2AMLogic/sky130-trng/design/README.md

# design

Schematic sources for the sky130-trng entropy source, and the SPICE netlists
derived from them.

These are design sources, not evidence. Most of the geometry here is still
a **provisional placeholder** ported from
[gf180-trng](https://github.com/2AMLogic/gf180-trng)'s topology and
re-expressed on sky130's 1.8 V core devices — but it is no longer *all* of
it. Issue #10's characterization campaign
([`spec/decision-records/DR-0002-sky130-ro-jitter-and-array-sizing.md`](../spec/decision-records/DR-0002-sky130-ro-jitter-and-array-sizing.md),
status **Proposed**) measured this design's own delay cell and rings across
the sky130 PVT grid, and issue #13's array rebuild
([`spec/decision-records/DR-0003-sky130-trng-operating-point.md`](../spec/decision-records/DR-0003-sky130-trng-operating-point.md),
status **Proposed**) then measured the array's own combining-gate bandwidth
and redrew `ro_array_core.sch` at the resulting operating point. See
[Provisional, not sized](#provisional-not-sized) below for which rows moved
and which did not.

**The headline result the rest of this file has to be read against**: the
array is now drawn at `N = 4` five-stage rings, not the `N = 2` x 11-stage
placeholder it used to carry. `N` is pinned between two independently
measured bounds that do **not** bind at the same corner — an entropy lower
bound (`N >= 4` at `T_s` = 20 µs, DR-0002's sizing law re-evaluated against
the buffer-loaded ring period) and a combining-gate upper bound (`N <= 6`,
measured at the array's own fastest corner, `ff`/−40 °C/1.98 V) — and the
second bound is a **hardware ceiling on the raw rate that no array size can
get past**: DR-0003 measures it at ~78 kbps, roughly two orders of
magnitude below this file's draft `> 1 Mbps` row. That row is retired as
architecturally unreachable, not merely expensive; the operating point drawn
here is `T_s` = 20 µs / 50 kHz sample clock / 50 kbps raw rate.

## What is here

```
design/
  xschem/              schematic + symbol sources (xschem's own text format)
  netlist.py           deterministic SPICE export driver, with a staleness + ERC guard
  _pdk_search.py       shared PDK-search walk, used by netlist.py and sim/bin/corner-run.py (issue #25)
  test_netlist_erc.py  regression fixture for netlist.py's ERC wiring (issue #16)
  test_pdk_search.py   unit test for _pdk_search.py's fallback order (issue #25)
  pdk.json             which sky130 install to resolve, and the open_pdks pin
  *.spice              GENERATED netlists -- committed output of netlist.py
```

### Cell hierarchy

```
trng_top                   top-level assembly; stops at the raw tap
  sampler_core             the sampler, wired to the source
    ro_array_core          the entropy source
      ro_ring5   (x4)      one starved ring oscillator, own enable + own supply
        ro_nand2           starved NAND2 -- the ring's enable/stop stage
        ro_stage   (x4)    starved inverter delay cell
      ro_buf     (x4)      per-ring output buffer (unstarved inverter)
      xor2       (x3)      static CMOS combiner, balanced depth-2 tree -> xo
    sampler_dff  (x6)      TG master-slave D flip-flop, async active-low reset
                           raw_bit, raw_valid, ring_bit1..ring_bit4
```

`ro_ring5` is instantiated by the hierarchy as of issue #13's rebuild
(DR-0003); it was previously a standalone characterization vehicle only.
`ro_ring11` (the 11-stage ring the array used to instantiate) remains in
`design/xschem/` as a standalone cell — DR-0002's jitter-characterization
testbenches under `sim/` still reference it directly — but is no longer
part of the `ro_array_core` hierarchy.

Every device instance is `sky130_fd_pr__nfet_01v8` or `__pfet_01v8` — the
1.8 V core pair, per
[`spec/decision-records/DR-0001-sky130-operating-envelope.md`](../spec/decision-records/DR-0001-sky130-operating-envelope.md)
(status **Proposed**) and `spec/porting-plan.md` §2.1. sky130 has no matched
3.3 V core N/P pair, so gf180-trng's `nfet_03v3`/`pfet_03v3` devices have no
like-for-like counterpart here.

### Port fidelity

`design/xschem/` **started** as a connectivity-identical port of
gf180-trng's own `design/xschem/` — same cells, same nets, same subcircuit
port order, cell for cell, with only the device flavour, the device
geometry, and every prose text block changed (gf180-trng's schematics cite
gf180mcu measurements in their headers, and those citations are not
transferable claims, so each block was rewritten to say what is actually
known here). Issue #13's array rebuild (DR-0003) then moved
`ro_array_core.sch`, `sampler_core.sch` and `trng_top.sch` off that
one-for-one instance count: gf180-trng's own array is `N = 2`, this
repository's is `N = 4`, sized independently from measured sky130 evidence
rather than inherited. The TOPOLOGY still ports — independent rings on
separate supplies, non-integer frequency skew, one XOR-combined node ahead
of one sampler — the instance count no longer does.

### Pins that leave the block

| Pin | Direction | Meaning |
|---|---|---|
| `en1`..`en4` | in | per-ring enable; `en = 0` stops that ring in a static state |
| `vddr1`..`vddr4` | supply | per-ring supply. Separate routing is an independence requirement, and doubles as the per-ring liveness observation point |
| `vdd`, `vss` | supply | block supply for the combiner, the ring buffers and the samplers |
| `clk` | in | the **fixed external** sample clock, 50 kHz per DR-0003 — deliberately not divided down from either ring |
| `rst_n` | in | asynchronous, active-low reset |
| `raw_bit` | out | the raw tap: one digitized sample per `clk` edge |
| `raw_valid` | out | high one `clk` edge after `rst_n` releases, and stays high |
| `ring_bit1`..`ring_bit4` | out | per-ring digitized samples for a liveness monitor; block-internal, not read off-die |

The raw tap sits at the **sampler output**, after digitization — not at the
array's internal combining node `xo`, which never becomes a pin.

## Regenerating the netlists

```bash
python3 design/netlist.py            # (re-)export every top cell
python3 design/netlist.py --check    # fail if a committed netlist is stale, or fails ERC
python3 design/netlist.py --lint     # brace guard only; no xschem, no PDK
python3 design/netlist.py --pdk      # show the resolved xschem + PDK against their pins
python3 design/test_netlist_erc.py   # regression fixture for the --check ERC wiring itself
python3 design/test_pdk_search.py    # unit test for the shared PDK-search fallback order
```

`--check` verifies two independent things, both required for exit `0`:

- **Staleness** — what makes a committed netlist evidence rather than a
  snapshot someone forgot to refresh: it re-exports into a temp directory
  and exits non-zero if the result differs from what is committed.
- **Connectivity** — xschem's own ERC (electrical rule check, `xschem
  netlist -erc`) finds no undriven node, open net, or shorted pin anywhere
  in each top cell's instantiated hierarchy. A schematic-level wiring
  defect (e.g. a `lab_pin` placed at the wrong coordinate relative to the
  net it is meant to tag) can produce a netlist that is internally
  self-consistent — a "before" and "after" regeneration of the same broken
  schematic agree on the same wrong result — so the staleness diff alone
  cannot catch it; ERC does (issue #16). A connectivity failure prints with
  an `ERC` prefix and a distinct exit code from a staleness failure's
  `STALE` prefix, so CI output tells the two apart. ERC only runs under
  `--check`; the plain write path (`python3 design/netlist.py`) does not
  run it, so an intentionally mid-edit schematic can still be exported
  while iterating. `design/test_netlist_erc.py` is the regression fixture:
  it confirms a deliberately-broken schematic (a `lab_pin` moved off its
  net) is actually caught, and that the current `TOP_CELLS` still pass
  cleanly.

Run `--check` after any schematic edit; commit the regenerated `.spice`
files in the same change.

`--lint` is the guard that can run without a PDK. Every schematic carries a
`T {...}` free-text header; a literal `{` or `}` inside that block — even a
balanced pair — makes xschem's own parser miscount and silently drop parts of
the exported netlist, with no error from xschem. The lint scans the
schematics' raw text for that, so it catches the problem at authorship rather
than at the next export.

The netlists are a **library of subcircuits** meant to be `.include`d by a
testbench deck, not decks of their own: `netlist.py` strips the trailing
`.end` and restores the top cell's own `.subckt`/`.ends` wrapper, which
xschem comments out.

`netlist.py` resolves the PDK through `SKY130_PDK_PATH` → `PDK_ROOT`+`PDK` →
`design/pdk.local.json` → `design/pdk.json` → built-in search roots, so no
path is hardcoded. That walk-a-list-of-roots search is shared with
`sim/bin/corner-run.py` via `design/_pdk_search.py` (issue #25); each caller
supplies only its own validator predicate (`libs.tech/xschem` here,
`libs.tech/combined` for the ngspice harness) and its own config source.
`netlist.py` also rewrites absolute paths out of the netlist header and
re-wraps SPICE continuation lines at a width it owns, so the output is
byte-identical across machines and across xschem releases that differ only in
line wrapping.

### xschem 3.4.7 is a hard minimum — 3.4.4 produces an unsimulable netlist

`design/pdk.json` carries an `xschem_version_min` field (currently `3.4.7`),
and `netlist.py` **refuses to netlist at all** below it, with exit `3`
(environment) and its own message. Unlike `open_pdks_commit` in the same
file — a provenance note that is reported, never enforced — this one is a
gate, because below it the tool does not produce a differently-formatted
netlist, it produces a broken one.

sky130's device symbols carry their device-area parameters as `expr()`
templates over the symbol's own `@W`/`@nf` attributes:

```
ad=expr('int((@nf + 2)/2) * @W / @nf * 0.29')
```

xschem 3.4.7 is the first release that *evaluates* those at netlist time (its
Changelog: "evaluate infix expressions with `expr(...)` in attributes"). Every
earlier release — including the **3.4.4** that `apt-get install xschem`
resolves on Debian/Ubuntu — copies the template through verbatim,
`@`-attributes and all. Since every `design/*.spice` here is `.include`d by
ngspice testbenches under `sim/`, that difference is fatal, not cosmetic:

```
Error in netlist line no. 2396 ...
Undefined parameter [ad]
Cannot compute substitute
ERROR: fatal error in ngspice, exit(1)
```

(measured 2026-09-18 with ngspice-46 against the pinned `open_pdks_commit`'s
own `sky130.lib.spice`; the committed evaluated form solves the same deck's
operating point without complaint.)

`--check` cannot catch this on its own — it verifies staleness and ERC, never
simulability — so an export by a too-old xschem would diff clean against
itself and report green. That is why the guard sits in `netlist.py` ahead of
the export rather than in CI alone, and why `.github/workflows/pdk-nightly.yml`
builds xschem from source at this tag instead of installing the distro
package (issue #151; see that file's header comment for the full decision
record, including the earlier policy it reverses).

The floor is a **minimum, not an equality pin**. A *newer* xschem whose output
formatting moves is still meant to turn `--check` red, loudly, and the remedy
for that direction is unchanged: `python3 design/netlist.py`, commit the diff,
note the version bump.

## Provisional, not sized

Issue #10's campaign and issue #13's array rebuild have moved some of this
table off "no sky130 measurement exists". Each row now says which.
**Status** is one of: *measured* (this repo has a cited sky130 record for
it), *refuted* (measured, and the value drawn here does not survive the
measurement), or *placeholder* (still carried over from gf180-trng, or
otherwise unmeasured on sky130).

| Parameter | Value here | Status | What backs it, or what is still missing |
|---|---|---|---|
| Device length `L` | 0.15 µm | placeholder | sky130 minimum drawn length. Not a sized result; nothing in either campaign varied it |
| NMOS width | 0.42 µm | placeholder | sky130 minimum device width. Same |
| PMOS width | 0.84 µm | placeholder | 2:1 P:N ratio **carried over from gf180-trng**. Issue #10 measured the cell's trip point at 0.805–0.844 V against a 0.81–0.99 V mid-supply across the grid, i.e. the ratio is not grossly mismatched — but that is a by-product, not a P:N sizing sweep, and no sweep was run |
| Series-stack widths | 2× the device they replace | placeholder | rule of thumb from the source cell, not a sky130 stage-delay match measurement |
| Starve length `lstv` | 2 µm | placeholder | gf180-trng reached 2 µm by measuring an array power rollup against its own ratified power row. **No sky130 lstv sweep exists** — both campaigns measured jitter, swing and current at this fixed value, so this row is untouched |
| Starve width `wstv` | 0.42–0.48 µm, four 0.02 µm steps | **measured (realized ratio), placeholder (decorrelation)** | The REALIZED frequency ratio across the ladder is measured on the assembled array (`sim/ro-array-core-combining/`, `skew_span` 1.12–1.19×) and re-measured post-layout at every scope up to the whole chain, always clear of the small rationals that mutually injection-lock: closest approach 9.3% (leaf, DR-0005), and **11.2% at whole-chain scope with the substrate deliberately floating** (DR-0009, span 1.096–1.184×). What decorrelates two *sky130* rings is **still not measured**, but the reason is now specific rather than "no layout exists". DR-0009 §3 audits DR-0003 §8's three named mechanisms separately: **proximity is closed** (real placement, extracted flat at ring, array and whole-chain scope); **substrate capacitive return is bracketed, not resolved** — loading −0.650% to −0.283% and coupling +0.361% to +0.584% of ring period at whole-chain scope, 12/12 consistent in sign, but the extractor emits no substrate resistance so `tied`/`float` bracket the *terminals* of an unmodelled range (klayout-tools#1503) — and, at whole-chain scope, the six-sampler digitizer bank turns out to be a comparable or dominant aggressor on that same node, which dissolves the ring-to-ring sign consistency once it is clocking (DR-0009 §2); **shared supply impedance**, §8's first-named mechanism, is **entirely unmeasured** because `vddr1`–`vddr4` still have no distribution layout to be measured on. That last item is the single named blocker, so this row stays **placeholder** for decorrelation (DR-0003 §8, DR-0005 §3–4, DR-0006 §2–3, DR-0009 §1–3) |
| Per-stage gain | −14.3 nominal, −11.8 worst | **measured** | `sim/ro-stage-small-signal-gain/`, three headline points. ~12× the Barkhausen minimum at any stage count in play; retires DR-0001's gain risk |
| Ring swing (`ro_ring5`, buffered output) | 0.999–1.033 × Vdd p-p | **measured** | `sim/ro-ring5-swing-and-current/`, 12 PVT points, under this cell's own output-buffer load. The internal ring node itself swings less (0.78–0.96 × Vdd), but the BUFFERED node — what the XOR tree and liveness taps see — reaches the rails at every point measured |
| Ring stage count | 5 | **measured, chosen** | 12–48× better `Q_ring` than 11 stages at the same points (DR-0002 §4); own-count swing re-measured and confirmed above (this table's previous row cited it as an open objection — it is now retired). `ro_ring11` remains in `design/xschem/` as a standalone characterization cell, no longer part of this hierarchy |
| Array size `N` | 4 | **measured, chosen** | Pinned between an entropy lower bound (`N >= 4` at `T_s` = 20 µs) and a combining-gate upper bound (`N <= 6`, measured at the array's own fastest corner) that do **not** bind at the same PVT point — DR-0003 §1–3. `N = 4` is the largest power of two clearing the combining bound with margin |
| Raw-rate operating point | `T_s` = 20 µs, 50 kHz clock, 50 kbps | **measured, moved** | DR-0003 §2: the combining-gate bandwidth ceiling puts a **hard architectural ceiling of ~78 kbps on the raw rate at any array size** — nearly two orders of magnitude below this file's draft `> 1 Mbps` row, which is retired as unreachable rather than merely expensive |
| Entropy-binding corner | `ss` / −40 °C / 1.62 V | **measured** | Full 27-point grid, `sim/ro-array-sizing/`. Cold — the direction gf180-trng's DR-0012 guessed and its DR-0015 later reversed. Measured here, inherited from neither |
| XOR combining tree contribution | `w_90` = 122–241 ps (gate bandwidth); 0.56–0.68 edge retention at `N = 4` | **measured** | `sim/xor-combining-bandwidth/` (single-gate pulse-width sweep, the figure that sizes `N`) and `sim/ro-array-core-combining/` (assembled-array edge retention and combining-node DC bias, 0.31–0.53 × Vdd, no gross systematic offset). DR-0003 §5–6 |
| Array active power | 81.0–431.6 µW measured across the PVT grid run | **measured** | `sim/ro-array-core-combining/`. Worst-measured 431.6 µW clears the top-level README's `< 500 µW active` row with 13.7% margin |
| Array area | ~0.0026–0.0088 mm² (ROM estimate); every `ro_array_core` leaf cell now drawn, summing to 4 × 377 + 4 × 22.2 + 3 × 421.5 µm² = 0.00286 mm² | **estimated (array), measured (leaf cells only)** | Device-count-based estimate (DR-0003 §7): comfortably inside the `< 0.05 mm²` budget (~5–18%). Not yet an array measurement, but every cell it instantiates is now drawn: `ro_ring5` 41.125 × 9.17 µm (`layout/ro_ring5/README.md`), `ro_buf` 4.175 × 5.31 µm, `xor2` 23.97 × 17.585 µm (`klt stats` on each committed GDS). The 0.00286 mm² sum is leaf-cell bounding boxes only — it is a **floor**, not a floorplan: no inter-ring channel, no supply distribution, no sampler and no top-level PDN are drawn, and it assumes the eleven cell instances (4 rings + 4 buffers + 3 XORs) pack with zero waste between their bounding boxes |
| Sampler (`sampler_dff`) capture timing | clk→q 103.6–299.0 ps (leaf-cell, ideal inter-cell wires); **131.4–426.0 ps (whole-cell assembled, real intra-cell routing)**; both post-layout, worst at `ss`/−40 °C/1.62 V | **measured (post-layout, two extraction scopes)** | `sim/post-layout-sampler-dff/` (leaf-cell composition, 8 records / 24 corner runs) and `sim/post-layout-sampler-dff-assembled/` (whole-cell flat extraction of `layout/sampler_dff/sampler_dff.gds`, 4 records / 12 corner runs), both with the pre-layout `.subckt sampler_dff` as a same-deck control. Leaf-cell intra-cell parasitics cost 1.314–1.418× in clk→q, inside DR-0005's own 1.378–1.479× ring finding (DR-0007); the whole-cell assembly costs **1.704–2.013×** against pre-layout, i.e. **1.268–1.425× on top of** the leaf-cell figure at the same PVT/corner points (DR-0008). Setup time is not yet re-measured at the assembled scope (DR-0007's 60–150 ps, leaf-cell only, still stands — see DR-0008 "Known limitations"); compared per corner against DR-0003 §1's own `w_90` table at leaf-cell scope, setup is below that corner's `w_90` at each of the nine (temp, Vdd, corner) points where both are measured — including (60, 73] ps against 122.0 ps at `ff`/−40 °C/1.98 V, the corner where `N_max_combine` binds (`sim/xor-combining-bandwidth/` has no 125 °C point, so this campaign's three 125 °C/1.98 V points are outside the comparison). DR-0003 §1's `N_max_combine` bound is therefore unchanged — the digitizer is not the bandwidth bottleneck. Worst-case capture delay is ≤ 21.3 ppm of the ratified 20 µs `T_s` even at the assembled scope. Both scopes use ideal PWL stimulus, so a **floor** on the real cost. DR-0007, DR-0008 |
| Sampler reset-window current | 19.3 pA (`ss`/−40 °C/1.62 V) – 293 nA (`ff`/125 °C/1.98 V), i.e. 0.90 nW nominal / 580 nW worst | **measured** | `sim/post-layout-sampler-dff/` and `sim/post-layout-sampler-dff-assembled/`, both measured with `rst_n` asserted *while* `d` drives the opposite value through the transparent master. Leakage-limited: at or below the same cell's own idle current at every grid point (0.501–1.014×, both extraction scopes agree on this ratio to three significant figures) and identical pre- and post-layout to 3–5 significant figures at both scopes, so there is no contention component to find. This is `spec/porting-plan.md`'s DR-0014 **methodology** transfer re-derived on sky130 — not gf180mcu's 967 µW → 66 nW numbers transplanted, and **no** reduction ratio is claimed, because the brute-force pull-device alternative was not simulated. DR-0007, DR-0008 |
| Idle current (per ring) | 0.6 nA (cold) – 255 nA (`ff`/125 °C) | **measured (per-ring), no target yet** | `sim/ro-ring5-swing-and-current/`. The top-level README's own idle-current target is still unset pending `spec/porting-plan.md` §2.5's leakage survey, so this is a reported number, not a pass/fail against a row that does not exist yet |
| Load cap `cld` | 0.5 fF | placeholder | an estimate of local interconnect load, not an extracted parasitic, and sky130's metal stack differs from gf180mcu's |

### Why the schematic reads `N = 4`, and why the raw-rate row moved to 50 kbps

`N` is not a parameter in `ro_array_core.sch`; it is a topology, and issue
#13 redrew it. `N = 4` is not the entropy law's own preferred value in
isolation — DR-0002 sized `N = 53` against the draft `> 1 Mbps` row — it is
the largest power-of-two array size that clears a **second, independent
constraint** DR-0002's campaign did not measure: the XOR combining gate's
own bandwidth. That second bound does not move with the sample rate, so it
sets a hard ceiling (~78 kbps) on the raw rate itself, not just on `N`.
`spec/decision-records/DR-0003-sky130-trng-operating-point.md`
(status **Proposed**) is the full derivation: the two bounds, where they
cross, why 50 kbps (not the ~78 kbps ceiling itself) was chosen for margin,
and the stage-count, area, current and combining-tree evidence that came
with drawing the array at last.

`spec/porting-plan.md` §2.6 predicted the shape of what both campaigns
found: gf180-trng's own rate × entropy × power × area operating point has
not converged, and sky130's version of the same tension needed its own
sizing pass. It did, and it resolved further downward than either campaign
alone implied — DR-0002's entropy law by itself still permits high rates at
large `N`; the combining gate does not. Whether 50 kbps should ratify as
this repository's ratified rate row, or whether the combining gate itself
should be redesigned to raise the ceiling, is the operator/spec decision
DR-0003 surfaces and does not resolve on its own authority.

## Deliberately not here

- **The metastability-hybrid tap** (`meta_arb`, `meta_inv`, `meta_nand2`,
  `ro_array_core_meta`, `ro_array_sanity`, `ro_meta_tap` in gf180-trng).
  `spec/porting-plan.md` §1.2 scopes it as a stretch/secondary item, not part
  of the core array, so it is out of scope for this port.
- **The digital section** — conditioner, health tests, register interface.
  The analog/digital verification boundary is drawn at the raw tap:
  everything up to and including `raw_bit` is transistor-level, everything
  downstream is a behavioural model plus RTL, and drawing it as SPICE
  subcircuits would fabricate netlists for circuits nobody has designed.
  That section now exists — as of
  [`spec/decision-records/DR-0004-sky130-digital-section-architecture.md`](../spec/decision-records/DR-0004-sky130-digital-section-architecture.md)
  (status **Proposed**) it lives in [`digital/`](../digital/README.md), not
  here, and none of it is or will be a `design/*.spice` netlist. `raw_bit`
  and `raw_valid` are the interface between the two directories.
- **Layout and DRC/LVS.** **Latest (issue #22): the shared-substrate
  tied/float/solo bracket, run at whole-chain (`sampler_core`) scope — the
  last hierarchy level that had no substrate-coupling measurement of its
  own, and the deck DR-0003 §8 has been waiting for since it was written.**
  Two new decks in [`sim/post-layout-sampler-core/`](../sim/post-layout-sampler-core/)
  (eight records, twenty-four corner runs, all **PASS**, same four-point
  PVT grid × `tt`/`ss`/`ff`) complete the bracket DR-0005 ran on leaf cells
  and DR-0006 ran on the whole array. Loading **−0.650% to −0.283%** of
  ring period and coupling **+0.361% to +0.584%**, positive at **12 of 12**
  grid points — the array-scope sign signature reproduced at an independent,
  larger scope, at 2–8× the magnitude, clearing DR-0005's ring-scale
  numerical scatter floor by 15–24× at every point. A second period
  estimator these decks add, taken inside the clocked window with all six
  `sampler_dff` instances actually latching, then finds the sign consistency
  **gone** (−0.486% to +0.589%, 8 of 12 positive) — because the digitizer
  bank is itself a first-order substrate aggressor: one ring plus a clocking
  sampler bank puts more peak-to-peak swing on the shared node than four
  free-running rings with the bank static at **7 of 12** grid points. The `wstv` ladder still clears every mutual-injection-lock
  rational by ≥ 11.2% at the pessimistic (floating) terminal. **DR-0003 §8
  is narrowed, not closed**: proximity is now closed, substrate capacitive
  return is bracketed at three scales with an unmodelled interior
  (klayout-tools#1503), and §8's first-named mechanism — shared supply
  impedance — remains entirely unmeasured for want of a `vddr1`–`vddr4`
  distribution layout, which is now the single named blocker. Full
  statement: [`spec/decision-records/DR-0009-*.md`](../spec/decision-records/DR-0009-sampler-core-substrate-bracket-and-wstv-decorrelation.md);
  reduction: `python3 sim/post-layout-sampler-core/analysis/substrate-bracket.py`.

  **A previous increment (issue #22): `sampler_core`'s first
  whole-cell post-layout PVT simulation campaign, against real extracted
  parasitics.** [`sim/post-layout-sampler-core/`](../sim/post-layout-sampler-core/)
  drives `layout/pex-sampler-core/sampler_core_pex.spice` (the whole
  composed cell — four rings, output buffers, the XOR combining tree, and
  all six `sampler_dff` instances, one flat extraction) with the same
  enable/reset/clock stimulus `sim/post-layout-ro-array-core/` uses for the
  array alone, extended to release the six samplers from reset and clock
  them — the first deck in this repository to exercise the whole raw-tap-
  to-sampled-bit chain post-layout in one flat netlist. Four PVT points ×
  three process corners (the repo's established grid), all twelve **PASS**:
  ring period slows **2.161-2.504×** against the pre-layout
  `design/sampler_core.spice` control (a larger multiplier than
  `sampler_dff`'s own clk→q slowdown, DR-0008, because it also carries the
  array's own real inter-block routing and the six-instance `d`-pin fan-out
  load, not just one cell's intra-cell parasitics); the combining node's
  edge retention is 0.479-0.649 post-layout (0.386-0.642 pre-layout, same
  deck, same corner — post-layout loading does not systematically depress
  it); reset-held sampler outputs stay ≤ 0.403 mV across all twelve runs
  while the rings free-run underneath; and all 120 captured-value
  snapshots (`raw_bit`/`raw_valid`/`ring_bit1`-`ring_bit4`, five clock
  edges × twelve corner-runs) land within 0.025% of a rail — clean
  digital levels end to end, never an intermediate voltage. Active-window
  supply current runs 1.052-1.234× the pre-layout figure, reset-held
  1.048-1.280×. One early run at this same PVT point (-40 °C, 1.62 V)
  timed out on its `ff` corner under heavy host contention before this
  campaign's own clean re-run superseded it —
  `sim/post-layout-sampler-core/records/20260908-032156-ef0db50.md`, kept
  per this directory's append-only convention rather than deleted. That
  campaign is a functional/timing/current characterization, not a coupling
  or injection-locking study, and said so — the substrate bracket above is
  the deck it named as still owed.

  **A previous increment (issue #22): `sampler_core` is extracted
  with real post-layout parasitics for the first time.**
  [`layout/pex-sampler-core/`](../layout/pex-sampler-core/README.md) runs
  `klt extract --parasitics` over the DRC/LVS-clean
  `layout/sampler_core/sampler_core.gds` (264 devices, 152 nets, 169817.28 Ω
  total series R, 869.19 fF total C). Its `net_aliases` table is built from
  `klt lvs`'s own verified net map rather than inferred from spelling,
  because the six `sampler_dff` instances' own `q` pins are never promoted
  to a GDS label and so need that map to tell `raw_bit`/`raw_valid`/
  `ring_bit1`-`ring_bit4` apart; see that directory's README for the full
  derivation and its independent union-find cross-check.

  **A previous increment (issue #22): `sampler_core` is now
  DRC-clean *and* LVS-clean — the first whole-cell DRC/LVS-clean
  `sampler_core` assembly in this repo.**
  [`layout/sampler_core/`](../layout/sampler_core/README.md) adds three
  stages routing `ro_array_core`'s own `vdd` down to the six-`sampler_dff`
  bank's own `vdd` rail, closing the second (and last) of the cell's two
  inter-block supply straps (`vss` was routed by the previous increment).
  `vdd`'s own path is blocked by a met1 net spanning a whole corridor at one
  height, so this strap bridges past it on met2 (auto-via at both ends)
  rather than staying on one layer the way `vss` could. `klt drc`: clean, 0
  violations. `klt extract`: 264 devices, **152 nets** (down from 153 —
  `vdd`'s two nets, previously separate, are now genuinely one). `klt lvs`
  vs. `design/sampler_core.spice`'s own `.subckt sampler_core`: **match —
  264/264 devices, 152/152 nets, 0 errors**. Top-level pin promotion,
  previously thought also required for a full match, turned out not to be.
  The assembled `sampler_core` post-layout PVT run and DR-0003 §8's `wstv`
  re-evaluation remain open, tracked in #27.

- **A previous increment (issue #22): `sampler_core`'s whole data
  path is routed — all five raw-tap nets (`ro1`-`ro4`, `xo`) reach their own
  samplers, `sv`'s `d` is tied to `vdd` as the schematic requires, and every
  `d` pin in the cell is driven. DRC-clean, 264 devices, 153 nets.**
  [`layout/sampler_core/`](../layout/sampler_core/README.md) adds two stages
  on top of the six below: `data2_m1` (met1) draws the `d` climbs for
  `sb`/`sr2`/`sr3`, `sv`'s `d`→`vdd` tie (landing directly on the shared
  `vdd` rail's own met1), `ro2`'s and `ro3`'s westward escapes along their
  own already-drawn horizontals, and the two short legs `xo` needs; and
  `route_data2` (met2) closes the three remaining hauls plus the 2.1 µm hop
  joining `ro3`'s split escape over `ro2`'s own vertical. The previous
  increment's reading that `ro2`/`ro3` need "a layer change inside the
  array's footprint" was right about the constraint and wrong about the
  move: a scan of the pre-increment stream finds exactly two `x` bands where
  met2 is free over the array's *whole* height (`x -2.1..1.65`, the west
  margin, and `x 215.05..220.0`), met1 is clear all the way west to the
  first one at both nets' own run heights, and the east band is unreachable
  — the via that would have to land there needs 0.70 µm between the array's
  east supply riser and `ro4`'s escape leg, which are 0.605 µm apart. `klt
  drc`: clean, 0 violations, first attempt on both stages. `klt extract`:
  264 devices, **153 nets** — `157 − 4`, exactly one merge per net joined,
  each confirmed net-by-net. `klt lvs` against `design/sampler_core.spice`'s
  real `.subckt sampler_core`: mismatch, improved to **138/264 devices,
  100/152 nets**. The inter-block `vdd`/`vss` straps, top-level pin
  promotion, whole-cell LVS sign-off and the assembled post-layout PVT run
  remain open, tracked here and in #27.

- **A previous increment (issue #22): the `ro_array_core`
  instance is placed inside `sampler_core`, and the first two raw-tap data
  nets are routed end to end — DRC-clean, 264 devices, 157 nets.**
  [`layout/sampler_core/`](../layout/sampler_core/README.md) adds three
  stages on top of `place`/`route_supplies`/`route_ctrl`: `place_array`
  puts one `ro_array_core` instance (the DRC-clean, LVS-*matching* entropy
  source) at `(0.0, 23.635)` — directly above the six-`sampler_dff` row,
  with a 12.915 µm routing channel between them — so `sampler_core.spice`'s
  whole device population exists in one stream for the first time;
  `data_m1` (met1) climbs `sr1`'s and `sr4`'s own `d` pins out of li1 to a
  landing point under the shared `vdd` rail and extends `ro1`'s and `ro4`'s
  own array metal south into the channel; `route_data` (met2) closes the
  two hauls. Above rather than below is measured, not preferred: a `d` pin
  has one met1 obstacle above it (the shared `vdd` rail) and three
  interleaved below (`vss` rail, `clk` lane, `clkb` lane) on the only two
  routing layers sky130's `klt` roles expose. Only two of the five data
  nets are routed because only two of them *can* be at this scope: a
  column-by-column met1 scan finds a clear south escape over `ro1`'s and
  `ro4`'s own runs and none at all over `ro2`'s or `ro3`'s (the four ring
  taps are stacked horizontals), and `xo` is an li1 pad two via hops from
  met2. `klt drc`: clean, 0 violations. `klt extract`: 264 devices,
  157 nets — exactly two fewer than the unrouted placement's 159, i.e.
  exactly the two intended connections and nothing else. `klt lvs` against
  `design/sampler_core.spice`'s real `.subckt sampler_core`: mismatch at
  136/**264** devices — against a *complete* reference for the first time,
  after this increment fixed a `compose-cell.py` gap that had been leaving
  it silently short at 176. The remaining three data nets, the inter-block
  `vdd`/`vss` straps, top-level pin promotion, whole-cell LVS sign-off and
  the assembled post-layout PVT run all remain open, tracked here and in
  #27.

- **A previous increment (issue #22): `sampler_core`'s shared `clk`/`rst_n`
  fan-out is routed across all six `sampler_dff` instances, DRC-clean.**
  The `route_ctrl` stage reuses the chain-of-six technique below for both
  nets; `clk` was clean on the first attempt, `rst_n` needed a climb to an
  empty met2 band for its cross-instance haul after a self-net short on the
  first. `klt drc`: clean, 0 violations; `klt extract`: 132 devices, 64 nets
  (down from 74 — each of `clk`/`rst_n` merges six per-instance nets into
  one).

- **A previous increment (issue #22): `sampler_core`'s shared `vdd`/`vss`
  bus is routed across all six `sampler_dff` instances, DRC-clean.**
  [`layout/sampler_core/`](../layout/sampler_core/README.md)
  promotes the placement proof-of-concept below into a real,
  `compose-cell.py --check`-reproducible `cell.json` (stage `place`,
  byte-for-byte the same six-instance floorplan) plus a `route_supplies`
  stage chaining `vdd` and `vss` across `sb`→`sv`→`sr1`→`sr2`→`sr3`→`sr4` on
  met1 — landing directly on each `sampler_dff` instance's own already-drawn
  rail (no via-drop needed, since that cell's own routing already put
  `vdd`/`vss` on met1). `klt drc`: clean, 0 violations; `klt extract`: 132
  devices unchanged, 74 nets (down from the placement PoC's 79 — `vdd`
  merges from six per-instance nets into one, saving exactly 5; `vss` was
  already merged via sky130's own global NMOS substrate). `klt lvs` against
  `design/sampler_core.spice`'s real `.subckt sampler_core`: mismatch, as
  expected (no `ro_array_core` instance placed yet, `clk`/`rst_n`/`d`/`q`
  all unwired) — assembling that `lvs` block also surfaced a real
  `compose-cell.py` limitation (not a `klt` gap), recorded in
  `layout/sampler_core/README.md`.

- **A previous increment (issue #22): the `sampler_core` six-`sampler_dff`
  bank has a verified, DRC-clean floorplan.**
  [`layout/sampler_core-placement-poc/`](../layout/sampler_core-placement-poc/README.md)
  places six already-composed `layout/sampler_dff/sampler_dff.gds` instances
  side by side (55.66 um pitch, `design/sampler_core.spice`'s own
  `sb`/`sv`/`sr1`-`sr4` instance order), zero routing: `klt drc` clean (0
  violations), `klt extract` confirms 132 devices (66 nfet + 66 pfet) and 79
  nets (the 5-net gap from the naive 84 is sky130's own global-substrate
  NMOS-bulk merge — traced and confirmed benign). `design/sampler_core.spice`'s
  own `.subckt sampler_core` wires the source (`ro_array_core`) *and* the
  samplers together, not "six samplers" alone, so this was a placement-only
  proof-of-concept (like `layout/ro_array_core-placement-poc/` before
  `layout/ro_array_core/`), not yet an LVS-checkable committed cell.

- **A previous increment (issue #22): `sampler_dff`'s whole-cell
  assembly is now extracted with real intra-cell parasitics and re-run
  through the same post-layout deck DR-0007 used at leaf-cell scope.**
  [`layout/pex-sampler-dff-assembled/`](../layout/pex-sampler-dff-assembled/README.md)
  runs `klt extract --parasitics` directly over
  `layout/sampler_dff/sampler_dff.gds` — the same DRC-clean, `klt
  lvs`-matching (22/22 devices, 14/14 nets, 0 mismatches) assembly the
  previous increment below landed — instead of the three separately
  composed leaf cells wired by ideal testbench nets. `sim/post-layout-sampler-dff-assembled/`
  re-runs the capture-timing/reset-contention deck across the same
  four-(temp, Vdd)-point, `tt`/`ss`/`ff` grid (4 records, 12 corner runs, all
  `PASS`): clk→q capture delay now costs **1.704–2.013×** against
  pre-layout (up from the leaf-cell composition's own 1.314–1.418×), i.e.
  **1.268–1.425× on top of** the leaf-cell figure at matching PVT points —
  smaller than the ~1.5–1.7× DR-0007 borrowed from DR-0006's *array-scale*
  result as a placeholder, which is not a contradiction (a different
  interconnect shape, not a wrong estimate); the reset window still carries
  no contention current, agreeing with the leaf-cell figure to 4–5
  significant figures; and the assembly is functionally correct (captured
  levels ≥ 0.9988×Vdd high / ≤ 0.00195×Vdd low, reset holds `q` ≤ 0.386 mV).
  See
  [`spec/decision-records/DR-0008-*.md`](../spec/decision-records/DR-0008-sampler-dff-assembled-post-layout.md)
  for the full re-evaluation, including what it explicitly does not
  re-measure (DR-0007's own setup-time bracket, and `sampler_core`'s
  six-instance fan-out). `sampler_core`'s own six-instance wiring and the
  whole-chain (raw-tap-to-sampled-bit) post-layout PVT campaign remain open
  (#27).

- **A previous increment (issue #22): `sampler_dff` reached
  `klt drc`-clean (0 violations) and `klt lvs`-**match** (22/22 devices,
  14/14 nets, 0 mismatches) against `design/sampler_core.spice`'s own
  `.subckt sampler_dff`** — the sixth and last data-path net, `m`, is
  routed (see [`layout/sampler_dff/README.md`](../layout/sampler_dff/README.md)),
  completing the sampler-side counterpart to `ro_array_core`'s own clean
  sign-off below. The note below about `layout/sampler_dff/`'s GDS not yet
  being an extraction source (`m`/`mb` unrouted) describes the state at the
  time of the sampler post-layout PVT entry further down, not the current
  one (superseded by the whole-cell assembled extraction above).
  `layout/` holds **fifteen composed, DRC-clean
  and LVS-clean cells** — every leaf cell `ro_array_core` instantiates
  (rings, buffers, the combining-tree XOR; see
  [`layout/xor2/`](../layout/xor2/README.md)) **plus `ro_array_core`
  itself**, which is now a `--check`-reproducible six-stage `cell.json`
  recipe in
  [`layout/ro_array_core/`](../layout/ro_array_core/README.md) (132/132
  devices, 96/96 nets, 0 DRC violations, with `ring1..4`'s and `xa1..3`'s
  own `vss` taps drawn). That supersedes — without correcting — the PoC
  directory the increments below narrate.
  A prior increment first reached that verdict:
  [`layout/ro_array_core-placement-poc/`](../layout/ro_array_core-placement-poc/README.md)'s
  "Increment 8" section routes the last open net, the `vdd` supply, as
  seven `"metal2"`-role (met1) promotion stubs plus a six-leg `"metal3"`
  (met2) bus, merging the seven previously-separate per-instance `vdd`
  nets into one 38-device net. The composed block is **`klt drc` clean
  (0 violations)**, extracts to **132 devices / 96 nets**, and **`klt lvs`
  reports `match`: 132/132 devices, 96/96 nets** against
  `design/ro_array_core.spice`'s own `.subckt ro_array_core` — the whole
  entropy source (four differently-sized rings, four buffers, the
  three-XOR combining tree), not a leaf cell. Two committed negative
  controls (`lvs-negative-controls.py`) show that verdict is
  discriminating rather than vacuous: resizing ring 4's starve devices to
  ring 1's `wstv`, and crossing `xa1`/`xa2`'s inputs, each turn the same
  comparison into `mismatch`. The generated reference originally needed
  one thing `layout/bin/compose-cell.py`'s *plain* `lvs.dependencies`
  mechanism could not express — four differently parameterised copies of
  the *same* `ro_ring5` subckt — built at the time by a small one-off
  script (`array-reference.py`) that hand-rolled the rename/parametrize
  loop. **A follow-up increment folds that back into `compose-cell.py`**
  as a generic, unit-tested `lvs.dependency_variants` mechanism (see
  `layout/README.md`), and `array-reference.py` now calls it instead,
  verified to reproduce the identical reference body and LVS/negative-control
  verdicts. **The promotion that follow-up left open is done**:
  `layout/ro_array_core/cell.json` is the `--check`-reproducible recipe, and
  its `lvs` block is `lvs.dependency_variants`'s first real use.

  **This increment adds the whole-array post-layout PVT campaign issue #22's
  acceptance bar asks for**, layered on top of that already-landed recipe.
  [`layout/pex-array/`](../layout/pex-array/README.md)
  extracts the canonical, `vss`-strapped, DRC-clean, LVS-matching
  `layout/ro_array_core/ro_array_core.gds` flat with
  `klt extract --parasitics`, and
  [`sim/post-layout-ro-array-core/`](../sim/README.md) runs it across the
  same four-(temp, Vdd)-point, `tt`/`ss`/`ff` grid every prior post-layout
  campaign in this repo uses (36 corner runs): array-level parasitics cost
  **2.158x - 2.501x** in ring period against pre-layout, the `wstv` ladder
  still discriminates (span 1.084x - 1.175x), and a tied/float/solo
  inter-ring substrate bracket — the first one in this repo run on a real,
  physically-placed layout rather than leaf cells hand-tied to a shared
  node — finds coupling still bounded in magnitude but, for the first time,
  consistent in sign across every grid point, and wider than the prior
  ring-scale study (loading -0.353% to -0.192% of ring
  period, coupling +0.044% to +0.293%, 12 of 12 positive). See
  [`spec/decision-records/DR-0006-*.md`](../spec/decision-records/DR-0006-array-level-post-layout-and-wstv-decorrelation.md)
  for the full re-evaluation: it does **not** close DR-0003 §8 — the gap's
  first-named mechanism, shared `vddr1`-`vddr4` supply impedance, still has
  no layout to be measured on at any scale. `sampler_dff`/`sampler_core`
  still have no layout at all, so this is not a whole-chain (raw tap to
  sampled bit) post-layout measurement.

  **The sampler's own leaf-primitive composition is now complete.**
  [`layout/sampler_tg/`](../layout/sampler_tg/README.md) composes the plain
  sky130 transmission gate (4 instances per `sampler_dff`) — `klt drc` clean
  (0 violations) and `klt lvs` **match** (2/2 devices, 6/6 nets) against a
  hand-authored micro-reference (`design/xschem/sampler_dff.sch` is flat, so
  unlike `ro_ring5.sch` there is no `.subckt` of this shape in
  `design/*.spice` for `compose-cell.py`'s LVS to reference directly). This
  also answered `layout/README.md`'s own open "no generator surveyed yet"
  question for the transmission-gate DFF: `mos_array`, the same generator
  every other leaf gate here uses, is sufficient — no `klayout-tools` tool
  gap.
  [`layout/sampler_nand2/`](../layout/sampler_nand2/README.md) composes the
  other missing leaf shape — a plain rst_n-gated NAND2, structurally
  `ro_nand2` minus its two always-on starve devices (both PMOS sources tie
  directly to `vdd`, the series NMOS pair's far end ties directly to `vss`)
  — reusing `ro_nand2`'s own parallel-PMOS/series-NMOS floorplan and its
  three-pin-net promote-then-resolve-on-metal2 technique for the resulting
  `vdd`/`y` nets, also `klt drc` clean (0 violations) and `klt lvs` **match**
  (4/4 devices, 6/6 nets) against a hand-authored micro-reference for the
  same reason. With these two plus 3× a plain inverter (already `ro_buf`,
  reusable as-is per `layout/xor2/`'s own `blocks[].cell` precedent), all
  three of `sampler_dff`'s 22 devices now reduce to already-composed leaf
  shapes. Assembling all 22 devices into one `sampler_dff` cell, LVS-checked
  against `design/sampler_core.spice`'s own `.subckt sampler_dff`, and then
  `sampler_core`'s own six-instance wiring, remain open (#27).

  **`sampler_dff` assembly has started.**
  [`layout/sampler_dff/`](../layout/sampler_dff/README.md) places all nine
  leaf-cell instances (3x `ro_buf`, 4x `sampler_tg`, 2x `sampler_nand2`) as
  `blocks[].cell`, reading the flat 22-device subckt as a signal-flow
  pipeline rather than a device list — DRC-clean placement (0 violations),
  plus a DRC-clean `vdd`/`vss` supply bus routed across all nine instances
  (`klt extract` confirms both rails fully merged into one net each, and
  confirms the composed geometry's 22-device, 11 nfet/11 pfet split matches
  `design/sampler_core.spice`'s own subckt before any signal wiring exists).
  A following increment routed the **`rst_n` fan-out** to both
  `sampler_nand2` instances — also DRC-clean (0 violations), and `klt
  extract` confirms `nand_m`'s and `nand_s2`'s own `a` pins and `rst_n` are
  one physically merged net, the first data/control net in this cell wired
  end to end. It needed three stages rather than one because each `a` pin
  sits *inside* its own leaf cell's internal `met1` via stack: an `li1`-only
  stub east out of the congestion, a via up to `met1`, then a second via to
  `met3` for the long `nand_m` → `nand_s2` haul on a plane no leaf cell in
  this assembly draws on. The increment after that routed the **`clk`
  fan-out** — the cell's first true fan-out net (five pins), drawn as a
  `gen-compose` bundle net with hand-steered `connectivity[].legs[]`, whose
  whole long haul runs on `met2` in one basement lane at `y = -1.70` with a
  vertical drop at each pin's own x. Also **DRC-clean (0 violations), 0
  unrouted nets**, and `klt extract` confirms it lands on exactly the six
  clk-gated devices `design/sampler_core.spice` has (`XMpc`/`XMnc`,
  `tg_d`'s PMOS, `tg_fbm`'s and `tg_s`'s NMOS, `tg_fbs`'s PMOS), leaving
  the four `clkb`-gated devices correctly isolated. That
  PMOS/NMOS-alternating assignment — a master-slave DFF's feedback gate
  runs the opposite phase from its own stage's input gate — is exactly why
  `clk` and `clkb` cannot be two mirrored buses, so the same increment
  reserved (but did not draw) a separate `met1` corridor at `y ≈ 0.40` for
  `clkb`. The next increment routed that corridor: `clkb`'s own five-pin
  fan-out, across five stages (two `met1` long-haul segments, two
  `met1`→`met2`→`met1` bridges hopping over `sampler_nand2`'s own internal
  `met1` blobs, and two east-side jogs dodging `clk`'s own via-drop pads at
  the shared `tg_fbm`/`tg_s` columns) — also **DRC-clean (0 violations)**,
  with `klt extract`'s net count dropping from 27 to 23 (exactly the four
  merges a five-pin net makes) and the merged net's own six-device list
  matching `design/sampler_core.spice`'s
  `XMpc`/`XMnc`/`XMtdn`/`XMfsn`/`XMfmp`/`XMtsp` exactly. `klt lvs` is still
  not expected to match: the six data-path nets (`m`/`mb`/`mc`/`s`/`q`/`qb`)
  remain open (#27) — see `layout/sampler_dff/README.md`'s "Result: `clkb`
  fan-out" and "What remains".

  The increment after that routed the first of the six data-path nets,
  **`mc`** (`inv_mc.y` → `tg_fbm.a`, `design/sampler_core.spice`'s
  `XMim2p`/`XMim2n`/`XMfmp`/`XMfmn`). A direct `met1` route is blocked for
  its entire useful height band (`clkb`'s own `clkb_mid` backbone crosses
  at `y ≈ 2.33`, `clk`'s via-drop pad at `tg_fbm.ctrlb` sits at the same
  x), so this net vias up one plane further, to `met2` — empty across this
  whole span — and runs a short U-shaped lane at `y = 1.8`. **DRC-clean (0
  violations)** on the first attempt, `klt extract`'s net count drops from
  23 to 22 (exactly the one merge a two-pin net makes), and the merged
  net's own four-device list matches `XMim2p`/`XMim2n`/`XMfmp`/`XMfmn`
  exactly. Five data-path nets remain (`m`/`mb`/`s`/`q`/`qb`) — see
  `layout/sampler_dff/README.md`'s "Result: `mc` fan-out" and "What
  remains". (Later increments routed `q`, `qb` and `s`, promoted the `d`
  input pin, and fixed the `sampler_nand2` input pin swap the `qb`
  increment found (#84, merged as PR #87); `m` and `mb` are what remain.
  `layout/README.md` is the current record of that series, which this file
  does not restate increment by increment.)

  **The sampler is now extracted with parasitics and simulated**, which is
  the first `sim/` evidence about `sampler_dff` of any kind and the first
  post-layout campaign in this repo on the far side of the raw tap.
  `layout/pex/pex-sampler.json` builds `layout/pex/sampler_dff_pex.spice`
  from the three composed leaf cells `layout/sampler_dff/` places, and
  `sim/post-layout-sampler-dff/` runs two decks from it over the same four
  (temp, Vdd) points × `tt`/`ss`/`ff` grid every post-layout campaign here
  uses (8 records, 24 corner runs, all `PASS`), with the pre-layout
  `.subckt sampler_dff` as a same-deck control. The two new sampler rows in
  the target table above are its results;
  [`spec/decision-records/DR-0007-*.md`](../spec/decision-records/DR-0007-sampler-dff-post-layout-and-reset-contention.md)
  states what they do and do not license. Note the scope: intra-cell
  parasitics plus **ideal** inter-cell wires (the assembled
  `layout/sampler_dff/` GDS is not the extraction source — with `m`/`mb`
  unrouted and `klt lvs` not matching, extracting it flat would extract an
  incomplete circuit), and ideal PWL stimulus, so every post-layout figure
  is a floor on the real cost.

  **Both nets have since routed** (`mb`: PR #95; `m`: PR #99), making
  `layout/sampler_dff/sampler_dff.gds` itself a valid, `klt lvs`-matching
  extraction source for the first time — see the "Latest" entry at the top
  of this bullet for the whole-cell (assembled) re-run and
  [`spec/decision-records/DR-0008-*.md`](../spec/decision-records/DR-0008-sampler-dff-assembled-post-layout.md)
  for the full result.

  A prior increment wired the XOR combining tree's inputs:
  that directory's
  "Increment 7" section routes `t2` (`xa2.y` → `xa3.b`) via a `"metal3"`
  (met2) bridge fed by two short `"metal2"`-role (met1) promotion stubs
  added at the array-composition level, over the fence of already-routed
  met1 backbones the prior increment found blocking it — `klt drc` clean
  (0 violations) at every step, `klt extract` 132 devices (unchanged), 103
  nets (unchanged after the stubs) then 102 nets (after the bridge merges
  `xa2`'s `y` net with `xa3`'s `b` net, confirmed by net diff, nothing
  else). The prior increment (Increment 6) predicted the met1 promotion
  would need a change inside `xor2`'s own leaf cell, since met3's via-drop
  is single-hop and cannot reach a bare li1 pin — **this increment shows
  that's unnecessary**: an already-composed block can gain extra
  hand-declared ports at any layer, at any point an earlier increment's own
  routing already proved clear, one level up from the leaf cell rather than
  inside it. `t1` (`xa1.y` → `xa3.a`, 66.97 µm on met1, Increment 6) and
  `t2` together complete the tree's inputs; `xo` (`xa3.y`) remains exposed
  as a bare top-level pin. Increment 6 also recorded a finding that matters
  beyond this block: **`klt drc` clean is
  not connectivity evidence**: a first `t1` probe reported `unrouted_nets:
  []` and 0 violations while electrically shorting `xa1`'s internal `bn`
  node to its own output, because `klt gen-compose` models a placed block as
  an opaque bbox and cannot see its interior metal (filed generically
  against `2AMLogic/klayout-tools` as `klayout-tools#1527` per `CLAUDE.md`'s
  friction protocol; probe artifacts not committed). `xor2`'s `y` has exactly four legal met1
  escape windows, measured by a committed scan script rather than
  approximated. Before that, an increment
  routed `buf1`-`buf4`'s `vss` taps together as one
  bundle net on met1 (`klt drc` clean, 0 violations), but `klt extract`
  reports the same 132 devices and 104 nets as before — the merged `vss`
  net's own device count (122) is unchanged, because `klt extract`'s sky130
  deck already ties every un-isolated NMOS body to one global substrate
  identity via `connect_global`, so `vss` connectivity across the array's
  instances did not need this routing to reach a `klt lvs` match (the same
  mechanism `spec/decision-records/DR-0005-*.md` finding 3 documented on one
  ring's own parasitics, now confirmed at the array level). The bus is still
  real, DRC-clean, load-bearing metal a fabricated die needs — the substrate
  alone has no modelled resistance — just not what was blocking LVS. `vdd`
  was the opposite and stayed open for three increments: seven separate
  nets (one per `buf`/`xor2` instance), with a first buffer-only bus
  attempt failing outright (every candidate leg crosses a neighbouring
  ring's own bounding box) and Increment 6's fence measurement showing no
  met1 corridor could work at all — **closed by Increment 8 above**, using
  exactly the met1-stub-then-met2-bus recipe Increment 7 proved out for
  `t2`. Before that, an
  increment routed `ro_array_core`'s buffer→XOR `b` leg: `ro2` (`buf2.y`) into `xa1.b` and
  `ro4` (`buf4.y`) into `xa2.b` on met1, resolving that increment's own open
  finding (`klt drc` clean; `klt extract` 132 devices, 104 nets, down from
  106). Before that, the buffer→XOR `a` leg: `ro1` (`buf1.y`) into `xa1.a`
  and `ro3` (`buf3.y`) into `xa2.a` on met1 — the first routing this
  hierarchy level drew between the ring/buffer row and the XOR
  combining-tree row, with an escape-margin fix for the source pin's own
  tiny edge margin. Before that, `ro_array_core`'s forward ring→buffer
  signal chain was routed: the same eleven-sibling, 216.2 x 31.755 µm
  floorplan exposes `en1..en4`/the four `vddrN` domains/`ro1..ro4` as
  top-level pins (no routing needed — each is already a single node inside
  its own block) plus really routes `rn1..rn4` (`ro_ring5.ro` → `ro_buf.a`)
  on met1. Still open after Increment 8, none of it LVS-blocking:
  `ring1..4`'s and `xa1..3`'s own `vss` taps are still not drawn (a
  fabricated die wants the explicit strap; `klt extract`'s substrate model
  already merges the net, per the finding above), the PoC directory is not
  yet a `--check`-reproducible `layout/ro_array_core/` cell recipe, and no
  array-level parasitic extraction or post-layout PVT run exists yet — so
  the `wstv` inter-ring decorrelation question DR-0003 §8 leaves open is
  still open. `sampler_core`/
  `sampler_dff` remain untouched. The thirteen before it are nine leaf gates plus all
  four `ro_ring5` rings ([`layout/ro_ring5/`](../layout/ro_ring5/README.md)
  and `ro_ring5_wstv0p{44,46,48}/`), each `klt drc` clean (0 violations) and
  `klt lvs` **matching** `.subckt ro_ring5` at that ring's own `wstv`
  (22/22 devices, 19/19 nets, 0 errors). Those are the first *multi-gate*
  cells in the repository to reach that bar: five leaf gates placed via
  `klt gen-compose`'s `blocks[].cell` shape, the four forward inter-stage
  nets plus the `ro` feedback routed on met1, and `vddr`/`vss` bussed on
  met2 — four `gen-compose` stages across three physical routing planes.
  See [`layout/ro_ring5/README.md`](../layout/ro_ring5/README.md), which also
  records the two claims it corrects in the previous increment's
  `ro_ring5-connectivity-poc` (its `n1`-`n4` were a single shorted node, and
  its "unexplained device-internal DRC violations" were its own routes).
  The nine leaf cells are
  [`layout/ro_buf/`](../layout/ro_buf/README.md), this
  file's own `ro_buf` inverter,
  [`layout/ro_stage/`](../layout/ro_stage/README.md) and its three sibling
  `wstv` variants (`ro_stage_wstv0p{44,46,48}/`), the array's per-stage
  starved delay cell at all four ring widths, and
  [`layout/ro_nand2/`](../layout/ro_nand2/README.md) and its three sibling
  `wstv` variants (`ro_nand2_wstv0p{44,46,48}/`), each `ro_ring5`'s
  enable-gated first stage at all four ring widths — all built from `klt gen`
  primitives, placed and routed by `klt gen-compose`, `klt drc` clean (0
  violations against `klt`'s curated sky130 deck) and `klt lvs` **matching**
  their own `.subckt` in `design/ro_array_core.spice` (`ro_buf`: 2/2 devices,
  4/4 nets; `ro_stage`: 4/4 devices, 6/6 nets; `ro_nand2`: 6/6 devices, 8/8
  nets — each at all four `wstv`/`lstv=2` values, matching ring instances
  `xr1`-`xr4`), at this design's real `l_um=0.15` sizing. `ro_stage`'s and
  `ro_nand2`'s starve devices cross-couple their gates to the *opposite*
  rail, which needed a new two-pass composition technique (a second `klt
  gen-compose` call routing the crossing nets on a second metal level) to
  avoid a short — `ro_nand2`'s own parallel PMOS pull-up pair and series
  NMOS pull-down pair additionally needed that same technique generalized to
  a six-same-block-self-net final pass, and the three non-nominal `wstv`
  widths additionally needed the starve devices' own placement origin
  re-derived per width (a naive clone-and-reparametrize breaks DRC/LVS — see
  `layout/README.md`'s "Starve-width variants" section for the closed form)
  — see `layout/ro_stage/README.md` and `layout/ro_nand2/README.md` for the
  full derivations. All nine cells are reproducible from a committed
  descriptor, e.g.
  `python3 layout/bin/compose-cell.py layout/ro_nand2/cell.json` (add
  `--check` to verify without overwriting). Earlier increments established
  the per-device geometries (`layout/primitives/`) and the PMOS well-strap
  finding (`layout/well-strap-poc/`); the `klayout-tools` regression they
  recorded as a blocker
  ([#1491](https://github.com/2AMLogic/klayout-tools/issues/1491)) is fixed.
  Those nine cells are now also **extracted with parasitics and simulated**:
  [`layout/pex/`](../layout/pex/README.md) is a generated, `--check`-guarded
  post-layout netlist library (`klt extract --parasitics` over each
  committed GDS, rewritten for ngspice by `layout/bin/pex-netlist.py`), and
  `sim/post-layout-ro-ring5/` runs the five-stage ring from it across the
  PVT grid with the pre-layout netlist as a same-deck control — intra-cell
  parasitics cost **1.378×–1.479× in ring period**, raise ring-node swing
  1–4%, and lower per-ring supply current 2–6%
  (`spec/decision-records/DR-0005-*.md`).
  The four `ro_ring5` cells themselves are now **also** parasitic-extracted
  and simulated, this time as whole composed rings rather than leaf-cell
  compositions: [`layout/pex-ring/`](../layout/pex-ring/README.md) extracts
  each ring's own GDS directly (real inter-gate `n1`-`n4`/`ro` routing and
  `vddr`/`vss` rail busing included), and
  `sim/post-layout-ro-ring5-assembled/` re-runs the same period/swing/current
  measurement from it. Real inter-gate wiring costs the ring **1.5045×–1.6546×**
  more slowdown on top of intra-cell parasitics alone (period vs. pre-layout
  overall: **2.0819×–2.3666×**), and the `wstv` frequency ladder still
  survives. `xor2` has no post-layout record of its own: it is composed and
  verified but not extracted or simulated, since a PVT campaign is its own
  deliverable. Still open: no `ro_array_core` and no sampler as *assembled* layout, so
  there is still no *inter-ring* interconnect (supply distribution, XOR
  tree routing, buffer fan-in) to extract, and no whole-block post-layout
  PVT re-verification — every number above is one ring's own real
  interconnect with ideal wires to its neighbours. See `layout/README.md`
  for the full status and the follow-up issue (#27) it tracks. (`sim/` is no
  longer empty either — see `sim/README.md`.)
