2AMLogic/sky130-trng/layout/README.md

# layout

Physical layout evidence for the sky130-trng entropy source, verified with
`klayout-tools` (`klt`) against the sky130 open PDK. See `layout/pdk.json`
for the PDK/tool pin.

**Status (issue #173, the current increment, written on top of the entries
below): whole-block physical verification.** `layout/trng_whole/verify/`
runs DRC, extraction and a **mixed-level LVS** over the composed
`trng_whole.gds` (an immutable #172 input, `sha256:af2f8dfe...`): **`klt drc`
clean, 0 violations** (curated sky130 deck, 91 rules, `licon1.ongrid.1` still
enforced), **`klt lvs` match, 0 error mismatches** with the analog macro at
transistor level (264 MOSFETs) and the digital macro at standard-cell level
(8605 placed cells as pin-only black boxes, fill/tap compared not pruned,
hierarchy flattened), all **123 top-level ports** clean on a four-way coverage
matrix (unique pin, not joined, LVS-paired by name, comparer-independent
endpoint multisets equal), and **five isolated fault controls** (two swapped
boundary-signal identities, a swapped analog-to-digital interface on the
reference, a cut `raw_bit` route, a `vddr4`-to-`vdd` supply short) that each
reach LVS and fail naming their nets, followed by an untouched baseline that
still matches. The 5664 `licon1.ongrid.1` findings #172 reported were fixed
upstream (klayout-tools#2648) and already absorbed by the #181 regeneration;
no further regeneration was needed and no rule was waived. **This is
whole-block project verification on klt's curated decks, not foundry
sign-off.** Named limitations (digital cell internals and substrate/`VNB`
unchecked, device bodies unchecked, `power_connectivity` not applicable to this
reference form, 29 unloaded input pins have vacuous endpoint audits, partial
DRC rule coverage, ...) are in `trng_whole/verify/coverage.md` and are carried
into #174 and #170. #170, #18 AC3, DR-0003 section 8 / DR-0009 and the Unmet
area target are **not** closed. Entry point: `layout/bin/verify-whole.py`
(`run` / `controls` / `check`); evidence contract tests:
`layout/test_verify_whole.py`. Handoff for #174: `trng_whole/verify/README.md`.

**Status (issue #172, the previous increment): whole-block composition.** `layout/trng_whole/` composes the
verified `sampler_core` and `trng_digital` macros into one routed top cell
`trng_whole`: **18 whole-block nets (22 legs) routed, `unrouted_nets: []`, the
four `vddr1`-`vddr4` rails drawn as four distinct dedicated routes to their own
boundary pads (never merged with each other or with `vdd`/`vss`), common
`vdd`/`vss` and `clk`/`rst_n` between the macros and the boundary, 107 digital
pins promoted label-only**, plus a combined LVS reference
(`trng_whole.ref.spice`), an interface table (`interface.md`/`interface.json`)
and provenance (`report.json`). It is a *composition* increment with its own
narrow entry point, `layout/bin/compose-whole.py`; `compose-cell.py` and every
`layout/*/cell.json` check are unchanged, and the verdict is explicitly
**`composed; physical sign-off pending (#173 DRC/LVS, #174 characterization)`**.
**Area: 378.16 x 333.5 um = 0.126116 mm2 against the unchanged `< 0.05 mm2`
target: Unmet** (2.52x; `trng_digital` alone is 0.060 mm2). (Whole-block
DRC/LVS were pending when this was written; they are now the issue #173 entry
above.) Post-layout characterization (#174), #170, #18 AC3 and
DR-0003 section 8 / DR-0009's measurement obligations are **not** closed --
supply distribution geometry now exists, coupling/IR/period scatter are still
unmeasured. The routing uses `met5` (`top_metal`), the only sky130 routing role
above met2 (klayout-tools#2738). `sampler_core.gds` has no top-level pin
shapes; each analog boundary connection is a declared, audited port on
existing conductor. See `layout/trng_whole/README.md` for the handoff
(exact paths, hashes, mapping, pending verification).

**Status (issue #22, this increment): the shared-substrate tied/float/solo
bracket, run at whole-chain (`sampler_core`) scope.** This is the deck
DR-0003 §8 has been waiting for and the last hierarchy level DR-0006's own
follow-up list named as having no substrate-coupling measurement of its own.
Two new decks in `sim/post-layout-sampler-core/` (eight records,
twenty-four corner runs, all `PASS`) give loading **-0.650% to -0.283%** of
ring period and coupling **+0.361% to +0.584%**, positive at **12 of 12**
grid points — the array-scope sign signature reproduced at a larger scope
and 2-8x the magnitude. A second estimator taken inside the clocked window,
with all six `sampler_dff` instances actually latching, then finds that
consistency **gone** (-0.486% to +0.589%, 8 of 12 positive), because the
digitizer bank is itself a first-order aggressor on the shared node: one
ring plus a clocking sampler bank out-swings four free-running rings with
the bank static at 7 of 12 grid points. The `wstv` ladder still
clears every mutual-injection-lock rational by >= 11.2% at the floating
terminal. **DR-0003 §8 is narrowed, not closed** — proximity is closed,
substrate capacitive return is bracketed with an unmodelled interior
(klayout-tools#1503), and §8's first-named mechanism (shared supply
impedance) was unmeasurable for want of a `vddr1`-`vddr4` distribution
layout, which issue #172 has since drawn (`layout/trng_whole/`; geometry only --
the measurement itself is still open, tracked in #174). Full statement:
[`spec/decision-records/DR-0009-*.md`](../spec/decision-records/DR-0009-sampler-core-substrate-bracket-and-wstv-decorrelation.md).

**A previous increment (issue #22): `sampler_core`'s first whole-cell
post-layout PVT simulation campaign lands, closing the gap every prior
post-layout deck in this repo left open.** `sim/post-layout-sampler-core/`
drives `layout/pex-sampler-core/sampler_core_pex.spice` (below) with the
array's own enable/reset stimulus, extended to release and clock all six
`sampler_dff` instances — the first deck to exercise the whole raw-tap-to-
sampled-bit chain post-layout in one flat extraction, rather than the
entropy source and a digitizer measured separately. Four PVT points x
three process corners, all twelve `PASS`: ring period slows 2.161x -
2.504x against the pre-layout control (larger than either prior scope
alone, since this parasitic model carries both the array's own inter-block
routing and the six-sampler `d`-pin fan-out load together); all 120
captured-value snapshots land within 0.025% of a rail; reset-held sampler
outputs stay ≤ 0.403 mV while the rings free-run underneath. See
`sim/README.md` § "Sampler post-layout, whole composed cell" for the full
write-up. That campaign is a functional/timing/current characterization,
not a coupling study, and said so — the substrate bracket above is the deck
it named as still owed.

**A previous increment (issue #22): `sampler_core` is extracted with real
post-layout parasitics for the first time — the whole-cell sibling of
`layout/pex-array/` (source alone) and `layout/pex-sampler-dff-assembled/`
(one digitizer alone).** [`layout/pex-sampler-core/`](pex-sampler-core/README.md)
runs `klt extract --parasitics` directly over the now DRC/LVS-clean
`layout/sampler_core/sampler_core.gds` (264 devices, 152 nets, 169817.28 Ω
total series R, 869.19 fF total C — matching the whole-cell hand-off
measurement recorded on issue #22 before this directory existed). The
`net_aliases` table needed for this is built from `klt lvs`'s own verified
`net_correspondence` map rather than inferred from spelling, because one
family of six same-labelled nets (each `sampler_dff` instance's own `q`
pin) is never promoted to a GDS label at all — `sb`'s `q` becomes
`raw_bit`, `sv`'s becomes `raw_valid`, `sr1`-`sr4`'s become
`ring_bit1`-`ring_bit4`, and no naming convention in the extracted text
distinguishes which is which without that map. The six-entry alias family
this required, its order-sensitivity, and an independent union-find
verification (152 connected components over the generated library's own
`R` elements, matching `net_count` exactly, confirming no two instances'
outputs are shorted despite a confusing "dup" leg-naming pattern `klt`
itself uses) are documented in full in that directory's own README.

**A previous increment (issue #22): `sampler_core` is now DRC-clean *and*
LVS-clean — the first whole-cell DRC/LVS-clean `sampler_core` assembly in
this repo.** [`layout/sampler_core/`](sampler_core/README.md) adds three
stages (`vdd_strap1`-`vdd_strap3`) routing `ro_array_core`'s own `vdd` down
to the six-`sampler_dff` bank's own `vdd` rail, closing the second (and
last) of the cell's two inter-block supply straps. Unlike `vss`'s own
single-layer route, `vdd`'s path is blocked by a previously-undocumented
met1 net spanning the whole composed `x=211.64..214.97` corridor at one
height, so this strap uses a short met2 bridge (auto-via at both ends) to
get past it — three real single-leg attempts at a pure-met1 route were
tried and rejected first (two recovered from a prior interrupted session's
own uncommitted work, re-verified rather than redone; a third found fresh
this session when re-testing the recovered work's own chosen endpoint
against the current toolchain), documented in full in `cell.json`'s own
stage comment. `klt drc`: **clean, 0 violations**. `klt
extract`: **264 devices, 152 nets** (down from 153 — `vdd`'s two nets are
now genuinely one). `klt lvs` vs. `design/sampler_core.spice`'s own
`.subckt sampler_core`: **match — 264/264 devices, 152/152 nets, 0
errors**. Top-level pin promotion, previously thought also required for a
full match, turned out not to be — `klt lvs`'s own flattened comparison
does not need it. Still open: the assembled `sampler_core` post-layout PVT
run and DR-0003 §8's `wstv` re-evaluation, tracked in #27.

**A previous increment (issue #22): the `vss` half of `sampler_core`'s
inter-block supply strap is real metal, not just the shared p-substrate.**
[`layout/sampler_core/`](sampler_core/README.md) adds four stages
(`vss_strap1`-`vss_strap4`) routing `ro_array_core`'s own `vss` (tapped on
its east riser) down through the `sr2`→`sr3` inter-instance gap, across the
shared `vdd` rail's own height on a met2 bridge, to a direct landing on the
six-`sampler_dff` bank's own `vss` rail. `klt drc`: **clean, 0 violations**.
`klt extract`: **264 devices, 153 nets**, both unchanged — `vss` was already
one net via the substrate, so a real metal strap changes how the net is
*realized*, not its topology. `klt lvs`: mismatch, unchanged at **138/264
devices, 100/152 nets** (`vss` was already merged for LVS too; the
remaining mismatch is `vdd`'s own two-nets-not-one plus top-level pin
promotion, neither touched by this increment). A first attempt at the same
gap the previous increment's own data nets used (`sb`→`sv`) hit two real,
tool-caught obstacles — an array-internal met1 bar with no declared port,
and too little room for a via between it and `ro3`'s own channel haul — and
moved east instead; see this increment's own section for the measurements.

**A previous increment (issue #22): `sampler_core`'s whole data path is
routed — all five raw-tap nets reach their samplers, `sv`'s own `d` is tied
to `vdd` as the schematic requires, and every `d` pin in the cell is driven.
DRC-clean, 264 devices, 153 nets.** [`layout/sampler_core/`](sampler_core/README.md)
adds two stages on top of the six below: `data2_m1` (met1) draws nine legs —
the `d` climbs for `sb`/`sr2`/`sr3`, `sv`'s `d`→`vdd` tie, `ro2`'s and `ro3`'s
**westward** escapes along their own already-drawn horizontals, and the two
short legs `xo` needs — and `route_data2` (met2) closes the three remaining
hauls plus the 2.1 µm hop that joins `ro3`'s split escape over `ro2`'s own
vertical. `klt drc`: **clean, 0 violations**, first attempt on both stages.
`klt extract`: **264 devices, 153 nets** — `157 − 4`, exactly one merge per
net joined, each confirmed net-by-net rather than by the count. `klt lvs`:
mismatch, improved to **138/264 devices, 100/152 nets** (from 136/264,
94/152); a match still waits on the inter-block `vdd`/`vss` straps and
top-level pin promotion (#27), not on the data path.

The finding worth carrying forward is that the previous increment's own
framing — `ro2`/`ro3` "need a layer change *inside* the array's footprint"
— was right about the constraint and wrong about the move. Neither net hops
its fencing horizontals at all: a scan of the pre-increment stream for
columns where **met2** is free over the array's *whole* height (`y` 19.4 ..
50.0) finds exactly two bands, `x -2.1..1.65` (the array's west margin) and
`x 215.05..220.0`, and met1 at both nets' own run heights is free all the way
west to the first one — so they walk sideways on their own metal and descend
outside the array's congestion instead. The east band is free and *useless*:
reaching it needs a met1↔met2 via dropped into the 0.605 µm gap between the
array's own east supply riser and `ro4`'s escape leg, and the via's
concentric 0.42 µm pads need 0.70 µm at sky130's 0.14 µm spacing — measured
edges, checked arithmetic, one of the six new claims in that directory's own
`data-path-scan.py` (19 claims, up from 13). No new `2AMLogic/klayout-tools`
friction was found: the increment hit `#1567` (no multi-level via drop) at
`xa3`'s own li1 `y` pad exactly where the previous one predicted, and worked
around it with the hand-built met1 rung that filing itself describes.

**A previous increment (issue #22): the `ro_array_core` instance is
placed in `sampler_core`, and the first two raw-tap data nets are routed
end to end — DRC-clean, 264 devices, 157 nets.**
[`layout/sampler_core/`](sampler_core/README.md) adds three stages on top
of the `place`/`route_supplies`/`route_ctrl` stages below: `place_array`
puts one `ro_array_core` instance (the DRC-clean, LVS-*matching* entropy
source) at origin `(0.0, 23.635)`, directly above the six-`sampler_dff`
row with a 12.915 µm routing channel between them, so the whole
`design/sampler_core.spice` device population exists in one stream for
the first time; `data_m1` (met1) climbs `sr1`'s and `sr4`'s own `d` pins
out of li1 to a landing point under the shared `vdd` rail and extends
`ro1`'s and `ro4`'s own array metal south into the channel; `route_data`
(met2) closes the two hauls. `klt drc`: clean, 0 violations. `klt extract`:
**264 devices, 157 nets** — exactly two nets fewer than the unrouted
placement's 159, i.e. exactly the two intended connections and nothing
else. `klt lvs`: mismatch at 136/**264** devices, against a *complete*
reference for the first time (it read 176 before; see below).

Two derivations are worth carrying forward. **Above, not below**: a
`sampler_dff`'s own `d` pin is an li1 pad with the shared `vdd` rail
(met1) as the only obstacle above it but the shared `vss` rail (met1),
the shared `clk` lane (met2) *and* the in-cell `clkb` lane (met1) below —
and sky130's `klt` routing roles stop at the third metal, so from above
costs one layer change and from below costs a three-rung weave.
**Two of five data nets, not five**: a column-by-column met1 scan of
`ro_array_core.gds` finds a clear south escape over `ro1`'s own run and
over `ro4`'s, and **none at all** over `ro2`'s or `ro3`'s (the four ring
taps are stacked horizontals, so each lower one is fenced in by the ones
above it); `xo` is an li1 pad, two via hops from met2, which
`gen-compose` will not do in one route. All of that is re-derivable:
`layout/sampler_core/data-path-scan.py` re-measures 13 claims and exits
non-zero if any stops holding.

This increment also closed a `compose-cell.py` gap the previous one
recorded: the LVS reference generator repointed variant subckt calls only
in the top subckt's body, never in a `dependencies[]` entry's, so
`sampler_core`'s generated reference called an undefined `ro_ring5` and
`klt lvs` silently dropped four ring instances — 176 reference devices
where the schematic has 264. `build_lvs_reference` now repoints every
emitted body, with a unit test on the PR-blocking CI path.

Two `2AMLogic/klayout-tools` items were filed (`klayout-tools#1567`,
`klayout-tools#1568`): `gen-compose` has no
multi-level via drop (a third-metal route cannot land on a
base-`"metal"` pad, so a per-level ladder stage has to be hand-built —
this is what keeps `xo`, an li1 pad, unrouted), and its module docstring
denies an orientation capability the request validator actually has
(`mirror_x`/`mirror_y`/`rotate_180` all work), which cost this increment a
floorplan detour.

**A previous increment (issue #22): `sampler_core`'s shared `clk` fan-out
and shared `rst_n` fan-out are both routed across all six `sampler_dff`
instances, DRC-clean.** [`layout/sampler_core/`](sampler_core/README.md)'s
`route_ctrl` stage reuses the chain-of-six technique below for both nets.
`clk` was clean on the first attempt (five straight met2 legs at a lane
that already spans each instance's full width); `rst_n`'s first attempt
failed all five legs on a self-net short against other nets' met2
verticals near each instance's east edge, and was fixed by climbing to a
completely empty met2 band at `y=5.0` for the cross-instance haul and
dropping back down at the next instance. `klt drc`: clean, 0 violations.
`klt extract`: 132 devices unchanged, 64 nets (down from 74 — `clk` and
`rst_n` each merge six per-instance nets into one). No klayout-tools
friction: the self-net short check and its error message worked as
documented and caught a real problem.

**A previous increment (issue #22): `sampler_core`'s shared `vdd`/`vss`
bus is routed across all six `sampler_dff` instances, DRC-clean.**
[`layout/sampler_core/`](sampler_core/README.md) promotes the placement
proof-of-concept below into a real, `compose-cell.py --check`-reproducible
cell recipe (`cell.json`, stage `place`, byte-for-byte the same
floorplan) and adds a second stage, `route_supplies`, chaining `vdd` and
`vss` across `sb`→`sv`→`sr1`→`sr2`→`sr3`→`sr4` on met1 (`"metal2"` role) —
landing directly on each instance's own already-merged rail (a
`layout/sampler_dff/sampler_dff.gds` interior point, not a li1 pad needing
a via-drop, since that cell's own `route_supplies` stage already drew its
`vdd`/`vss` on met1). `klt drc`: clean, 0 violations, on the first attempt,
cell bbox unchanged. `klt extract`: 132 devices unchanged, and **74 nets**
(down from the placement PoC's 79 — `vdd` merges from six separate
per-instance nets into one, saving exactly 5; `vss` was already merged via
sky130's own global NMOS substrate). `klt lvs` against
`design/sampler_core.spice`'s real `.subckt sampler_core`: mismatch, as
expected (no `ro_array_core` instance placed yet, `clk`/`rst_n`/`d`/`q` all
unwired) — wiring up that `lvs` block also surfaced a real
`compose-cell.py` limitation (not a `klt` gap): `dependency_variants`'s
subckt-call repointing only rewrites the *top* subckt's own lines, not a
plain `dependencies[]` entry's own body, so `ro_array_core`'s nested
`ro_ring5` calls in the generated reference are silently left unresolved
(`klt lvs` drops them rather than erroring) — recorded in
`layout/sampler_core/README.md` for whoever attempts the real whole-cell
LVS pass. No `2AMLogic/klayout-tools` friction was found by this increment.

**A previous increment (issue #22): the `sampler_core` six-`sampler_dff`
bank has a verified, DRC-clean floorplan.**
[`layout/sampler_core-placement-poc/`](sampler_core-placement-poc/README.md)
places six already-composed, individually DRC-clean and `klt lvs`-clean
`layout/sampler_dff/sampler_dff.gds` instances side by side (55.66 um pitch,
`design/sampler_core.spice`'s own `sb`/`sv`/`sr1`-`sr4` instance order and
naming), with zero routing — `klt drc` clean, 0 violations, on the first
attempt, and `klt extract` confirms 132 devices (66 nfet + 66 pfet, exactly
6x `sampler_dff`'s own split) and 79 nets (not the naively-expected 84 — the
five-net difference is sky130's own global-substrate NMOS-bulk merge, traced
and confirmed benign, not a false short). This is a proof-of-concept
placement stage, the same first move every earlier hierarchy level in this
repo made (`layout/ro_ring5/`, `layout/sampler_dff/` itself,
`layout/ro_array_core-placement-poc/` before `layout/ro_array_core/`) —
`sampler_core`'s own shared `vdd`/`vss`/`clk`/`rst_n` bus routing, wiring in
a `ro_array_core` instance, `d`/`q` pin promotion, and whole-cell `klt lvs`
against `design/sampler_core.spice`'s real `.subckt sampler_core` (which
wires the source *and* the samplers together, not "six samplers" alone —
see that directory's own README) all remain open, tracked here and in #27.
No `2AMLogic/klayout-tools` friction was found by this increment.

**A previous increment (issue #22): `sampler_dff`'s own composed assembly
GDS is now extracted with real intra-cell parasitics and re-simulated,
the sampler-side sibling of `layout/pex-ring/`.** Now that `m`/`mb` are
both routed (`mb`: PR #95; `m`: PR #99, previous increment below) and
`layout/sampler_dff/`'s own `klt lvs` is a full match (22/22 devices, 14/14
nets, 0 mismatches), `layout/sampler_dff/sampler_dff.gds` is a valid
extraction source for the first time — the whole-cell extraction
`spec/decision-records/DR-0007-*.md`'s own "Follow-up required" list named
explicitly. [`layout/pex-sampler-dff-assembled/`](pex-sampler-dff-assembled/README.md)
runs `klt extract --parasitics` directly over that GDS (22 devices, 14
nets, matching `layout/sampler_dff/extract.json` exactly; total series R
14.3 kΩ, total C to substrate 61.4 fF — roughly 3-4x the sum of the three
leaf cells' own totals in `layout/pex/README.md`, consistent with real
inter-leaf-cell routing adding cost no leaf-only sum could include), and
`sim/post-layout-sampler-dff-assembled/` re-runs the capture-timing/
reset-contention deck (DR-0007's own `tb_post_layout_sampler_dff.spice`
topology, unchanged) across the same four-(temp, Vdd)-point, `tt`/`ss`/`ff`
grid (4 records, 12 corner runs, all `PASS`). Headline: clk→q capture
delay now costs **1.704x - 2.013x** against pre-layout (up from the
leaf-cell composition's own 1.314x - 1.418x), i.e. **1.268x - 1.425x on top
of** the leaf-cell figure at matching PVT/corner points — smaller than the
~1.5x - 1.7x DR-0007 borrowed from DR-0006's *array-scale* result as a
placeholder (a different interconnect shape, not a wrong estimate); the
reset window still carries no contention current, agreeing with the
leaf-cell figure to 4-5 significant figures at every grid point; and the
assembly is functionally correct (captured levels ≥ 0.9988x Vdd high /
≤ 0.00195x Vdd low, reset holds `q` ≤ 0.386 mV). Along the way, a latent
bug in `layout/bin/pex-netlist.py`'s own `main()` was found and fixed: its
generated library's own provenance header hardcoded `f"layout/pex/{name}"`
regardless of which directory the descriptor actually lived in, so every
descriptor outside `layout/pex/` (`layout/pex-ring/pex.json`,
`layout/pex-array/pex.json`, and now this directory's own `pex.json`) got a
header whose quoted `--check` command named the wrong descriptor — caught
because this increment's own new library would otherwise have opened with
a banner naming `layout/pex/pex.json`, a file that has nothing to do with
it. Fixed generically (`descriptor_path()`, unit-tested for every existing
`layout/pex*/` directory plus this one), not by special-casing this
directory's own name. See
[`spec/decision-records/DR-0008-*.md`](../spec/decision-records/DR-0008-sampler-dff-assembled-post-layout.md)
for the full re-evaluation, including what it explicitly does not
re-measure (DR-0007's own setup-time bracket, and `sampler_core`'s
six-instance fan-out — both left as follow-up, `sampler_core` still has no
layout at all, tracked in #27).

**A previous increment (issue #22): `sampler_dff` is DRC-clean and `klt
lvs`-clean.** The sixth and last data-path net, `m` (`TG_D.b` ↔ `NAND_M.a`
↔ `TG_FBM.b`), is routed across four `gen-compose` stages
(`m_stub`/`m_met1`/`m_met2`/final), completing every net the cell needs.
`klt drc`: clean, 0 violations. `klt extract`: 22 devices, 14 nets. `klt
lvs` against `design/sampler_core.spice`'s own `.subckt sampler_dff`:
**match — 22/22 devices, 14/14 nets, 0 mismatches, 0 errors** — the first
fully DRC/LVS-clean multi-cell assembly in this repo, on the first attempt.
`m`'s own tricky part: `TG_FBM.b`'s declared `(23.755, 1.2)` port cannot be
via'd to `met1` or `met2` in place (both planes are inside `mc`'s own bus
footprint there, a foreign net), so the route lands instead on a *second*
point of that same physical net's own already-drawn `li1` diffusion strap,
`(23.8, 2.71)` — directly above both `mc`'s and `rst_n`'s own bus bars
rather than crossing either. See
[`layout/sampler_dff/README.md`](sampler_dff/README.md)'s "`m` fan-out"
section for the full derivation, including a false-blocked reading
(a small-box check found the pin itself clear; a full-column check found
the *route* to it was not, for a different reason) that was caught and
corrected before it produced a wrong route. No new `2AMLogic/klayout-tools`
friction filed: this increment independently reproduced the already-filed
`#1548` finding (an unrecognized `connectivity[].legs[]` field is silently
dropped by a stale `klt` build rather than rejected) on this session's own
installed `klt` (a *different* build than `#1548`'s own filing used), and
worked around it the way `_parse_connectivity`'s own error message
suggests — two 2-pin `connectivity[]` entries sharing an endpoint instead
of one 3-pin bundle net — rather than filing a duplicate.

**A previous increment (issue #22): the sampler is extracted with
parasitics and simulated — the first `sim/` evidence about `sampler_dff` of
any kind, pre- or post-layout, and the first post-layout campaign in this
repo on the far side of the raw tap.** [`layout/pex/pex-sampler.json`](pex/README.md)
is a second descriptor for the same `layout/bin/pex-netlist.py`, producing
`layout/pex/sampler_dff_pex.spice` from the three composed leaf cells
[`layout/sampler_dff/`](sampler_dff/README.md) places
([`ro_buf`](ro_buf/README.md), [`sampler_tg`](sampler_tg/README.md),
[`sampler_nand2`](sampler_nand2/README.md) — each already `klt drc` clean at
0 violations and `klt lvs` matching its own reference), and
`sim/post-layout-sampler-dff/` runs two decks from it across the same
four-(temp, Vdd)-point, `tt`/`ss`/`ff` grid every post-layout campaign here
uses (24 corner runs, 8 records, all `PASS`). Headline: intra-cell
parasitics cost **1.314x - 1.418x** in clk→q capture delay — *inside*
DR-0005's own 1.378x - 1.479x intra-cell ring finding, two independent
measurements of the same quantity agreeing; the setup-time window is
**60 - 150 ps** post-layout — and, compared *per corner* against DR-0003
§1's own `w_90` table rather than against a single range bottom, it is below
that corner's own `w_90` at each of the nine (temp, Vdd, corner) points
where both quantities are measured, including (60, 73] ps against 122.0 ps
at `ff`/−40 °C/1.98 V, the corner where `N_max_combine` binds
(`sim/xor-combining-bandwidth/` has no 125 °C point, so this campaign's
three 125 °C/1.98 V points are outside that comparison), so the digitizer is
**not** the block's bandwidth bottleneck; and the reset window carries **no
contention current at all**
(19.3 pA - 293 nA, at or below the same cell's idle current at every grid
point, and identical pre- and post-layout to 3-5 significant figures) —
which is `spec/porting-plan.md`'s DR-0014 **methodology** transfer, run on
this repo's own drawn storage-loop topology instead of inherited from
gf180mcu's numbers. See
[`spec/decision-records/DR-0007-*.md`](../spec/decision-records/DR-0007-sampler-dff-post-layout-and-reset-contention.md)
and `sim/README.md`'s "Sampler post-layout" section for every number and for
what is and is not claimed (in particular: the brute-force pull-device reset
alternative was **not** simulated, so no reduction ratio against it is
quoted, and per DR-0011 nothing here is a metastability claim).
**Deliberately not attempted**: extracting `layout/sampler_dff/`'s own
assembly GDS flat — its `m`/`mb` data-path nets are still unrouted, so its
`klt lvs` still does not match (15/22 devices, 7/14 nets as of the #84 fix
below; **`mb` is routed as of the `mb` increment above, so this reads
`m` only, 18/22 and 8/14, today** — the reasoning is unchanged while any
data-path net is open) and that extraction would be of an incomplete
circuit. So this is
intra-cell parasitics plus **ideal** inter-cell wires, the same scope
[`layout/pex/`](pex/README.md) has for the ring and one level below
[`layout/pex-ring/`](pex-ring/README.md) — a floor on the real cost, and
both deck headers say so.

**A previous increment (issue #84): the `sampler_nand2` input swap the
`qb` increment below found is fixed — `rst_n` now wires to both instances'
`en` pins and the data nets (`m`/`q`) to their `a` pins, `klt drc` stays
clean (0 violations, cell bbox unchanged at `-2.19 .. 50.47` ×
`-3.585 .. 7.085` µm), and `klt extract`'s device list for both the
`nand_m_y` node and the `qb` node now shows the output-adjacent nfet gated
by the data net, matching `design/sampler_core.spice`'s `XMimna`/`XMis2na`
exactly.** The fix re-derives `rst_n`'s own three-stage stub escape (now
two stages: `en` sits outside `sampler_nand2`'s internal `met1` blob, so no
stub is needed — see `rst_n_met1` in `layout/sampler_dff/cell.json`) and
`q`'s own route (now four stages: `nand_s2.a` sits *inside* that same blob,
so `q` inherits the stub escape `rst_n` no longer needs, plus a
`met1`→`met2` plane change the corrected destination's own obstruction
geometry requires — see `q_stub`/`q_met1`/`q_met2`/`q_bus`). **It also
re-derives one already-merged route it displaces**: `q`'s new `met2` stack
lands squarely on the plane the `s` increment below runs its long haul on,
so `s`'s own east leg is re-steered around it (same three pins, same
`s_met1` stage, same lane height at both ends — only the middle of leg 2
moves). `klt extract`'s own net count is unchanged at **18**, device count
unchanged at **22**, and `klt lvs` against `design/sampler_core.spice`'s
`.subckt sampler_dff` improves to **15/22 devices, 7/14 nets** (from 12/22,
5/14) with the `topology: nets were paired despite a name/identity
conflict` fingerprint of the swap **gone** — the remaining 13 mismatches
are exactly the categories every prior increment's own `lvs.json` already
showed (`device.unmatched`, `net.split`, `net.merged`; unwired `m`/`mb`),
not a new regression. See `layout/sampler_dff/README.md`'s "Correction
(issue #84): the `sampler_nand2` input swap is fixed" for the full
derivation.

**A previous increment (issue #22): `sampler_dff`'s `d` input pin is
promoted to a real, labelled top-level port for the first time.** Five of
the cell's six external pins (`clk`, `rst_n`, `q`, `vdd`, `vss`) already
carried a genuine, correctly-spelled net-name label as a side effect of
their own routing increment; `d` never did, since `tg_d.a` is its only
connection and no fan-out/bus route ever crossed it — `klt extract` named
that node only `a|tg_d_a`, with no `d` anywhere. Fixed with
`gen-compose`'s `pins[]` mechanism (issue #210, a label-only promotion,
zero routing): a `{"net": "d", "block": "core", "port": "tg_d_a"}` entry
in the final stage draws a `kdb.Text` label on that port's own
already-drawn li1 pad. **`klt drc` clean, 0 violations, cell bbox
unchanged**; `klt extract` confirms the node now reads `a|d|tg_d_a`, and
`net_count` is unchanged at 18 (a label renames a net, it does not create
or merge one). `klt lvs`'s verdict is unchanged from the `s` increment
(12/22 devices, 5/14 nets, 16 mismatches) — a label does not wire `m`/`mb`
or fix the open `sampler_nand2` pin swap
([#84](https://github.com/2AMLogic/sky130-trng/issues/84)), which is what
still blocks a clean sign-off. A `klt extract --pins` (`declared_pins`)
experiment aimed at narrowing the extracted netlist's pin set to exactly
this cell's six real ports was tried and abandoned: `declared_pins`
matches a net's whole already-joined SPICE name verbatim, not a bare
substring, so it demoted every net's pin status to zero and left the
`klt lvs` mismatch count completely unchanged either way — not committed.
See [`layout/sampler_dff/README.md`](sampler_dff/README.md)'s "Result: `d`
pin promotion" for the full writeup. Whole-cell external pin promotion is
now done for all six ports; what remains is `m`/`mb` and `#84`.

> **Superseded in part by the issue #84 increment above.** The `d` label
> itself is untouched (`klt extract` still reads `a|d|tg_d_a`) and the
> `net_count` claim still holds at 18. Only the `klt lvs` verdict quoted
> above is now historical: it reads **15/22 devices, 7/14 nets, 13
> mismatches** as of the #84 fix, and `#84` is no longer open.

**A previous increment (issue #22): `sampler_dff`'s fourth data-path net,
`s`, is routed — DRC-clean, the cell's first three-pin data-path net, and
the only one of the three that were left open which touches neither
`sampler_nand2` instance (so it is unaffected by the open pin swap
[#84](https://github.com/2AMLogic/sky130-trng/issues/84), and does not
add to that fix's blast radius).** `s` is the slave latch's own storage
node — `tg_s.b` (`28.895, 1.2`), `inv_q.a` (`36.545, 1.7`), `tg_fbs.b`
(`48.185, 1.2`), i.e. `design/sampler_core.spice`'s own
`XMtsp`/`XMtsn`/`XMisp`/`XMisn`/`XMfsp`/`XMfsn` — `19.29 µm` apart end to
end, two thirds of the cell's width. **No met1 lane can carry it**: every
lane between the pins' own `y = 1.2` and the `vdd` bus is blocked at two or
more columns by metal earlier increments drew (`q`'s L-lane, `qb`'s east
run, `clkb_bus`'s east segment, `clkb_seg2`'s own vertical) plus
`sampler_nand2`'s own internal met1 blob — so this net takes `mc`'s
two-stage recipe one plane further out: `s_met1` vias all three li1 pins
straight up to met1 (three single-hop via-drops, zero lateral distance),
and the final stage runs **one straight `met2` lane at `y = 1.7`**, steered
leg-by-leg with `connectivity[].legs[]`. That `y` is the *middle pin's own*
`y`, deliberately: the round `y = 2.0` first attempt produced exactly one
DRC violation, an **0.005 µm same-net notch** between `inv_q.a`'s own
`0.42 µm` via-drop pad (top edge `y = 1.91`) and the lane's own bottom edge
(`y = 1.915`) — running the lane at `1.7` makes the two shapes overlap
instead of nearly touching, and drops a corner from the route. **`klt drc`
clean, 0 violations; cell bbox unchanged**; `klt extract`'s net count drops
from 20 to **18** (exactly the two merges a three-pin net makes), and the
merged net's own **six**-device list matches
`design/sampler_core.spice` device for device on class, width *and* every
gate/terminal role — no discrepancy of the kind `qb`'s own check turned up.
See [`layout/sampler_dff/README.md`](sampler_dff/README.md)'s "Result: `s`
fan-out". Two data-path nets (`m`, `mb`) remain, and both touch `NAND_M`,
so both are downstream of #84.

> **Superseded in part by the issue #84 increment above.** The premise, the
> three pins, the `s_met1` stage and the `y = 1.7` lane height at both ends
> are unchanged, and the `y = 2.0` same-net-notch finding still stands. What
> is now historical is "**one straight** `met2` lane": #84 moves `q`'s own
> long haul onto `met2` directly across this lane's path (`q`'s east
> climb occupies `x = 44.815 .. 44.985`, `y = 1.285 .. 2.5`, and its landing
> pad `x = 44.69 .. 45.11`, `y = 2.5 .. 2.92`), and `rst_n`'s corrected `en`
> via pad occupies `x = 42.865 .. 43.285` from `y = 1.765` up. `s`'s leg 2 is
> therefore re-steered: `y = 1.7` east to `x = 40.0`, a **0.175 µm dip to
> `y = 1.525`** (the exact middle of the 0.48 µm window between `q`'s lane
> and `rst_n`'s pad) to `x = 44.0`, then a climb to **`y = 3.2`** — the first
> `met2` lane clear of `q`'s landing pad — east to `x = 48.185` and back down
> to the pin. Route length `20.29 → 23.64 µm`; **still `klt drc` clean, 0
> violations, cell bbox unchanged**, tightest new-to-existing `met2` gap
> **0.1555 µm** against sky130's 0.14 µm `met2.space.1`. The net's own
> six-device list and the `net_count` of 18 are unaffected — this is the same
> conductor on a different path.

**A previous increment (issue #22): `sampler_dff`'s third data-path net,
`qb`, is routed — DRC-clean — and its own device-list check found a
pre-existing, LVS-blocking pin swap on both `sampler_nand2` instances
(filed as [#84](https://github.com/2AMLogic/sky130-trng/issues/84), fixed
above).**
`qb` (`nand_s2.y` → `tg_fbs.a`, `design/sampler_core.spice`'s own
`XMis2pa`/`XMis2pb`/`XMis2na`/`XMfsp`/`XMfsn`) is the third of the six
`m`/`mb`/`mc`/`s`/`q`/`qb` data-path nets #27 left open. It is the first
whose `sampler_nand2` end is *inside* that leaf's own internal `met1` blob
while being **on that blob's own net** — `klt extract` names the blob
`mnab_y|mpa_y|mpb_y|nand_s2_y|y` — so unlike `rst_n` (whose `a` pin sits in
the same blob on a *different* net and needed a three-stage li1 stub escape)
this net needs no escape at all: the via-drop landing pad is an exact
overlay on metal it is already shorted to, and adds no geometry. One
`metal2`-role (`met1`) stage, `9.6 µm`, climbing on a column jogged 0.17 µm
east of the pin (so the climb overlays the blob rather than leaving an
0.08 µm same-net notch against its narrow upper bar) and then running the
whole span east at `y = 2.0` — the only free met1 lane between `clkb`'s own
east segment (0.675 µm below) and `clk`'s own via pad at `tg_fbs_ctrl`
(0.205 µm above). **`klt drc` clean, 0 violations; cell bbox unchanged**;
`klt extract`'s net count drops from 21 to **20**, and the merged net's own
five-device list matches `design/sampler_core.spice` in count, class and
width exactly and in four of five gate assignments. The fifth is the
finding: the `W=0.84` NMOS on this node is gated by `rst_n` where `XMis2na`
says `q` — the fingerprint of `rst_n` and the data input being wired to the
swapped `sampler_nand2` pins, on **both** instances. That swap is
functionally harmless (a NAND2's inputs commute) but verified LVS-blocking,
and is left for #84 rather than re-derived here, since fixing it re-does two
already-merged increments. See
[`layout/sampler_dff/README.md`](sampler_dff/README.md)'s "Result: `qb`
fan-out" and "The `sampler_nand2` input swap the `qb` increment found".

> **Superseded by the issue #84 increment above.** The `qb` node's own
> five-device list, count, class and width claims above still hold; only
> the fifth device's gate assignment claim is now current-tense wrong —
> it is gated by `q` (matching `XMis2na`), not `rst_n`, as of the #84 fix.

**A previous increment (issue #22): `sampler_dff`'s second data-path net,
`q`, is routed — DRC-clean on the first attempt, and the first data-path net
needing only one `gen-compose` stage.** `q` (`inv_q.y` → `nand_s2.en`,
`design/sampler_core.spice`'s own `XMisp`/`XMisn`/`XMis2pa`/`XMis2na`) is
the second of the six `m`/`mb`/`mc`/`s`/`q`/`qb` data-path nets #27 left
open after `rst_n`/`clk`/`clkb`/`mc`. Unlike `mc`, this net needs no
via-then-bus split: `klt`'s own layout database shows `met1` is completely
empty across the whole span except `sampler_nand2`'s own internal `met1`
via stack at `nand_s2` (`x = 43.845..44.435`, the same obstruction
`rst_n`/`clk`/`clkb` all had to route around at other columns), and this
net's own east pin, `nand_s2.en` at `x = 43.075`, sits far enough west of
that blob (`0.77 µm` to its near edge) that a route which never crosses
`x = 43.845` has no reason to detour at all — so one `metal2`-role
(`met1`) stage vias both pins and runs the whole L-shaped haul
(`5.95 µm`: `5.175 µm` east + `0.775 µm` north) on `met1` itself, the same
single-stage recipe `clkb_seg1` already established for a one-hop route.
**`klt drc` clean, 0 violations, first attempt; cell bbox unchanged**;
`klt extract`'s net count drops from 22 to **21** (the one merge a
two-pin net makes), and the merged net's own four-device list —
`inv_q`'s own PMOS/NMOS output pair (`XMisp`/`XMisn`) plus `NAND_S2`'s two
`en`-gated devices, the parallel PMOS and the input-side series NMOS
(`XMis2pa`/`XMis2na`) — matches `design/sampler_core.spice` exactly. See
`layout/sampler_dff/README.md`'s "Result: `q` fan-out" for the full
derivation and "What remains" for the four nets still open. (Partly
superseded by the `qb` increment above: three of those four devices are
`XMisp`/`XMisn`/`XMis2pa` exactly, but the `q`-gated `W=0.84` NMOS sits in
`XMis2nb`'s `vss`-adjacent position rather than `XMis2na`'s — the
[#84](https://github.com/2AMLogic/sky130-trng/issues/84) pin swap, not a
property of the `q` route.)

> **Superseded by the issue #84 increment above.** `q`'s own destination
> pin changed (`nand_s2.en` → `nand_s2.a`) and with it the route itself —
> `q` now lands on the output-adjacent device exactly as `XMis2na`
> requires, the four-device-list claim above holds again in full, and the
> route recipe grew from one `gen-compose` stage to four (`q_stub`/
> `q_met1`/`q_met2`/`q_bus`) since the corrected destination sits inside
> `sampler_nand2`'s own internal `met1` blob. See
> `layout/sampler_dff/README.md`'s "Correction (issue #84)" section.

**A previous increment (issue #22): `sampler_dff`'s first data-path net,
`mc`, is routed — DRC-clean on the first attempt.** `mc`
(`inv_mc.y` → `tg_fbm.a`, `design/sampler_core.spice`'s own
`XMim2p`/`XMim2n`/`XMfmp`/`XMfmn`) is the first of the six `m`/`mb`/`mc`/
`s`/`q`/`qb` data-path nets #27 left open after `rst_n`/`clk`/`clkb`. A
plain `met1` route is blocked for its entire useful height band — `clkb`'s
own `clkb_mid` backbone crosses at `y ≈ 2.33`, and `clk`'s own via-drop
pad at `tg_fbm.ctrlb` sits at the same x as the pin gap — so this net vias
one plane further, to `met2` (empty across this span), and runs a short
U-shaped lane at `y = 1.8`. `klt drc` clean (0 violations), cell bbox
unchanged, `klt extract`'s net count drops from 23 to **22** (the one
merge a two-pin net makes), and the merged net's own four-device list
matches `XMim2p`/`XMim2n`/`XMfmp`/`XMfmn` exactly — the correctness check
that matters, since a route landing on the wrong side of `tg_fbm`'s pass
gate would still pass DRC. See `layout/sampler_dff/README.md`'s "Result:
`mc` fan-out" for the full derivation (including why the direct-`met1`
and several `met1`-with-a-jog candidates were rejected before `met2`)
and "What remains" for the five nets still open.

**A previous increment (issue #22): `sampler_dff`'s `clkb` fan-out is
routed too — the differential half of `clk`'s own five-pin bundle,
DRC-clean, and confirmed by `klt extract` to reach exactly the six
clkb-gated devices the schematic has.** [`layout/sampler_dff/`](sampler_dff/README.md)
adds five more stages on top of the `clk` work below. `clkb` cannot reuse
`clk`'s own `met2` lane below the rows (their verticals share four of five
x-columns, opposite y, on each transmission gate — see "Why `clk` and
`clkb` cannot be two mirrored lanes" in the cell's own README), so it
instead takes the `met1` corridor `clk`'s own final stage reserved
(`y ≈ 0.40`): `clkb_seg1`/`clkb_seg2` route the `met1` long haul, with two
`clkb_bridge1`/`clkb_bridge2` stages hopping onto `met2` and back to clear
`sampler_nand2`'s own internal `met1` blobs (the same obstruction `clk`'s
own long haul also had to route around), and two east-side jogs in
`clkb_seg2` dodge `clk`'s own via-drop pads at the `tg_fbm`/`tg_s`
columns. **`klt drc` clean, 0 violations; cell bbox unchanged.**
`klt extract`'s net count drops from 27 to **23** — exactly the four
merges a five-pin net makes — and the merged net's own six-device list is
the correctness check that matters: the two `inv_clk` devices, `tg_d`'s
**NMOS**, `tg_fbs`'s **NMOS**, `tg_fbm`'s **PMOS** and `tg_s`'s **PMOS**
gates, matching `design/sampler_core.spice`'s
`XMpc`/`XMnc`/`XMtdn`/`XMfsn`/`XMfmp`/`XMtsp` exactly, with `clk`'s own
merged group staying a separate net. `klt lvs` is still not expected to
match (the six data-path nets `m`/`mb`/`mc`/`s`/`q`/`qb` remain unwired,
and no top-level cell pins are promoted yet). See
`layout/sampler_dff/README.md`'s own "Result: `clkb` fan-out" for the full
stage-by-stage breakdown, and its "Environment note" for a `klt`
install-staleness finding filed as
[`2AMLogic/klayout-tools#1548`](https://github.com/2AMLogic/klayout-tools/issues/1548)
(an unrecognized `connectivity[]` request field, e.g. `legs[]` on a build
that predates it, is silently dropped instead of rejected).

**A previous increment (issue #22): `sampler_dff`'s `clk` fan-out is
routed — a five-pin bundle net, DRC-clean, and confirmed by `klt extract`
to reach exactly the six clk-gated devices the schematic has and no
others.** [`layout/sampler_dff/`](sampler_dff/README.md) adds two more
stages on top of the `rst_n` work below: `clk_met1` vias all five `clk`
pins straight up from `li1` to `met1` (zero lateral distance, the same
single-hop via-drop `rst_n_met1` uses, five times), and the final stage
runs the whole long haul on `met2`/`"metal3"` as one basement lane at
`y=-1.70` with a vertical drop at each pin's own x, steered leg-by-leg with
`connectivity[].legs[]` (klayout-tools #1529 — `waypoints_um` is rejected
outright on a >2-pin net, so `legs[]` is the only way to hand-route a
fan-out of this shape). **`klt drc` clean, 0 violations; 0 unrouted nets;
cell bbox unchanged.** `klt extract`'s net count drops from 31 to **27**
— exactly the four merges a five-pin net makes — and the merged net's own
device list is the correctness check that matters: the two `inv_clk`
devices, `tg_d`'s **PMOS**, `tg_fbm`'s **NMOS**, `tg_s`'s **NMOS** and
`tg_fbs`'s **PMOS** gates, matching `design/sampler_core.spice`'s
`XMpc`/`XMnc`/`XMtdp`/`XMfmn`/`XMtsn`/`XMfsp` exactly, with the four
`clkb`-gated devices still correctly isolated. That alternating
PMOS/NMOS assignment (a master-slave DFF's feedback gates run the opposite
phase from their own stage's input gate) is why `clk` and `clkb` cannot
share a simple "one lane above, one lane below" plan — see
`layout/sampler_dff/README.md`'s "Why `clk` and `clkb` cannot be two
mirrored lanes" for the derivation and for the `met1` corridor at
`y ≈ 0.40` this increment deliberately leaves free for `clkb`. `klt lvs` is
still not expected to match (`clkb` and the six data-path nets
`m`/`mb`/`mc`/`s`/`q`/`qb` remain unwired, and no top-level cell pins are
promoted yet).

**A previous increment (issue #22): `sampler_dff`'s `rst_n` fan-out is
routed — DRC-clean and electrically merged across both `sampler_nand2`
instances.** [`layout/sampler_dff/`](sampler_dff/README.md) adds three
routing stages on top of the previous increment's placement + `vdd`/`vss`
buses: `rst_n_stub` walks each `sampler_nand2` instance's `a` pin (the
`rst_n` input) east on its native `li1` layer (no via needed) until it is
clear of that leaf's own internal `met1` via stack — 0.57 µm for `nand_m`
and 0.61 µm for `nand_s2`, the same escape done twice but not the same
length, since each stub tip is snapped to a round global x (`14.0`/`44.9`)
rather than to a fixed offset; `rst_n_met1` vias each stub tip up
to `met1`; the final stage vias again, `met1` to `met3`/`"metal3"` role, and
buses the whole `nand_m` → `nand_s2` span on `met3` — a plane no leaf cell
in this assembly draws on at all, clear of every leaf's own internal
congestion *and* of the `vdd`/`vss` buses' own `met1` bus (which spans the
entire cell width, ruling out a "climb over the obstruction" detour on
`met1` itself). **`klt drc` clean, 0 violations**; **`klt extract` confirms
`nand_m`'s and `nand_s2`'s own `a` pins and `rst_n` are one physically
merged net** (`sampler_dff.spice`'s own `.SUBCKT` pin line lists them
together as a single label group) — the first data/control net in this cell
routed end to end, after the previous increment's supply rails. `klt lvs`
is still not expected to match (`clk`/`clkb` fan-out and the six data-path
nets `m`/`mb`/`mc`/`s`/`q`/`qb` remain unwired, and no top-level cell pins
are promoted yet) — see `layout/sampler_dff/README.md`'s "What remains" and
its own "Why `rst_n` needed three routing stages, not one" for the full
derivation, including two `li1.space.1` DRC violations hit and fixed along
the way.

> **Superseded by the issue #84 increment above.** `rst_n` wired to both
> instances' **`a`** pins here — `design/sampler_core.spice` requires the
> **`en`** pins instead (see "The `sampler_nand2` input swap" the `qb`
> increment above found). The merged-net and DRC claims above described
> real, DRC-clean geometry at the time, but on the wrong pin; issue #84
> re-derives this net onto `en` (now two stages, not three — `en` sits
> outside the internal `met1` blob the `a`-pin stub above existed to
> escape, so no stub is needed) and the `a` pins are freed for the
> data-path nets (`q`, and eventually `m`) that `design/sampler_core.spice`
> actually puts there. See `layout/sampler_dff/README.md`'s "Correction
> (issue #84)" section.

**A previous increment (issue #22): `sampler_dff` assembly is started —
placement plus the `vdd`/`vss` supply buses are DRC-clean.**
[`layout/sampler_dff/`](sampler_dff/README.md) places all nine of
`sampler_dff`'s already-composed leaf-cell instances (3x
[`ro_buf`](ro_buf/README.md), 4x [`sampler_tg`](sampler_tg/README.md), 2x
[`sampler_nand2`](sampler_nand2/README.md)) via `blocks[].cell`, reading
`design/sampler_core.spice`'s flat 22-device `.subckt sampler_dff` as a
signal-flow pipeline (`d -> TG_D -> NAND_M -> inv_mc -> TG_FBM` feedback into
`m`; `NAND_M`'s own output cascades into `TG_S -> inv_q -> NAND_S2 -> TG_FBS`
feedback into `s`) rather than as an unordered device list. The placement
`klt gen-compose` stage is **DRC-clean (0 violations)** on the first attempt,
and a second stage routes `vdd`/`vss` as two attic/basement buses (`metal2`
role) across all nine instances — also **DRC-clean (0 violations)**, and `klt
extract` confirms both rails fully merged into one `vdd` net and one `vss`
net (13 and 10 promoted-label legs respectively) spanning every instance.
`klt extract` also independently confirms the composed geometry's own device
count and type split exactly match the schematic before any signal wiring
exists: **22 devices, 11 nfet / 11 pfet**, identical to
`design/sampler_core.spice`'s own `.subckt sampler_dff`. `klt lvs` is not
yet expected to match (`rst_n`/`clk`/`clkb` fan-out and the six data-path
nets `m`/`mb`/`mc`/`s`/`q`/`qb` are still unwired) — see
`layout/sampler_dff/README.md`'s "What remains" for the open routing work,
including why `clk`/`clkb` need a routing-plane strategy distinct from
`vdd`/`vss`'s (their gate pins sit inside each transmission gate's own
row gap, not at a block extremity, so a naive attic/basement bus for them
would cross the `vdd`/`vss` bus already drawn there).

**A previous increment (issue #22): `sampler_dff`'s second and last
missing leaf shape is composed.** [`layout/sampler_nand2/`](sampler_nand2/README.md)
is `design/sampler_core.spice`'s `sampler_dff` subckt's `NANDM`/`NANDS2`
gate — a plain rst_n-gated 2-input NAND2, structurally
[`layout/ro_nand2/`](ro_nand2/README.md) minus its two always-on starve
devices (both PMOS sources tie directly to `vdd`, the series NMOS pair's far
end ties directly to `vss`) — **`klt drc` clean (0 violations)** and **`klt
lvs` match** (4/4 devices, 6/6 nets) against a hand-authored micro-reference
(`design/xschem/sampler_dff.sch` is flat, so there is no independently
netlisted `.subckt sampler_nand2` in `design/*.spice` for `compose-cell.py`'s
LVS to reference directly — same reason `layout/sampler_tg/` needed one).
`mpa`/`mpb`/`mnab` reuse `ro_nand2`'s own `origins_um` unchanged (identical
device shapes and sizes); `nwell_tap`/`psub_tap` were repositioned to abut
`mpa`/`mnab` directly (no starve pair to abut instead) by transforming `klt
gen`'s own standalone local bbox/port reports through each block's
orientation, cross-checked against `ro_nand2`'s own committed evidence
before use — the cell composed DRC/LVS-clean on the first attempt. With this
and [`layout/sampler_tg/`](sampler_tg/README.md) (the transmission gate) plus
[`layout/ro_buf/`](ro_buf/README.md) (the plain inverter, reusable as-is per
`layout/xor2/`'s own `blocks[].cell` precedent), **all three of
`sampler_dff`'s 22 devices now reduce to already-composed leaf shapes.**
Still open (#27): assembling all 22 devices into one `sampler_dff` cell,
placed and routed, and LVS-checked against `design/sampler_core.spice`'s
real `.subckt sampler_dff`; then `sampler_core`'s own six-instance wiring;
then a whole-chain (raw-tap-to-sampled-bit) post-layout PVT campaign. No
`2AMLogic/klayout-tools` friction was found composing this cell.

**A previous increment (issue #22): the whole array is extracted with
parasitics and run through a full PVT post-layout campaign — array-level
period, `wstv` ladder, XOR-tree combining fidelity and supply current, plus
a tied/float/solo inter-ring substrate bracket on a REAL physically-placed
layout for the first time.** [`layout/pex-array/`](pex-array/README.md)
extracts the canonical, `vss`-strapped
[`layout/ro_array_core/ro_array_core.gds`](ro_array_core/README.md) — the
`--check`-reproducible cell recipe the previous increment landed, DRC-clean
and `klt lvs` matching at 132/132 devices, 96/96 nets against
`design/ro_array_core.spice`'s own `.subckt ro_array_core` — flat with `klt
extract --parasitics`, and `sim/post-layout-ro-array-core/` runs three
decks from it across the same four-(temp, Vdd)-point, `tt`/`ss`/`ff` grid
every prior post-layout campaign in this repo uses (36 corner runs).
Headline: array-level parasitics cost **2.158x - 2.501x** in ring period
(against intra-cell-only's 1.378x - 1.479x and one ring's own real
interconnect's 2.08x - 2.45x, since the array additionally carries buffer
and XOR-tree loading neither smaller-scope campaign could include); the
`wstv` ladder still discriminates (span 1.084x - 1.175x); combining-node
bias stays close to 0.5x Vdd post-layout (no new systematic bias); and a
tied/float/solo bracket — now on the array's own real physical placement,
not leaf cells hand-tied to a shared substrate node at assumed infinite
separation — finds a *wider* coupling bound than the prior ring-scale
study, and, for the first time in this repo, one whose sign is consistent
across every grid point (loading -0.353% to -0.192% of ring period,
coupling +0.044% to +0.293%, 12 of 12 positive). See
[`spec/decision-records/DR-0006-*.md`](../spec/decision-records/DR-0006-array-level-post-layout-and-wstv-decorrelation.md)
for the full re-evaluation of DR-0003 §8 and what this does and does not
close, and `sim/README.md`'s "Array-level post-layout" section for every
number, the two-extraction-pass history (the campaign was run once against
the placement PoC's un-strapped GDS before the recipe landed, and again
against the canonical one; both passes are kept), and two documented
incidents (a `.global` net addressed
hierarchically by mistake in the first substrate-float run, and a transient
resource-contention failure on a retry that passed unmodified). **Explicitly
does not attempt**: `sampler_dff`/`sampler_core` (no layout at all yet), or
a supply-distribution layout for `vddr1`-`vddr4` (without which DR-0003 §8's
first-named coupling mechanism has no layout to be measured on at any
scale) — both tracked in #27.

**A previous increment (issue #69): `ro_array_core` is a real
`layout/ro_array_core/` cell recipe — six `gen-compose` stages in one
`cell.json`, `compose-cell.py --check` clean, with `ring1..4`'s and
`xa1..3`'s own `vss` taps drawn.** The whole entropy source (four
differently-sized rings + four buffers + the three-XOR combining tree) keeps
the previous increment's verdict — **`klt drc` clean, 0 violations; `klt
lvs` match, 132/132 devices, 96/96 nets** — but is now rebuilt and
re-verified by the same one command every other cell under `layout/` is,
instead of by nine hand-maintained `gen-compose` request files plus a
directory-local `array-reference.py`. See
[`layout/ro_array_core/`](ro_array_core/README.md). Four things this
increment establishes:

1. **The PoC's nine requests are six stages, not nine.** `signal`…`signal6`
   were never a chain — each re-composed the *same* eleven-block floorplan
   with one more net routed than the increment before it, so only `signal6`
   is load-bearing (it becomes stage `core`). `signal7`/`signal8`/`signal9`
   *are* a chain and become `t2bridge`/`vddstub`/`vddbus`.
2. **`compose-cell.py` gains `blocks[].cell.from_stage`**, the one thing the
   promotion actually needed. `blocks[].from_stage` (which already existed)
   hands a later stage the earlier stage's `gen-compose` *response*, whose
   `ports[]` are that stage's own `pins[]` — right for a leaf/ring cell,
   useless for an array whose every supply stub starts on a tap measured *by
   coordinate inside* an already-composed block and ends on a met1 tip that
   only exists once that stage has drawn it. The subtlety, and why it has its
   own unit coverage: a committed sibling cell's `gds_path` is relative to
   the cell.json (so `--check` must absolutize it), while a *stage's* stream
   is produced by the run in progress (so `--check` must **not**). Swapping
   those is silent — `--check` would compose every later stage over the
   *committed* earlier stages and report "matches" no matter what drifted.
3. **`ring1..4`/`xa1..3`'s `vss` taps are drawn** (stages
   `vssstub`/`vssbus`), closing the last item from the PoC's own
   still-open list that was not a separate deliverable. The four rings need
   no promotion stub at all — each already carries a full-width met2 `vss`
   rail, and on one row those four rails are *collinear*, so three met2 legs
   in the inter-ring gaps merge them into one 166.7 µm² polygon, plus a
   0.425 µm drop onto the four-buffer `vss` met1 bus. The three `xor2`
   instances do need stubs, and their tips are deliberately **not** at one
   `y`: `ro4`'s own met1 backbone at `y = 10.0` runs directly under `xa3` but
   not under `xa1`/`xa2`. Reaching row 2 at all has exactly two doors, since
   the `vdd` bus occupies met2 at `y = 7.5` across `x ∈ [5.765, 212.995]` and
   met2 cannot cross met2. Not LVS-blocking (`net_count` is 96 with and
   without it, for the substrate reason below) and drawn anyway, because a
   fabricated die needs the strap.
4. **All fifteen cells `--check` clean** against `layout/pdk.json`'s
   `klt_version_pin` in the same session — the fourteen previously-composed
   ones plus `ro_array_core` itself.

`layout/ro_array_core-placement-poc/` is **superseded, not corrected**:
every increment in it reproduces, its `signal6` request *is* the promoted
recipe's `core` stage, and it stays as the append-only record of how the
routing was found (the `layout/xor2/` vs. `layout/xor2-placement-poc/`
convention). Array-level parasitic extraction and post-layout PVT — and
therefore DR-0003 §8's `wstv` inter-ring decorrelation question — are what
*this* increment adds on top of that recipe, above. **Still open** (#27):
`sampler_core`/`sampler_dff`, which have no layout at all yet.

**A previous increment (issue #22): `compose-cell.py`'s `lvs.dependencies`
gap — "genuinely cannot express" a same-subckt, differently-parametrized
reference — is closed generically, with unit-test coverage.** The previous
increment's own LVS match for `ro_array_core` (132/132 devices, 96/96 nets)
needed a bespoke, one-off script
([`array-reference.py`](ro_array_core-placement-poc/array-reference.py))
because `compose-cell.py`'s `lvs.dependencies` rewrites each dependency
subckt once with one shared `params` dict, and `ro_array_core` calls the
*same* `ro_ring5` subckt four times with four different `wstv` overrides.
That gap is now `compose-cell.py`'s own `lvs.dependency_variants` mechanism
(see the module's docstring, "A same-subckt, differently-parametrized
reference") — two new functions, `build_variant_reference` (renames a
dependency plus its own nested dependencies, e.g. `ro_ring5` plus
`ro_nand2`/`ro_stage`, per instance) and `repoint_variant_instances`
(rewrites the *top* subckt's own instance-call lines to the renamed variant
and strips the now-meaningless literal parameter overrides) — covered by ten
new cases in `layout/test_compose_cell.py` (a synthetic two-ring
`ro_array_core`-shaped netlist, on this repo's pure-Python, PR-blocking CI
path). `array-reference.py` is rewritten to call the generic mechanism
instead of hand-rolling the rename loop; the regenerated
`ro_array_core.ref.spice` is **byte-identical in body** to the version the
previous increment committed (only the provenance header comment differs),
and re-running `klt lvs` plus both committed negative controls against it
reproduces the identical `match`/`mismatch` verdicts and counts. All
fourteen previously-composed cells still `--check` clean against
`layout/pdk.json`'s `klt_version_pin`, confirming this change is additive.
That increment's own closing note — "`lvs.dependency_variants` is proven
correct against real design data, but no `cell.json` uses it yet; the
promotion still needs the placement/routing side folded into one
`--check`-reproducible multi-stage recipe" — is **resolved by the increment
above**: `layout/ro_array_core/cell.json` is that recipe, and its `lvs`
block is `lvs.dependency_variants`'s first (and so far only) real use.

**A previous increment (issue #22): `ro_array_core` — the whole
entropy source, four differently-sized rings + four buffers + the three-XOR
combining tree — is `klt drc` clean (0 violations) and `klt lvs` **matching**
`design/ro_array_core.spice`'s own `.subckt ro_array_core`: 132/132 devices,
96/96 nets.** The last open net was `vdd`, closed by seven `"metal2"`-role
(met1) promotion stubs (all seven taps measured against the composed array by
a committed scan script before anything was drawn, per the silent-short rule
a prior increment established) plus a six-leg `"metal3"` (met2) chain bus,
merging the seven previously-separate per-instance `vdd` nets into one
38-device net (`net_count` `102` → `96`, `device_count` unchanged at `132`,
net-by-net diff confirming exactly the six intended merges and nothing else).
The LVS reference needed something `layout/bin/compose-cell.py` cannot
express — four differently parameterised copies of the *same* `ro_ring5`
subckt — so it is generated by a small committed script that reuses
`compose-cell.py`'s own rewrite four times over renamed copies (this gap is
closed generically by the increment above); **two
committed negative controls** (resize ring 4's starve devices to ring 1's
`wstv`; cross `xa1`/`xa2`'s inputs) both turn the same comparison into
`mismatch`, so the match is discriminating rather than vacuous. See
[`layout/ro_array_core-placement-poc/`](ro_array_core-placement-poc/README.md)'s
"Increment 8" section. **Its own still-open list, as of that increment**:
`ring1..4`/`xa1..3`'s own `vss` taps (not LVS-blocking, per an earlier
increment's substrate finding, but a real die wants the strap) and promoting
that PoC directory into a `--check`-reproducible `layout/ro_array_core/`
cell recipe — **both closed by the current increment above** — plus
array-level parasitic extraction and post-layout PVT (and therefore
DR-0003 §8's `wstv` inter-ring decorrelation question), and
`sampler_core`/`sampler_dff`, which have no layout at all yet — all three
still open.

**A previous increment: `ro_array_core`'s XOR combining tree's
inputs were fully wired — `t2` really routed over a met2 bridge, and a
prior increment's own prediction that this would need a leaf-cell change
turned out to be wrong —**
[`layout/ro_array_core-placement-poc/`](ro_array_core-placement-poc/README.md)'s
"Increment 7" section. `t2` (`xa2.y` → `xa3.b`) is routed via two short
`"metal2"`-role (met1) promotion stubs added at the array-composition level
(`xa2.y`→`y_m1`, `1.4 µm`; `xa3.b`→`b_m1`, `0.9 µm`), bridged by a
`"metal3"`-role (met2) route at `y = 31.0`, clear of every row-2 block's own
bbox and of `t1`'s own met1 backbone (a different physical layer). **`klt
drc` clean (0 violations) at every step**; net-by-net diffs confirm each
stub only extends its own existing net (no merge), and the final met2
bridge merges exactly `xa2`'s 4-device `y` net with `xa3`'s 4-device `b`
net into one 8-device net — `132` devices unchanged throughout, `103` nets
(unchanged after the stubs) → `102` nets (after the bridge). The prior
increment (Increment 6) predicted the met1 promotion would need to happen
inside `xor2`'s own leaf cell, since met3's via-drop is single-hop-only and
cannot reach a bare li1 pin — **this increment shows that's unnecessary**:
`klt gen-compose`'s `blocks[].cell` mechanism lets an already-composed
block gain extra hand-declared ports at any layer, at any point an earlier
increment's own routing already proved clear, so the promotion can happen
one level up instead. `vdd` (still seven separate nets) is the one
remaining open net and is expected to need the same recipe. **Still not a
DRC/LVS-clean `ro_array_core`**: `vdd`, `ring1..4`'s and `xa1..3`'s own
`vss` taps (not LVS-blocking, per Increment 5's substrate finding), and
therefore any LVS attempt, are all still open.

**A previous increment: `ro_array_core`'s four buffers got a really-routed
`vss` bus, and extraction showed `vss` was already one electrically merged
net across the whole composed array before that bus existed —**
[`layout/ro_array_core-placement-poc/`](ro_array_core-placement-poc/README.md)'s
"Increment 5" section. `buf1`-`buf4`'s own `vss` taps are now routed
together as one 4-pin bundle net (no hand-tuned waypoints needed — `klt
gen-compose`'s spanning-tree router found all three row-adjacent legs on the
first attempt). Still **`klt drc` clean (0 violations)**, and `klt extract`
reports the same `132` devices and `104` nets as before this increment —
**`net_count` did not move**, because the merged `vss` net
(`device_count: 122`) is byte-identical before and after: `klt extract`'s
sky130 deck already ties every un-isolated NMOS body (this design draws no
deep-nwell isolation) to one global substrate identity via
`connect_global`, so `ro_array_core`'s `vss` connectivity does not wait on
this directory's own inter-block routing to reach a `klt lvs` match — the
same mechanism `spec/decision-records/DR-0005-*.md` finding 3 already
documented on a single ring's own parasitics, now confirmed at the
array-composition level. The bus drawn in that increment is still real,
DRC-clean, load-bearing metal (an actual die needs the explicit strap; the
substrate's own resistance is unmodelled per DR-0005), just not what was
blocking LVS. **`vdd` is not the same shape and stays genuinely open**: it
still reports as seven separate nets (one per `buf`/`xor2` instance,
unchanged by that increment), and a first buffer-only `vdd` bus attempt
failed outright (`unrouted_nets: ["vdd"]` — every candidate leg crosses
`ring2`'s or `ring3`'s own bbox; `vdd`'s tap sits close enough to each
buffer's own bbox top that the router's automatic detour lanes cannot clear
the neighbouring rings) — the corridor-height retry that increment
recommended is **superseded by Increment 6**, which measures that no met1
corridor can work at all. Its own still-open list, as of that increment:
`vdd`, `ring1..4`'s and `xa1..3`'s own
`vss` taps (not yet drawn, though no longer LVS-blocking per the finding
above), the XOR combining tree (`t1`, `t2`, `xo`), and therefore any LVS
attempt. The PoC's README also carries an open question
on `compose-cell.py`'s `lvs.dependencies` mechanism, unchanged by this
increment: the reference netlist defines one `ro_ring5` subckt called four
times with four different `wstv=` overrides, not four separate subckts, and
the current dependency mechanism has not been exercised against that shape.

**A previous increment: `ro_array_core`'s buffer→XOR `b` leg was routed for
both first-stage XORs** —
[`layout/ro_array_core-placement-poc/`](ro_array_core-placement-poc/README.md)'s
"Increment 4" section. `ro2` (`buf2.y`) was routed into `xa1`'s `b` input,
and `ro4` (`buf4.y`) into `xa2`'s `b` input, on `"metal2"`, resolving the
previous increment's own open finding. `klt drc` clean (0 violations), and
`klt extract` reported `132` devices (unchanged) and `104` nets (down from
`106`, exactly the two new merges, each confirmed by a net-by-net diff to
join only its intended `b`-labelled net). Two findings: `gen-compose`
rejects a backbone that crosses through a *third*, unrelated block's own
bounding box even well above the row being routed through (discovered when
a first attempt tried routing above `xa1`/`xa2`'s own row height to dodge
congestion, and was rejected for crossing `xa2`'s/`xa3`'s own bbox); and the
corridor between row 1 and row 2 had room for exactly one more pair of
dedicated channels once reasoned about via the two existing backbones' own
vertical-segment extents (`y=8.5`/`10.0`, distinct from `a`'s `y=8.0`/`9.0`)
— see the PoC's own README "Increment 4" section for both findings in full.

**A previous increment: `ro_array_core`'s buffer→XOR `a` leg was routed for
both first-stage XORs** —
[`layout/ro_array_core-placement-poc/`](ro_array_core-placement-poc/README.md)'s
"Increment 3" section. `ro1` (`buf1.y`) was routed into `xa1`'s `a` input,
and `ro3` (`buf3.y`) into `xa2`'s `a` input, on `"metal2"` — the first
routing this directory drew between row 1 (rings/buffers) and row 2 (the XOR
combining tree), needing an escape-margin fix for the source pin's own tiny
edge margin. `b` was deliberately left unwired that increment (resolved
above).

**A previous increment: `ro_array_core`'s forward
ring→buffer signal chain was routed** —
[`layout/ro_array_core-placement-poc/`](ro_array_core-placement-poc/README.md)'s
"Increment 2" section. On top of the same eleven-block floorplan the
previous increment placed, `en1..en4` and the four `vddrN` domains were
exposed as top-level pins directly off each ring's own already-formed
internal node (no routing needed — each is already one electrical node
inside its own ring), `ro1..ro4` were exposed the same way off each buffer's
`y` output, and the four `rn1..rn4` legs (`ro_ring5.ro` → `ro_buf.a`) were
newly, really routed on `"metal2"` — the first inter-cell wiring this
hierarchy level drew. One floorplan finding: `gen-compose` rejects a route
whose final leg drops straight into a block's interior toward a pin that
sits well inside that block's own bbox, with a precise measured diagnostic —
see the PoC's own README for the fix (approach horizontally at the pin's own
`y` instead).

**A previous increment: `xor2` is composed, DRC-clean and
LVS-clean, so every leaf cell `ro_array_core` instantiates now exists as a
verified physical cell.** [`layout/xor2/`](xor2/README.md) is
`design/ro_array_core.spice`'s own `.subckt xor2` — twelve devices, ten nets
— **`klt drc` clean (0 violations)** and **`klt lvs` match (12/12 devices,
10/10 nets, 0 errors)**, in two `gen-compose` stages across two routing
planes. It supersedes `layout/xor2-placement-poc/`, whose prediction that
this cell would need "full channel-router-style joint net ordering" and
plausibly a third routing plane was **wrong**: three structural moves —
reading the pull-up tree as two `finger_topology: "series"` chains sharing a
*contactable interior* `U0_D0` (`mid`), placing the two inverters as
already-composed `ro_buf` `blocks[].cell` blocks, and splitting the nets
across *layers* (`vdd`/`mid`/`y`/`vss` on li1, `a`/`an`/`b`/`bn` on met1)
rather than across lanes on one layer — reduce the problem from 17 blocks
and 31 nets to 9 blocks and 12 net legs. All fourteen composed cells
(`ro_buf`, `ro_stage` x4, `ro_nand2` x4, `ro_ring5` x4, `xor2`) `--check`
clean against `layout/pdk.json`'s `klt_version_pin` in the same session.
**Still open:** `ro_array_core` itself (the four rings + `ro_buf` fan-out +
the three-`xor2` combining tree) and `sampler_core`, so this is still not a
DRC/LVS-clean *block*; the array-level (inter-ring) parasitics — supply
distribution, the XOR tree's own routing, buffer fan-in — remain undrawn,
and DR-0003 §8's decorrelation gap is unchanged by this increment (still
bounded but not closed, for the reasons
`spec/decision-records/DR-0005-*.md` already states). `xor2` has no `sim/`
record and no `layout/pex/` entry: a post-layout campaign is its own
deliverable with its own PVT-corner discipline.

**A previous increment: the four composed `ro_ring5` rings
have their own ring-level post-layout PVT evidence** —
[`layout/pex-ring/`](pex-ring/README.md) extracts each ring's *whole*
composed GDS directly (real inter-gate `n1`-`n4`/`ro` routing and `vddr`/`vss`
rail busing included, not the ideal inter-cell wires the earlier leaf-cell
`layout/pex/` composition assumes), and
[`sim/post-layout-ro-ring5-assembled/`](../sim/post-layout-ro-ring5-assembled/)
runs the same period/swing/current measurement from it across the full PVT
grid. Headline: real inter-gate wiring costs the ring roughly another
50-65% multiplicatively beyond intra-cell parasitics alone, and the `wstv`
ladder still survives (see `sim/README.md`'s "Assembled-ring post-layout"
section for the full reduction). `ro_array_core` (the four rings + `ro_buf`
fan-out + the `xor2` combining tree) and `sampler_core` are still open, so
this is still not a DRC/LVS-clean *block*, and the array-level (inter-ring)
parasitics — supply distribution, the XOR tree's own routing, buffer fan-in
— remain undrawn; DR-0003 §8's decorrelation gap is bounded but not closed
for the reasons `spec/decision-records/DR-0005-*.md` already states.

[`layout/ro_ring5/`](ro_ring5/README.md) and its three `wstv` siblings
([`_wstv0p44`](ro_ring5_wstv0p44/README.md),
[`_wstv0p46`](ro_ring5_wstv0p46/README.md),
[`_wstv0p48`](ro_ring5_wstv0p48/README.md)) are
`design/ro_array_core.spice`'s own `.subckt ro_ring5` — five leaf gates
placed via `blocks[].cell`, the four forward nets, the `ro` feedback and
both `vddr`/`vss` rails all routed — each **`klt drc` clean (0 violations)**
and **`klt lvs` match (22/22 devices, 19/19 nets, 0 errors)** against the
schematic's own subckt at that ring's `wstv`. Four `gen-compose` stages
across three physical routing planes (li1-pinned placement, `n1`-`n4` and
`ro` on met1, rails on met2); see `layout/ro_ring5/README.md` for why each
plane is needed and the measured evidence behind each coordinate.

This increment also **corrects two wrong claims** in the previous one's
`ro_ring5-connectivity-poc`: its `n1`-`n4` were not merely marginal, they
were a single shorted node (its own committed `extract.json`'s
`merged_net_labels`/`warnings` said so and were read for counts only), and
its "5 unexplained device-internal `li1.space.1` violations" were the same
routes, not a hierarchy-dependent DRC effect — the corrected placement with
no routing at all is DRC-clean. See that directory's own README, which now
opens with the correction.

**Earlier increments (leaf cells, still the foundation):** both starved
leaf-gate ladders are composed at all four ring widths — nine composed cells
(three distinct gate types: `ro_buf`, plus `ro_stage` and `ro_nand2` at each
of the four `wstv` values), every one DRC-clean and LVS-clean.
[`layout/ro_buf/`](ro_buf/README.md) is `design/ro_array_core.spice`'s own
`.subckt ro_buf` inverter, built from `klt gen` primitives, placed and routed
by `klt gen-compose`, **`klt drc` clean (0 violations)** and **`klt lvs`
matching the design netlist (2/2 devices, 4/4 nets, 0 mismatches)**. That
closed step 1 of the deferred list below and, with it, the last open question
about whether this methodology reaches a working cell at all.
[`layout/ro_stage/`](ro_stage/README.md) is the array's own per-stage starved
delay cell — four devices whose starve pair cross-couples to the *opposite*
rail, which needed a genuinely new capability (`compose-cell.py`'s two-pass
`"stages"` composition, routing the two crossing nets on a second metal level)
to compose at all — also **`klt drc` clean (0 violations)** and **`klt lvs`
match (4/4 devices, 6/6 nets)**. That closes the harder half of step 2 below.
[`layout/ro_nand2/`](ro_nand2/README.md) is each `ro_ring5`'s enable-gated
first stage — six devices (the same cross-coupled starve pair as `ro_stage`,
plus a parallel PMOS pull-up pair and a series NMOS pull-down pair, both new
floorplan shapes) — also **`klt drc` clean (0 violations)** and **`klt lvs`
match (6/6 devices, 8/8 nets)**, reusing `ro_stage`'s two-pass `"stages"`
technique but extended from 2 to 6 same-block self-nets resolved in one final
`gen-compose` call (see `layout/ro_nand2/README.md` for the parallel/series
floorplan problems this needed and the six empirically-derived routing lanes).

**A previous increment**: `ro_stage`/`ro_nand2` are each cloned three more times —
[`ro_stage_wstv0p44`](ro_stage_wstv0p44/README.md),
[`ro_stage_wstv0p46`](ro_stage_wstv0p46/README.md),
[`ro_stage_wstv0p48`](ro_stage_wstv0p48/README.md) and
[`ro_nand2_wstv0p44`](ro_nand2_wstv0p44/README.md),
[`ro_nand2_wstv0p46`](ro_nand2_wstv0p46/README.md),
[`ro_nand2_wstv0p48`](ro_nand2_wstv0p48/README.md) — one physical cell per
ring (`design/ro_array_core.spice`'s `xr1`-`xr4`, `wstv` 0.42/0.44/0.46/0.48
µm), matching the schematic's own non-identical-ring intent. All six new
cells are **`klt drc` clean (0 violations)** and **`klt lvs` match**, closing
issue #27 step 2's "repeat for... the 4-way `wstv` variants" in full. See
"Starve-width variants" below for what does (and does not) change per width,
and why the naive clone-and-reparametrize approach fails without it.

**A previous increment (issue #22, follow-up), now superseded**:
[`layout/xor2-placement-poc/`](xor2-placement-poc/README.md) placed all
twelve of `xor2`'s real devices individually (every PMOS with its own well
tap), **`klt drc` clean (0 violations)** and **`klt extract` confirming 12
devices, 6 nfet + 6 pfet** — but left routing open and concluded it was a
channel-routing problem needing a third routing plane. `layout/xor2/`
above shows it is not, and shares none of that PoC's coordinates; its
README now opens with the correction. Two findings from it *are* still
load-bearing and are used by `layout/xor2/`: `"metal3"`'s single-hop
via-drop rule (see "Floorplan decisions made so far" below), and the rule
that two wired segments sharing an endpoint pin must be chained under **one**
shared net name rather than two.

**A previous increment (issue #22, post-layout)**: the nine composed cells are now
**simulated**. [`layout/pex/`](pex/README.md) is a generated, `--check`-guarded
post-layout netlist library — `klt extract --parasitics` over each cell's
committed GDS, rewritten for ngspice by `layout/bin/pex-netlist.py` — and
`sim/post-layout-ro-ring5/` runs the five-stage ring from it over the PVT
grid (twelve records, thirty-six corner runs), with the pre-layout netlist
as a same-deck control. That closes step 5 below for the leaf-cell scope
that exists, and turns step 6 (DR-0003 §8's `wstv` decorrelation gap) from
"unmeasurable" into "bounded, and still open for the mechanism that
matters" — see `spec/decision-records/DR-0005-*.md`. All nine cells were
re-verified DRC-clean and LVS-clean (`compose-cell.py --check`, `klt 0.4.0`)
in the same session, so the GDS carrying these parasitics is the GDS
carrying those verdicts.

**Previous increment (issue #22, hierarchical assembly, first attempt —
superseded, see the correction above)**:
[`layout/ro_ring5-connectivity-poc/`](ro_ring5-connectivity-poc/README.md)
places all five of `ro_ring5`'s leaf gates (`ro_nand2` + 4x `ro_stage`) via
`klt gen-compose`'s `blocks[].cell` request shape — the first proof that an
*already-composed* cell (not a fresh `klt gen` primitive) can be placed and
inter-wired this way — the one finding of that attempt that survives. It
also *reported* the four forward inter-gate signal nets (`n1`-`n4`) as
routed, which **they were not**: they are one shorted node in its committed
`core.gds`, as its own `extract.json` says (see the correction at the top of
this file and that directory's own README). **Not DRC-clean and not
LVS-attempted**: the placement pitch borrowed
unchanged from the original (uncommitted, recovered-and-superseded) attempt
is `0.27 µm` short of `nwell.space.1`'s clearance at the `ro_nand2`/`ro_stage`
boundary (correctly diagnosed), plus seven
`li1.space.1` violations it recorded as "2 attributed + 5 unexplained
device-internal" and which are in fact all seven the same routes, and the
ring's `vddr`/`vss`/`ro` rail busing hit a genuine `klt` via-drop limitation
(`routing.cross_block_layer_role` cannot rescue a bare base-layer pin —
single-hop-only, same limitation `"metal3"`'s own note below already
describes from a different angle) that stopped this attempt before DRC/LVS
were reachable. `layout/bin/compose-cell.py` gained `blocks[].cell` support
and multi-subckt LVS references (`lvs.dependencies`) to get this far, both
regression-tested against all nine previously-committed cells. Its
recommended next recipe — a three-stage li1→metal2→metal3 rail promotion —
turned out to be **unnecessary**: both rails are already drawn on met1
inside every leaf gate, so declaring the block's rail port on met1 satisfies
the single-hop rule directly (see `layout/ro_ring5/README.md`).

Still open after all of the above: `sampler_core`/`sampler_dff`, and
therefore any *whole-block* post-layout claim — `ro_array_core` itself is
now built (see the current increment at the top of this file). See "What's
deferred" below and the tracking issue (#27).

The earlier increments remain the foundation: `layout/primitives/` is
per-device evidence (every distinct transistor geometry `design/xschem/`
instantiates, drawn and independently DRC-clean/extracted), and
`layout/well-strap-poc/` established that a `guard_ring`'s nwell merges with a
`mos_array` PMOS's own. `ro_buf` changes *how* that merge is arranged —
abutted rather than nested, see below — because a nested device turns out to
be unroutable.

The `klt` regression the previous increment filed
([2AMLogic/klayout-tools#1491](https://github.com/2AMLogic/klayout-tools/issues/1491),
sub-0.28 µm gate length + `gate_contact` DRC-violating) is **fixed** as of
`klt 0.3.0+gc6dbf66c53c6`: regenerating `pfet_w0p84_l0p15`'s exact params from
scratch is DRC-clean again, and `ro_buf` is built entirely at this design's
real `l_um=0.15`.

## Correcting the curation note

Issue #22's curator enhancement (2026-09-05) flagged an open question: `klt`'s
installed command surface, as that curation pass observed it (`layers`,
`stats`, `drc`, `lvs`, `extract`, `synthesize`, `techmap`, `render`, etc.),
looked "verification/synthesis-oriented," with "no obvious path to compose
full-custom analog polygon layout by hand." That reading does not match
`klt`'s actual command surface — though **which build is installed has proven
unstable across sessions**, which is itself worth recording: the previous
increment saw `uv tool list` report `klayout-tools v0.2.0` (and a transient
`0.3.0+g<hash>.dirty` earlier in the same session), while this one sees
`v0.3.0` / `klt 0.3.0+gc6dbf66c53c6`, with a regression fixed in between and
a `well_island` generator that had come and gone now present again. The
version string in a given moment is not reliable evidence of what a fresh
clone of this repo will get; `uv tool list` plus each artifact's own
`provenance.klt_version` are the record.

**The churn is not only between sessions — it happens mid-session, and it
can be a downgrade past the features this directory depends on.** While
building `layout/ro_ring5/`, the ambient `uv`-managed `klt` changed from
`0.3.0+gc6dbf66c53c6` to **`0.2.0`** *between two commands*, with the
replacement installed from a pinned upstream commit ~324 commits behind the
one it replaced. `0.2.0` has no `blocks[].cell` request shape at all, so
every cell here that places an already-composed sibling fails outright with
a misleading `blocks[].generator_report must be a JSON object or a path to
one`. If you hit that error, check `klt --version` before debugging the
request. The fix is to build the pinned version into a venv of your own
rather than fighting over the shared tool install:

```bash
python3 -m venv /tmp/klt-venv
/tmp/klt-venv/bin/pip install \
  "git+https://github.com/2AMLogic/klayout-tools@c6dbf66c53c6e9a73c4f5ae5e41a98e8fe414252"
/tmp/klt-venv/bin/klt --version          # klt 0.3.0+gc6dbf66c53c6
PATH=/tmp/klt-venv/bin:$PATH python3 layout/bin/compose-cell.py layout/ro_ring5/cell.json --check
```

That commit is `layout/pdk.json`'s own `klt_version_pin`, and all fourteen
composed cells `--check` clean against it. Not filed upstream as a tool
gap: klayout-tools is behaving correctly at every version; this is an
environment-management problem on the consuming side, and the pin plus the
per-artifact `provenance.klt_version` already record it.

The composition-side verbs:

- **`klt gen`** — runs a named parametrized layout generator (a headless
  KLayout PCell) against a JSON params object, producing a GDS/OASIS +
  structured report. The relevant family for this design is the analog
  primitive generators: `mos_array` (matched MOS transistor arrays —
  `layout/primitives/` below is built entirely from this one), `guard_ring`,
  `diff_pair`, `esd_device`, `res_array`, `cap_array`, `bond_pad`,
  `bjt_array`. (A `well_island` generator — absent from the `v0.2.0` release
  the previous increment saw — is present again in `v0.3.0`. Neither
  `layout/well-strap-poc/` nor `layout/ro_buf/` uses it: `guard_ring` is
  present in every observed build and is sufficient for both, so the cells
  stay buildable across this churn.)
- **`klt gen-compose`** — places a set of already-generated `klt gen` blocks
  (and/or existing library cells) into one composed GDS per a
  blocks[]/placement/connectivity[]/routing request document, with real
  Manhattan metal routing (`pya.Path`-native, not a schematic annotation).
  Its own module docstring names "a CMOS inverter's nfet/pfet pair" as the
  motivating case for its per-block `orientation` field — i.e. this is not a
  generic verification tool pressed into a role it was not designed for; gate
  composition from matched-device primitives is exactly what it is for.
- **`klt draw`** — writes arbitrary polygons/labels verbatim from a JSON
  shape description, for the (rare, for this design) case a generator can't
  cover.

So the honest finding is **not** "no composition path exists" — a
tool-gap issue against `2AMLogic/klayout-tools` claiming that would be
inaccurate, and was not filed. The honest finding is: composing this
design's specific gates (with sky130's implicit-bulk `mos_array` output —
see "The well-strap gap" below) and then this design's specific hierarchy
(4 non-identical ring instances, an XOR combining tree, 6 TG-DFF samplers)
is real, multi-day layout engineering, most of which remains to do. That is
the actual scope gap the tracking issue below is for.

## Cell hierarchy → generator mapping

From `design/README.md`'s "Cell hierarchy":

```
trng_top                   (not in scope for #22 — stops at the raw tap)
  sampler_core              PLANNED — 6x sampler_dff + wiring
    ro_array_core           BUILT — DRC-clean + LVS-clean (layout/ro_array_core/) — six-stage cell.json recipe, --check reproducible: 11 blocks placed, every inter-cell signal net routed, vdd bus + array-wide vss strap drawn, 132/132 devices and 96/96 nets vs. design/ro_array_core.spice; array-level parasitics extracted from that same GDS and post-layout PVT run over it (layout/pex-array/, sim/post-layout-ro-array-core/) including a tied/float/solo inter-ring substrate bracket; still open: a vddr1-4 supply-distribution layout (#27)
      ro_ring5   (x4)        BUILT, all 4 wstv values — DRC-clean + LVS-clean (layout/ro_ring5/, ro_ring5_wstv0p{44,46,48}/) — 4 distinct physical cells, one per ring; signal chain, ro feedback and vddr/vss rails all routed
        ro_nand2   (x1/ring)  BUILT, all 4 wstv values — DRC-clean + LVS-clean (layout/ro_nand2/, ro_nand2_wstv0p{44,46,48}/) — 4 distinct physical cells, one per ring
        ro_stage   (x4/ring)  BUILT, all 4 wstv values — DRC-clean + LVS-clean (layout/ro_stage/, ro_stage_wstv0p{44,46,48}/) — 4 distinct physical cells (one per ring's wstv), each reused 4x within its own ring
      ro_buf     (x4)        BUILT — DRC-clean + LVS-clean (layout/ro_buf/)
      xor2       (x3)        BUILT — DRC-clean + LVS-clean (layout/xor2/) — 4x mos_array (two series chains per tree) + 3x guard_ring + 2x ro_buf cell; one physical cell reused 3x (xa1/xa2/xa3 are identical instances)
    sampler_dff  (x6)        ASSEMBLY STARTED — layout/sampler_dff/ places all nine leaf-cell instances (3x ro_buf, 4x sampler_tg, 2x sampler_nand2) via blocks[].cell, DRC-clean (0 violations), plus a routed vdd/vss bus, routed rst_n/clk/clkb fan-outs and four of the six data-path nets: mc (met2 U-lane), q (met1 L-lane), qb (met1, jogged climb out of sampler_nand2's own met1 blob) and s (the first three-pin one: three met1 via-drops plus a straight met2 lane at the middle pin's own y). All DRC-clean, 0 violations, 0 unrouted nets; klt extract confirms each is one physically merged net whose device list matches design/sampler_core.spice's own — with the single exception qb's check found, the sampler_nand2 input-pin swap tracked as #84. klt extract also confirms 22/22 devices at the correct 11 nfet/11 pfet split against design/sampler_core.spice's own .subckt sampler_dff. Whole-cell external pin promotion is now done: the d input pin (its only connection, never routed/fanned-out, so never previously labelled) got a gen-compose pins[] label-only promotion, DRC-clean, klt extract confirms the node now reads a|d|tg_d_a; the other five ports (clk/rst_n/q/vdd/vss) already carried correct labels from their own routing increments. Still open: two data-path nets (m/mb, both downstream of #84), #84 itself, and the resulting whole-cell klt lvs sign-off (#27) — pin promotion does not by itself move the klt lvs verdict (verified: unchanged at 12/22 devices, 5/14 nets both before and after)
```

"PROVEN AT DEVICE LEVEL" means: every transistor geometry the cell needs is
individually DRC-clean and extracts correctly (`layout/primitives/`) — the
cell itself (multiple devices, placed, routed, DRC/LVS-clean as a unit) does
not exist yet.

## Floorplan decisions made so far

- **Guard/tap-ring strategy**: per-gate, not per-block. Each leaf gate
  (`ro_stage`, `ro_nand2`, `ro_buf`, `xor2`) gets its own pair of tap islands
  (a `guard_ring --params '{"add_well":true}'` tied to `vdd`/`vddr` for the
  PMOS row, and a `guard_ring --params '{"add_well":false}'` tied to `vss` for
  the NMOS row), **abutted** to the device blocks rather than nested around
  them — see `layout/ro_buf/README.md` § "Why abutted, not nested". One ring
  around a whole assembled `ro_ring5`/`ro_array_core` was rejected, matching
  how the schematic already treats each ring's supply as independent
  (`design/README.md`'s pin table: `vddr1`..`vddr4` are separate,
  specifically so per-ring liveness/independence is observable). A
  per-array-wide ring would blur that independence at the layout level.
- **Routing layer**: `routing.layer_role: "metal"` (li1, sky130's local
  interconnect) for every intra-gate net — the same layer every
  `mos_array`/`guard_ring` port already lands on with `gate_contact: true`,
  so no via-drop is needed inside one gate. Inter-gate/inter-ring routing
  (once `ro_ring5`/`ro_array_core` assembly starts) will likely need a
  second metal to cross the per-gate guard rings without shorting into
  them. **Resolved, correcting the "TBD" note this bullet previously
  carried**: `klt` 0.4.0 resolves `routing.layer_role: "metal2"` (met1, via
  `via1`) *and* `"metal3"` (met2, via `via2`) against
  `klayout_tools.gen._PDK_ROLE_LAYERS["sky130"]` — confirmed by reading the
  installed package directly (`layout/xor2-placement-poc/README.md` has the
  full citation), since neither role appears in this checkout's own
  `docs/cli/gen-compose.md`. The catch: `"metal3"`'s via-drop is
  single-hop-only, so it can only bridge two pins *already* wired onto
  `"metal2"` by an earlier stage — it cannot reach a bare `li1` pin
  directly the way `"metal2"` can. `ro_stage`/`ro_nand2` only ever needed
  `"metal2"`; `xor2-placement-poc`'s own routing attempt predicted that
  `xor2` would be the first case in this repo where a `"metal3"` stage is
  necessary — **falsified by `layout/xor2/`**, which routes the whole gate
  on li1 + `"metal2"` and leaves met2 empty (see that cell's README, and
  points 9-10 in "Composing a gate" above). `"metal3"` remains used by
  exactly one cell family, `ro_ring5`'s rail busing. **`layout/ro_ring5/` is the
  first cell that actually uses all three planes**, and it shows the
  single-hop rule is cheaper to satisfy than it looks: rather than adding a
  promotion stage, declare the block port on the layer the pin is *already*
  drawn on. Both rails are on met1 inside every leaf gate, so `"metal3"` is
  one hop away from them; only the li1-pinned signal nets need `"metal2"`.
- **`wstv` per-ring variation**: the four rings are NOT identical layout
  cells — `design/ro_array_core.spice`'s `xr1`-`xr4` instantiate `ro_ring5`
  at four different `wstv` values (0.42/0.44/0.46/0.48 µm). The layout is
  four distinct physical `ro_stage`/`ro_nand2` starve-device variants (same
  generator call, `w_um` substituted, plus the origin re-derivation below),
  not one physical cell reused four times — matching the schematic's own
  non-identical-instance intent (DR-0003 §8's decorrelation strategy depends
  on the rings actually differing). **Done, both cell types, all four
  widths** — see "Starve-width variants" below.

## Composing a gate: the working recipe

`layout/bin/compose-cell.py` drives the whole chain for one cell from a
committed descriptor (`layout/<cell>/cell.json`):

```
klt gen (per device/tap block) -> klt gen-compose -> klt drc -> klt extract -> klt lvs
```

```bash
python3 layout/bin/compose-cell.py layout/ro_buf/cell.json           # rebuild in place
python3 layout/bin/compose-cell.py layout/ro_buf/cell.json --check   # verify without overwriting
```

Every step's JSON response is written next to the descriptor, so
`layout/<cell>/` is the full re-checkable evidence trail, and `--check` is the
layout sibling of `design/netlist.py --check` (rebuild into a temp dir, diff
the verdict-bearing fields against what is committed). All `klt` invocations
run from the cell directory with relative paths, so no absolute home path
leaks into the committed provenance.

**`--check` is now an automated regression guard, not just a manual
command** (issue #36): `.github/workflows/pdk-nightly.yml`'s `layout-check`
job runs `compose-cell.py --check` over every committed `layout/*/cell.json`
(nineteen as of 2026-09-17 — re-globbed at run time, not hardcoded, so it
keeps up automatically as more cells land per issue #27), on the same
trigger surface as the `netlist-check` job it sits beside in that file:
`schedule`, `workflow_dispatch`, and opt-in on a PR via the `run-pdk-check`
label, so it never adds the PDK/`klt` download cost to every PR by default.
This is the automated version of what
[klayout-tools#1491](https://github.com/2AMLogic/klayout-tools/issues/1491)
proved could otherwise silently invalidate already-committed evidence between
sessions.

That job installs `klt` from PyPI, pinned to the latest *tagged* release
(`klayout-tools==0.5.0`, released 2026-09-15) rather than to
`layout/pdk.json`'s committed `klt_version_pin` (a dev snapshot with no PyPI
artifact of its own) — see `layout/pdk.json`'s `ci_klt_install` comment for
the full rationale, including why the mid-session churn documented above in
"Correcting the curation note" does not apply to CI's one-shot,
explicitly-versioned install. The pin is **0.5.0, not 0.4.0**: 0.4.0 predates
`connectivity[].legs[]` (klayout-tools #1529/#1536), so
`layout/sampler_dff/cell.json` fails against it with `error: clkb_seg2: nets
left unrouted by gen-compose: ['clkb_mid']` — the `layout/sampler_dff`
exception `layout/pdk.json` already documents (issue #106), not drift, and
enough on its own to keep this job permanently red. Verified 2026-09-17 in a
clean venv against the `open_pdks` commit `layout/pdk.json` pins: `klt 0.5.0`
from PyPI reproduces all nineteen currently-committed `layout/*/cell.json`
cells' evidence exactly — `sampler_dff` included, and including `ro_ring5`'s
`blocks[].cell` hierarchical composition, the exact request shape `v0.2.0`
lacks.

This nightly pin is **deliberately diverged** from `ci.yml`'s
`signoff-check` grader pin since 2026-09-23 (issue #160): the grader
moved to `klayout-tools==0.6.0` alone — it is a pure JSON transform with
no PDK — while this pin stays at 0.5.0, because it gates the nineteen
committed cells' `compose-cell --check` reproductions and 0.6.0 changed
`gen-compose`'s via-drop/tap-role handling (klayout-tools #2312).
Bumping this pin requires re-running every committed cell's `--check`
against 0.6.0 and recording the result first; until then the two pins
are intentionally not identical.

**Superseded by issue #181 (2026-10-07).** The nightly now installs
klayout-tools source commit `5edb557f91d0` from git, the same build that
regenerated all nineteen cells. See "Regeneration on the cut-size/grid fix
(issue #181)" at the end of this file. All nineteen cells were `--check`ed
against it, and none drifted. The 0.5.0 pin could not stay: `--check` diffs
verdict fields only, and on 2026-10-07 0.5.0 rebuilt the old off-grid,
0.22 um-cut geometry and graded it clean on its own older deck. That would
have been a silent pass, not drift. The grader pin is unchanged
(`klayout-tools==0.6.0`), and the two pins still differ on purpose.

The three constraints that decide a cell's floorplan, all learned building
`ro_buf` (see [`layout/ro_buf/README.md`](ro_buf/README.md) for each one's
evidence):

1. **Body ties abut, they do not enclose.** Overlap the device block's and
   the tap ring's `bbox_um` by 0.10 µm: their nwells merge (one electrical
   node, so the PMOS bulk extracts to the ring's labelled net) while their
   `li1` stays 0.20 µm apart, clear of sky130's 0.17 µm spacing floor. A
   *nested* device — `layout/well-strap-poc/`'s original geometry — is
   body-tied but **unroutable**: `gen-compose` treats the enclosing ring as an
   unrelated block and rejects every route reaching the device inside it
   (upstream: [klayout-tools#1493](https://github.com/2AMLogic/klayout-tools/issues/1493)).
   The same 0.10 µm overlap technique also merges two *devices'* nwells
   directly with each other (`layout/ro_stage/`'s `Mph`/`Mp`), not just a
   device with a dedicated tap — one fewer tap island, provided the two
   devices' S/D ports at the merge boundary are placed at the **same `y`**
   (see `layout/ro_stage/README.md`'s floorplan section for why an
   unaligned jog through the overlap zone fails the edge-margin check, and
   why an *unmerged* pair of same-net wells fails `nwell.space.1` instead —
   there is no cheaper middle ground between merging and clearing the full
   isolation spacing).
2. **Mirror the PMOS row in `y`** (`blocks[].orientation: "mirror_y"`) so its
   gate faces the NMOS row's up-facing gate. Two same-facing gate ports make
   the router lift the connecting jog above both blocks, straight through the
   PMOS.
3. **Give a same-facing S/D pair an explicit `waypoints_um` lane** clear of
   both blocks' bboxes. The default one-stub-width jog runs back through the
   devices.
4. **A gate whose two nets would cross on one layer composes in two
   `gen-compose` passes, not one.** `layout/ro_stage/`'s starve devices'
   gates each tie to the *opposite* rail, a topology no single-layer
   placement makes planar. `compose-cell.py`'s `"stages"` cell.json field
   (see its own module docstring, and `layout/ro_stage/README.md`) composes
   the gate once on the base `"metal"` role leaving the two crossing nets
   unwired, then again — treating the first pass's own composed cell as one
   block — routing just those two nets on `"metal2"` with automatic
   via-drop. The two metal2 nets still have to avoid crossing *each other*
   (the same `waypoints_um`-into-separate-lanes technique as point 3 above,
   since both nets' sources happen to land at the same `x` before
   placement).
5. **A many-pin same-net bundle in a row of matched devices is a
   two-pass problem too, once more than one device shares a net.**
   `layout/ro_nand2/`'s parallel PMOS pair (both `Mpa`/`Mpb` have `D=y,
   S=py`) and series NMOS pair make `py`/`y` **three-pin** nets whose third
   pin re-crosses another device's own pad no matter which two pins wire
   first — the same class of problem as point 4, just from more than two
   devices sharing a net rather than one device's gate crossing a rail. The
   same fix generalizes: promote *every* pin of the affected net as a bare
   `pins[]` port in the base stage (wiring none of it there), then resolve
   all of it in a final stage against the whole first stage's own composed
   cell — see `layout/ro_nand2/README.md` for the six-same-block-self-net
   worked example (`py`/`y`'s bundle, plus `ro_stage`'s usual `vss`/`vddr`
   cross-coupled pair, all six resolved in one final `gen-compose` call, each
   given its own `waypoints_um` lane clear of the *other five* legs' known
   pad positions — chosen empirically against the real router, not derived
   closed-form, once the sub-block-level edge-margin restriction disappears
   along with the sub-blocks themselves).

Three more, discovered while composing `ro_ring5` from already-composed leaf
cells (`blocks[].cell`) rather than from fresh `klt gen` primitives:

6. **A composed leaf gate's signal pins are only reachable from met1
   upward.** Every gate this design builds puts its `a` input in the middle
   of its own device cluster, so an li1 route arriving from outside crosses
   that gate's own S/D pads on the way in — a *short*, not a spacing
   violation, and `gen-compose` does not catch it because the block is the
   route's own destination. Start inter-gate signal routing at `"metal2"`.
7. **A composed leaf gate's rails are already on met1 — declare the block
   port there.** `ro_stage`/`ro_nand2`'s own second stage draws `vddr` and
   `vss` on met1 internally. Declaring the `blocks[].cell.ports[]` entry for
   a rail on layer `68/20` (a point inside that internal route) rather than
   on li1 collapses `"metal3"`'s two-hop problem into a legal single hop,
   and no intermediate promotion stage is needed. met2 is completely empty
   in these leaf cells, so it is a free plane for rail busing.
8. **`gen-compose` draws a fixed-size via landing pad, not one sized by the
   declared port width.** A `0.17 µm`-wide port still gets a `0.42 µm` pad,
   so a port's position — not its width — is what decides whether its pad
   clears neighbouring metal. `ro_ring5`'s `ro` feedback needed the `g`-end
   port moved by `0.08 µm` for exactly this reason
   (`layout/ro_ring5/README.md` has the measured sweep). **The same pad
   also has to clear the port's own net**, once the port is hand-declared
   on a composed cell's *internal* route: `layout/xor2/`'s `inv_b` output
   port first landed `0.095 µm` above a perpendicular leg of `ro_buf`'s own
   `y` wire — one `li1.space.1` violation on the pad's own net, which the
   curated deck checks net-agnostically. Budget `0.21 µm + li1.space.1`
   from any perpendicular leg of the wire the port sits on, or overlap it
   outright. `gen-compose` does not warn about this — a `blocks[].cell`
   block is modelled by bbox + declared `ports[]` only, so the cell's own
   internal geometry never enters the clearance check that route-vs-route
   conflicts already get. Filed generically as
   [klayout-tools#1520](https://github.com/2AMLogic/klayout-tools/issues/1520).

Two more, discovered while composing `xor2` (see
[`layout/xor2/README.md`](xor2/README.md) for the worked example):

9. **A series transistor chain is one `mos_array` block, and its interior
   S/D segment is contactable.** `finger_topology: "series"` with
   `fingers: 2` draws two transistors sharing one diffusion strip and
   reports `U0_S0`/`U0_G0`/`U0_D0`/`U0_G1`/`U0_S1`. `ro_nand2` used this
   for its series NMOS pull-down pair and left `U0_D0` unconnected (its
   `nm` is internal by construction, which is the *cheap* case). `xor2`
   shows the other half: `U0_D0` is a real contacted pad, so two series
   chains can be wired to **share** their interior node — that is how
   `xor2`'s `mid` (`Mp1`/`Mp2` drains and `Mp3`/`Mp4` sources) becomes a
   single two-pin route rather than a four-pin bundle. Reading a
   parallel-then-parallel tree as chain-then-chain wherever the schematic
   allows it is worth doing *before* floor-planning: it halved `xor2`'s
   block count and removed four well taps with it.
10. **Split a gate's nets across layers before splitting them across
   lanes.** `compose-cell.py`'s `"stages"` shape has always been used to
   move *one crossing net* to a second metal (points 4 and 5 above). The
   more general use is to partition the whole net list: `xor2`'s stage
   `core` routes `vdd`/`mid`/`y`/`vss` on the base `"metal"` (li1) role and
   its final stage routes `a`/`an`/`b`/`bn` on `"metal2"`. The two groups
   cross each other freely and at no cost, leaving two much smaller
   single-layer problems — each of which turned out to be planar by
   construction, with no waypoint tuning beyond the lane choices. The
   corollary is a floorplan question worth asking early: *which* nets can
   be made to live entirely above and below the rows (supplies, and any
   output whose pads face outward), leaving the channel to the gate nets
   alone?

Two more, discovered while promoting `ro_array_core` from a PoC directory
into a `cell.json` recipe (see
[`layout/ro_array_core/README.md`](ro_array_core/README.md)):

11. **A stage may be re-placed with hand-declared ports, not only with its
    own promoted pins.** `blocks[].from_stage` hands the next stage the
    earlier stage's `gen-compose` *response*, whose `ports[]` are exactly
    that stage's own `pins[]` — everything a leaf or ring cell needs.
    An **array**-level stage needs the other half: to tap an already-composed
    stage's own interior conductor at a *measured coordinate* that was never
    a `pins[]` entry, and to route to a met1 tip that only exists once that
    stage has drawn it. `compose-cell.py`'s `blocks[].cell.from_stage` is
    `blocks[].cell`'s hand-declared `ports[]` shape pointed at a stage
    (`{"id": "core", "cell": {"from_stage": "vddstub", "ports": [...]}}`).
    The one trap: a committed sibling cell's `gds_path` is relative to the
    cell.json (so `--check` absolutizes it), a stage's stream is relative to
    the *output* directory (so `--check` must not) — swap them and `--check`
    silently stops checking anything past stage 1.
12. **A promotion stub's tip row is set by what runs under it, not by
    symmetry.** `ro_array_core`'s three `xor2` `vss` stubs escape south from
    the same block-local port, but `xa3`'s stops 1.2 µm higher than
    `xa1`/`xa2`'s because one earlier increment's own met1 backbone (`ro4`,
    at `y = 10.0`) happens to run under `xa3` and not the other two. The
    same asymmetry applies one layer up: once a supply bus owns a met2 lane
    spanning most of the die's width, every later met2 net has to reach the
    other side of it *around* the lane's ends, because met2 cannot cross
    met2. Budget the vertical corridors before committing a bus lane's `x`
    extent.

Two more, discovered while planning `ro_stage`:

- **A port may be named by `pins[]` *or* wired by `connectivity[]`, never
  both.** An internal net that is also a cell pin therefore takes its name
  from its `connectivity[]` entry — which works, and is how `ro_buf`'s `a`/`y`
  come out named.
- **`ro_stage`/`ro_nand2` are not single-layer planar — SOLVED, see
  `layout/ro_stage/README.md` (and `layout/ro_nand2/README.md` for the same
  fix extended to more than two same-block self-nets).** Their starve
  devices are cross-coupled to
  the *opposite* rail (`Mph.g = vss`, `Mnt.g = vddr`), so the two gate routes
  cross no matter where a single tap island per rail is placed — this is a
  real topological property of the two nets' spans, not a placement mistake
  a smarter floorplan can dodge. `klt gen-compose` performs no net-to-net
  short check *between separate calls*, but two nets crossing *within one
  call* on the same `routing.layer_role` is caught (`#1057`/`#1386`, "Known
  limitations" below) — so the naive one-pass floorplan correctly reports
  the crossing net as unroutable rather than silently shorting it (an
  earlier draft of this section suggested the opposite; that was wrong).
  The fix `layout/ro_stage/` uses: `layout/bin/compose-cell.py`'s new
  `"stages"` cell.json shape composes the gate in two `klt gen-compose`
  passes — the first leaves the two crossing gate nets deliberately
  unwired (promoted via `pins[]` as bare ports instead), the second takes
  that composed cell as a single further block and routes just those two
  nets on `"metal2"` (sky130 met1) with automatic via-drop, so they cannot
  short against anything on the base `"metal"` (li1) layer by construction.
  A per-net `routing.layer_role` override within one call still does not
  exist and was not needed once nesting was used instead — not filed as a
  tool gap.

## The well-strap gap: SOLVED — see `layout/well-strap-poc/`

`layout/primitives/README.md`'s "What this does NOT establish" section named
the finding: `mos_array --params '{"flavor":"pfet",...}'` draws the PMOS's
own nwell but no tap into it, so `klt extract` reports an isolated,
unstrapped bulk net per PMOS device, while every reference netlist under
`design/*.spice` ties PMOS bulk explicitly to a supply (`vdd`/`vddr`).

[`layout/well-strap-poc/`](well-strap-poc/README.md) solves this: **nest** a
`mos_array` PMOS block inside a `guard_ring --params '{"add_well":true}'`
block's own hollow inner cavity (rather than placing them side by side, which
DRC-violates on `li1.space.1` — the ring's own well margin is a fixed
~0.15 µm, too tight to also clear inter-block `li1` spacing). `guard_ring`'s
own nwell is drawn as one solid rectangle spanning its *entire* outer bbox
(including the cavity), so a device nested inside that cavity shares the same
physical nwell as the ring's tap — merging into one electrical node — while
the ring's own tap diffusion/`li1` stays at whatever DRC-safe clearance the
caller sizes the cavity to give it. Reproduced and verified: `klt drc`
**clean, 0 violations**; `klt extract` resolves the PMOS's bulk terminal to
the named net (`"vdd"`) labelled onto the ring's own tap port via
`gen-compose`'s `pins[]`, not an anonymous one. NMOS still needs no
per-device strap (`vsubs` is sky130's one global substrate net, and `klt
lvs`'s own `device.body_unverified` diagnostic treats an unstrapped NMOS body
as a non-blocking warning, never a match/mismatch verdict change — see the
PoC's README for the citation), but the composed design still needs at least
one `vsubs`-to-`vss` tap somewhere.

**Two corrections to the above, from building `layout/ro_buf/`:**

- **The nesting geometry is superseded.** Nesting does merge the wells, as
  described — but `gen-compose` then refuses to route *any* of the enclosed
  device's terminals, because its obstacle check counts the enclosing ring as
  an unrelated placed block (reproduced directly against this PoC's own
  committed blocks; see `layout/ro_buf/README.md` § "Why abutted, not
  nested", and upstream
  [klayout-tools#1493](https://github.com/2AMLogic/klayout-tools/issues/1493)).
  Abutting the two blocks with a 0.10 µm bbox overlap achieves the same well
  merge *and* leaves every terminal routable. New cells should abut.
- **The `l_um=0.15` regression is fixed.** The blocker recorded here
  ([klayout-tools#1491](https://github.com/2AMLogic/klayout-tools/issues/1491),
  now closed) does not reproduce on `klt 0.3.0+gc6dbf66c53c6`: regenerating
  `pfet_w0p84_l0p15`'s exact params from scratch is DRC-clean, with the same
  `bbox_um.x1 = 1.24` the committed evidence reports, and the generator's
  `drc_hints.notes` again cites the issue #1187 S/D-pad padding fix. Every
  device in `layout/ro_buf/` is drawn at this design's real `l_um=0.15`.

## Starve-width variants: why a naive clone-and-reparametrize fails

`ro_stage`/`ro_nand2` each need four physical cells (one per ring, `wstv`
0.42/0.44/0.46/0.48 µm) — see "Floorplan decisions made so far" above. The
tempting shortcut is: copy the `wstv=0.42` `cell.json`, change `Mph`/`Mnt`'s
`params.w_um`, done. **That shortcut does not compose at all at the other
three widths** — `klt gen-compose` reports the affected nets unrouted, so
`compose-cell.py` aborts before DRC/LVS ever runs.

The reason: `Mph`/`Mp` (and `Mnt`/`Mn`) are connected by a *straight,
no-jog* route (`py`/`ny`) that only works because both devices' S/D pads
land at the exact same absolute `y` — `ro_stage/README.md`'s own floorplan
section calls this out as deliberate, not incidental (`Mph.D` and `Mp.S`
both at `y = 3.74`). `Mp`/`Mn`'s own geometry is fixed (`w_um` doesn't
depend on `wstv`), but `Mph`/`Mnt`'s local port position *does* move with
their own `w_um`: `klt gen mos_array`'s reported local `y_um` for a starve
device's S/D pads is exactly `w_um / 2` (verified empirically across all
four widths, both flavors — `0.42→0.21`, `0.44→0.22`, `0.46→0.23`,
`0.48→0.24`, i.e. linear, and identical between `pfet`/`nfet` despite their
different bbox heights from the nwell margin). Re-generating `Mph`/`Mnt` at
a new `w_um` with `Mph`/`Mnt`'s **existing, `wstv=0.42`-tuned**
`placement.origins_um` shifts that port by exactly the width delta (as
little as `0.01 µm`), which is enough to turn the straight `py`/`ny` route
into a route `klt gen-compose` reports **unrouted**.

This is a reproduced negative control, not an assumption. Taking
`layout/ro_stage/cell.json` verbatim, substituting only `Mph`/`Mnt`'s
`params.w_um` to `0.44` and leaving every `placement.origins_um` entry at
its `wstv=0.42` value, `compose-cell.py` aborts on the first stage with:

```
error: core: nets left unrouted by gen-compose: ['py', 'vddr']
```

The failure is loud, not silent — the router refuses rather than routing at
zero margin — so the practical hazard is a future increment concluding the
`wstv` variants are simply infeasible, not one shipping a bad cell.

**The fix** — re-derive, don't copy, `Mph`/`Mnt`'s own `placement.origins_um.y`
per width, from the same closed form every `ro_stage_wstv0p*`/
`ro_nand2_wstv0p*` cell.json's own `_comment` block documents:

```
mph.y(w) = 3.74 + w/2   # keeps Mph.D aligned with Mp.S's fixed y=3.74
mnt.y(w) = 0.21 - w/2   # keeps Mnt.D aligned with Mn.S's fixed y=0.21
```

(`3.74`/`0.21` are `Mp`/`Mn`'s own fixed S-port `y`, unaffected by `wstv`
since neither device's geometry depends on it.) Every other block, origin,
waypoint, and routing-layer choice in `ro_stage`/`ro_nand2`'s `cell.json` is
**unaffected by width** and stays byte-for-byte identical across all four
variants — confirmed by all four `wstv` values landing DRC-clean (0
violations) and LVS-matching for both cell types, with no other geometry
change (`layout/ro_stage_wstv0p44/README.md` et al. document the resulting
concrete origin values). This is the same "same-`y` alignment" discipline
`ro_stage/README.md`'s floorplan section already flags for the `wstv=0.42`
case — this section's contribution is confirming it generalizes to a closed
form across the whole `wstv` range, rather than needing to be independently
re-tuned per width by trial and error.

### The LVS match is width-sensitive (negative control)

Four cells that differ by `0.02 µm` on two devices, all reporting `klt lvs`
**match**, invite an obvious objection: is `klt lvs` comparing device widths
at all, or would any of these layouts match any of these references? It is
comparing them. Feeding `ro_stage_wstv0p48`'s extracted netlist against
`ro_stage`'s (`wstv=0.42`) reference netlist — the only change — flips the
verdict:

```
status: mismatch   mismatch_count: 12   error_count: 12
counts: nets 6/6 matched 2, devices 4/4 matched 2
  device.property  error  matched device parameter 'w_um' differs
                          NFET  layout 0.48  reference 0.42
  device.property  error  matched device parameter 'w_um' differs
                          PFET  layout 0.48  reference 0.42
```

So each variant's `match` verdict is evidence that *that* layout implements
*that* ring's `wstv`, not merely that some starved inverter was drawn. The
`Mph`/`Mnt` `w_um` value is decisive in the compare, and it is the one thing
that differs between the four references (`compose-cell.py`'s
`lvs.params.wstv` substitution — see each cell's own `*.ref.spice`, where
`XMph`/`XMnt` carry `W=0.42u`/`0.44u`/`0.46u`/`0.48u` respectively while
`XMp`/`XMn` stay fixed).

One caveat worth recording for whoever assembles the ring: in that
deliberately-mismatched run, the reference side's `as`/`ad`/`ps`/`pd` read
back as `0.0`, because `design/ro_array_core.spice` states them as
*expressions* in `wstv` (`ad='int((1 + 1)/2) * wstv / 1 * 0.29'`) and `klt
lvs`'s `subckt-call` converter does not evaluate them. Those four parameters
are therefore **not** effectively compared for the starve devices in any of
these runs (they do not appear as mismatches in the passing runs either).
`W`/`L`, device class, and connectivity are compared and are what these
verdicts rest on. Not filed upstream as a tool gap: the parameters that
decide this design's device identity are compared, and a converter declining
to evaluate arbitrary SPICE parameter expressions is a defensible boundary
rather than a defect — but a future increment that starts depending on
S/D-area matching should re-check this rather than assume coverage.

## Scouting `--parasitics`: what step 5 will and will not have to fight

Step 5 below (post-layout PVT re-verification) is not attempted here, and
**no `sim/` record is minted by this increment** — a PVT campaign is its own
deliverable with its own corner discipline, and a half-run one is worth less
than none. But three things about the extraction-to-ngspice handoff were
cheap to settle now and expensive to discover mid-campaign, so they are
settled and recorded here as layout/tool evidence rather than as a
simulation claim.

Probe used throughout: `ro_stage_wstv0p48`'s committed GDS, re-extracted with
`klt extract <gds> --deck sky130 --parasitics`, on `klt 0.4.0` / ngspice-47.
This produced no committed artifact — the probe is reproducible from the
committed GDS in one command, so there is nothing to keep in the tree.

1. **`--parasitics` works on these composed cells.** It is not blocked, not
   deck-limited, and not defeated by the two-pass `"stages"` composition.
   `ro_stage_wstv0p48` yields 16 series R, 6 net-to-substrate C, and 1
   net-to-net coupling C (`total_resistance_ohm` 1717.8,
   `total_capacitance_ff` 4.74, `total_coupling_capacitance_ff` 0.0036),
   with a per-net breakdown and a star of per-terminal leg resistances. So
   step 5's input exists today for every cell in this directory.

2. **The `|` in the extracted net names is harmless — a false alarm,
   pre-empted.** Cells built by the two-pass technique carry a pin label and
   a net label on the same physical net (`ro_stage`'s `mph_g` and `vss`), and
   the extractor joins those into one name, spelling it `mph_g|vss` in the
   `.SUBCKT` line and R/C cards but `mph_g\x7cvss__t0` in device cards. That
   looks exactly like a netlist that will silently split into two nodes —
   and ngspice does treat `a|b` and `a\x7cb` as distinct nodes, so the worry
   is well-founded in general. It does not happen here: the escaped spelling
   is only ever used on the `__tN` *leg* nets, which are distinct nodes by
   construction, and the hub node is spelled consistently. Verified by
   instantiating the extracted subcircuit in ngspice and running `.op` —
   pins bind correctly and the parasitic R star is live (the `y` net's two
   legs settle at slightly different voltages, as a star of real resistors
   should). A future increment does not need to re-litigate this.

3. **The substrate return node is a real trap, and is filed upstream.**
   Every net-to-substrate capacitor returns to a node named `vsubs` which is
   *neither* a `.SUBCKT` pin *nor* `.GLOBAL`-declared, tied to ground only
   via `Rvsubs_dctie vsubs 0 1e+12`. Simulated flat (extracted cell as the
   top cell) that is fine. **Instantiated** — which is how any PVT sweep or
   hierarchical assembly will use it — `vsubs` becomes a per-instance local
   node the testbench cannot reach: a top-level `Vs vsubs 0 0` does *not*
   tie it (ngspice lists `vsubs` and `x1.vsubs` as separate nodes), so the
   whole ground-capacitance model hangs off a node isolated from ground by
   1 TΩ. Nothing errors and the sim converges. Measured on this cell's own
   output net, as-extracted versus the same netlist with `.GLOBAL vsubs`
   prepended: ~1% impedance difference at 1 GHz, ~17% at 10 GHz — small
   enough to pass a spot check, large enough to corrupt a campaign.

   Filed generically per this repo's friction protocol as
   [klayout-tools#1503](https://github.com/2AMLogic/klayout-tools/issues/1503)
   (described as a parasitic-writer substrate-node scoping problem, with no
   reference to this design). **Until it is fixed, step 5's harness must
   either simulate the extracted cell flat, or prepend `.GLOBAL vsubs` to
   the extracted netlist** — and whichever it does must be recorded in the
   `sim/` record, because the two give measurably different answers.

   **Resolved as implemented**: step 5 took the `.GLOBAL vsubs` path
   (`layout/bin/pex-netlist.py` emits the declaration, every deck ties the
   node itself, and every record states which tie it used). Flattening was
   rejected — a ring is five instances by construction, and flattening would
   make the substrate node per-ring rather than shared, destroying the one
   coupling path step 6's re-evaluation depends on. The choice turned out to
   be worth 0.06-0.15% on the ring period between a hard tie and no tie,
   which is small but is measured rather than assumed; see
   `sim/post-layout-parasitic-impact/`.

## What's deferred (tracking issue)

Everything below issue #22's original scope needed and this PR does not
deliver, tracked in follow-up issue
[2AMLogic/sky130-trng#27](https://github.com/2AMLogic/sky130-trng/issues/27):

0. ~~Solve the well-strap geometry~~ **DONE** — see
   `layout/well-strap-poc/` for the well-merge finding and
   `layout/ro_buf/README.md` § "Why abutted, not nested" for the routable
   form of it. The `l_um=0.15` regression that blocked this
   ([klayout-tools#1491](https://github.com/2AMLogic/klayout-tools/issues/1491))
   is fixed and closed.
1. ~~Compose one fully DRC-clean **and** LVS-clean gate end to end as the
   methodology's real proof point~~ **DONE** — `layout/ro_buf/`: `klt drc`
   clean (0 violations), `klt lvs` **match** against
   `design/ro_array_core.spice`'s own `.subckt ro_buf` (2/2 devices, 4/4
   nets), at this design's real device sizes, reproducible from a committed
   descriptor via `layout/bin/compose-cell.py`.
2. Repeat for `ro_stage`, `ro_nand2` (including the 4-way `wstv` variants),
   and `xor2`. **`ro_stage` and `ro_nand2` are both DONE, all four `wstv`
   values** (see `layout/ro_stage/README.md`, `layout/ro_nand2/README.md`,
   and the `_wstv0p44`/`_wstv0p46`/`_wstv0p48` sibling directories of each):
   `klt drc` clean (0 violations) for all eight cells; `klt lvs` **match**
   against `design/ro_array_core.spice`'s own `.subckt ro_stage` (4/4
   devices, 6/6 nets) and `.subckt ro_nand2` (6/6 devices, 8/8 nets)
   respectively at every width, both using the two-pass `"stages"`
   composition (point 4 in "Composing a gate" above) to route their
   cross-coupled starve-device gates without a short. `ro_nand2`
   additionally needed point 5's generalization (promote every pin of a
   many-device same-net bundle, resolve the whole bundle — six same-block
   self-nets in one final `gen-compose` call, not `ro_stage`'s two) to
   floor-plan its parallel PMOS pull-up pair and series NMOS pull-down pair,
   neither of which `ro_stage`'s single-switching-device shape has an
   analogue for. The three additional `wstv` widths per cell type
   (`0.44`/`0.46`/`0.48 µm`) needed one further finding beyond the
   `wstv=0.42` recipe — re-deriving `Mph`/`Mnt`'s own `y` origin per width
   rather than cloning the `0.42`-tuned one unchanged — see "Starve-width
   variants" above for the closed form and why the naive clone fails.
   `layout/bin/compose-cell.py`'s `lvs.params`/`lvs.drop_prefixes` fields
   (`params` substitutes `wstv`/`lstv` into the reference subckt's `L=lstv
   W=wstv` device cards; `drop_prefixes: ["Cld"]` drops the lumped load
   capacitor, a simulation load model with no physical counterpart) were
   already in place from `ro_stage`/`ro_nand2`'s own initial build and
   needed no changes for the variants.
   **`xor2` is now DONE too, closing this step in full** — see
   [`layout/xor2/README.md`](xor2/README.md): `klt drc` clean (0
   violations) and `klt lvs` **match** (12/12 devices, 10/10 nets, 0
   errors) against `design/ro_array_core.spice`'s own `.subckt xor2`, in
   two `gen-compose` stages. It did **not** need the channel router or the
   third routing plane this bullet previously predicted, and the reason is
   the reusable part: `xor2`'s twelve devices are eight tree devices that
   read as **four two-transistor series chains** (point 9 below) plus two
   inverters that *are* `ro_buf` (placed via `blocks[].cell`), so only nine
   blocks are placed at all; and its ten nets split cleanly across **two
   layers** (point 10 below) instead of competing for lanes on one. The
   placement-only PoC that predicted otherwise is superseded and now opens
   with that correction.
3. Hierarchical assembly: `ro_ring5` (5 gates + inter-gate routing),
   `ro_array_core` (4 non-identical rings + combining XOR tree),
   `sampler_dff`/`sampler_core` (no generator surveyed yet for a
   transmission-gate DFF — may need `klt draw` or a new `klt gen` generator;
   if the latter is a genuine gap, *that* is the point to file a
   `2AMLogic/klayout-tools` issue, described generically).
   **The transmission-gate survey is now done, and the answer is "no gap":**
   see [`layout/sampler_tg/README.md`](sampler_tg/README.md) — `mos_array`
   composes a transmission gate exactly as it composes an inverter (same two
   devices, same two-row stack; only which pins share a net differs), `klt
   drc` clean and `klt lvs` **match** (2/2 devices, 6/6 nets) against a
   hand-authored micro-reference (no `design/*.spice` `.subckt` exists for
   this shape — `sampler_dff.sch` is flat, unlike `ro_ring5.sch`). No `klt
   draw` and no new `klt gen` generator needed. `sampler_dff`/`sampler_core`
   assembly itself remains open (#27): the other missing leaf shape is a
   plain rst_n-gated NAND2 (`sampler_nand2`, structurally `ro_nand2` minus
   its two starve devices), then all 22 devices need placing and routing as
   one cell, LVS-checked against `design/sampler_core.spice`'s real `.subckt
   sampler_dff`.
   **`ro_ring5` is DONE, all four `wstv` values** — see
   [`layout/ro_ring5/README.md`](ro_ring5/README.md) and its three `wstv`
   siblings: `klt drc` clean (0 violations) and `klt lvs` **match**
   (22/22 devices, 19/19 nets, 0 errors) against
   `design/ro_array_core.spice`'s own `.subckt ro_ring5` at each ring's own
   `wstv`, with the five leaf gates placed via `blocks[].cell`, `n1`-`n4`
   and the `ro` feedback routed on met1 and both rails bussed on met2.
   Four things that increment settled, each of which the first attempt
   (`ro_ring5-connectivity-poc`, now superseded) had wrong or open:
   - **The leaf gates' `a` ports are not reachable on li1 from outside.**
     Each sits inside its own device cluster, so any li1 approach crosses
     that gate's own S/D pads. Inter-gate signal routing starts at met1.
   - **The proposed three-stage li1→met1→met2 rail promotion is
     unnecessary.** Both rails are *already* drawn on met1 inside every leaf
     gate (by that gate's own two-pass `"stages"` composition), so declaring
     the block's rail port directly on layer `68/20` satisfies
     `"metal3"`'s single-hop via-drop rule with no promotion stage.
   - **The placement pitch is a closed form**, not a tuning exercise:
     `ro_nand2`'s nwell ends at local `x=5.57`, `ro_stage`'s starts at
     local `x=-2.19`, so `g`→`s1` needs `≥ 9.03 µm`; `9.30` is used.
   - **The five "unexplained device-internal `li1.space.1` violations" were
     the routes**, and the corrected placement with no routing at all is
     DRC-clean — there is no hierarchy-dependent DRC effect to work around.
   `layout/bin/compose-cell.py` gained `blocks[].cell` support and
   multi-subckt LVS references (`lvs.dependencies`) in the previous
   increment, and in this one: `blocks[].cell.gds_path` resolution relative
   to the cell.json (so `--check`'s temp-dir rebuild can find a sibling
   cell's committed stream at all), `lvs.reference_top` (a multi-subckt
   reference leaves `klt lvs` more than one candidate top circuit) and
   `lvs.drop_kwargs`. All three regression-tested against all nine
   previously-committed leaf cells, every one still `--check` clean.
4. Full-block `klt drc` + `klt lvs` (assembled netlist vs. `design/*.spice`)
   sign-off. **Reached for `ro_ring5` (all four rings), still open for
   `ro_array_core`/`sampler_core`.** Two further findings from the first
   multi-subckt LVS run, both now handled by `compose-cell.py`:
   a reference built from more than one `.subckt` leaves `klt lvs` with
   several candidate top circuits and it refuses to guess
   (`reference.top`, `lvs.reference_top` in cell.json), and comparing a
   *hierarchical* reference against `klt extract`'s *flat* layout netlist
   needs `options.flatten_reference` — which LVS reports back as a
   `topology.flattened` warning, so the resulting `match` verifies
   device/net correspondence but **not** that the layout's cell hierarchy
   mirrors the schematic's. The
   **reference-netlist request shape is settled** (it was
   listed here as an open unknown, mis-diagnosed as a `"pfet"`/`"PFET"`
   device-class-name mismatch): `reference.form: "subckt-call"` with
   `reference.deck: "sky130"` is correct, and the real cause of the total
   mismatch was that its converter reads an **unsuffixed** `L=`/`W=` value as
   SI metres, while this design's netlists are unitless under
   `.option scale=1u` — so `L=0.15` became a 0.15 m gate and nothing matched.
   `layout/bin/compose-cell.py` appends the explicit `u` suffix; filed
   upstream as
   [klayout-tools#1492](https://github.com/2AMLogic/klayout-tools/issues/1492).
   Note also that `klt`'s sky130 deck is a **curated subset**, not sky130
   sign-off — read each `drc.json`'s own `coverage` block (`deck_scope`,
   `layers_checked`, `layers_in_stream_without_rules`) before calling any
   result "DRC-clean" without qualification.
5. Post-layout PVT re-verification: re-run `sim/`'s existing corner-sweep
   harness (`sim/bin/corner-run.py`) against the `klt extract --parasitics`
   output, recording results under `sim/` per the existing append-only
   convention. **DONE for the leaf-cell scope that exists** — see
   [`layout/pex/`](pex/README.md) for the generated library and
   `sim/post-layout-ro-ring5/` + `sim/post-layout-parasitic-impact/` for the
   twelve records and their reduction. Headline: intra-cell parasitics cost
   **1.378x - 1.479x in ring period** over the grid, raise ring-node swing
   1-4%, and lower per-ring supply current 2-6%; the `wstv` frequency ladder
   survives (post-layout span 1.1122x - 1.2096x). **Still open**: the same
   measurement over an *assembled* block, which needs steps 2 and 3 —
   `layout/` has no inter-cell interconnect to extract, so every number
   above is intra-cell parasitics with ideal wires between gates.
   `layout/pex/README.md` states that limitation in full, in both directions
   (the extractor's lumped-star resistance over-states the intra-cell
   penalty; the missing inter-cell wiring under-states the whole-block one).
   **DONE for the assembled-ring scope, this increment**: the four
   `ro_ring5` cells' own composed GDS (real inter-gate `n1`-`n4`/`ro` routing
   and `vddr`/`vss` rail busing included) is now extracted directly —
   [`layout/pex-ring/`](pex-ring/README.md) — and
   `sim/post-layout-ro-ring5-assembled/` runs the same period/swing/current
   measurement across the identical four-point PVT grid, twelve corner runs,
   as a new (not a superseding) sibling of `sim/post-layout-ro-ring5/` — see
   `sim/README.md`'s "Assembled-ring post-layout" section for the full
   reduction. Headline: real inter-gate wiring costs the ring **1.5045x -
   1.6546x** more slowdown *on top of* intra-cell parasitics alone (48
   paired PVT-grid points, mean 1.573x) — period vs. pre-layout control is
   **2.0819x - 2.3666x** overall, against the intra-cell-only figure's
   1.378x - 1.479x above — and the `wstv` ladder still survives (assembled
   post-layout span 1.0937x - 1.1822x, tighter than either the intra-cell-only
   or pre-layout figures). **Still open**: the *array*-level assembly
   (`ro_array_core`'s inter-ring wiring — buffer fan-in, the XOR combining
   tree, per-ring supply distribution — none of it drawn yet), which needs
   steps 2 and 3 above; every number in this bullet is still one ring's own
   real interconnect with ideal wires to its neighbours, not a whole-array
   measurement.
   **DONE for the whole-array scope, this increment**: the composed,
   DRC-clean, LVS-matching whole array (`layout/ro_array_core/`'s canonical,
   `--check`-reproducible GDS — four non-identical rings, four buffers, the
   three-`xor2` combining tree, the array-wide `vdd` bus and the array-wide
   `vss` strap, all really wired) is now
   extracted directly — [`layout/pex-array/`](pex-array/README.md) — and
   `sim/post-layout-ro-array-core/` runs the same period/ladder measurement
   plus, for the first time, XOR-tree combining fidelity and array supply
   current, across the identical four-point PVT grid, 36 corner runs (12
   tied + 12 float + 12 solo) — see `sim/README.md`'s "Array-level
   post-layout" section for the full reduction. Headline: array-level
   parasitics cost **2.158x - 2.501x** in ring period against pre-layout
   (against the assembled-ring-only figure's 2.0819x - 2.3666x above, since
   the array additionally carries buffer and XOR-tree loading neither
   smaller-scope campaign could include), the `wstv` ladder still
   discriminates (span 1.084x - 1.175x), and combining-node bias stays close
   to 0.5x Vdd post-layout (0.433 - 0.554, against 0.355 - 0.537 pre-layout
   in the same deck) — no new systematic bias from the real routing. **Still
   open**: `sampler_dff`/`sampler_core` (no layout at all yet, so this is
   still not a whole-chain raw-tap-to-sampled-bit measurement), and a
   `vddr1`-`vddr4` supply-distribution layout (the one array-scale routing
   item `layout/ro_array_core/`'s recipe does not contain).
6. Re-evaluate DR-0003 §8's `wstv` inter-ring decorrelation gap using the
   extracted parasitics from step 5 — the measurement DR-0003 explicitly
   flagged as needing a real layout and unmeasurable at the netlist level.

   **Status after this increment: partially bounded, still open, and still
   not superseded.** A previous increment recorded this as "deliberately not
   re-evaluated" because the extraction had been run without
   `--parasitics` and only one leaf gate existed. Step 5 above changes that,
   and `spec/decision-records/DR-0005-*.md` is the re-evaluation:

   - **Measured.** Extracted parasitics give four independently-supplied
     rings exactly one node in common — the substrate return node every
     net-to-substrate capacitance lands on. Bracketing it between an ideal
     tie (`vsubs` to 0, zero coupling by construction) and no tie at all
     (the extractor's own 1 TOhm dc tie, infinite-impedance shared
     substrate), **the coupling-attributable period shift is at most 0.033%
     of the ring period** — and it is an upper bound rather than a resolved
     measurement, since only 1 of 12 grid points clears the transient
     solver's own 0.024% numerical period scatter and the shift's sign is
     not consistent across the grid. A third deck (rings 2/3/4 present but
     *stopped*) separates that from the floating node's own capacitive
     loading, which is a different mechanism and is what a two-deck
     comparison would have misattributed.
   - **Still open, and this is the part that matters.** §8's first-named
     mechanism is *shared supply impedance*, and there is still no
     supply-distribution layout — `vddr1`..`vddr4` remain four ideal
     isolated sources. The extractor also emits no substrate or tap
     resistance, so the bracket's interior is unmodelled
     ([klayout-tools#1503](https://github.com/2AMLogic/klayout-tools/issues/1503)),
     and nine leaf cells simulated as if infinitely separated say nothing
     about proximity. §8's own statement of the gap is therefore still
     accurate, so nothing supersedes it — per this repo's decision-record
     convention a correction supersedes rather than edits in place, and
     there is still no correction to make.
   - **What did get answered** is the ladder half: the `wstv` frequency
     ladder survives the parasitics (post-layout span 1.1122x - 1.2096x
     against 1.1225x - 1.2464x pre-layout, closest approach to a
     mutual-injection-lock rational 9.3% anywhere on the grid).
   - **This increment's assembled-ring extraction (step 5 above) does not
     change any of the above.** `sim/post-layout-ro-ring5-assembled/`
     extracts one ring's own GDS at a time, same as `layout/pex/` did —
     `vddr1`..`vddr4` are still four independent ideal sources across
     separate ngspice runs, never sharing a node the way the substrate-float
     decks' four *simultaneous* rings do. So it adds no new information
     about inter-ring coupling and neither confirms nor supersedes DR-0005;
     it re-confirms the ladder-survival half on a real-inter-gate-wiring
     model (assembled post-layout span 1.0937x - 1.1822x, if anything
     *tighter* than either the intra-cell-only or pre-layout figures above),
     which is consistent with, not a correction to, what DR-0005 already
     states.
   - **This increment's array-level extraction re-runs the tied/float/solo
     bracket on a REAL physically-placed layout for the first time, and
     `spec/decision-records/DR-0006-*.md` is the re-evaluation.** Unlike
     every prior bracket in this repo (leaf cells, or one ring's own GDS,
     hand-tied to a shared `vsubs` node as if placed at infinite
     separation), `layout/pex-array/`'s single flat extraction of the
     composed array carries the four rings' *real* physical placement, well
     spacing and shared psub geometry exactly as drawn — closing DR-0005's
     own named "Proximity" limitation for the substrate mechanism
     specifically. The result: a **wider**, not narrower, bound
     (loading -0.353% to -0.192% of ring period, coupling +0.044% to
     +0.293%, against DR-0005's -0.151% to -0.057% / -0.033% to +0.018%),
     and — unlike every prior bracket in this repo — a coupling figure whose
     **sign is consistent across all twelve grid points** (12 of 12
     positive), which appeared only once the canonical `vss`-strapped GDS
     became the extraction source. DR-0006 is deliberate about the limit of
     that: the magnitude is still a bracket, not a measurement, and the
     array-scale numerical period-scatter floor has not been re-derived, so
     this is a directional signature rather than a resolved pull.
     §8's own statement of the gap is therefore
     *still* accurate — nothing here supersedes DR-0003 §8 or DR-0005 — and
     the first-named mechanism (shared supply impedance) still has no
     layout to be measured on at any scale.

## Reproducing the evidence in `layout/primitives/`

**The caveat a previous increment added here is withdrawn.** It recorded that
regenerating these `l_um=0.15` geometries against the then-pinned
`klayout-tools v0.2.0` reproduced the layout but not the clean DRC verdict
([klayout-tools#1491](https://github.com/2AMLogic/klayout-tools/issues/1491),
evidence preserved under `layout/well-strap-poc/regression-evidence/`). That
issue is closed, and on `klt 0.3.0+gc6dbf66c53c6` a from-scratch regeneration
is DRC-clean again with byte-identical reported geometry — re-verified for
`pfet_w0p84_l0p15` while building `layout/ro_buf/`.

```bash
# PDK pin: see layout/pdk.json (same open_pdks_commit as design/pdk.json, sim/pdk.json)
volare enable --pdk sky130 c6d73a35f524070e85faff4a6a9eef49553ebc2b

klt gen mos_array --params '{"w_um":0.84,"l_um":0.15,"rows":1,"cols":1,"dummy":0,"flavor":"pfet","gate_contact":true}' \
  --pdk sky130A --cell-name pfet_w0p84_l0p15 -o /tmp/pfet_w0p84_l0p15.gds --format json

klt drc /tmp/pfet_w0p84_l0p15.gds --deck sky130 --format json
klt extract /tmp/pfet_w0p84_l0p15.gds --deck sky130 --format json
```

Repeat with `layout/primitives/README.md`'s table for the other five
geometries.

## Reproducing `layout/ro_buf/`

```bash
volare enable --pdk sky130 c6d73a35f524070e85faff4a6a9eef49553ebc2b
python3 layout/bin/compose-cell.py layout/ro_buf/cell.json --check
```

`--check` rebuilds the whole chain into a temporary directory and diffs the
verdict-bearing fields (`drc.json`'s `status`/`violation_count`,
`extract.json`'s `status`/`device_count`/`net_count`/`device_counts`,
`lvs.json`'s `status`/`mismatch_count`/`error_count`/`counts`, and
`compose.response.json`'s `cell_name`/`bbox_um`) against what is committed,
without touching it. Drop `--check` to regenerate in place.

## Reproducing `layout/ro_stage/`

```bash
volare enable --pdk sky130 c6d73a35f524070e85faff4a6a9eef49553ebc2b
python3 layout/bin/compose-cell.py layout/ro_stage/cell.json --check
```

Same `--check` contract as `ro_buf` above, extended (see `check_cell` in
`layout/bin/compose-cell.py`) to also diff every non-final stage's own
`<name>.compose.response.json` (here, `core.compose.response.json`) on the
same fields, since a two-stage cell's drift could otherwise hide in the
first pass without moving the final cell's own verdict.

## Reproducing `layout/ro_nand2/`

```bash
volare enable --pdk sky130 c6d73a35f524070e85faff4a6a9eef49553ebc2b
python3 layout/bin/compose-cell.py layout/ro_nand2/cell.json --check
```

Same two-stage `--check` contract as `ro_stage` above. `layout/ro_nand2/`'s
own final stage resolves six same-block self-nets (`py`'s two legs, `y`'s two
legs, plus `ro_stage`'s usual `vss`/`vddr` cross-coupled pair) in one
`gen-compose` call rather than `ro_stage`'s two — see
`layout/ro_nand2/README.md`'s own table for why each leg's `waypoints_um`
lane sits where it does, empirically derived against the real router's
route-vs-route collision check.

## Reproducing the `wstv` ring variants

```bash
volare enable --pdk sky130 c6d73a35f524070e85faff4a6a9eef49553ebc2b
python3 layout/bin/compose-cell.py layout/ro_stage_wstv0p44/cell.json --check
python3 layout/bin/compose-cell.py layout/ro_stage_wstv0p46/cell.json --check
python3 layout/bin/compose-cell.py layout/ro_stage_wstv0p48/cell.json --check
python3 layout/bin/compose-cell.py layout/ro_nand2_wstv0p44/cell.json --check
python3 layout/bin/compose-cell.py layout/ro_nand2_wstv0p46/cell.json --check
python3 layout/bin/compose-cell.py layout/ro_nand2_wstv0p48/cell.json --check
```

Same `--check` contract as `ro_stage`/`ro_nand2` above (each of these six is
also a two-stage `"stages"` cell). See "Starve-width variants" above for the
one thing that differs per width (`Mph`/`Mnt`'s own `w_um` and re-derived
`placement.origins_um.y`), and each variant's own README for that cell's
concrete numbers.

## Reproducing `layout/ro_ring5/` and the four rings

```bash
volare enable --pdk sky130 c6d73a35f524070e85faff4a6a9eef49553ebc2b
python3 layout/bin/compose-cell.py layout/ro_ring5/cell.json --check
python3 layout/bin/compose-cell.py layout/ro_ring5_wstv0p44/cell.json --check
python3 layout/bin/compose-cell.py layout/ro_ring5_wstv0p46/cell.json --check
python3 layout/bin/compose-cell.py layout/ro_ring5_wstv0p48/cell.json --check
```

Same `--check` contract as the leaf cells, now over four stages rather than
two (`place`, `sig`, `fb`, final) — every non-final stage's own
`<name>.compose.response.json` is diffed as well as the final cell's.

Two per-stage checks worth running by hand when something moves, because
`compose-cell.py` only DRCs the *final* cell:

```bash
cd layout/ro_ring5
klt drc place.gds --deck sky130 --format json   # placement alone: clean, 0 violations
klt drc sig.gds   --deck sky130 --format json   # + n1-n4:         clean, 0 violations
klt drc fb.gds    --deck sky130 --format json   # + ro feedback:   clean, 0 violations
```

A violation that first appears at stage *n* was introduced by stage *n*.
This is the check that turned the previous attempt's "5 unexplained
device-internal violations" into "the routes did it".

## Reproducing `layout/xor2-placement-poc/` (superseded)

```bash
volare enable --pdk sky130 c6d73a35f524070e85faff4a6a9eef49553ebc2b
cd layout/xor2-placement-poc
klt gen-compose compose.request.json --format json
klt drc xor2core.gds --deck sky130 --format json
klt extract xor2core.gds --deck sky130 --format json
```

Not a `compose-cell.py` cell (no `cell.json`, no `--check`) — this was a
placement-only proof of concept, not a composed-and-verified gate; there is
no `connectivity[]`/`lvs.json` to check against. **The composed, DRC-clean,
LVS-clean `xor2` is `layout/xor2/`**, which shares none of this PoC's
coordinates and is built and checked the ordinary way (`python3
layout/bin/compose-cell.py layout/xor2/cell.json --check`). This PoC is
kept because its own README now records, with evidence, which of its
conclusions the composed cell contradicts — see its correction header.

## Reproducing `layout/pex/` (the post-layout netlist library)

```bash
volare enable --pdk sky130 c6d73a35f524070e85faff4a6a9eef49553ebc2b
python3 layout/bin/pex-netlist.py layout/pex/pex.json --check   # verify
python3 layout/test_pex_netlist.py                              # rewrite unit test (no PDK)
```

`--check` re-extracts all nine cells from their committed GDS into a
temporary directory and fails if the rebuilt library differs from the
committed one by a byte, or if any extraction report's verdict fields moved.
`layout/test_pex_netlist.py` is the other half of that guard: `--check`
proves the library matches what the script produces *today*, the unit test
proves the script's rewrite (net renames, unit-suffix stripping, device-card
swap) is correct — a wrong rewrite would simulate cleanly and report wrong
numbers. See [`layout/pex/README.md`](pex/README.md) for the parasitic
model's own contents and limits.

## Reproducing `layout/pex-array/` (the array-level post-layout netlist library)

```bash
volare enable --pdk sky130 c6d73a35f524070e85faff4a6a9eef49553ebc2b
python3 layout/bin/pex-netlist.py layout/pex-array/pex.json --check   # verify
```

Same `--check` contract as `layout/pex/` above, run against a single flat
extraction of the canonical
[`layout/ro_array_core/ro_array_core.gds`](ro_array_core/README.md) — the
`--check`-reproducible cell recipe's own committed, `vss`-strapped output —
instead of nine leaf cells. (An earlier revision of this directory sourced
`layout/ro_array_core-placement-poc/`'s superseded `signal9` stream, before
the recipe promotion landed; see `layout/pex-array/README.md`'s "Which GDS"
section for what changed numerically.) `layout/test_pex_netlist.py` is
shared, unmodified — its coverage of the rewrite logic (net renames,
unit-suffix stripping, device-card swap) applies here too, since
`layout/bin/pex-netlist.py` itself did not change. See [`layout/pex-array/README.md`](pex-array/README.md) for
the array-scale net-aliasing technique and what the parasitic model does and
does not contain.

## `layout/trng_digital/` and whole-block integration status (issue #18)

`layout/trng_digital/` is the placed-and-routed DR-0004 digital section
(issue #166, PR #167), produced by `klt place-and-route` from the
50 kHz-constrained `sky130_fd_sc_hd` netlist. It is **not** a composed cell
recipe like the analog cells above and is not `compose-cell.py --check`
reproducible; it is reproduced by
`python3 sim/digital-pnr/harness/pnr-and-verify.py --emit-record` (tool pins
in `digital/flow/place-and-route/tool-pins.json`).

| Check | Result | File |
|---|---|---|
| Die / utilisation / wirelength | 60049.5 um2 / 42.6 % / 66327 um | `trng_digital/pnr.json` |
| `klt drc --deck sky130` (curated deck, no fill/density) | clean, 0 violations (pinned-tool result; a 2026-10-04 re-run with the unpinned host klt 0.6.0+ge2ba44fa31ce agreed, confirmatory only and not recorded) | `trng_digital/drc.json` |
| LVS, cell-level vs signal-pin-only netlist | match, `power_connectivity` match | `trng_digital/lvs.json` |
| Post-route STA, 16 Liberty corners | 0 setup/hold violations | `trng_digital/sta.json` |

**Whole-block status (updated 2026-10-08, issues #18 / #173): composed and
verified within the stated coverage; not signed off.** `layout/trng_whole/` (issue #172, PR #176) composes
`sampler_core` and `trng_digital` into one routed top cell `trng_whole`; its own
recorded verdict (`report.json`) is the composition-time `composed; physical
sign-off pending`. Issue #173 then added whole-block DRC, extraction, LVS and
fault controls under `trng_whole/verify/` (below). The two halves' separate
DRC/LVS results are **not** a block result and must not be cited as one.

| Whole-block check | Status | Evidence / tracker |
|---|---|---|
| Composition: 18/18 nets, 22/22 legs routed, `unrouted_nets: []`, 18 distinct extracted clusters, `vddr1`-`vddr4` distinct | done (composition only) | `trng_whole/report.json`, `trng_whole/README.md` |
| `compose-whole.py --check` isolated rebuild | matches committed evidence (re-run 2026-10-07 after the #181 regeneration, klt `0.6.0+g5edb557f91d0`) | `trng_whole/` |
| `layout/test_compose_whole.py` | PASS (re-run 2026-10-07) | `layout/test_compose_whole.py` |
| Block DRC | **clean, 0 violations (issue #173)** on the composed stream, klt `0.6.0+g5edb557f91d0`, curated sky130 deck `sha256:2bcbd625...`, 91 rules / 20 layers (45 deck rules skipped, 19 stream layers without rules: **not** foundry DRC; no antenna/density/seal-ring/latch-up). Before the #181 regeneration the stream gave 5664 `licon1.ongrid.1`, all inside `sampler_core` | `trng_whole/verify/drc.json` (request: `drc.request.json`); informational predecessor `trng_whole/drc-informational.json` |
| `sampler_core` macro DRC on the current deck | **clean, 0 violations (regenerated, issue #181).** All nineteen `layout/*/cell.json` cells were rebuilt on klt `0.6.0+g5edb557f91d0` (klayout-tools#2778, the #2648 fix). On the same build and deck, the pre-#181 GDS (`sha256:a00f6550…`) gives 5664 `licon1.ongrid.1` + 198 `via.width.1`; the regenerated GDS (`sha256:e3ff54a9…`) gives 0. LVS is still 264/264 devices, 152/152 nets. See "Regeneration on the cut-size/grid fix (issue #181)" below | `sampler_core/drc.json`, `sampler_core/lvs.json` |
| `trng_digital` macro DRC on the current deck | clean, 0 violations (re-run 2026-10-07, host klt `0.6.0+g1eb3e4bfd0f5`, confirmatory, not committed) | `trng_digital/drc.json` |
| Block LVS (mixed transistor/cell-level) | **match, 0 error mismatches (issue #173)**: analog transistor level (264/264 devices), digital standard-cell level (8605 black-box instances), 2511/2511 nets, 123/123 anchored pins. Coverage matrix, boundary and limitations stated in `trng_whole/verify/README.md`; digital cell internals, substrate/`VNB` and device bodies are **not** checked | `trng_whole/verify/lvs.json`, `lvs.request.json`, `lvs.ref.spice`, `coverage.md` |
| Whole-block fault controls (swapped signal x3, disconnected interface, distinct-supply short) | **5/5 detected** (reach LVS, fail naming the nets); baseline re-run afterwards matches with identical stable fields | `trng_whole/verify/controls/` |
| Block post-layout PVT, dynamic power, IR, `vddr` coupling | **attempted in #174, UNMET**: 0/12 PVT points have a result (batch fleet refused, `batch_runner_version_mismatch`); IR is partial (assumed ring loads, met1-met5 only); no dynamic power | `sim/post-layout-whole-block/` (follow-ups #307, #308) |
| Area vs `< 0.05 mm2` | **Unmet**: 0.126116 mm2 (2.52x) | `trng_whole/report.json` `area` |

Reproduction of what exists (pins as in `trng_whole/README.md`; no SPICE):

```bash
python3 layout/test_compose_whole.py                                          # contract tests, no klt
python3 layout/bin/compose-whole.py layout/trng_whole/floorplan.json --check  # isolated rebuild + diff
python3 layout/bin/compose-whole.py layout/trng_whole/floorplan.json --informational-drc
python3 layout/test_verify_whole.py                                           # whole-block verification evidence contract, no klt
python layout/bin/verify-whole.py check   # (venv python) isolated DRC+extract+LVS re-run, diff vs committed (~8 min)
python layout/bin/verify-whole.py controls   # (venv python) five fault controls + baseline re-run (~45 min)
klt drc layout/trng_digital/trng_digital.gds --deck sky130 --format json      # digital macro re-check
klt drc layout/sampler_core/sampler_core.gds --deck sky130 --format json      # clean since #181
```

Graded in `docs/chipalooza/challenge-4-proposal.md` ("Sign-off scorecard").

## Regeneration on the cut-size/grid fix (issue #181)

**What was wrong.** On the current curated `sky130` deck, the committed
`sampler_core.gds` gave 5664 `licon1.ongrid.1` findings. The committed
`drc.json` still read clean only because it was graded on klt 0.4.0's
older deck. Older `klt gen`/`gen-compose` builds drew every contact and
via cut at a PDK-generic 0.22 um square: 2180 `licon1`, 717 `mcon` and
253 `via` cuts in `sampler_core`. 1416 of the `licon1` cuts (all in
`guard_ring` tap cells) were centred 2 nm off the 0.005 um grid, which
gives 4 off-grid edges each: 1416 × 4 = 5664. The current deck also
enforces `via.width.1`'s maximum half (via1 is a fixed 0.15 um square). It
reports the 0.22 um via cuts as a second finding (198 on `sampler_core`).
The issue text did not mention that one because it was not in the deck
build the reporter used.

**Tool.** All of the following come from klayout-tools source commit
`5edb557f91d0116368c386617802ec727b4bdc90`. That is klayout-tools#2778
(the #2648 fix), installed into a private venv:

- version `0.6.0+g5edb557f91d0`, `is_release: false`
- KLayout 0.30.12
- open_pdks `c6d73a35f524070e85faff4a6a9eef49553ebc2b`
- curated `sky130` deck `content_hash sha256:2bcbd625a0e36a4d1f9893b3c5d9b94963179c962b10ba01ffc4f378938c8197`
  (`licon1.ongrid.1` and `via.width.1` are both in `rules_checked`)

No tagged release contains the fix: `v0.6.0` is 490 commits behind it.
`layout/pdk.json`'s `klt_version_pin`/`ci_klt_install` and
`.github/workflows/pdk-nightly.yml` now all name this commit.

```bash
python3 -m venv .klt-venv
.klt-venv/bin/pip install \
  "klayout-tools @ git+https://github.com/2AMLogic/klayout-tools@5edb557f91d0116368c386617802ec727b4bdc90"
.klt-venv/bin/klt version --format json      # git_commit 5edb557f91d0...
```

**Before/after, same build and deck.** The "before" column is the untouched
pre-#181 GDS from git. The "after" column is the committed regenerated GDS.
The LVS column is the regenerated cell's `lvs.json`. Every count equals its
pre-#181 value.

| Cell | Before (pre-#181 GDS) | After | LVS (unchanged) |
|---|---|---|---|
| `ro_buf` | 64 `licon1.ongrid.1` | 0 | 2/2 devices, 4/4 nets |
| `ro_stage` | 64 `licon1.ongrid.1` | 0 | 4/4 devices, 6/6 nets |
| `ro_stage_wstv0p44` | 64 `licon1.ongrid.1` | 0 | 4/4 devices, 6/6 nets |
| `ro_stage_wstv0p46` | 64 `licon1.ongrid.1` | 0 | 4/4 devices, 6/6 nets |
| `ro_stage_wstv0p48` | 64 `licon1.ongrid.1` | 0 | 4/4 devices, 6/6 nets |
| `ro_nand2` | 64 `licon1.ongrid.1` | 0 | 6/6 devices, 8/8 nets |
| `ro_nand2_wstv0p44` | 64 `licon1.ongrid.1` | 0 | 6/6 devices, 8/8 nets |
| `ro_nand2_wstv0p46` | 64 `licon1.ongrid.1` | 0 | 6/6 devices, 8/8 nets |
| `ro_nand2_wstv0p48` | 64 `licon1.ongrid.1` | 0 | 6/6 devices, 8/8 nets |
| `sampler_nand2` | 64 `licon1.ongrid.1` | 0 | 4/4 devices, 6/6 nets |
| `sampler_tg` | 64 `licon1.ongrid.1` | 0 | 2/2 devices, 6/6 nets |
| `ro_ring5` | 320 `licon1.ongrid.1`, 10 `via.width.1` | 0 | 22/22 devices, 19/19 nets |
| `ro_ring5_wstv0p44` | 320 `licon1.ongrid.1`, 10 `via.width.1` | 0 | 22/22 devices, 19/19 nets |
| `ro_ring5_wstv0p46` | 320 `licon1.ongrid.1`, 10 `via.width.1` | 0 | 22/22 devices, 19/19 nets |
| `ro_ring5_wstv0p48` | 320 `licon1.ongrid.1`, 10 `via.width.1` | 0 | 22/22 devices, 19/19 nets |
| `xor2` | 224 `licon1.ongrid.1` | 0 | 12/12 devices, 10/10 nets |
| `ro_array_core` | 2208 `licon1.ongrid.1`, 53 `via.width.1` | 0 | 132/132 devices, 96/96 nets |
| `sampler_dff` | 576 `licon1.ongrid.1`, 21 `via.width.1` | 0 | 22/22 devices, 14/14 nets |
| `sampler_core` | 5664 `licon1.ongrid.1`, 198 `via.width.1` | 0 | 264/264 devices, 152/152 nets |

No rule was waived, downgraded or deck-pinned around to reach these results.

**What changed in the geometry: only the cuts.** A per-layer XOR of the
old and new `sampler_core.gds` finds differences on `licon1` (66/44),
`mcon` (67/44) and `via` (68/44) only. Every other drawn layer is
identical. Cut counts are unchanged (2180/717/253). Cut sizes are now
sky130's fixed values: 0.17 um `licon1`/`mcon`, 0.15 um `via`. All
`mcon`/`via` centres are unchanged. The 1416 off-grid `licon1` centres
moved by at most 2 nm onto the grid. None of the 19 recipes'
`compose.response.json` stages changed `bbox_um`, and no recipe,
schematic, device parameter or routing was edited. The extracted
`*.spice` diffs are only anonymous internal net-number reordering. The
sampler_core and ro_array_core measurement scripts reproduce their
committed outputs byte for byte against the regenerated streams:
`vdd-strap-scan.py`, `vss-strap-scan.py`, `data-path-scan.py`,
`vss-tap-scan.py` and `lvs-negative-controls.py`.

**Order.** The cells were regenerated bottom-up, with each parent built
only after its `blocks[].cell.gds_path` children were rebuilt:

1. `ro_buf`, the four `ro_stage*`, the four `ro_nand2*`, `sampler_nand2`
   and `sampler_tg`
2. the four `ro_ring5*` and `xor2`
3. `ro_array_core` and `sampler_dff`
4. `sampler_core`

Each was then `--check`ed. The rebuild is deterministic: a second
`sampler_core` build reproduces `sha256:e3ff54a9…` byte for byte.

**Downstream evidence:**

- `sampler_core/erc.json`: re-run (not just re-pinned) on the tagged
  `klayout-tools==0.6.0` the README's recipe names. The result is still
  `clean` with 0 findings and the same 73 gates. Only the gate list order
  and the input hash differ.
- `trng_whole/`: recomposed and `--check`ed. Routing, area, canonical
  counts and connectivity audit are unchanged. Its informational DRC is
  now 0 violations.
- `signoff/`: block-manifest pins moved to the new hashes and the report
  was re-rendered on the 0.6.0 grader. Every row verdict is unchanged
  (2/22 met).
- `layout/pex*/` and `sim/post-layout-*`: **not refreshed**. Each pex
  README's "Superseded by the issue #181 regeneration" note lists exactly
  what they cite. Re-extraction is tracked in #184.

## klayout-tools 0.8.0 drift classification (issue #364)

Investigation only: no evidence under `layout/` was regenerated and the
nightly pin (`pdk-nightly.yml`, `layout/pdk.json` `klt_version_pin` /
`ci_klt_install`, `REPRODUCE.md`) is **deliberately unchanged**. Evidence stays
append-only; re-baselining it is a separate, bottom-up piece of work (below).

**Method.** Throwaway venvs outside any host tool (`uv venv` +
`uv pip install "klayout-tools==0.8.0"`, KLayout 0.30.12), one cell at a time,
`PYTHON -- layout/bin/compose-cell.py layout/<cell>/cell.json --check`, with
`PDK_ROOT=~/.volare` so the PDK is the pinned open_pdks
`c6d73a35f524070e85faff4a6a9eef49553ebc2b`. Controls under the same PDK: the
current pin (`5edb557f91d0`) and `klayout-tools==0.7.0` both report
"rebuild matches committed evidence" for `ro_stage`, `ro_nand2`, `ro_ring5`,
`xor2` and `ro_buf`. So the drift enters between 0.7.0 and 0.8.0.

**PDK confound (not the cause).** With `PDK_ROOT` unset, 0.8.0 searches
`~/.ciel` before `~/.volare`; on a host whose `~/.ciel` holds a newer
open_pdks it silently builds against that PDK (the generator JSON records it
only as `provenance.pdk.ambiguous_sources`; `klt pdk find --format text` also
omits it, klayout-tools#4428). Set `PDK_ROOT` explicitly when
reproducing. The drift below is identical with the PDK pinned.

**Deck rule diff recipe.** No built-in cross-version diff is needed: `klt deck
rules --deck sky130 --format json` lists every rule id (unique, but not
sorted), so for each pin run
`uvx --from "klayout-tools==X.Y.Z" klt deck rules --deck sky130 --format json`,
extract the sorted `rules[].id`, and `diff` the two lists. 0.7.0 (136 rules)
vs 0.8.0 (150 rules) adds 14, including `poly.endcap.diff.1`, `nsdm.space.1`
and `nsdm.width.1`, and removes none.

### Per-cell result (klt 0.8.0, pinned PDK)

All nineteen cells with a `cell.json` drift; none reproduces. Classes:
A = new curated-deck rules fire on the committed (old-generator) GDS,
B = generator geometry growth (bbox shift), C = explicit placement/waypoints
no longer fit the grown blocks (unrouted nets or `nsdm.space.1`).

| cell | stage reached | drift |
|---|---|---|
| `ro_buf` | compose | B (bbox x0 -0.075, y0 -0.125, y1 +0.05 um) |
| `sampler_tg` | compose | B (bbox x0 -0.05, y0 -0.125, x1 +0.05, y1 +0.05 um) |
| `ro_stage`, `ro_stage_wstv0p44/46/48` | drc | B + C (1 DRC violation, `nsdm.space.1`) |
| `ro_ring5`, `ro_ring5_wstv0p44/46/48` | drc | A + C (`violation_count` 42 each; rules `nsdm.space.1`, `poly.endcap.diff.1`) |
| `ro_array_core` | drc | A + C (`violation_count` 212; rules `nsdm.space.1`, `poly.endcap.diff.1`) |
| `sampler_core` | drc | A + C (`violation_count` 344; rules `nsdm.space.1`, `poly.endcap.diff.1`) |
| `sampler_dff` | drc | A (`violation_count` 22; rule `poly.endcap.diff.1` only) |
| `ro_nand2`, `ro_nand2_wstv0p44/46/48` | gen-compose | C (`nets left unrouted: en, a`) |
| `sampler_nand2` | gen-compose | C (`nets left unrouted: en, a`) |
| `xor2` | gen-compose | C (`nets left unrouted: y`) |

Not checked (no `cell.json`): `primitives/`, `trng_digital/`, `trng_whole/`,
`pex*/`, and the `*-poc` directories.

### Classification: intended behaviour change, no regression found

- **A. Deck gained `poly.endcap.diff.1`.** `klt drc --deck sky130` on the
  *committed, untouched* `ro_stage.gds`, `ro_buf.gds` and `sampler_dff.gds`
  is `clean` under the pin (the rule is absent from `rules_checked`) and
  reports 8, 2 and 22 `poly.endcap.diff.1` violations under 0.8.0. The
  committed GDS genuinely has a short poly endcap past diff at the gate; the
  pinned deck simply did not check it. This is a deck coverage increase.
- **B. `mos_array` draws more.** Per-primitive diff for `ro_stage/gen/mn`:
  poly now extends 0.15 um past diff at both ends (was flush with the
  0.42 um diff pad), an nsdm shape (93/44) with 0.125 um margin and an npc
  shape (95/20) are drawn, and the generator note "family 'sky130' declares
  no S/D implant role" is gone (`sd_implant_present` false -> true). That
  explains the bbox growth and the gate pad moving up 0.15 um, and fixes
  the endcap shortfall in A for freshly generated cells.
- **C. Hand-tuned floorplans no longer fit.** `ro_nand2`, `sampler_nand2`
  and `xor2` use `placement.strategy: explicit` with hard-coded origins and
  waypoints tuned to the old block outlines. Control: feeding the committed
  (old-geometry) `ro_nand2/core.compose.request.json` to the 0.8.0
  `klt gen-compose` gives a response with no `unrouted_nets`, matching the
  pinned build's output, so the router itself did not regress. The failure
  appears only once the blocks grow. Likewise `nsdm.space.1` appears where
  two grown blocks' new implants land closer than the nsdm space rule at the
  old origins. `poly.endcap.diff.1` in `ro_ring5`/`ro_array_core`/
  `sampler_core` comes from placing the *committed* `ro_stage`/
  `sampler_*` GDS (class A), not from new composition.

No klayout-tools issue was filed: nothing observed is a tool defect. The
two usability notes (silent `~/.ciel`-before-`~/.volare` PDK preference, and
no machine-readable diff of deck rule sets between releases) were not
judged to be defects.

### What moving the pin requires (deferred)

Regenerate bottom-up under 0.8.0 with `PDK_ROOT` pinned: primitives, then
`ro_buf`/`ro_stage*`/`sampler_tg`, re-floorplan `ro_nand2*`/`sampler_nand2`/
`xor2` (new origins/waypoints so `en`/`a`/`y` route and `nsdm.space.1` is
clean), then `ro_ring5*`, `ro_array_core`, `sampler_core`/`sampler_dff`,
then `trng_digital`/`trng_whole` and the pex libraries, each DRC- and
LVS-clean with 0.8.0 provenance, and only then move the three pins together.
Tracked in #366.

### Re-floorplan of the class C `*_nand2` cells under 0.8.0 (issue #370)

Regenerated under `klayout-tools==0.8.0` (throwaway venv, `PDK_ROOT=~/.volare`):
`ro_nand2`, `ro_nand2_wstv0p44/46/48` and `sampler_nand2`. Each now passes
`compose-cell.py --check` with every net routed, DRC clean (including
`poly.endcap.diff.1` and `nsdm.space.1`), and LVS matching with the device and
net counts unchanged (6/6 devices, 8/8 nets; `sampler_nand2` 4/4, 6/6).

The 0.8.0 blocks grew (poly endcap +0.15 um, so the gate pad moved up 0.15 um
and the bbox gained 0.125 um of nsdm margin in x), eating the clearances the
old explicit origins relied on. The same delta was applied to all five cells
(same topology): the PMOS row (`mph`/`mpa`/`mpb`, `nwell_tap`) moved up 0.45 um;
`mnab` moved right 0.25 um; `psub_tap` left 0.10 um (`ro_nand2*` only). The
final-stage waypoints moved with their pins (py/vss/vddr lanes +0.45 um in y;
the `y` jog to `mnab_y` now ends at x=5.04). Netlists, spec and waivers are
untouched.

`xor2` needs the same kind of fix: its `y` net threaded a 0.125 um gap above
`mn34` (`li1.space.1`); raising the `y` lanes from y=4.6 to y=4.8 um routes
it. Its evidence is **not** regenerated here: it embeds the committed pre-0.8.0
`ro_buf.gds` twice (`inv_a`/`inv_b`), which still carries the four
`poly.endcap.diff.1` violations. Re-run `compose-cell.py layout/xor2/cell.json`
after the `ro_buf` leaf regeneration (#369) lands.
