2AMLogic/sky130-trng/sim/post-layout-whole-block/README.md

# post-layout-whole-block -- whole-block characterization (issue #174)

Append-only slug for the composed `layout/trng_whole/trng_whole.gds`
(sha256 `af2f8dfe2800599e97d769bdedd14924c9fa3f24fc7e1c4f43ccd72ac5572ddd`,
top `trng_whole`, 123 ports). Part of #170; contributes to #18 AC3.
Provisional, simulation-derived, not foundry sign-off, **not silicon**.

**Status of this slug: the 12-point transistor-level matrix is UNMET and
#18 AC3 is NOT claimed.** The dated record under `records/` states, per point,
why. In one line: the klt batch fleet refuses every submission from this repo's
klt (`batch_runner_version_mismatch`, runner image klt 0.5.0 vs client 0.7.0,
klayout-tools#2948/#2851), the fleet's shared concurrency cap was also full
for most attempts (klayout-tools#2917), and the one local single-corner probe
that the host rules allow did not finish. Nothing in this slug was computed by
a hand-launched ngspice grid.

How the whole-block work is to be reduced (analog at transistor level, digital at gate level; digital-current, IR and `Ts` rows stay UNMET): `spec/decision-records/DR-0017-whole-block-reduced-work-pvt.md` (Accepted 2026-11-05, #404).

## What is in the slug

| Path | What |
|---|---|
| `make-netlist.py` | `klt extract --deck sky130 --pdk sky130A` over the committed GDS, then recorded text transforms (port canonicalisation of header AND device body, `$` scrubbing, bracket de-indexing; #435). **Connectivity netlist: devices and nets of the layout, no extracted parasitics (no R/C).** The port map follows `-o` (`OUT.spice` -> `OUT.ports.json`, #478), so only a default-output run writes the committed map. `--check` is a byte compare and reproduces only under the klt build that produced the committed netlist, `0.9.1.dev102+gef1ec19c95f6` (see the next row); on any other build it reports the port-order difference and names both builds. |
| `trng_whole.sim.spice.gz`, `trng_whole.sim.ports.json` | its output (plain-text sha256 `965f1e6c29d771d5b8e18a3ea66ccabf93f0a5eb14c3f0c23810f39ae1052c36`, 25 355 X-instances of `sky130_fd_pr__{nfet,pfet,special_nfet}_01v8` + 1 `sky130_fd_pr__diode_pw2nd_05v5` X-instance, 123 ports) and the port-order map. The plain 15 MB copy is gitignored; `make-requests.py` reads the gz. **Produced by klt `0.9.1.dev102+gef1ec19c95f6`**; the top-level `.SUBCKT` port order is a klt-build artefact (klayout-tools#5534), so `--check` reproduces these bytes only under that build: `uvx --from "klayout-tools @ git+https://github.com/2AMLogic/klayout-tools@ef1ec19c95f6" python3 sim/post-layout-whole-block/make-netlist.py --check` -> `check OK: byte-identical, 123 ports, 25356 devices`. Record: `records/20261113-ports-order-klt-build.md` (#478). |
| `test_make_netlist.py` | the klt-free unit tests, run on every pull request (`.github/workflows/ci.yml`): the `$`-scrub collision guard, the pw2nd diode card rewrite, the all-card-type model check, the #435 body rename, and (#478) that the port map follows `-o` and that the committed header order still equals the committed `ports.json` order. No klt, no PDK, no GDS, no ngspice. |
| `check-bin-coverage.py` | scans every device card of a flat netlist against the pinned PDK's model bins (control: pre-fix netlist reports 1760 uncovered, committed reports 0). Record: `records/20261029-bin-coverage-scan.md` (issue #386). |
| `records/20261030-fleet-probe-post-bin-fix.md` | one-unit fleet probe after the bin fix: ngspice gets past parse, then times out at 3480 s in analysis (issue #386, `runs/20261030-probe-post-bin-fix/`). |
| `program.py` | the one directed bus program (75 cycles, `Ts = 100 ns`, `T0 = 320 ns`): ID / HT_STARTUP / STATUS reads with `EN=0`, `CTRL.EN` write, 32 raw samples, `STATUS`/`RAW_DATA`/`ID`/`DATA`/`ALARM`/`STATUS` reads, 32 samples with `out_ready=1`, final `STATUS`; plus `model_replay()` which replays it through the normative model `digital/model/`. |
| `make-requests.py` | emits the `klt sim` requests: `--set controls` (startup probe, local + batch) and `--set grid` (four requests, one per (T, Vdd) point, each bundling `tt`/`ss`/`ff` = the 12-point matrix, `backend: batch`, `save_mode: netlist`, 610 measurements each). |
| `corners/<req>/` | request, plan (input hashes), report, stderr and `submit-attempts.log` for every submission, **including the failed ones** (they are the evidence). `netlist.cir` per request is gitignored (regenerated; sha256 in `plan.json` and the report). |
| `ir/run-ir.py`, `ir/*.json*` | `klt power` extraction + static IR (see below). |
| `analysis/reduce-whole-block.py` | the reduction: enumerates the 12 points itself, marks a point MET only on a clean corner + oracle match, everything else UNMET with a reason; mints the record. Tested by `sim/tests/test_whole_block_reduction.py` (complete matrix MET; an omitted point, oracle mismatch, absent measurement, errored corner and klt error envelope are each UNMET). |

## The four PVT points

Resolved from the decision records, not the planning document: DR-0010
row 9 ratifies the envelope as 1.62 / 1.8 / 1.98 V (1.8 V +/-10 %) and
-40 / 27 / 125 C, and DR-0003 section 5 / DR-0008 fix the four (T, Vdd)
points every post-layout campaign in this repo uses:
(-40 C, 1.62 V), (27 C, 1.80 V), (-40 C, 1.98 V), (125 C, 1.98 V), each x
`tt`/`ss`/`ff` = 12 points. All five supplies (`vdd`, `vddr1`-`vddr4`) move
together with the point. Digital input high level is fixed at 1.8 V at every
corner (VIH(1.62 V) = 1.05 V accepts it); the supply sources carry the corner.

## Assumptions (declared, per the issue)

* Clock `clk` period `Ts = 100 ns`, **not DR-0003's 20 us** -- the same
  compute-budget deviation every post-layout sampler deck here states. The
  digital section is synchronous, so the program's cycle behaviour is
  independent of `Ts`; the analog sampling aperture is not, so raw-bit
  statistics from these decks are not entropy evidence at the ratified `Ts`.
* Reset: `rst_n` low until 300 ns; `clk` starts at 320 ns. Rings enabled at 5 ns.
* Loading: only the testbench's PWL/PULSE sources drive inputs; outputs are
  unloaded (no pad/off-chip capacitance model exists in the repo).
* Raw-tap boundary: the real post-layout sampler's `raw_bit`/`raw_valid`
  (internal to `trng_whole`) are measured at `Tedge(k)+80 ns` and fed to the
  normative model as the oracle's raw-tap stimulus.
* Throughput tap: `t_out_valid_first`, the first rise of `out_valid` (word
  availability after 32 raw samples at `Ts`). The start-up gate keeps
  `gated=1` for the 1024-sample window, which the budget cannot reach, so the
  conditioned `DATA` path is exercised only as a blocked read.
* Digital library/corner mapping: the digital cells are the extracted
  sky130_fd_sc_hd transistors, simulated with the same `.lib sky130.lib.spice`
  `tt`/`ss`/`ff` process corner as the analog devices (not Liberty STA).
* Power windows: W1 = rings running, digital reset-held, `clk` not started;
  W2 = every program cycle. Sign: `i(Vsrc)` is negative when the source
  delivers; the reducer negates. "Dynamic" digital power is
  `(I_vdd[W2] - I_vdd[W1]) * Vdd` for this program's activity only; leakage and
  dynamic are not otherwise separable in a transient.

## Static IR (`klt power`), what exists

`ir/run-ir.py` runs `klt power` on the committed GDS (top `trng_whole`) with:
met1-met5 sheet resistances and via/via2/via3/via4 resistances read from
the sky130A magic tech file in the PDK install (met1-met5: 0.125 / 0.125 / 0.047 / 0.047 /
0.029 ohm/sq; vias 4.5 / 3.41 / 3.41 / 0.38 ohm), pads at the 16 boundary-pad
coordinates of `layout/trng_whole/interface.json`, and **only the four
ring-supply loads**, each 20.55 uA at its ring island's node centroid (DR-0003's
per-ring running-current *maximum*, ff / -40 C / 1.98 V; ring ground returns on
`vss`). Results (`ir/summary.json`): worst droop **8.05 mV on `vss`**
(`(308.7, 295.0)` um, met1; 82.2 uA total ring return through ~98 ohm of
`vss` grid) and 0.30-0.36 mV on `vddr1`-`vddr4`.

This is a **partial, assumption-loaded** result, not whole-block IR:

* `li1` and `mcon` are omitted from the stackup: with `li1` declared, `klt power`
  cannot decompose the whole-block `li1` polygons (4096-mesh-cell cap,
  klayout-tools#3124) and every island is unsolved. The result is a met1-met5
  grid only.
* The logic supply `vdd`/`vss` carries **no digital load**: the transistor-level
  run that would supply digital and sampler currents did not complete, so the
  digital IR is not evaluated. `vdd` has one pad-connected island solved
  (zero load, zero droop by construction) and 12 islands with no pad path
  (`unsolved_reason: no_pad`), listed in `summary.json`.
* EM: no per-role current limits were declared, so `em_verdict` is
  `not_checked`.

## Reproduce (representative, isolated output)

```bash
python3 sim/post-layout-whole-block/test_make_netlist.py # generator + committed-pair contract, no klt
python3 sim/tests/test_whole_block_reduction.py          # reducer contract, no simulator
python3 sim/post-layout-whole-block/make-requests.py /tmp/wb --set controls   # needs the gz netlist only
python3 sim/post-layout-whole-block/ir/run-ir.py /tmp/wb-ir                    # ~10 s; summary.json must equal committed
```

`klt sim` needs **absolute** `-o`/request paths (relative `-o` makes ngspice
never start; klayout-tools#2892/#2939).

## DR-0017 option (b): provenance, partition, and what is still open (issue #431 Step 2)

Level of any result produced under option (b), worded verbatim wherever it is
reported: **mixed-level (analog transistor / digital gate-level),
connectivity-only extract (no R/C)**. `program.PROVENANCE` carries it; every
`plan.json` records it and the reducer writes it at matrix and point level.
`i_vdd_*`, `i_vss_w2` and `digital_delta_i_a` are `mixed`;
`digital_dynamic_power_w_estimate` is `gate-level`. The reducer's `obligations`
section lists O1-O8; **O5d, O7, O8 are forced UNMET** and `ac3_claimable` is
`false` (#18 AC3 stays UNMET). A reduction with no recorded provenance marks
every point and every row UNMET.

Partition: `make-requests.py` splits the flat `trng_whole.sim.spice.gz` extract
at composed y = 250 um (analog macro above, digital macro below; empty band
240-260 um) and `partition_check()` asserts, before any `plan.json` is written:
25 356 instances = 264 analog transistors + 25 091 digital transistors + the
antenna diode; the flat `.SUBCKT` ports equal `trng_whole.sim.ports.json`
(123); the nets both halves touch are exactly `clk`, `rst_n`, `raw_bit`,
`raw_valid` (+ `vdd`/`vss`). `plan.json` records `flat_whole_netlist_sha256`,
`analog_partition_sha256` and `digital_gate_netlist_sha256` (the routed
gate-level `layout/trng_digital/trng_digital.routed.v`). The check is a
transistor-count and net-name correspondence, not an LVS of the gate-level
netlist against the transistor-level digital macro.

**Open (not done by this change, so nothing here is claimed for it):**

* Gate-level digital co-simulation behind the boundary and its realisation in
  ngspice, with a **measured** fleet run and simulated time reached.
* Hence `GRID_TIMEOUT_S` / `poll_timeout_s` are **not** re-set; the 0.057 s per
  simulated ns analog-only rate does not size the full block. If the measured
  full-block rate exceeds the 3480 s ceiling, that is recorded as a negative
  result for option (b).
* Full-block 100 ns rate probe on the re-pinned netlist (`965f1e6c...`): one batch job was
  interrupted by spot reclamation at 3279 s, no verdict; re-run needed. See
  `records/20261106-rate-probe-repinned-netlist.md`.
* Retry of that probe (issue #449): timed out at 3480 s on the same re-pinned netlist, 0 of 9
  measurements; infeasible verdict confirmed. See `records/20261106b-rate-probe-repinned-timeout.md`.
* Boundary-load model (DR-0017 option 1 or 2) and the Liberty deck per (T, Vdd)
  point: not chosen yet; to be stated with their source when the co-simulation
  is built.
