2AMLogic/sky130-trng/layout/pex-ring/README.md

# layout/pex-ring

> **Re-extracted for issue #184 (2026-10-07) on the issue #181 geometry.**
> `pex.json` is regenerated on the klt build pinned in `layout/pdk.json`
> (`0.6.0+g5edb557f91d0`, KLayout 0.30.12, open_pdks `c6d73a35f524...`; a throwaway
> venv, not the host `klt`) and `python3 layout/bin/pex-netlist.py <descriptor> --check`
> passes against the committed post-#181 GDS. Provenance in `reports/*.json` now cites the
> post-#181 GDS hashes in the table below (old hash -> new hash).
>
> **What changed, and what did not.** Device count, net count, R/C element counts, total
> ground C and total coupling C are **bit-identical** old vs new for every report. Only total
> series R changed. Controlled comparison (`old` = committed pre-#181 output, klt build per the hash table below;
> `geometry control` = the **pinned** klt re-run on the **pre-#181 GDS**
> from commit `3588d77^`; `new` = pinned klt on the post-#181 GDS):
> **geometry contribution = geometry-control minus new = 0.0000 ohm in every report** (the sorted
> multiset of R/C/device-card values in each library is also identical between those two; only
> auto-numbered internal node names and report hashes differ), and the **entire** R delta
> (old to geometry-control) is the **extractor/deck version**. The reverse control (historical
> extractor on the new GDS) was not run: the old build is not reproducible here and is not
> needed, since the geometry-control already isolates the extractor on fixed geometry. The old
> and new tool runs also differ in the curated sky130 deck content hash, so "extractor version"
> means extractor plus deck together; those two are unseparated.
>
> Re-measured: `sim/post-layout-ro-ring5-assembled-181/` (4 PVT points x tt/ss/ff, `klt sim` batch fleet). Every ring period, swing fraction and supply current moved by <= 0.36 % against the pre-#181 records, and the verdict is unchanged (PASS everywhere). The pre-#181 records stay valid for the old geometry and are not modified.
>
> Consumers: `sim/post-layout-ro-ring5-assembled/` (4 records). The remainder of this README (body text and figures) was written against the
> pre-#181 output and is kept as history; the table below supersedes any R figure quoted later in it.
>
> | Report | devices / nets | elements | R old (ohm) | R geometry-control | R new | C total (fF, old = new) | Cc total (fF, old = new) |
> |---|---|---|---|---|---|---|---|
> | `ro_buf_pex` | 2 / 4 | 8 R / 4 C / 0 Cc | 1261.24 | 1122.57 | 1122.57 | 2.4937 | 0.0000 |
> | `ro_ring5_assembled_pex_wstv0p42` | 22 / 19 | 88 R / 19 C / 11 Cc | 10310.58 | 7700.45 | 7700.45 | 42.2459 | 0.0709 |
> | `ro_ring5_assembled_pex_wstv0p44` | 22 / 19 | 88 R / 19 C / 11 Cc | 10319.42 | 7709.60 | 7709.60 | 42.2758 | 0.0715 |
> | `ro_ring5_assembled_pex_wstv0p46` | 22 / 19 | 88 R / 19 C / 11 Cc | 10328.37 | 7718.85 | 7718.85 | 42.3057 | 0.0721 |
> | `ro_ring5_assembled_pex_wstv0p48` | 22 / 19 | 88 R / 19 C / 11 Cc | 10337.43 | 7728.21 | 7728.21 | 42.3356 | 0.0727 |
>
> Source GDS hashes (pre-#181 -> post-#181):
>
> | Report | Source GDS | Hash this library was extracted from | Committed GDS hash since #181 |
> |---|---|---|---|
> | `reports/ro_buf_pex.extract.json` | `layout/ro_buf/ro_buf.gds` | `sha256:3df80e13d497a7e2…` (klt 0.3.0) | `sha256:f058d84d15d307fb…` |
> | `reports/ro_ring5_assembled_pex_wstv0p42.extract.json` | `layout/ro_ring5/ro_ring5.gds` | `sha256:002de654bb9691cd…` (klt 0.3.0) | `sha256:62cef8ce030aad12…` |
> | `reports/ro_ring5_assembled_pex_wstv0p44.extract.json` | `layout/ro_ring5_wstv0p44/ro_ring5_wstv0p44.gds` | `sha256:b0c13c8fda447a9e…` (klt 0.3.0) | `sha256:88118656cefd4170…` |
> | `reports/ro_ring5_assembled_pex_wstv0p46.extract.json` | `layout/ro_ring5_wstv0p46/ro_ring5_wstv0p46.gds` | `sha256:93f31a2647fe7c47…` (klt 0.3.0) | `sha256:4797c72c9db1dd3c…` |
> | `reports/ro_ring5_assembled_pex_wstv0p48.extract.json` | `layout/ro_ring5_wstv0p48/ro_ring5_wstv0p48.gds` | `sha256:4ff687c4f3228fb8…` (klt 0.3.0) | `sha256:0ac8aaea8cce5c82…` |

The post-layout (parasitic-annotated) netlist library for the **assembled**
`ro_ring5` cells -- the ring-level sibling of `layout/pex/` (which extracts
the nine *leaf* gates and relies on the testbench to wire them with ideal
inter-cell nets).

`ro_ring5_assembled_pex.spice` is a **generated** file:
`layout/bin/pex-netlist.py` -- the same, unmodified script `layout/pex/`
uses -- runs `klt extract --pdk sky130A --parasitics` directly over each
composed ring's own committed GDS (`layout/ro_ring5*/ro_ring5*.gds`), the
whole five-gate hierarchy flattened in one extraction rather than five
separate leaf-cell extractions. Because that GDS is the same DRC-clean and
LVS-clean stream issue #22/#27 landed in PR #51 (`layout/ro_ring5/`,
`_wstv0p44`, `_wstv0p46`, `_wstv0p48`), the resulting parasitic model
includes the ring's own **real inter-gate metal routing** -- the `n1`-`n4`
signal chain, the `ro` feedback, and the `vddr`/`vss` rail busing -- which
`layout/pex/ro_ring5_pex.spice` cannot, by construction: that library only
ever sees one gate's own geometry at a time.

```bash
volare enable --pdk sky130 c6d73a35f524070e85faff4a6a9eef49553ebc2b
python3 layout/bin/pex-netlist.py layout/pex-ring/pex.json --check   # verify
python3 layout/bin/pex-netlist.py layout/pex-ring/pex.json           # regenerate
```

`--check` re-extracts every ring from its committed GDS into a temporary
directory and fails on any byte-for-byte or verdict-field drift -- the same
contract `layout/pex/pex.json` and `layout/bin/compose-cell.py --check`
offer. `layout/test_pex_netlist.py` (shared, unmodified) is the other half
of the guard for the rewrite logic itself.

### What `--check` should print, and when (issue #96)

**On a checkout whose `klt` matches `layout/pdk.json`'s `klt_version_pin`
(`0.3.0+gc6dbf66c53c6`), this descriptor exits 0.** Verified 2026-09-07 on
that exact build, installed via the venv recipe in `layout/README.md` §
"Correcting the curation note":

| Command | Expected on the pinned `klt` |
|---|---|
| `python3 layout/bin/pex-netlist.py layout/pex-ring/pex.json --check` | exit 0, `rebuild matches committed evidence` |

It did **not** until issue #96 re-extracted all five cells here on the pin:
the committed evidence had been produced by `klt 0.4.0`, exactly the
provenance gap issue #93 closed for `layout/pex/`. See "Re-extracted on the
pin, and what that did and did not move" below for the measurement, and
`layout/pex/README.md` § "When `--check` is red because the tool moved" for
what a red `--check` on some *other* `klt` build is telling you.

**`layout/pex-array/pex.json` is deliberately still red on the pin**, and
for a different reason -- not a relabel. That is a recorded finding, not an
oversight: see `layout/pex-array/README.md` § "What `--check` should print,
and when".

## Why a separate library, not a rewrite of `layout/pex/ro_ring5_pex.spice`

The two measure different things on purpose, and
`sim/post-layout-ro-ring5/`'s existing records were minted against
`layout/pex/ro_ring5_pex.spice` specifically -- swapping the netlist under
them would silently change what twelve already-committed records mean.
`layout/pex-ring/` is new, additive evidence (`sim/post-layout-ro-ring5-assembled/`
below), not a replacement.

## What is in here

| Path | What it is |
|---|---|
| `pex.json` | the descriptor: which ring GDS files, the design port order (`en ro vddr vss`, from `design/ro_array_core.spice`'s own `.subckt ro_ring5`), and the extractor-joined-net renames |
| `ro_ring5_assembled_pex.spice` | **generated** -- the library `sim/post-layout-ro-ring5-assembled/`'s testbench includes |
| `raw/<cell>.pex.spice` | `klt extract`'s own output, unmodified |
| `reports/<cell>.extract.json` | that run's full JSON response |

| Cell | Devices | Nets | Total series R | Total C to substrate | Net-to-net coupling C |
|---|---|---|---|---|---|
| `ro_ring5_assembled_pex_wstv0p42` | 22 | 19 | 10310.58 Ω | 42.246 fF | -- |
| `ro_ring5_assembled_pex_wstv0p44` | 22 | 19 | 10319.42 Ω | 42.276 fF | -- |
| `ro_ring5_assembled_pex_wstv0p46` | 22 | 19 | 10328.37 Ω | 42.306 fF | -- |
| `ro_ring5_assembled_pex_wstv0p48` | 22 | 19 | 10337.43 Ω | 42.336 fF | -- |
| `ro_buf_pex` | 2 | 4 | 1261.24 Ω | 2.494 fF | -- |

(`ro_buf_pex` is duplicated verbatim from `layout/pex/pex.json`'s own entry,
same GDS, so this library is self-contained for a testbench that includes
only `@@PEX_LIB@@` plus `design/ro_array_core.spice` -- avoiding a
same-subcircuit-name collision from including both pex libraries in one
deck.) Device/net counts match `layout/ro_ring5*/extract.json` exactly, as
expected: `--parasitics` adds R/C elements, it does not re-recognize
devices. 22 = `ro_nand2`'s 6 + 4x`ro_stage`'s 4, matching `layout/ro_ring5/README.md`.

Produced by `klt 0.3.0+gc6dbf66c53c6` / KLayout 0.30.12 (each report's own
`provenance.klt_version` is the authoritative per-file record) -- which is
`layout/pdk.json`'s `klt_version_pin`, i.e. the same build that produced
the composed-cell evidence under `layout/ro_ring5*/`. **These five cells
were re-extracted on the pin by issue #96**; every number in the table
above is unchanged from the `klt 0.4.0` extraction that first produced
them, to every digit shown.

## Re-extracted on the pin, and what that did and did not move (issue #96)

The library and reports here were regenerated on `klt
0.3.0+gc6dbf66c53c6` so that `--check` agrees with `layout/pdk.json`'s
pin. The committed-vs-rebuilt diff is **278 lines and entirely the
extractor's own node-label bookkeeping**, in exactly the two classes
klayout-tools#1063 / #1072 declined to make a contract:

| What moved | Where | Class |
|---|---|---|
| one anonymous net, `n4` -> `n5` (in `ro_ring5_assembled_pex_wstv0p42` only) | node token, the extractor's `R_4_*`/`C_4` element names, its `* device instance _4_*` comments, and the report's `net`/`hub_net`/`net_id` | the `\$N` counter |
| the per-terminal *leg* node suffix (`vddr__t9` <-> `vddr__t12`, `vss__t2` <-> `vss__t5`, …) and the series-R value that travels with each leg | device cards, `R*` cards, the reports' `terminals[].leg_net` | the `__tK` counter |
| `net_id` on most nets | reports only | the same counter |

Nothing else. Three independent checks agree, each stricter than the last:

1. **Reduced circuit description.** For every `.subckt`: identical port
   list; identical multiset of device cards described as (model, every
   geometry parameter, and per terminal the *hub net* it lands on plus the
   *series-R value* it lands through); identical multiset of `(hub, hub,
   value)` capacitances and `(hub, value)` resistances; identical hub-net
   name sets modulo the single `n4`->`n5` rename. Folding a leg into
   `(hub, R)` is what makes the `__tK` counter invisible while still
   catching a device that moves to a different net or through a different
   resistance.
2. **Colour refinement (Weisfeiler-Lehman) on the label-free hub graph** --
   no node names at all, so a relabeling cannot hide a topology change.
   Equivalent for all five cells. (The checker was itself validated
   against a control: a random relabeling of 538 internal nodes of a
   committed library must, and does, come back equivalent.)
3. **ngspice A/B.** `sim/post-layout-ro-ring5-assembled/`'s own deck
   rendered twice at that slug's `tt` / 27 °C / 1.8 V point -- once against
   the old library, once against the new -- gives **byte-identical** output
   logs, and every `.meas` value in them reproduces record
   `20260906-085753-9109b23.json`'s `tt` corner to every recorded digit
   (`t_asm_wstv0p42 = 6.446773e-09`, `t_asm_wstv0p48 = 5.673425e-09`,
   `slowdown_wstv0p42 = 2.212519`, `swing_frac_asm_ring = 0.8905795`,
   `i_asm_wstv0p42 = 9.536944e-06`, `skew_span_asm = 1.136311`), on a
   *different* host and OS from the one that minted the records.

   One caveat worth recording so a future reader does not chase it:
   ngspice-46 prints a `Reference value : …` crossing-search diagnostic
   line that is **not** reproducible run to run -- two runs of the
   *identical* deck against the *identical* library differ on it. It is
   excluded from the byte-comparison above for that reason, and it carries
   no measured value.

The affected `sim/` records' `PEX_LIB` hash (`5f9074c2c382…` ->
`b4fdb68a8c42…`) is re-stamped in `sim/README.md` § "`PEX_LIB` provenance
re-stamp (issue #96)"; the records themselves are append-only and were not
edited.

## Net aliasing: a ring-level wrinkle leaf extraction never hits

`layout/pex/pex.json`'s own `net_aliases` renames each cell's *own* joined
labels to their design-level names (e.g. `ro_nand2`'s `py`). Flattening a
whole ring surfaces a case leaf extraction cannot: **the same internal net
name recurs across sibling instances.** Both `ro_nand2` and every
`ro_stage` in a ring carry a schematic-internal net literally named `py`
(the starve-PMOS-to-switch-PMOS node, `design/ro_array_core.spice`'s
`.subckt ro_stage`/`ro_nand2`) and another named `ny`. Extracting one gate
at a time (as `layout/pex/` does), each cell only ever has ONE such
net, so no collision is possible. Extracting a whole ring flattens **five**
instances (one `ro_nand2` + four `ro_stage`) into one net list, and KLayout
already disambiguates the four `ro_stage` copies at the SPICE-text level
(`py`, `py$1`, `py$2`, `py$3`) -- but `ro_nand2`'s *own* `py` is additionally
**joined** with its own pin labels (`mpa_py|mpb_py|mph_py|py`, the same
two-pass-composition artifact `layout/pex/pex.json` already renames to
`py`). Naively reusing that same target name collides with the *other*
four, already-distinct `py`/`py$1..3` nets -- `layout/bin/pex-netlist.py`'s
own injective-rename check catches this (`rewrite_cell` raises `BuildError`
rather than silently merging two physically distinct nodes), so this was a
loud failure, not a silent one. The fix: give the `ro_nand2`-owned name a
target that cannot collide with anything else in the same net list
(`py_g`, not `py`) -- see `pex.json`'s `net_aliases`.

The `n1`-`n4` family hits a related but distinct trap: canonicalizing to
bare `n1`..`n4` collided with the extractor's own anonymous-net naming
convention (`$4` -> sanitized to `n4`, since `sanitize()` replaces `$` with
`n` -- see `layout/bin/pex-netlist.py`'s docstring). `pex.json` uses
`sig_n1`..`sig_n4` instead, which cannot collide with any `$<digits>`
sanitization output. Both of `n1`-`n4` and `py`/`ny` are internal-to-the-ring
nets kept local by the design-port-order wrapper (`ports: ["en","ro","vddr","vss"]`
matches `design/ro_array_core.spice`'s own `.subckt ro_ring5` line exactly;
everything else stays a local node inside `ro_ring5_assembled_pex_wstv0p4x`).

## What the parasitic model contains, and what it newly includes

Same model as `layout/pex/README.md` describes (lumped star series
resistance per net, quasi-static vertical-overlap-only net-to-net
capacitance, no inductance) -- `pex-netlist.py` is shared, unmodified. The
difference is scope: because the extraction runs over the **whole composed
ring GDS**, the per-net R/C now includes the `n1`-`n4`/`ro` signal-routing
segments and the `vddr`/`vss` rail-busing metal `layout/ro_ring5/README.md`
documents (met1 signal routing, met2 rail busing) -- not just each gate's
own internal geometry. That is the entire point of this directory: turning
`layout/pex/`'s "real intra-cell parasitics, ideal inter-cell wires" into
"real intra-cell AND real inter-cell parasitics, for everything up to one
ring" (the array's inter-*ring* wiring -- buffer fan-in, the XOR combining
tree, per-ring supply distribution -- is still not drawn; see
`layout/README.md`'s "What's deferred").

The substrate-return-node caveat (`vsubs`, klayout-tools#1503) applies
identically here -- this library also declares `.global vsubs`, and
`sim/post-layout-ro-ring5-assembled/`'s testbench ties it hard to 0, the
same physically-motivated choice `sim/post-layout-ro-ring5/`'s primary deck
uses.

## Simulating a much bigger flat extraction: a memory trap, and its fix

The first full-corner run of `sim/post-layout-ro-ring5-assembled/`'s
testbench hit `Error: memory required (Id Bytes) is more than memory
available (Id Bytes)! Setting the output memory is not possible.` at the
`ff` corner (fastest devices, shortest internal timesteps) -- not a
convergence failure (no singular-matrix or timestep-too-small message), an
out-of-memory abort partway through the transient. Root cause: ngspice's
default history buffer keeps a full-resolution voltage trace for **every**
node in the deck, and a flat ring extraction has far more of them than the
leaf-cell composition does -- every per-terminal parasitic-star leg node
the extractor's own model introduces (`layout/bin/pex-netlist.py`'s
docstring calls these `__tN` nodes) now exists for the *whole* ring's
worth of routing, not just one gate's. At the `ff` corner's shorter
timesteps, that history exhausted available memory outright rather than
merely running slowly. Fix: a `.save` line in the testbench naming only the
handful of node voltages and branch currents the `.meas` statements
actually read (`v(r1o)`, `v(q1ob)`, `i(Vddrr1)`, etc.) -- none of the
internal leg nodes are read by any measurement, so this changes nothing
about the result, only the memory footprint. Confirmed by re-running the
`ff` corner alone after the fix: **PASS**, all four widths' periods
measured. Not filed against `klayout-tools`: this is ngspice's own default
trace-retention behaviour, unrelated to what `klt extract` wrote.

## Reproducing

```bash
volare enable --pdk sky130 c6d73a35f524070e85faff4a6a9eef49553ebc2b
python3 layout/bin/pex-netlist.py layout/pex-ring/pex.json --check
```
