2AMLogic/sky130-trng/layout/sampler_core/README.md

# layout/sampler_core

> **Regenerated, issue #181 (2026-10-07).** `sampler_core.gds` and every
> child cell it places were rebuilt bottom-up on klayout-tools
> `0.6.0+g5edb557f91d0` (klayout-tools#2778, the cut-size/grid fix). The
> previous GDS `sha256:a00f6550…` was clean only on klt 0.4.0's deck. On
> the current curated `sky130` deck it gives 5664 `licon1.ongrid.1` +
> 198 `via.width.1`. The regenerated `sha256:e3ff54a9…` is **clean, 0
> violations** on that same deck (`drc.json`). `klt lvs` still matches
> 264/264 devices and 152/152 nets (`lvs.json`). Only `licon1`/`mcon`/`via`
> cut geometry changed (fixed sky130 sizes, on-grid centres). Every other
> layer, every stage bbox and every scan in this directory is unchanged.
> `erc.json` was re-run against the new GDS and is still clean. Details:
> `layout/README.md`, "Regeneration on the cut-size/grid fix (issue
> #181)". The PEX library `layout/pex-sampler-core/` still describes the
> old GDS (#184). The klt versions named in the increment sections below
> are each section's historical record.

`sampler_core` is `design/sampler_core.spice`'s top-level subckt: one
`ro_array_core` instance (`xdut`) plus six `sampler_dff` instances (`xsb`,
`xsv`, `xsr1`-`xsr4`), wired together (`design/README.md`'s own line:
"`sampler_core`  the sampler, wired to the source"). This directory promotes
[`layout/sampler_core-placement-poc/`](../sampler_core-placement-poc/README.md)'s
own six-instance floorplan (unchanged: 55.66 µm pitch, the same `sb`/`sv`/
`sr1`-`sr4` instance order and naming, the same `y=0.0` origin for every
instance) into a real, `compose-cell.py --check`-reproducible cell recipe,
places the `ro_array_core` instance above it, and finishes wiring the two
together: all five data nets are routed and every sampler `d` pin is driven.
**As of this increment, both inter-block supply straps (`vdd` and `vss`) are
real metal, and `klt lvs` against `design/sampler_core.spice`'s own
`.subckt sampler_core` is a full match — DRC-clean, 264/264 devices,
152/152 nets, 0 errors.** This is the first whole-cell DRC/LVS-clean
`sampler_core` assembly in this repo.

**As of this increment, the cell also carries its T1 item-11 (power
delivery, structural) supply read (issue #154, ties[] added by issue
#161): a committed `klt erc` supply spec + report find every declared
supply — all four per-ring `vddr1`-`vddr4` pins plus `vdd` and `vss` —
resolves to exactly one electrical island, with zero
`erc.unconnected_net` and zero `erc.supply_short`, and every declared
well/substrate tie checked with zero `erc.missing_tie`.** See the
`klt erc` section below.

## Result (this increment: the T1 item-11 structural supply read (`klt erc`), issue #154)

`klt erc`'s supply read is the evidence artifact T1 item 11 (power
delivery, structural — `klayout-tools`
`docs/design-evidence-tiers.md`, approved as klayout-tools#2025) grades
for the *structural* question: is the supply actually connected to what it
powers. The two committed artifacts here are:

| Artifact | What it is |
| --- | --- |
| `erc-supply-spec.json` | the spec: stackup/li1/met1/met2 + vias + the block's six declared supplies + the six `ties[]` well/substrate tie declarations (issue #161), every entry justified inline in its `_comment` block (including each `stackup` entry, each `label_layer`, why `active_layer` is set, and how every `well_boxes` coordinate was derived) |
| `erc.json` | the committed `klt erc --format json` report against `sampler_core.gds`, regenerated on **tagged** klayout-tools 0.6.0 (issue #161) and re-run on the same tagged build against the regenerated GDS (issue #181): `erc_status: "clean"`, `erc_finding_count: 0`, `provenance.klt_version: "0.6.0"`, input content-hash `sha256:e3ff54a9bb15122298f0d5df817612ed1caacb3b045533f9ba86d009036c2004` matching the committed GDS byte for byte. The #181 re-run finds the same 73 gates with identical per-gate data; only the gate order and the input hash changed. Note: post-0.6.0 dev builds, including the `0.6.0+g5edb557f91d0` build that regenerated the GDS, reject this spec's `_comment` keys, so this report stays on the tagged build (filed as klayout-tools#2822). Run it with `uvx --isolated --from "klayout-tools==0.6.0"` or a fresh venv. A non-isolated `uvx` can silently reuse an installed `0.6.0+g…` dev build, because that version satisfies `==0.6.0` (klayout-tools#2823) |

**The verdict.** Every supply `design/sampler_core.spice`'s own
`.subckt sampler_core` declares — `vddr1 vddr2 vddr3 vddr4 vdd vss` —
resolves to exactly **one** electrical island in the flat
poly/li1/met1/met2 connectivity model: zero `erc.unconnected_net` (which
fires on zero islands *or* on a split rail), zero `erc.supply_short`
between any pair. The four `vddrN` supplies are four physically separate
rails by design (`layout/ro_array_core/README.md`: "the four `vddr`
rails … stay separate, exactly as intended"), each carrying its own
promoted pin label — which is why the spec declares the per-pin names
rather than the bare ring-local text label `vddr`: that label repeats
inside every ring, and resolving it as a single supply name reads the
intended four-rail topology as a "split rail" finding. This was measured,
not assumed — the first draft of the spec declared `vddr` and the run
correctly reported it as four islands, which is what sent the declaration
back to the netlist's own `.iopin` list as the authority on what this
block's supplies are.

**The `erc.missing_tie` half is now computed and clean (issue #161).**
The #154 increment deliberately declared no `ties[]` — on the then-pinned
released builds a tie joined its well/tap regions into the single unified
connectivity graph and collapsed a routed design into one island with a
false `erc.supply_short` (klayout-tools#2169, gf180-drone-fc's FRICTION
F-034). klayout-tools 0.6.0 — the first tagged release carrying the fix
(#2186: ties are evaluated in their own second extraction and cannot
touch `gates[]` or the `nets[]` findings) — is both the CI grader pin
(since issue #160) and the build the committed report now records, so
the spec declares its ties:

- **Six entries, one per distinct well/substrate-to-supply tie.** The
  measured partition of the 90 merged nwell regions (klayout.db
  extraction against the committed GDS): 70 polygons whose taps reach
  the `vdd` island (the sampler bank, the XOR tree, the array's
  `nwell_vdd` well-tie pads), five each reaching `vddr1`–`vddr4` —
  **the ring-local rails tie their own wells**, answering this issue's
  "determine from the layout" question — and the substrate: all 87
  substrate-side tap polygons (65/44 outside any nwell) reach `vss`.
- **`tap_layer` 65/44 with `tap_is_dedicated: true`**: sky130's
  `tap.drawing` is a tap-only tub-contact marker — the very layer
  klayout-tools' erc docs name as the `tap_is_dedicated` exemplar — so
  no `tap_requires` narrowing is needed and no tie renders degenerate
  (`erc_coverage.skipped[]` is empty; a degenerate declaration would
  read `clean_partial` and item 11 would refuse it).
- **`well_layer: null` + `well_boxes` everywhere.** 0.6.0 resolves a
  tie's well region as the *whole* drawn well layer, checking every
  merged polygon of it against that one entry's single `net` — which
  cannot express wells tied to five different supplies. Each entry
  instead asserts its group's regions directly: every well box is the
  bounding rectangle of one merged 64/20 polygon whose tap reaches that
  entry's net (derived from the GDS, not invented; the box unions are
  pairwise disjoint across groups; together they cover ~7% of the
  top-cell extent, far from the whole-die shape klt refuses as a
  degenerate well assertion). The substrate entry is the designed-for
  native-substrate form (klayout-tools#2273/#2255): sky130's p-substrate
  has no drawn layer, and its 64 boxes are per-cluster bounds of the
  vss-reaching taps (2 µm proximity clustering). The cost is stated in
  the verdict of record: all six ties grade
  `erc_coverage.checked_by_well_assertion` — the weaker provenance
  #2255 defines — beside ordinary `checked` work.
- **Falsifiability, per klt erc's contract:** every merged asserted
  polygon must contain tap geometry *and* at least one tap electrically
  wired to that entry's declared net, so an untied region (a well whose
  taps reach a different rail, a substrate patch with no tap) would
  render an `erc.missing_tie` finding naming its bbox. The committed
  report is the recorded verdict: zero.

**Reproducing the report.** Regenerate `erc.json` with:

```bash
klt erc layout/sampler_core/sampler_core.gds layout/sampler_core/erc-supply-spec.json --format json
```

…against a `klt` that has the `klt erc` capabilities this read needs.
Since issue #161 the committed report is generated on the **tagged**
`0.6.0` release (the first tag carrying `stackup[0].active_layer`
(klayout-tools#2001 — the spec sets it so the antenna denominator is
poly ∩ diff, keeping the rings' real poly interconnect out of every
gate's denominator), the `status`/`provenance` envelope
(klayout-tools#1984/#1968 — the committed report's
`provenance.input.content_hash` is the freshness pin the signoff
staleness gate reads), the `erc_coverage` block (klayout-tools#2179),
and the isolated tie extraction (klayout-tools#2186) the `ties[]` half
requires). The exact build that produced the committed report:

```bash
python3 -m venv /tmp/klt-venv-erc-161
/tmp/klt-venv-erc-161/bin/pip install klayout-tools==0.6.0
/tmp/klt-venv-erc-161/bin/klt version    # klt 0.6.0 (git_tag v0.6.0)
PATH=/tmp/klt-venv-erc-161/bin:$PATH klt erc \
  layout/sampler_core/sampler_core.gds layout/sampler_core/erc-supply-spec.json --format json
```

This retires the #154 increment's documented-exception full-SHA dev-build
recipe (`0.5.0+gb15edf5e3a2e`): a tagged release now carries every
capability the spec uses. The shared `layout/pdk.json` `ci_klt_install`
pin (0.5.0) is deliberately still unrelated to this report — it gates
the nineteen committed cells' compose-cell `--check` reproductions in
the PDK nightly (0.6.0 changed gen-compose's via-drop/tap-role handling,
klayout-tools#2312, so that bump needs its own full `--check`
re-verification first), while nothing in CI re-runs `klt erc` itself;
this report's committed-verdict gate is `ci.yml`'s `signoff-check`, which
re-renders `signoff/t1-report.json` from the committed envelope on the
grader pin.

**CI note.** Nothing in the existing `pdk-nightly` `layout-check` job
re-runs this report (it re-derives `cell.json` evidence only), so this
artifact's drift protection is the committed content-hash plus this
recipe, not CI — the same posture as the other non-`cell.json` evidence
in this directory (`extract.json`, `lvs.json`).

**Tracker seam, resolved by issue #161.** The #154 increment left the
mechanical `11.analog` citation deliberately withheld (the 0.5.0 grader
had no `erc` envelope kind; the no-`ties[]` workaround graded
`supply_spec_incomplete` — filed as klayout-tools#2247). The citation is
now in place: `signoff/block-manifest.json` carries `11.analog` as the
compound `[erc.json, lvs.json]` entry, and `signoff/t1-report.json`
renders the row from the clean 0.6.0-graded ERC half. The row reads
`unmet` / `lvs_supply_unproven` for a reason that lives entirely in the
LVS half's supply-pairing rule (it requires a correspondence row whose
entire layout-side string equals the supply name, but `klt lvs`
alias-joins label-merged supply nets with `|`) — filed upstream as
[2AMLogic/klayout-tools#2405](https://github.com/2AMLogic/klayout-tools/issues/2405),
local re-grade follow-up #164. See `signoff/README.md`'s item-11 section
for the full claim and its limits; this section remains the block-side
record of the eleventh row's evidence.

## Result (this increment: the `vdd` inter-block supply strap and a whole-cell `klt lvs` match, issue #22 / #27 step 5, second half)

Three new stages on top of the twelve below (all unchanged): `vdd_strap1`
through final `vdd_strap3` route real metal from `ro_array_core`'s own `vdd`
to the six-`sampler_dff` bank's own `vdd` rail — the second and last of this
cell's two supply straps. Until this increment the two extracted as **two
separate nets**, both happening to contain the literal label `vdd` (the
array's own internal `vdd` bus, and the sampler bank's own `vdd` rail) — not
merged the way `vss` already was via the shared p-substrate, since sky130's
substrate model is NMOS-body-only and has no equivalent PMOS-well merge.

Unlike `vss`, a pure single-layer (met1) run from the array's own tap to the
rail does not work here: the array's own internal routing between the two
is far denser on this side, and a met1 net belonging to some other signal
(not previously named in this cell's own documentation) spans the *whole*
composed `x=211.64..214.97` corridor at `y=25.25..25.42`, with no gap to
route through at any `x` in that span — re-measured directly by exact
polygon intersection, not assumed, and not read off a `Region.merge()`
bounding box (a real pitfall this increment's own `vdd-strap-scan.py`
documents: a first-pass reading of this exact obstruction's *bbox* was
`172.86..214.97` at `y=25.125..29.32`, far bigger than its actual footprint,
because `merge()` unions many separate, unrelated same-layer shapes into one
polygon whose bbox is not its area). `vdd_strap1` (met1) descends from the
tap to a point safely above that obstruction; `vdd_strap2` (met2, a layer
the obstruction cannot short against) bridges past it in a 1.1 µm hop;
`vdd_strap3` (met1, final) returns to met1 for the last drop directly onto
the sampler bank's own `vdd` rail — an interior point on already-drawn
metal, the same technique `vss_strap4` used for `vss`. The chosen column,
composed `x=213.7`, is also clear of the array's own east vss riser (met2,
`x=214.29..214.71` — the same riser `vss_tap` lands directly on) with
`0.38` µm of margin, past the `0.14` µm sky130 spacing rule.

Three single-leg met1-only paths were tried and rejected before this
increment's own met1/met2/met1 route: two (an eastward jog along the
array's own vdd bus, and a direct crossing of `ro4_esc`'s own risers) are
recovered from a prior interrupted session's own uncommitted work — their
own descriptions, including the real short LVS caught, are preserved as
written rather than re-run; a third (a pure-met1 run straight down composed
`x=215.0`, the prior session's own chosen endpoint) was re-tested fresh
this session against the current toolchain and found to collide too — its
own exact `gen-compose` overlap-check output (`0.0231 um^2` at
`214.915..214.97, 25.125..25.545`) is reproduced by `vdd-strap-scan.py`'s
own "obstruction" claims. All three are documented in full in `cell.json`'s
own `vdd_strap1` stage comment.

| Stage | Verdict | Evidence |
|---|---|---|
| `klt gen-compose` (stages `place` … `vss_strap4`) | unchanged from the previous increments | `<stage>.compose.*.json`, `<stage>.gds` |
| `klt gen-compose` (stage `vdd_strap1`, met1 — `"metal2"` role) | **1/1 routed** | `vdd_strap1.compose.*.json`, `vdd_strap1.gds` |
| `klt gen-compose` (stage `vdd_strap2`, met2 — `"metal3"` role, auto-via both ends) | **1/1 routed** | `vdd_strap2.compose.*.json`, `vdd_strap2.gds` |
| `klt gen-compose` (final stage `vdd_strap3`, met1 — `"metal2"` role, auto-via at entry) | **1/1 routed** | `compose.request.json`, `compose.response.json` |
| `klt drc --deck sky130` | **clean, 0 violations** | `drc.json` |
| `klt extract --deck sky130` | **264 devices** (unchanged), **152 nets** (down from 153 — `vdd`'s two nets are now genuinely one) | `extract.json`, `sampler_core.spice` |
| `klt lvs` vs. `design/sampler_core.spice`'s own `.subckt sampler_core` | **match — 264/264 devices, 152/152 nets, 0 errors** (the one reported `mismatch` is the standard `topology.flattened` informational warning every `flatten_reference` run in this repo carries, not a real mismatch) | `lvs.json`, `sampler_core.ref.spice` |
| `vdd-strap-scan.py` | **17/17 claims hold** | `vdd-strap-scan.json` |

Cell extent unchanged at `x0=-2.19 x1=328.77 y0=-3.585 y1=54.72` µm; 8408
polygons (from 8399), density essentially unchanged (`klt stats`).

Against this issue's own acceptance bar: `sampler_core` is now
DRC-clean **and** LVS-clean, closing #27 step 5 in full and step 7's
layout-side requirement — top-level pin promotion (previously listed as
also needed for step 7) turned out **not** to be required for a full `klt
lvs` match with `flatten_layout`/`flatten_reference` both `true`, since the
matcher compares flattened net/device topology rather than declared
top-level pins; that line item in "What remains" below is corrected rather
than carried forward. **Still open**: the assembled `sampler_core`
post-layout PVT run (issue #22's own whole-chain claim) and DR-0003 §8's
`wstv` inter-ring decorrelation re-evaluation — both deliberately not
attempted in this increment, tracked in #27.

## Result (a previous increment: the `vss` inter-block supply strap, issue #22 / #27 step 5)

Four new stages on top of the eight below (all unchanged): `vss_strap1`
through final `vss_strap4` route real metal from `ro_array_core`'s own `vss`
to the six-`sampler_dff` bank's own `vss` rail — the first of this cell's
two supply straps (`vdd` remains open; see "What remains" below). Until this
increment the two extracted as **one** net only through sky130's shared
p-substrate model (see "The electrical result, and one merge nobody drew"
below) — real for extraction purposes, but not something a fabricated die
can rely on as a low-impedance rail.

The strap taps the array's own **east** vdd/vss riser (met2, `x=214.5` — an
exact point on `layout/ro_array_core/cell.json`'s own `vssbus` stage,
verified by construction rather than by inspection) and descends through the
`sr2`→`sr3` inter-instance gap (`x=218.0`, one of the five 3.0 µm gaps
between adjacent `sampler_dff` bboxes that carry nothing but the four shared
buses, the same kind of gap `route_ctrl`'s own `clk`/`rst_n` chains already
cross): `vss_strap1` (met2) walks east then south from the riser tap to
`y=19.9`; `vss_strap2` (met1) crosses `ro3`'s and `ro4`'s own channel hauls
for free (different layer) down to `y=7.65`; `vss_strap3` (met2) bridges
over the shared `vdd` rail's own height; `vss_strap4` (met1, final) crosses
`rst_n`'s and `clk`'s own lanes for free and lands directly on the sampler
bank's own `vss` rail — the same "interior point on already-drawn metal, no
via needed" technique `sv_d_vdd_tie` used for `vdd`.

| Stage | Verdict | Evidence |
|---|---|---|
| `klt gen-compose` (stages `place` … `route_data2`) | unchanged from the previous increments | `<stage>.compose.*.json`, `<stage>.gds` |
| `klt gen-compose` (stage `vss_strap1`, met2 — `"metal3"` role) | **1/1 routed**, second attempt (see "The `sb`→`sv` attempt" below) | `vss_strap1.compose.*.json`, `vss_strap1.gds` |
| `klt gen-compose` (stage `vss_strap2`, met1 — `"metal2"` role) | **1/1 routed** | `vss_strap2.compose.*.json`, `vss_strap2.gds` |
| `klt gen-compose` (stage `vss_strap3`, met2 — `"metal3"` role) | **1/1 routed** | `vss_strap3.compose.*.json`, `vss_strap3.gds` |
| `klt gen-compose` (final stage `vss_strap4`, met1 — `"metal2"` role) | **1/1 routed** | `compose.request.json`, `compose.response.json` |
| `klt drc --deck sky130` | **clean, 0 violations** | `drc.json` |
| `klt extract --deck sky130` | **264 devices** (unchanged), **153 nets** (unchanged — `vss` was already one net via the substrate; a real metal strap does not change the *topology*, only how it is realized) | `extract.json`, `sampler_core.spice` |
| `klt lvs` vs. `design/sampler_core.spice`'s own `.subckt sampler_core` | **mismatch, unchanged** — 138/264 devices, 100/152 nets. `vss` was already merged for LVS purposes too; the remaining mismatch is `vdd` (still two nets) plus top-level pin promotion, neither touched by this increment | `lvs.json`, `sampler_core.ref.spice` |
| `vss-strap-scan.py` | **12/12 claims hold** | `vss-strap-scan.json` |

Cell extent unchanged at `x0=-2.19 x1=328.77 y0=-3.585 y1=54.72` µm; 8399
polygons (from 8386), density essentially unchanged (`klt stats`). Generated
on `klt 0.3.0+gc6dbf66c53c6` against open_pdks
`c6d73a35f524070e85faff4a6a9eef49553ebc2b` — `layout/pdk.json`'s own pin.

### The `sb`→`sv` attempt, and why it moved east

The first attempt tapped the array's own `vss` bus directly (composed
`(52.0, 20.635)`, inside the `sb`→`sv` gap) and tried to descend the whole
way to the `vss` rail on met1 in one stage. It hit two real obstacles in
sequence, both found by `klt gen-compose`'s own checks rather than assumed:

1. **An array-internal met1 bar** at `y 20.125..20.295`, spanning
   `x 47.01..213.08` — almost certainly a ring/tap strap the array's own
   construction left connected to the substrate but not (yet) strapped to
   its own met2 `vss` bus by metal, the same "still through the substrate"
   gap this increment is closing at the block level. `gen-compose` rejected
   the single-stage met1 descent outright: `self-net's drawn 0.17um metal
   overlaps 0.0289um^2 of block 'core''s own drawn pad metal on the route
   layer (drawn geometry (no port of its own sits on it))` — a real, tool-
   caught silent-short candidate, not a false positive.
2. **No room for a via between that bar and `ro3`'s own channel haul.** The
   fix's own first retry split the descent into a met2 "dip" (clearing the
   bar) plus a met1 leg (crossing `ro3`/`ro2`/`ro1` for free), transitioning
   layers at `y=19.9` — but the window between `ro3`'s own top edge
   (`y=19.485`) and the bar's own bottom edge (`y=20.125`) is only `0.64 µm`,
   and a via's own `0.42 µm` pad plus `0.14 µm` clearance on both sides needs
   `0.70 µm`. `klt drc` caught this one too (`met2.space.1`, not a routing
   rejection): the via's own met2-side pad came within `0.005 µm` of `ro3`'s
   own edge.

Neither obstacle exists at `x=218` (the `sr2`→`sr3` gap this increment
actually uses): the array-internal bar stops at `x=213.08`, well west of it,
and `ro1`/`ro2`'s own channel hauls stop at `x≤173.645`, also well west of
it. `ro3`'s own *second* leg (`y=13.6`) and `ro4`'s haul (`y=15.0`) do cross
this gap, but both are far enough below this stage's own `y=19.9`→`y=7.65`
met1 run that they are crossed for free on the way down, with room to spare.
`vss-strap-scan.py`'s own group A/B claims re-derive both findings —
`gap1_window_too_narrow_for_a_via` and `gap4_has_no_array_internal_bar` —
directly from the committed pre-increment stream.

### Friction

No new `2AMLogic/klayout-tools` issue was filed by this increment. Both
rejections above (`gen-compose`'s own overlap check, `klt drc`'s own
`met2.space.1`) worked exactly as documented and caught real problems before
they became silent shorts.

## Result (this increment: the last three data nets, and `sv`'s own `vdd` tie, issue #22 / #105)

Two new stages on top of the six below (all six unchanged; `route_data` is now
non-final, so its files are renamed `route_data.compose.*`/`route_data.gds`, the
same convention the five stages before it already use):

- **`data2_m1`** (met1) draws nine legs: the `d`-input climbs for `sb`, `sr2`
  and `sr3` (the same `li1`→met1 recipe `data_m1` used for `sr1`/`sr4`), `sv`'s
  own `d`→`vdd` tie, `ro2`'s and `ro3`'s **westward** escapes along their own
  already-drawn horizontals, and the two short met1 legs `xo` needs — the
  `li1`→met1 promotion of `xa3`'s own `y` pad, and a detached "dip" that ducks
  under `xa2`'s own `t2` riser.
- **`route_data2`** (met2) closes the three remaining hauls (`ro2`→`sr2.d`,
  `ro3`→`sr3.d`, `xo`→`sb.d`) plus the one 2.1 µm met2 hop that joins `ro3`'s
  split met1 escape across `ro2`'s own vertical.

**Every `d` pin in the cell is now driven** — the five data nets from the array
plus `sv`'s constant `1` — which is the precondition item 7 below has been
waiting on.

| Stage | Verdict | Evidence |
|---|---|---|
| `klt gen-compose` (stages `place`, `route_supplies`, `route_ctrl`, `place_array`, `data_m1`, `route_data`) | unchanged from the previous increments | `<stage>.compose.request.json`, `<stage>.compose.response.json`, `<stage>.gds` |
| `klt gen-compose` (stage `data2_m1`, met1 — `"metal2"` role) | **9/9 routed**, first attempt | `data2_m1.compose.*.json`, `data2_m1.gds` |
| `klt gen-compose` (final stage `route_data2`, met2 — `"metal3"` role) | **5/5 routed**, first attempt | `compose.request.json`, `compose.response.json` |
| `klt drc --deck sky130` | **clean, 0 violations** | `drc.json` |
| `klt extract --deck sky130` | **264 devices** (unchanged), **153 nets** — `157 − 4`, exactly one merge per net joined and nothing else | `extract.json`, `sampler_core.spice` |
| `klt lvs` vs. `design/sampler_core.spice`'s own `.subckt sampler_core` | **mismatch, as expected and quantified** — 138/264 devices, 100/152 nets (from 136/264, 94/152). The supplies are still two `vdd` nets where the schematic has one, so a match is not reachable until item 5 below lands | `lvs.json`, `sampler_core.ref.spice` |
| `data-path-scan.py` | **19/19 claims hold** (13 before) | `data-path-scan.json` |

Cell extent unchanged at `x0=-2.19 x1=328.77 y0=-3.585 y1=54.72` µm; 8386
polygons (from 8326), 22.9% density (`klt stats`). Generated on `klt
0.3.0+gc6dbf66c53c6` against open_pdks `c6d73a35f524070e85faff4a6a9eef49553ebc2b`
— `layout/pdk.json`'s own pin, the same build the previous increment used.

### The one thing that changes the shape of the problem: escape *sideways*, not down

The previous increment measured that `ro2` and `ro3` have no free met1 column
from their own runs down past the array's south edge, and concluded each would
need "a layer change *inside* the array's own footprint". That is right, but the
useful move turned out not to be a rung over the fencing horizontals — it is to
stay on met1, walk **west along the net's own horizontal** to the array's west
margin, and descend there on met2.

`data-path-scan.py`'s new group E scans `route_data.gds` — the state before this
increment drew anything — for every 0.05 µm column that is free of met2 over the
array's whole height (`y` 19.4 .. 50.0 in the composed frame, i.e. from just
under its south edge to above the `xor2` row). There are exactly two bands:

| Band | `x` (composed frame) | Reachable? |
|---|---|---|
| west margin | `-2.1 .. 1.65` | **yes** — met1 at `ro2`'s own `y=32.135` and at `ro3`'s `y=32.635` is free from `x=-0.415` to `x=20.415`, so both nets can walk to it |
| east margin | `215.05 .. 220.0` | **no** — see below |

The east band is free and useless. Getting onto it needs a met1↔met2 via
dropped between the array's own east `vdd`/`vss` riser (met2, right edge
`x=214.71`) and `ro4`'s own met1 escape leg (left edge `x=215.315`) — a
**0.605 µm** gap, where the via's own concentric 0.42 µm pads need
`0.42 + 2 × 0.14 = 0.70 µm` to clear both at sky130's 0.14 µm met spacing. Both
edges are measured from the stream, and the arithmetic is a claim
(`no_via_fits_between_the_east_riser_and_ro4s_escape_leg`), not a remark.

### Three nets, one margin: what orders the lanes

All three remaining nets descend the same 3.75 µm-wide west margin, so the
ordering is forced by two facts rather than chosen:

- **`ro1`'s own channel haul** (met2, `y=17.0`) runs east from `x=-0.71`. A
  column that has to reach *below* `y=17` must therefore sit west of about
  `x=-1.02`. Only `xo` needs that (its target, `sb`'s `d`, is at `x=6.665`,
  east of the haul's own west end and under it), so `xo` takes `x=-1.5` and
  `ro2`/`ro3` turn east *above* the haul, at `y=18.6` and `y=19.4`.
- **`ro3`'s target column is east of `ro2`'s** (`x=229.305` vs `173.645`), so
  `ro3` takes the **higher** channel lane *and* the **eastern** of the two
  margin columns (`x=1.3` vs `0.3`). With that pairing neither net's lane ever
  crosses the other's column — the first try had them the other way round and
  the pre-flight scan found `ro3`'s lane crossing `ro2`'s descent, a silent
  short that DRC would not have reported.

`y=19.4` is the ceiling, not a round number: the array's own bottom met2 spans
`y 20.0..20.6` across `x 2.605..214.71`, and a via pad hangs to `y≈19.6` at
`x≈58`.

`ro3` then needs one more dogleg. Its target column (`x=229.305`) would cross
`ro4`'s own channel haul (met2, `y=15.0`, `x 215.4..284.965`) on the way down,
so it drops to a second lane at `y=13.6` at `x=210.0` — west of that haul's own
west end — and runs east underneath it before descending.

### `ro3`'s split escape, and the 2.1 µm hop

`ro2` walks west in one met1 leg (`x=20.5 → 0.3` at `y=32.135`). `ro3` cannot:
`ro2`'s own vertical (met1, `x 20.415..20.585`) sits between `ro3`'s horizontal
and the margin, and a met1 leg through it would short the two data nets
together. So `ro3`'s escape is two detached met1 legs at the same `y=32.635` —
`ro3_esc_e` (`28.47 → 21.6`) and `ro3_esc_w` (`19.5 → 1.3`) — joined by
`ro3_hop`, a 2.1 µm met2 leg in the final stage that crosses over `ro2`'s
vertical on a different plane. `klt extract` confirms the three fragments come
out as one net (`ro3|ro3_esc_e|ro3_esc_w|ro3_hop|sr3_d_stub|…`), and that
`ro2`'s stays separate.

### `xo`: the two-hop via gap, and one dip

`xa3`'s own `y` output is an li1 pad at `(66.375, 49.22)`, and the haul that has
to reach `sb`'s `d` runs on met2 — two via hops away, which `klt gen-compose`
will not do in one route (`klayout-tools#1567`, filed by the previous
increment). The workaround that gap's own filing predicts is a hand-built met1
rung, and this cell already contains the template for it:
`layout/ro_array_core/cell.json`'s own `core` stage declares exactly such a
promotion for `xa2` (its `y_m1` port, 1.4 µm straight north of the same `y` pad
in the same `xor2` cell). `xo_stub` is that promotion at `xa3` instead of `xa2`.

From there met2 is fenced in three directions by `xa2`'s own `t2` net: its riser
(met2, `x 37.32..37.49`) climbs from `y=50.41` into the `t2` bridge, and that
bridge spans `x 37.32..78.575` — so met2 is blocked west of `xa3` at `x≈37.4`,
blocked north at `y=54.635`, and blocked east at `x≈78.5` by `xa3`'s own `b_m1`
riser. The way through is one met1 **dip**: at `y=52.5`, met2 carries exactly
one obstacle between `x=30` and `x=66.375` (the `t2` riser), while met1 at that
same height is clear from `x=30` to `x=38.77`. So `xo_hop` runs met2 west at
`y=52.5` to `x=38.2`, `xo_dip` crosses under the riser on met1 to `x=36.5`, and
the final haul climbs back to met2, runs west at `y=53.5` (clear all the way to
the margin), and descends `x=-1.5` to the channel.

### `sv`'s `d` is not a haul at all

`design/sampler_core.spice` wires `xsv`'s own `d` to `vdd`, not to the array —
the valid-flag sampler samples a constant `1`. So `sv_d_vdd_tie` climbs the same
`d` column the other five instances use and simply keeps going to `y=7.0`, an
interior point **on** the shared `vdd` rail's own met1 (drawn at
`y 6.915..7.085` by `route_supplies`), landing directly on the target net's
metal with no via — the same technique that stage's own `vdd`/`vss` ports use.
`klt extract` puts `sv`'s `d` on the sampler bank's `vdd` net, and
`data-path-scan.py` checks both that and that the tie's own label sits in
`sv`'s own column.

### What the extraction says

`157 → 153` nets, `264` devices unchanged — exactly the four merges this
increment drew (`ro2`, `ro3`, `xo`, and `sv`'s tie), each confirmed
net-by-net rather than by the count alone. Every one of the five data nets is
one extracted net carrying the array's own promoted output label, every leg
drawn for it, the sampler stub it ends on, and a sampler `d` pin; every
`<instance>_d_stub` label sits in that instance's own `d` column, so each
connection lands on the intended sampler rather than merely on *a* sampler;
and **no unconnected `d` net remains**. The array's `vdd` and the sampler
bank's `vdd` are still two separate nets (item 5 below), and `vss` is still
one net through the shared p-substrate rather than through metal — both
unchanged by this increment, both still asserted.

### Friction

No new `2AMLogic/klayout-tools` issue was filed by this increment. It hit
`#1567` (no multi-level via drop) exactly where the previous increment
predicted, and worked around it the way that filing itself describes rather
than re-filing it.

## A previous increment: the `ro_array_core` instance, and the first two data nets (issue #27 step 3)

Three new stages on top of the `place`/`route_supplies`/`route_ctrl` stages
below (all three unchanged):

- **`place_array`** puts one `ro_array_core` instance —
  [`layout/ro_array_core/ro_array_core.gds`](../ro_array_core/README.md), the
  DRC-clean, **LVS-matching** entropy source — into the same cell as the six
  `sampler_dff` instances, at origin `(0.0, 23.635)`. This is the first time
  `design/sampler_core.spice`'s whole device population (`xdut` plus
  `xsb`/`xsv`/`xsr1`-`xsr4`, **264** devices) exists in one stream.
- **`data_m1`** (met1) draws the four short legs the channel haul needs at
  its ends: `sr1`'s and `sr4`'s own `d` pins climbed out of li1 up to a met1
  landing point at `y=6.0`, and `ro1`'s and `ro4`'s own already-drawn met1
  extended south out of the array's own bbox into the channel.
- **`route_data`** (met2) closes the two hauls across the channel — the
  first raw-tap-to-sampler connections this repo has ever drawn.

| Stage | Verdict | Evidence |
|---|---|---|
| `klt gen-compose` (stages `place`, `route_supplies`, `route_ctrl`) | DRC-clean, unchanged from the previous increments (`route_ctrl` is now non-final — its files are renamed `route_ctrl.compose.*`/`route_ctrl.gds`, the same convention the two stages before it already use) | `<stage>.compose.request.json`, `<stage>.compose.response.json`, `<stage>.gds` |
| `klt gen-compose` (stage `place_array`, declare-only, no routing) | placed, **0 unrouted nets** (there are none to route) | `place_array.compose.request.json`, `place_array.compose.response.json`, `place_array.gds` |
| `klt gen-compose` (stage `data_m1`, met1 — `"metal2"` role) | **4/4 routed**, first attempt | `data_m1.compose.*.json`, `data_m1.gds` |
| `klt gen-compose` (final stage `route_data`, met2 — `"metal3"` role) | **2/2 routed**, first attempt | `compose.request.json`, `compose.response.json` |
| `klt drc --deck sky130` | **clean, 0 violations** | `drc.json` |
| `klt extract --deck sky130` | **264 devices** (132 sampler + 132 array — the whole schematic population), **157 nets** | `extract.json`, `sampler_core.spice` |
| `klt lvs` vs. `design/sampler_core.spice`'s own `.subckt sampler_core` | **mismatch, as expected and quantified** — 136/**264** devices, 94/152 nets. The reference is now the *complete* 264-device netlist for the first time (it read 176 before — see "The reference-generation gap, closed" below), so this mismatch is a real measure of what is still unwired, not an artefact | `lvs.json`, `sampler_core.ref.spice` |
| `data-path-scan.py` | **13/13 claims hold** — every lane this increment picked, and the electrical result it produced, re-derived from the committed streams | `data-path-scan.json` |

Cell extent (final GDS) `x0=-2.19 x1=328.77 y0=-3.585 y1=54.72` µm —
`330.96 x 58.305` µm, 8326 polygons, 22.3% density (`klt stats`). The x
extent is unchanged from every earlier increment: the array (217.07 µm wide)
fits entirely inside the sampler row's own 330.96 µm span, so the cell grew
in `y` only. Generated on `klt 0.3.0+gc6dbf66c53c6` against open_pdks
`c6d73a35f524070e85faff4a6a9eef49553ebc2b` — `layout/pdk.json`'s own pin.

## Why the array goes above the row, not below

The floorplan offset `(0.0, 23.635)` is derived, not chosen for looks. `x=0`
puts the array's own x-origin on `sb`'s; `y=23.635` puts the array's own bbox
bottom (local `y=-3.635`) at exactly `y=20.0`, leaving a **12.915 µm** empty
channel above the sampler row's own top edge (`y=7.085`) — about 25 lanes'
worth at this repo's 0.17 µm/0.23 µm wire/space, so the channel is not the
constraint on any later increment.

*Above* is forced by the **sampler** side. Every data net has to end on a
`sampler_dff`'s own `d` pin, which is an li1 pad at cell-local
`(6.665, 1.2)`, and sky130's `klt` routing roles stop at `"metal3"` (met2) —
so the only question is which single column of metal can reach that pad.
`data-path-scan.py` measures both directions in all six instances, on
`route_ctrl.gds` (the state before the array existed), over a 0.62 µm-wide
window:

| Direction | What is in the way | Legs needed |
|---|---|---|
| **Up** | met2 at `y=3.2` (the in-cell `m` lane) and `y=5.0` (`route_ctrl`'s own `rst_n` haul, drawn continuously from `x=27.0` to `x=305.3`, i.e. over five of the six columns); met1 only at `y=6.915..7.085`, the shared `vdd` rail | **two**: one met1 leg from the pad up to `y=6.0` (met1 is clear from `y=0.485` to `y=6.915` in every column, so it crosses both met2 obstacles for free), then one met2 leg over the `vdd` rail |
| **Down** | met1 at `y=0.4` (the in-cell `clkb` lane) *and* `y=-3.5` (the shared `vss` rail); met2 at `y=-1.7` (the shared `clk` lane) | **four**: neither a met1 leg nor a met2 leg gets out of the column at all (`met1_below_pin_clear` and `met2_below_pin_clear` are both false in all six), so it takes a met2/met1/met2 weave plus the pad via |

That asymmetry — one obstacle crossable by a layer change vs. three
interleaved on the only two layers available — is the whole argument, and it
is checked rather than asserted: `no_single_layer_leg_leaves_any_d_column_downward`.

## Two of five data nets, and the measured reason it is not five

`ro_array_core`'s four buffered ring taps are four met1 horizontals stacked
in the array's own local `y`: `ro1` at `8.0` (spanning `x` `-0.5..50.5`),
`ro2` at `8.5` (`20.5..105.8`), `ro3` at `9.0` (`28.47..161.1`), `ro4` at
`10.0` (`49.5..216.4`). Every one of them is an *interior* backbone: the
cell promotes `ro1`-`ro4`/`xo` as text labels but has no boundary pin
geometry for them at all, so a block-level haul has to leave from a point on
the net's own drawn metal and find its own way out.

`data-path-scan.py` scans **every** 0.05 µm column over each net's own run
for a met1 path from just under the run down past the array's own south
edge, and finds:

| Net | Free south columns (array-local x) | Why |
|---|---|---|
| `ro1` | `-0.5 .. -0.25` | its own west leg is already at the array's west boundary; nothing else is under it |
| `ro2` | **none** | every column of its run is crossed by `ro3`'s run at `y=9.0`, `ro4`'s at `y=10.0`, or both |
| `ro3` | **none** | every column of its run is crossed by `ro4`'s run at `y=10.0` |
| `ro4` | `215.3 .. 215.55` | east of `ro3`'s own run end (`161.1`) and clear of `buf4`'s own riser at `x=216.4` |

So `ro1` (tap at `(-0.5, 8.0)`) and `ro4` (tap at `(215.4, 10.0)`) are
exactly the two nets that can leave the array southward on their own layer,
and they are the two this increment routes. `ro2`, `ro3` and `xo` need a
layer change *inside* the array's own footprint before they can escape —
`ro2`/`ro3` to hop `ro4`'s met1 horizontal (met2 is blocked there too, by
the array's own `vss` met2 bus at local `y=10.59..11.01`, `x` `68.5..214.7`),
`xo` because it is an li1 pad at local `(66.375, 25.585)` and met2 is two
via hops from li1, which `klt gen-compose` will not do in one route (see
"Friction filed" below). That is a separable increment, not a harder version
of this one, and it is filed as such.

> **Answered by the increment at the top of this file.** Every measurement in
> this section still reproduces (`data-path-scan.py` still asserts
> `ro2_and_ro3_have_none`), and the conclusion "each needs a layer change
> *inside* the array's own footprint" was right. What it did **not** anticipate
> is the shape of that change: the two nets never hop their fencing horizontals
> at all — they walk west on met1 along their own runs to the array's own west
> margin, which is one of only two `x` bands where met2 is free over the array's
> whole height, and descend there. The met1 escape-column scan in this section
> looks straight down from each run and so cannot see that option; group E of
> the same script is the scan that does.

## What the two hauls actually are

Each is one 2-pin `connectivity[]` entry between two met1 landing points
`data_m1` drew, so `klt gen-compose` drops a met1↔met2 via at **both** ends
and the haul itself is pure met2 across the empty channel:

```
ro1: (-0.5, 17.0) --east--> (117.985, 17.0) --south--> (117.985, 6.0)
ro4: (215.4, 15.0) --east--> (284.965, 15.0) --south--> (284.965, 6.0)
```

`117.985` and `284.965` are `sr1`'s and `sr4`'s own `d` columns
(`origin_x + 6.665` at `origin_x` = `111.32` / `278.3`). The two lanes are
2.0 µm apart, both inside the channel, both above the sampler row's topmost
metal (`y=7.085`) and below the array's own bottom edge (`y=20.0`) — and the
scan confirms the channel band `y` `7.2..19.8` contains **nothing else**: no
li1 at all, exactly two met1 shapes (the two escape legs) and exactly two
met2 shapes (the two hauls).

## The electrical result, and one merge nobody drew

`klt extract` on `place_array.gds` (the placement before any inter-block
metal) reports **159** nets, not the 160 the two blocks' own standalone
counts (`96` for `ro_array_core`, `64` for the six-sampler bank) would
predict:

```
klt extract place_array.gds --deck sky130 --pdk sky130A   # 264 devices, 159 nets
```

The missing one is the array's `vss` and the sampler bank's `vss` arriving
as **one** net although no metal joins them. They share the p-substrate,
which sky130's extraction deck models as a real conductor. This is not `klt`
merging two same-named nets: `vdd` is labelled `vdd` on both sides too, has
no shared body, and stays two separate nets — `data-path-scan.py` asserts
both halves of that (`array_and_sampler_vss_are_one_net_via_the_substrate`,
and, at the time, `array_and_sampler_vdd_are_still_two_nets`; the vdd strap
below later merged them on purpose, so that claim is now inverted and named
`array_and_sampler_vdd_are_one_net_via_the_strap`). It is worth stating plainly
because it is easy to misread as "the supplies are already connected": they
are not. A metal `vss` strap between the two blocks is still owed, and so is
every bit of `vdd`.

The final cell's **157** nets are then `159 - 2`: exactly the two intended
merges and nothing else. The scan pins them by name *and* by position — the
`sr1_d_stub`/`sr4_d_stub` labels `gen-compose` drew sit in `sr1`'s and
`sr4`'s own `d` column respectively, so each connection lands on the intended
instance rather than merely on *an* instance — and confirms four `d` pins
remain unconnected (`sb`'s, `sv`'s, `sr2`'s, `sr3`'s).

## The reference-generation gap, closed

The previous increment recorded a `compose-cell.py` limitation (not a `klt`
gap) that had to be fixed before any real whole-cell LVS pass: the
`repoint_variant_instances` step, which rewrites a subckt's instance-call
lines to point at the renamed `ro_ring5_r1`..`_r4` copies, ran **only** on
the top subckt's own lines, never on a plain `dependencies[]` entry's body.
`ro_array_core` is exactly such an entry in this descriptor, so the generated
`sampler_core.ref.spice` called a bare, undefined `ro_ring5` on its
`xr1`-`xr4` lines. `klt lvs` does not error on that — it drops the
unresolvable instances — so the only symptom was a reference device count
quietly short by those four rings' 88 devices: **176** where the schematic
has **264**.

That is now fixed. The reference assembly moved into its own function,
`build_lvs_reference`, which puts **every** emitted body through the same
repoint pass, and `layout/test_compose_cell.py` gained
`check_lvs_reference_repoints_dependency_bodies_too`, which asserts on a
`sampler_core`-shaped input that no call anywhere names the bare `ro_ring5`
and that every subckt a card calls is actually defined. `sampler_core.ref.spice`
now carries all 264 devices, and `klt lvs`'s reported reference count says so.
No other cell's committed evidence moved: `compose-cell.py --check` still
reproduces every one of them byte-for-byte on the verdict-bearing fields.

## Friction filed

One real `klt gen-compose` capability gap, and one documentation defect,
are filed generically against `2AMLogic/klayout-tools` per this repo's
`CLAUDE.md` friction protocol:

- **No multi-level via drop** (`klayout-tools#1567`). A route on the third
  metal role cannot land
  on a base-`"metal"`-role pad: `gen_compose`'s via-drop resolves exactly
  one hop, and rejects anything further apart. The caller has to hand-build
  a per-level ladder stage instead. That is why `xo` — an li1 pad at array-
  local `(66.375, 25.585)` — is not routed here while `ro1`/`ro4` (already
  on met1) are.
- **A stale docstring about orientation** (`klayout-tools#1568`).
  `gen_compose`'s module docstring
  states that `"explicit"` placement "supports no orientation (rotation)".
  It does: the request validator accepts `mirror_x`, `mirror_y` and
  `rotate_180`, and a mirrored `blocks[].cell` places correctly (verified
  directly on `layout/xor2/xor2.gds`). Believing the docstring cost this
  increment a floorplan detour.

For the record, since the corrected fact invites the question: mirroring the
array would **not** have rescued `ro2`/`ro3`. They are fenced in by `ro3`'s
and `ro4`'s own horizontals, which lie between them and the array's edge in
*both* directions — the scan above finds no free column over their runs
going north either, so no rigid-body transform of the array exposes one.

## A previous increment: `clk`/`rst_n` fan-out (issue #27 step 2)

On top of the `place`/`route_supplies` stages below (unchanged), a third
stage, `route_ctrl`, routes the shared `clk` fan-out and shared `rst_n`
fan-out across all six instances — the item flagged as likely the hardest
remaining step, by analogy with `layout/sampler_dff/README.md`'s own
single-cell `clk` fan-out derivation (a five-pin bundle net *inside* one
cell). At this scope `clk`/`rst_n` are each already a single, already-routed
net inside every `sampler_dff` instance (`layout/sampler_dff/cell.json`'s
own `clk_met1`/`clk_bus` and `rst_n_met1`/`rst_n_bus` stages), each carrying
its own correctly-spelled net-name text label as a side effect of that
routing (confirmed directly against `layout/sampler_dff/sampler_dff.gds`
with `klayout.db`: layer `69/20` — met2, `"metal3"` role — text labels
`clk` at local `(3.662, -1.7)` and `rst_n` at local `(27.645, 2.2)`), so this
stage's own job is the *same* chain-of-six technique `route_supplies` already
used for `vdd`/`vss`, not a fresh six-pin-bundle derivation.

That increment's own verdicts, as recorded at the time: `klt gen-compose`
routed `clk` clean on the **first** attempt (five straight legs at
`y=-1.7`), while `rst_n`'s first attempt (a straight leg at `y=2.2`,
mirroring `clk`'s recipe) failed all five legs — see "The `rst_n`
correction" below — and was fixed by climbing to an empty band at `y=5.0`
for the cross-instance haul; `klt drc --deck sky130` clean, 0 violations;
`klt extract --deck sky130` 132 devices, **64** nets (down from the
`vdd`/`vss` increment's 74: `clk`/`rst_n` each merge from six separate
per-instance nets into one, saving 5 apiece); `klt lvs` a mismatch, as
expected at that scope, with no `ro_array_core` instance placed yet. The
cell extent was then `x0=-2.19 x1=328.77 y0=-3.585 y1=7.085` µm; the
`route_ctrl` stage's own stream is still committed, now as
`route_ctrl.gds`/`route_ctrl.compose.*.json`, and
`data-path-scan.py`'s "from above vs. from below" measurement above reads
that stream rather than the final one precisely because it is the state
before the array existed.
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
