2AMLogic/sky130-trng/layout/ro_array_core/README.md

# layout/ro_array_core

**The whole entropy source, composed as a `--check`-reproducible cell
recipe** — `design/ro_array_core.spice`'s own `.subckt ro_array_core`: four
*deliberately different* `ro_ring5` rings (`wstv` 0.42/0.44/0.46/0.48 µm,
four physically distinct committed cells), four `ro_buf` output buffers, and
a three-`xor2` combining tree (`xa1 = xor(ro1, ro2)`, `xa2 = xor(ro3, ro4)`,
`xa3 = xor(t1, t2) = xo`). **132 devices (66 nfet + 66 pfet), 96 nets, `klt
drc` clean, `klt lvs` match.**
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
