2AMLogic/sky130-trng/sim/post-layout-sampler-dff-assembled/records/20260907-155229-709dc0b.md

# 20260907-155229-709dc0b -- post-layout-sampler-dff-assembled

**Claim**: post-layout (klt extract --parasitics over the whole DRC/LVS-clean composed layout/sampler_dff/sampler_dff.gds, real intra-cell interconnect included) sampler_dff capture timing, output levels, and reset-window/idle/active supply current, against the pre-layout design/sampler_core.spice .subckt sampler_dff as a same-deck control

**Level**: transistor
**Seed**: N/A (deterministic small-signal .noise analysis, not Monte Carlo)
**PVT point**: -40 degC, 1.62 V supply (process axis per-corner below)
**Transient max timestep** (`@@TMAX@@`): 5p
**Injected trnoise amplitude** (`@@NA@@`): 2.0e-3
**Testbench**: `sim/post-layout-sampler-dff-assembled/testbench/tb_post_layout_sampler_dff_assembled.spice`

## PDK

- variant: `sky130A`
- installed open_pdks commit: `c6d73a35f524070e85faff4a6a9eef49553ebc2b`
- pinned open_pdks commit (`sim/pdk.json`): `c6d73a35f524070e85faff4a6a9eef49553ebc2b`
- matches pin: yes
- ngspice model library: `/home/ubuntu/.volare/volare/sky130/versions/c6d73a35f524070e85faff4a6a9eef49553ebc2b/sky130A/libs.tech/combined/sky130.lib.spice`

## Netlists

- `@@RO_RING5@@` -> `design/sampler_core.spice` (sha256 `34a9af2714b7cfd7...`)
- `@@PEX_LIB@@` -> `layout/pex-sampler-dff-assembled/sampler_dff_assembled_pex.spice` (sha256 `53ab4d9c920a6e54...`)

## Tools

- ngspice: ** ngspice-46 : Circuit level simulation program
- python: 3.12.3
- OS: Linux-7.0.0-1010-aws-x86_64-with-glibc2.39

## Repo state

- commit: `709dc0b` (dirty working tree)
- branch: `feature/issue-22`

## Corner matrix run

| Corner | Verdict | Measurements | onoise spread (max/min) | Problems |
|---|---|---|---|---|
| `tt` | PASS | i_act_pex=1.59755e-06, i_act_pre=6.97017e-07, i_idle_pex=2.07479e-11, i_idle_pre=2.07433e-11, i_rst_pex=2.03138e-11, i_rst_pre=2.0313e-11, slowdown_tcq_fall=1.95191, slowdown_tcq_rise=1.78853, tcq_fall_pex=3.27634e-10, tcq_fall_pre=1.67853e-10, tcq_rise_pex=2.15723e-10, tcq_rise_pre=1.20615e-10, vq_hi_frac_pex=0.99891, vq_hi_frac_pre=0.997569, vq_lo_frac_pex=0.00111941, vq_lo_frac_pre=0.00350651, vq_rst_pex=5.74642e-09, vq_rst_pre=6.03514e-09 | n/a | (none) |
| `ss` | PASS | i_act_pex=1.60659e-06, i_act_pre=7.03412e-07, i_idle_pex=1.90289e-11, i_idle_pre=1.90293e-11, i_rst_pex=1.92967e-11, i_rst_pre=1.92962e-11, slowdown_tcq_fall=2.01316, slowdown_tcq_rise=1.83438, tcq_fall_pex=4.26028e-10, tcq_fall_pre=2.11622e-10, tcq_rise_pex=2.72222e-10, tcq_rise_pre=1.484e-10, vq_hi_frac_pex=0.9988, vq_hi_frac_pre=0.997097, vq_lo_frac_pex=0.00108139, vq_lo_frac_pre=0.00372124, vq_rst_pex=5.62066e-09, vq_rst_pre=5.85664e-09 | n/a | (none) |
| `ff` | PASS | i_act_pex=1.58548e-06, i_act_pre=6.89276e-07, i_idle_pex=7.07773e-11, i_idle_pre=7.07557e-11, i_rst_pex=4.55385e-11, i_rst_pre=4.5538e-11, slowdown_tcq_fall=1.90136, slowdown_tcq_rise=1.74616, tcq_fall_pex=2.57971e-10, tcq_fall_pre=1.35677e-10, tcq_rise_pex=1.76446e-10, tcq_rise_pre=1.01048e-10, vq_hi_frac_pex=0.999039, vq_hi_frac_pre=0.998085, vq_lo_frac_pex=0.00114204, vq_lo_frac_pre=0.00299511, vq_rst_pex=3.16051e-08, vq_rst_pre=3.34291e-08 | n/a | (none) |

## Result: **PASS**

Overall verdict is PASS only if every corner above individually passed (ngspice exited 0, every parsed `name = value` measurement was a finite number, and -- where the deck writes an `onoise_spectrum` trace -- its max/min ratio cleared the not-flat threshold).

## Links

- Testbench: `sim/post-layout-sampler-dff-assembled/testbench/tb_post_layout_sampler_dff_assembled.spice`
- Runner: `sim/bin/corner-run.py`
- Raw per-corner logs: `sim/post-layout-sampler-dff-assembled/corners/20260907-155229-709dc0b/`
- JSON record: `sim/post-layout-sampler-dff-assembled/records/20260907-155229-709dc0b.json`

- Author: auditor@loom.local
- Timestamp (UTC): 2026-09-07T15:53:26.680021+00:00
- Subset reason: (full requested corner set run)
- Supersedes: (none)
