2AMLogic/sky130-trng/sim/post-layout-sampler-dff-assembled/records/20260907-155335-709dc0b.md

# 20260907-155335-709dc0b -- post-layout-sampler-dff-assembled

**Claim**: post-layout (klt extract --parasitics over the whole DRC/LVS-clean composed layout/sampler_dff/sampler_dff.gds, real intra-cell interconnect included) sampler_dff capture timing, output levels, and reset-window/idle/active supply current, against the pre-layout design/sampler_core.spice .subckt sampler_dff as a same-deck control

**Level**: transistor
**Seed**: N/A (deterministic small-signal .noise analysis, not Monte Carlo)
**PVT point**: 27 degC, 1.8 V supply (process axis per-corner below)
**Transient max timestep** (`@@TMAX@@`): 5p
**Injected trnoise amplitude** (`@@NA@@`): 2.0e-3
**Testbench**: `sim/post-layout-sampler-dff-assembled/testbench/tb_post_layout_sampler_dff_assembled.spice`

## PDK

- variant: `sky130A`
- installed open_pdks commit: `c6d73a35f524070e85faff4a6a9eef49553ebc2b`
- pinned open_pdks commit (`sim/pdk.json`): `c6d73a35f524070e85faff4a6a9eef49553ebc2b`
- matches pin: yes
- ngspice model library: `/home/ubuntu/.volare/volare/sky130/versions/c6d73a35f524070e85faff4a6a9eef49553ebc2b/sky130A/libs.tech/combined/sky130.lib.spice`

## Netlists

- `@@RO_RING5@@` -> `design/sampler_core.spice` (sha256 `34a9af2714b7cfd7...`)
- `@@PEX_LIB@@` -> `layout/pex-sampler-dff-assembled/sampler_dff_assembled_pex.spice` (sha256 `53ab4d9c920a6e54...`)

## Tools

- ngspice: ** ngspice-46 : Circuit level simulation program
- python: 3.12.3
- OS: Linux-7.0.0-1010-aws-x86_64-with-glibc2.39

## Repo state

- commit: `709dc0b` (dirty working tree)
- branch: `feature/issue-22`

## Corner matrix run

| Corner | Verdict | Measurements | onoise spread (max/min) | Problems |
|---|---|---|---|---|
| `tt` | PASS | i_act_pex=1.81408e-06, i_act_pre=8.04648e-07, i_idle_pex=9.79633e-10, i_idle_pre=9.79565e-10, i_rst_pex=5.02169e-10, i_rst_pre=5.02166e-10, slowdown_tcq_fall=1.89267, slowdown_tcq_rise=1.75743, tcq_fall_pex=2.6311e-10, tcq_fall_pre=1.39016e-10, tcq_rise_pex=1.80842e-10, tcq_rise_pre=1.02901e-10, vq_hi_frac_pex=0.99909, vq_hi_frac_pre=0.998234, vq_lo_frac_pex=0.00139848, vq_lo_frac_pre=0.00323127, vq_rst_pex=6.41561e-07, vq_rst_pre=6.71229e-07 | n/a | (none) |
| `ss` | PASS | i_act_pex=1.82014e-06, i_act_pre=8.06129e-07, i_idle_pex=1.13572e-10, i_idle_pre=1.13519e-10, i_rst_pex=6.87406e-11, i_rst_pre=6.8738e-11, slowdown_tcq_fall=1.94925, slowdown_tcq_rise=1.80214, tcq_fall_pex=3.35542e-10, tcq_fall_pre=1.72139e-10, tcq_rise_pex=2.24302e-10, tcq_rise_pre=1.24464e-10, vq_hi_frac_pex=0.998931, vq_hi_frac_pre=0.997862, vq_lo_frac_pex=0.00139386, vq_lo_frac_pre=0.00394553, vq_rst_pex=8.03805e-08, vq_rst_pre=8.34774e-08 | n/a | (none) |
| `ff` | PASS | i_act_pex=1.81644e-06, i_act_pre=8.13708e-07, i_idle_pex=8.56173e-09, i_idle_pre=8.56139e-09, i_rst_pex=4.29414e-09, i_rst_pre=4.29408e-09, slowdown_tcq_fall=1.84717, slowdown_tcq_rise=1.72181, tcq_fall_pex=2.10631e-10, tcq_fall_pre=1.14029e-10, tcq_rise_pex=1.50618e-10, tcq_rise_pre=8.74762e-11, vq_hi_frac_pex=0.999224, vq_hi_frac_pre=0.998364, vq_lo_frac_pex=0.00139249, vq_lo_frac_pre=0.0025409, vq_rst_pex=4.91929e-06, vq_rst_pre=5.18154e-06 | n/a | (none) |

## Result: **PASS**

Overall verdict is PASS only if every corner above individually passed (ngspice exited 0, every parsed `name = value` measurement was a finite number, and -- where the deck writes an `onoise_spectrum` trace -- its max/min ratio cleared the not-flat threshold).

## Links

- Testbench: `sim/post-layout-sampler-dff-assembled/testbench/tb_post_layout_sampler_dff_assembled.spice`
- Runner: `sim/bin/corner-run.py`
- Raw per-corner logs: `sim/post-layout-sampler-dff-assembled/corners/20260907-155335-709dc0b/`
- JSON record: `sim/post-layout-sampler-dff-assembled/records/20260907-155335-709dc0b.json`

- Author: auditor@loom.local
- Timestamp (UTC): 2026-09-07T15:54:30.242378+00:00
- Subset reason: (full requested corner set run)
- Supersedes: (none)
