2AMLogic/sky130-trng/sim/post-layout-sampler-dff-assembled/records/20260907-155430-709dc0b.md

# 20260907-155430-709dc0b -- post-layout-sampler-dff-assembled

**Claim**: post-layout (klt extract --parasitics over the whole DRC/LVS-clean composed layout/sampler_dff/sampler_dff.gds, real intra-cell interconnect included) sampler_dff capture timing, output levels, and reset-window/idle/active supply current, against the pre-layout design/sampler_core.spice .subckt sampler_dff as a same-deck control

**Level**: transistor
**Seed**: N/A (deterministic small-signal .noise analysis, not Monte Carlo)
**PVT point**: 125 degC, 1.98 V supply (process axis per-corner below)
**Transient max timestep** (`@@TMAX@@`): 5p
**Injected trnoise amplitude** (`@@NA@@`): 2.0e-3
**Testbench**: `sim/post-layout-sampler-dff-assembled/testbench/tb_post_layout_sampler_dff_assembled.spice`

## PDK

- variant: `sky130A`
- installed open_pdks commit: `c6d73a35f524070e85faff4a6a9eef49553ebc2b`
- pinned open_pdks commit (`sim/pdk.json`): `c6d73a35f524070e85faff4a6a9eef49553ebc2b`
- matches pin: yes
- ngspice model library: `/home/ubuntu/.volare/volare/sky130/versions/c6d73a35f524070e85faff4a6a9eef49553ebc2b/sky130A/libs.tech/combined/sky130.lib.spice`

## Netlists

- `@@RO_RING5@@` -> `design/sampler_core.spice` (sha256 `34a9af2714b7cfd7...`)
- `@@PEX_LIB@@` -> `layout/pex-sampler-dff-assembled/sampler_dff_assembled_pex.spice` (sha256 `53ab4d9c920a6e54...`)

## Tools

- ngspice: ** ngspice-46 : Circuit level simulation program
- python: 3.12.3
- OS: Linux-7.0.0-1010-aws-x86_64-with-glibc2.39

## Repo state

- commit: `709dc0b` (dirty working tree)
- branch: `feature/issue-22`

## Corner matrix run

| Corner | Verdict | Measurements | onoise spread (max/min) | Problems |
|---|---|---|---|---|
| `tt` | PASS | i_act_pex=2.17763e-06, i_act_pre=1.05488e-06, i_idle_pex=1.105e-07, i_idle_pre=1.10451e-07, i_rst_pex=5.53782e-08, i_rst_pre=5.53494e-08, slowdown_tcq_fall=1.85417, slowdown_tcq_rise=1.7345, tcq_fall_pex=2.35368e-10, tcq_fall_pre=1.2694e-10, tcq_rise_pex=1.62555e-10, tcq_rise_pre=9.37184e-11, vq_hi_frac_pex=0.999166, vq_hi_frac_pre=0.998195, vq_lo_frac_pex=0.00177265, vq_lo_frac_pre=0.00272564, vq_rst_pex=8.47597e-05, vq_rst_pre=8.81284e-05 | n/a | (none) |
| `ss` | PASS | i_act_pex=2.09065e-06, i_act_pre=9.63004e-07, i_idle_pex=2.58044e-08, i_idle_pre=2.57688e-08, i_rst_pex=1.29995e-08, i_rst_pre=1.29758e-08, slowdown_tcq_fall=1.90343, slowdown_tcq_rise=1.77662, tcq_fall_pex=2.97884e-10, tcq_fall_pre=1.56498e-10, tcq_rise_pex=1.99278e-10, tcq_rise_pre=1.12167e-10, vq_hi_frac_pex=0.999052, vq_hi_frac_pre=0.998002, vq_lo_frac_pex=0.00175874, vq_lo_frac_pre=0.00358627, vq_rst_pex=2.40127e-05, vq_rst_pre=2.47905e-05 | n/a | (none) |
| `ff` | PASS | i_act_pex=2.63666e-06, i_act_pre=1.51585e-06, i_idle_pex=5.84502e-07, i_idle_pre=5.84038e-07, i_rst_pex=2.92984e-07, i_rst_pre=2.9274e-07, slowdown_tcq_fall=1.81679, slowdown_tcq_rise=1.706, tcq_fall_pex=1.90966e-10, tcq_fall_pre=1.05112e-10, tcq_rise_pex=1.37231e-10, tcq_rise_pre=8.04401e-11, vq_hi_frac_pex=0.999251, vq_hi_frac_pre=0.99835, vq_lo_frac_pex=0.00195167, vq_lo_frac_pre=0.00229907, vq_rst_pex=0.000386007, vq_rst_pre=0.000403696 | n/a | (none) |

## Result: **PASS**

Overall verdict is PASS only if every corner above individually passed (ngspice exited 0, every parsed `name = value` measurement was a finite number, and -- where the deck writes an `onoise_spectrum` trace -- its max/min ratio cleared the not-flat threshold).

## Links

- Testbench: `sim/post-layout-sampler-dff-assembled/testbench/tb_post_layout_sampler_dff_assembled.spice`
- Runner: `sim/bin/corner-run.py`
- Raw per-corner logs: `sim/post-layout-sampler-dff-assembled/corners/20260907-155430-709dc0b/`
- JSON record: `sim/post-layout-sampler-dff-assembled/records/20260907-155430-709dc0b.json`

- Author: auditor@loom.local
- Timestamp (UTC): 2026-09-07T15:55:26.034889+00:00
- Subset reason: (full requested corner set run)
- Supersedes: (none)
