2AMLogic/sky130-trng/sim/post-layout-sampler-dff-assembled/records/20260907-155526-709dc0b.md

# 20260907-155526-709dc0b -- post-layout-sampler-dff-assembled

**Claim**: post-layout (klt extract --parasitics over the whole DRC/LVS-clean composed layout/sampler_dff/sampler_dff.gds, real intra-cell interconnect included) sampler_dff capture timing, output levels, and reset-window/idle/active supply current, against the pre-layout design/sampler_core.spice .subckt sampler_dff as a same-deck control

**Level**: transistor
**Seed**: N/A (deterministic small-signal .noise analysis, not Monte Carlo)
**PVT point**: -40 degC, 1.98 V supply (process axis per-corner below)
**Transient max timestep** (`@@TMAX@@`): 5p
**Injected trnoise amplitude** (`@@NA@@`): 2.0e-3
**Testbench**: `sim/post-layout-sampler-dff-assembled/testbench/tb_post_layout_sampler_dff_assembled.spice`

## PDK

- variant: `sky130A`
- installed open_pdks commit: `c6d73a35f524070e85faff4a6a9eef49553ebc2b`
- pinned open_pdks commit (`sim/pdk.json`): `c6d73a35f524070e85faff4a6a9eef49553ebc2b`
- matches pin: yes
- ngspice model library: `/home/ubuntu/.volare/volare/sky130/versions/c6d73a35f524070e85faff4a6a9eef49553ebc2b/sky130A/libs.tech/combined/sky130.lib.spice`

## Netlists

- `@@RO_RING5@@` -> `design/sampler_core.spice` (sha256 `34a9af2714b7cfd7...`)
- `@@PEX_LIB@@` -> `layout/pex-sampler-dff-assembled/sampler_dff_assembled_pex.spice` (sha256 `53ab4d9c920a6e54...`)

## Tools

- ngspice: ** ngspice-46 : Circuit level simulation program
- python: 3.12.3
- OS: Linux-7.0.0-1010-aws-x86_64-with-glibc2.39

## Repo state

- commit: `709dc0b` (dirty working tree)
- branch: `feature/issue-22`

## Corner matrix run

| Corner | Verdict | Measurements | onoise spread (max/min) | Problems |
|---|---|---|---|---|
| `tt` | PASS | i_act_pex=1.97359e-06, i_act_pre=8.65655e-07, i_idle_pex=4.25449e-11, i_idle_pre=4.25299e-11, i_rst_pex=3.7027e-11, i_rst_pre=3.70262e-11, slowdown_tcq_fall=1.87436, slowdown_tcq_rise=1.72632, tcq_fall_pex=2.20016e-10, tcq_fall_pre=1.17382e-10, tcq_rise_pex=1.54288e-10, tcq_rise_pre=8.93741e-11, vq_hi_frac_pex=0.999211, vq_hi_frac_pre=0.99849, vq_lo_frac_pex=0.00123566, vq_lo_frac_pre=0.00258214, vq_rst_pex=1.51882e-08, vq_rst_pre=1.60686e-08 | n/a | (none) |
| `ss` | PASS | i_act_pex=1.98233e-06, i_act_pre=8.69336e-07, i_idle_pex=3.475e-11, i_idle_pre=3.47431e-11, i_rst_pex=3.23519e-11, i_rst_pre=3.23512e-11, slowdown_tcq_fall=1.92379, slowdown_tcq_rise=1.76366, tcq_fall_pex=2.74417e-10, tcq_fall_pre=1.42644e-10, tcq_rise_pex=1.86757e-10, tcq_rise_pre=1.05892e-10, vq_hi_frac_pex=0.999056, vq_hi_frac_pre=0.99818, vq_lo_frac_pex=0.00123847, vq_lo_frac_pre=0.00322721, vq_rst_pex=1.27701e-08, vq_rst_pre=1.34112e-08 | n/a | (none) |
| `ff` | PASS | i_act_pex=1.96713e-06, i_act_pre=8.6653e-07, i_idle_pex=2.01546e-10, i_idle_pre=2.01493e-10, i_rst_pex=1.17691e-10, i_rst_pre=1.1769e-10, slowdown_tcq_fall=1.83273, slowdown_tcq_rise=1.7044, tcq_fall_pex=1.78306e-10, tcq_fall_pre=9.72901e-11, tcq_rise_pex=1.31365e-10, tcq_rise_pre=7.70742e-11, vq_hi_frac_pex=0.999324, vq_hi_frac_pre=0.998576, vq_lo_frac_pex=0.0012121, vq_lo_frac_pre=0.00177965, vq_rst_pex=8.83904e-08, vq_rst_pre=9.41504e-08 | n/a | (none) |

## Result: **PASS**

Overall verdict is PASS only if every corner above individually passed (ngspice exited 0, every parsed `name = value` measurement was a finite number, and -- where the deck writes an `onoise_spectrum` trace -- its max/min ratio cleared the not-flat threshold).

## Links

- Testbench: `sim/post-layout-sampler-dff-assembled/testbench/tb_post_layout_sampler_dff_assembled.spice`
- Runner: `sim/bin/corner-run.py`
- Raw per-corner logs: `sim/post-layout-sampler-dff-assembled/corners/20260907-155526-709dc0b/`
- JSON record: `sim/post-layout-sampler-dff-assembled/records/20260907-155526-709dc0b.json`

- Author: auditor@loom.local
- Timestamp (UTC): 2026-09-07T15:56:22.366504+00:00
- Subset reason: (full requested corner set run)
- Supersedes: (none)
