2AMLogic/sky130-trng/sim/post-layout-ro-ring5-assembled/records/20260906-085337-9109b23.md

# 20260906-085337-9109b23 -- post-layout-ro-ring5-assembled

**Claim**: post-layout (klt extract --parasitics over the assembled, DRC-clean and LVS-clean ring GDS -- real inter-gate wiring, not the leaf-cell composition's ideal wires) five-stage ring period, swing and per-ring supply current at all four wstv widths, with the pre-layout netlist as a same-deck same-corner control

**Level**: transistor
**Seed**: N/A (deterministic small-signal .noise analysis, not Monte Carlo)
**PVT point**: -40 degC, 1.62 V supply (process axis per-corner below)
**Transient max timestep** (`@@TMAX@@`): 5p
**Injected trnoise amplitude** (`@@NA@@`): 2.0e-3
**Testbench**: `sim/post-layout-ro-ring5-assembled/testbench/tb_post_layout_ro_ring5_assembled.spice`

## PDK

- variant: `sky130A`
- installed open_pdks commit: `c6d73a35f524070e85faff4a6a9eef49553ebc2b`
- pinned open_pdks commit (`sim/pdk.json`): `c6d73a35f524070e85faff4a6a9eef49553ebc2b`
- matches pin: yes
- ngspice model library: `/Users/rwalters/.volare/volare/sky130/versions/c6d73a35f524070e85faff4a6a9eef49553ebc2b/sky130A/libs.tech/combined/sky130.lib.spice`

## Netlists

- `@@RO_RING5@@` -> `design/ro_array_core.spice` (sha256 `aed8b59124438c27...`)
- `@@PEX_LIB@@` -> `layout/pex-ring/ro_ring5_assembled_pex.spice` (sha256 `5f9074c2c382ec10...`)

## Tools

- ngspice: ** ngspice-46 : Circuit level simulation program
- python: 3.14.7
- OS: macOS-26.6.2-arm64-arm-64bit-Mach-O

## Repo state

- commit: `9109b23` (dirty working tree)
- branch: `feature/issue-22`

## Corner matrix run

| Corner | Verdict | Measurements | onoise spread (max/min) | Problems |
|---|---|---|---|---|
| `tt` | PASS | i_asm_wstv0p42=5.55054e-06, i_asm_wstv0p48=6.06022e-06, i_pre_wstv0p42=6.17825e-06, i_pre_wstv0p48=6.87055e-06, skew_span_asm=1.10281, skew_span_pre=1.12949, slowdown_wstv0p42=2.1206, slowdown_wstv0p44=2.13736, slowdown_wstv0p46=2.15447, slowdown_wstv0p48=2.1719, swing_frac_asm_buf=1.00489, swing_frac_asm_ring=0.929783, swing_frac_pre_buf=1.01195, swing_frac_pre_ring=0.912794, t_asm_wstv0p42=9.13759e-09, t_asm_wstv0p44=8.83446e-09, t_asm_wstv0p46=8.551e-09, t_asm_wstv0p48=8.28571e-09, t_pre_wstv0p42=4.30896e-09, t_pre_wstv0p44=4.13334e-09, t_pre_wstv0p46=3.96896e-09, t_pre_wstv0p48=3.81496e-09, tq1a=3.8746e-09, tq1b=3.83463e-08, tq2a=3.73789e-09, tq2b=3.68046e-08, tq3a=3.61072e-09, tq3b=3.53624e-08, tq4a=3.49249e-09, tq4b=3.40122e-08, tr1a=1.92025e-08, tr1b=9.23032e-08, tr2a=1.85885e-08, tr2b=8.92641e-08, tr3a=1.80144e-08, tr3b=8.64224e-08, tr4a=1.74774e-08, tr4b=8.37631e-08 | n/a | (none) |
| `ss` | PASS | i_asm_wstv0p42=4.50394e-06, i_asm_wstv0p48=4.95788e-06, i_pre_wstv0p42=4.98211e-06, i_pre_wstv0p48=5.53322e-06, skew_span_asm=1.10318, skew_span_pre=1.12226, slowdown_wstv0p42=2.08188, slowdown_wstv0p44=2.0937, slowdown_wstv0p46=2.1059, slowdown_wstv0p48=2.11789, swing_frac_asm_buf=1.01306, swing_frac_asm_ring=0.959456, swing_frac_pre_buf=1.03251, swing_frac_pre_ring=0.954865, t_asm_wstv0p42=1.13824e-08, t_asm_wstv0p44=1.10074e-08, t_asm_wstv0p46=1.06523e-08, t_asm_wstv0p48=1.03178e-08, t_pre_wstv0p42=5.46735e-09, t_pre_wstv0p44=5.25738e-09, t_pre_wstv0p46=5.05833e-09, t_pre_wstv0p48=4.87174e-09, tq1a=4.34352e-09, tq1b=4.80823e-08, tq2a=4.20609e-09, tq2b=4.62652e-08, tq3a=4.07699e-09, tq3b=4.45436e-08, tq4a=8.81856e-09, tq4b=4.77925e-08, tr1a=2.43171e-08, tr1b=1.15376e-07, tr2a=2.354e-08, tr2b=1.11599e-07, tr3a=2.28039e-08, tr3b=1.08022e-07, tr4a=2.21103e-08, tr4b=1.04653e-07 | n/a | (none) |
| `ff` | PASS | i_asm_wstv0p42=6.84272e-06, i_asm_wstv0p48=7.45477e-06, i_pre_wstv0p42=7.6786e-06, i_pre_wstv0p48=8.53512e-06, skew_span_asm=1.10071, skew_span_pre=1.13634, slowdown_wstv0p42=2.16118, slowdown_wstv0p44=2.18409, slowdown_wstv0p46=2.20743, slowdown_wstv0p48=2.23114, swing_frac_asm_buf=1.00308, swing_frac_asm_ring=0.896616, swing_frac_pre_buf=1.00919, swing_frac_pre_ring=0.866897, t_asm_wstv0p42=7.40001e-09, t_asm_wstv0p44=7.15914e-09, t_asm_wstv0p46=6.93394e-09, t_asm_wstv0p48=6.72297e-09, t_pre_wstv0p42=3.42406e-09, t_pre_wstv0p44=3.27785e-09, t_pre_wstv0p46=3.14119e-09, t_pre_wstv0p48=3.01325e-09, tq1a=3.20163e-09, tq1b=3.05941e-08, tq2a=3.09441e-09, tq2b=2.93172e-08, tq3a=2.99439e-09, tq3b=2.81239e-08, tq4a=2.90081e-09, tq4b=2.70068e-08, tr1a=1.53418e-08, tr1b=7.45419e-08, tr2a=1.48628e-08, tr2b=7.21359e-08, tr3a=1.44158e-08, tr3b=6.98873e-08, tr4a=1.39979e-08, tr4b=6.77816e-08 | n/a | (none) |

## Result: **PASS**

Overall verdict is PASS only if every corner above individually passed (ngspice exited 0, every parsed `name = value` measurement was a finite number, and -- where the deck writes an `onoise_spectrum` trace -- its max/min ratio cleared the not-flat threshold).

## Links

- Testbench: `sim/post-layout-ro-ring5-assembled/testbench/tb_post_layout_ro_ring5_assembled.spice`
- Runner: `sim/bin/corner-run.py`
- Raw per-corner logs: `sim/post-layout-ro-ring5-assembled/corners/20260906-085337-9109b23/`
- JSON record: `sim/post-layout-ro-ring5-assembled/records/20260906-085337-9109b23.json`

- Author: ci@loom.test
- Timestamp (UTC): 2026-09-06T08:57:52.875070+00:00
- Subset reason: full corner set (tt/ss/ff, this repo's default_corners) run at this PVT point; not a subset
- Supersedes: (none)
