2AMLogic/sky130-trng/sim/post-layout-ro-ring5-assembled/records/20260906-085753-9109b23.md

# 20260906-085753-9109b23 -- post-layout-ro-ring5-assembled

**Claim**: post-layout (klt extract --parasitics over the assembled, DRC-clean and LVS-clean ring GDS -- real inter-gate wiring, not the leaf-cell composition's ideal wires) five-stage ring period, swing and per-ring supply current at all four wstv widths, with the pre-layout netlist as a same-deck same-corner control

**Level**: transistor
**Seed**: N/A (deterministic small-signal .noise analysis, not Monte Carlo)
**PVT point**: 27 degC, 1.8 V supply (process axis per-corner below)
**Transient max timestep** (`@@TMAX@@`): 5p
**Injected trnoise amplitude** (`@@NA@@`): 2.0e-3
**Testbench**: `sim/post-layout-ro-ring5-assembled/testbench/tb_post_layout_ro_ring5_assembled.spice`

## PDK

- variant: `sky130A`
- installed open_pdks commit: `c6d73a35f524070e85faff4a6a9eef49553ebc2b`
- pinned open_pdks commit (`sim/pdk.json`): `c6d73a35f524070e85faff4a6a9eef49553ebc2b`
- matches pin: yes
- ngspice model library: `/Users/rwalters/.volare/volare/sky130/versions/c6d73a35f524070e85faff4a6a9eef49553ebc2b/sky130A/libs.tech/combined/sky130.lib.spice`

## Netlists

- `@@RO_RING5@@` -> `design/ro_array_core.spice` (sha256 `aed8b59124438c27...`)
- `@@PEX_LIB@@` -> `layout/pex-ring/ro_ring5_assembled_pex.spice` (sha256 `5f9074c2c382ec10...`)

## Tools

- ngspice: ** ngspice-46 : Circuit level simulation program
- python: 3.14.7
- OS: macOS-26.6.2-arm64-arm-64bit-Mach-O

## Repo state

- commit: `9109b23` (dirty working tree)
- branch: `feature/issue-22`

## Corner matrix run

| Corner | Verdict | Measurements | onoise spread (max/min) | Problems |
|---|---|---|---|---|
| `tt` | PASS | i_asm_wstv0p42=9.53694e-06, i_asm_wstv0p48=1.06802e-05, i_pre_wstv0p42=1.09578e-05, i_pre_wstv0p48=1.24866e-05, skew_span_asm=1.13631, skew_span_pre=1.18165, slowdown_wstv0p42=2.21252, slowdown_wstv0p44=2.24195, slowdown_wstv0p46=2.27147, slowdown_wstv0p48=2.3008, swing_frac_asm_buf=1.00287, swing_frac_asm_ring=0.890579, swing_frac_pre_buf=1.00898, swing_frac_pre_ring=0.850155, t_asm_wstv0p42=6.44677e-09, t_asm_wstv0p44=6.16533e-09, t_asm_wstv0p46=5.90873e-09, t_asm_wstv0p48=5.67343e-09, t_pre_wstv0p42=2.91377e-09, t_pre_wstv0p44=2.74998e-09, t_pre_wstv0p46=2.60128e-09, t_pre_wstv0p48=2.46585e-09, tq1a=2.65002e-09, tq1b=2.59602e-08, tq2a=2.54018e-09, tq2b=2.454e-08, tq3a=2.44105e-09, tq3b=2.32513e-08, tq4a=2.35112e-09, tq4b=2.20779e-08, tr1a=1.28171e-08, tr1b=6.43913e-08, tr2a=1.22861e-08, tr2b=6.16087e-08, tr3a=1.18026e-08, tr3b=5.90724e-08, tr4a=1.13599e-08, tr4b=5.67473e-08 | n/a | (none) |
| `ss` | PASS | i_asm_wstv0p42=7.59349e-06, i_asm_wstv0p48=8.58511e-06, i_pre_wstv0p42=8.66713e-06, i_pre_wstv0p48=9.92409e-06, skew_span_asm=1.14398, skew_span_pre=1.17627, slowdown_wstv0p42=2.18476, slowdown_wstv0p44=2.2055, slowdown_wstv0p46=2.22609, slowdown_wstv0p48=2.24643, swing_frac_asm_buf=1.00315, swing_frac_asm_ring=0.916418, swing_frac_pre_buf=1.0094, swing_frac_pre_ring=0.883735, t_asm_wstv0p42=7.89936e-09, t_asm_wstv0p44=7.53384e-09, t_asm_wstv0p46=7.20434e-09, t_asm_wstv0p48=6.90517e-09, t_pre_wstv0p42=3.61566e-09, t_pre_wstv0p44=3.41594e-09, t_pre_wstv0p46=3.23632e-09, t_pre_wstv0p48=3.07384e-09, tq1a=3.0195e-09, tq1b=3.19448e-08, tq2a=2.87934e-09, tq2b=3.02069e-08, tq3a=2.75441e-09, tq3b=2.8645e-08, tq4a=2.6423e-09, tq4b=2.7233e-08, tr1a=1.58506e-08, tr1b=7.90455e-08, tr2a=1.51584e-08, tr2b=7.54291e-08, tr3a=1.4534e-08, tr3b=7.21687e-08, tr4a=1.39669e-08, tr4b=6.92083e-08 | n/a | (none) |
| `ff` | PASS | i_asm_wstv0p42=1.19727e-05, i_asm_wstv0p48=1.33054e-05, i_pre_wstv0p42=1.38381e-05, i_pre_wstv0p48=1.56675e-05, skew_span_asm=1.128, skew_span_pre=1.18493, slowdown_wstv0p42=2.21273, slowdown_wstv0p44=2.24932, slowdown_wstv0p46=2.28665, slowdown_wstv0p48=2.3244, swing_frac_asm_buf=1.00243, swing_frac_asm_ring=0.866075, swing_frac_pre_buf=1.00781, swing_frac_pre_ring=0.821241, t_asm_wstv0p42=5.3918e-09, t_asm_wstv0p44=5.17115e-09, t_asm_wstv0p46=4.96794e-09, t_asm_wstv0p48=4.77997e-09, t_pre_wstv0p42=2.43672e-09, t_pre_wstv0p44=2.29898e-09, t_pre_wstv0p46=2.17259e-09, t_pre_wstv0p48=2.05643e-09, tq1a=2.25033e-09, tq1b=2.17441e-08, tq2a=2.16017e-09, tq2b=2.0552e-08, tq3a=2.07852e-09, tq3b=1.94593e-08, tq4a=2.00429e-09, tq4b=1.84557e-08, tr1a=1.06725e-08, tr1b=5.3807e-08, tr2a=1.02551e-08, tr2b=5.16243e-08, tr3a=9.87174e-09, tr3b=4.96153e-08, tr4a=9.51809e-09, tr4b=4.77578e-08 | n/a | (none) |

## Result: **PASS**

Overall verdict is PASS only if every corner above individually passed (ngspice exited 0, every parsed `name = value` measurement was a finite number, and -- where the deck writes an `onoise_spectrum` trace -- its max/min ratio cleared the not-flat threshold).

## Links

- Testbench: `sim/post-layout-ro-ring5-assembled/testbench/tb_post_layout_ro_ring5_assembled.spice`
- Runner: `sim/bin/corner-run.py`
- Raw per-corner logs: `sim/post-layout-ro-ring5-assembled/corners/20260906-085753-9109b23/`
- JSON record: `sim/post-layout-ro-ring5-assembled/records/20260906-085753-9109b23.json`

- Author: ci@loom.test
- Timestamp (UTC): 2026-09-06T09:01:01.939496+00:00
- Subset reason: full corner set (tt/ss/ff, this repo's default_corners) run at this PVT point; not a subset
- Supersedes: (none)
