2AMLogic/sky130-trng/sim/post-layout-ro-ring5-assembled/records/20260906-090102-9109b23.md

# 20260906-090102-9109b23 -- post-layout-ro-ring5-assembled

**Claim**: post-layout (klt extract --parasitics over the assembled, DRC-clean and LVS-clean ring GDS -- real inter-gate wiring, not the leaf-cell composition's ideal wires) five-stage ring period, swing and per-ring supply current at all four wstv widths, with the pre-layout netlist as a same-deck same-corner control

**Level**: transistor
**Seed**: N/A (deterministic small-signal .noise analysis, not Monte Carlo)
**PVT point**: 125 degC, 1.98 V supply (process axis per-corner below)
**Transient max timestep** (`@@TMAX@@`): 5p
**Injected trnoise amplitude** (`@@NA@@`): 2.0e-3
**Testbench**: `sim/post-layout-ro-ring5-assembled/testbench/tb_post_layout_ro_ring5_assembled.spice`

## PDK

- variant: `sky130A`
- installed open_pdks commit: `c6d73a35f524070e85faff4a6a9eef49553ebc2b`
- pinned open_pdks commit (`sim/pdk.json`): `c6d73a35f524070e85faff4a6a9eef49553ebc2b`
- matches pin: yes
- ngspice model library: `/Users/rwalters/.volare/volare/sky130/versions/c6d73a35f524070e85faff4a6a9eef49553ebc2b/sky130A/libs.tech/combined/sky130.lib.spice`

## Netlists

- `@@RO_RING5@@` -> `design/ro_array_core.spice` (sha256 `aed8b59124438c27...`)
- `@@PEX_LIB@@` -> `layout/pex-ring/ro_ring5_assembled_pex.spice` (sha256 `5f9074c2c382ec10...`)

## Tools

- ngspice: ** ngspice-46 : Circuit level simulation program
- python: 3.14.7
- OS: macOS-26.6.2-arm64-arm-64bit-Mach-O

## Repo state

- commit: `9109b23` (dirty working tree)
- branch: `feature/issue-22`

## Corner matrix run

| Corner | Verdict | Measurements | onoise spread (max/min) | Problems |
|---|---|---|---|---|
| `tt` | PASS | i_asm_wstv0p42=1.37948e-05, i_asm_wstv0p48=1.57532e-05, i_pre_wstv0p42=1.62467e-05, i_pre_wstv0p48=1.89011e-05, skew_span_asm=1.16285, skew_span_pre=1.23809, slowdown_wstv0p42=2.19354, slowdown_wstv0p44=2.23824, slowdown_wstv0p46=2.28558, slowdown_wstv0p48=2.33546, swing_frac_asm_buf=1.00118, swing_frac_asm_ring=0.859879, swing_frac_pre_buf=1.0044, swing_frac_pre_ring=0.80372, t_asm_wstv0p42=6.02636e-09, t_asm_wstv0p44=5.71437e-09, t_asm_wstv0p46=5.43491e-09, t_asm_wstv0p48=5.18238e-09, t_pre_wstv0p42=2.74732e-09, t_pre_wstv0p44=2.55307e-09, t_pre_wstv0p46=2.37791e-09, t_pre_wstv0p48=2.219e-09, tq1a=2.27112e-09, tq1b=2.42496e-08, tq2a=2.15979e-09, tq2b=2.25843e-08, tq3a=2.06131e-09, tq3b=2.10846e-08, tq4a=1.97396e-09, tq4b=1.97259e-08, tr1a=1.1396e-08, tr1b=5.96068e-08, tr2a=1.08231e-08, tr2b=5.65381e-08, tr3a=1.03119e-08, tr3b=5.37912e-08, tr4a=9.85165e-09, tr4b=5.13107e-08 | n/a | (none) |
| `ss` | PASS | i_asm_wstv0p42=1.08235e-05, i_asm_wstv0p48=1.25239e-05, i_pre_wstv0p42=1.27805e-05, i_pre_wstv0p48=1.50589e-05, skew_span_asm=1.18223, skew_span_pre=1.24608, slowdown_wstv0p42=2.22771, slowdown_wstv0p44=2.26681, slowdown_wstv0p46=2.30701, slowdown_wstv0p48=2.34802, swing_frac_asm_buf=1.00199, swing_frac_asm_ring=0.880116, swing_frac_pre_buf=1.00679, swing_frac_pre_ring=0.825054, t_asm_wstv0p42=7.26169e-09, t_asm_wstv0p44=6.83906e-09, t_asm_wstv0p46=6.46974e-09, t_asm_wstv0p48=6.14235e-09, t_pre_wstv0p42=3.25971e-09, t_pre_wstv0p44=3.01705e-09, t_pre_wstv0p46=2.80439e-09, t_pre_wstv0p48=2.61597e-09, tq1a=2.61552e-09, tq1b=2.86932e-08, tq2a=2.47454e-09, tq2b=2.66109e-08, tq3a=2.35242e-09, tq3b=2.47875e-08, tq4a=2.24514e-09, tq4b=2.31729e-08, tr1a=1.36708e-08, tr1b=7.17643e-08, tr2a=1.29103e-08, tr2b=6.76228e-08, tr3a=1.22473e-08, tr3b=6.40052e-08, tr4a=1.16609e-08, tr4b=6.07997e-08 | n/a | (none) |
| `ff` | PASS | i_asm_wstv0p42=1.75931e-05, i_asm_wstv0p48=1.97842e-05, i_pre_wstv0p42=2.03438e-05, i_pre_wstv0p48=2.3351e-05, skew_span_asm=1.14572, skew_span_pre=1.22019, slowdown_wstv0p42=2.13398, slowdown_wstv0p44=2.17697, slowdown_wstv0p46=2.22314, slowdown_wstv0p48=2.2727, swing_frac_asm_buf=0.997949, swing_frac_asm_ring=0.836999, swing_frac_pre_buf=0.998543, swing_frac_pre_ring=0.782289, t_asm_wstv0p42=5.12748e-09, t_asm_wstv0p44=4.88952e-09, t_asm_wstv0p46=4.67316e-09, t_asm_wstv0p48=4.47535e-09, t_pre_wstv0p42=2.40277e-09, t_pre_wstv0p44=2.24602e-09, t_pre_wstv0p46=2.10206e-09, t_pre_wstv0p48=1.96918e-09, tq1a=2.00683e-09, tq1b=2.1229e-08, tq2a=1.91281e-09, tq2b=1.98809e-08, tq3a=1.82891e-09, tq3b=1.86454e-08, tq4a=1.75319e-09, tq4b=1.75066e-08, tr1a=9.78846e-09, tr1b=5.08083e-08, tr2a=9.3418e-09, tr2b=4.84579e-08, tr3a=8.93721e-09, tr3b=4.63225e-08, tr4a=8.56889e-09, tr4b=4.43717e-08 | n/a | (none) |

## Result: **PASS**

Overall verdict is PASS only if every corner above individually passed (ngspice exited 0, every parsed `name = value` measurement was a finite number, and -- where the deck writes an `onoise_spectrum` trace -- its max/min ratio cleared the not-flat threshold).

## Links

- Testbench: `sim/post-layout-ro-ring5-assembled/testbench/tb_post_layout_ro_ring5_assembled.spice`
- Runner: `sim/bin/corner-run.py`
- Raw per-corner logs: `sim/post-layout-ro-ring5-assembled/corners/20260906-090102-9109b23/`
- JSON record: `sim/post-layout-ro-ring5-assembled/records/20260906-090102-9109b23.json`

- Author: ci@loom.test
- Timestamp (UTC): 2026-09-06T09:04:13.114121+00:00
- Subset reason: full corner set (tt/ss/ff, this repo's default_corners) run at this PVT point; not a subset
- Supersedes: (none)
