2AMLogic/sky130-trng/sim/post-layout-ro-ring5-assembled/records/20260906-090413-9109b23.md

# 20260906-090413-9109b23 -- post-layout-ro-ring5-assembled

**Claim**: post-layout (klt extract --parasitics over the assembled, DRC-clean and LVS-clean ring GDS -- real inter-gate wiring, not the leaf-cell composition's ideal wires) five-stage ring period, swing and per-ring supply current at all four wstv widths, with the pre-layout netlist as a same-deck same-corner control

**Level**: transistor
**Seed**: N/A (deterministic small-signal .noise analysis, not Monte Carlo)
**PVT point**: -40 degC, 1.98 V supply (process axis per-corner below)
**Transient max timestep** (`@@TMAX@@`): 5p
**Injected trnoise amplitude** (`@@NA@@`): 2.0e-3
**Testbench**: `sim/post-layout-ro-ring5-assembled/testbench/tb_post_layout_ro_ring5_assembled.spice`

## PDK

- variant: `sky130A`
- installed open_pdks commit: `c6d73a35f524070e85faff4a6a9eef49553ebc2b`
- pinned open_pdks commit (`sim/pdk.json`): `c6d73a35f524070e85faff4a6a9eef49553ebc2b`
- matches pin: yes
- ngspice model library: `/Users/rwalters/.volare/volare/sky130/versions/c6d73a35f524070e85faff4a6a9eef49553ebc2b/sky130A/libs.tech/combined/sky130.lib.spice`

## Netlists

- `@@RO_RING5@@` -> `design/ro_array_core.spice` (sha256 `aed8b59124438c27...`)
- `@@PEX_LIB@@` -> `layout/pex-ring/ro_ring5_assembled_pex.spice` (sha256 `5f9074c2c382ec10...`)

## Tools

- ngspice: ** ngspice-46 : Circuit level simulation program
- python: 3.14.7
- OS: macOS-26.6.2-arm64-arm-64bit-Mach-O

## Repo state

- commit: `9109b23` (dirty working tree)
- branch: `feature/issue-22`

## Corner matrix run

| Corner | Verdict | Measurements | onoise spread (max/min) | Problems |
|---|---|---|---|---|
| `tt` | PASS | i_asm_wstv0p42=1.48147e-05, i_asm_wstv0p48=1.61951e-05, i_pre_wstv0p42=1.68439e-05, i_pre_wstv0p48=1.87697e-05, skew_span_asm=1.10977, skew_span_pre=1.15313, slowdown_wstv0p42=2.21927, slowdown_wstv0p44=2.24964, slowdown_wstv0p46=2.27857, slowdown_wstv0p48=2.30597, swing_frac_asm_buf=1.00411, swing_frac_asm_ring=0.883972, swing_frac_pre_buf=1.01221, swing_frac_pre_ring=0.84463, t_asm_wstv0p42=4.31564e-09, t_asm_wstv0p44=4.16897e-09, t_asm_wstv0p46=4.02611e-09, t_asm_wstv0p48=3.88876e-09, t_pre_wstv0p42=1.94462e-09, t_pre_wstv0p44=1.85317e-09, t_pre_wstv0p46=1.76695e-09, t_pre_wstv0p48=1.68639e-09, tq1a=1.86933e-09, tq1b=1.74263e-08, tq2a=1.81014e-09, tq2b=1.66355e-08, tq3a=1.75353e-09, tq3b=1.58891e-08, tq4a=1.69999e-09, tq4b=1.51911e-08, tr1a=8.69567e-09, tr1b=4.32208e-08, tr2a=8.42493e-09, tr2b=4.17767e-08, tr3a=8.16074e-09, tr3b=4.03696e-08, tr4a=7.90654e-09, tr4b=3.90166e-08 | n/a | (none) |
| `ss` | PASS | i_asm_wstv0p42=1.2454e-05, i_asm_wstv0p48=1.34346e-05, i_pre_wstv0p42=1.40329e-05, i_pre_wstv0p48=1.54077e-05, skew_span_asm=1.09373, skew_span_pre=1.13034, slowdown_wstv0p42=2.16336, slowdown_wstv0p44=2.18937, slowdown_wstv0p46=2.21337, slowdown_wstv0p48=2.23577, swing_frac_asm_buf=1.00461, swing_frac_asm_ring=0.918478, swing_frac_pre_buf=1.01297, swing_frac_pre_ring=0.892074, t_asm_wstv0p42=5.11334e-09, t_asm_wstv0p44=4.97516e-09, t_asm_wstv0p46=4.82622e-09, t_asm_wstv0p48=4.67514e-09, t_pre_wstv0p42=2.36362e-09, t_pre_wstv0p44=2.27241e-09, t_pre_wstv0p46=2.18048e-09, t_pre_wstv0p48=2.09106e-09, tq1a=2.12223e-09, tq1b=2.10312e-08, tq2a=2.05492e-09, tq2b=2.02342e-08, tq3a=1.98695e-09, tq3b=1.94308e-08, tq4a=1.92101e-09, tq4b=1.86495e-08, tr1a=1.04052e-08, tr1b=5.13119e-08, tr2a=1.01537e-08, tr2b=4.99549e-08, tr3a=9.87869e-09, tr3b=4.84885e-08, tr4a=9.5976e-09, tr4b=4.69987e-08 | n/a | (none) |
| `ff` | PASS | i_asm_wstv0p42=1.79363e-05, i_asm_wstv0p48=1.96669e-05, i_pre_wstv0p42=2.0551e-05, i_pre_wstv0p48=2.29668e-05, skew_span_asm=1.1139, skew_span_pre=1.16599, slowdown_wstv0p42=2.26088, slowdown_wstv0p44=2.29738, slowdown_wstv0p46=2.33275, slowdown_wstv0p48=2.36659, swing_frac_asm_buf=1.00368, swing_frac_asm_ring=0.852195, swing_frac_pre_buf=1.01125, swing_frac_pre_ring=0.80318, t_asm_wstv0p42=3.64967e-09, t_asm_wstv0p44=3.51882e-09, t_asm_wstv0p46=3.3944e-09, t_asm_wstv0p48=3.27646e-09, t_pre_wstv0p42=1.61426e-09, t_pre_wstv0p44=1.53167e-09, t_pre_wstv0p46=1.45511e-09, t_pre_wstv0p48=1.38446e-09, tq1a=1.5888e-09, tq1b=1.45029e-08, tq2a=1.53595e-09, tq2b=1.37893e-08, tq3a=1.48684e-09, tq3b=1.31277e-08, tq4a=1.44136e-09, tq4b=1.25171e-08, tr1a=7.31067e-09, tr1b=3.6508e-08, tr2a=7.06881e-09, tr2b=3.52194e-08, tr3a=6.83918e-09, tr3b=3.39943e-08, tr4a=6.62203e-09, tr4b=3.28337e-08 | n/a | (none) |

## Result: **PASS**

Overall verdict is PASS only if every corner above individually passed (ngspice exited 0, every parsed `name = value` measurement was a finite number, and -- where the deck writes an `onoise_spectrum` trace -- its max/min ratio cleared the not-flat threshold).

## Links

- Testbench: `sim/post-layout-ro-ring5-assembled/testbench/tb_post_layout_ro_ring5_assembled.spice`
- Runner: `sim/bin/corner-run.py`
- Raw per-corner logs: `sim/post-layout-ro-ring5-assembled/corners/20260906-090413-9109b23/`
- JSON record: `sim/post-layout-ro-ring5-assembled/records/20260906-090413-9109b23.json`

- Author: ci@loom.test
- Timestamp (UTC): 2026-09-06T09:07:34.316542+00:00
- Subset reason: full corner set (tt/ss/ff, this repo's default_corners) run at this PVT point; not a subset
- Supersedes: (none)
