2AMLogic/sky130-trng/sim/post-layout-ro-ring5-assembled-181/records/20261007-232716-ae3832e.md

# 20261007-232716-ae3832e -- post-layout-ro-ring5-assembled-181

**PVT**: -40.0 degC, 1.62 V. **Verdict**: PASS (klt sim status `pass`, 3 corners).
**Compared against (pre-#181, unmodified)**: `20260906-085337-9109b23`.
**Batch job**: `klt-sim-2be9ae6950bf` (c7i.8xlarge, spot), ngspice 46; submitter klt `0.6.0+g46802dd9d592` (the PEX library itself was extracted by the pinned `0.6.0+g5edb557f91d0`).
**Library**: `layout/pex-ring/ro_ring5_assembled_pex.spice` (post-#181, re-extracted under #184). The pre-#181 record ran on macOS/ngspice-46 locally; this one on the Linux fleet (ngspice-46); the unchanged pre-layout control reproduces to 0.00 %, so no environment offset is visible.

| corner | metric | pre-#181 | post-#181 | delta % |
|---|---|---|---|---|
| tt | t_asm_wstv0p42 | 9.13759e-09 | 9.13084e-09 | -0.07 |
| tt | t_asm_wstv0p44 | 8.83446e-09 | 8.82776e-09 | -0.08 |
| tt | t_asm_wstv0p46 | 8.551e-09 | 8.54434e-09 | -0.08 |
| tt | t_asm_wstv0p48 | 8.28571e-09 | 8.2791e-09 | -0.08 |
| tt | t_pre_wstv0p42 | 4.30896e-09 | 4.30896e-09 | -0.00 |
| tt | t_pre_wstv0p44 | 4.13334e-09 | 4.13334e-09 | -0.00 |
| tt | t_pre_wstv0p46 | 3.96896e-09 | 3.96896e-09 | +0.00 |
| tt | t_pre_wstv0p48 | 3.81496e-09 | 3.81497e-09 | +0.00 |
| tt | slowdown_wstv0p42 | 2.1206 | 2.11903 | -0.07 |
| tt | slowdown_wstv0p44 | 2.13736 | 2.13575 | -0.08 |
| tt | slowdown_wstv0p46 | 2.15447 | 2.15279 | -0.08 |
| tt | slowdown_wstv0p48 | 2.1719 | 2.17016 | -0.08 |
| tt | skew_span_asm | 1.10281 | 1.10288 | +0.01 |
| tt | skew_span_pre | 1.12949 | 1.12949 | -0.00 |
| tt | swing_frac_asm_ring | 0.929783 | 0.929836 | +0.01 |
| tt | swing_frac_asm_buf | 1.00489 | 1.00489 | +0.00 |
| tt | swing_frac_pre_ring | 0.912794 | 0.912794 | +0.00 |
| tt | swing_frac_pre_buf | 1.01195 | 1.01195 | +0.00 |
| tt | i_asm_wstv0p42 | 5.55054e-06 | 5.55329e-06 | +0.05 |
| tt | i_asm_wstv0p48 | 6.06022e-06 | 6.0649e-06 | +0.08 |
| tt | i_pre_wstv0p42 | 6.17825e-06 | 6.17825e-06 | -0.00 |
| tt | i_pre_wstv0p48 | 6.87055e-06 | 6.87055e-06 | -0.00 |
| ss | t_asm_wstv0p42 | 1.13824e-08 | 1.13691e-08 | -0.12 |
| ss | t_asm_wstv0p44 | 1.10074e-08 | 1.09952e-08 | -0.11 |
| ss | t_asm_wstv0p46 | 1.06523e-08 | 1.06409e-08 | -0.11 |
| ss | t_asm_wstv0p48 | 1.03178e-08 | 1.03071e-08 | -0.10 |
| ss | t_pre_wstv0p42 | 5.46735e-09 | 5.46735e-09 | -0.00 |
| ss | t_pre_wstv0p44 | 5.25738e-09 | 5.25739e-09 | +0.00 |
| ss | t_pre_wstv0p46 | 5.05833e-09 | 5.05833e-09 | -0.00 |
| ss | t_pre_wstv0p48 | 4.87174e-09 | 4.87174e-09 | +0.00 |
| ss | slowdown_wstv0p42 | 2.08188 | 2.07945 | -0.12 |
| ss | slowdown_wstv0p44 | 2.0937 | 2.09138 | -0.11 |
| ss | slowdown_wstv0p46 | 2.1059 | 2.10365 | -0.11 |
| ss | slowdown_wstv0p48 | 2.11789 | 2.1157 | -0.10 |
| ss | skew_span_asm | 1.10318 | 1.10303 | -0.01 |
| ss | skew_span_pre | 1.12226 | 1.12226 | -0.00 |
| ss | swing_frac_asm_ring | 0.959456 | 0.959454 | -0.00 |
| ss | swing_frac_asm_buf | 1.01306 | 1.01309 | +0.00 |
| ss | swing_frac_pre_ring | 0.954865 | 0.954865 | +0.00 |
| ss | swing_frac_pre_buf | 1.03251 | 1.03251 | +0.00 |
| ss | i_asm_wstv0p42 | 4.50394e-06 | 4.50808e-06 | +0.09 |
| ss | i_asm_wstv0p48 | 4.95788e-06 | 4.96136e-06 | +0.07 |
| ss | i_pre_wstv0p42 | 4.98211e-06 | 4.98211e-06 | +0.00 |
| ss | i_pre_wstv0p48 | 5.53322e-06 | 5.53322e-06 | +0.00 |
| ff | t_asm_wstv0p42 | 7.40001e-09 | 7.39571e-09 | -0.06 |
| ff | t_asm_wstv0p44 | 7.15914e-09 | 7.15434e-09 | -0.07 |
| ff | t_asm_wstv0p46 | 6.93394e-09 | 6.92852e-09 | -0.08 |
| ff | t_asm_wstv0p48 | 6.72297e-09 | 6.71681e-09 | -0.09 |
| ff | t_pre_wstv0p42 | 3.42406e-09 | 3.42406e-09 | +0.00 |
| ff | t_pre_wstv0p44 | 3.27785e-09 | 3.27785e-09 | -0.00 |
| ff | t_pre_wstv0p46 | 3.14119e-09 | 3.14119e-09 | +0.00 |
| ff | t_pre_wstv0p48 | 3.01325e-09 | 3.01325e-09 | +0.00 |
| ff | slowdown_wstv0p42 | 2.16118 | 2.15993 | -0.06 |
| ff | slowdown_wstv0p44 | 2.18409 | 2.18263 | -0.07 |
| ff | slowdown_wstv0p46 | 2.20743 | 2.2057 | -0.08 |
| ff | slowdown_wstv0p48 | 2.23114 | 2.22909 | -0.09 |
| ff | skew_span_asm | 1.10071 | 1.10107 | +0.03 |
| ff | skew_span_pre | 1.13634 | 1.13633 | -0.00 |
| ff | swing_frac_asm_ring | 0.896616 | 0.896632 | +0.00 |
| ff | swing_frac_asm_buf | 1.00308 | 1.00308 | +0.00 |
| ff | swing_frac_pre_ring | 0.866897 | 0.866895 | -0.00 |
| ff | swing_frac_pre_buf | 1.00919 | 1.00919 | -0.00 |
| ff | i_asm_wstv0p42 | 6.84272e-06 | 6.84534e-06 | +0.04 |
| ff | i_asm_wstv0p48 | 7.45477e-06 | 7.4601e-06 | +0.07 |
| ff | i_pre_wstv0p42 | 7.6786e-06 | 7.6786e-06 | -0.00 |
| ff | i_pre_wstv0p48 | 8.53512e-06 | 8.53513e-06 | +0.00 |
