2AMLogic/sky130-trng/sim/post-layout-ro-ring5-assembled-181/records/20261007-232717-ae3832e.md

# 20261007-232717-ae3832e -- post-layout-ro-ring5-assembled-181

**PVT**: 27.0 degC, 1.8 V. **Verdict**: PASS (klt sim status `pass`, 3 corners).
**Compared against (pre-#181, unmodified)**: `20260906-085753-9109b23`.
**Batch job**: `klt-sim-6169cb3e9a0a` (c7i.8xlarge, spot), ngspice 46; submitter klt `0.6.0+g46802dd9d592` (the PEX library itself was extracted by the pinned `0.6.0+g5edb557f91d0`).
**Library**: `layout/pex-ring/ro_ring5_assembled_pex.spice` (post-#181, re-extracted under #184). The pre-#181 record ran on macOS/ngspice-46 locally; this one on the Linux fleet (ngspice-46); the unchanged pre-layout control reproduces to 0.00 %, so no environment offset is visible.

| corner | metric | pre-#181 | post-#181 | delta % |
|---|---|---|---|---|
| tt | t_asm_wstv0p42 | 6.44677e-09 | 6.44214e-09 | -0.07 |
| tt | t_asm_wstv0p44 | 6.16533e-09 | 6.16076e-09 | -0.07 |
| tt | t_asm_wstv0p46 | 5.90873e-09 | 5.90423e-09 | -0.08 |
| tt | t_asm_wstv0p48 | 5.67343e-09 | 5.66897e-09 | -0.08 |
| tt | t_pre_wstv0p42 | 2.91377e-09 | 2.91378e-09 | +0.00 |
| tt | t_pre_wstv0p44 | 2.74998e-09 | 2.74999e-09 | +0.00 |
| tt | t_pre_wstv0p46 | 2.60128e-09 | 2.60128e-09 | +0.00 |
| tt | t_pre_wstv0p48 | 2.46585e-09 | 2.46585e-09 | -0.00 |
| tt | slowdown_wstv0p42 | 2.21252 | 2.21092 | -0.07 |
| tt | slowdown_wstv0p44 | 2.24195 | 2.24029 | -0.07 |
| tt | slowdown_wstv0p46 | 2.27147 | 2.26974 | -0.08 |
| tt | slowdown_wstv0p48 | 2.3008 | 2.299 | -0.08 |
| tt | skew_span_asm | 1.13631 | 1.13638 | +0.01 |
| tt | skew_span_pre | 1.18165 | 1.18166 | +0.00 |
| tt | swing_frac_asm_ring | 0.890579 | 0.89071 | +0.01 |
| tt | swing_frac_asm_buf | 1.00287 | 1.00287 | +0.00 |
| tt | swing_frac_pre_ring | 0.850155 | 0.850151 | -0.00 |
| tt | swing_frac_pre_buf | 1.00898 | 1.00898 | -0.00 |
| tt | i_asm_wstv0p42 | 9.53694e-06 | 9.54693e-06 | +0.10 |
| tt | i_asm_wstv0p48 | 1.06802e-05 | 1.06894e-05 | +0.09 |
| tt | i_pre_wstv0p42 | 1.09578e-05 | 1.09578e-05 | -0.00 |
| tt | i_pre_wstv0p48 | 1.24866e-05 | 1.24866e-05 | -0.00 |
| ss | t_asm_wstv0p42 | 7.89936e-09 | 7.8937e-09 | -0.07 |
| ss | t_asm_wstv0p44 | 7.53384e-09 | 7.52778e-09 | -0.08 |
| ss | t_asm_wstv0p46 | 7.20434e-09 | 7.19826e-09 | -0.08 |
| ss | t_asm_wstv0p48 | 6.90517e-09 | 6.89938e-09 | -0.08 |
| ss | t_pre_wstv0p42 | 3.61566e-09 | 3.61566e-09 | +0.00 |
| ss | t_pre_wstv0p44 | 3.41594e-09 | 3.41595e-09 | +0.00 |
| ss | t_pre_wstv0p46 | 3.23632e-09 | 3.23632e-09 | +0.00 |
| ss | t_pre_wstv0p48 | 3.07384e-09 | 3.07384e-09 | +0.00 |
| ss | slowdown_wstv0p42 | 2.18476 | 2.1832 | -0.07 |
| ss | slowdown_wstv0p44 | 2.2055 | 2.20372 | -0.08 |
| ss | slowdown_wstv0p46 | 2.22609 | 2.22421 | -0.08 |
| ss | slowdown_wstv0p48 | 2.24643 | 2.24455 | -0.08 |
| ss | skew_span_asm | 1.14398 | 1.14412 | +0.01 |
| ss | skew_span_pre | 1.17627 | 1.17627 | +0.00 |
| ss | swing_frac_asm_ring | 0.916418 | 0.916468 | +0.01 |
| ss | swing_frac_asm_buf | 1.00315 | 1.00316 | +0.00 |
| ss | swing_frac_pre_ring | 0.883735 | 0.883733 | -0.00 |
| ss | swing_frac_pre_buf | 1.0094 | 1.0094 | +0.00 |
| ss | i_asm_wstv0p42 | 7.59349e-06 | 7.60062e-06 | +0.09 |
| ss | i_asm_wstv0p48 | 8.58511e-06 | 8.59363e-06 | +0.10 |
| ss | i_pre_wstv0p42 | 8.66713e-06 | 8.66713e-06 | +0.00 |
| ss | i_pre_wstv0p48 | 9.92409e-06 | 9.92408e-06 | -0.00 |
| ff | t_asm_wstv0p42 | 5.3918e-09 | 5.38769e-09 | -0.08 |
| ff | t_asm_wstv0p44 | 5.17115e-09 | 5.16669e-09 | -0.09 |
| ff | t_asm_wstv0p46 | 4.96794e-09 | 4.96301e-09 | -0.10 |
| ff | t_asm_wstv0p48 | 4.77997e-09 | 4.77449e-09 | -0.11 |
| ff | t_pre_wstv0p42 | 2.43672e-09 | 2.43672e-09 | -0.00 |
| ff | t_pre_wstv0p44 | 2.29898e-09 | 2.29898e-09 | -0.00 |
| ff | t_pre_wstv0p46 | 2.17259e-09 | 2.1726e-09 | +0.00 |
| ff | t_pre_wstv0p48 | 2.05643e-09 | 2.05644e-09 | +0.00 |
| ff | slowdown_wstv0p42 | 2.21273 | 2.21104 | -0.08 |
| ff | slowdown_wstv0p44 | 2.24932 | 2.24738 | -0.09 |
| ff | slowdown_wstv0p46 | 2.28665 | 2.28437 | -0.10 |
| ff | slowdown_wstv0p48 | 2.3244 | 2.32173 | -0.11 |
| ff | skew_span_asm | 1.128 | 1.12843 | +0.04 |
| ff | skew_span_pre | 1.18493 | 1.18492 | -0.00 |
| ff | swing_frac_asm_ring | 0.866075 | 0.866232 | +0.02 |
| ff | swing_frac_asm_buf | 1.00243 | 1.00243 | +0.00 |
| ff | swing_frac_pre_ring | 0.821241 | 0.821239 | -0.00 |
| ff | swing_frac_pre_buf | 1.00781 | 1.00781 | -0.00 |
| ff | i_asm_wstv0p42 | 1.19727e-05 | 1.19819e-05 | +0.08 |
| ff | i_asm_wstv0p48 | 1.33054e-05 | 1.33213e-05 | +0.12 |
| ff | i_pre_wstv0p42 | 1.38381e-05 | 1.38381e-05 | -0.00 |
| ff | i_pre_wstv0p48 | 1.56675e-05 | 1.56675e-05 | -0.00 |
