2AMLogic/sky130-trng/sim/post-layout-ro-ring5-assembled-181/records/20261007-232718-ae3832e.md

# 20261007-232718-ae3832e -- post-layout-ro-ring5-assembled-181

**PVT**: 125.0 degC, 1.98 V. **Verdict**: PASS (klt sim status `pass`, 3 corners).
**Compared against (pre-#181, unmodified)**: `20260906-090102-9109b23`.
**Batch job**: `klt-sim-4f3a2c51a3e5` (c7i.8xlarge, spot), ngspice 46; submitter klt `0.6.0+g46802dd9d592` (the PEX library itself was extracted by the pinned `0.6.0+g5edb557f91d0`).
**Library**: `layout/pex-ring/ro_ring5_assembled_pex.spice` (post-#181, re-extracted under #184). The pre-#181 record ran on macOS/ngspice-46 locally; this one on the Linux fleet (ngspice-46); the unchanged pre-layout control reproduces to 0.00 %, so no environment offset is visible.

| corner | metric | pre-#181 | post-#181 | delta % |
|---|---|---|---|---|
| tt | t_asm_wstv0p42 | 6.02636e-09 | 6.02297e-09 | -0.06 |
| tt | t_asm_wstv0p44 | 5.71437e-09 | 5.71106e-09 | -0.06 |
| tt | t_asm_wstv0p46 | 5.43491e-09 | 5.43169e-09 | -0.06 |
| tt | t_asm_wstv0p48 | 5.18238e-09 | 5.17924e-09 | -0.06 |
| tt | t_pre_wstv0p42 | 2.74732e-09 | 2.74732e-09 | +0.00 |
| tt | t_pre_wstv0p44 | 2.55307e-09 | 2.55306e-09 | -0.00 |
| tt | t_pre_wstv0p46 | 2.37791e-09 | 2.37791e-09 | -0.00 |
| tt | t_pre_wstv0p48 | 2.219e-09 | 2.219e-09 | +0.00 |
| tt | slowdown_wstv0p42 | 2.19354 | 2.19231 | -0.06 |
| tt | slowdown_wstv0p44 | 2.23824 | 2.23695 | -0.06 |
| tt | slowdown_wstv0p46 | 2.28558 | 2.28423 | -0.06 |
| tt | slowdown_wstv0p48 | 2.33546 | 2.33405 | -0.06 |
| tt | skew_span_asm | 1.16285 | 1.16291 | +0.00 |
| tt | skew_span_pre | 1.23809 | 1.23809 | +0.00 |
| tt | swing_frac_asm_ring | 0.859879 | 0.860098 | +0.03 |
| tt | swing_frac_asm_buf | 1.00118 | 1.00118 | +0.00 |
| tt | swing_frac_pre_ring | 0.80372 | 0.80372 | -0.00 |
| tt | swing_frac_pre_buf | 1.0044 | 1.0044 | -0.00 |
| tt | i_asm_wstv0p42 | 1.37948e-05 | 1.38054e-05 | +0.08 |
| tt | i_asm_wstv0p48 | 1.57532e-05 | 1.57633e-05 | +0.06 |
| tt | i_pre_wstv0p42 | 1.62467e-05 | 1.62467e-05 | -0.00 |
| tt | i_pre_wstv0p48 | 1.89011e-05 | 1.89011e-05 | +0.00 |
| ss | t_asm_wstv0p42 | 7.26169e-09 | 7.26146e-09 | -0.00 |
| ss | t_asm_wstv0p44 | 6.83906e-09 | 6.8375e-09 | -0.02 |
| ss | t_asm_wstv0p46 | 6.46974e-09 | 6.4678e-09 | -0.03 |
| ss | t_asm_wstv0p48 | 6.14235e-09 | 6.14056e-09 | -0.03 |
| ss | t_pre_wstv0p42 | 3.25971e-09 | 3.25971e-09 | -0.00 |
| ss | t_pre_wstv0p44 | 3.01705e-09 | 3.01705e-09 | -0.00 |
| ss | t_pre_wstv0p46 | 2.80439e-09 | 2.80438e-09 | -0.00 |
| ss | t_pre_wstv0p48 | 2.61597e-09 | 2.61598e-09 | +0.00 |
| ss | slowdown_wstv0p42 | 2.22771 | 2.22764 | -0.00 |
| ss | slowdown_wstv0p44 | 2.26681 | 2.26629 | -0.02 |
| ss | slowdown_wstv0p46 | 2.30701 | 2.30632 | -0.03 |
| ss | slowdown_wstv0p48 | 2.34802 | 2.34733 | -0.03 |
| ss | skew_span_asm | 1.18223 | 1.18254 | +0.03 |
| ss | skew_span_pre | 1.24608 | 1.24608 | -0.00 |
| ss | swing_frac_asm_ring | 0.880116 | 0.880212 | +0.01 |
| ss | swing_frac_asm_buf | 1.00199 | 1.00199 | -0.00 |
| ss | swing_frac_pre_ring | 0.825054 | 0.825056 | +0.00 |
| ss | swing_frac_pre_buf | 1.00679 | 1.00679 | +0.00 |
| ss | i_asm_wstv0p42 | 1.08235e-05 | 1.08256e-05 | +0.02 |
| ss | i_asm_wstv0p48 | 1.25239e-05 | 1.25295e-05 | +0.04 |
| ss | i_pre_wstv0p42 | 1.27805e-05 | 1.27805e-05 | -0.00 |
| ss | i_pre_wstv0p48 | 1.50589e-05 | 1.50589e-05 | +0.00 |
| ff | t_asm_wstv0p42 | 5.12748e-09 | 5.12194e-09 | -0.11 |
| ff | t_asm_wstv0p44 | 4.88952e-09 | 4.88353e-09 | -0.12 |
| ff | t_asm_wstv0p46 | 4.67316e-09 | 4.66666e-09 | -0.14 |
| ff | t_asm_wstv0p48 | 4.47535e-09 | 4.46827e-09 | -0.16 |
| ff | t_pre_wstv0p42 | 2.40277e-09 | 2.40277e-09 | -0.00 |
| ff | t_pre_wstv0p44 | 2.24602e-09 | 2.24602e-09 | +0.00 |
| ff | t_pre_wstv0p46 | 2.10206e-09 | 2.10205e-09 | -0.00 |
| ff | t_pre_wstv0p48 | 1.96918e-09 | 1.96918e-09 | +0.00 |
| ff | slowdown_wstv0p42 | 2.13398 | 2.13168 | -0.11 |
| ff | slowdown_wstv0p44 | 2.17697 | 2.17431 | -0.12 |
| ff | slowdown_wstv0p46 | 2.22314 | 2.22005 | -0.14 |
| ff | slowdown_wstv0p48 | 2.2727 | 2.2691 | -0.16 |
| ff | skew_span_asm | 1.14572 | 1.14629 | +0.05 |
| ff | skew_span_pre | 1.22019 | 1.22019 | -0.00 |
| ff | swing_frac_asm_ring | 0.836999 | 0.837331 | +0.04 |
| ff | swing_frac_asm_buf | 0.997949 | 0.997966 | +0.00 |
| ff | swing_frac_pre_ring | 0.782289 | 0.782288 | -0.00 |
| ff | swing_frac_pre_buf | 0.998543 | 0.998545 | +0.00 |
| ff | i_asm_wstv0p42 | 1.75931e-05 | 1.76157e-05 | +0.13 |
| ff | i_asm_wstv0p48 | 1.97842e-05 | 1.98218e-05 | +0.19 |
| ff | i_pre_wstv0p42 | 2.03438e-05 | 2.03438e-05 | +0.00 |
| ff | i_pre_wstv0p48 | 2.3351e-05 | 2.3351e-05 | -0.00 |
