2AMLogic/sky130-trng/sim/post-layout-ro-ring5-assembled-181/records/20261007-232719-ae3832e.md

# 20261007-232719-ae3832e -- post-layout-ro-ring5-assembled-181

**PVT**: -40.0 degC, 1.98 V. **Verdict**: PASS (klt sim status `pass`, 3 corners).
**Compared against (pre-#181, unmodified)**: `20260906-090413-9109b23`.
**Batch job**: `klt-sim-acce3e1a1e4e` (c7i.8xlarge, spot), ngspice 46; submitter klt `0.6.0+g46802dd9d592` (the PEX library itself was extracted by the pinned `0.6.0+g5edb557f91d0`).
**Library**: `layout/pex-ring/ro_ring5_assembled_pex.spice` (post-#181, re-extracted under #184). The pre-#181 record ran on macOS/ngspice-46 locally; this one on the Linux fleet (ngspice-46); the unchanged pre-layout control reproduces to 0.00 %, so no environment offset is visible.

| corner | metric | pre-#181 | post-#181 | delta % |
|---|---|---|---|---|
| tt | t_asm_wstv0p42 | 4.31564e-09 | 4.31085e-09 | -0.11 |
| tt | t_asm_wstv0p44 | 4.16897e-09 | 4.16423e-09 | -0.11 |
| tt | t_asm_wstv0p46 | 4.02611e-09 | 4.02142e-09 | -0.12 |
| tt | t_asm_wstv0p48 | 3.88876e-09 | 3.88414e-09 | -0.12 |
| tt | t_pre_wstv0p42 | 1.94462e-09 | 1.94462e-09 | -0.00 |
| tt | t_pre_wstv0p44 | 1.85317e-09 | 1.85317e-09 | +0.00 |
| tt | t_pre_wstv0p46 | 1.76695e-09 | 1.76695e-09 | +0.00 |
| tt | t_pre_wstv0p48 | 1.68639e-09 | 1.68639e-09 | +0.00 |
| tt | slowdown_wstv0p42 | 2.21927 | 2.2168 | -0.11 |
| tt | slowdown_wstv0p44 | 2.24964 | 2.24708 | -0.11 |
| tt | slowdown_wstv0p46 | 2.27857 | 2.27591 | -0.12 |
| tt | slowdown_wstv0p48 | 2.30597 | 2.30322 | -0.12 |
| tt | skew_span_asm | 1.10977 | 1.10986 | +0.01 |
| tt | skew_span_pre | 1.15313 | 1.15312 | -0.00 |
| tt | swing_frac_asm_ring | 0.883972 | 0.884139 | +0.02 |
| tt | swing_frac_asm_buf | 1.00411 | 1.00412 | +0.00 |
| tt | swing_frac_pre_ring | 0.84463 | 0.844627 | -0.00 |
| tt | swing_frac_pre_buf | 1.01221 | 1.0122 | -0.00 |
| tt | i_asm_wstv0p42 | 1.48147e-05 | 1.48348e-05 | +0.14 |
| tt | i_asm_wstv0p48 | 1.61951e-05 | 1.62187e-05 | +0.15 |
| tt | i_pre_wstv0p42 | 1.68439e-05 | 1.68439e-05 | +0.00 |
| tt | i_pre_wstv0p48 | 1.87697e-05 | 1.87697e-05 | -0.00 |
| ss | t_asm_wstv0p42 | 5.11334e-09 | 5.10025e-09 | -0.26 |
| ss | t_asm_wstv0p44 | 4.97516e-09 | 4.96476e-09 | -0.21 |
| ss | t_asm_wstv0p46 | 4.82622e-09 | 4.81735e-09 | -0.18 |
| ss | t_asm_wstv0p48 | 4.67514e-09 | 4.66719e-09 | -0.17 |
| ss | t_pre_wstv0p42 | 2.36362e-09 | 2.36362e-09 | +0.00 |
| ss | t_pre_wstv0p44 | 2.27241e-09 | 2.27241e-09 | -0.00 |
| ss | t_pre_wstv0p46 | 2.18048e-09 | 2.18048e-09 | -0.00 |
| ss | t_pre_wstv0p48 | 2.09106e-09 | 2.09106e-09 | +0.00 |
| ss | slowdown_wstv0p42 | 2.16336 | 2.15781 | -0.26 |
| ss | slowdown_wstv0p44 | 2.18937 | 2.1848 | -0.21 |
| ss | slowdown_wstv0p46 | 2.21337 | 2.2093 | -0.18 |
| ss | slowdown_wstv0p48 | 2.23577 | 2.23197 | -0.17 |
| ss | skew_span_asm | 1.09373 | 1.09279 | -0.09 |
| ss | skew_span_pre | 1.13034 | 1.13034 | +0.00 |
| ss | swing_frac_asm_ring | 0.918478 | 0.918764 | +0.03 |
| ss | swing_frac_asm_buf | 1.00461 | 1.00463 | +0.00 |
| ss | swing_frac_pre_ring | 0.892074 | 0.892073 | -0.00 |
| ss | swing_frac_pre_buf | 1.01297 | 1.01297 | +0.00 |
| ss | i_asm_wstv0p42 | 1.2454e-05 | 1.24991e-05 | +0.36 |
| ss | i_asm_wstv0p48 | 1.34346e-05 | 1.34586e-05 | +0.18 |
| ss | i_pre_wstv0p42 | 1.40329e-05 | 1.40329e-05 | -0.00 |
| ss | i_pre_wstv0p48 | 1.54077e-05 | 1.54077e-05 | -0.00 |
| ff | t_asm_wstv0p42 | 3.64967e-09 | 3.64703e-09 | -0.07 |
| ff | t_asm_wstv0p44 | 3.51882e-09 | 3.51596e-09 | -0.08 |
| ff | t_asm_wstv0p46 | 3.3944e-09 | 3.39129e-09 | -0.09 |
| ff | t_asm_wstv0p48 | 3.27646e-09 | 3.2731e-09 | -0.10 |
| ff | t_pre_wstv0p42 | 1.61426e-09 | 1.61427e-09 | +0.00 |
| ff | t_pre_wstv0p44 | 1.53167e-09 | 1.53167e-09 | +0.00 |
| ff | t_pre_wstv0p46 | 1.45511e-09 | 1.45511e-09 | +0.00 |
| ff | t_pre_wstv0p48 | 1.38446e-09 | 1.38447e-09 | +0.00 |
| ff | slowdown_wstv0p42 | 2.26088 | 2.25925 | -0.07 |
| ff | slowdown_wstv0p44 | 2.29738 | 2.2955 | -0.08 |
| ff | slowdown_wstv0p46 | 2.33275 | 2.33061 | -0.09 |
| ff | slowdown_wstv0p48 | 2.36659 | 2.36416 | -0.10 |
| ff | skew_span_asm | 1.1139 | 1.11424 | +0.03 |
| ff | skew_span_pre | 1.16599 | 1.16598 | -0.00 |
| ff | swing_frac_asm_ring | 0.852195 | 0.85234 | +0.02 |
| ff | swing_frac_asm_buf | 1.00368 | 1.00369 | +0.00 |
| ff | swing_frac_pre_ring | 0.80318 | 0.803183 | +0.00 |
| ff | swing_frac_pre_buf | 1.01125 | 1.01126 | +0.00 |
| ff | i_asm_wstv0p42 | 1.79363e-05 | 1.79511e-05 | +0.08 |
| ff | i_asm_wstv0p48 | 1.96669e-05 | 1.96908e-05 | +0.12 |
| ff | i_pre_wstv0p42 | 2.0551e-05 | 2.0551e-05 | -0.00 |
| ff | i_pre_wstv0p48 | 2.29668e-05 | 2.29668e-05 | -0.00 |
