2AMLogic/sky130-trng/sim/ro-array-operating-point/records/20260825-093740-53f1f7a.md

# 20260825-093740-53f1f7a -- ro-array-operating-point

**Claim**: the XOR combining tree's own measured bandwidth ceiling on array size `N`, crossed against DR-0002's entropy sizing law re-evaluated at the buffer-loaded ring period; the resulting chosen operating point (`N`, `T_s`, raw rate).

**Level**: transistor (derived -- this record introduces no new simulation; it is arithmetic over the cited transistor-level records)
**Seed**: N/A (deterministic reduction; the underlying runs state their own seeds)
**Analysis**: `sim/ro-array-operating-point/analysis/operating-point.py` (re-run to reproduce)

## Source records

Combining bandwidth (`sim/xor-combining-bandwidth/records/`):

- `20260825-084511-53f1f7a`
- `20260825-084649-53f1f7a`
- `20260825-084826-53f1f7a`

Ring swing/current, loaded period (`sim/ro-ring5-swing-and-current/records/`):

- `20260825-085315-53f1f7a`
- `20260825-085402-53f1f7a`
- `20260825-085449-53f1f7a`
- `20260825-085537-53f1f7a`

Array sizing (`sim/ro-array-sizing/records/`):

- `20260825-071619-54f5715`

---
## Combining upper bound: N_max_combine(point) = floor(T_0_loaded / (2 * w_90))

Evaluated at every (temp, Vdd, process corner) point both `sim/xor-combining-bandwidth/` and `sim/ro-ring5-swing-and-current/` cover:

| T (degC) | Vdd (V) | corner | `w_90` (ps) | `T_0` loaded (ns) | `N_max_combine` |
|---|---|---|---|---|---|
| -40 | 1.62 | `ff` | 166.04 | 3.4244 | 10.312 (floor **10**) |
| -40 | 1.62 | `ss` | 241.31 | 5.4686 | 11.331 (floor **11**) |
| -40 | 1.62 | `tt` | 190.86 | 4.3094 | 11.289 (floor **11**) |
| -40 | 1.98 | `ff` | 121.99 | 1.6148 | 6.619 (floor **6**) |
| -40 | 1.98 | `ss` | 163.86 | 2.3642 | 7.214 (floor **7**) |
| -40 | 1.98 | `tt` | 134.01 | 1.9451 | 7.257 (floor **7**) |
| 27 | 1.8 | `ff` | 133.24 | 2.4381 | 9.149 (floor **9**) |
| 27 | 1.8 | `ss` | 186.34 | 3.6173 | 9.706 (floor **9**) |
| 27 | 1.8 | `tt` | 163.36 | 2.9150 | 8.922 (floor **8**) |

**Tightest (worst-case) combining bound: `N <= 6`**, binding at ff / -40 degC / 1.98 V -- the fastest loaded ring in this matched grid, not the entropy-binding corner. This bound is independent of `T_s`: it is a hardware fact of the ring speed and the combining gate, so no sample-clock choice relaxes it.

## Entropy lower bound, re-evaluated against the LOADED period

Entropy-binding corner (DR-0002 / `sim/ro-array-sizing/`): **ss / -40 degC / 1.62 V**, `sigma_1` = 3.5479 ps, unloaded `T_0` = 4.8225 ns.

Loaded `T_0` at that corner (`sim/ro-ring5-swing-and-current/`, `20260825-085315-53f1f7a`): **5.4686 ns** (13.4% slower than unloaded), a `0.686x` reduction in `Q_ring` at fixed `T_s` (`Q` scales as `1/T_0^3`). This is the extra load a real output buffer plus the array's own combining-tree fan-in puts on the ring node, and it is used here because it is the loading `ro_array_core.sch` actually has, not the unloaded number DR-0002 measured on a bare ring.

`Q_ring_loaded(T_s) = sigma_1^2 * T_s / T_0_loaded^3`, requirement `Q_array >= M*Q_H0` = 0.005946.

## Crossing the two bounds: where the raw-rate row has to sit

`N_min_entropy` grows as `T_s` shrinks; `N_max_combine` does not move at all. They cross, and where they cross is a hard ceiling on the raw rate no array size can get past:

| raw rate | `T_s` | entropy wants `N >=` | combining allows `N <=` (6) | verdict |
|---|---|---|---|---|
| 10 Mbps | 0.100 us | 773 | 6 | IMPOSSIBLE |
| 1 Mbps | 1.000 us | 78 | 6 | IMPOSSIBLE |
| 100 kbps | 10.000 us | 8 | 6 | IMPOSSIBLE |
| combining ceiling | 12.875 us | 7 | 6 | IMPOSSIBLE |
| 50 kbps (chosen) | 20.000 us | 4 | 6 | OK |
| 10 kbps | 100.000 us | 1 | 6 | OK |

**Chosen operating point**: `N = 4` (the largest power of two clearing `N <= 6` with margin, so the combining tree stays a balanced binary tree). The smallest `T_s` at which `N = 4` clears the entropy requirement is `19.314 us` (`51.78 kbps`); rounding up for margin gives `T_s = 20 us` (`50 kbps`, `Q_array` = 0.006157, `1.036x` the requirement).

---

- Author: loom-builder@sky130-trng
- Timestamp (UTC): 2026-08-25T09:37:40.230983+00:00
- Repo commit: `53f1f7a`
- Supersedes: (none)
