2AMLogic/sky130-trng/signoff/characterization-report.md

# Characterization report (T1 item 8)

GENERATED by `sim/bin/characterization_report.py` -- do not edit; CI regenerates and byte-diffs it.

Simulation-derived and provisional until measured on silicon. Aggregates committed records only; never upgrades a verdict.

**Overall: fail** -- 6 met, 3 unmet, 1 not measured of 10 spec targets.

| Parameter | Target | Verdict | PVT coverage | Evidence (record id, sha256) |
|---|---|---|---|---|
| Entropy source | N-way array of independent free-running ring oscillators, XOR-combined ahead of a single sampler; N re-sized from a jitter budget at the entropy-binding corner | **met** | ff -40C 1.62V, ff -40C 1.98V, ff 27C 1.8V, ss -40C 1.62V, ss -40C 1.98V, ss 27C 1.8V, tt -40C 1.62V, tt -40C 1.98V, tt 27C 1.8V | `20260825-093740-53f1f7a` `442b600f9b10b815` met<br>`20260825-093740-53f1f7a` `442b600f9b10b815` met |
| Raw rate | > 1 Mbps sustained at the raw tap, binding at the slowest-RO corner | **unmet** | ff -40C 1.62V, ff -40C 1.98V, ff 27C 1.8V, ss -40C 1.62V, ss -40C 1.98V, ss 27C 1.8V, tt -40C 1.62V, tt -40C 1.98V, tt 27C 1.8V | `20260825-093740-53f1f7a` `442b600f9b10b815` unmet |
| Raw min-entropy per bit | H₀ = 0.5 bit/sample as a design *target* at the entropy-binding corner — a sizing input, not a claim, until measured | **unmet** | ff -40C 1.62V, ff -40C 1.98V, ff 125C 1.62V, ff 125C 1.8V, ff 125C 1.98V, ff 27C 1.8V, ss -40C 1.62V, ss -40C 1.98V, ss 125C 1.62V, ss 125C 1.8V, ss 125C 1.98V, ss 27C 1.8V, tt -40C 1.62V, tt -40C 1.98V, tt 125C 1.62V, tt 125C 1.8V, tt 125C 1.98V, tt 27C 1.8V | `20261010-102516-3966094` `8cfdaea360f15506` met<br>`20261009-111125-e57ad27` `ba4631b09991b383` met<br>`20261009-111126-e57ad27` `8edc16338c64f9ef` met<br>`20261009-111127-e57ad27` `d505ce4b328caf86` unmet |
| Quality | designed-for-SP 800-90B (raw access + RCT/APT + entropy-source model); validation deferred to measured silicon | **met** | none | `20260905-192548-2ecb0a3` `aa792618bbdff957` met<br>`20260905-192548-2ecb0a3` `aa792618bbdff957` met<br>`20260905-192548-2ecb0a3` `aa792618bbdff957` met |
| Conditioning | non-vetted CRC-32 LFSR compression, K = 8 (256 raw bits in : one 32-bit word out) | **met** | none | `20260905-192506-2ecb0a3` `883fb254c43cc628` met |
| Health tests | continuous RCT + APT on the raw stream; cutoffs re-derived from sky130 noise/leakage corners, not copied from gf180 | **met** | ff -40C 1.62V, ff -40C 1.98V, ff 125C 1.62V, ff 125C 1.8V, ff 125C 1.98V, ff 27C 1.8V, ss -40C 1.62V, ss -40C 1.98V, ss 125C 1.62V, ss 125C 1.8V, ss 125C 1.98V, ss 27C 1.8V, tt -40C 1.62V, tt -40C 1.98V, tt 125C 1.62V, tt 125C 1.8V, tt 125C 1.98V, tt 27C 1.8V | `20261008-150251-cd45d91` `4a8c35d7694ccf2f` met<br>`20261008-150251-cd45d91` `4a8c35d7694ccf2f` met<br>`20261008-150251-cd45d91` `4a8c35d7694ccf2f` met |
| Power | < 500 µW active; idle target set after a sky130 leakage survey | **not measured** | none | none |
| Area | < 0.05 mm² | **unmet** | none | `20261009-214736-760b4d3` `8c145673c26a2d41` unmet<br>`20261010-105914-824542d` `eec70ff620edb501` unmet |
| Operating envelope | −40 … +125 °C; supply per sky130 device flavor (1.8 V core, 3.3 V I/O devices available) — confirm before ratification | **met** | -40C 1.62V, -40C 1.98V, 125C 1.62V, 125C 1.8V, 125C 1.98V, 27C 1.8V | `20260825-094545-53f1f7a` `e547063c9d0ecd1a` met<br>`20260825-094718-53f1f7a` `1c39173f0840efa2` met<br>`20260825-094856-53f1f7a` `44a0e662eda22d9a` met<br>`20261008-135355-847b454` `7b4b18e14778f74f` met<br>`20261008-135356-847b454` `6e066ccad849983c` met<br>`20261008-135357-847b454` `4ab61f892e6b2112` met |
| Interface | streaming, mode-selectable raw / conditioned; raw access always available and never gated | **met** | none | `20260905-192519-2ecb0a3` `c8029bdf6c1b053d` met<br>`20261009-120511-d9f51a4` `2b3b2f30463e641c` met<br>`20260905-192548-2ecb0a3` `aa792618bbdff957` met |

## Per-row evidence

### Entropy source: met

- `sim/ro-array-operating-point/records/20260825-093740-53f1f7a.json`
  - check: array re-sized to N == 4 from the jitter budget at the entropy-binding corner (ss, -40 C, 1.62 V)
  - verdict: met (observed 4)
  - record id `20260825-093740-53f1f7a`, level 'transistor (derived)', sha256 `442b600f9b10b8150237951bed8bd5e2ac5837661a6778e9a78b33dcc25caa75`
- `sim/ro-array-operating-point/records/20260825-093740-53f1f7a.json`
  - check: N = 4 does not exceed the XOR-combining limit n_max_combine at any sized corner
  - verdict: met (observed 6.61861699235126)
  - record id `20260825-093740-53f1f7a`, level 'transistor (derived)', sha256 `442b600f9b10b8150237951bed8bd5e2ac5837661a6778e9a78b33dcc25caa75`

### Raw rate: unmet

- `sim/ro-array-operating-point/records/20260825-093740-53f1f7a.json`
  - check: chosen sampling period t_s <= 1e-6 s (>= 1 Mbps)
  - verdict: unmet (observed 2e-05)
  - record id `20260825-093740-53f1f7a`, level 'transistor (derived)', sha256 `442b600f9b10b8150237951bed8bd5e2ac5837661a6778e9a78b33dcc25caa75`

### Raw min-entropy per bit: unmet

- `sim/raw-bit-min-entropy/records/20261010-102516-3966094.json`
  - check: worst-corner h_min >= 0.5 bit/sample at Ts = 20 us (behavioural model, independence assumed by construction; DR-0010 row 3 open on #221)
  - verdict: met (observed 0.6674109338172481)
  - record id `20261010-102516-3966094`, level 'behavioral (derived)', sha256 `8cfdaea360f1550620e221e9e0a50c1aef72459ec49b3b3b297eb4b914d43279`
- `sim/local-mismatch-monte-carlo/records/20261009-111125-e57ad27.json`
  - check: worst array x sampler pairing H_bias >= 0.5 bit/sample (transistor-level local-mismatch MC, static bias only; DR-0010 row 3 open on #221)
  - verdict: met (observed 0.679950493450846)
  - record id `20261009-111125-e57ad27`, level 'transistor', sha256 `ba4631b09991b383e8916990be71771d55c761b5d718b5bab70d4b0b92c027e6`
- `sim/local-mismatch-monte-carlo/records/20261009-111126-e57ad27.json`
  - check: worst array x sampler pairing H_bias >= 0.5 bit/sample (transistor-level local-mismatch MC, static bias only; DR-0010 row 3 open on #221)
  - verdict: met (observed 0.6425427630107089)
  - record id `20261009-111126-e57ad27`, level 'transistor', sha256 `8edc16338c64f9efe2c5141d9f496742b6241e09a50191fbd07f684dd3faec13`
- `sim/local-mismatch-monte-carlo/records/20261009-111127-e57ad27.json`
  - check: worst array x sampler pairing H_bias >= 0.5 bit/sample (transistor-level local-mismatch MC, static bias only; DR-0010 row 3 open on #221)
  - verdict: unmet (observed 0.47180709030319024)
  - record id `20261009-111127-e57ad27`, level 'transistor', sha256 `d505ce4b328caf86d2a37b96b8948848665f9a1e133b246f36fc5f9225cd7c82`

### Quality: met

- `sim/digital-section-behavioral/records/20260905-192548-2ecb0a3.json`
  - check: raw words stay readable while the conditioned path is gated on an alarm (experiment F, >= 1 raw word read while gated)
  - verdict: met (observed 4)
  - record id `20260905-192548-2ecb0a3`, level 'behavioral', sha256 `aa792618bbdff957570072739cb1efca6ad917088e95f6e77cfcf1c4569de665`
- `sim/digital-section-behavioral/records/20260905-192548-2ecb0a3.json`
  - check: RCT trips at the expected sample on a stuck source (experiment B ok)
  - verdict: met (observed True)
  - record id `20260905-192548-2ecb0a3`, level 'behavioral', sha256 `aa792618bbdff957570072739cb1efca6ad917088e95f6e77cfcf1c4569de665`
- `sim/digital-section-behavioral/records/20260905-192548-2ecb0a3.json`
  - check: APT trips on a biased source (experiment C ok)
  - verdict: met (observed True)
  - record id `20260905-192548-2ecb0a3`, level 'behavioral', sha256 `aa792618bbdff957570072739cb1efca6ad917088e95f6e77cfcf1c4569de665`

### Conditioning: met

- `sim/digital-conditioner-equivalence/records/20260905-192506-2ecb0a3.json`
  - check: CRC-32 LFSR model bit-exact vs independent references (ok == true)
  - verdict: met (observed True)
  - record id `20260905-192506-2ecb0a3`, level 'behavioral', sha256 `883fb254c43cc628165ec0c6f0457c6e28b470410cd564d53e7a51c9438e86d6`

### Health tests: met

- `sim/digital-health-test-parameters/records/20261008-150251-cd45d91.json`
  - check: no false alarms: ratified RCT/APT cutoffs raise 0 alarms replayed over the simulated streams (CONDITIONAL: cutoffs depend on DR-0010 row 3 / #221; replays streams 20261008-061809-56e0fb7, superseded by 20261010-095913-3966094)
  - verdict: met (observed 0)
  - record id `20261008-150251-cd45d91`, level 'behavioral (derived -- no simulator)', sha256 `4a8c35d7694ccf2f5ec6682aa7b8575510b78ad2ab314b7b8eb02286664ff16a`
- `sim/digital-health-test-parameters/records/20261008-150251-cd45d91.json`
  - check: detects stuck-at: RCT detects every stuck-at-0 / stuck-at-1 fault-injection run (detected == runs; same DR-0010 row 3 / #221 condition)
  - verdict: met (observed 216/216 detected)
  - record id `20261008-150251-cd45d91`, level 'behavioral (derived -- no simulator)', sha256 `4a8c35d7694ccf2f5ec6682aa7b8575510b78ad2ab314b7b8eb02286664ff16a`
- `sim/digital-health-test-parameters/records/20261008-150251-cd45d91.json`
  - check: detects stuck-at: APT detects every stuck-at-0 / stuck-at-1 fault-injection run (detected == runs; same DR-0010 row 3 / #221 condition)
  - verdict: met (observed 216/216 detected)
  - record id `20261008-150251-cd45d91`, level 'behavioral (derived -- no simulator)', sha256 `4a8c35d7694ccf2f5ec6682aa7b8575510b78ad2ab314b7b8eb02286664ff16a`

### Power: not measured

No evidence mapping declared for this target yet; rendered `not measured`.

### Area: unmet

- `sim/digital-floorplan-compaction/records/20261009-214736-760b4d3.json`
  - check: target_status == met (target 0.05 mm2)
  - verdict: unmet (observed 'unchanged: unmet')
  - record id `20261009-214736-760b4d3`, level None, sha256 `8c145673c26a2d41833b89dde55178c9d54018c8575292de0cfc7322ecd78c7f`
- `sim/digital-repaired-compaction/records/20261010-105914-824542d.json`
  - check: target_status == met (target 0.05 mm2)
  - verdict: unmet (observed 'unchanged: unmet')
  - record id `20261010-105914-824542d`, level None, sha256 `eec70ff620edb50130b340d48968bc37975196cb914a8f785a35045343e6a58d`

### Operating envelope: met

- `sim/ro-array-core-combining/records/20260825-094545-53f1f7a.json`
  - check: ro_array_core combining deck passes at every process corner (overall == PASS) at this supply/temperature point; the span is the union of the PVT labels, not a scalar compared against -40..+125 C
  - verdict: met (observed 'PASS')
  - record id `20260825-094545-53f1f7a`, level 'transistor', sha256 `e547063c9d0ecd1acb263a8718fe5b4150eb501b130d35ef9f6432f65d0fe95e`
- `sim/ro-array-core-combining/records/20260825-094718-53f1f7a.json`
  - check: ro_array_core combining deck passes at every process corner (overall == PASS) at this supply/temperature point; the span is the union of the PVT labels, not a scalar compared against -40..+125 C
  - verdict: met (observed 'PASS')
  - record id `20260825-094718-53f1f7a`, level 'transistor', sha256 `1c39173f0840efa27f9aeff2945c0c5e2e52824d0d5437ea216b808a5d6c0303`
- `sim/ro-array-core-combining/records/20260825-094856-53f1f7a.json`
  - check: ro_array_core combining deck passes at every process corner (overall == PASS) at this supply/temperature point; the span is the union of the PVT labels, not a scalar compared against -40..+125 C
  - verdict: met (observed 'PASS')
  - record id `20260825-094856-53f1f7a`, level 'transistor', sha256 `44a0e662eda22d9a8cb9e3f89c7621b00d1eaf4a487b8e0aceab923fe77c7737`
- `sim/ro-array-core-combining/records/20261008-135355-847b454.json`
  - check: ro_array_core combining deck passes at every process corner (overall == PASS) at this supply/temperature point; the span is the union of the PVT labels, not a scalar compared against -40..+125 C
  - verdict: met (observed 'PASS')
  - record id `20261008-135355-847b454`, level 'transistor', sha256 `7b4b18e14778f74f41f4b2a67fcdcb7e9243c6856eb87e1bfb947b1bb4cf8556`
- `sim/ro-array-core-combining/records/20261008-135356-847b454.json`
  - check: ro_array_core combining deck passes at every process corner (overall == PASS) at this supply/temperature point; the span is the union of the PVT labels, not a scalar compared against -40..+125 C
  - verdict: met (observed 'PASS')
  - record id `20261008-135356-847b454`, level 'transistor', sha256 `6e066ccad849983c183118e4926c2a59178d2fabc7832dcda3dbc1ddfd3d2d88`
- `sim/ro-array-core-combining/records/20261008-135357-847b454.json`
  - check: ro_array_core combining deck passes at every process corner (overall == PASS) at this supply/temperature point; the span is the union of the PVT labels, not a scalar compared against -40..+125 C
  - verdict: met (observed 'PASS')
  - record id `20261008-135357-847b454`, level 'transistor', sha256 `4ab61f892e6b2112367568ebcfb2e422d2d63b7d2249a25fe429afe43c3be603`

### Interface: met

- `sim/digital-rtl-equivalence/records/20260905-192519-2ecb0a3.json`
  - check: RTL is cycle-for-cycle equivalent to the behavioural model (0 mismatches)
  - verdict: met (observed 0)
  - record id `20260905-192519-2ecb0a3`, level 'behavioral (RTL co-simulation)', sha256 `c8029bdf6c1b053d8c4900b6c02b519cbae97437f8184afa4949da91ac07267e`
- `sim/digital-functional-verification/records/20261009-120511-d9f51a4.json`
  - check: routed gate-level netlist passes the directed suite (functional/unit-delay)
  - verdict: met (observed True)
  - record id `20261009-120511-d9f51a4`, level 'gate (post-route as-built netlist, functional/unit-delay -- NOT SDF-timed)', sha256 `2b3b2f30463e641c396f0529681b39cd2f54cef531a2e43190957f175833a3c4`
- `sim/digital-section-behavioral/records/20260905-192548-2ecb0a3.json`
  - check: raw path never gated: no conditioned data read while gated, gate asserted (experiment F)
  - verdict: met (observed 0)
  - record id `20260905-192548-2ecb0a3`, level 'behavioral', sha256 `aa792618bbdff957570072739cb1efca6ad917088e95f6e77cfcf1c4569de665`
