2AMLogic/sky130-trng/layout/trng_whole/verify/coverage.md

# Whole-block verification coverage matrix

Generated by `layout/bin/verify-whole.py` (issue #173). Whole-block project verification on klt's curated sky130 decks and the open_pdks install pinned in layout/pdk.json. NOT foundry sign-off: no foundry DRC/LVS/antenna/density runset, no parasitic extraction, no electrical or entropy characterisation. Provisional until silicon.

**123 of 123 whole-block ports are clean** on all four per-port checks: exactly one extracted pin carries the port name (not joined with another port), the LVS comparer paired it by name with the reference pin, and the independent endpoint audit finds the identical multiset of standard-cell pins / transistor terminals on its layout and reference nets.

## Per-port

| port | class | dir | pin unique | not joined | LVS paired | endpoints L/R | equal |
|---|---|---|---|---|---|---|---|
| `vdd` | logic_supply | external_to_both | yes | yes | yes | 16654/16654 | yes |
| `vss` | logic_ground | external_to_both | yes | yes | yes | 8823/8823 | yes |
| `clk` | shared_input | external_to_both | yes | yes | yes | 38/38 | yes |
| `rst_n` | shared_input | external_to_both | yes | yes | yes | 480/480 | yes |
| `en1` | analog_external | external_to_analog | yes | yes | yes | 2/2 | yes |
| `en2` | analog_external | external_to_analog | yes | yes | yes | 2/2 | yes |
| `en3` | analog_external | external_to_analog | yes | yes | yes | 2/2 | yes |
| `en4` | analog_external | external_to_analog | yes | yes | yes | 2/2 | yes |
| `vddr1` | ring_supply | external_to_analog | yes | yes | yes | 21/21 | yes |
| `vddr2` | ring_supply | external_to_analog | yes | yes | yes | 21/21 | yes |
| `vddr3` | ring_supply | external_to_analog | yes | yes | yes | 21/21 | yes |
| `vddr4` | ring_supply | external_to_analog | yes | yes | yes | 21/21 | yes |
| `ring_bit1` | analog_external | analog_to_external | yes | yes | yes | 4/4 | yes |
| `ring_bit2` | analog_external | analog_to_external | yes | yes | yes | 4/4 | yes |
| `ring_bit3` | analog_external | analog_to_external | yes | yes | yes | 4/4 | yes |
| `ring_bit4` | analog_external | analog_to_external | yes | yes | yes | 4/4 | yes |
| `bus_addr[0]` | digital_external | input | yes | yes | yes | 7/7 | yes |
| `bus_addr[1]` | digital_external | input | yes | yes | yes | 6/6 | yes |
| `bus_addr[2]` | digital_external | input | yes | yes | yes | 9/9 | yes |
| `bus_addr[3]` | digital_external | input | yes | yes | yes | 8/8 | yes |
| `bus_we` | digital_external | input | yes | yes | yes | 3/3 | yes |
| `bus_re` | digital_external | input | yes | yes | yes | 1/1 | yes |
| `bus_wdata[0]` | digital_external | input | yes | yes | yes | 2/2 | yes |
| `bus_wdata[1]` | digital_external | input | yes | yes | yes | 3/3 | yes |
| `bus_wdata[2]` | digital_external | input | yes | yes | yes | 4/4 | yes |
| `bus_wdata[3]` | digital_external | input | yes | yes | yes | 0/0 | yes |
| `bus_wdata[4]` | digital_external | input | yes | yes | yes | 0/0 | yes |
| `bus_wdata[5]` | digital_external | input | yes | yes | yes | 0/0 | yes |
| `bus_wdata[6]` | digital_external | input | yes | yes | yes | 0/0 | yes |
| `bus_wdata[7]` | digital_external | input | yes | yes | yes | 0/0 | yes |
| `bus_wdata[8]` | digital_external | input | yes | yes | yes | 0/0 | yes |
| `bus_wdata[9]` | digital_external | input | yes | yes | yes | 0/0 | yes |
| `bus_wdata[10]` | digital_external | input | yes | yes | yes | 0/0 | yes |
| `bus_wdata[11]` | digital_external | input | yes | yes | yes | 0/0 | yes |
| `bus_wdata[12]` | digital_external | input | yes | yes | yes | 0/0 | yes |
| `bus_wdata[13]` | digital_external | input | yes | yes | yes | 0/0 | yes |
| `bus_wdata[14]` | digital_external | input | yes | yes | yes | 0/0 | yes |
| `bus_wdata[15]` | digital_external | input | yes | yes | yes | 0/0 | yes |
| `bus_wdata[16]` | digital_external | input | yes | yes | yes | 0/0 | yes |
| `bus_wdata[17]` | digital_external | input | yes | yes | yes | 0/0 | yes |
| `bus_wdata[18]` | digital_external | input | yes | yes | yes | 0/0 | yes |
| `bus_wdata[19]` | digital_external | input | yes | yes | yes | 0/0 | yes |
| `bus_wdata[20]` | digital_external | input | yes | yes | yes | 0/0 | yes |
| `bus_wdata[21]` | digital_external | input | yes | yes | yes | 0/0 | yes |
| `bus_wdata[22]` | digital_external | input | yes | yes | yes | 0/0 | yes |
| `bus_wdata[23]` | digital_external | input | yes | yes | yes | 0/0 | yes |
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
| `out_data[15]` | digital_external | output | yes | yes | yes | 1/1 | yes |
| `out_data[16]` | digital_external | output | yes | yes | yes | 1/1 | yes |
| `out_data[17]` | digital_external | output | yes | yes | yes | 1/1 | yes |
| `out_data[18]` | digital_external | output | yes | yes | yes | 1/1 | yes |
| `out_data[19]` | digital_external | output | yes | yes | yes | 1/1 | yes |
| `out_data[20]` | digital_external | output | yes | yes | yes | 1/1 | yes |
| `out_data[21]` | digital_external | output | yes | yes | yes | 1/1 | yes |
| `out_data[22]` | digital_external | output | yes | yes | yes | 1/1 | yes |
| `out_data[23]` | digital_external | output | yes | yes | yes | 1/1 | yes |
| `out_data[24]` | digital_external | output | yes | yes | yes | 1/1 | yes |
| `out_data[25]` | digital_external | output | yes | yes | yes | 1/1 | yes |
| `out_data[26]` | digital_external | output | yes | yes | yes | 1/1 | yes |
| `out_data[27]` | digital_external | output | yes | yes | yes | 1/1 | yes |
| `out_data[28]` | digital_external | output | yes | yes | yes | 1/1 | yes |
| `out_data[29]` | digital_external | output | yes | yes | yes | 1/1 | yes |
| `out_data[30]` | digital_external | output | yes | yes | yes | 1/1 | yes |
| `out_data[31]` | digital_external | output | yes | yes | yes | 1/1 | yes |
| `out_valid` | digital_external | output | yes | yes | yes | 1/1 | yes |
| `out_ready` | digital_external | input | yes | yes | yes | 2/2 | yes |
| `alarm` | digital_external | output | yes | yes | yes | 1/1 | yes |
| `gated` | digital_external | output | yes | yes | yes | 8/8 | yes |
| `startup_done` | digital_external | output | yes | yes | yes | 18/18 | yes |

## Named limitations (carried into #174 and #170)

| id | item | status | detail |
|---|---|---|---|
| L1 | digital standard-cell internals | not checked | Every sky130_fd_sc_hd cell is an opaque pin-only black box on both sides (klt extract --abstract-cells). Transistor-level LVS of the cell internals is not done; the cells are the PDK's own, and the macro-level digital LVS (layout/trng_digital/lvs.json) is cell level too. What IS checked: every cell's signal and power pin lands on the same net as in the as-built netlist. |
| L2 | digital substrate / VNB and well-body ties | not checked | klt extract drops VNB from every abstracted stub (substrate-only; deck global net 'vsubs'), so the reference omits it and nothing here verifies digital substrate or p-well connectivity. VPB (n-well) IS carried as a stub pin and tied to vdd on the reference; the endpoint audit proves every VPB sits on the same net as VPWR. |
| L3 | analog device bodies and well/substrate-tap convention | not checked | lvs.json body_verification.status is 'unchecked': the pre-extracted-netlist request form gives klt no layout.deck to establish a tap convention. The four MOSFET terminals (including bulk) are compared topologically against the reference, nothing more. |
| L4 | device parameters | klt default only | lvs.json device_parameter_coverage is [] (same as layout/sampler_core/lvs.json); the comparer's own parameter handling applies and no tolerance or compare_parameters option was set. No claim beyond 'klt lvs reports no device.property mismatch'. |
| L5 | filler / tap / diode cells | compared as power-only / signal cells, not pruned | 6284 fill/tap instances (from the routed DEF) are carried as power-pin-only stubs and compared, not pruned (the subckt-call form has no power-only pruning). The one antenna diode (sky130_fd_sc_hd__diode_2) is a signal cell from the as-built Verilog. Fill/tap counts come from the DEF, not from the layout extraction, so a missing tap would mismatch. |
| L6 | power connectivity check (klt power_connectivity) | not applicable to this form | power_connectivity.status is 'unchecked' for reference.form 'subckt-call'. Power is instead part of the ordinary compare: every cell's VPWR/VPB/VGND pin is an explicit stub pin on both sides, tied to vdd/vss in the reference, and the endpoint audit compares the vdd/vss endpoint multisets in full. |
| L7 | hierarchy | flattened | Reference and layout are flat: sampler_core's subcircuit hierarchy is expanded in the reference, the digital module boundary does not exist in the comparison. Which macro a net lives in is not part of the verdict. |
| L8 | pin names | canonicalised | klt names an extracted net by all its labels joined with '|'. Each top pin whose label set contains exactly one whole-block port name is renamed to that port name (verify-whole.py; 123 of 123); pins with zero or several port names are never repaired (they stay composite and fail the compare). Pin identity is then anchored by name through options.anchor_top_level_pins. |
| L9 | curated DRC deck | partial rule coverage, audited | klt's curated sky130 deck checks 91 rules on 20 layers. It reports 45 deck rules as not run (coverage.inapplicable, reason no_applicable_geometry; legacy list rules_skipped), and 19 layer/datatype pairs in the stream have no rules. drc_coverage_audit.md / drc_coverage_audit.json (issue #281) check both lists against the flattened stream on the pinned deck. Table 1 gives each not-run rule's check kind, deck layers, per-layer shape counts, klt's reason and a verdict (vacuous-confirmed / residual / unresolved). Table 2 gives each unruled layer's shape and text counts and a verdict (present-unruled / text-or-marker-only); present-unruled layers are a residual gap, drawn and unchecked. verify-whole.py check fails if either table drifts from the stream, the layer map or the deck hash. Clean here is not foundry DRC clean: no foundry sign-off runset, and no antenna, density, seal-ring, latch-up or foundry-only rules. |
| L10 | analog-origin DRC history | resolved upstream, re-verified | The 5664 licon1.ongrid.1 findings #172 reported on sampler_core came from klayout-tools#2648 (cut centres off the 0.005 um grid). Issue #181 regenerated sampler_core on the fixed generator (klt 0.6.0+g5edb557f91d0) with new provenance; this run re-verifies the composed stream on that build with the rule still enabled (licon1.ongrid.1 is in rules_checked) and finds 0 violations. No rule was waived, relaxed or removed. |
| L11 | extraction is not parasitic / electrical | out of scope | Schematic-equivalent connectivity only. Coupling between the vdd/vddr routes, IR drop, period scatter and every DR-0003 section 8 / DR-0009 measurement obligation stay open for #174 and #170. |
| L13 | unloaded boundary pins | endpoint audit vacuous for these ports | 29 digital input ports (bus_wdata[3] .. bus_wdata[31]) have no standard-cell load in the as-built netlist (the RTL does not use bus_wdata[31:3]), so their endpoint multisets are empty on both sides and prove nothing. Their identity is covered only by: exactly one extracted pin carries the name, it is not joined with another port, and options.anchor_top_level_pins pairs it by name with the reference pin. A short from one of them to a loaded net is still caught (joined pin / net mismatch). Exchanging the names of two UNLOADED pins is electrically a no-op and is undetectable by construction (a trial swap of bus_wdata[3]/[4] compared 'match'); the digital swap control therefore uses two loaded bits. |
| L14 | stub pin order | differs, compared by name | klt extract lists an abstracted stub's pins alphabetically, the reference uses the PDK's pin order (sky130_fd_sc_hd__dfrtp_1, sky130_fd_sc_hd__dfstp_1); the pin sets are identical and each file's X cards follow its own order, so the endpoint audit (by pin name) is unaffected. |
| L15 | extraction warnings (reviewed, none hidden) | reviewed | 159 klt extract warnings, all classified: 91 'net merges N distinct labels' (the analog macro labels its internal nodes; harmless to connectivity, and the reason pin names need canonicalising, L8); 63 '--abstract-cells ... resolve only through the deck's global net vsubs' (VNB dropped from those stubs, L2); one 'abstract-cells instances resolved VPB and VPWR onto the same net' (7901 instances: this is the documented VPB=VPWR well tie, confirmed rather than hidden); one 'promoted nets from labels below the top cell' (three analog internal nodes, demoted by the declared pin set - the extracted top has exactly 123 pins); one 'kept N nets internal: not in the declared pin set'; one dead-metal notice (see verify.json extract.dead_metal: all li1/mcon/met1 inside the digital macro's hidden cell artwork, none on met2..met5 or in the analog macro or the composition routing); one 'layers outside the deck's connectivity graph' (16 layer/datatype pairs listed in extract.json.gz ignored_layers[]: geometry the curated deck does not treat as conductors; it is invisible to extraction and therefore NOT examined by this verification). |
| L12 | area target | Unmet (unchanged) | 0.126116 mm2 against the unchanged < 0.05 mm2 target (layout/trng_whole/README.md). Not touched by this increment. |
