2AMLogic/sky130-trng/sim/digital-health-test-parameters/records/20261008-150251-cd45d91.md

# 20261008-150251-cd45d91 -- digital-health-test-parameters

**Claim**: the ratified RCT/APT cutoffs (81/824, H = 0.5) re-derived at the estimated Ts = 20 us min-entropy, replayed over the volume streams, and checked by deterministic failure injection (detection latency per test); simulation-derived H, provisional until silicon

**Level**: behavioral (derived -- no simulator)
**Seeds**: N/A (deterministic run; no stochastic input)
**Supersedes**: (none)

---
## Scope and inputs

Streams: the Ts = 20 us (design point) behavioural streams of the
volume campaign, 131072 samples each, hash-verified by the loader.
Ts = 100 ns streams are **not** the design point and are excluded.
`H` is `h_min_bits`, the minimum over the SP 800-90B non-IID
estimators implemented in `raw-bit-battery.py`, taken from the cited
min-entropy records.

- volume campaign `20261008-061809-56e0fb7` -> min-entropy `20261008-124312-5d44390`
- volume campaign `20261008-135454-847b454` -> min-entropy `20261008-150026-cd45d91`

**Caveats that bound every conclusion below.** The streams come from
a behavioural model with independent noise increments, not from
silicon; estimated `H` is a model number and is **provisional until
measured on silicon**. A replay with zero alarms on such data is weak
evidence for the real device, and `H` = 0.5 versus 0.65 on the model
does not exercise real-world bias, correlation or supply coupling.
The cited battery record reports single-sequence FAILs on most of
these streams (listed in section 2) -- the estimated `H` and the
replay must be read alongside them, not instead of them.

## 1. Cutoffs re-derived at the estimated H

`C_RCT` = 81 and `C_APT` = 824 are the ratified
values at `H` = 0.5. Verdict rule: **violated** if
`H_est` < 0.5 (the cutoffs would under-alarm), **tight** if
0.5 <= `H_est` < 0.55, otherwise
**conservative** (false alarms rarer than designed). Lookups are
`params.c_rct(H)` / `params.c_apt(H)`, not retyped.

`log2 FA` columns: the false-alarm probability of the *ratified*
cutoff if the source really had `H_est` and were i.i.d. at
`p = 2^-H` (design: `-40`). RCT is per sample, APT per window.
The sensitivity paragraph below uses `-log2(C_APT / W)`, the
min-entropy of an i.i.d. biased source whose *typical* window just
reaches the cutoff.

| stream | `H_est` | binding | `c_rct(H)` | d vs 81 | `c_apt(H)` | d vs 824 | log2 FA RCT | log2 FA APT | verdict |
|---|---|---|---|---|---|---|---|---|---|
| ss -40 C 1.62 V | 0.6486 | compression | 63 | -18 | 760 | -64 | -51.9 | -102.2 | conservative |
| ss 27 C 1.8 V | 0.6715 | collision | 61 | -20 | 750 | -74 | -53.7 | -113.2 | conservative |
| tt 125 C 1.98 V | 0.7240 | compression | 57 | -24 | 729 | -95 | -57.9 | -139.7 | conservative |
| ss 125 C 1.62 V | 0.7241 | compression | 57 | -24 | 729 | -95 | -57.9 | -139.7 | conservative |
| tt 125 C 1.8 V | 0.7344 | compression | 56 | -25 | 725 | -99 | -58.8 | -145.1 | conservative |
| ss -40 C 1.98 V | 0.7418 | collision | 55 | -26 | 722 | -102 | -59.3 | -149.0 | conservative |
| ss 125 C 1.98 V | 0.7482 | compression | 55 | -26 | 719 | -105 | -59.9 | -152.4 | conservative |
| tt -40 C 1.98 V | 0.7507 | compression | 55 | -26 | 718 | -106 | -60.1 | -153.7 | conservative |
| ff 125 C 1.8 V | 0.7513 | compression | 55 | -26 | 718 | -106 | -60.1 | -154.0 | conservative |
| ff 125 C 1.62 V | 0.7566 | compression | 54 | -27 | 716 | -108 | -60.5 | -156.9 | conservative |
| tt 27 C 1.8 V | 0.7701 | compression | 53 | -28 | 711 | -113 | -61.6 | -164.1 | conservative |
| ff 125 C 1.98 V | 0.7736 | compression | 53 | -28 | 709 | -115 | -61.9 | -166.0 | conservative |
| tt -40 C 1.62 V | 0.7766 | compression | 53 | -28 | 708 | -116 | -62.1 | -167.6 | conservative |
| ff -40 C 1.98 V | 0.7799 | compression | 53 | -28 | 707 | -117 | -62.4 | -169.5 | conservative |
| ff -40 C 1.62 V | 0.7853 | collision | 52 | -29 | 705 | -119 | -62.8 | -172.4 | conservative |
| ss 125 C 1.8 V | 0.7952 | compression | 52 | -29 | 701 | -123 | -63.6 | -177.9 | conservative |
| ff 27 C 1.8 V | 0.8128 | compression | 51 | -30 | 694 | -130 | -65.0 | -187.7 | conservative |
| tt 125 C 1.62 V | 0.8193 | collision | 50 | -31 | 692 | -132 | -65.5 | -191.3 | conservative |

**Worst case (minimum H)**: ss -40 C 1.62 V, `H_est` = 0.6486 (compression): `c_rct` = 63, `c_apt` = 760.
**Best case**: tt 125 C 1.62 V, `H_est` = 0.8193.

Sensitivity implication: the ratified APT cutoff 824/1024 only fires on a typical window when the source's min-entropy is about 0.313 bit/sample or lower, whereas a cutoff evaluated at the worst-case estimate would fire near 0.430. Likewise the RCT trips after 81 identical samples (1.62 ms) versus 63 at the worst-case estimate (1.26 ms).

**Conclusion.** 18/18 streams are *conservative*, 0 tight, 0 violated. The ratified H = 0.5 cutoffs therefore do **not** under-alarm at the estimated H: they are conservative against false alarms and correspondingly less sensitive than cutoffs at the measured H would be. This is a statement about a provisional, behavioural-model H; it is not a reason to change the ratified values, and no change is made or proposed here.

## 2. Replay of the streams through the health tests

Counting convention: individual tests are `reset()` after every trip
and keep counting. `HealthMonitor` applies its own policy (a mid-run
trip re-arms start-up and resets RCT/APT), and the number of
`update()` calls that returned True is reported, plus its sticky alarm
bits at end of stream. Each stream is also run through the individual
tests at the cutoffs evaluated at that stream's own `H_est`, to show
the margin the ratified cutoffs leave. 'Longest run' and 'max APT
matches' are the raw statistics the cutoffs are compared against.

| stream | n | longest run (RCT < 81) | max APT matches (< 824) | RCT trips @81 | APT trips @824 | Monitor raised | alarm RCT/APT/start-up | trips @ own-H cutoffs (RCT/APT) | battery FAILs (single-seq, cited) |
|---|---|---|---|---|---|---|---|---|---|
| ss -40 C 1.62 V | 131072 | 21 | 566 | 0 | 0 | 0 | 0/0/0 | 0/0 | runs, longest_run, serial_1, serial_2, approximate_entropy |
| ss 27 C 1.8 V | 131072 | 20 | 562 | 0 | 0 | 0 | 0/0/0 | 0/0 | runs, longest_run, serial_1, serial_2, approximate_entropy |
| tt 125 C 1.98 V | 131072 | 19 | 547 | 0 | 0 | 0 | 0/0/0 | 0/0 | - |
| ss 125 C 1.62 V | 131072 | 14 | 548 | 0 | 0 | 0 | 0/0/0 | 0/0 | longest_run, serial_1, serial_2, approximate_entropy |
| tt 125 C 1.8 V | 131072 | 19 | 557 | 0 | 0 | 0 | 0/0/0 | 0/0 | - |
| ss -40 C 1.98 V | 131072 | 15 | 550 | 0 | 0 | 0 | 0/0/0 | 0/0 | runs, serial_1, approximate_entropy |
| ss 125 C 1.98 V | 131072 | 18 | 554 | 0 | 0 | 0 | 0/0/0 | 0/0 | runs, serial_1 |
| tt -40 C 1.98 V | 131072 | 17 | 560 | 0 | 0 | 0 | 0/0/0 | 0/0 | serial_1, serial_2 |
| ff 125 C 1.8 V | 131072 | 17 | 553 | 0 | 0 | 0 | 0/0/0 | 0/0 | - |
| ff 125 C 1.62 V | 131072 | 16 | 558 | 0 | 0 | 0 | 0/0/0 | 0/0 | runs, serial_1, approximate_entropy |
| tt 27 C 1.8 V | 131072 | 17 | 549 | 0 | 0 | 0 | 0/0/0 | 0/0 | longest_run, serial_1, approximate_entropy |
| ff 125 C 1.98 V | 131072 | 17 | 560 | 0 | 0 | 0 | 0/0/0 | 0/0 | - |
| tt -40 C 1.62 V | 131072 | 19 | 564 | 0 | 0 | 0 | 0/0/0 | 0/0 | longest_run, serial_1, serial_2, approximate_entropy |
| ff -40 C 1.98 V | 131072 | 15 | 568 | 0 | 0 | 0 | 0/0/0 | 0/0 | - |
| ff -40 C 1.62 V | 131072 | 15 | 556 | 0 | 0 | 0 | 0/0/0 | 0/0 | runs, serial_1, serial_2, approximate_entropy |
| ss 125 C 1.8 V | 131072 | 15 | 558 | 0 | 0 | 0 | 0/0/0 | 0/0 | runs, longest_run, serial_1, serial_2, approximate_entropy |
| ff 27 C 1.8 V | 131072 | 19 | 553 | 0 | 0 | 0 | 0/0/0 | 0/0 | runs, serial_1 |
| tt 125 C 1.62 V | 131072 | 16 | 558 | 0 | 0 | 0 | 0/0/0 | 0/0 | longest_run, serial_1, approximate_entropy |

**Total alarms across 18 streams at the ratified cutoffs: 0** (expected 0 at alpha = 2^-40; none observed).

## 3. Failure injection and detection latency

Healthy base: each of the 18 streams above. A failure of
16384 samples is spliced in at onsets [2000, 3333, 5117, 7001, 9500, 11777] (none a
multiple of 1024); the injector replaces the healthy samples, same
stream length, deterministic via per-scenario CRC32 seeds. Each of the
108 runs per scenario feeds RCT and APT
(ratified cutoffs, individual tests, restart after a trip) from sample
0 and records the first trip at or after onset (a stuck run can trip
RCT a few samples early when the preceding healthy sample already
equals the stuck value). Latency = injected
samples consumed up to and including the failing one; seconds at
50,000 bps (20 us/sample). APT latency is quantised to
1024-sample window ends measured from stream start, so it depends on
onset alignment. 'Not detected' is a result, not an omission.

| scenario | RCT latency, samples (time) | APT latency, samples (time) |
|---|---|---|
| stuck-at-0 | min 73 (1.46 ms) / median 80.5 (1.61 ms) / max 81 (1.62 ms) | min 740 (14.80 ms) / median 1191 (23.82 ms) / max 1787 (35.74 ms) |
| stuck-at-1 | min 74 (1.48 ms) / median 80.5 (1.61 ms) / max 81 (1.62 ms) | min 740 (14.80 ms) / median 1072 (21.44 ms) / max 1787 (35.74 ms) |
| toggle 01 (period 2) | not detected within 16384 samples (0/108) | not detected within 16384 samples (0/108) |
| toggle 001 (period 3) | not detected within 16384 samples (0/108) | not detected within 16384 samples (0/108) |
| toggle 0011 (period 4) | not detected within 16384 samples (0/108) | not detected within 16384 samples (0/108) |
| toggle 0001 (period 4) | not detected within 16384 samples (0/108) | not detected within 16384 samples (0/108) |
| bias step to p=0.7 | not detected within 16384 samples (0/108) | not detected within 16384 samples (0/108) |
| bias step to p=0.8 | not detected within 16384 samples (0/108) | min 1027 (20.54 ms) / median 2788 (55.76 ms) / max 10751 (215.02 ms) |
| bias step to p=0.85 | min 11648 (232.96 ms) / median 11648 (232.96 ms) / max 11648 (232.96 ms); detected 1/108, rest not within 16384 | min 1027 (20.54 ms) / median 1535 (30.70 ms) / max 3835 (76.70 ms) |
| bias step to p=0.9 | min 344 (6.88 ms) / median 7724 (154.48 ms) / max 15263 (305.26 ms); detected 32/108, rest not within 16384 | min 740 (14.80 ms) / median 1535 (30.70 ms) / max 3583 (71.66 ms) |
| bias step to p=0.95 | min 81 (1.62 ms) / median 910 (18.20 ms) / max 5276 (105.52 ms) | min 740 (14.80 ms) / median 1131.5 (22.63 ms) / max 2811 (56.22 ms) |
| bias ramp 0.5->0.7 over 8192, then held | not detected within 16384 samples (0/108) | not detected within 16384 samples (0/108) |
| bias ramp 0.5->0.9 over 8192, then held | min 8212 (164.24 ms) / median 10779.5 (215.59 ms) / max 13604 (272.08 ms); detected 18/108, rest not within 16384 | min 6311 (126.22 ms) / median 7335 (146.70 ms) / max 8955 (179.10 ms) |

Pre-onset (healthy-prefix) trips across all injection runs: 0 (expected 0).

Reading the table: RCT is the only test that catches a stuck source
quickly (81 samples = 1.62 ms) and cannot see any
toggling or bias that keeps runs short. APT needs a window whose
reference value fills >= 824/1024 = 0.805 of the window, so a
fixed bias below roughly p = 0.8 -- including p = 0.7, the 'plausible
drift' value, which still carries 0.515 bit/sample -- is **not** flagged at the ratified
cutoff, and a period-3 or period-4 pattern with <= 75% of one symbol is
invisible to both tests. Those are properties of the SP 800-90B
continuous tests at this alpha, not defects of the model; the
statistical battery and the estimators, not RCT/APT, are what cover
them.

---

## Provenance

- Author: loom-builder@sky130-trng
- Timestamp (UTC): 2026-10-08T15:02:51.897012+00:00
- Repo commit: `cd45d91`
- Tools: {"python": "3.12.3", "platform": "Linux-7.0.0-1013-aws-x86_64-with-glibc2.39"}

> **Provisional, simulation-derived.** Nothing in this record is a measurement of silicon, and nothing in it is an SP 800-90B entropy assessment. Per the root `CLAUDE.md`, simulation-derived entropy claims stay provisional until measured on silicon.
