2AMLogic/sky130-trng/layout/trng_whole/verify/drc_coverage_audit.md

# Whole-block DRC coverage audit: inapplicable rules and unruled layers

Generated by `layout/bin/verify-whole.py audit (layout/bin/drc_coverage_audit.py)` (issue #281). Do not edit by hand; `verify-whole.py check` regenerates it and fails on drift. **Evidence, not sign-off. This audit cross-checks klt's own curated sky130 deck coverage report against the composed stream. It is not a foundry DRC runset, and it adds no antenna, density, seal-ring, latch-up or foundry-only rule. No ratified spec value is read or changed.**

- Stream: `layout/trng_whole/trng_whole.gds` `sha256:af2f8dfe2800…`, top `trng_whole`.
- DRC report audited: `layout/trng_whole/verify/drc.json` (its input hash matches the stream: yes).
- Deck: curated `sky130` `sha256:2bcbd625a0e36a4d1f9893b3c5d9b94963179c962b10ba01ffc4f378938c8197`, the pin in `drc.json` `provenance.deck.content_hash`. Rule kinds and layers come from `klt deck rules`, layer/datatype from the deck's own layer table, and both must hash to the pin.
- Counts: flattened_shapes: klt's instantiated (hierarchy- and transform-flattened) shape count per layer/datatype under the top cell, text objects included. geometry = flattened_shapes - text_count: the polygons/boxes/paths a DRC rule can act on. definition_shapes: shapes in cell definitions, not instantiated.

**45 inapplicable rules:** 45 vacuous-confirmed. **19 unruled stream layers:** 11 present-unruled, 8 text-or-marker-only. Stream accounting: 39 layer/datatype pairs = 20 read by a curated rule + 19 unruled.

## Verdict conditions

- `vacuous-confirmed` for `angle`: the one layer the rule reads has geometry == 0 in the flattened stream.
- `vacuous-confirmed` for `ongrid`: the one layer the rule reads has geometry == 0 in the flattened stream.
- `vacuous-confirmed` for `width`: the one layer the rule reads has geometry == 0 in the flattened stream.
- `vacuous-confirmed` for `space`: the one layer the rule reads has geometry == 0 in the flattened stream.
- `vacuous-confirmed` for `enclosing`: at least one of the two layers the rule reads has geometry == 0 (the check needs both).
- `vacuous-confirmed` for `separation`: at least one of the two layers the rule reads has geometry == 0 (the check needs both).
- `residual`: every layer the rule reads has geometry > 0, yet klt lists the rule as inapplicable.
- `unresolved`: rule id not in the pinned deck; or a deck layer name not resolvable to exactly one stream layer/datatype that the pinned DRC run also read (drc.json coverage.deck_layers); or a check kind / layer count outside the kinds above. Never forced to vacuous-confirmed.
- unruled `present-unruled`: geometry > 0 and klt's annotation flag is false: drawn shapes that no curated rule reads.
- unruled `text-or-marker-only`: flattened_shapes > 0 and (geometry == 0, i.e. text objects only, or klt's annotation flag is true).
- unruled `unresolved`: listed by klt drc as in the stream but klt layers reports no shapes for it.

## Table 1: rules klt reports as inapplicable

| rule | check | deck layers | GDS shape count per layer (geometry / flattened) | klt reason | verdict |
|---|---|---|---|---|---|
| `areaid_re.ongrid.1` | ongrid | `areaid.rfdiode` | `81/125`: 0 / 0 | no_applicable_geometry | vacuous-confirmed |
| `capm.enclosing.via3.1` | enclosing | `capm.drawing`, `via3.drawing` | `89/44`: 0 / 0, `70/44`: 3041 / 3041 | no_applicable_geometry | vacuous-confirmed |
| `capm.separation.via3.1` | separation | `capm.drawing`, `via3.drawing` | `89/44`: 0 / 0, `70/44`: 3041 / 3041 | no_applicable_geometry | vacuous-confirmed |
| `capm.space.1` | space | `capm.drawing` | `89/44`: 0 / 0 | no_applicable_geometry | vacuous-confirmed |
| `capm.width.1` | width | `capm.drawing` | `89/44`: 0 / 0 | no_applicable_geometry | vacuous-confirmed |
| `capm2.enclosing.via4.1` | enclosing | `capm2.drawing`, `via4.drawing` | `97/44`: 0 / 0, `71/44`: 171 / 171 | no_applicable_geometry | vacuous-confirmed |
| `capm2.separation.via4.1` | separation | `capm2.drawing`, `via4.drawing` | `97/44`: 0 / 0, `71/44`: 171 / 171 | no_applicable_geometry | vacuous-confirmed |
| `capm2.space.1` | space | `capm2.drawing` | `97/44`: 0 / 0 | no_applicable_geometry | vacuous-confirmed |
| `capm2.width.1` | width | `capm2.drawing` | `97/44`: 0 / 0 | no_applicable_geometry | vacuous-confirmed |
| `dnwell.angle.1` | angle | `dnwell.drawing` | `64/18`: 0 / 0 | no_applicable_geometry | vacuous-confirmed |
| `dnwell.ongrid.1` | ongrid | `dnwell.drawing` | `64/18`: 0 / 0 | no_applicable_geometry | vacuous-confirmed |
| `hvi.angle.1` | angle | `hvi.drawing` | `75/20`: 0 / 0 | no_applicable_geometry | vacuous-confirmed |
| `hvi.ongrid.1` | ongrid | `hvi.drawing` | `75/20`: 0 / 0 | no_applicable_geometry | vacuous-confirmed |
| `hvntm.angle.1` | angle | `hvntm.drawing` | `125/20`: 0 / 0 | no_applicable_geometry | vacuous-confirmed |
| `hvntm.ongrid.1` | ongrid | `hvntm.drawing` | `125/20`: 0 / 0 | no_applicable_geometry | vacuous-confirmed |
| `hvtr.angle.1` | angle | `hvtr.drawing` | `18/20`: 0 / 0 | no_applicable_geometry | vacuous-confirmed |
| `hvtr.ongrid.1` | ongrid | `hvtr.drawing` | `18/20`: 0 / 0 | no_applicable_geometry | vacuous-confirmed |
| `lvtn.angle.1` | angle | `lvtn.drawing` | `125/44`: 0 / 0 | no_applicable_geometry | vacuous-confirmed |
| `lvtn.ongrid.1` | ongrid | `lvtn.drawing` | `125/44`: 0 / 0 | no_applicable_geometry | vacuous-confirmed |
| `met3.enclosing.capm.1` | enclosing | `met3.drawing`, `capm.drawing` | `70/20`: 3388 / 3388, `89/44`: 0 / 0 | no_applicable_geometry | vacuous-confirmed |
| `met4.enclosing.capm2.1` | enclosing | `met4.drawing`, `capm2.drawing` | `71/20`: 1041 / 1041, `97/44`: 0 / 0 | no_applicable_geometry | vacuous-confirmed |
| `mf.angle.1` | angle | `target.drawing` | `76/44`: 0 / 0 | no_applicable_geometry | vacuous-confirmed |
| `mf.ongrid.1` | ongrid | `target.drawing` | `76/44`: 0 / 0 | no_applicable_geometry | vacuous-confirmed |
| `ncm.angle.1` | angle | `ncm.drawing` | `92/44`: 0 / 0 | no_applicable_geometry | vacuous-confirmed |
| `ncm.ongrid.1` | ongrid | `ncm.drawing` | `92/44`: 0 / 0 | no_applicable_geometry | vacuous-confirmed |
| `nsm.angle.1` | angle | `nsm.drawing` | `61/20`: 0 / 0 | no_applicable_geometry | vacuous-confirmed |
| `nsm.ongrid.1` | ongrid | `nsm.drawing` | `61/20`: 0 / 0 | no_applicable_geometry | vacuous-confirmed |
| `pad.angle.1` | angle | `pad.drawing` | `76/20`: 0 / 0 | no_applicable_geometry | vacuous-confirmed |
| `pad.ongrid.1` | ongrid | `pad.drawing` | `76/20`: 0 / 0 | no_applicable_geometry | vacuous-confirmed |
| `pwbm.angle.1` | angle | `pwbm.drawing` | `19/44`: 0 / 0 | no_applicable_geometry | vacuous-confirmed |
| `pwbm.ongrid.1` | ongrid | `pwbm.drawing` | `19/44`: 0 / 0 | no_applicable_geometry | vacuous-confirmed |
| `pwde.angle.1` | angle | `pwde.drawing` | `124/20`: 0 / 0 | no_applicable_geometry | vacuous-confirmed |
| `pwde.ongrid.1` | ongrid | `pwde.drawing` | `124/20`: 0 / 0 | no_applicable_geometry | vacuous-confirmed |
| `pwell_rs.angle.1` | angle | `pwell.res` | `64/13`: 0 / 0 | no_applicable_geometry | vacuous-confirmed |
| `pwell_rs.ongrid.1` | ongrid | `pwell.res` | `64/13`: 0 / 0 | no_applicable_geometry | vacuous-confirmed |
| `rpm.angle.1` | angle | `rpm.drawing` | `86/20`: 0 / 0 | no_applicable_geometry | vacuous-confirmed |
| `rpm.ongrid.1` | ongrid | `rpm.drawing` | `86/20`: 0 / 0 | no_applicable_geometry | vacuous-confirmed |
| `tunm.angle.1` | angle | `tunm.drawing` | `80/20`: 0 / 0 | no_applicable_geometry | vacuous-confirmed |
| `tunm.ongrid.1` | ongrid | `tunm.drawing` | `80/20`: 0 / 0 | no_applicable_geometry | vacuous-confirmed |
| `uhvi.angle.1` | angle | `uhvi.drawing` | `74/22`: 0 / 0 | no_applicable_geometry | vacuous-confirmed |
| `uhvi.ongrid.1` | ongrid | `uhvi.drawing` | `74/22`: 0 / 0 | no_applicable_geometry | vacuous-confirmed |
| `vhvi.angle.1` | angle | `vhvi.drawing` | `74/21`: 0 / 0 | no_applicable_geometry | vacuous-confirmed |
| `vhvi.ongrid.1` | ongrid | `vhvi.drawing` | `74/21`: 0 / 0 | no_applicable_geometry | vacuous-confirmed |
| `vpp.angle.1` | angle | `capacitor.drawing` | `82/64`: 0 / 0 | no_applicable_geometry | vacuous-confirmed |
| `vpp.ongrid.1` | ongrid | `capacitor.drawing` | `82/64`: 0 / 0 | no_applicable_geometry | vacuous-confirmed |

## Table 2: stream layers no curated rule reads

| layer/datatype | shapes (definition) | shapes (flattened) | text objects | geometry | text-only? | annotation | deck layer name | verdict |
|---|---|---|---|---|---|---|---|---|
| `64/5` | 69 | 7933 | 7933 | 0 | yes | no | - | text-or-marker-only |
| `64/16` | 70 | 8029 | 0 | 8029 | no | no | - | present-unruled |
| `64/59` | 69 | 7933 | 7933 | 0 | yes | no | - | text-or-marker-only |
| `67/5` | 1577 | 15278 | 15278 | 0 | yes | no | - | text-or-marker-only |
| `67/16` | 511 | 14872 | 0 | 14872 | no | no | - | present-unruled |
| `68/5` | 699 | 17771 | 17771 | 0 | yes | no | - | text-or-marker-only |
| `68/16` | 140 | 17402 | 0 | 17402 | no | no | - | present-unruled |
| `69/5` | 208 | 208 | 208 | 0 | yes | no | - | text-or-marker-only |
| `69/16` | 29 | 29 | 0 | 29 | no | no | - | present-unruled |
| `70/5` | 160 | 160 | 160 | 0 | yes | no | - | text-or-marker-only |
| `70/16` | 82 | 82 | 0 | 82 | no | no | - | present-unruled |
| `72/5` | 20 | 20 | 20 | 0 | yes | no | - | text-or-marker-only |
| `72/16` | 17 | 17 | 0 | 17 | no | no | - | present-unruled |
| `81/4` | 69 | 8605 | 0 | 8605 | no | no | - | present-unruled |
| `81/23` | 1 | 1 | 0 | 1 | no | no | - | present-unruled |
| `83/44` | 69 | 8605 | 8605 | 0 | yes | no | - | text-or-marker-only |
| `122/16` | 70 | 8029 | 0 | 8029 | no | no | - | present-unruled |
| `235/4` | 1 | 1 | 0 | 1 | no | no | - | present-unruled |
| `236/0` | 64 | 2321 | 0 | 2321 | no | no | - | present-unruled |

`present-unruled` is a residual gap by definition: these shapes are in the stream and no curated rule checks them. The curated deck's layer table names none of these layer/datatypes, and the audit does not guess their purpose.
