2AMLogic/sky130-trng/sim/digital-sdf-timed-verification/records/20261009-172301-8cbd26a.md

# 20261009-172301-8cbd26a -- digital-sdf-timed-verification

**Claim**: The directed bit-exact trng_digital suite (4239 cycles, 11 phases) passes through the pinned native `klt functional-verification` interface on the routed sky130_fd_sc_hd netlist with the post-route SDF back-annotated (Icarus 13.0, single corner tt_025C_1v80, 20000 ns and 8 ns periods; annotation partial: no TIMINGCHECK), with a mistargeted SDF, an unannotated run, an exact +137 ps instance-level delay shift, a +15000 ns delay shift and a 5 ns clock all behaving as controls. Not a PVT sweep; simulation-derived and provisional; DR-0004 remains Proposed.

**Level**: gate (post-route as-built netlist, SDF-annotated, single corner)
**Seeds**: {"cosim_stimulus_seed": 20260905, "cocotb_random_seed": 1}
**Supersedes**: (none)

---
## Configuration

- native interface: `klt functional-verification` (klt 0.7.0), engine `icarus` 13.0, cocotb 2.0.1, simulator transcript tool `Icarus Verilog version 13.0 (stable) (v13_0)`; all numbers are read from the tool's own JSON reports (preserved per run).
- DUT: `layout/trng_digital/trng_digital.routed.v` (sha256 `sha256:9f3956848e6e75223f75bd154df905fecbb4e988593e78d1a92e347969fbf37f`, bound to the committed digital-pnr record) against the sky130_fd_sc_hd **timing** (`specify`, non-`FUNCTIONAL`, no `UNIT_DELAY`) Verilog cell models, with `layout/trng_digital/trng_digital.sdf.gz` back-annotated (`options.sdf`, corner selector `typ`, `entries: all`).
- stimulus/oracle: the #222 directed program (seed 20260905, 4239 cycles, 11 phases), the independent normative model, 13 tests per run (drive + phases + exact length). Clock period is parameterised by `TRNG_FV_CLK_NS` in `digital/tb/cocotb/test_trng_digital_fv.py` (default 10 -> the #222 records are unaffected).
- declared timing: clock period 20000 ns (the 50 kHz period of `pnr-trng-digital-50khz.json`); inputs are launched at the falling edge (period/2 after the capturing edge) and outputs are sampled the next falling edge (period/2 after launch); reset asserted before the first rising edge and released at the first falling edge. The P&R SDC's 4000 ns input/output delays are inside that window (10000 ns).
- reproduction: `uv venv .venv && uv pip install --python .venv/bin/python "klayout-tools==0.7.0" "cocotb==2.0.1" && python3 sim/digital-sdf-timed-verification/harness/fv-sdf-cosim.py --klt .venv/bin/klt --emit-record`

## SDF provenance and annotation coverage

- source SDF: `layout/trng_digital/trng_digital.sdf.gz` sha256 `sha256:46850cda3d0948738e17a6e70fdb4f71e6c9829e9f925547a934f15d9fc5dd78`; decompressed `sha256:cae0b59b15787cd9fecce34fd6746f77af1816215fc3a17725f763b2a578db15`. Corner: the P&R request's `tt_025C_1v80`, `INTERCONNECT` all zero, SDF carries one value per arc (min=typ=max for most arcs).
- independent census (not the tool's): 6030 IOPATH, 6163 INTERCONNECT (0 non-zero), 456 TIMINGCHECK sections; 2320 SDF cell instances vs 2321 netlist cell instances, 2320 present in both with 0 cell-type mismatches; 1 netlist instances absent from the SDF (e.g. ['ANTENNA_1']), 0 SDF instances absent from the netlist.
- one preprocessing step, disclosed: 39 `INTERCONNECT <bus_addr|bus_wdata>[i] <inst>.<pin> (0.000:0.000:0.000)` entries (bit-selected top-level input as source) were removed before handing the SDF to the tool, because Icarus 13.0 cannot resolve a bit-selected port as an intermodpath source (klt documents this as unfixable, functional_verification finding 9b) and the tool correctly refuses the run otherwise (31 `Could not find intermodpath!`). Every dropped entry is zero-delay, so no delay is lost. The unmodified SDF is not accepted by the tool; the derived SDF is hashed above and each report's `environment.sdf.file` names it.
- tool-reported (`timed-declared`, `environment.sdf`): annotated=True, partial=True, corner=typ, entries=all, dropped classes {'timingcheck': 455, 'zero_delay_alias_port_interconnect': 33}. **`partial: true`** because Icarus 13.0 does not implement SDF `TIMINGCHECK` (all 455 sections dropped: setup/hold/recovery/removal limits are NOT checked in simulation) and 33 zero-delay `INTERCONNECT` entries onto assign-aliased output ports are dropped. No `SDF WARNING`/`ERROR` remained actionable in any accepted run.

## Timed baselines (must pass; byte-compared to the oracle)

| Run | period | status | tests | sdf annotated | stimulus / observed / model lines | observed == model | probe latencies (ps, min..max) |
|---|---|---|---|---|---|---|---|
| timed-declared | 20000 ns | **pass** | 13/13 | True | 4239 / 4239 / 4239 | True | bus_rdata 873..931 (n=268), out_data 1041..2075 (n=265), startup_done 1042..1077 (n=4) |
| timed-at-speed | 8 ns | **pass** | 13/13 | True | 4239 / 4239 / 4239 | True | bus_rdata 873..931 (n=268), out_data 1041..2075 (n=265), startup_done 1042..1077 (n=4) |

Per-test results (timed-declared):

- `test_00_drive_program`: passed
- `test_phase_01_post_reset_idle_id_parameter_reads`: passed
- `test_phase_02_sampling_disabled_raw_valid_high_but_ctrl_en_low`: passed
- `test_phase_03_enable_run_the_start_up_window_with_interleaved_`: passed
- `test_phase_04_drain_the_raw_fifo_through_raw_data_pop_on_read`: passed
- `test_phase_05_raw_streaming_port_out_ready_pops_while_sampling`: passed
- `test_phase_06_simultaneous_register_pop_and_stream_pop_registe`: passed
- `test_phase_07_out_mode_switch_to_conditioned_flushes_both_path`: passed
- `test_phase_08_induce_an_rct_trip_with_a_stuck_source`: passed
- `test_phase_09_gated_data_blocked_raw_data_still_readable`: passed
- `test_phase_10_write_1_to_clear_then_re_run_the_start_up_test`: passed
- `test_phase_11_soft_rst_then_resume_sampling`: passed
- `test_zz_trace_length_exact`: passed

## Annotation / timing controls (each must be detected)

- `sdf-removed`: identical models/netlist/testbench/period, `options.sdf` omitted -> **detected = True**. functional verdict pass, environment.sdf=None, output latencies all 0 ps -> the timed-coverage gate rejects it
- `sdf-mistargeted`: every `(INSTANCE _N_)` in the SDF renamed `_zzN_` (no instance matches) -> **detected = True**. tool exit 1 (error envelope on stderr, preserved as `ctl-sdf-mistargeted.stderr.json`): SDF back-annotation of '<work>/sdf/trng_digital.mistargeted.sdf' did not fully apply: 2165 diagnostic(s) in the icarus transcript -- SDF ERROR: <work>/ctl-sdf-mistargeted/.klt/functional...
- `delay-shift-exact`: +137 ps on the `IOPATH CLK Q` arc of _3399_ (the flop driving `startup_done`) -> **detected = True**. oracle pass; startup_done clk->out latencies [1077, 1042, 1077, 1042] -> [1214, 1179, 1214, 1179] (deltas [137]); bus_rdata/out_data latencies unchanged: True
- `delay-fail`: +15000 ns on the same arc (output settles after the sample point) -> **detected = True**. exit 3, 5/13 tests failed: ['test_phase_03_enable_run_the_start_up_window_with_interleaved_', 'test_phase_08_induce_an_rct_trip_with_a_stuck_source', 'test_phase_10_write_1_to_clear_then_re_run_the_start_up_test', 'test_phase_11_soft_rst_then_resume_sampling', 'test_zz_trace_length_exact']
- `clock-5ns`: SDF baseline at 5 ns period (half period shorter than the annotated output paths) -> **detected = True**. annotated: exit 3, 2/13 failed ['test_phase_07_out_mode_switch_to_conditioned_flushes_both_path', 'test_zz_trace_length_exact']; same run without SDF: exit 0 pass (zero-delay)

## T1 item 7 (digital) review

- The checklist's digital item 7 accepts a `klt functional-verification` report with an `environment.sdf` object with `annotated: true` (a null `sdf` renders `not_post_layout`). `timed-declared.report.json` is such a report: annotated=True, partial=True.
- Eligibility caveats that travel with any citation: the report is `partial` (no TIMINGCHECK, derived SDF with 39 zero-delay entries removed); one SDF corner only (tt_025C_1v80); the SDF carries no wire delay; DR-0004 (digital section) is `status: Proposed`, so the verdict is against a Proposed specification and provisional. See `signoff/README.md` for the resulting citation decision.

## What this record does and does not establish

- Established: with the post-route SDF back-annotated through the native tool, the routed netlist reproduces the independent model on all six outputs every cycle of the directed program (startup/reset, health-test trip and recovery, bus read/write, raw/stream pop arbitration and out_ready backpressure, mode flush, soft reset) at the declared 20000 ns period and at an 8 ns stress period.
- Annotation reach is shown three ways beyond the tool's own diagnostic gate: an independent census of SDF vs netlist instances; the output-latency probe (registered outputs bus_rdata, out_data, startup_done show SDF-shaped non-zero ps latencies; the unannotated run shows 0); and an exact +137 ps shift on one named flop's CLK->Q arc that moves exactly that output's latency by 137 ps while leaving the other probed outputs untouched. The latency probe covers registered outputs only: with SDF module paths active, cocotb value-change callbacks do not fire on the combinational outputs (out_valid, alarm, gated); those are covered by the oracle comparison, the 5 ns clock control and the delay-fail control, not by the probe.
- **Not a PVT sweep.** One SDF, one corner (the P&R request's tt_025C_1v80), typ selector; nothing here says anything about ss/ff, voltage or temperature. The 16-corner STA remains the multi-corner timing evidence (`layout/trng_digital/sta.json`); STA is not replaced by this and this is not a replacement for it.
- **Setup/hold are not simulated.** Icarus 13.0 does not implement SDF TIMINGCHECK (all sections dropped; reported by the tool as `partial: true`). Metastability/violations of the characterised limits are therefore invisible here; only the delay arcs (IOPATH) are exercised. The 8 ns pass and 5 ns fail points are functional stress points under half-period launch/sample, not an fmax.
- The SDF carries zero INTERCONNECT (wire) delay at the committed corner: only cell arcs are timed. 39 zero-delay bit-selected-input-source INTERCONNECT entries were removed (Icarus limitation, disclosed above) and the tool drops 33 more zero-delay alias-port entries itself.
- Same directed, non-exhaustive program as #222; the declared 20000 ns period leaves ~10 us of margin against ~2 ns of annotated path delay, so the declared run proves annotation and function at the constrained clock, while the 8 ns / 5 ns pair brackets where the annotated delays start to matter.
- Functional / unit-delay records (#222) are untouched and remain the functional baseline.
- Simulation-derived; provisional until silicon. DR-0004 (digital section) is still Proposed, so no ratification-dependent claim (item 5) is made. No entropy claim.

---

## Provenance

- Author: loom-builder@sky130-trng
- Timestamp (UTC): 2026-10-09T17:23:01.263832+00:00
- Repo commit: `8cbd26a`
- Tools: {"python": "3.12.3", "platform": "Linux-7.0.0-1013-aws-x86_64-with-glibc2.39", "klt": "klt 0.7.0", "cocotb": "2.0.1", "iverilog": "Icarus Verilog version 13.0 (stable) (v13_0)"}
- Artifacts (committed alongside this record):
  - `sim/digital-sdf-timed-verification/runs/20261009-172301-8cbd26a/timed-declared.request.json`
  - `sim/digital-sdf-timed-verification/runs/20261009-172301-8cbd26a/timed-declared.report.json`
  - `sim/digital-sdf-timed-verification/runs/20261009-172301-8cbd26a/timed-declared.results.xml`
  - `sim/digital-sdf-timed-verification/runs/20261009-172301-8cbd26a/timed-declared.timing-probe.json`
  - `sim/digital-sdf-timed-verification/runs/20261009-172301-8cbd26a/timed-declared.stimulus.txt`
  - `sim/digital-sdf-timed-verification/runs/20261009-172301-8cbd26a/timed-declared.observations.txt`
  - `sim/digital-sdf-timed-verification/runs/20261009-172301-8cbd26a/timed-declared.model-observations.txt`
  - `sim/digital-sdf-timed-verification/runs/20261009-172301-8cbd26a/timed-at-speed.request.json`
  - `sim/digital-sdf-timed-verification/runs/20261009-172301-8cbd26a/timed-at-speed.report.json`
  - `sim/digital-sdf-timed-verification/runs/20261009-172301-8cbd26a/timed-at-speed.results.xml`
  - `sim/digital-sdf-timed-verification/runs/20261009-172301-8cbd26a/timed-at-speed.timing-probe.json`
  - `sim/digital-sdf-timed-verification/runs/20261009-172301-8cbd26a/timed-at-speed.stimulus.txt`
  - `sim/digital-sdf-timed-verification/runs/20261009-172301-8cbd26a/timed-at-speed.observations.txt`
  - `sim/digital-sdf-timed-verification/runs/20261009-172301-8cbd26a/timed-at-speed.model-observations.txt`
  - `sim/digital-sdf-timed-verification/runs/20261009-172301-8cbd26a/ctl-sdf-removed.request.json`
  - `sim/digital-sdf-timed-verification/runs/20261009-172301-8cbd26a/ctl-sdf-removed.report.json`
  - `sim/digital-sdf-timed-verification/runs/20261009-172301-8cbd26a/ctl-sdf-removed.results.xml`
  - `sim/digital-sdf-timed-verification/runs/20261009-172301-8cbd26a/ctl-sdf-removed.timing-probe.json`
  - `sim/digital-sdf-timed-verification/runs/20261009-172301-8cbd26a/ctl-sdf-removed.stimulus.txt`
  - `sim/digital-sdf-timed-verification/runs/20261009-172301-8cbd26a/ctl-sdf-removed.observations.txt`
  - `sim/digital-sdf-timed-verification/runs/20261009-172301-8cbd26a/ctl-sdf-removed.model-observations.txt`
  - `sim/digital-sdf-timed-verification/runs/20261009-172301-8cbd26a/ctl-sdf-mistargeted.request.json`
  - `sim/digital-sdf-timed-verification/runs/20261009-172301-8cbd26a/ctl-sdf-mistargeted.report.json`
  - `sim/digital-sdf-timed-verification/runs/20261009-172301-8cbd26a/ctl-sdf-mistargeted.results.xml`
  - `sim/digital-sdf-timed-verification/runs/20261009-172301-8cbd26a/ctl-sdf-mistargeted.stderr.json`
  - `sim/digital-sdf-timed-verification/runs/20261009-172301-8cbd26a/ctl-sdf-mistargeted.timing-probe.json`
  - `sim/digital-sdf-timed-verification/runs/20261009-172301-8cbd26a/ctl-sdf-mistargeted.stimulus.txt`
  - `sim/digital-sdf-timed-verification/runs/20261009-172301-8cbd26a/ctl-sdf-mistargeted.observations.txt`
  - `sim/digital-sdf-timed-verification/runs/20261009-172301-8cbd26a/ctl-sdf-mistargeted.model-observations.txt`
  - `sim/digital-sdf-timed-verification/runs/20261009-172301-8cbd26a/ctl-delay-shift.request.json`
  - `sim/digital-sdf-timed-verification/runs/20261009-172301-8cbd26a/ctl-delay-shift.report.json`
  - `sim/digital-sdf-timed-verification/runs/20261009-172301-8cbd26a/ctl-delay-shift.results.xml`
  - `sim/digital-sdf-timed-verification/runs/20261009-172301-8cbd26a/ctl-delay-shift.timing-probe.json`
  - `sim/digital-sdf-timed-verification/runs/20261009-172301-8cbd26a/ctl-delay-shift.stimulus.txt`
  - `sim/digital-sdf-timed-verification/runs/20261009-172301-8cbd26a/ctl-delay-shift.observations.txt`
  - `sim/digital-sdf-timed-verification/runs/20261009-172301-8cbd26a/ctl-delay-shift.model-observations.txt`
  - `sim/digital-sdf-timed-verification/runs/20261009-172301-8cbd26a/ctl-delay-fail.request.json`
  - `sim/digital-sdf-timed-verification/runs/20261009-172301-8cbd26a/ctl-delay-fail.report.json`
  - `sim/digital-sdf-timed-verification/runs/20261009-172301-8cbd26a/ctl-delay-fail.results.xml`
  - `sim/digital-sdf-timed-verification/runs/20261009-172301-8cbd26a/ctl-delay-fail.timing-probe.json`
  - `sim/digital-sdf-timed-verification/runs/20261009-172301-8cbd26a/ctl-delay-fail.stimulus.txt`
  - `sim/digital-sdf-timed-verification/runs/20261009-172301-8cbd26a/ctl-delay-fail.observations.txt`
  - `sim/digital-sdf-timed-verification/runs/20261009-172301-8cbd26a/ctl-delay-fail.model-observations.txt`
  - `sim/digital-sdf-timed-verification/runs/20261009-172301-8cbd26a/ctl-clock-5ns.request.json`
  - `sim/digital-sdf-timed-verification/runs/20261009-172301-8cbd26a/ctl-clock-5ns.report.json`
  - `sim/digital-sdf-timed-verification/runs/20261009-172301-8cbd26a/ctl-clock-5ns.results.xml`
  - `sim/digital-sdf-timed-verification/runs/20261009-172301-8cbd26a/ctl-clock-5ns.timing-probe.json`
  - `sim/digital-sdf-timed-verification/runs/20261009-172301-8cbd26a/ctl-clock-5ns.stimulus.txt`
  - `sim/digital-sdf-timed-verification/runs/20261009-172301-8cbd26a/ctl-clock-5ns.observations.txt`
  - `sim/digital-sdf-timed-verification/runs/20261009-172301-8cbd26a/ctl-clock-5ns.model-observations.txt`
  - `sim/digital-sdf-timed-verification/runs/20261009-172301-8cbd26a/ctl-clock-5ns-unannotated.request.json`
  - `sim/digital-sdf-timed-verification/runs/20261009-172301-8cbd26a/ctl-clock-5ns-unannotated.report.json`
  - `sim/digital-sdf-timed-verification/runs/20261009-172301-8cbd26a/ctl-clock-5ns-unannotated.results.xml`
  - `sim/digital-sdf-timed-verification/runs/20261009-172301-8cbd26a/ctl-clock-5ns-unannotated.timing-probe.json`
  - `sim/digital-sdf-timed-verification/runs/20261009-172301-8cbd26a/ctl-clock-5ns-unannotated.stimulus.txt`
  - `sim/digital-sdf-timed-verification/runs/20261009-172301-8cbd26a/ctl-clock-5ns-unannotated.observations.txt`
  - `sim/digital-sdf-timed-verification/runs/20261009-172301-8cbd26a/ctl-clock-5ns-unannotated.model-observations.txt`
  - `sim/digital-sdf-timed-verification/runs/20261009-172301-8cbd26a/trng_digital.baseline.sdf.gz`
  - `sim/digital-sdf-timed-verification/runs/20261009-172301-8cbd26a/sdf-mistargeted.diff.txt`
  - `sim/digital-sdf-timed-verification/runs/20261009-172301-8cbd26a/sdf-delay-shift.diff.txt`
  - `sim/digital-sdf-timed-verification/runs/20261009-172301-8cbd26a/sdf-delay-fail.diff.txt`
  - `sim/digital-sdf-timed-verification/runs/20261009-172301-8cbd26a/sdf-baseline-dropped-entries.diff.txt`
  - `sim/digital-sdf-timed-verification/runs/20261009-172301-8cbd26a/sdf-census.json`
  - `sim/digital-sdf-timed-verification/runs/20261009-172301-8cbd26a/input-hashes.json`

> **Provisional, simulation-derived.** Nothing in this record is a measurement of silicon, and nothing in it is an SP 800-90B entropy assessment. Per the root `CLAUDE.md`, simulation-derived entropy claims stay provisional until measured on silicon.
