2AMLogic/sky130-trng/sim/digital-functional-verification/records/20261009-120511-d9f51a4.md

# 20261009-120511-d9f51a4 -- digital-functional-verification

**Claim**: The directed bit-exact trng_digital suite (4239 cycles, 11 phases) passes through the pinned native `klt functional-verification` interface (klayout-tools 0.7.0, cocotb 2.0.1, Icarus 13.0) on both the RTL and the routed sky130_fd_sc_hd netlist at functional/unit-delay level against the independent behavioural model; an xor->and routed netlist, truncated, dropped and missing observations all fail the same path. Not SDF-timed (not item 7); the digital specification is still Proposed (item 5 not claimed).

**Level**: gate (post-route as-built netlist, functional/unit-delay -- NOT SDF-timed)
**Seeds**: {"cosim_stimulus_seed": 20260905, "cocotb_random_seed": 1}
**Supersedes**: (none)

---
## Configuration

- native interface: `klt functional-verification` (klt 0.7.0), engine `icarus` 13.0, cocotb 2.0.1; every number below is read from the tool's own JSON report (`report.json` per run, preserved), whose verdict is derived by the tool from cocotb's `results.xml` (preserved).
- testbench: `digital/tb/cocotb/test_trng_digital_fv.py` -- the SAME directed program (`rtl-cosim.py::build_program`, seed 20260905, 4239 cycles, 11 phases) and the SAME independent oracle (`digital/model`, via `rtl-cosim.py::model_trace`) as `sim/digital-rtl-equivalence`; it holds no golden vectors of its own.
- tests per run: 1 drive + 11 phase tests + 1 exact-length test = 13.
- simulator transcript tool: `Icarus Verilog version 13.0 (stable) (v13_0)`
- reproduction: `uv venv .venv && uv pip install --python .venv/bin/python "klayout-tools==0.7.0" "cocotb==2.0.1" && python3 sim/digital-functional-verification/harness/fv-cosim.py --klt .venv/bin/klt --emit-record`
- native command shape: `TRNG_FV_SEED=20260905 .venv/bin/klt functional-verification <run>/request.json --format json   # (+ --mutations <run>/proposals.json for the mutation runs; TRNG_FV_FAULT=<mode> for the observation-record controls)`

## Baselines (must pass; trace lengths and bytes checked independently of the tool)

| Run | DUT | status | tests | stimulus / observed / model lines | observed == model (bytes) |
|---|---|---|---|---|---|
| rtl | `digital/rtl/trng_digital.v` | **pass** | 13/13 passed | 4239 / 4239 / 4239 (program 4239) | True |
| routed-gate | `layout/trng_digital/trng_digital.routed.v + sky130_fd_sc_hd FUNCTIONAL/UNIT_DELAY #1` | **pass** | 13/13 passed | 4239 / 4239 / 4239 (program 4239) | True |

Per-test results (routed-gate):

- `test_00_drive_program`: passed
- `test_phase_01_post_reset_idle_id_parameter_reads`: passed
- `test_phase_02_sampling_disabled_raw_valid_high_but_ctrl_en_low`: passed
- `test_phase_03_enable_run_the_start_up_window_with_interleaved_`: passed
- `test_phase_04_drain_the_raw_fifo_through_raw_data_pop_on_read`: passed
- `test_phase_05_raw_streaming_port_out_ready_pops_while_sampling`: passed
- `test_phase_06_simultaneous_register_pop_and_stream_pop_registe`: passed
- `test_phase_07_out_mode_switch_to_conditioned_flushes_both_path`: passed
- `test_phase_08_induce_an_rct_trip_with_a_stuck_source`: passed
- `test_phase_09_gated_data_blocked_raw_data_still_readable`: passed
- `test_phase_10_write_1_to_clear_then_re_run_the_start_up_test`: passed
- `test_phase_11_soft_rst_then_resume_sampling`: passed
- `test_zz_trace_length_exact`: passed

## Negative controls (the new reporting path must reject each)

- `xor-to-and-all`: 19 xor2_1 instances rewritten to and2_1 in the routed netlist -> exit 3, status `fail`, 12/13 tests failed -- detected = **True**
- `truncated-observations`: observation record stops after 3815 of 4239 cycles (TRNG_FV_FAULT=truncate:3815) -> exit 3, status `fail`, 4/13 tests failed -- detected = **True**
- `dropped-observation`: cycle 1413's observation omitted from the record (TRNG_FV_FAULT=drop:1413) -> exit 3, status `fail`, 8/13 tests failed -- detected = **True**
- `no-observations`: no observation recorded at all (TRNG_FV_FAULT=truncate:0) -> exit 3, status `fail`, 13/13 tests failed -- detected = **True**

## Native mutation testing (`--mutations`, single-point xor->and mutants)

- `rtl`: 2 killed / 2 valid (0 rejected), mutation score 1.0; survivors: none
- `routed-gate`: 13 killed / 19 valid (0 rejected), mutation score 0.6842105263157895; survivors: ['trng_digital.routed.v:2176', 'trng_digital.routed.v:2183', 'trng_digital.routed.v:2840', 'trng_digital.routed.v:2983', 'trng_digital.routed.v:3095', 'trng_digital.routed.v:3231']

## T1 item 5 (digital) condition review

- multi-corner STA half: `layout/trng_digital/sta.json`, 16 corners, all constrained with non-negative setup/hold: **True**.
- bit-exact functional half: native reports above, RTL and routed netlist: **True**.
- specification ratification: DR-0004 `status: Proposed` -> **UNMET**. The digital section is still **Proposed**; verdicts against a Proposed spec are provisional by construction (the item's own note), so the compound item-5 citation is **NOT made** and `signoff/block-manifest.json` keeps `5.digital` uncited/unmet.
- routed netlist bound to the committed P&R record: sha256 `sha256:9f3956848e6e75223f75bd154df905fecbb4e988593e78d1a92e347969fbf37f` equals the `geometry_sha256` of `20261003-212010-fa76b17`: **True**.

## What this record does and does not establish

- Established: the committed directed program (the per-phase tests listed above), driven by a cocotb testbench, produces a trace identical to the independent normative model (`digital/model/digital_top.py`) on all six observed outputs every cycle, for the RTL and for the routed as-built netlist, with exact stimulus/observation/model trace-length equality; the tool-native per-test report, request, `results.xml`, traces, input hashes and tool pins are preserved with this record.
- **Functional / unit-delay only.** The routed run uses `FUNCTIONAL` zero-delay cell models plus `UNIT_DELAY #1` on sequential UDPs (a race-avoidance device, not a timing model); `options.sdf` is not set and `environment.sdf` is null in every native report. This is NOT the SDF-annotated run T1 item 7 requires and must not be counted as post-layout timed evidence.
- The oracle is the same behavioural model the RTL-equivalence and gate-cosim records use. The directed program is not exhaustive (no formal equivalence, no constrained-random campaign); the mutation score above is the honest measure of what it notices, and any survivor is a disclosed gap in the program, not a pass.
- The negative controls prove the new reporting path fails on a wrong netlist and on missing or truncated observations. The observation-record faults are injected in the testbench's record (`TRNG_FV_FAULT`), a test-of-the-test hook that is unset in every baseline.
- The pinned tool derives pass/fail from cocotb's `results.xml`; this harness additionally checks trace line counts and byte-equality of the preserved traces itself.
- **Item 5 (digital) is NOT claimed.** The STA half (`layout/trng_digital/sta.json`) and the functional half now both exist as evidence, but the item's own note requires a ratified specification and the digital section (DR-0004) is still `Proposed`; the manifest citation stays withheld and the item stays unmet.
- Simulation-derived; provisional until silicon. No entropy claim is made here (the entropy source is not part of this digital-only suite).

---

## Provenance

- Author: loom-builder@sky130-trng
- Timestamp (UTC): 2026-10-09T12:05:11.751894+00:00
- Repo commit: `d9f51a4`
- Tools: {"python": "3.12.3", "platform": "Linux-7.0.0-1014-aws-x86_64-with-glibc2.39", "klt": "klt 0.7.0", "cocotb": "2.0.1", "iverilog": "Icarus Verilog version 13.0 (stable) (v13_0)"}
- Artifacts (committed alongside this record):
  - `sim/digital-functional-verification/runs/20261009-120511-d9f51a4/rtl.request.json`
  - `sim/digital-functional-verification/runs/20261009-120511-d9f51a4/rtl.report.json`
  - `sim/digital-functional-verification/runs/20261009-120511-d9f51a4/rtl.results.xml`
  - `sim/digital-functional-verification/runs/20261009-120511-d9f51a4/routed-gate.request.json`
  - `sim/digital-functional-verification/runs/20261009-120511-d9f51a4/routed-gate.report.json`
  - `sim/digital-functional-verification/runs/20261009-120511-d9f51a4/routed-gate.results.xml`
  - `sim/digital-functional-verification/runs/20261009-120511-d9f51a4/control-xor-to-and-all.request.json`
  - `sim/digital-functional-verification/runs/20261009-120511-d9f51a4/control-xor-to-and-all.report.json`
  - `sim/digital-functional-verification/runs/20261009-120511-d9f51a4/control-xor-to-and-all.results.xml`
  - `sim/digital-functional-verification/runs/20261009-120511-d9f51a4/control-truncated-observations.request.json`
  - `sim/digital-functional-verification/runs/20261009-120511-d9f51a4/control-truncated-observations.report.json`
  - `sim/digital-functional-verification/runs/20261009-120511-d9f51a4/control-truncated-observations.results.xml`
  - `sim/digital-functional-verification/runs/20261009-120511-d9f51a4/control-dropped-observation.request.json`
  - `sim/digital-functional-verification/runs/20261009-120511-d9f51a4/control-dropped-observation.report.json`
  - `sim/digital-functional-verification/runs/20261009-120511-d9f51a4/control-dropped-observation.results.xml`
  - `sim/digital-functional-verification/runs/20261009-120511-d9f51a4/control-no-observations.request.json`
  - `sim/digital-functional-verification/runs/20261009-120511-d9f51a4/control-no-observations.report.json`
  - `sim/digital-functional-verification/runs/20261009-120511-d9f51a4/control-no-observations.results.xml`
  - `sim/digital-functional-verification/runs/20261009-120511-d9f51a4/mutation-rtl.request.json`
  - `sim/digital-functional-verification/runs/20261009-120511-d9f51a4/mutation-rtl.report.json`
  - `sim/digital-functional-verification/runs/20261009-120511-d9f51a4/mutation-rtl.proposals.json`
  - `sim/digital-functional-verification/runs/20261009-120511-d9f51a4/mutation-rtl.results.xml`
  - `sim/digital-functional-verification/runs/20261009-120511-d9f51a4/mutation-routed-gate.request.json`
  - `sim/digital-functional-verification/runs/20261009-120511-d9f51a4/mutation-routed-gate.report.json`
  - `sim/digital-functional-verification/runs/20261009-120511-d9f51a4/mutation-routed-gate.proposals.json`
  - `sim/digital-functional-verification/runs/20261009-120511-d9f51a4/mutation-routed-gate.results.xml`
  - `sim/digital-functional-verification/runs/20261009-120511-d9f51a4/rtl.stimulus.txt`
  - `sim/digital-functional-verification/runs/20261009-120511-d9f51a4/rtl.observations.txt`
  - `sim/digital-functional-verification/runs/20261009-120511-d9f51a4/rtl.model-observations.txt`
  - `sim/digital-functional-verification/runs/20261009-120511-d9f51a4/routed-gate.stimulus.txt`
  - `sim/digital-functional-verification/runs/20261009-120511-d9f51a4/routed-gate.observations.txt`
  - `sim/digital-functional-verification/runs/20261009-120511-d9f51a4/routed-gate.model-observations.txt`
  - `sim/digital-functional-verification/runs/20261009-120511-d9f51a4/input-hashes.json`

> **Provisional, simulation-derived.** Nothing in this record is a measurement of silicon, and nothing in it is an SP 800-90B entropy assessment. Per the root `CLAUDE.md`, simulation-derived entropy claims stay provisional until measured on silicon.
