2AMLogic/sky130-trng/sim/digital-health-test-parameters/records/20260905-192504-2ecb0a3.md

# 20260905-192504-2ecb0a3 -- digital-health-test-parameters

**Claim**: the SP 800-90B RCT/APT cutoffs for sky130-trng, evaluated from the formulas at this repository's own H target and 50 kbps raw rate; the APT degeneracy floor; and the false-alarm/latency consequences at that rate

**Level**: behavioral (derived -- exact arithmetic, no simulator)
**Seeds**: N/A (deterministic run; no stochastic input)
**Supersedes**: (none)

---
## Parameters this evaluation is conditional on

| Input | Value | Where it comes from |
|---|---|---|
| `alpha` | 2^-40 | false-alarm rate, re-derived below at this repo's own raw rate |
| `W` (APT window) | 1024 | SP 800-90B §4.4.2, binary source |
| `H` (design target) | 0.5 bit/sample | README target-specification row -- a **design target**, not a measurement |
| raw rate | 50,000 bps | DR-0003 §2, measured sky130 operating point |

**No sky130 raw bitstream has been simulated yet** (issue #21), so no
measured `H` exists for this process. Every cutoff below is therefore
*provisional*: correct arithmetic on an assumed input.

## 1. Cutoff table over an H grid

`C_RCT = 1 + ceil(-log2(alpha)/H)`; `C_APT` = smallest `C` with
`Pr(X >= C) <= alpha` for `X ~ Binomial(W, 2^-H)`, evaluated with 80-digit
decimal arithmetic (a float sum of 1024 terms cannot resolve a 2^-40 tail).

| `H` | `C_RCT` | `C_APT` | note |
|---|---|---|---|
| 0.0390625 | 1025 | none | **degenerate** -- no valid cutoff exists |
| 0.04 | 1001 | 1024 | degenerate in practice (cutoff within 2 of the window) |
| 0.05 | 801 | 1022 | degenerate in practice (cutoff within 2 of the window) |
| 0.1 | 401 | 1005 |  |
| 0.2 | 201 | 961 |  |
| 0.3 | 135 | 915 |  |
| 0.4 | 101 | 869 |  |
| 0.5 | 81 | 824 | **adopted** (README design target) |
| 0.5415 | 75 | 806 | DR-0003 §3's model-derived H at the chosen operating point |
| 0.6 | 68 | 780 |  |
| 0.7 | 59 | 739 |  |
| 0.8 | 51 | 699 |  |
| 0.9 | 46 | 661 |  |
| 1 | 41 | 625 |  |

**Adopted**: `C_RCT` = 81, `C_APT` = 824 at `H` = 0.5.

These are the same two numbers gf180-trng's DR-0002 records, and that
is a **result, not a port**: the formulas are identical, `alpha` and `W`
are identical, and both repositories currently target `H = 0.5`. The
table above is the load-bearing artifact -- the moment sky130's measured
`H` differs, the cutoffs move with it, and the agreement disappears.
Recomputing them here from first principles also independently
reproduces gf180-trng's own published values, which is the cheapest
available check that this implementation of the formulas is right.

## 2. APT degeneracy floor

`Pr(X >= W) = p^W = 2^(-H*W)`, so a cutoff `C <= W` exists only while
`2^(-H*W) <= alpha`, i.e.

    H > alpha_log2 / W = 40 / 1024 = 0.0390625

- direct evaluation at the floor: `Pr(X >= W)` = 9.094947e-13 vs `alpha` = 9.094947e-13 (equal to the last bit -- the floor is an open bound)
- `H` = 0.0380625 (just below): `C_APT` = none
- `H` = 0.0400625 (just above): `C_APT` = 1024 of 1024 -- valid, and useless

gf180-trng's DR-0002 states this floor as "H ~ 0.03, marginal below
H ~ 0.05". The exact value at these parameters is **0.0390625**, and
the practical floor is higher still: at `H` = 0.05 the cutoff is
1022 of 1024, i.e. the test only fires when
essentially every sample in a window matches. Sky130's array is sized
to `H` = 0.5 (DR-0002/DR-0003), an order of magnitude clear of
the floor, so this is a stated risk boundary rather than an active
constraint -- but it is exactly the boundary issue #21's measurement
could move the design into, and it is checked here rather than assumed.

## 3. Why `alpha = 2^-40` survives re-derivation at 50 kbps

`alpha` is a false-alarm rate, and a false-alarm *rate* only becomes a
false-alarm *interval* once a sample rate is fixed. sky130-trng's rate
is 20x lower than the row gf180-trng's choice was argued against, so the
inherited number has to be re-justified rather than assumed:

| Quantity | sky130-trng (50 kbps) | gf180-trng (1 Mbps row) |
|---|---|---|
| RCT false-alarm interval (one decision per sample) | 254.5 days | 12.7 days |
| APT false-alarm interval (one decision per 1024-sample window) | 713.6 years | -- |

At this rate `alpha = 2^-40` is **more** conservative than gf180-trng's
own justification needed it to be. It is kept anyway (DR-0004 §2.2):
relaxing it would tighten the cutoffs slightly while buying no
meaningful detection latency --
`C_RCT` at `alpha = 2^-30` is 61 versus 81 at 2^-40, i.e.
0.40 ms of detection latency at 50 kbps -- and it keeps this
block's parameters directly comparable with the sibling repository's.

## 4. Latency consequences at the measured operating point

| Quantity | Samples | Time at 50 kbps |
|---|---|---|
| RCT worst-case detection (a fully stuck source) | 81 | 1.62 ms |
| APT decision interval | 1024 | 20.48 ms |
| Start-up health test | 1024 | 20.48 ms |
| Time to first **raw** word (never gated) | 32 | 0.64 ms |
| Time to first **conditioned** word (start-up + one block) | 1280 | 25.60 ms |

The last row is the `time-to-first-valid` figure
`docs/chipalooza/challenge-4-proposal.md` row F had to leave as
"N/A -- architecture not yet designed".

---

## Provenance

- Author: loom-builder@sky130-trng
- Timestamp (UTC): 2026-09-05T19:25:04.084116+00:00
- Repo commit: `2ecb0a3`
- Tools: {"python": "3.14.7", "platform": "macOS-26.6.2-arm64-arm-64bit-Mach-O"}

> **Provisional, simulation-derived.** Nothing in this record is a measurement of silicon, and nothing in it is an SP 800-90B entropy assessment. Per the root `CLAUDE.md`, simulation-derived entropy claims stay provisional until measured on silicon.
