2AMLogic/sky130-trng/sim/digital-sdf-timed-verification/runs/20261009-172301-8cbd26a/ctl-clock-5ns-unannotated.model-observations.txt

00000000 0 00000000 0 1 0
00000000 0 00000000 0 1 0
00000000 0 00000000 0 1 0
54524e47 0 00000000 0 1 0
54524e47 0 00000000 0 1 0
00000051 0 00000000 0 1 0
00000051 0 00000000 0 1 0
00000338 0 00000000 0 1 0
00000338 0 00000000 0 1 0
00000400 0 00000000 0 1 0
00000400 0 00000000 0 1 0
00000400 0 00000000 0 1 0
00000400 0 00000000 0 1 0
00000100 0 00000000 0 1 0
00000100 0 00000000 0 1 0
00000002 0 00000000 0 1 0
00000002 0 00000000 0 1 0
00000000 0 00000000 0 1 0
00000000 0 00000000 0 1 0
00000000 0 00000000 0 1 0
00000000 0 00000000 0 1 0
00000000 0 00000000 0 1 0
00000000 0 00000000 0 1 0
00000000 0 00000000 0 1 0
00000000 0 00000000 0 1 0
00000000 0 00000000 0 1 0
00000000 0 00000000 0 1 0
00000000 0 00000000 0 1 0
00000000 0 00000000 0 1 0
00000000 0 00000000 0 1 0
00000000 0 00000000 0 1 0
00000000 0 00000000 0 1 0
00000000 0 00000000 0 1 0
00000000 0 00000000 0 1 0
00000000 0 00000000 0 1 0
00000000 0 00000000 0 1 0
00000000 0 00000000 0 1 0
00000000 0 00000000 0 1 0
00000000 0 00000000 0 1 0
00000000 0 00000000 0 1 0
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
00000006 1 bd70d1a4 0 1 0
00000006 1 bd70d1a4 0 1 0
00000006 1 bd70d1a4 0 1 0
00000006 1 bd70d1a4 0 1 0
00000006 1 bd70d1a4 0 1 0
00000006 1 bd70d1a4 0 1 0
00000006 1 bd70d1a4 0 1 0
00000006 1 bd70d1a4 0 1 0
00000006 1 bd70d1a4 0 1 0
00000006 1 bd70d1a4 0 1 0
00000006 1 bd70d1a4 0 1 0
00000006 1 bd70d1a4 0 1 0
00000006 1 bd70d1a4 0 1 0
00000006 1 bd70d1a4 0 1 0
00000006 1 bd70d1a4 0 1 0
00000006 1 bd70d1a4 0 1 0
00000006 1 bd70d1a4 0 1 0
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
00000002 0 00000000 0 1 0
00000002 0 00000000 0 1 0
00000002 0 00000000 0 1 0
00000002 0 00000000 0 1 0
00000002 0 00000000 0 1 0
00000002 0 00000000 0 1 0
00000002 0 00000000 0 1 0
00000002 1 89786724 0 1 0
00000002 1 89786724 0 1 0
00000002 1 89786724 0 1 0
00000002 1 89786724 0 1 0
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
