2AMLogic/sky130-trng/sim/digital-sdf-timed-verification/runs/20261009-172301-8cbd26a/ctl-clock-5ns-unannotated.stimulus.txt

0 0 0 0 0 00000000 0
0 0 0 0 0 00000000 0
0 0 10 0 1 00000000 0
0 0 0 0 0 00000000 0
0 0 5 0 1 00000000 0
0 0 0 0 0 00000000 0
0 0 6 0 1 00000000 0
0 0 0 0 0 00000000 0
0 0 7 0 1 00000000 0
0 0 0 0 0 00000000 0
0 0 8 0 1 00000000 0
0 0 0 0 0 00000000 0
0 0 9 0 1 00000000 0
0 0 0 0 0 00000000 0
0 0 1 0 1 00000000 0
0 0 0 0 0 00000000 0
0 0 0 0 1 00000000 0
0 0 0 0 0 00000000 0
0 0 4 0 1 00000000 0
0 0 0 0 0 00000000 0
1 1 0 0 0 00000000 0
1 1 0 0 0 00000000 0
0 1 0 0 0 00000000 0
0 1 0 0 0 00000000 0
1 1 0 0 0 00000000 0
1 1 0 0 0 00000000 0
1 1 0 0 0 00000000 0
0 1 0 0 0 00000000 0
1 1 0 0 0 00000000 0
0 1 0 0 0 00000000 0
0 1 0 0 0 00000000 0
1 1 0 0 0 00000000 0
1 1 0 0 0 00000000 0
1 1 0 0 0 00000000 0
0 1 0 0 0 00000000 0
0 1 0 0 0 00000000 0
0 1 0 0 0 00000000 0
1 1 0 0 0 00000000 0
1 1 0 0 0 00000000 0
0 1 0 0 0 00000000 0
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
