2AMLogic/sky130-trng/sim/digital-repaired-compaction/records/20261010-105914-824542d.md

# Repaired floorplan compaction -- 16-corner electrical closure -- issue #251

**Outcome: recommend `rep65-slew0531` as the preferred repaired compacted digital floorplan, conditional on a later composed and fully re-verified layout.** It is NOT promoted: `layout/trng_digital/` and `layout/trng_whole/` are untouched, the spec and the area target (`Area < 0.05 mm2`) are unchanged, and the target stays unmet.

Scope: study-run P&R on the committed netlist and committed flow settings, checked with the pinned klt/OpenROAD/Liberty decks. Simulation-derived physical-design evidence, not silicon. The final-route audit is the sibling OpenSTA script from #236 (klt has no such check; klayout-tools#3005), not a klt-reported signoff. Whole-block areas are ESTIMATES until a composition is built and verified.

## Inputs and provenance

- klt `0.6.0+g10f3da34c088` (tool-pins.json build, worktree venv; no host tool changed); OpenROAD `26Q3-1510-g6cb3f2b704`.
- committed request `digital/flow/place-and-route/pnr-trng-digital-50khz.json` sha256:97b6cb9123e43cbacb09724dc448ec8e976a78cd46dc85a1580a66fc54232350
- fixed in every run: netlist (same file), seed 20260905, 20000 ns clock, 4000 ns IO delays, aspect ratio 1.0, 5 um core margin, IO layers, sky130hd power preset, route stage, SPEF+SDF; no `set_load`/`set_driving_cell` (not in the request schema).
- varied: `floorplan.utilization_pct` (40/55/65) and `constraints.max_transition_ns`.

| request | sha256 | differences vs committed request |
|---|---|---|
| `sim/digital-repaired-compaction/runs/20261010-092825-main/rep40-slew0531/rep40-slew0531.json` | `sha256:6720f3f92a477c098a11976ac48d1df26468213c9c7bfc3f9f10f72f1fa2e6c1` | `constraints.max_transition_ns: None -> 0.531` (+ netlist path rebased) |
| `sim/digital-repaired-compaction/runs/20261010-092825-main/rep55-slew0531/rep55-slew0531.json` | `sha256:58ee00310720ddd335299c35c60216a46705c7e6267bc7979e440f0c8d224e8d` | `constraints.max_transition_ns: None -> 0.531`; `floorplan.utilization_pct: 40 -> 55` (+ netlist path rebased) |
| `sim/digital-repaired-compaction/runs/20261010-092825-main/rep65-slew0531/rep65-slew0531.json` | `sha256:a6b675d583b2388e397a5b828d9d98111df672b1f0caf1bc8dcfed3097f4958a` | `constraints.max_transition_ns: None -> 0.531`; `floorplan.utilization_pct: 40 -> 65` (+ netlist path rebased) |

Slew budgets re-derived per floorplan with `sim/digital-electrical-repair/analysis/derive_limits.py` on the #226 unrepaired routed geometry (tt-deck budget = min over corners of Liberty limit / measured slew ratio, with 10 % margin):

| utilisation | derived minimum budget ns | with 10 % margin ns | used here |
|---|---|---|---|
| 40 | 0.5903 | 0.531 | 0.531 (recorded #236 candidate) |
| 55 | 0.5823 | 0.524 | 0.531 (looser than the derived 0.524; passed the audit, so the derived value was not run -- `requests/rep55-slew0524.json` is kept unrun) |
| 65 | 0.5926 | 0.533 | 0.531 (tighter than derived 0.533; same recorded value) |

## Control: repaired 40 % vs the recorded #236 candidate

- reference_run: `sim/digital-electrical-repair/runs/20261010-cand1/slew0531`
- geometry_byte_identical: `True`
- request_byte_identical: `True`
- die_area_equal: `True`
- std_cell_area_equal: `True`
- klt_version_equal: `True`
- reproduced: `True`

A reproduced control means the pinned tool, inputs and seed behave identically to the #236 record, so differences at 55 %/65 % are due to the floorplan.

## Unrepaired baseline at final route (this study's audit of the #226 geometry)

| point | est slew/cap (16-corner sum, #226) | final-route slew/cap (16-corner sum) | verdict |
|---|---|---|---|
| util40 (#236 control record) | 1130 / 37 | 1512 / 50 | not clean |
| unrepaired-util55 | 1134 / 31 | 1242 / 38 | not clean: final-route violations |
| unrepaired-util65 | 1233 / 38 | 1522 / 48 | not clean: final-route violations |

## Repaired candidates (all kept, failures included)

| run | util % target (achieved) | die um2 | est slew/cap | final slew/cap | corners audited | route DRC / antenna | klt DRC | LVS sig / power | setup / hold viol | cosim | controls | selectable |
|---|---|---|---|---|---|---|---|---|---|---|---|---|
| rep40-slew0531 | 40 (43.7346) | 60049.5 | 0 / 0 | 0 / 0 | 16/16 | 0 / 0 | clean | match / match | 0 / 0 | PASS | 4/4 | True |
| rep55-slew0531 | 55 (59.6379) | 44291.3 | 0 / 0 | 0 / 0 | 16/16 | 0 / 0 | clean | match / match | 0 / 0 | PASS | 4/4 | True |
| rep65-slew0531 | 65 (69.8769) | 37787.5 | 0 / 0 | 0 / 0 | 16/16 | 0 / 0 | clean | match / match | 0 / 0 | PASS | 4/4 | True |

Per-corner final-route electrical margins (smallest remaining slack over audited pins; slew ns / cap pF; a count in place of a margin means violations remain):

| corner | rep40-slew0531 | rep55-slew0531 | rep65-slew0531 |
|---|---|---|---|
| ff_100C_1v65 | 1.0063 / 0.0355 | 1.0376 / 0.0351 | 1.0131 / 0.0359 |
| ff_100C_1v95 | 1.1054 / 0.05 | 1.1304 / 0.0496 | 1.1108 / 0.0504 |
| ff_n40C_1v56 | 0.8856 / 0.022 | 0.8786 / 0.0216 | 0.8456 / 0.0218 |
| ff_n40C_1v65 | 0.9476 / 0.0274 | 0.9626 / 0.027 | 0.9347 / 0.0273 |
| ff_n40C_1v76 | 1.0152 / 0.0337 | 1.0378 / 0.0333 | 1.0042 / 0.0336 |
| ff_n40C_1v95 | 1.0867 / 0.0446 | 1.1141 / 0.0442 | 1.0774 / 0.0444 |
| ss_100C_1v40 | 8.549 / 0.0905 | 8.6396 / 0.0901 | 8.6421 / 0.0909 |
| ss_100C_1v60 | 0.465 / 0.0087 | 0.5316 / 0.0101 | 0.5341 / 0.0116 |
| ss_n40C_1v28 | 1.228 / 0.0041 | 0.8393 / 0.0037 | 0.5854 / 0.0031 |
| ss_n40C_1v35 | 7.352 / 0.0312 | 7.2139 / 0.031 | 7.0503 / 0.0305 |
| ss_n40C_1v40 | 7.8154 / 0.0426 | 7.7437 / 0.0424 | 7.6172 / 0.0419 |
| ss_n40C_1v44 | 3.1398 / 0.0212 | 3.1058 / 0.021 | 2.9986 / 0.0205 |
| ss_n40C_1v60 | 0.2987 / 0.0048 | 0.272 / 0.0045 | 0.2097 / 0.0043 |
| ss_n40C_1v76 | 0.6307 / 0.0119 | 0.6129 / 0.0115 | 0.5698 / 0.0118 |
| tt_025C_1v80 | 0.9247 / 0.0273 | 0.9433 / 0.0269 | 0.9171 / 0.0271 |
| tt_100C_1v80 | 0.9267 / 0.0299 | 0.9638 / 0.0287 | 0.9416 / 0.0298 |

Smallest-margin corner moves with compaction: at `ss_n40C_1v28` the slew margin falls from 1.228 ns (40 %) to 0.585 ns (65 %) and at `ss_n40C_1v60` from 0.299 ns to 0.210 ns; all remain positive. The 0.531 ns budget generalises to these two floorplans on this netlist and seed; the margin between the derived minimum (~0.59 ns) and the chosen value is not shown to be necessary.

## Cost: area, cells, buffers, timing

| run | digital die W x H um | die mm2 | std-cell area um2 | logic+buffer instances | `place*` repair buffers | clkbuf | wirelength um | worst setup slack ns | worst hold slack ns | clock skew ns |
|---|---|---|---|---|---|---|---|---|---|---|
| rep40-slew0531 | 245.05 x 245.05 | 0.060049 | 24000.5 | 2389 | 90 | 73 | 67149 | 15958.4 | 0.2838 | 0.0794 |
| rep55-slew0531 | 210.46 x 210.46 | 0.044291 | 23695.2 | 2384 | 82 | 75 | 65474 | 15955.9 | 0.28184 | 0.02678 |
| rep65-slew0531 | 194.39 x 194.39 | 0.037788 | 23431.2 | 2356 | 72 | 71 | 62589 | 15955.6 | 0.28478 | 0.06042 |

Repair cost relative to the same-utilisation unrepaired #226 geometry (std-cell area, from the retained route metrics):

| utilisation | unrepaired std-cell um2 | repaired std-cell um2 | delta % |
|---|---|---|---|
| 40 (0.531 ns) | 23396.2 | 24000.5 | 2.6 |
| 55 (0.531 ns) | 23188.5 | 23695.2 | 2.2 |
| 65 (0.531 ns) | 23052.1 | 23431.2 | 1.6 |

## Area (digital bbox actual; whole block ESTIMATED, not composed)

Estimate definitions are those of `sim/digital-floorplan-compaction/records/20261009-214736-760b4d3.md`: estimate A = digital + analog bbox + the committed composition's non-macro area held constant; estimate B = the committed topology re-stacked around the resized digital macro (reproduces 0.126116 mm2 at the baseline size).

| candidate | digital bbox mm2 (actual) | estimate A mm2 | estimate B mm2 | B / target | B gap to 0.05 mm2 | selectable |
|---|---|---|---|---|---|---|
| committed baseline | 0.060050 | 0.126116 | 0.126116 (composed, verified: 0.126116) | 2.522x | +0.076116 | -- |
| rep40-slew0531 | 0.060050 | 0.126116 | 0.126116 | 2.522x | +0.076116 | True |
| rep55-slew0531 | 0.044291 | 0.110358 | 0.102693 | 2.054x | +0.052693 | True |
| rep65-slew0531 | 0.037787 | 0.103854 | 0.093609 | 1.872x | +0.043609 | True |

Incremental progress of `rep65-slew0531` vs the committed baseline (estimate B): 0.032508 mm2 removed = 42.7 % of the baseline gap. Remaining gap to the unchanged target: **+0.043609 mm2** (1.87x).

## Recommendation

Recommend `rep65-slew0531`: every declared check holds (route DRC 0, antenna 0, klt DRC, cell-level LVS signal and power, 16-corner setup/hold, routed-netlist cosim, 4/4 negative controls, final-route Liberty max-slew/max-cap at 16/16 corners with zero violations, estimate counts zero and cross-checked). It is the smallest-die point that satisfies them. This is a preference conditional on a future change that composes and re-verifies it (including the composed-block electrical audit); it is not a promotion and it does not meet the target.

## What this record does and does not establish

- Established: P&R runs of the unchanged netlist at the listed utilisation/slew-budget points on the pinned flow, each through the unchanged `sim/digital-pnr/` chain plus the #236 final-route audit, with every request, hash and failure retained under `sim/digital-repaired-compaction/runs/20261010-092825-main/`.
- Not established: a composed whole-block layout using any compacted macro (areas are estimates); behaviour at silicon; SDF-timed simulation of these runs; foundry-signoff extraction; port loading beyond the OpenSTA default; whether the slew budget is minimal (margins between the derived minimum and the chosen value are untested). Same verification limits as `sim/digital-pnr/records/20261003-212010-fa76b17.md`.
- Tool gaps: klt has no final-route max-slew/max-cap check (klayout-tools#3005, already filed). No new gap found by this study unless listed in the PR.

---

- Author: Loom builder (issue #251)
- Timestamp (UTC): 2026-10-10T10:59:14.565496+00:00
- Repo commit: `824542d`
- Supersedes: (none)
