2AMLogic/sky130-trng/sim/digital-electrical-repair/records/20261010-023115-338d8e6.md

# Digital electrical-limit repair and final-route audit -- issue #236

**Outcome: repair reaches zero Liberty max-slew / max-capacitance violations in a final-route audit at all 16 corners, with the existing verification chain passing, for: `slew0531`, `slew0531-cap034`.** No geometry is promoted: `layout/trng_digital/` and `layout/trng_whole/` are untouched, the spec and the area target (0.05 mm2; composed block 0.126116 mm2, gap +0.076116 mm2) are unchanged, and nothing here makes #174 depend on this result.

Scope of the claim: a *study-run* P&R result on the committed netlist and committed flow settings, checked with the pinned klt/OpenROAD/Liberty decks. It is simulation-derived physical-design evidence, not silicon, and the final-route audit is a sibling OpenSTA session run by this study's script (klt has no such check; see Tool gaps), not a klt-reported signoff.

## Inputs and provenance

- klt `0.6.0+g10f3da34c088`, OpenROAD `26Q3-1510-g6cb3f2b704`, KLayout `0.30.12`; netlist `sha256:9d2b8aed1cd057bd7985ca77e7394921a005846934a4b9c01921c56dade83126` (pinned). The host `klt` is 0.7.0; the study ran on the pinned 0.6.0 build in a worktree venv (no host tool changed).
- committed request `digital/flow/place-and-route/pnr-trng-digital-50khz.json` `sha256:97b6cb9123e43cbacb09724dc448ec8e976a78cd46dc85a1580a66fc54232350`; every study request differs from it only in the rebased netlist path (same file) and, for candidates, `constraints.max_transition_ns` / `max_capacitance_pf`.
- `sim/digital-electrical-repair/requests/control.json` `sha256:1c02e931fc2ab40d6b888c278fdc5c7da47b8c1d9b51d7ff2ad89f9f81836566`; constraints added: none (control)
- `sim/digital-electrical-repair/requests/slew0531.json` `sha256:6720f3f92a477c098a11976ac48d1df26468213c9c7bfc3f9f10f72f1fa2e6c1`; constraints added: max_transition_ns=0.531
- `sim/digital-electrical-repair/requests/slew0531-cap034.json` `sha256:e46bf4d081c65c0afcd96716e0eebd859f2f4378951ccd6636a3567865e5310f`; constraints added: max_transition_ns=0.531, max_capacitance_pf=0.034
- `sim/digital-electrical-repair/requests/slew0700.json` `sha256:c1ac91990cc068199f25c89ca62c24b46d93754a5d7e102b95a4b44f8b387c65`; constraints added: max_transition_ns=0.7
- Units: slew in ns, capacitance in pF (klt request units; Liberty `time_unit`/`capacitive_load_unit` are ns/pF). Fixed in every run: seed 20260905, 40 % utilisation, 20000 ns clock, 4000 ns I/O delays, no `set_load` / `set_driving_cell` (the request schema has none; port load and drive are OpenSTA defaults).

## Control: baseline reproduction

- Unchanged committed request, re-run: global-route-estimate max-slew + max-cap violations summed over the 16 corners = **1130 + 37 = 1167** (the #226 baseline of 1167 is reproduced; the per-pin log parse equals the klt response counts at every corner: mismatch corners = none).
- The control's routed GDS, DEF, Verilog and SPEF are byte-identical to the #226 util40 run: **True** (deterministic flow, no tool drift).
- What the 1167 is: a sum of pin-level `report_check_types` rows over 16 corners from a global-route *estimate*. It is not a count of unique failing nets and not a final extracted-route check.

### Where the violations are (control)

Stage labels: **est** = in-flow `report_check_types` after `estimate_parasitics -global_routing` (global-route estimate); **final** = fresh OpenSTA session over the routed DEF + extracted post-route SPEF, Liberty limits, no override. Load: none declared beyond the netlist. Limit = Liberty `default_max_transition` (and per-pin `max_capacitance`).

| corner | slew limit ns | est slew / cap | final slew pins (nets) | final worst slew excess ns | final cap pins | final worst cap excess pF |
|---|---|---|---|---|---|---|
| ff_100C_1v65 | 1.5 | 0 / 0 | 0 (0) | 0.000 | 0 | 0.0000 |
| ff_100C_1v95 | 1.5 | 0 / 0 | 0 (0) | 0.000 | 0 | 0.0000 |
| ff_n40C_1v56 | 1.5 | 0 / 0 | 21 (1) | 0.003 | 0 | 0.0000 |
| ff_n40C_1v65 | 1.5 | 0 / 0 | 0 (0) | 0.000 | 0 | 0.0000 |
| ff_n40C_1v76 | 1.5 | 0 / 0 | 0 (0) | 0.000 | 0 | 0.0000 |
| ff_n40C_1v95 | 1.5 | 0 / 0 | 0 (0) | 0.000 | 0 | 0.0000 |
| ss_100C_1v40 | 10.0 | 0 / 0 | 0 (0) | 0.000 | 0 | 0.0000 |
| ss_100C_1v60 | 1.5 | 193 / 7 | 206 (7) | 0.750 | 7 | 0.0354 |
| ss_n40C_1v28 | 5.0 | 297 / 10 | 482 (17) | 3.335 | 16 | 0.0311 |
| ss_n40C_1v35 | 10.0 | 0 / 0 | 0 (0) | 0.000 | 0 | 0.0000 |
| ss_n40C_1v40 | 10.0 | 0 / 0 | 0 (0) | 0.000 | 0 | 0.0000 |
| ss_n40C_1v44 | 5.0 | 0 / 0 | 0 (0) | 0.000 | 0 | 0.0000 |
| ss_n40C_1v60 | 1.5 | 536 / 18 | 621 (24) | 1.370 | 22 | 0.0712 |
| ss_n40C_1v76 | 1.5 | 104 / 2 | 182 (6) | 0.636 | 5 | 0.0280 |
| tt_025C_1v80 | 1.5 | 0 / 0 | 0 (0) | 0.000 | 0 | 0.0000 |
| tt_100C_1v80 | 1.5 | 0 / 0 | 0 (0) | 0.000 | 0 | 0.0000 |

Final-route and estimate counts differ (for example a fast corner, `ff_n40C_1v56`, has 21 slew pins on one net at the final route and none in the estimate), so the estimate can neither be called conservative nor sufficient.

Net-level view at `ss_n40C_1v60` (limit 1.5 ns): 621 violating pins sit on 24 distinct nets; the largest: `net40` (93 pins, fanout 92, driver buf_4, worst excess 0.341 ns); `net23` (88 pins, fanout 87, driver buf_4, worst excess 0.349 ns); `_0802_` (62 pins, fanout 61, driver or2_2, worst excess 0.721 ns); `net21` (54 pins, fanout 53, driver buf_4, worst excess 0.316 ns); `net22` (46 pins, fanout 45, driver buf_4, worst excess 0.032 ns). Each is a high-fanout net driven by a single `buf_4`/`or2_2`/`nand2_1`. The aggregate pin count overstates the number of electrical defects by a factor of roughly 25 at this corner; the defects are a few dozen weak-driver/high-fanout nets, and repair is a buffering problem on those nets.

## Derived constraints

`klt place-and-route` runs `repair_design` once, in the place stage, with only the request's `pdk.corner` (`tt_025C_1v80`) Liberty loaded (generated Tcl: `pnr-engine/pnr_trng_digital_place.tcl`). The slow corners are analysed afterwards only, so a limit has to be expressed as a tt-deck budget. `analysis/derive_limits.py` computed, from the control's routed DEF+SPEF, for each corner c: r_c = max over pins of slew_c/slew_tt, and T_c = L_c / r_c with L_c the corner deck's `default_max_transition`:

| corner | L_c ns | r_c | T_c ns |
|---|---|---|---|
| ff_100C_1v65 | 1.5 | 1.1467 | 1.308 |
| ff_100C_1v95 | 1.5 | 0.9531 | 1.5738 |
| ff_n40C_1v56 | 1.5 | 1.2651 | 1.1856 |
| ff_n40C_1v65 | 1.5 | 1.1505 | 1.3037 |
| ff_n40C_1v76 | 1.5 | 1.0333 | 1.4517 |
| ff_n40C_1v95 | 1.5 | 0.8971 | 1.672 |
| ss_100C_1v40 | 10.0 | 3.3909 | 2.9491 |
| ss_100C_1v60 | 1.5 | 2.4266 | 0.6182 |
| ss_n40C_1v28 | 5.0 | 8.4699 | 0.5903 |
| ss_n40C_1v35 | 10.0 | 5.6425 | 1.7723 |
| ss_n40C_1v40 | 10.0 | 4.4588 | 2.2428 |
| ss_n40C_1v44 | 5.0 | 3.7802 | 1.3227 |
| ss_n40C_1v60 | 1.5 | 2.3124 | 0.6487 |
| ss_n40C_1v76 | 1.5 | 1.6563 | 0.9056 |
| tt_025C_1v80 | 1.5 | 1.0 | 1.5 |
| tt_100C_1v80 | 1.5 | 1.2044 | 1.2454 |

Budget = min T_c = **0.5903 ns** (limiting corner `ss_n40C_1v28`), with a 10 % margin = **0.531 ns** -> `max_transition_ns: 0.531`. The ratio r_c comes from the *unrepaired* geometry, so it is a prediction; the final-route audit of each candidate is the test.

Capacitance: Liberty `max_capacitance` is per cell and corner. The smallest ratio of a used cell's corner limit to its tt limit is 0.293 (`o41ai_1` at `ss_n40C_1v28`, 0.0099 pF vs 0.0339 pF at tt). `max_capacitance_pf` is a single design-wide scalar, so no per-cell derivation exists; candidate `slew0531-cap034` uses 0.034 pF, the weakest used cell's tt-deck limit, as an explicitly non-derived choice, to measure whether the scalar adds anything beyond the slew budget.

## Candidates (all kept, failures included)

| run | constraints | est slew/cap (16-corner sum) | final slew/cap (16-corner sum) | corners audited | candidate status | route DRC | klt DRC | LVS | setup/hold | cosim | neg. controls |
|---|---|---|---|---|---|---|---|---|---|---|---|
| control | none | 1130 / 37 | 1512 / 50 | 16/16 | not clean: final-route violations | 0 | pass | pass | pass | pass | 4/4 |
| slew0531 | max_transition_ns=0.531 | 0 / 0 | 0 / 0 | 16/16 | clean candidate (final-route audit, all expected corners) | 0 | pass | pass | pass | pass | 4/4 |
| slew0531-cap034 | max_transition_ns=0.531, max_capacitance_pf=0.034 | 0 / 0 | 0 / 0 | 16/16 | clean candidate (final-route audit, all expected corners) | 0 | pass | pass | pass | pass | 4/4 |
| slew0700 | max_transition_ns=0.7 | 6 / 0 | 12 / 2 | 16/16 | not clean: final-route violations | 0 | pass | pass | pass | pass | 4/4 |

Residual against the *tightened request limit itself* (in-flow estimate at the repair corner `tt_025C_1v80`, after the constraint override; this is the optimiser's own target, not a Liberty limit):

- `slew0531`: 12 pins over the slew target (worst excess 0.01 ns), 0 pins over the cap target (worst excess 0.0 pF). (Two-decimal log precision.) `repair_design` does not meet its own tightened target everywhere; the Liberty limits at all 16 corners are nonetheless met at final route (table above).
- `slew0531-cap034`: 5 pins over the slew target (worst excess 0.01 ns), 98 pins over the cap target (worst excess 0.01 pF). (Two-decimal log precision.) `repair_design` does not meet its own tightened target everywhere; the Liberty limits at all 16 corners are nonetheless met at final route (table above).
- `slew0700`: 0 pins over the slew target (worst excess 0.0 ns), 0 pins over the cap target (worst excess 0.0 pF). (Two-decimal log precision.) `repair_design` met its own target at the repair corner, and the slow corners still failed: the target itself (0.70 ns) was above the derived budget.

Per-corner final-route results for every candidate (count / worst excess, slew ns and cap pF; tightest remaining margin in parentheses where clean):

| corner | control | slew0531 | slew0531-cap034 | slew0700 |
|---|---|---|---|---|
| ff_100C_1v65 | slew 0/0.000, cap 0/0.0000 (margin 0.38 ns, 0.0238 pF) | slew 0/0.000, cap 0/0.0000 (margin 1.01 ns, 0.0355 pF) | slew 0/0.000, cap 0/0.0000 (margin 1.00 ns, 0.0355 pF) | slew 0/0.000, cap 0/0.0000 (margin 0.93 ns, 0.0301 pF) |
| ff_100C_1v95 | slew 0/0.000, cap 0/0.0000 (margin 0.60 ns, 0.0419 pF) | slew 0/0.000, cap 0/0.0000 (margin 1.11 ns, 0.0500 pF) | slew 0/0.000, cap 0/0.0000 (margin 1.09 ns, 0.0500 pF) | slew 0/0.000, cap 0/0.0000 (margin 1.04 ns, 0.0444 pF) |
| ff_n40C_1v56 | slew 21/0.003, cap 0/0.0000 | slew 0/0.000, cap 0/0.0000 (margin 0.89 ns, 0.0220 pF) | slew 0/0.000, cap 0/0.0000 (margin 0.83 ns, 0.0220 pF) | slew 0/0.000, cap 0/0.0000 (margin 0.71 ns, 0.0161 pF) |
| ff_n40C_1v65 | slew 0/0.000, cap 0/0.0000 (margin 0.18 ns, 0.0110 pF) | slew 0/0.000, cap 0/0.0000 (margin 0.95 ns, 0.0274 pF) | slew 0/0.000, cap 0/0.0000 (margin 0.92 ns, 0.0274 pF) | slew 0/0.000, cap 0/0.0000 (margin 0.83 ns, 0.0223 pF) |
| ff_n40C_1v76 | slew 0/0.000, cap 0/0.0000 (margin 0.34 ns, 0.0220 pF) | slew 0/0.000, cap 0/0.0000 (margin 1.02 ns, 0.0337 pF) | slew 0/0.000, cap 0/0.0000 (margin 0.98 ns, 0.0338 pF) | slew 0/0.000, cap 0/0.0000 (margin 0.91 ns, 0.0285 pF) |
| ff_n40C_1v95 | slew 0/0.000, cap 0/0.0000 (margin 0.53 ns, 0.0367 pF) | slew 0/0.000, cap 0/0.0000 (margin 1.09 ns, 0.0446 pF) | slew 0/0.000, cap 0/0.0000 (margin 1.06 ns, 0.0446 pF) | slew 0/0.000, cap 0/0.0000 (margin 1.01 ns, 0.0392 pF) |
| ss_100C_1v40 | slew 0/0.000, cap 0/0.0000 (margin 6.94 ns, 0.0828 pF) | slew 0/0.000, cap 0/0.0000 (margin 8.55 ns, 0.0905 pF) | slew 0/0.000, cap 0/0.0000 (margin 8.68 ns, 0.0905 pF) | slew 0/0.000, cap 0/0.0000 (margin 8.32 ns, 0.0902 pF) |
| ss_100C_1v60 | slew 206/0.750, cap 7/0.0354 | slew 0/0.000, cap 0/0.0000 (margin 0.47 ns, 0.0087 pF) | slew 0/0.000, cap 0/0.0000 (margin 0.55 ns, 0.0106 pF) | slew 0/0.000, cap 0/0.0000 (margin 0.31 ns, 0.0047 pF) |
| ss_n40C_1v28 | slew 482/3.335, cap 16/0.0311 | slew 0/0.000, cap 0/0.0000 (margin 1.23 ns, 0.0041 pF) | slew 0/0.000, cap 0/0.0000 (margin 0.76 ns, 0.0038 pF) | slew 6/0.491, cap 1/0.0015 |
| ss_n40C_1v35 | slew 0/0.000, cap 0/0.0000 (margin 3.96 ns, 0.0242 pF) | slew 0/0.000, cap 0/0.0000 (margin 7.35 ns, 0.0312 pF) | slew 0/0.000, cap 0/0.0000 (margin 7.13 ns, 0.0308 pF) | slew 0/0.000, cap 0/0.0000 (margin 6.25 ns, 0.0287 pF) |
| ss_n40C_1v40 | slew 0/0.000, cap 0/0.0000 (margin 5.00 ns, 0.0355 pF) | slew 0/0.000, cap 0/0.0000 (margin 7.82 ns, 0.0426 pF) | slew 0/0.000, cap 0/0.0000 (margin 7.69 ns, 0.0422 pF) | slew 0/0.000, cap 0/0.0000 (margin 7.01 ns, 0.0407 pF) |
| ss_n40C_1v44 | slew 0/0.000, cap 0/0.0000 (margin 0.67 ns, 0.0115 pF) | slew 0/0.000, cap 0/0.0000 (margin 3.14 ns, 0.0212 pF) | slew 0/0.000, cap 0/0.0000 (margin 3.01 ns, 0.0208 pF) | slew 0/0.000, cap 0/0.0000 (margin 2.48 ns, 0.0170 pF) |
| ss_n40C_1v60 | slew 621/1.370, cap 22/0.0712 | slew 0/0.000, cap 0/0.0000 (margin 0.30 ns, 0.0048 pF) | slew 0/0.000, cap 0/0.0000 (margin 0.24 ns, 0.0043 pF) | slew 6/0.090, cap 1/0.0010 |
| ss_n40C_1v76 | slew 182/0.636, cap 5/0.0280 | slew 0/0.000, cap 0/0.0000 (margin 0.63 ns, 0.0119 pF) | slew 0/0.000, cap 0/0.0000 (margin 0.57 ns, 0.0119 pF) | slew 0/0.000, cap 0/0.0000 (margin 0.38 ns, 0.0060 pF) |
| tt_025C_1v80 | slew 0/0.000, cap 0/0.0000 (margin 0.15 ns, 0.0076 pF) | slew 0/0.000, cap 0/0.0000 (margin 0.92 ns, 0.0273 pF) | slew 0/0.000, cap 0/0.0000 (margin 0.91 ns, 0.0273 pF) | slew 0/0.000, cap 0/0.0000 (margin 0.80 ns, 0.0210 pF) |
| tt_100C_1v80 | slew 0/0.000, cap 0/0.0000 (margin 0.21 ns, 0.0104 pF) | slew 0/0.000, cap 0/0.0000 (margin 0.93 ns, 0.0299 pF) | slew 0/0.000, cap 0/0.0000 (margin 0.94 ns, 0.0299 pF) | slew 0/0.000, cap 0/0.0000 (margin 0.82 ns, 0.0226 pF) |

## Cost: area, cells, timing

| run | die um2 | achieved util % | std-cell area um2 | logic+buffer instances | `place*` repair buffers | wirelength um | worst setup slack ns | worst hold slack ns | clock skew ns |
|---|---|---|---|---|---|---|---|---|---|
| control | 60049.5 | 42.6334 | 23396.2 | 2321 | 23 | 66327 | 15947.6 | 0.28546 | 0.02665 |
| slew0531 | 60049.5 | 43.7346 | 24000.5 | 2389 | 90 | 67149 | 15958.4 | 0.2838 | 0.0794 |
| slew0531-cap034 | 60049.5 | 46.5299 | 25534.5 | 2651 | 97 | 71077 | 15951.4 | 0.28814 | 0.05503 |
| slew0700 | 60049.5 | 42.9822 | 23587.6 | 2339 | 50 | 65971 | 15956.3 | 0.28148 | 0.04716 |

The die is fixed by the 40 % utilisation request, so the digital macro bbox (0.060050 mm2) does not change; the repair cost shows as extra standard-cell area and instance count inside the same die.

## Recommendation

`slew0531` is the minimal clean candidate: stdcell area 23396.2 -> 24000.5 um2 (+2.6 %), logic+buffer instances 2321 -> 2389, worst setup slack 15947.6 -> 15958.4 ns, worst hold slack 0.28546 -> 0.2838 ns, clock skew 0.02665 -> 0.0794 ns. Adding the `max_capacitance_pf` scalar (`slew0531-cap034`) is not needed for a clean audit and costs a std-cell area of 25534.5 um2 (+9.1 %). A budget above the derived minimum (`slew0700`, 0.70 ns) fails at the two corners whose predicted budget is below it (`ss_n40C_1v28`, `ss_n40C_1v60`; `ss_100C_1v60` also had a predicted budget of 0.618 ns but passed), so the derivation predicts the failure side correctly and, on this netlist and seed, its 10 %-margin value passes. Necessity of the margin (values between 0.531 and 0.59 ns) was not tested. Clean means clean under the audit's stated coverage, limits and unmodelled port load; tightest remaining margins are in the per-corner table (for `slew0531`: smallest slew margin 0.30 ns at `ss_n40C_1v60`, smallest cap margin 4.1 fF at `ss_n40C_1v28`). Nothing is promoted: adopting the constraint in the committed request would change `layout/trng_digital/`, the composed layout and every record that cites them, which is a separately reviewed change.

## Reduction controls

`sim/tests/test_electrical_reduction.py` (stdlib, PR-blocking in CI): a missing corner, an unsupported corner, a malformed class record, an empty report, or STA-only (setup/hold) records can never reduce to `clean`; an injected violation in any one corner and class is reported and counted in the right class; a surplus corner cannot stand in for a missing one; an estimate-only pass is labelled `estimate-clean, final-route unaudited`. The audit script itself marks a corner `unsupported` if the OpenSTA session fails, if a report block is absent, or if a sensitivity probe (SDC slew limit forced to 0.0001 ns) lists no pins, so a session that cannot see slews can never show zero. The control run (1512 slew / 50 cap pins) shows the audit does detect violations on the same script.

## Tool gaps (friction protocol)

- No installed klt command reports max-transition / max-capacitance against extracted post-route parasitics; coverage was supplied by `analysis/final_route_audit.py` (fresh OpenSTA sessions on the archived DEF+SPEF). Filed generically: **2AMLogic/klayout-tools#3005**. Per-corner coverage in this study: 16/16 `supported-by-sibling-script`, 0 unsupported, 0 missing (klt-native: unsupported at all 16).
- The request has no way to declare port load or driving cell; the scalar `max_capacitance_pf` cannot express per-cell, per-corner Liberty limits (also in #3005). Related: klayout-tools#2782.
- The in-flow counts are pin rows; worst excess and per-pin limit exist only in the retained engine logs (parsed here).

## Implications

- **#174 (whole-block post-layout characterisation):** this study does not change what #174 needs. If a candidate is later adopted, the committed `layout/trng_digital/` and the composed `layout/trng_whole/` would have to be regenerated and re-verified; until then #174 should keep citing the committed layout, whose electrical-limit status is *violations at four slow low-voltage corners and one fast corner (final-route audit above)*. #174 does not depend on this issue.
- **Area gap (#226):** the candidates cost the std-cell area shown above at the same 40 % die; they do not move the 0.126116 mm2 composed block toward 0.05 mm2. The compaction study showed utilisation alone cannot close that gap, and denser points were rejected there for worsening these very limits. A repaired netlist is a precondition for revisiting compaction, not a substitute for it: compaction should be re-run *with* the derived constraint and audited at final route.
- **Not done / not authorised:** promoting a candidate over the committed layout, recomposing `trng_whole`, changing the spec, FIFO/clock/function. A candidate's geometry differs from the committed layout (extra buffers), so adopting it is a separate reviewed change.

## What this record does and does not establish

- Established: baseline reproduction (1167, byte-identical geometry); a pin-to-net breakdown; final-route per-corner/per-class limits, worst excess and counts for the control and each candidate; area/cell/timing cost; the existing chain (route DRC, klt DRC, cell-level LVS signal+power, 16-corner setup/hold, routed-netlist FUNCTIONAL cosim, 4 negative controls) passing on each candidate as reported above.
- Not established: silicon behaviour; SDF-timed simulation; that the audit's OpenSTA parasitic annotation equals a foundry extraction (nominal interconnect corner only, as in the rest of the digital chain); per-pin Liberty limits are applied by OpenSTA, but port loading is the OpenSTA default; the choice of `0.531 ns` generalises to this netlist and seed only, so a netlist or floorplan change needs a re-derivation and a fresh audit. Same verification limits as `sim/digital-pnr/records/20261003-212010-fa76b17.md` (curated deck, not foundry signoff).

---

- Author: Loom builder (issue #236)
- Timestamp (UTC): 2026-10-10T02:31:15.307219+00:00
- Repo commit: `338d8e6`
- Supersedes: (none)
