2AMLogic/sky130-trng/layout/pex-ring/ro_ring5_assembled_pex.spice

* Post-layout (parasitic) subcircuit library -- GENERATED by
* layout/bin/pex-netlist.py from layout/pex-ring/pex.json. Do not edit by
* hand: `python3 layout/bin/pex-netlist.py layout/pex-ring/pex.json --check`
* re-extracts every cell from its committed GDS and fails if this file
* and that extraction disagree.
*
* Each cell below is `klt extract --pdk <variant> --parasitics` output
* over a composed, DRC-clean and LVS-clean cell under layout/. --pdk is
* what makes its device cards subcircuit calls on the PDK's own devices
* with unitless geometry (this repo's decks run at .option scale=1u), so
* NO device card, geometry value, R value, C value or connection is
* rewritten here. Two things are: extractor-joined net names are renamed
* to their design-level names, and a design-port-order wrapper is added
* per cell. See layout/bin/pex-netlist.py's module docstring for why,
* and layout/pex/README.md for what the parasitic model does and does
* not contain.
*
* Substrate return node: `vsubs`, declared .global below --
* klayout-tools#1503 (the extractor scopes it per-instance, which
* isolates every ground capacitance behind a 1 TOhm tie once the cell
* is instantiated rather than simulated flat). A deck including this
* library MUST tie the node itself; every sim/ record minted from it
* states which tie it used.

.global vsubs

*-----------------------------------------------------------------------
* ro_ring5_assembled_pex_wstv0p42 -- post-layout, from ../ro_ring5/ro_ring5.gds
* klt extract --parasitics: 22 devices, 19 nets
*-----------------------------------------------------------------------
.subckt ro_ring5_assembled_pex_wstv0p42__core ro sig_n1 sig_n2 sig_n3 sig_n4 en vddr vss py_g ny nyn1 nyn2 nyn3 nyn4 py pyn1 pyn2 pyn3
* device instance $1 r0 *1 1.42,0.21 nfet
Xn1 ny__t0 vddr__t0 vss__t0 vss__t10 sky130_fd_pr__nfet_01v8 L=2 W=0.42 AS=0.1764 AD=0.1764 PS=1.68 PD=1.68
* device instance $2 r0 *1 10.72,0.21 nfet
Xn2 ny__t12 vddr__t20 vss__t9 vss__t11 sky130_fd_pr__nfet_01v8 L=2 W=0.42 AS=0.1764 AD=0.1764 PS=1.68 PD=1.68
* device instance $3 r0 *1 13.085,0.21 nfet
Xn3 sig_n2__t0 sig_n1__t0 ny__t02 vss__t15 sky130_fd_pr__nfet_01v8 L=0.15 W=0.42 AS=0.1974 AD=0.1974 PS=1.78 PD=1.78
* device instance $4 r0 *1 18.895,0.21 nfet
Xn4 ny__t13 vddr__t19 vss__t8 vss__t12 sky130_fd_pr__nfet_01v8 L=2 W=0.42 AS=0.1764 AD=0.1764 PS=1.68 PD=1.68
* device instance $5 r0 *1 21.26,0.21 nfet
Xn5 sig_n3__t0 sig_n2__t3 ny__t03 vss__t16 sky130_fd_pr__nfet_01v8 L=0.15 W=0.42 AS=0.1974 AD=0.1974 PS=1.78 PD=1.78
* device instance $6 r0 *1 27.07,0.21 nfet
Xn6 ny__t14 vddr__t18 vss__t7 vss__t13 sky130_fd_pr__nfet_01v8 L=2 W=0.42 AS=0.1764 AD=0.1764 PS=1.68 PD=1.68
* device instance $7 r0 *1 29.435,0.21 nfet
Xn7 sig_n4__t0 sig_n3__t3 ny__t04 vss__t17 sky130_fd_pr__nfet_01v8 L=0.15 W=0.42 AS=0.1974 AD=0.1974 PS=1.78 PD=1.78
* device instance $8 r0 *1 35.245,0.21 nfet
Xn8 ny__t15 vddr__t17 vss__t6 vss__t14 sky130_fd_pr__nfet_01v8 L=2 W=0.42 AS=0.1764 AD=0.1764 PS=1.68 PD=1.68
* device instance $9 r0 *1 37.61,0.21 nfet
Xn9 ro__t1 sig_n4__t3 ny__t05 vss__t18 sky130_fd_pr__nfet_01v8 L=0.15 W=0.42 AS=0.1974 AD=0.1974 PS=1.78 PD=1.78
* device instance $10 r0 *1 3.785,0.21 nfet
Xn10 n6__t0 en__t0 ny__t1 vss__t19 sky130_fd_pr__nfet_01v8 L=0.15 W=0.84 AS=0.3948 AD=0.2184 PS=2.62 PD=1.36
* device instance $11 r0 *1 4.455,0.21 nfet
Xn11 sig_n1__t1 ro__t0 n6__t1 vss__t20 sky130_fd_pr__nfet_01v8 L=0.15 W=0.84 AS=0.2184 AD=0.3948 PS=1.36 PD=2.62
* device instance $12 r0 *1 1.42,3.74 pfet
Xn12 py_g__t0 vss__t1 vddr__t1 vddr__t2 sky130_fd_pr__pfet_01v8 L=2 W=0.42 AS=0.1764 AD=0.1764 PS=1.68 PD=1.68
* device instance $13 r0 *1 10.72,3.74 pfet
Xn13 py__t0 vss__t2 vddr__t13 vddr__t9 sky130_fd_pr__pfet_01v8 L=2 W=0.42 AS=0.1764 AD=0.1764 PS=1.68 PD=1.68
* device instance $14 r0 *1 18.895,3.74 pfet
Xn14 py__t02 vss__t3 vddr__t14 vddr__t10 sky130_fd_pr__pfet_01v8 L=2 W=0.42 AS=0.1764 AD=0.1764 PS=1.68 PD=1.68
* device instance $15 r0 *1 27.07,3.74 pfet
Xn15 py__t03 vss__t4 vddr__t15 vddr__t11 sky130_fd_pr__pfet_01v8 L=2 W=0.42 AS=0.1764 AD=0.1764 PS=1.68 PD=1.68
* device instance $16 r0 *1 35.245,3.74 pfet
Xn16 py__t04 vss__t5 vddr__t16 vddr__t12 sky130_fd_pr__pfet_01v8 L=2 W=0.42 AS=0.1764 AD=0.1764 PS=1.68 PD=1.68
* device instance $17 r0 *1 3.585,3.74 pfet
Xn17 sig_n1__t2 en__t1 py_g__t1 vddr__t3 sky130_fd_pr__pfet_01v8 L=0.15 W=0.84 AS=0.3948 AD=0.3948 PS=2.62 PD=2.62
* device instance $18 r0 *1 4.875,3.74 pfet
Xn18 py_g__t2 ro__t2 sig_n1__t3 vddr__t8 sky130_fd_pr__pfet_01v8 L=0.15 W=0.84 AS=0.3948 AD=0.3948 PS=2.62 PD=2.62
* device instance $19 r0 *1 12.885,3.74 pfet
Xn19 sig_n2__t2 sig_n1__t4 py__t1 vddr__t7 sky130_fd_pr__pfet_01v8 L=0.15 W=0.84 AS=0.3948 AD=0.3948 PS=2.62 PD=2.62
* device instance $20 r0 *1 21.06,3.74 pfet
Xn20 sig_n3__t2 sig_n2__t1 py__t12 vddr__t6 sky130_fd_pr__pfet_01v8 L=0.15 W=0.84 AS=0.3948 AD=0.3948 PS=2.62 PD=2.62
* device instance $21 r0 *1 29.235,3.74 pfet
Xn21 sig_n4__t2 sig_n3__t1 py__t13 vddr__t5 sky130_fd_pr__pfet_01v8 L=0.15 W=0.84 AS=0.3948 AD=0.3948 PS=2.62 PD=2.62
* device instance $22 r0 *1 37.41,3.74 pfet
Xn22 ro__t3 sig_n4__t1 py__t14 vddr__t4 sky130_fd_pr__pfet_01v8 L=0.15 W=0.84 AS=0.3948 AD=0.3948 PS=2.62 PD=2.62
* device instance _6_t0 r0 *1 0,0
R_6_t0 n6__t0 n6 12.8
* device instance _6_t1 r0 *1 0,0
R_6_t1 n6__t1 n6 12.8
* device instance _6 r0 *1 0,0
C_6 n6 vsubs 1.15618e-16
* device instance a_g_a_ro_s4_y_y_t0 r0 *1 0,0
Ra_g_a_ro_s4_y_y_t0 ro__t0 ro 199.905310752
* device instance a_g_a_ro_s4_y_y_t1 r0 *1 0,0
Ra_g_a_ro_s4_y_y_t1 ro__t1 ro 198.597996013
* device instance a_g_a_ro_s4_y_y_t2 r0 *1 0,0
Ra_g_a_ro_s4_y_y_t2 ro__t2 ro 194.914280155
* device instance a_g_a_ro_s4_y_y_t3 r0 *1 0,0
Ra_g_a_ro_s4_y_y_t3 ro__t3 ro 196.22131308
* device instance a_g_a_ro_s4_y_y r0 *1 0,0
Ca_g_a_ro_s4_y_y ro vsubs 4.73908e-15
* device instance a_g_y_mnab_y_mpa_y_mpb_y_n1_s1_a_y_t0 r0 *1 0,0
Ra_g_y_mnab_y_mpa_y_mpb_y_n1_s1_a_y_t0 sig_n1__t0 sig_n1 107.491339147
* device instance a_g_y_mnab_y_mpa_y_mpb_y_n1_s1_a_y_t1 r0 *1 0,0
Ra_g_y_mnab_y_mpa_y_mpb_y_n1_s1_a_y_t1 sig_n1__t1 sig_n1 74.101756002
* device instance a_g_y_mnab_y_mpa_y_mpb_y_n1_s1_a_y_t2 r0 *1 0,0
Ra_g_y_mnab_y_mpa_y_mpb_y_n1_s1_a_y_t2 sig_n1__t2 sig_n1 83.1989635875
* device instance a_g_y_mnab_y_mpa_y_mpb_y_n1_s1_a_y_t3 r0 *1 0,0
Ra_g_y_mnab_y_mpa_y_mpb_y_n1_s1_a_y_t3 sig_n1__t3 sig_n1 60.7011664601
* device instance a_g_y_mnab_y_mpa_y_mpb_y_n1_s1_a_y_t4 r0 *1 0,0
Ra_g_y_mnab_y_mpa_y_mpb_y_n1_s1_a_y_t4 sig_n1__t4 sig_n1 99.6782748034
* device instance a_g_y_mnab_y_mpa_y_mpb_y_n1_s1_a_y r0 *1 0,0
Ca_g_y_mnab_y_mpa_y_mpb_y_n1_s1_a_y sig_n1 vsubs 2.632209e-15
* device instance a_n2_s1_y_s2_a_y_t0 r0 *1 0,0
Ra_n2_s1_y_s2_a_y_t0 sig_n2__t0 sig_n2 184.787796322
* device instance a_n2_s1_y_s2_a_y_t1 r0 *1 0,0
Ra_n2_s1_y_s2_a_y_t1 sig_n2__t1 sig_n2 184.787796322
* device instance a_n2_s1_y_s2_a_y_t2 r0 *1 0,0
Ra_n2_s1_y_s2_a_y_t2 sig_n2__t2 sig_n2 192.568303678
* device instance a_n2_s1_y_s2_a_y_t3 r0 *1 0,0
Ra_n2_s1_y_s2_a_y_t3 sig_n2__t3 sig_n2 192.568303678
* device instance a_n2_s1_y_s2_a_y r0 *1 0,0
Ca_n2_s1_y_s2_a_y sig_n2 vsubs 2.529995e-15
* device instance a_n3_s2_y_s3_a_y_t0 r0 *1 0,0
Ra_n3_s2_y_s3_a_y_t0 sig_n3__t0 sig_n3 184.787796322
* device instance a_n3_s2_y_s3_a_y_t1 r0 *1 0,0
Ra_n3_s2_y_s3_a_y_t1 sig_n3__t1 sig_n3 184.787796322
* device instance a_n3_s2_y_s3_a_y_t2 r0 *1 0,0
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
* device instance g_vss_m1_mph_g_s1_vss_m1_s2_vss_m1_s3_vss_m1_s4_vss_m1_vss_t10 r0 *1 0,0
Rg_vss_m1_mph_g_s1_vss_m1_s2_vss_m1_s3_vss_m1_s4_vss_m1_vss_t10 vss__t10 vss 118.483890525
* device instance g_vss_m1_mph_g_s1_vss_m1_s2_vss_m1_s3_vss_m1_s4_vss_m1_vss_t11 r0 *1 0,0
Rg_vss_m1_mph_g_s1_vss_m1_s2_vss_m1_s3_vss_m1_s4_vss_m1_vss_t11 vss__t11 vss 54.426702792
* device instance g_vss_m1_mph_g_s1_vss_m1_s2_vss_m1_s3_vss_m1_s4_vss_m1_vss_t12 r0 *1 0,0
Rg_vss_m1_mph_g_s1_vss_m1_s2_vss_m1_s3_vss_m1_s4_vss_m1_vss_t12 vss__t12 vss 6.25814571825
* device instance g_vss_m1_mph_g_s1_vss_m1_s2_vss_m1_s3_vss_m1_s4_vss_m1_vss_t13 r0 *1 0,0
Rg_vss_m1_mph_g_s1_vss_m1_s2_vss_m1_s3_vss_m1_s4_vss_m1_vss_t13 vss__t13 vss 59.0817256794
* device instance g_vss_m1_mph_g_s1_vss_m1_s2_vss_m1_s3_vss_m1_s4_vss_m1_vss_t14 r0 *1 0,0
Rg_vss_m1_mph_g_s1_vss_m1_s2_vss_m1_s3_vss_m1_s4_vss_m1_vss_t14 vss__t14 vss 115.398109781
* device instance g_vss_m1_mph_g_s1_vss_m1_s2_vss_m1_s3_vss_m1_s4_vss_m1_vss_t15 r0 *1 0,0
Rg_vss_m1_mph_g_s1_vss_m1_s2_vss_m1_s3_vss_m1_s4_vss_m1_vss_t15 vss__t15 vss 38.2269784356
* device instance g_vss_m1_mph_g_s1_vss_m1_s2_vss_m1_s3_vss_m1_s4_vss_m1_vss_t16 r0 *1 0,0
Rg_vss_m1_mph_g_s1_vss_m1_s2_vss_m1_s3_vss_m1_s4_vss_m1_vss_t16 vss__t16 vss 19.5536956746
* device instance g_vss_m1_mph_g_s1_vss_m1_s2_vss_m1_s3_vss_m1_s4_vss_m1_vss_t17 r0 *1 0,0
Rg_vss_m1_mph_g_s1_vss_m1_s2_vss_m1_s3_vss_m1_s4_vss_m1_vss_t17 vss__t17 vss 75.3523699638
* device instance g_vss_m1_mph_g_s1_vss_m1_s2_vss_m1_s3_vss_m1_s4_vss_m1_vss_t18 r0 *1 0,0
Rg_vss_m1_mph_g_s1_vss_m1_s2_vss_m1_s3_vss_m1_s4_vss_m1_vss_t18 vss__t18 vss 131.712565134
* device instance g_vss_m1_mph_g_s1_vss_m1_s2_vss_m1_s3_vss_m1_s4_vss_m1_vss_t19 r0 *1 0,0
Rg_vss_m1_mph_g_s1_vss_m1_s2_vss_m1_s3_vss_m1_s4_vss_m1_vss_t19 vss__t19 vss 102.174066353
* device instance g_vss_m1_mph_g_s1_vss_m1_s2_vss_m1_s3_vss_m1_s4_vss_m1_vss_t20 r0 *1 0,0
Rg_vss_m1_mph_g_s1_vss_m1_s2_vss_m1_s3_vss_m1_s4_vss_m1_vss_t20 vss__t20 vss 97.5549074724
* device instance g_vss_m1_mph_g_s1_vss_m1_s2_vss_m1_s3_vss_m1_s4_vss_m1_vss r0 *1 0,0
Cg_vss_m1_mph_g_s1_vss_m1_s2_vss_m1_s3_vss_m1_s4_vss_m1_vss vss vsubs 1.1753189e-14
* device instance mpa_py_mpb_py_mph_py_py_t0 r0 *1 0,0
Rmpa_py_mpb_py_mph_py_py_t0 py_g__t0 py_g 33.64835
* device instance mpa_py_mpb_py_mph_py_py_t1 r0 *1 0,0
Rmpa_py_mpb_py_mph_py_py_t1 py_g__t1 py_g 5.23884452847
* device instance mpa_py_mpb_py_mph_py_py_t2 r0 *1 0,0
Rmpa_py_mpb_py_mph_py_py_t2 py_g__t2 py_g 28.4095054715
* device instance mpa_py_mpb_py_mph_py_py r0 *1 0,0
Cmpa_py_mpb_py_mph_py_py py_g vsubs 7.94002e-16
* device instance ny_t0 r0 *1 0,0
Rny_t0 ny__t0 ny 44.45845
* device instance ny_t1 r0 *1 0,0
Rny_t1 ny__t1 ny 44.45845
* device instance ny r0 *1 0,0
Cny ny vsubs 2.11758e-16
* device instance ny_dup1_t0 r0 *1 0,0
Rny_dup1_t0 ny__t02 nyn1 41.7022
* device instance ny_dup1_t1 r0 *1 0,0
Rny_dup1_t1 ny__t12 nyn1 41.7022
* device instance ny_dup1 r0 *1 0,0
Cny_dup1 nyn1 vsubs 1.70111e-16
* device instance ny_dup2_t0 r0 *1 0,0
Rny_dup2_t0 ny__t03 nyn2 41.7022
* device instance ny_dup2_t1 r0 *1 0,0
Rny_dup2_t1 ny__t13 nyn2 41.7022
* device instance ny_dup2 r0 *1 0,0
Cny_dup2 nyn2 vsubs 1.70111e-16
* device instance ny_dup3_t0 r0 *1 0,0
Rny_dup3_t0 ny__t04 nyn3 41.7022
* device instance ny_dup3_t1 r0 *1 0,0
Rny_dup3_t1 ny__t14 nyn3 41.7022
* device instance ny_dup3 r0 *1 0,0
Cny_dup3 nyn3 vsubs 1.70111e-16
* device instance ny_dup4_t0 r0 *1 0,0
Rny_dup4_t0 ny__t05 nyn4 41.7022
* device instance ny_dup4_t1 r0 *1 0,0
Rny_dup4_t1 ny__t15 nyn4 41.7022
* device instance ny_dup4 r0 *1 0,0
Cny_dup4 nyn4 vsubs 1.70111e-16
* device instance py_t0 r0 *1 0,0
Rpy_t0 py__t0 py 37.6683
* device instance py_t1 r0 *1 0,0
Rpy_t1 py__t1 py 37.6683
* device instance py r0 *1 0,0
Cpy py vsubs 1.9321e-16
* device instance py_dup1_t0 r0 *1 0,0
Rpy_dup1_t0 py__t02 pyn1 37.6683
* device instance py_dup1_t1 r0 *1 0,0
Rpy_dup1_t1 py__t12 pyn1 37.6683
* device instance py_dup1 r0 *1 0,0
Cpy_dup1 pyn1 vsubs 1.9321e-16
* device instance py_dup2_t0 r0 *1 0,0
Rpy_dup2_t0 py__t03 pyn2 37.6683
* device instance py_dup2_t1 r0 *1 0,0
Rpy_dup2_t1 py__t13 pyn2 37.6683
* device instance py_dup2 r0 *1 0,0
Cpy_dup2 pyn2 vsubs 1.9321e-16
* device instance py_dup3_t0 r0 *1 0,0
Rpy_dup3_t0 py__t04 pyn3 37.6683
* device instance py_dup3_t1 r0 *1 0,0
Rpy_dup3_t1 py__t14 pyn3 37.6683
* device instance py_dup3 r0 *1 0,0
Cpy_dup3 pyn3 vsubs 1.9321e-16
* device instance cc_a_g_a_ro_s4_y_y_a_g_y_mnab_y_mpa_y_mpb_y_n1_s1_a_y r0 *1 0,0
Ccc_a_g_a_ro_s4_y_y_a_g_y_mnab_y_mpa_y_mpb_y_n1_s1_a_y ro sig_n1 1.5977e-17
* device instance cc_a_g_a_ro_s4_y_y_g_vddr_m1_mnt_g_s1_vddr_m1_s2_vddr_m1_s3_vddr_m1_s4_vddr_m1_vddr r0 *1 0,0
Ccc_a_g_a_ro_s4_y_y_g_vddr_m1_mnt_g_s1_vddr_m1_s2_vddr_m1_s3_vddr_m1_s4_vddr_m1_vddr ro vddr 1.5474e-17
* device instance cc_a_g_y_mnab_y_mpa_y_mpb_y_n1_s1_a_y_g_vss_m1_mph_g_s1_vss_m1_s2_vss_m1_s3_vss_m1_s4_vss_m1_vss r0 *1 0,0
Ccc_a_g_y_mnab_y_mpa_y_mpb_y_n1_s1_a_y_g_vss_m1_mph_g_s1_vss_m1_s2_vss_m1_s3_vss_m1_s4_vss_m1_vss sig_n1 vss 3.869e-18
* device instance cc_a_g_y_mnab_y_mpa_y_mpb_y_n1_s1_a_y_ny r0 *1 0,0
Ccc_a_g_y_mnab_y_mpa_y_mpb_y_n1_s1_a_y_ny sig_n1 nyn4 2.878e-18
* device instance cc_a_n2_s1_y_s2_a_y_g_vss_m1_mph_g_s1_vss_m1_s2_vss_m1_s3_vss_m1_s4_vss_m1_vss r0 *1 0,0
Ccc_a_n2_s1_y_s2_a_y_g_vss_m1_mph_g_s1_vss_m1_s2_vss_m1_s3_vss_m1_s4_vss_m1_vss sig_n2 vss 3.869e-18
* device instance cc_a_n2_s1_y_s2_a_y_ny r0 *1 0,0
Ccc_a_n2_s1_y_s2_a_y_ny sig_n2 nyn4 2.878e-18
* device instance cc_a_n3_s2_y_s3_a_y_g_vss_m1_mph_g_s1_vss_m1_s2_vss_m1_s3_vss_m1_s4_vss_m1_vss r0 *1 0,0
Ccc_a_n3_s2_y_s3_a_y_g_vss_m1_mph_g_s1_vss_m1_s2_vss_m1_s3_vss_m1_s4_vss_m1_vss sig_n3 vss 3.869e-18
* device instance cc_a_n3_s2_y_s3_a_y_ny r0 *1 0,0
Ccc_a_n3_s2_y_s3_a_y_ny sig_n3 nyn4 2.878e-18
* device instance cc_a_n4_s3_y_s4_a_y_g_vss_m1_mph_g_s1_vss_m1_s2_vss_m1_s3_vss_m1_s4_vss_m1_vss r0 *1 0,0
Ccc_a_n4_s3_y_s4_a_y_g_vss_m1_mph_g_s1_vss_m1_s2_vss_m1_s3_vss_m1_s4_vss_m1_vss sig_n4 vss 3.869e-18
* device instance cc_a_n4_s3_y_s4_a_y_ny r0 *1 0,0
Ccc_a_n4_s3_y_s4_a_y_ny sig_n4 nyn4 2.878e-18
* device instance cc_g_vddr_m1_mnt_g_s1_vddr_m1_s2_vddr_m1_s3_vddr_m1_s4_vddr_m1_vddr_py r0 *1 0,0
Ccc_g_vddr_m1_mnt_g_s1_vddr_m1_s2_vddr_m1_s3_vddr_m1_s4_vddr_m1_vddr_py vddr pyn3 1.2471e-17
* device instance vsubs_dctie r0 *1 0,0
Rvsubs_dctie vsubs 0 1e+12
.ends ro_ring5_assembled_pex_wstv0p42__core

* ro_ring5_assembled_pex_wstv0p42 -- design-port-order wrapper over ro_ring5_assembled_pex_wstv0p42__core.
* Promoted-internal layout pins kept local here: sig_n1, sig_n2, sig_n3, sig_n4, py_g, ny, nyn1, nyn2, nyn3, nyn4, py, pyn1, pyn2, pyn3
.subckt ro_ring5_assembled_pex_wstv0p42 en ro vddr vss
xpex ro sig_n1 sig_n2 sig_n3 sig_n4 en vddr vss py_g ny nyn1 nyn2 nyn3 nyn4 py pyn1 pyn2 pyn3 ro_ring5_assembled_pex_wstv0p42__core
.ends ro_ring5_assembled_pex_wstv0p42
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
