2AMLogic/sky130-trng/layout/pex-sampler-dff-assembled/sampler_dff_assembled_pex.spice

* Post-layout (parasitic) subcircuit library -- GENERATED by
* layout/bin/pex-netlist.py from layout/pex-sampler-dff-assembled/pex.json. Do not edit by
* hand: `python3 layout/bin/pex-netlist.py layout/pex-sampler-dff-assembled/pex.json --check`
* re-extracts every cell from its committed GDS and fails if this file
* and that extraction disagree.
*
* Each cell below is `klt extract --pdk <variant> --parasitics` output
* over a composed, DRC-clean and LVS-clean cell under layout/. --pdk is
* what makes its device cards subcircuit calls on the PDK's own devices
* with unitless geometry (this repo's decks run at .option scale=1u), so
* NO device card, geometry value, R value, C value or connection is
* rewritten here. Two things are: extractor-joined net names are renamed
* to their design-level names, and a design-port-order wrapper is added
* per cell. See layout/bin/pex-netlist.py's module docstring for why,
* and layout/pex/README.md for what the parasitic model does and does
* not contain.
*
* Substrate return node: `vsubs`, declared .global below --
* klayout-tools#1503 (the extractor scopes it per-instance, which
* isolates every ground capacitance behind a 1 TOhm tie once the cell
* is instantiated rather than simulated flat). A deck including this
* library MUST tie the node itself; every sim/ record minted from it
* states which tie it used.

.global vsubs

*-----------------------------------------------------------------------
* sampler_dff_assembled_pex -- post-layout, from ../sampler_dff/sampler_dff.gds
* klt extract --parasitics: 22 devices, 14 nets
*-----------------------------------------------------------------------
.subckt sampler_dff_assembled_pex__core s m clk d mb mc q qb clkb rst_n vdd vss
* device instance $1 r0 *1 0.545,0.21 nfet
Xn1 clkb__t1 clk__t4 vss__t0 vss__t5 sky130_fd_pr__nfet_01v8 L=0.15 W=0.42 AS=0.1974 AD=0.1974 PS=1.78 PD=1.78
* device instance $2 r0 *1 5.31,0.21 nfet
Xn2 d__t1 clkb__t5 m__t5 vss__t6 sky130_fd_pr__nfet_01v8 L=0.15 W=0.42 AS=0.1974 AD=0.1974 PS=1.78 PD=1.78
* device instance $3 r0 *1 19.835,0.21 nfet
Xn3 mc__t3 mb__t6 vss__t4 vss__t7 sky130_fd_pr__nfet_01v8 L=0.15 W=0.42 AS=0.1974 AD=0.1974 PS=1.78 PD=1.78
* device instance $4 r0 *1 24.6,0.21 nfet
Xn4 mc__t2 clk__t5 m__t4 vss__t8 sky130_fd_pr__nfet_01v8 L=0.15 W=0.42 AS=0.1974 AD=0.1974 PS=1.78 PD=1.78
* device instance $5 r0 *1 29.74,0.21 nfet
Xn5 mb__t0 clk__t0 s__t5 vss__t9 sky130_fd_pr__nfet_01v8 L=0.15 W=0.42 AS=0.1974 AD=0.1974 PS=1.78 PD=1.78
* device instance $6 r0 *1 36.545,0.21 nfet
Xn6 q__t2 s__t3 vss__t3 vss__t10 sky130_fd_pr__nfet_01v8 L=0.15 W=0.42 AS=0.1974 AD=0.1974 PS=1.78 PD=1.78
* device instance $7 r0 *1 49.03,0.21 nfet
Xn7 qb__t4 clkb__t4 s__t4 vss__t11 sky130_fd_pr__nfet_01v8 L=0.15 W=0.42 AS=0.1974 AD=0.1974 PS=1.78 PD=1.78
* device instance $8 r0 *1 12.315,0.21 nfet
Xn8 n7__t0 rst_n__t0 vss__t1 vss__t12 sky130_fd_pr__nfet_01v8 L=0.15 W=0.84 AS=0.3948 AD=0.2184 PS=2.62 PD=1.36
* device instance $9 r0 *1 12.985,0.21 nfet
Xn9 mb__t1 m__t0 n7__t1 vss__t14 sky130_fd_pr__nfet_01v8 L=0.15 W=0.84 AS=0.2184 AD=0.3948 PS=1.36 PD=2.62
* device instance $10 r0 *1 43.175,0.21 nfet
Xn10 n11__t1 rst_n__t1 vss__t2 vss__t13 sky130_fd_pr__nfet_01v8 L=0.15 W=0.84 AS=0.3948 AD=0.2184 PS=2.62 PD=1.36
* device instance $11 r0 *1 43.845,0.21 nfet
Xn11 qb__t3 q__t0 n11__t0 vss__t15 sky130_fd_pr__nfet_01v8 L=0.15 W=0.84 AS=0.2184 AD=0.3948 PS=1.36 PD=2.62
* device instance $12 r0 *1 0.545,3.53 pfet
Xn12 clkb__t0 clk__t2 vdd__t11 vdd__t0 sky130_fd_pr__pfet_01v8 L=0.15 W=0.84 AS=0.3948 AD=0.3948 PS=2.62 PD=2.62
* device instance $13 r0 *1 5.31,3.53 pfet
Xn13 d__t0 clk__t3 m__t1 vdd__t1 sky130_fd_pr__pfet_01v8 L=0.15 W=0.84 AS=0.3948 AD=0.3948 PS=2.62 PD=2.62
* device instance $14 r0 *1 19.835,3.53 pfet
Xn14 mc__t0 mb__t5 vdd__t12 vdd__t2 sky130_fd_pr__pfet_01v8 L=0.15 W=0.84 AS=0.3948 AD=0.3948 PS=2.62 PD=2.62
* device instance $15 r0 *1 24.6,3.53 pfet
Xn15 mc__t1 clkb__t2 m__t2 vdd__t3 sky130_fd_pr__pfet_01v8 L=0.15 W=0.84 AS=0.3948 AD=0.3948 PS=2.62 PD=2.62
* device instance $16 r0 *1 29.74,3.53 pfet
Xn16 mb__t2 clkb__t3 s__t0 vdd__t4 sky130_fd_pr__pfet_01v8 L=0.15 W=0.84 AS=0.3948 AD=0.3948 PS=2.62 PD=2.62
* device instance $17 r0 *1 36.545,3.53 pfet
Xn17 q__t1 s__t2 vdd__t13 vdd__t5 sky130_fd_pr__pfet_01v8 L=0.15 W=0.84 AS=0.3948 AD=0.3948 PS=2.62 PD=2.62
* device instance $18 r0 *1 49.03,3.53 pfet
Xn18 qb__t1 clk__t1 s__t1 vdd__t6 sky130_fd_pr__pfet_01v8 L=0.15 W=0.84 AS=0.3948 AD=0.3948 PS=2.62 PD=2.62
* device instance $19 r0 *1 12.115,3.74 pfet
Xn19 mb__t4 rst_n__t2 vdd__t14 vdd__t7 sky130_fd_pr__pfet_01v8 L=0.15 W=0.84 AS=0.3948 AD=0.3948 PS=2.62 PD=2.62
* device instance $20 r0 *1 13.405,3.74 pfet
Xn20 vdd__t16 m__t3 mb__t3 vdd__t8 sky130_fd_pr__pfet_01v8 L=0.15 W=0.84 AS=0.3948 AD=0.3948 PS=2.62 PD=2.62
* device instance $21 r0 *1 42.975,3.74 pfet
Xn21 qb__t2 rst_n__t3 vdd__t15 vdd__t9 sky130_fd_pr__pfet_01v8 L=0.15 W=0.84 AS=0.3948 AD=0.3948 PS=2.62 PD=2.62
* device instance $22 r0 *1 44.265,3.74 pfet
Xn22 vdd__t17 q__t3 qb__t0 vdd__t10 sky130_fd_pr__pfet_01v8 L=0.15 W=0.84 AS=0.3948 AD=0.3948 PS=2.62 PD=2.62
* device instance _11_t0 r0 *1 0,0
R_11_t0 n11__t0 n11 12.8
* device instance _11_t1 r0 *1 0,0
R_11_t1 n11__t1 n11 12.8
* device instance _11 r0 *1 0,0
C_11 n11 vsubs 1.15618e-16
* device instance _7_t0 r0 *1 0,0
R_7_t0 n7__t0 n7 12.8
* device instance _7_t1 r0 *1 0,0
R_7_t1 n7__t1 n7 12.8
* device instance _7 r0 *1 0,0
C_7 n7 vsubs 1.15618e-16
* device instance a_b_inv_q_a_inv_q_a_via_s_tg_fbs_b_tg_fbs_b_via_tg_s_b_tg_s_b_via_t0 r0 *1 0,0
Ra_b_inv_q_a_inv_q_a_via_s_tg_fbs_b_tg_fbs_b_via_tg_s_b_tg_s_b_via_t0 s__t0 s 204.040461511
* device instance a_b_inv_q_a_inv_q_a_via_s_tg_fbs_b_tg_fbs_b_via_tg_s_b_tg_s_b_via_t1 r0 *1 0,0
Ra_b_inv_q_a_inv_q_a_via_s_tg_fbs_b_tg_fbs_b_via_tg_s_b_tg_s_b_via_t1 s__t1 s 247.027895104
* device instance a_b_inv_q_a_inv_q_a_via_s_tg_fbs_b_tg_fbs_b_via_tg_s_b_tg_s_b_via_t2 r0 *1 0,0
Ra_b_inv_q_a_inv_q_a_via_s_tg_fbs_b_tg_fbs_b_via_tg_s_b_tg_s_b_via_t2 s__t2 s 58.0186433859
* device instance a_b_inv_q_a_inv_q_a_via_s_tg_fbs_b_tg_fbs_b_via_tg_s_b_tg_s_b_via_t3 r0 *1 0,0
Ra_b_inv_q_a_inv_q_a_via_s_tg_fbs_b_tg_fbs_b_via_tg_s_b_tg_s_b_via_t3 s__t3 s 58.0186433859
* device instance a_b_inv_q_a_inv_q_a_via_s_tg_fbs_b_tg_fbs_b_via_tg_s_b_tg_s_b_via_t4 r0 *1 0,0
Ra_b_inv_q_a_inv_q_a_via_s_tg_fbs_b_tg_fbs_b_via_tg_s_b_tg_s_b_via_t4 s__t4 s 247.027895104
* device instance a_b_inv_q_a_inv_q_a_via_s_tg_fbs_b_tg_fbs_b_via_tg_s_b_tg_s_b_via_t5 r0 *1 0,0
Ra_b_inv_q_a_inv_q_a_via_s_tg_fbs_b_tg_fbs_b_via_tg_s_b_tg_s_b_via_t5 s__t5 s 204.040461511
* device instance a_b_inv_q_a_inv_q_a_via_s_tg_fbs_b_tg_fbs_b_via_tg_s_b_tg_s_b_via r0 *1 0,0
Ca_b_inv_q_a_inv_q_a_via_s_tg_fbs_b_tg_fbs_b_via_tg_s_b_tg_s_b_via s vsubs 3.84792e-15
* device instance a_b_m_east_m_west_nand_m_a_nand_m_a_ext_via_nand_m_a_ext_via2_nand_m_a_stub_tg_d_b_tg_d_b_via_tg_d_b_via2_tg_fbm_b_tg_fbm_b_alt_via_tg_fbm_b_alt_via2_t0 r0 *1 0,0
Ra_b_m_east_m_west_nand_m_a_nand_m_a_ext_via_nand_m_a_ext_via2_nand_m_a_stub_tg_d_b_tg_d_b_via_tg_d_b_via2_tg_fbm_b_tg_fbm_b_alt_via_tg_fbm_b_alt_via2_t0 m__t0 m 54.9450724763
* device instance a_b_m_east_m_west_nand_m_a_nand_m_a_ext_via_nand_m_a_ext_via2_nand_m_a_stub_tg_d_b_tg_d_b_via_tg_d_b_via2_tg_fbm_b_tg_fbm_b_alt_via_tg_fbm_b_alt_via2_t1 r0 *1 0,0
Ra_b_m_east_m_west_nand_m_a_nand_m_a_ext_via_nand_m_a_ext_via2_nand_m_a_stub_tg_d_b_tg_d_b_via_tg_d_b_via2_tg_fbm_b_tg_fbm_b_alt_via_tg_fbm_b_alt_via2_t1 m__t1 m 231.121281915
* device instance a_b_m_east_m_west_nand_m_a_nand_m_a_ext_via_nand_m_a_ext_via2_nand_m_a_stub_tg_d_b_tg_d_b_via_tg_d_b_via2_tg_fbm_b_tg_fbm_b_alt_via_tg_fbm_b_alt_via2_t2 r0 *1 0,0
Ra_b_m_east_m_west_nand_m_a_nand_m_a_ext_via_nand_m_a_ext_via2_nand_m_a_stub_tg_d_b_tg_d_b_via_tg_d_b_via2_tg_fbm_b_tg_fbm_b_alt_via_tg_fbm_b_alt_via2_t2 m__t2 m 260.17724422
* device instance a_b_m_east_m_west_nand_m_a_nand_m_a_ext_via_nand_m_a_ext_via2_nand_m_a_stub_tg_d_b_tg_d_b_via_tg_d_b_via2_tg_fbm_b_tg_fbm_b_alt_via_tg_fbm_b_alt_via2_t3 r0 *1 0,0
Ra_b_m_east_m_west_nand_m_a_nand_m_a_ext_via_nand_m_a_ext_via2_nand_m_a_stub_tg_d_b_tg_d_b_via_tg_d_b_via2_tg_fbm_b_tg_fbm_b_alt_via_tg_fbm_b_alt_via2_t3 m__t3 m 52.0483618499
* device instance a_b_m_east_m_west_nand_m_a_nand_m_a_ext_via_nand_m_a_ext_via2_nand_m_a_stub_tg_d_b_tg_d_b_via_tg_d_b_via2_tg_fbm_b_tg_fbm_b_alt_via_tg_fbm_b_alt_via2_t4 r0 *1 0,0
Ra_b_m_east_m_west_nand_m_a_nand_m_a_ext_via_nand_m_a_ext_via2_nand_m_a_stub_tg_d_b_tg_d_b_via_tg_d_b_via2_tg_fbm_b_tg_fbm_b_alt_via_tg_fbm_b_alt_via2_t4 m__t4 m 260.45877702
* device instance a_b_m_east_m_west_nand_m_a_nand_m_a_ext_via_nand_m_a_ext_via2_nand_m_a_stub_tg_d_b_tg_d_b_via_tg_d_b_via2_tg_fbm_b_tg_fbm_b_alt_via_tg_fbm_b_alt_via2_t5 r0 *1 0,0
Ra_b_m_east_m_west_nand_m_a_nand_m_a_ext_via_nand_m_a_ext_via2_nand_m_a_stub_tg_d_b_tg_d_b_via_tg_d_b_via2_tg_fbm_b_tg_fbm_b_alt_via_tg_fbm_b_alt_via2_t5 m__t5 m 231.43816252
* device instance a_b_m_east_m_west_nand_m_a_nand_m_a_ext_via_nand_m_a_ext_via2_nand_m_a_stub_tg_d_b_tg_d_b_via_tg_d_b_via2_tg_fbm_b_tg_fbm_b_alt_via_tg_fbm_b_alt_via2 r0 *1 0,0
Ca_b_m_east_m_west_nand_m_a_nand_m_a_ext_via_nand_m_a_ext_via2_nand_m_a_stub_tg_d_b_tg_d_b_via_tg_d_b_via2_tg_fbm_b_tg_fbm_b_alt_via_tg_fbm_b_alt_via2 m vsubs 3.815817e-15
* device instance a_clk_ctrl_ctrlb_inv_clk_a_inv_clk_clk_via_tg_d_ctrl_tg_d_ctrl_via_tg_fbm_ctrlb_tg_fbm_ctrlb_via_tg_fbs_ctrl_tg_fbs_ctrl_via_tg_s_ctrlb_tg_s_ctrlb_via_t0 r0 *1 0,0
Ra_clk_ctrl_ctrlb_inv_clk_a_inv_clk_clk_via_tg_d_ctrl_tg_d_ctrl_via_tg_fbm_ctrlb_tg_fbm_ctrlb_via_tg_fbs_ctrl_tg_fbs_ctrl_via_tg_s_ctrlb_tg_s_ctrlb_via_t0 clk__t0 clk 94.25285816
* device instance a_clk_ctrl_ctrlb_inv_clk_a_inv_clk_clk_via_tg_d_ctrl_tg_d_ctrl_via_tg_fbm_ctrlb_tg_fbm_ctrlb_via_tg_fbs_ctrl_tg_fbs_ctrl_via_tg_s_ctrlb_tg_s_ctrlb_via_t1 r0 *1 0,0
Ra_clk_ctrl_ctrlb_inv_clk_a_inv_clk_clk_via_tg_d_ctrl_tg_d_ctrl_via_tg_fbm_ctrlb_tg_fbm_ctrlb_via_tg_fbs_ctrl_tg_fbs_ctrl_via_tg_s_ctrlb_tg_s_ctrlb_via_t1 clk__t1 clk 250.855551758
* device instance a_clk_ctrl_ctrlb_inv_clk_a_inv_clk_clk_via_tg_d_ctrl_tg_d_ctrl_via_tg_fbm_ctrlb_tg_fbm_ctrlb_via_tg_fbs_ctrl_tg_fbs_ctrl_via_tg_s_ctrlb_tg_s_ctrlb_via_t2 r0 *1 0,0
Ra_clk_ctrl_ctrlb_inv_clk_a_inv_clk_clk_via_tg_d_ctrl_tg_d_ctrl_via_tg_fbm_ctrlb_tg_fbm_ctrlb_via_tg_fbs_ctrl_tg_fbs_ctrl_via_tg_s_ctrlb_tg_s_ctrlb_via_t2 clk__t2 clk 145.293871858
* device instance a_clk_ctrl_ctrlb_inv_clk_a_inv_clk_clk_via_tg_d_ctrl_tg_d_ctrl_via_tg_fbm_ctrlb_tg_fbm_ctrlb_via_tg_fbs_ctrl_tg_fbs_ctrl_via_tg_s_ctrlb_tg_s_ctrlb_via_t3 r0 *1 0,0
Ra_clk_ctrl_ctrlb_inv_clk_a_inv_clk_clk_via_tg_d_ctrl_tg_d_ctrl_via_tg_fbm_ctrlb_tg_fbm_ctrlb_via_tg_fbs_ctrl_tg_fbs_ctrl_via_tg_s_ctrlb_tg_s_ctrlb_via_t3 clk__t3 clk 106.689109875
* device instance a_clk_ctrl_ctrlb_inv_clk_a_inv_clk_clk_via_tg_d_ctrl_tg_d_ctrl_via_tg_fbm_ctrlb_tg_fbm_ctrlb_via_tg_fbs_ctrl_tg_fbs_ctrl_via_tg_s_ctrlb_tg_s_ctrlb_via_t4 r0 *1 0,0
Ra_clk_ctrl_ctrlb_inv_clk_a_inv_clk_clk_via_tg_d_ctrl_tg_d_ctrl_via_tg_fbm_ctrlb_tg_fbm_ctrlb_via_tg_fbs_ctrl_tg_fbs_ctrl_via_tg_s_ctrlb_tg_s_ctrlb_via_t4 clk__t4 clk 145.293871858
* device instance a_clk_ctrl_ctrlb_inv_clk_a_inv_clk_clk_via_tg_d_ctrl_tg_d_ctrl_via_tg_fbm_ctrlb_tg_fbm_ctrlb_via_tg_fbs_ctrl_tg_fbs_ctrl_via_tg_s_ctrlb_tg_s_ctrlb_via_t5 r0 *1 0,0
Ra_clk_ctrl_ctrlb_inv_clk_a_inv_clk_clk_via_tg_d_ctrl_tg_d_ctrl_via_tg_fbm_ctrlb_tg_fbm_ctrlb_via_tg_fbs_ctrl_tg_fbs_ctrl_via_tg_s_ctrlb_tg_s_ctrlb_via_t5 clk__t5 clk 53.1369364906
* device instance a_clk_ctrl_ctrlb_inv_clk_a_inv_clk_clk_via_tg_d_ctrl_tg_d_ctrl_via_tg_fbm_ctrlb_tg_fbm_ctrlb_via_tg_fbs_ctrl_tg_fbs_ctrl_via_tg_s_ctrlb_tg_s_ctrlb_via r0 *1 0,0
Ca_clk_ctrl_ctrlb_inv_clk_a_inv_clk_clk_via_tg_d_ctrl_tg_d_ctrl_via_tg_fbm_ctrlb_tg_fbm_ctrlb_via_tg_fbs_ctrl_tg_fbs_ctrl_via_tg_s_ctrlb_tg_s_ctrlb_via clk vsubs 7.213055e-15
* device instance a_d_tg_d_a_t0 r0 *1 0,0
Ra_d_tg_d_a_t0 d__t0 d 207.64565
* device instance a_d_tg_d_a_t1 r0 *1 0,0
Ra_d_tg_d_a_t1 d__t1 d 207.64565
* device instance a_d_tg_d_a r0 *1 0,0
Ca_d_tg_d_a d vsubs 6.0717e-16
* device instance a_inv_mc_a_mb_mnab_y_mpa_y_mpb_y_nand_m_y_tg_s_a_y_t0 r0 *1 0,0
Ra_inv_mc_a_mb_mnab_y_mpa_y_mpb_y_nand_m_y_tg_s_a_y_t0 mb__t0 mb 189.921079219
* device instance a_inv_mc_a_mb_mnab_y_mpa_y_mpb_y_nand_m_y_tg_s_a_y_t1 r0 *1 0,0
Ra_inv_mc_a_mb_mnab_y_mpa_y_mpb_y_nand_m_y_tg_s_a_y_t1 mb__t1 mb 128.808394178
* device instance a_inv_mc_a_mb_mnab_y_mpa_y_mpb_y_nand_m_y_tg_s_a_y_t2 r0 *1 0,0
Ra_inv_mc_a_mb_mnab_y_mpa_y_mpb_y_nand_m_y_tg_s_a_y_t2 mb__t2 mb 188.133983991
* device instance a_inv_mc_a_mb_mnab_y_mpa_y_mpb_y_nand_m_y_tg_s_a_y_t3 r0 *1 0,0
Ra_inv_mc_a_mb_mnab_y_mpa_y_mpb_y_nand_m_y_tg_s_a_y_t3 mb__t3 mb 119.440616038
* device instance a_inv_mc_a_mb_mnab_y_mpa_y_mpb_y_nand_m_y_tg_s_a_y_t4 r0 *1 0,0
Ra_inv_mc_a_mb_mnab_y_mpa_y_mpb_y_nand_m_y_tg_s_a_y_t4 mb__t4 mb 142.710836615
* device instance a_inv_mc_a_mb_mnab_y_mpa_y_mpb_y_nand_m_y_tg_s_a_y_t5 r0 *1 0,0
Ra_inv_mc_a_mb_mnab_y_mpa_y_mpb_y_nand_m_y_tg_s_a_y_t5 mb__t5 mb 25.4148600674
* device instance a_inv_mc_a_mb_mnab_y_mpa_y_mpb_y_nand_m_y_tg_s_a_y_t6 r0 *1 0,0
Ra_inv_mc_a_mb_mnab_y_mpa_y_mpb_y_nand_m_y_tg_s_a_y_t6 mb__t6 mb 36.3529298905
* device instance a_inv_mc_a_mb_mnab_y_mpa_y_mpb_y_nand_m_y_tg_s_a_y r0 *1 0,0
Ca_inv_mc_a_mb_mnab_y_mpa_y_mpb_y_nand_m_y_tg_s_a_y mb vsubs 4.013475e-15
* device instance a_inv_mc_y_inv_mc_y_via_mc_tg_fbm_a_tg_fbm_a_via_y_t0 r0 *1 0,0
Ra_inv_mc_y_inv_mc_y_via_mc_tg_fbm_a_tg_fbm_a_via_y_t0 mc__t0 mc 208.313425
* device instance a_inv_mc_y_inv_mc_y_via_mc_tg_fbm_a_tg_fbm_a_via_y_t1 r0 *1 0,0
Ra_inv_mc_y_inv_mc_y_via_mc_tg_fbm_a_tg_fbm_a_via_y_t1 mc__t1 mc 208.313425
* device instance a_inv_mc_y_inv_mc_y_via_mc_tg_fbm_a_tg_fbm_a_via_y_t2 r0 *1 0,0
Ra_inv_mc_y_inv_mc_y_via_mc_tg_fbm_a_tg_fbm_a_via_y_t2 mc__t2 mc 208.313425
* device instance a_inv_mc_y_inv_mc_y_via_mc_tg_fbm_a_tg_fbm_a_via_y_t3 r0 *1 0,0
Ra_inv_mc_y_inv_mc_y_via_mc_tg_fbm_a_tg_fbm_a_via_y_t3 mc__t3 mc 208.313425
* device instance a_inv_mc_y_inv_mc_y_via_mc_tg_fbm_a_tg_fbm_a_via_y r0 *1 0,0
Ca_inv_mc_y_inv_mc_y_via_mc_tg_fbm_a_tg_fbm_a_via_y mc vsubs 1.955756e-15
* device instance a_inv_q_y_inv_q_y_via_inv_q_y_via2_nand_s2_a_nand_s2_a_stub_nand_s2_a_via_nand_s2_a_via2_q_y_t0 r0 *1 0,0
Ra_inv_q_y_inv_q_y_via_inv_q_y_via2_nand_s2_a_nand_s2_a_stub_nand_s2_a_via_nand_s2_a_via2_q_y_t0 q__t0 q 194.850123448
* device instance a_inv_q_y_inv_q_y_via_inv_q_y_via2_nand_s2_a_nand_s2_a_stub_nand_s2_a_via_nand_s2_a_via2_q_y_t1 r0 *1 0,0
Ra_inv_q_y_inv_q_y_via_inv_q_y_via2_nand_s2_a_nand_s2_a_stub_nand_s2_a_via_nand_s2_a_via2_q_y_t1 q__t1 q 202.157775401
* device instance a_inv_q_y_inv_q_y_via_inv_q_y_via2_nand_s2_a_nand_s2_a_stub_nand_s2_a_via_nand_s2_a_via2_q_y_t2 r0 *1 0,0
Ra_inv_q_y_inv_q_y_via_inv_q_y_via2_nand_s2_a_nand_s2_a_stub_nand_s2_a_via_nand_s2_a_via2_q_y_t2 q__t2 q 204.258816542
* device instance a_inv_q_y_inv_q_y_via_inv_q_y_via2_nand_s2_a_nand_s2_a_stub_nand_s2_a_via_nand_s2_a_via2_q_y_t3 r0 *1 0,0
Ra_inv_q_y_inv_q_y_via_inv_q_y_via2_nand_s2_a_nand_s2_a_stub_nand_s2_a_via_nand_s2_a_via2_q_y_t3 q__t3 q 215.871984609
* device instance a_inv_q_y_inv_q_y_via_inv_q_y_via2_nand_s2_a_nand_s2_a_stub_nand_s2_a_via_nand_s2_a_via2_q_y r0 *1 0,0
Ca_inv_q_y_inv_q_y_via_inv_q_y_via2_nand_s2_a_nand_s2_a_stub_nand_s2_a_via_nand_s2_a_via2_q_y q vsubs 2.217373e-15
* device instance a_mnab_y_mpa_y_mpb_y_nand_s2_y_qb_tg_fbs_a_y_t0 r0 *1 0,0
Ra_mnab_y_mpa_y_mpb_y_nand_s2_y_qb_tg_fbs_a_y_t0 qb__t0 qb 67.6227277536
* device instance a_mnab_y_mpa_y_mpb_y_nand_s2_y_qb_tg_fbs_a_y_t1 r0 *1 0,0
Ra_mnab_y_mpa_y_mpb_y_nand_s2_y_qb_tg_fbs_a_y_t1 qb__t1 qb 108.750076347
* device instance a_mnab_y_mpa_y_mpb_y_nand_s2_y_qb_tg_fbs_a_y_t2 r0 *1 0,0
Ra_mnab_y_mpa_y_mpb_y_nand_s2_y_qb_tg_fbs_a_y_t2 qb__t2 qb 101.428926114
* device instance a_mnab_y_mpa_y_mpb_y_nand_s2_y_qb_tg_fbs_a_y_t3 r0 *1 0,0
Ra_mnab_y_mpa_y_mpb_y_nand_s2_y_qb_tg_fbs_a_y_t3 qb__t3 qb 90.9332423319
* device instance a_mnab_y_mpa_y_mpb_y_nand_s2_y_qb_tg_fbs_a_y_t4 r0 *1 0,0
Ra_mnab_y_mpa_y_mpb_y_nand_s2_y_qb_tg_fbs_a_y_t4 qb__t4 qb 120.815827453
* device instance a_mnab_y_mpa_y_mpb_y_nand_s2_y_qb_tg_fbs_a_y r0 *1 0,0
Ca_mnab_y_mpa_y_mpb_y_nand_s2_y_qb_tg_fbs_a_y qb vsubs 2.242968e-15
* device instance clkb_clkb_bridge1_clkb_bridge2_clkb_mid_clkb_w_ctrl_ctrlb_inv_clk_y_tg_d_ctrlb_tg_fbm_ctrl_tg_fbs_ctrlb_tg_s_ctrl_y_t0 r0 *1 0,0
Rclkb_clkb_bridge1_clkb_bridge2_clkb_mid_clkb_w_ctrl_ctrlb_inv_clk_y_tg_d_ctrlb_tg_fbm_ctrl_tg_fbs_ctrlb_tg_s_ctrl_y_t0 clkb__t0 clkb 161.077076378
* device instance clkb_clkb_bridge1_clkb_bridge2_clkb_mid_clkb_w_ctrl_ctrlb_inv_clk_y_tg_d_ctrlb_tg_fbm_ctrl_tg_fbs_ctrlb_tg_s_ctrl_y_t1 r0 *1 0,0
Rclkb_clkb_bridge1_clkb_bridge2_clkb_mid_clkb_w_ctrl_ctrlb_inv_clk_y_tg_d_ctrlb_tg_fbm_ctrl_tg_fbs_ctrlb_tg_s_ctrl_y_t1 clkb__t1 clkb 161.077076378
* device instance clkb_clkb_bridge1_clkb_bridge2_clkb_mid_clkb_w_ctrl_ctrlb_inv_clk_y_tg_d_ctrlb_tg_fbm_ctrl_tg_fbs_ctrlb_tg_s_ctrl_y_t2 r0 *1 0,0
Rclkb_clkb_bridge1_clkb_bridge2_clkb_mid_clkb_w_ctrl_ctrlb_inv_clk_y_tg_d_ctrlb_tg_fbm_ctrl_tg_fbs_ctrlb_tg_s_ctrl_y_t2 clkb__t2 clkb 58.9091767475
* device instance clkb_clkb_bridge1_clkb_bridge2_clkb_mid_clkb_w_ctrl_ctrlb_inv_clk_y_tg_d_ctrlb_tg_fbm_ctrl_tg_fbs_ctrlb_tg_s_ctrl_y_t3 r0 *1 0,0
Rclkb_clkb_bridge1_clkb_bridge2_clkb_mid_clkb_w_ctrl_ctrlb_inv_clk_y_tg_d_ctrlb_tg_fbm_ctrl_tg_fbs_ctrlb_tg_s_ctrl_y_t3 clkb__t3 clkb 104.491501524
* device instance clkb_clkb_bridge1_clkb_bridge2_clkb_mid_clkb_w_ctrl_ctrlb_inv_clk_y_tg_d_ctrlb_tg_fbm_ctrl_tg_fbs_ctrlb_tg_s_ctrl_y_t4 r0 *1 0,0
Rclkb_clkb_bridge1_clkb_bridge2_clkb_mid_clkb_w_ctrl_ctrlb_inv_clk_y_tg_d_ctrlb_tg_fbm_ctrl_tg_fbs_ctrlb_tg_s_ctrl_y_t4 clkb__t4 clkb 278.105871595
* device instance clkb_clkb_bridge1_clkb_bridge2_clkb_mid_clkb_w_ctrl_ctrlb_inv_clk_y_tg_d_ctrlb_tg_fbm_ctrl_tg_fbs_ctrlb_tg_s_ctrl_y_t5 r0 *1 0,0
Rclkb_clkb_bridge1_clkb_bridge2_clkb_mid_clkb_w_ctrl_ctrlb_inv_clk_y_tg_d_ctrlb_tg_fbm_ctrl_tg_fbs_ctrlb_tg_s_ctrl_y_t5 clkb__t5 clkb 118.278697376
* device instance clkb_clkb_bridge1_clkb_bridge2_clkb_mid_clkb_w_ctrl_ctrlb_inv_clk_y_tg_d_ctrlb_tg_fbm_ctrl_tg_fbs_ctrlb_tg_s_ctrl_y r0 *1 0,0
Cclkb_clkb_bridge1_clkb_bridge2_clkb_mid_clkb_w_ctrl_ctrlb_inv_clk_y_tg_d_ctrlb_tg_fbm_ctrl_tg_fbs_ctrlb_tg_s_ctrl_y clkb vsubs 6.708136e-15
* device instance en_nand_m_en_nand_m_en_via_nand_s2_en_nand_s2_en_via_rst_n_t0 r0 *1 0,0
Ren_nand_m_en_nand_m_en_via_nand_s2_en_nand_s2_en_via_rst_n_t0 rst_n__t0 rst_n 164.82474871
* device instance en_nand_m_en_nand_m_en_via_nand_s2_en_nand_s2_en_via_rst_n_t1 r0 *1 0,0
Ren_nand_m_en_nand_m_en_via_nand_s2_en_nand_s2_en_via_rst_n_t1 rst_n__t1 rst_n 166.94715129
* device instance en_nand_m_en_nand_m_en_via_nand_s2_en_nand_s2_en_via_rst_n_t2 r0 *1 0,0
Ren_nand_m_en_nand_m_en_via_nand_s2_en_nand_s2_en_via_rst_n_t2 rst_n__t2 rst_n 166.94715129
* device instance en_nand_m_en_nand_m_en_via_nand_s2_en_nand_s2_en_via_rst_n_t3 r0 *1 0,0
Ren_nand_m_en_nand_m_en_via_nand_s2_en_nand_s2_en_via_rst_n_t3 rst_n__t3 rst_n 164.82474871
* device instance en_nand_m_en_nand_m_en_via_nand_s2_en_nand_s2_en_via_rst_n r0 *1 0,0
Cen_nand_m_en_nand_m_en_via_nand_s2_en_nand_s2_en_via_rst_n rst_n vsubs 3.866751e-15
* device instance inv_clk_vdd_inv_mc_vdd_inv_q_vdd_mpa_py_mpb_py_nand_m_vdd_nand_s2_vdd_nwell_vdd_tg_d_vdd_tg_fbm_vdd_tg_fbs_vdd_tg_s_vdd_vdd_t0 r0 *1 0,0
Rinv_clk_vdd_inv_mc_vdd_inv_q_vdd_mpa_py_mpb_py_nand_m_vdd_nand_s2_vdd_nwell_vdd_tg_d_vdd_tg_fbm_vdd_tg_fbs_vdd_tg_s_vdd_vdd_t0 vdd__t0 vdd 156.115471483
* device instance inv_clk_vdd_inv_mc_vdd_inv_q_vdd_mpa_py_mpb_py_nand_m_vdd_nand_s2_vdd_nwell_vdd_tg_d_vdd_tg_fbm_vdd_tg_fbs_vdd_tg_s_vdd_vdd_t1 r0 *1 0,0
Rinv_clk_vdd_inv_mc_vdd_inv_q_vdd_mpa_py_mpb_py_nand_m_vdd_nand_s2_vdd_nwell_vdd_tg_d_vdd_tg_fbm_vdd_tg_fbs_vdd_tg_s_vdd_vdd_t1 vdd__t1 vdd 125.561886066
* device instance inv_clk_vdd_inv_mc_vdd_inv_q_vdd_mpa_py_mpb_py_nand_m_vdd_nand_s2_vdd_nwell_vdd_tg_d_vdd_tg_fbm_vdd_tg_fbs_vdd_tg_s_vdd_vdd_t2 r0 *1 0,0
Rinv_clk_vdd_inv_mc_vdd_inv_q_vdd_mpa_py_mpb_py_nand_m_vdd_nand_s2_vdd_nwell_vdd_tg_d_vdd_tg_fbm_vdd_tg_fbs_vdd_tg_s_vdd_vdd_t2 vdd__t2 vdd 32.4295957445
* device instance inv_clk_vdd_inv_mc_vdd_inv_q_vdd_mpa_py_mpb_py_nand_m_vdd_nand_s2_vdd_nwell_vdd_tg_d_vdd_tg_fbm_vdd_tg_fbs_vdd_tg_s_vdd_vdd_t3 r0 *1 0,0
Rinv_clk_vdd_inv_mc_vdd_inv_q_vdd_mpa_py_mpb_py_nand_m_vdd_nand_s2_vdd_nwell_vdd_tg_d_vdd_tg_fbm_vdd_tg_fbs_vdd_tg_s_vdd_vdd_t3 vdd__t3 vdd 1.96362993709
* device instance inv_clk_vdd_inv_mc_vdd_inv_q_vdd_mpa_py_mpb_py_nand_m_vdd_nand_s2_vdd_nwell_vdd_tg_d_vdd_tg_fbm_vdd_tg_fbs_vdd_tg_s_vdd_vdd_t4 r0 *1 0,0
Rinv_clk_vdd_inv_mc_vdd_inv_q_vdd_mpa_py_mpb_py_nand_m_vdd_nand_s2_vdd_nwell_vdd_tg_d_vdd_tg_fbm_vdd_tg_fbs_vdd_tg_s_vdd_vdd_t4 vdd__t4 vdd 31.0939697461
* device instance inv_clk_vdd_inv_mc_vdd_inv_q_vdd_mpa_py_mpb_py_nand_m_vdd_nand_s2_vdd_nwell_vdd_tg_d_vdd_tg_fbm_vdd_tg_fbs_vdd_tg_s_vdd_vdd_t5 r0 *1 0,0
Rinv_clk_vdd_inv_mc_vdd_inv_q_vdd_mpa_py_mpb_py_nand_m_vdd_nand_s2_vdd_nwell_vdd_tg_d_vdd_tg_fbm_vdd_tg_fbs_vdd_tg_s_vdd_vdd_t5 vdd__t5 vdd 74.7252440485
* device instance inv_clk_vdd_inv_mc_vdd_inv_q_vdd_mpa_py_mpb_py_nand_m_vdd_nand_s2_vdd_nwell_vdd_tg_d_vdd_tg_fbm_vdd_tg_fbs_vdd_tg_s_vdd_vdd_t6 r0 *1 0,0
Rinv_clk_vdd_inv_mc_vdd_inv_q_vdd_mpa_py_mpb_py_nand_m_vdd_nand_s2_vdd_nwell_vdd_tg_d_vdd_tg_fbm_vdd_tg_fbs_vdd_tg_s_vdd_vdd_t6 vdd__t6 vdd 154.77961812
* device instance inv_clk_vdd_inv_mc_vdd_inv_q_vdd_mpa_py_mpb_py_nand_m_vdd_nand_s2_vdd_nwell_vdd_tg_d_vdd_tg_fbm_vdd_tg_fbs_vdd_tg_s_vdd_vdd_t7 r0 *1 0,0
Rinv_clk_vdd_inv_mc_vdd_inv_q_vdd_mpa_py_mpb_py_nand_m_vdd_nand_s2_vdd_nwell_vdd_tg_d_vdd_tg_fbm_vdd_tg_fbs_vdd_tg_s_vdd_vdd_t7 vdd__t7 vdd 81.9292375845
* device instance inv_clk_vdd_inv_mc_vdd_inv_q_vdd_mpa_py_mpb_py_nand_m_vdd_nand_s2_vdd_nwell_vdd_tg_d_vdd_tg_fbm_vdd_tg_fbs_vdd_tg_s_vdd_vdd_t8 r0 *1 0,0
Rinv_clk_vdd_inv_mc_vdd_inv_q_vdd_mpa_py_mpb_py_nand_m_vdd_nand_s2_vdd_nwell_vdd_tg_d_vdd_tg_fbm_vdd_tg_fbs_vdd_tg_s_vdd_vdd_t8 vdd__t8 vdd 73.6579558033
* device instance inv_clk_vdd_inv_mc_vdd_inv_q_vdd_mpa_py_mpb_py_nand_m_vdd_nand_s2_vdd_nwell_vdd_tg_d_vdd_tg_fbm_vdd_tg_fbs_vdd_tg_s_vdd_vdd_t9 r0 *1 0,0
Rinv_clk_vdd_inv_mc_vdd_inv_q_vdd_mpa_py_mpb_py_nand_m_vdd_nand_s2_vdd_nwell_vdd_tg_d_vdd_tg_fbm_vdd_tg_fbs_vdd_tg_s_vdd_vdd_t9 vdd__t9 vdd 115.955344378
* device instance inv_clk_vdd_inv_mc_vdd_inv_q_vdd_mpa_py_mpb_py_nand_m_vdd_nand_s2_vdd_nwell_vdd_tg_d_vdd_tg_fbm_vdd_tg_fbs_vdd_tg_s_vdd_vdd_t10 r0 *1 0,0
Rinv_clk_vdd_inv_mc_vdd_inv_q_vdd_mpa_py_mpb_py_nand_m_vdd_nand_s2_vdd_nwell_vdd_tg_d_vdd_tg_fbm_vdd_tg_fbs_vdd_tg_s_vdd_vdd_t10 vdd__t10 vdd 124.226849023
* device instance inv_clk_vdd_inv_mc_vdd_inv_q_vdd_mpa_py_mpb_py_nand_m_vdd_nand_s2_vdd_nwell_vdd_tg_d_vdd_tg_fbm_vdd_tg_fbs_vdd_tg_s_vdd_vdd_t11 r0 *1 0,0
Rinv_clk_vdd_inv_mc_vdd_inv_q_vdd_mpa_py_mpb_py_nand_m_vdd_nand_s2_vdd_nwell_vdd_tg_d_vdd_tg_fbm_vdd_tg_fbs_vdd_tg_s_vdd_vdd_t11 vdd__t11 vdd 156.115471483
* device instance inv_clk_vdd_inv_mc_vdd_inv_q_vdd_mpa_py_mpb_py_nand_m_vdd_nand_s2_vdd_nwell_vdd_tg_d_vdd_tg_fbm_vdd_tg_fbs_vdd_tg_s_vdd_vdd_t12 r0 *1 0,0
Rinv_clk_vdd_inv_mc_vdd_inv_q_vdd_mpa_py_mpb_py_nand_m_vdd_nand_s2_vdd_nwell_vdd_tg_d_vdd_tg_fbm_vdd_tg_fbs_vdd_tg_s_vdd_vdd_t12 vdd__t12 vdd 32.4295957445
* device instance inv_clk_vdd_inv_mc_vdd_inv_q_vdd_mpa_py_mpb_py_nand_m_vdd_nand_s2_vdd_nwell_vdd_tg_d_vdd_tg_fbm_vdd_tg_fbs_vdd_tg_s_vdd_vdd_t13 r0 *1 0,0
Rinv_clk_vdd_inv_mc_vdd_inv_q_vdd_mpa_py_mpb_py_nand_m_vdd_nand_s2_vdd_nwell_vdd_tg_d_vdd_tg_fbm_vdd_tg_fbs_vdd_tg_s_vdd_vdd_t13 vdd__t13 vdd 74.7252440485
* device instance inv_clk_vdd_inv_mc_vdd_inv_q_vdd_mpa_py_mpb_py_nand_m_vdd_nand_s2_vdd_nwell_vdd_tg_d_vdd_tg_fbm_vdd_tg_fbs_vdd_tg_s_vdd_vdd_t14 r0 *1 0,0
Rinv_clk_vdd_inv_mc_vdd_inv_q_vdd_mpa_py_mpb_py_nand_m_vdd_nand_s2_vdd_nwell_vdd_tg_d_vdd_tg_fbm_vdd_tg_fbs_vdd_tg_s_vdd_vdd_t14 vdd__t14 vdd 81.9292375845
* device instance inv_clk_vdd_inv_mc_vdd_inv_q_vdd_mpa_py_mpb_py_nand_m_vdd_nand_s2_vdd_nwell_vdd_tg_d_vdd_tg_fbm_vdd_tg_fbs_vdd_tg_s_vdd_vdd_t15 r0 *1 0,0
Rinv_clk_vdd_inv_mc_vdd_inv_q_vdd_mpa_py_mpb_py_nand_m_vdd_nand_s2_vdd_nwell_vdd_tg_d_vdd_tg_fbm_vdd_tg_fbs_vdd_tg_s_vdd_vdd_t15 vdd__t15 vdd 115.955344378
* device instance inv_clk_vdd_inv_mc_vdd_inv_q_vdd_mpa_py_mpb_py_nand_m_vdd_nand_s2_vdd_nwell_vdd_tg_d_vdd_tg_fbm_vdd_tg_fbs_vdd_tg_s_vdd_vdd_t16 r0 *1 0,0
Rinv_clk_vdd_inv_mc_vdd_inv_q_vdd_mpa_py_mpb_py_nand_m_vdd_nand_s2_vdd_nwell_vdd_tg_d_vdd_tg_fbm_vdd_tg_fbs_vdd_tg_s_vdd_vdd_t16 vdd__t16 vdd 73.6579558033
* device instance inv_clk_vdd_inv_mc_vdd_inv_q_vdd_mpa_py_mpb_py_nand_m_vdd_nand_s2_vdd_nwell_vdd_tg_d_vdd_tg_fbm_vdd_tg_fbs_vdd_tg_s_vdd_vdd_t17 r0 *1 0,0
Rinv_clk_vdd_inv_mc_vdd_inv_q_vdd_mpa_py_mpb_py_nand_m_vdd_nand_s2_vdd_nwell_vdd_tg_d_vdd_tg_fbm_vdd_tg_fbs_vdd_tg_s_vdd_vdd_t17 vdd__t17 vdd 124.226849023
* device instance inv_clk_vdd_inv_mc_vdd_inv_q_vdd_mpa_py_mpb_py_nand_m_vdd_nand_s2_vdd_nwell_vdd_tg_d_vdd_tg_fbm_vdd_tg_fbs_vdd_tg_s_vdd_vdd r0 *1 0,0
Cinv_clk_vdd_inv_mc_vdd_inv_q_vdd_mpa_py_mpb_py_nand_m_vdd_nand_s2_vdd_nwell_vdd_tg_d_vdd_tg_fbm_vdd_tg_fbs_vdd_tg_s_vdd_vdd vdd vsubs 1.2933798e-14
* device instance inv_clk_vss_inv_mc_vss_inv_q_vss_nand_m_vss_nand_s2_vss_tg_d_vss_tg_fbm_vss_tg_fbs_vss_tg_s_vss_vss_t0 r0 *1 0,0
Rinv_clk_vss_inv_mc_vss_inv_q_vss_nand_m_vss_nand_s2_vss_tg_d_vss_tg_fbm_vss_tg_fbs_vss_tg_s_vss_vss_t0 vss__t0 vss 173.506093022
* device instance inv_clk_vss_inv_mc_vss_inv_q_vss_nand_m_vss_nand_s2_vss_tg_d_vss_tg_fbm_vss_tg_fbs_vss_tg_s_vss_vss_t1 r0 *1 0,0
Rinv_clk_vss_inv_mc_vss_inv_q_vss_nand_m_vss_nand_s2_vss_tg_d_vss_tg_fbm_vss_tg_fbs_vss_tg_s_vss_vss_t1 vss__t1 vss 87.8851417147
* device instance inv_clk_vss_inv_mc_vss_inv_q_vss_nand_m_vss_nand_s2_vss_tg_d_vss_tg_fbm_vss_tg_fbs_vss_tg_s_vss_vss_t2 r0 *1 0,0
Rinv_clk_vss_inv_mc_vss_inv_q_vss_nand_m_vss_nand_s2_vss_tg_d_vss_tg_fbm_vss_tg_fbs_vss_tg_s_vss_vss_t2 vss__t2 vss 136.606154576
* device instance inv_clk_vss_inv_mc_vss_inv_q_vss_nand_m_vss_nand_s2_vss_tg_d_vss_tg_fbm_vss_tg_fbs_vss_tg_s_vss_vss_t3 r0 *1 0,0
Rinv_clk_vss_inv_mc_vss_inv_q_vss_nand_m_vss_nand_s2_vss_tg_d_vss_tg_fbm_vss_tg_fbs_vss_tg_s_vss_vss_t3 vss__t3 vss 88.3761709597
* device instance inv_clk_vss_inv_mc_vss_inv_q_vss_nand_m_vss_nand_s2_vss_tg_d_vss_tg_fbm_vss_tg_fbs_vss_tg_s_vss_vss_t4 r0 *1 0,0
Rinv_clk_vss_inv_mc_vss_inv_q_vss_nand_m_vss_nand_s2_vss_tg_d_vss_tg_fbm_vss_tg_fbs_vss_tg_s_vss_vss_t4 vss__t4 vss 33.1808465718
* device instance inv_clk_vss_inv_mc_vss_inv_q_vss_nand_m_vss_nand_s2_vss_tg_d_vss_tg_fbm_vss_tg_fbs_vss_tg_s_vss_vss_t5 r0 *1 0,0
Rinv_clk_vss_inv_mc_vss_inv_q_vss_nand_m_vss_nand_s2_vss_tg_d_vss_tg_fbm_vss_tg_fbs_vss_tg_s_vss_vss_t5 vss__t5 vss 173.506093022
* device instance inv_clk_vss_inv_mc_vss_inv_q_vss_nand_m_vss_nand_s2_vss_tg_d_vss_tg_fbm_vss_tg_fbs_vss_tg_s_vss_vss_t6 r0 *1 0,0
Rinv_clk_vss_inv_mc_vss_inv_q_vss_nand_m_vss_nand_s2_vss_tg_d_vss_tg_fbm_vss_tg_fbs_vss_tg_s_vss_vss_t6 vss__t6 vss 138.843065581
* device instance inv_clk_vss_inv_mc_vss_inv_q_vss_nand_m_vss_nand_s2_vss_tg_d_vss_tg_fbm_vss_tg_fbs_vss_tg_s_vss_vss_t7 r0 *1 0,0
Rinv_clk_vss_inv_mc_vss_inv_q_vss_nand_m_vss_nand_s2_vss_tg_d_vss_tg_fbm_vss_tg_fbs_vss_tg_s_vss_vss_t7 vss__t7 vss 33.1808465718
* device instance inv_clk_vss_inv_mc_vss_inv_q_vss_nand_m_vss_nand_s2_vss_tg_d_vss_tg_fbm_vss_tg_fbs_vss_tg_s_vss_vss_t8 r0 *1 0,0
Rinv_clk_vss_inv_mc_vss_inv_q_vss_nand_m_vss_nand_s2_vss_tg_d_vss_tg_fbm_vss_tg_fbs_vss_tg_s_vss_vss_t8 vss__t8 vss 1.48218086906
* device instance inv_clk_vss_inv_mc_vss_inv_q_vss_nand_m_vss_nand_s2_vss_tg_d_vss_tg_fbm_vss_tg_fbs_vss_tg_s_vss_vss_t9 r0 *1 0,0
Rinv_clk_vss_inv_mc_vss_inv_q_vss_nand_m_vss_nand_s2_vss_tg_d_vss_tg_fbm_vss_tg_fbs_vss_tg_s_vss_vss_t9 vss__t9 vss 38.8731485598
* device instance inv_clk_vss_inv_mc_vss_inv_q_vss_nand_m_vss_nand_s2_vss_tg_d_vss_tg_fbm_vss_tg_fbs_vss_tg_s_vss_vss_t10 r0 *1 0,0
Rinv_clk_vss_inv_mc_vss_inv_q_vss_nand_m_vss_nand_s2_vss_tg_d_vss_tg_fbm_vss_tg_fbs_vss_tg_s_vss_vss_t10 vss__t10 vss 88.3761709597
* device instance inv_clk_vss_inv_mc_vss_inv_q_vss_nand_m_vss_nand_s2_vss_tg_d_vss_tg_fbm_vss_tg_fbs_vss_tg_s_vss_vss_t11 r0 *1 0,0
Rinv_clk_vss_inv_mc_vss_inv_q_vss_nand_m_vss_nand_s2_vss_tg_d_vss_tg_fbm_vss_tg_fbs_vss_tg_s_vss_vss_t11 vss__t11 vss 179.19839501
* device instance inv_clk_vss_inv_mc_vss_inv_q_vss_nand_m_vss_nand_s2_vss_tg_d_vss_tg_fbm_vss_tg_fbs_vss_tg_s_vss_vss_t12 r0 *1 0,0
Rinv_clk_vss_inv_mc_vss_inv_q_vss_nand_m_vss_nand_s2_vss_tg_d_vss_tg_fbm_vss_tg_fbs_vss_tg_s_vss_vss_t12 vss__t12 vss 87.8851417147
* device instance inv_clk_vss_inv_mc_vss_inv_q_vss_nand_m_vss_nand_s2_vss_tg_d_vss_tg_fbm_vss_tg_fbs_vss_tg_s_vss_vss_t13 r0 *1 0,0
Rinv_clk_vss_inv_mc_vss_inv_q_vss_nand_m_vss_nand_s2_vss_tg_d_vss_tg_fbm_vss_tg_fbs_vss_tg_s_vss_vss_t13 vss__t13 vss 136.606154576
* device instance inv_clk_vss_inv_mc_vss_inv_q_vss_nand_m_vss_nand_s2_vss_tg_d_vss_tg_fbm_vss_tg_fbs_vss_tg_s_vss_vss_t14 r0 *1 0,0
Rinv_clk_vss_inv_mc_vss_inv_q_vss_nand_m_vss_nand_s2_vss_tg_d_vss_tg_fbm_vss_tg_fbs_vss_tg_s_vss_vss_t14 vss__t14 vss 83.0112218017
* device instance inv_clk_vss_inv_mc_vss_inv_q_vss_nand_m_vss_nand_s2_vss_tg_d_vss_tg_fbm_vss_tg_fbs_vss_tg_s_vss_vss_t15 r0 *1 0,0
Rinv_clk_vss_inv_mc_vss_inv_q_vss_nand_m_vss_nand_s2_vss_tg_d_vss_tg_fbm_vss_tg_fbs_vss_tg_s_vss_vss_t15 vss__t15 vss 141.480074489
* device instance inv_clk_vss_inv_mc_vss_inv_q_vss_nand_m_vss_nand_s2_vss_tg_d_vss_tg_fbm_vss_tg_fbs_vss_tg_s_vss_vss r0 *1 0,0
Cinv_clk_vss_inv_mc_vss_inv_q_vss_nand_m_vss_nand_s2_vss_tg_d_vss_tg_fbm_vss_tg_fbs_vss_tg_s_vss_vss vss vsubs 1.1780945e-14
* device instance cc_a_b_inv_q_a_inv_q_a_via_s_tg_fbs_b_tg_fbs_b_via_tg_s_b_tg_s_b_via_a_inv_mc_a_mb_mnab_y_mpa_y_mpb_y_nand_m_y_tg_s_a_y r0 *1 0,0
Ccc_a_b_inv_q_a_inv_q_a_via_s_tg_fbs_b_tg_fbs_b_via_tg_s_b_tg_s_b_via_a_inv_mc_a_mb_mnab_y_mpa_y_mpb_y_nand_m_y_tg_s_a_y s mb 1.5323e-17
* device instance cc_a_b_inv_q_a_inv_q_a_via_s_tg_fbs_b_tg_fbs_b_via_tg_s_b_tg_s_b_via_a_mnab_y_mpa_y_mpb_y_nand_s2_y_qb_tg_fbs_a_y r0 *1 0,0
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
