2AMLogic/sky130-trng/layout/pex-ring/raw/ro_ring5_assembled_pex_wstv0p42.pex.spice

* extracted by klt extract --deck sky130
* parasitic model (--parasitics):
* - capacitance: net-to-ground for every net's own (non-coupled) area/perimeter, plus net-to-net for the vertical-overlap coupling `coupling` describes below -- a coupled net pair gets a direct capacitor between their two hub nodes, not just capacitors to the deck's ground/substrate net
* - coupling: vertical overlap (crossover) unconditionally -- where one net's conductor on an adjacent metal level sits directly over another *distinct* net's conductor, that overlap area is charged between the two nets instead of to ground (issue #760) -- plus lateral (same-layer, sidewall) coupling, but only for a net pair naming one of the caller's declared `--critical-net` nets (issue #976): facing-edge length within that layer's own minimum-spacing lookback is charged between the two nets, *additively* (not deducted from either net's substrate fringe term, unlike the vertical case -- a known simplification). Any same-layer pair with neither side named `--critical-net`, and fringe shielding in general, are still not modelled
* - resistance: single lumped series resistance per net, distributed as a star across that net's device terminals (issue #592) -- not a per-segment, distributed RC ladder, *unless* `--distributed-rc` names this net via `--critical-net` (issue #977, Epic #709 Phase 2b): then the net's terminals are ordered along their approximate physical spread and its total R/C is broken into a chain of per-segment resistors (segment length proportional to inter-terminal distance) with a ground capacitor at each terminal node (proportional to its adjacent segment length/2), instead of one star hub -- still an approximation (terminal position is a device-placement proxy, not true per-segment routing geometry), but a strictly finer-grained one than the single-hub star
* - frequency: quasi-static -- one frequency-independent R and C per net; no skin effect, no distributed transmission-line behavior
.GLOBAL vsubs

* cell ro_ring5
* pin a,g_a,ro,s4_y,y
* pin a,g_y,mnab_y,mpa_y,mpb_y,n1,s1_a,y
* pin a,n2,s1_y,s2_a,y
* pin a,n3,s2_y,s3_a,y
* pin a,n4,s3_y,s4_a,y
* pin en,g_en
* pin g_vddr_m1,mnt_g,s1_vddr_m1,s2_vddr_m1,s3_vddr_m1,s4_vddr_m1,vddr
* pin g_vss_m1,mph_g,s1_vss_m1,s2_vss_m1,s3_vss_m1,s4_vss_m1,vss
* pin mpa_py,mpb_py,mph_py,py
* pin ny
* pin ny
* pin ny
* pin ny
* pin ny
* pin py
* pin py
* pin py
* pin py
.SUBCKT ro_ring5 a|g_a|ro|s4_y|y a|g_y|mnab_y|mpa_y|mpb_y|n1|s1_a|y
+ a|n2|s1_y|s2_a|y a|n3|s2_y|s3_a|y a|n4|s3_y|s4_a|y en|g_en
+ g_vddr_m1|mnt_g|s1_vddr_m1|s2_vddr_m1|s3_vddr_m1|s4_vddr_m1|vddr
+ g_vss_m1|mph_g|s1_vss_m1|s2_vss_m1|s3_vss_m1|s4_vss_m1|vss
+ mpa_py|mpb_py|mph_py|py ny ny$1 ny$2 ny$3 ny$4 py py$1 py$2 py$3
* device instance $1 r0 *1 1.42,0.21 nfet
X$1 ny__t0 g_vddr_m1|mnt_g|s1_vddr_m1|s2_vddr_m1|s3_vddr_m1|s4_vddr_m1|vddr__t0
+ g_vss_m1|mph_g|s1_vss_m1|s2_vss_m1|s3_vss_m1|s4_vss_m1|vss__t0
+ g_vss_m1|mph_g|s1_vss_m1|s2_vss_m1|s3_vss_m1|s4_vss_m1|vss__t10
+ sky130_fd_pr__nfet_01v8 L=2 W=0.42 AS=0.1764 AD=0.1764 PS=1.68 PD=1.68
* device instance $2 r0 *1 10.72,0.21 nfet
X$2 ny__t12
+ g_vddr_m1|mnt_g|s1_vddr_m1|s2_vddr_m1|s3_vddr_m1|s4_vddr_m1|vddr__t20
+ g_vss_m1|mph_g|s1_vss_m1|s2_vss_m1|s3_vss_m1|s4_vss_m1|vss__t9
+ g_vss_m1|mph_g|s1_vss_m1|s2_vss_m1|s3_vss_m1|s4_vss_m1|vss__t11
+ sky130_fd_pr__nfet_01v8 L=2 W=0.42 AS=0.1764 AD=0.1764 PS=1.68 PD=1.68
* device instance $3 r0 *1 13.085,0.21 nfet
X$3 a|n2|s1_y|s2_a|y__t0 a|g_y|mnab_y|mpa_y|mpb_y|n1|s1_a|y__t0 ny__t02
+ g_vss_m1|mph_g|s1_vss_m1|s2_vss_m1|s3_vss_m1|s4_vss_m1|vss__t15
+ sky130_fd_pr__nfet_01v8 L=0.15 W=0.42 AS=0.1974 AD=0.1974 PS=1.78 PD=1.78
* device instance $4 r0 *1 18.895,0.21 nfet
X$4 ny__t13
+ g_vddr_m1|mnt_g|s1_vddr_m1|s2_vddr_m1|s3_vddr_m1|s4_vddr_m1|vddr__t19
+ g_vss_m1|mph_g|s1_vss_m1|s2_vss_m1|s3_vss_m1|s4_vss_m1|vss__t8
+ g_vss_m1|mph_g|s1_vss_m1|s2_vss_m1|s3_vss_m1|s4_vss_m1|vss__t12
+ sky130_fd_pr__nfet_01v8 L=2 W=0.42 AS=0.1764 AD=0.1764 PS=1.68 PD=1.68
* device instance $5 r0 *1 21.26,0.21 nfet
X$5 a|n3|s2_y|s3_a|y__t0 a|n2|s1_y|s2_a|y__t3 ny__t03
+ g_vss_m1|mph_g|s1_vss_m1|s2_vss_m1|s3_vss_m1|s4_vss_m1|vss__t16
+ sky130_fd_pr__nfet_01v8 L=0.15 W=0.42 AS=0.1974 AD=0.1974 PS=1.78 PD=1.78
* device instance $6 r0 *1 27.07,0.21 nfet
X$6 ny__t14
+ g_vddr_m1|mnt_g|s1_vddr_m1|s2_vddr_m1|s3_vddr_m1|s4_vddr_m1|vddr__t18
+ g_vss_m1|mph_g|s1_vss_m1|s2_vss_m1|s3_vss_m1|s4_vss_m1|vss__t7
+ g_vss_m1|mph_g|s1_vss_m1|s2_vss_m1|s3_vss_m1|s4_vss_m1|vss__t13
+ sky130_fd_pr__nfet_01v8 L=2 W=0.42 AS=0.1764 AD=0.1764 PS=1.68 PD=1.68
* device instance $7 r0 *1 29.435,0.21 nfet
X$7 a|n4|s3_y|s4_a|y__t0 a|n3|s2_y|s3_a|y__t3 ny__t04
+ g_vss_m1|mph_g|s1_vss_m1|s2_vss_m1|s3_vss_m1|s4_vss_m1|vss__t17
+ sky130_fd_pr__nfet_01v8 L=0.15 W=0.42 AS=0.1974 AD=0.1974 PS=1.78 PD=1.78
* device instance $8 r0 *1 35.245,0.21 nfet
X$8 ny__t15
+ g_vddr_m1|mnt_g|s1_vddr_m1|s2_vddr_m1|s3_vddr_m1|s4_vddr_m1|vddr__t17
+ g_vss_m1|mph_g|s1_vss_m1|s2_vss_m1|s3_vss_m1|s4_vss_m1|vss__t6
+ g_vss_m1|mph_g|s1_vss_m1|s2_vss_m1|s3_vss_m1|s4_vss_m1|vss__t14
+ sky130_fd_pr__nfet_01v8 L=2 W=0.42 AS=0.1764 AD=0.1764 PS=1.68 PD=1.68
* device instance $9 r0 *1 37.61,0.21 nfet
X$9 a|g_a|ro|s4_y|y__t1 a|n4|s3_y|s4_a|y__t3 ny__t05
+ g_vss_m1|mph_g|s1_vss_m1|s2_vss_m1|s3_vss_m1|s4_vss_m1|vss__t18
+ sky130_fd_pr__nfet_01v8 L=0.15 W=0.42 AS=0.1974 AD=0.1974 PS=1.78 PD=1.78
* device instance $10 r0 *1 3.785,0.21 nfet
X$10 \$6__t0 en|g_en__t0 ny__t1
+ g_vss_m1|mph_g|s1_vss_m1|s2_vss_m1|s3_vss_m1|s4_vss_m1|vss__t19
+ sky130_fd_pr__nfet_01v8 L=0.15 W=0.84 AS=0.3948 AD=0.2184 PS=2.62 PD=1.36
* device instance $11 r0 *1 4.455,0.21 nfet
X$11 a|g_y|mnab_y|mpa_y|mpb_y|n1|s1_a|y__t1 a|g_a|ro|s4_y|y__t0 \$6__t1
+ g_vss_m1|mph_g|s1_vss_m1|s2_vss_m1|s3_vss_m1|s4_vss_m1|vss__t20
+ sky130_fd_pr__nfet_01v8 L=0.15 W=0.84 AS=0.2184 AD=0.3948 PS=1.36 PD=2.62
* device instance $12 r0 *1 1.42,3.74 pfet
X$12 mpa_py|mpb_py|mph_py|py__t0
+ g_vss_m1|mph_g|s1_vss_m1|s2_vss_m1|s3_vss_m1|s4_vss_m1|vss__t1
+ g_vddr_m1|mnt_g|s1_vddr_m1|s2_vddr_m1|s3_vddr_m1|s4_vddr_m1|vddr__t1
+ g_vddr_m1|mnt_g|s1_vddr_m1|s2_vddr_m1|s3_vddr_m1|s4_vddr_m1|vddr__t2
+ sky130_fd_pr__pfet_01v8 L=2 W=0.42 AS=0.1764 AD=0.1764 PS=1.68 PD=1.68
* device instance $13 r0 *1 10.72,3.74 pfet
X$13 py__t0 g_vss_m1|mph_g|s1_vss_m1|s2_vss_m1|s3_vss_m1|s4_vss_m1|vss__t2
+ g_vddr_m1|mnt_g|s1_vddr_m1|s2_vddr_m1|s3_vddr_m1|s4_vddr_m1|vddr__t13
+ g_vddr_m1|mnt_g|s1_vddr_m1|s2_vddr_m1|s3_vddr_m1|s4_vddr_m1|vddr__t9
+ sky130_fd_pr__pfet_01v8 L=2 W=0.42 AS=0.1764 AD=0.1764 PS=1.68 PD=1.68
* device instance $14 r0 *1 18.895,3.74 pfet
X$14 py__t02 g_vss_m1|mph_g|s1_vss_m1|s2_vss_m1|s3_vss_m1|s4_vss_m1|vss__t3
+ g_vddr_m1|mnt_g|s1_vddr_m1|s2_vddr_m1|s3_vddr_m1|s4_vddr_m1|vddr__t14
+ g_vddr_m1|mnt_g|s1_vddr_m1|s2_vddr_m1|s3_vddr_m1|s4_vddr_m1|vddr__t10
+ sky130_fd_pr__pfet_01v8 L=2 W=0.42 AS=0.1764 AD=0.1764 PS=1.68 PD=1.68
* device instance $15 r0 *1 27.07,3.74 pfet
X$15 py__t03 g_vss_m1|mph_g|s1_vss_m1|s2_vss_m1|s3_vss_m1|s4_vss_m1|vss__t4
+ g_vddr_m1|mnt_g|s1_vddr_m1|s2_vddr_m1|s3_vddr_m1|s4_vddr_m1|vddr__t15
+ g_vddr_m1|mnt_g|s1_vddr_m1|s2_vddr_m1|s3_vddr_m1|s4_vddr_m1|vddr__t11
+ sky130_fd_pr__pfet_01v8 L=2 W=0.42 AS=0.1764 AD=0.1764 PS=1.68 PD=1.68
* device instance $16 r0 *1 35.245,3.74 pfet
X$16 py__t04 g_vss_m1|mph_g|s1_vss_m1|s2_vss_m1|s3_vss_m1|s4_vss_m1|vss__t5
+ g_vddr_m1|mnt_g|s1_vddr_m1|s2_vddr_m1|s3_vddr_m1|s4_vddr_m1|vddr__t16
+ g_vddr_m1|mnt_g|s1_vddr_m1|s2_vddr_m1|s3_vddr_m1|s4_vddr_m1|vddr__t12
+ sky130_fd_pr__pfet_01v8 L=2 W=0.42 AS=0.1764 AD=0.1764 PS=1.68 PD=1.68
* device instance $17 r0 *1 3.585,3.74 pfet
X$17 a|g_y|mnab_y|mpa_y|mpb_y|n1|s1_a|y__t2 en|g_en__t1
+ mpa_py|mpb_py|mph_py|py__t1
+ g_vddr_m1|mnt_g|s1_vddr_m1|s2_vddr_m1|s3_vddr_m1|s4_vddr_m1|vddr__t3
+ sky130_fd_pr__pfet_01v8 L=0.15 W=0.84 AS=0.3948 AD=0.3948 PS=2.62 PD=2.62
* device instance $18 r0 *1 4.875,3.74 pfet
X$18 mpa_py|mpb_py|mph_py|py__t2 a|g_a|ro|s4_y|y__t2
+ a|g_y|mnab_y|mpa_y|mpb_y|n1|s1_a|y__t3
+ g_vddr_m1|mnt_g|s1_vddr_m1|s2_vddr_m1|s3_vddr_m1|s4_vddr_m1|vddr__t8
+ sky130_fd_pr__pfet_01v8 L=0.15 W=0.84 AS=0.3948 AD=0.3948 PS=2.62 PD=2.62
* device instance $19 r0 *1 12.885,3.74 pfet
X$19 a|n2|s1_y|s2_a|y__t2 a|g_y|mnab_y|mpa_y|mpb_y|n1|s1_a|y__t4 py__t1
+ g_vddr_m1|mnt_g|s1_vddr_m1|s2_vddr_m1|s3_vddr_m1|s4_vddr_m1|vddr__t7
+ sky130_fd_pr__pfet_01v8 L=0.15 W=0.84 AS=0.3948 AD=0.3948 PS=2.62 PD=2.62
* device instance $20 r0 *1 21.06,3.74 pfet
X$20 a|n3|s2_y|s3_a|y__t2 a|n2|s1_y|s2_a|y__t1 py__t12
+ g_vddr_m1|mnt_g|s1_vddr_m1|s2_vddr_m1|s3_vddr_m1|s4_vddr_m1|vddr__t6
+ sky130_fd_pr__pfet_01v8 L=0.15 W=0.84 AS=0.3948 AD=0.3948 PS=2.62 PD=2.62
* device instance $21 r0 *1 29.235,3.74 pfet
X$21 a|n4|s3_y|s4_a|y__t2 a|n3|s2_y|s3_a|y__t1 py__t13
+ g_vddr_m1|mnt_g|s1_vddr_m1|s2_vddr_m1|s3_vddr_m1|s4_vddr_m1|vddr__t5
+ sky130_fd_pr__pfet_01v8 L=0.15 W=0.84 AS=0.3948 AD=0.3948 PS=2.62 PD=2.62
* device instance $22 r0 *1 37.41,3.74 pfet
X$22 a|g_a|ro|s4_y|y__t3 a|n4|s3_y|s4_a|y__t1 py__t14
+ g_vddr_m1|mnt_g|s1_vddr_m1|s2_vddr_m1|s3_vddr_m1|s4_vddr_m1|vddr__t4
+ sky130_fd_pr__pfet_01v8 L=0.15 W=0.84 AS=0.3948 AD=0.3948 PS=2.62 PD=2.62
* device instance _6_t0 r0 *1 0,0 
R_6_t0 \$6__t0 \$6 12.8
* device instance _6_t1 r0 *1 0,0 
R_6_t1 \$6__t1 \$6 12.8
* device instance _6 r0 *1 0,0 
C_6 \$6 vsubs 1.15618e-16
* device instance a_g_a_ro_s4_y_y_t0 r0 *1 0,0 
Ra_g_a_ro_s4_y_y_t0 a|g_a|ro|s4_y|y__t0 a|g_a|ro|s4_y|y 199.905310752
* device instance a_g_a_ro_s4_y_y_t1 r0 *1 0,0 
Ra_g_a_ro_s4_y_y_t1 a|g_a|ro|s4_y|y__t1 a|g_a|ro|s4_y|y 198.597996013
* device instance a_g_a_ro_s4_y_y_t2 r0 *1 0,0 
Ra_g_a_ro_s4_y_y_t2 a|g_a|ro|s4_y|y__t2 a|g_a|ro|s4_y|y 194.914280155
* device instance a_g_a_ro_s4_y_y_t3 r0 *1 0,0 
Ra_g_a_ro_s4_y_y_t3 a|g_a|ro|s4_y|y__t3 a|g_a|ro|s4_y|y 196.22131308
* device instance a_g_a_ro_s4_y_y r0 *1 0,0 
Ca_g_a_ro_s4_y_y a|g_a|ro|s4_y|y vsubs 4.73908e-15
* device instance a_g_y_mnab_y_mpa_y_mpb_y_n1_s1_a_y_t0 r0 *1 0,0 
Ra_g_y_mnab_y_mpa_y_mpb_y_n1_s1_a_y_t0 a|g_y|mnab_y|mpa_y|mpb_y|n1|s1_a|y__t0
+ a|g_y|mnab_y|mpa_y|mpb_y|n1|s1_a|y 107.491339147
* device instance a_g_y_mnab_y_mpa_y_mpb_y_n1_s1_a_y_t1 r0 *1 0,0 
Ra_g_y_mnab_y_mpa_y_mpb_y_n1_s1_a_y_t1 a|g_y|mnab_y|mpa_y|mpb_y|n1|s1_a|y__t1
+ a|g_y|mnab_y|mpa_y|mpb_y|n1|s1_a|y 74.101756002
* device instance a_g_y_mnab_y_mpa_y_mpb_y_n1_s1_a_y_t2 r0 *1 0,0 
Ra_g_y_mnab_y_mpa_y_mpb_y_n1_s1_a_y_t2 a|g_y|mnab_y|mpa_y|mpb_y|n1|s1_a|y__t2
+ a|g_y|mnab_y|mpa_y|mpb_y|n1|s1_a|y 83.1989635875
* device instance a_g_y_mnab_y_mpa_y_mpb_y_n1_s1_a_y_t3 r0 *1 0,0 
Ra_g_y_mnab_y_mpa_y_mpb_y_n1_s1_a_y_t3 a|g_y|mnab_y|mpa_y|mpb_y|n1|s1_a|y__t3
+ a|g_y|mnab_y|mpa_y|mpb_y|n1|s1_a|y 60.7011664601
* device instance a_g_y_mnab_y_mpa_y_mpb_y_n1_s1_a_y_t4 r0 *1 0,0 
Ra_g_y_mnab_y_mpa_y_mpb_y_n1_s1_a_y_t4 a|g_y|mnab_y|mpa_y|mpb_y|n1|s1_a|y__t4
+ a|g_y|mnab_y|mpa_y|mpb_y|n1|s1_a|y 99.6782748034
* device instance a_g_y_mnab_y_mpa_y_mpb_y_n1_s1_a_y r0 *1 0,0 
Ca_g_y_mnab_y_mpa_y_mpb_y_n1_s1_a_y a|g_y|mnab_y|mpa_y|mpb_y|n1|s1_a|y vsubs
+ 2.632209e-15
* device instance a_n2_s1_y_s2_a_y_t0 r0 *1 0,0 
Ra_n2_s1_y_s2_a_y_t0 a|n2|s1_y|s2_a|y__t0 a|n2|s1_y|s2_a|y 184.787796322
* device instance a_n2_s1_y_s2_a_y_t1 r0 *1 0,0 
Ra_n2_s1_y_s2_a_y_t1 a|n2|s1_y|s2_a|y__t1 a|n2|s1_y|s2_a|y 184.787796322
* device instance a_n2_s1_y_s2_a_y_t2 r0 *1 0,0 
Ra_n2_s1_y_s2_a_y_t2 a|n2|s1_y|s2_a|y__t2 a|n2|s1_y|s2_a|y 192.568303678
* device instance a_n2_s1_y_s2_a_y_t3 r0 *1 0,0 
Ra_n2_s1_y_s2_a_y_t3 a|n2|s1_y|s2_a|y__t3 a|n2|s1_y|s2_a|y 192.568303678
* device instance a_n2_s1_y_s2_a_y r0 *1 0,0 
Ca_n2_s1_y_s2_a_y a|n2|s1_y|s2_a|y vsubs 2.529995e-15
* device instance a_n3_s2_y_s3_a_y_t0 r0 *1 0,0 
Ra_n3_s2_y_s3_a_y_t0 a|n3|s2_y|s3_a|y__t0 a|n3|s2_y|s3_a|y 184.787796322
* device instance a_n3_s2_y_s3_a_y_t1 r0 *1 0,0 
Ra_n3_s2_y_s3_a_y_t1 a|n3|s2_y|s3_a|y__t1 a|n3|s2_y|s3_a|y 184.787796322
* device instance a_n3_s2_y_s3_a_y_t2 r0 *1 0,0 
Ra_n3_s2_y_s3_a_y_t2 a|n3|s2_y|s3_a|y__t2 a|n3|s2_y|s3_a|y 192.568303678
* device instance a_n3_s2_y_s3_a_y_t3 r0 *1 0,0 
Ra_n3_s2_y_s3_a_y_t3 a|n3|s2_y|s3_a|y__t3 a|n3|s2_y|s3_a|y 192.568303678
* device instance a_n3_s2_y_s3_a_y r0 *1 0,0 
Ca_n3_s2_y_s3_a_y a|n3|s2_y|s3_a|y vsubs 2.529995e-15
* device instance a_n4_s3_y_s4_a_y_t0 r0 *1 0,0 
Ra_n4_s3_y_s4_a_y_t0 a|n4|s3_y|s4_a|y__t0 a|n4|s3_y|s4_a|y 184.787796322
* device instance a_n4_s3_y_s4_a_y_t1 r0 *1 0,0 
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
+ g_vss_m1|mph_g|s1_vss_m1|s2_vss_m1|s3_vss_m1|s4_vss_m1|vss__t18
+ g_vss_m1|mph_g|s1_vss_m1|s2_vss_m1|s3_vss_m1|s4_vss_m1|vss 131.712565134
* device instance g_vss_m1_mph_g_s1_vss_m1_s2_vss_m1_s3_vss_m1_s4_vss_m1_vss_t19 r0 *1 0,0 
Rg_vss_m1_mph_g_s1_vss_m1_s2_vss_m1_s3_vss_m1_s4_vss_m1_vss_t19
+ g_vss_m1|mph_g|s1_vss_m1|s2_vss_m1|s3_vss_m1|s4_vss_m1|vss__t19
+ g_vss_m1|mph_g|s1_vss_m1|s2_vss_m1|s3_vss_m1|s4_vss_m1|vss 102.174066353
* device instance g_vss_m1_mph_g_s1_vss_m1_s2_vss_m1_s3_vss_m1_s4_vss_m1_vss_t20 r0 *1 0,0 
Rg_vss_m1_mph_g_s1_vss_m1_s2_vss_m1_s3_vss_m1_s4_vss_m1_vss_t20
+ g_vss_m1|mph_g|s1_vss_m1|s2_vss_m1|s3_vss_m1|s4_vss_m1|vss__t20
+ g_vss_m1|mph_g|s1_vss_m1|s2_vss_m1|s3_vss_m1|s4_vss_m1|vss 97.5549074724
* device instance g_vss_m1_mph_g_s1_vss_m1_s2_vss_m1_s3_vss_m1_s4_vss_m1_vss r0 *1 0,0 
Cg_vss_m1_mph_g_s1_vss_m1_s2_vss_m1_s3_vss_m1_s4_vss_m1_vss
+ g_vss_m1|mph_g|s1_vss_m1|s2_vss_m1|s3_vss_m1|s4_vss_m1|vss vsubs 1.1753189e-14
* device instance mpa_py_mpb_py_mph_py_py_t0 r0 *1 0,0 
Rmpa_py_mpb_py_mph_py_py_t0 mpa_py|mpb_py|mph_py|py__t0 mpa_py|mpb_py|mph_py|py
+ 33.64835
* device instance mpa_py_mpb_py_mph_py_py_t1 r0 *1 0,0 
Rmpa_py_mpb_py_mph_py_py_t1 mpa_py|mpb_py|mph_py|py__t1 mpa_py|mpb_py|mph_py|py
+ 5.23884452847
* device instance mpa_py_mpb_py_mph_py_py_t2 r0 *1 0,0 
Rmpa_py_mpb_py_mph_py_py_t2 mpa_py|mpb_py|mph_py|py__t2 mpa_py|mpb_py|mph_py|py
+ 28.4095054715
* device instance mpa_py_mpb_py_mph_py_py r0 *1 0,0 
Cmpa_py_mpb_py_mph_py_py mpa_py|mpb_py|mph_py|py vsubs 7.94002e-16
* device instance ny_t0 r0 *1 0,0 
Rny_t0 ny__t0 ny 44.45845
* device instance ny_t1 r0 *1 0,0 
Rny_t1 ny__t1 ny 44.45845
* device instance ny r0 *1 0,0 
Cny ny vsubs 2.11758e-16
* device instance ny_dup1_t0 r0 *1 0,0 
Rny_dup1_t0 ny__t02 ny$1 41.7022
* device instance ny_dup1_t1 r0 *1 0,0 
Rny_dup1_t1 ny__t12 ny$1 41.7022
* device instance ny_dup1 r0 *1 0,0 
Cny_dup1 ny$1 vsubs 1.70111e-16
* device instance ny_dup2_t0 r0 *1 0,0 
Rny_dup2_t0 ny__t03 ny$2 41.7022
* device instance ny_dup2_t1 r0 *1 0,0 
Rny_dup2_t1 ny__t13 ny$2 41.7022
* device instance ny_dup2 r0 *1 0,0 
Cny_dup2 ny$2 vsubs 1.70111e-16
* device instance ny_dup3_t0 r0 *1 0,0 
Rny_dup3_t0 ny__t04 ny$3 41.7022
* device instance ny_dup3_t1 r0 *1 0,0 
Rny_dup3_t1 ny__t14 ny$3 41.7022
* device instance ny_dup3 r0 *1 0,0 
Cny_dup3 ny$3 vsubs 1.70111e-16
* device instance ny_dup4_t0 r0 *1 0,0 
Rny_dup4_t0 ny__t05 ny$4 41.7022
* device instance ny_dup4_t1 r0 *1 0,0 
Rny_dup4_t1 ny__t15 ny$4 41.7022
* device instance ny_dup4 r0 *1 0,0 
Cny_dup4 ny$4 vsubs 1.70111e-16
* device instance py_t0 r0 *1 0,0 
Rpy_t0 py__t0 py 37.6683
* device instance py_t1 r0 *1 0,0 
Rpy_t1 py__t1 py 37.6683
* device instance py r0 *1 0,0 
Cpy py vsubs 1.9321e-16
* device instance py_dup1_t0 r0 *1 0,0 
Rpy_dup1_t0 py__t02 py$1 37.6683
* device instance py_dup1_t1 r0 *1 0,0 
Rpy_dup1_t1 py__t12 py$1 37.6683
* device instance py_dup1 r0 *1 0,0 
Cpy_dup1 py$1 vsubs 1.9321e-16
* device instance py_dup2_t0 r0 *1 0,0 
Rpy_dup2_t0 py__t03 py$2 37.6683
* device instance py_dup2_t1 r0 *1 0,0 
Rpy_dup2_t1 py__t13 py$2 37.6683
* device instance py_dup2 r0 *1 0,0 
Cpy_dup2 py$2 vsubs 1.9321e-16
* device instance py_dup3_t0 r0 *1 0,0 
Rpy_dup3_t0 py__t04 py$3 37.6683
* device instance py_dup3_t1 r0 *1 0,0 
Rpy_dup3_t1 py__t14 py$3 37.6683
* device instance py_dup3 r0 *1 0,0 
Cpy_dup3 py$3 vsubs 1.9321e-16
* device instance cc_a_g_a_ro_s4_y_y_a_g_y_mnab_y_mpa_y_mpb_y_n1_s1_a_y r0 *1 0,0 
Ccc_a_g_a_ro_s4_y_y_a_g_y_mnab_y_mpa_y_mpb_y_n1_s1_a_y a|g_a|ro|s4_y|y
+ a|g_y|mnab_y|mpa_y|mpb_y|n1|s1_a|y 1.5977e-17
* device instance cc_a_g_a_ro_s4_y_y_g_vddr_m1_mnt_g_s1_vddr_m1_s2_vddr_m1_s3_vddr_m1_s4_vddr_m1_vddr r0 *1 0,0 
Ccc_a_g_a_ro_s4_y_y_g_vddr_m1_mnt_g_s1_vddr_m1_s2_vddr_m1_s3_vddr_m1_s4_vddr_m1_vddr
+ a|g_a|ro|s4_y|y
+ g_vddr_m1|mnt_g|s1_vddr_m1|s2_vddr_m1|s3_vddr_m1|s4_vddr_m1|vddr 1.5474e-17
* device instance cc_a_g_y_mnab_y_mpa_y_mpb_y_n1_s1_a_y_g_vss_m1_mph_g_s1_vss_m1_s2_vss_m1_s3_vss_m1_s4_vss_m1_vss r0 *1 0,0 
Ccc_a_g_y_mnab_y_mpa_y_mpb_y_n1_s1_a_y_g_vss_m1_mph_g_s1_vss_m1_s2_vss_m1_s3_vss_m1_s4_vss_m1_vss
+ a|g_y|mnab_y|mpa_y|mpb_y|n1|s1_a|y
+ g_vss_m1|mph_g|s1_vss_m1|s2_vss_m1|s3_vss_m1|s4_vss_m1|vss 3.869e-18
* device instance cc_a_g_y_mnab_y_mpa_y_mpb_y_n1_s1_a_y_ny r0 *1 0,0 
Ccc_a_g_y_mnab_y_mpa_y_mpb_y_n1_s1_a_y_ny a|g_y|mnab_y|mpa_y|mpb_y|n1|s1_a|y
+ ny$4 2.878e-18
* device instance cc_a_n2_s1_y_s2_a_y_g_vss_m1_mph_g_s1_vss_m1_s2_vss_m1_s3_vss_m1_s4_vss_m1_vss r0 *1 0,0 
Ccc_a_n2_s1_y_s2_a_y_g_vss_m1_mph_g_s1_vss_m1_s2_vss_m1_s3_vss_m1_s4_vss_m1_vss
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
