2AMLogic/sky130-trng/layout/pex-sampler-dff-assembled/raw/sampler_dff_assembled_pex.pex.spice

* extracted by klt extract --deck sky130
* parasitic model (--parasitics):
* - capacitance: net-to-ground for every net's own (non-coupled) area/perimeter, plus net-to-net for the vertical-overlap coupling `coupling` describes below -- a coupled net pair gets a direct capacitor between their two hub nodes, not just capacitors to the deck's ground/substrate net
* - coupling: vertical overlap (crossover) unconditionally -- where one net's conductor on an adjacent metal level sits directly over another *distinct* net's conductor, that overlap area is charged between the two nets instead of to ground (issue #760) -- plus lateral (same-layer, sidewall) coupling, but only for a net pair naming one of the caller's declared `--critical-net` nets (issue #976): facing-edge length within that layer's own minimum-spacing lookback is charged between the two nets, *additively* (not deducted from either net's substrate fringe term, unlike the vertical case -- a known simplification). Any same-layer pair with neither side named `--critical-net`, and fringe shielding in general, are still not modelled
* - resistance: single lumped series resistance per net, distributed as a star across that net's device terminals (issue #592) -- not a per-segment, distributed RC ladder, *unless* `--distributed-rc` names this net via `--critical-net` (issue #977, Epic #709 Phase 2b): then the net's terminals are ordered along their approximate physical spread and its total R/C is broken into a chain of per-segment resistors (segment length proportional to inter-terminal distance) with a ground capacitor at each terminal node (proportional to its adjacent segment length/2), instead of one star hub -- still an approximation (terminal position is a device-placement proxy, not true per-segment routing geometry), but a strictly finer-grained one than the single-hub star
* - frequency: quasi-static -- one frequency-independent R and C per net; no skin effect, no distributed transmission-line behavior
.GLOBAL vsubs

* cell sampler_dff
* pin a,b,inv_q_a,inv_q_a_via,s,tg_fbs_b,tg_fbs_b_via,tg_s_b,tg_s_b_via
* pin a,b,m_east,m_west,nand_m_a,nand_m_a_ext_via,nand_m_a_ext_via2,nand_m_a_stub,tg_d_b,tg_d_b_via,tg_d_b_via2,tg_fbm_b,tg_fbm_b_alt_via,tg_fbm_b_alt_via2
* pin a,clk,ctrl,ctrlb,inv_clk_a,inv_clk_clk_via,tg_d_ctrl,tg_d_ctrl_via,tg_fbm_ctrlb,tg_fbm_ctrlb_via,tg_fbs_ctrl,tg_fbs_ctrl_via,tg_s_ctrlb,tg_s_ctrlb_via
* pin a,d,tg_d_a
* pin a,inv_mc_a,mb,mnab_y,mpa_y,mpb_y,nand_m_y,tg_s_a,y
* pin a,inv_mc_y,inv_mc_y_via,mc,tg_fbm_a,tg_fbm_a_via,y
* pin a,inv_q_y,inv_q_y_via,inv_q_y_via2,nand_s2_a,nand_s2_a_stub,nand_s2_a_via,nand_s2_a_via2,q,y
* pin a,mnab_y,mpa_y,mpb_y,nand_s2_y,qb,tg_fbs_a,y
* pin clkb,clkb_bridge1,clkb_bridge2,clkb_mid,clkb_w,ctrl,ctrlb,inv_clk_y,tg_d_ctrlb,tg_fbm_ctrl,tg_fbs_ctrlb,tg_s_ctrl,y
* pin en,nand_m_en,nand_m_en_via,nand_s2_en,nand_s2_en_via,rst_n
* pin inv_clk_vdd,inv_mc_vdd,inv_q_vdd,mpa_py,mpb_py,nand_m_vdd,nand_s2_vdd,nwell_vdd,tg_d_vdd,tg_fbm_vdd,tg_fbs_vdd,tg_s_vdd,vdd
* pin inv_clk_vss,inv_mc_vss,inv_q_vss,nand_m_vss,nand_s2_vss,tg_d_vss,tg_fbm_vss,tg_fbs_vss,tg_s_vss,vss
.SUBCKT sampler_dff
+ a|b|inv_q_a|inv_q_a_via|s|tg_fbs_b|tg_fbs_b_via|tg_s_b|tg_s_b_via
+ a|b|m_east|m_west|nand_m_a|nand_m_a_ext_via|nand_m_a_ext_via2|nand_m_a_stub|tg_d_b|tg_d_b_via|tg_d_b_via2|tg_fbm_b|tg_fbm_b_alt_via|tg_fbm_b_alt_via2
+ a|clk|ctrl|ctrlb|inv_clk_a|inv_clk_clk_via|tg_d_ctrl|tg_d_ctrl_via|tg_fbm_ctrlb|tg_fbm_ctrlb_via|tg_fbs_ctrl|tg_fbs_ctrl_via|tg_s_ctrlb|tg_s_ctrlb_via
+ a|d|tg_d_a a|inv_mc_a|mb|mnab_y|mpa_y|mpb_y|nand_m_y|tg_s_a|y
+ a|inv_mc_y|inv_mc_y_via|mc|tg_fbm_a|tg_fbm_a_via|y
+ a|inv_q_y|inv_q_y_via|inv_q_y_via2|nand_s2_a|nand_s2_a_stub|nand_s2_a_via|nand_s2_a_via2|q|y
+ a|mnab_y|mpa_y|mpb_y|nand_s2_y|qb|tg_fbs_a|y
+ clkb|clkb_bridge1|clkb_bridge2|clkb_mid|clkb_w|ctrl|ctrlb|inv_clk_y|tg_d_ctrlb|tg_fbm_ctrl|tg_fbs_ctrlb|tg_s_ctrl|y
+ en|nand_m_en|nand_m_en_via|nand_s2_en|nand_s2_en_via|rst_n
+ inv_clk_vdd|inv_mc_vdd|inv_q_vdd|mpa_py|mpb_py|nand_m_vdd|nand_s2_vdd|nwell_vdd|tg_d_vdd|tg_fbm_vdd|tg_fbs_vdd|tg_s_vdd|vdd
+ inv_clk_vss|inv_mc_vss|inv_q_vss|nand_m_vss|nand_s2_vss|tg_d_vss|tg_fbm_vss|tg_fbs_vss|tg_s_vss|vss
* device instance $1 r0 *1 0.545,0.21 nfet
X$1
+ clkb|clkb_bridge1|clkb_bridge2|clkb_mid|clkb_w|ctrl|ctrlb|inv_clk_y|tg_d_ctrlb|tg_fbm_ctrl|tg_fbs_ctrlb|tg_s_ctrl|y__t1
+ a|clk|ctrl|ctrlb|inv_clk_a|inv_clk_clk_via|tg_d_ctrl|tg_d_ctrl_via|tg_fbm_ctrlb|tg_fbm_ctrlb_via|tg_fbs_ctrl|tg_fbs_ctrl_via|tg_s_ctrlb|tg_s_ctrlb_via__t4
+ inv_clk_vss|inv_mc_vss|inv_q_vss|nand_m_vss|nand_s2_vss|tg_d_vss|tg_fbm_vss|tg_fbs_vss|tg_s_vss|vss__t0
+ inv_clk_vss|inv_mc_vss|inv_q_vss|nand_m_vss|nand_s2_vss|tg_d_vss|tg_fbm_vss|tg_fbs_vss|tg_s_vss|vss__t5
+ sky130_fd_pr__nfet_01v8 L=0.15 W=0.42 AS=0.1974 AD=0.1974 PS=1.78 PD=1.78
* device instance $2 r0 *1 5.31,0.21 nfet
X$2 a|d|tg_d_a__t1
+ clkb|clkb_bridge1|clkb_bridge2|clkb_mid|clkb_w|ctrl|ctrlb|inv_clk_y|tg_d_ctrlb|tg_fbm_ctrl|tg_fbs_ctrlb|tg_s_ctrl|y__t5
+ a|b|m_east|m_west|nand_m_a|nand_m_a_ext_via|nand_m_a_ext_via2|nand_m_a_stub|tg_d_b|tg_d_b_via|tg_d_b_via2|tg_fbm_b|tg_fbm_b_alt_via|tg_fbm_b_alt_via2__t5
+ inv_clk_vss|inv_mc_vss|inv_q_vss|nand_m_vss|nand_s2_vss|tg_d_vss|tg_fbm_vss|tg_fbs_vss|tg_s_vss|vss__t6
+ sky130_fd_pr__nfet_01v8 L=0.15 W=0.42 AS=0.1974 AD=0.1974 PS=1.78 PD=1.78
* device instance $3 r0 *1 19.835,0.21 nfet
X$3 a|inv_mc_y|inv_mc_y_via|mc|tg_fbm_a|tg_fbm_a_via|y__t3
+ a|inv_mc_a|mb|mnab_y|mpa_y|mpb_y|nand_m_y|tg_s_a|y__t6
+ inv_clk_vss|inv_mc_vss|inv_q_vss|nand_m_vss|nand_s2_vss|tg_d_vss|tg_fbm_vss|tg_fbs_vss|tg_s_vss|vss__t4
+ inv_clk_vss|inv_mc_vss|inv_q_vss|nand_m_vss|nand_s2_vss|tg_d_vss|tg_fbm_vss|tg_fbs_vss|tg_s_vss|vss__t7
+ sky130_fd_pr__nfet_01v8 L=0.15 W=0.42 AS=0.1974 AD=0.1974 PS=1.78 PD=1.78
* device instance $4 r0 *1 24.6,0.21 nfet
X$4 a|inv_mc_y|inv_mc_y_via|mc|tg_fbm_a|tg_fbm_a_via|y__t2
+ a|clk|ctrl|ctrlb|inv_clk_a|inv_clk_clk_via|tg_d_ctrl|tg_d_ctrl_via|tg_fbm_ctrlb|tg_fbm_ctrlb_via|tg_fbs_ctrl|tg_fbs_ctrl_via|tg_s_ctrlb|tg_s_ctrlb_via__t5
+ a|b|m_east|m_west|nand_m_a|nand_m_a_ext_via|nand_m_a_ext_via2|nand_m_a_stub|tg_d_b|tg_d_b_via|tg_d_b_via2|tg_fbm_b|tg_fbm_b_alt_via|tg_fbm_b_alt_via2__t4
+ inv_clk_vss|inv_mc_vss|inv_q_vss|nand_m_vss|nand_s2_vss|tg_d_vss|tg_fbm_vss|tg_fbs_vss|tg_s_vss|vss__t8
+ sky130_fd_pr__nfet_01v8 L=0.15 W=0.42 AS=0.1974 AD=0.1974 PS=1.78 PD=1.78
* device instance $5 r0 *1 29.74,0.21 nfet
X$5 a|inv_mc_a|mb|mnab_y|mpa_y|mpb_y|nand_m_y|tg_s_a|y__t0
+ a|clk|ctrl|ctrlb|inv_clk_a|inv_clk_clk_via|tg_d_ctrl|tg_d_ctrl_via|tg_fbm_ctrlb|tg_fbm_ctrlb_via|tg_fbs_ctrl|tg_fbs_ctrl_via|tg_s_ctrlb|tg_s_ctrlb_via__t0
+ a|b|inv_q_a|inv_q_a_via|s|tg_fbs_b|tg_fbs_b_via|tg_s_b|tg_s_b_via__t5
+ inv_clk_vss|inv_mc_vss|inv_q_vss|nand_m_vss|nand_s2_vss|tg_d_vss|tg_fbm_vss|tg_fbs_vss|tg_s_vss|vss__t9
+ sky130_fd_pr__nfet_01v8 L=0.15 W=0.42 AS=0.1974 AD=0.1974 PS=1.78 PD=1.78
* device instance $6 r0 *1 36.545,0.21 nfet
X$6
+ a|inv_q_y|inv_q_y_via|inv_q_y_via2|nand_s2_a|nand_s2_a_stub|nand_s2_a_via|nand_s2_a_via2|q|y__t2
+ a|b|inv_q_a|inv_q_a_via|s|tg_fbs_b|tg_fbs_b_via|tg_s_b|tg_s_b_via__t3
+ inv_clk_vss|inv_mc_vss|inv_q_vss|nand_m_vss|nand_s2_vss|tg_d_vss|tg_fbm_vss|tg_fbs_vss|tg_s_vss|vss__t3
+ inv_clk_vss|inv_mc_vss|inv_q_vss|nand_m_vss|nand_s2_vss|tg_d_vss|tg_fbm_vss|tg_fbs_vss|tg_s_vss|vss__t10
+ sky130_fd_pr__nfet_01v8 L=0.15 W=0.42 AS=0.1974 AD=0.1974 PS=1.78 PD=1.78
* device instance $7 r0 *1 49.03,0.21 nfet
X$7 a|mnab_y|mpa_y|mpb_y|nand_s2_y|qb|tg_fbs_a|y__t4
+ clkb|clkb_bridge1|clkb_bridge2|clkb_mid|clkb_w|ctrl|ctrlb|inv_clk_y|tg_d_ctrlb|tg_fbm_ctrl|tg_fbs_ctrlb|tg_s_ctrl|y__t4
+ a|b|inv_q_a|inv_q_a_via|s|tg_fbs_b|tg_fbs_b_via|tg_s_b|tg_s_b_via__t4
+ inv_clk_vss|inv_mc_vss|inv_q_vss|nand_m_vss|nand_s2_vss|tg_d_vss|tg_fbm_vss|tg_fbs_vss|tg_s_vss|vss__t11
+ sky130_fd_pr__nfet_01v8 L=0.15 W=0.42 AS=0.1974 AD=0.1974 PS=1.78 PD=1.78
* device instance $8 r0 *1 12.315,0.21 nfet
X$8 \$7__t0 en|nand_m_en|nand_m_en_via|nand_s2_en|nand_s2_en_via|rst_n__t0
+ inv_clk_vss|inv_mc_vss|inv_q_vss|nand_m_vss|nand_s2_vss|tg_d_vss|tg_fbm_vss|tg_fbs_vss|tg_s_vss|vss__t1
+ inv_clk_vss|inv_mc_vss|inv_q_vss|nand_m_vss|nand_s2_vss|tg_d_vss|tg_fbm_vss|tg_fbs_vss|tg_s_vss|vss__t12
+ sky130_fd_pr__nfet_01v8 L=0.15 W=0.84 AS=0.3948 AD=0.2184 PS=2.62 PD=1.36
* device instance $9 r0 *1 12.985,0.21 nfet
X$9 a|inv_mc_a|mb|mnab_y|mpa_y|mpb_y|nand_m_y|tg_s_a|y__t1
+ a|b|m_east|m_west|nand_m_a|nand_m_a_ext_via|nand_m_a_ext_via2|nand_m_a_stub|tg_d_b|tg_d_b_via|tg_d_b_via2|tg_fbm_b|tg_fbm_b_alt_via|tg_fbm_b_alt_via2__t0
+ \$7__t1
+ inv_clk_vss|inv_mc_vss|inv_q_vss|nand_m_vss|nand_s2_vss|tg_d_vss|tg_fbm_vss|tg_fbs_vss|tg_s_vss|vss__t14
+ sky130_fd_pr__nfet_01v8 L=0.15 W=0.84 AS=0.2184 AD=0.3948 PS=1.36 PD=2.62
* device instance $10 r0 *1 43.175,0.21 nfet
X$10 \$11__t1 en|nand_m_en|nand_m_en_via|nand_s2_en|nand_s2_en_via|rst_n__t1
+ inv_clk_vss|inv_mc_vss|inv_q_vss|nand_m_vss|nand_s2_vss|tg_d_vss|tg_fbm_vss|tg_fbs_vss|tg_s_vss|vss__t2
+ inv_clk_vss|inv_mc_vss|inv_q_vss|nand_m_vss|nand_s2_vss|tg_d_vss|tg_fbm_vss|tg_fbs_vss|tg_s_vss|vss__t13
+ sky130_fd_pr__nfet_01v8 L=0.15 W=0.84 AS=0.3948 AD=0.2184 PS=2.62 PD=1.36
* device instance $11 r0 *1 43.845,0.21 nfet
X$11 a|mnab_y|mpa_y|mpb_y|nand_s2_y|qb|tg_fbs_a|y__t3
+ a|inv_q_y|inv_q_y_via|inv_q_y_via2|nand_s2_a|nand_s2_a_stub|nand_s2_a_via|nand_s2_a_via2|q|y__t0
+ \$11__t0
+ inv_clk_vss|inv_mc_vss|inv_q_vss|nand_m_vss|nand_s2_vss|tg_d_vss|tg_fbm_vss|tg_fbs_vss|tg_s_vss|vss__t15
+ sky130_fd_pr__nfet_01v8 L=0.15 W=0.84 AS=0.2184 AD=0.3948 PS=1.36 PD=2.62
* device instance $12 r0 *1 0.545,3.53 pfet
X$12
+ clkb|clkb_bridge1|clkb_bridge2|clkb_mid|clkb_w|ctrl|ctrlb|inv_clk_y|tg_d_ctrlb|tg_fbm_ctrl|tg_fbs_ctrlb|tg_s_ctrl|y__t0
+ a|clk|ctrl|ctrlb|inv_clk_a|inv_clk_clk_via|tg_d_ctrl|tg_d_ctrl_via|tg_fbm_ctrlb|tg_fbm_ctrlb_via|tg_fbs_ctrl|tg_fbs_ctrl_via|tg_s_ctrlb|tg_s_ctrlb_via__t2
+ inv_clk_vdd|inv_mc_vdd|inv_q_vdd|mpa_py|mpb_py|nand_m_vdd|nand_s2_vdd|nwell_vdd|tg_d_vdd|tg_fbm_vdd|tg_fbs_vdd|tg_s_vdd|vdd__t11
+ inv_clk_vdd|inv_mc_vdd|inv_q_vdd|mpa_py|mpb_py|nand_m_vdd|nand_s2_vdd|nwell_vdd|tg_d_vdd|tg_fbm_vdd|tg_fbs_vdd|tg_s_vdd|vdd__t0
+ sky130_fd_pr__pfet_01v8 L=0.15 W=0.84 AS=0.3948 AD=0.3948 PS=2.62 PD=2.62
* device instance $13 r0 *1 5.31,3.53 pfet
X$13 a|d|tg_d_a__t0
+ a|clk|ctrl|ctrlb|inv_clk_a|inv_clk_clk_via|tg_d_ctrl|tg_d_ctrl_via|tg_fbm_ctrlb|tg_fbm_ctrlb_via|tg_fbs_ctrl|tg_fbs_ctrl_via|tg_s_ctrlb|tg_s_ctrlb_via__t3
+ a|b|m_east|m_west|nand_m_a|nand_m_a_ext_via|nand_m_a_ext_via2|nand_m_a_stub|tg_d_b|tg_d_b_via|tg_d_b_via2|tg_fbm_b|tg_fbm_b_alt_via|tg_fbm_b_alt_via2__t1
+ inv_clk_vdd|inv_mc_vdd|inv_q_vdd|mpa_py|mpb_py|nand_m_vdd|nand_s2_vdd|nwell_vdd|tg_d_vdd|tg_fbm_vdd|tg_fbs_vdd|tg_s_vdd|vdd__t1
+ sky130_fd_pr__pfet_01v8 L=0.15 W=0.84 AS=0.3948 AD=0.3948 PS=2.62 PD=2.62
* device instance $14 r0 *1 19.835,3.53 pfet
X$14 a|inv_mc_y|inv_mc_y_via|mc|tg_fbm_a|tg_fbm_a_via|y__t0
+ a|inv_mc_a|mb|mnab_y|mpa_y|mpb_y|nand_m_y|tg_s_a|y__t5
+ inv_clk_vdd|inv_mc_vdd|inv_q_vdd|mpa_py|mpb_py|nand_m_vdd|nand_s2_vdd|nwell_vdd|tg_d_vdd|tg_fbm_vdd|tg_fbs_vdd|tg_s_vdd|vdd__t12
+ inv_clk_vdd|inv_mc_vdd|inv_q_vdd|mpa_py|mpb_py|nand_m_vdd|nand_s2_vdd|nwell_vdd|tg_d_vdd|tg_fbm_vdd|tg_fbs_vdd|tg_s_vdd|vdd__t2
+ sky130_fd_pr__pfet_01v8 L=0.15 W=0.84 AS=0.3948 AD=0.3948 PS=2.62 PD=2.62
* device instance $15 r0 *1 24.6,3.53 pfet
X$15 a|inv_mc_y|inv_mc_y_via|mc|tg_fbm_a|tg_fbm_a_via|y__t1
+ clkb|clkb_bridge1|clkb_bridge2|clkb_mid|clkb_w|ctrl|ctrlb|inv_clk_y|tg_d_ctrlb|tg_fbm_ctrl|tg_fbs_ctrlb|tg_s_ctrl|y__t2
+ a|b|m_east|m_west|nand_m_a|nand_m_a_ext_via|nand_m_a_ext_via2|nand_m_a_stub|tg_d_b|tg_d_b_via|tg_d_b_via2|tg_fbm_b|tg_fbm_b_alt_via|tg_fbm_b_alt_via2__t2
+ inv_clk_vdd|inv_mc_vdd|inv_q_vdd|mpa_py|mpb_py|nand_m_vdd|nand_s2_vdd|nwell_vdd|tg_d_vdd|tg_fbm_vdd|tg_fbs_vdd|tg_s_vdd|vdd__t3
+ sky130_fd_pr__pfet_01v8 L=0.15 W=0.84 AS=0.3948 AD=0.3948 PS=2.62 PD=2.62
* device instance $16 r0 *1 29.74,3.53 pfet
X$16 a|inv_mc_a|mb|mnab_y|mpa_y|mpb_y|nand_m_y|tg_s_a|y__t2
+ clkb|clkb_bridge1|clkb_bridge2|clkb_mid|clkb_w|ctrl|ctrlb|inv_clk_y|tg_d_ctrlb|tg_fbm_ctrl|tg_fbs_ctrlb|tg_s_ctrl|y__t3
+ a|b|inv_q_a|inv_q_a_via|s|tg_fbs_b|tg_fbs_b_via|tg_s_b|tg_s_b_via__t0
+ inv_clk_vdd|inv_mc_vdd|inv_q_vdd|mpa_py|mpb_py|nand_m_vdd|nand_s2_vdd|nwell_vdd|tg_d_vdd|tg_fbm_vdd|tg_fbs_vdd|tg_s_vdd|vdd__t4
+ sky130_fd_pr__pfet_01v8 L=0.15 W=0.84 AS=0.3948 AD=0.3948 PS=2.62 PD=2.62
* device instance $17 r0 *1 36.545,3.53 pfet
X$17
+ a|inv_q_y|inv_q_y_via|inv_q_y_via2|nand_s2_a|nand_s2_a_stub|nand_s2_a_via|nand_s2_a_via2|q|y__t1
+ a|b|inv_q_a|inv_q_a_via|s|tg_fbs_b|tg_fbs_b_via|tg_s_b|tg_s_b_via__t2
+ inv_clk_vdd|inv_mc_vdd|inv_q_vdd|mpa_py|mpb_py|nand_m_vdd|nand_s2_vdd|nwell_vdd|tg_d_vdd|tg_fbm_vdd|tg_fbs_vdd|tg_s_vdd|vdd__t13
+ inv_clk_vdd|inv_mc_vdd|inv_q_vdd|mpa_py|mpb_py|nand_m_vdd|nand_s2_vdd|nwell_vdd|tg_d_vdd|tg_fbm_vdd|tg_fbs_vdd|tg_s_vdd|vdd__t5
+ sky130_fd_pr__pfet_01v8 L=0.15 W=0.84 AS=0.3948 AD=0.3948 PS=2.62 PD=2.62
* device instance $18 r0 *1 49.03,3.53 pfet
X$18 a|mnab_y|mpa_y|mpb_y|nand_s2_y|qb|tg_fbs_a|y__t1
+ a|clk|ctrl|ctrlb|inv_clk_a|inv_clk_clk_via|tg_d_ctrl|tg_d_ctrl_via|tg_fbm_ctrlb|tg_fbm_ctrlb_via|tg_fbs_ctrl|tg_fbs_ctrl_via|tg_s_ctrlb|tg_s_ctrlb_via__t1
+ a|b|inv_q_a|inv_q_a_via|s|tg_fbs_b|tg_fbs_b_via|tg_s_b|tg_s_b_via__t1
+ inv_clk_vdd|inv_mc_vdd|inv_q_vdd|mpa_py|mpb_py|nand_m_vdd|nand_s2_vdd|nwell_vdd|tg_d_vdd|tg_fbm_vdd|tg_fbs_vdd|tg_s_vdd|vdd__t6
+ sky130_fd_pr__pfet_01v8 L=0.15 W=0.84 AS=0.3948 AD=0.3948 PS=2.62 PD=2.62
* device instance $19 r0 *1 12.115,3.74 pfet
X$19 a|inv_mc_a|mb|mnab_y|mpa_y|mpb_y|nand_m_y|tg_s_a|y__t4
+ en|nand_m_en|nand_m_en_via|nand_s2_en|nand_s2_en_via|rst_n__t2
+ inv_clk_vdd|inv_mc_vdd|inv_q_vdd|mpa_py|mpb_py|nand_m_vdd|nand_s2_vdd|nwell_vdd|tg_d_vdd|tg_fbm_vdd|tg_fbs_vdd|tg_s_vdd|vdd__t14
+ inv_clk_vdd|inv_mc_vdd|inv_q_vdd|mpa_py|mpb_py|nand_m_vdd|nand_s2_vdd|nwell_vdd|tg_d_vdd|tg_fbm_vdd|tg_fbs_vdd|tg_s_vdd|vdd__t7
+ sky130_fd_pr__pfet_01v8 L=0.15 W=0.84 AS=0.3948 AD=0.3948 PS=2.62 PD=2.62
* device instance $20 r0 *1 13.405,3.74 pfet
X$20
+ inv_clk_vdd|inv_mc_vdd|inv_q_vdd|mpa_py|mpb_py|nand_m_vdd|nand_s2_vdd|nwell_vdd|tg_d_vdd|tg_fbm_vdd|tg_fbs_vdd|tg_s_vdd|vdd__t16
+ a|b|m_east|m_west|nand_m_a|nand_m_a_ext_via|nand_m_a_ext_via2|nand_m_a_stub|tg_d_b|tg_d_b_via|tg_d_b_via2|tg_fbm_b|tg_fbm_b_alt_via|tg_fbm_b_alt_via2__t3
+ a|inv_mc_a|mb|mnab_y|mpa_y|mpb_y|nand_m_y|tg_s_a|y__t3
+ inv_clk_vdd|inv_mc_vdd|inv_q_vdd|mpa_py|mpb_py|nand_m_vdd|nand_s2_vdd|nwell_vdd|tg_d_vdd|tg_fbm_vdd|tg_fbs_vdd|tg_s_vdd|vdd__t8
+ sky130_fd_pr__pfet_01v8 L=0.15 W=0.84 AS=0.3948 AD=0.3948 PS=2.62 PD=2.62
* device instance $21 r0 *1 42.975,3.74 pfet
X$21 a|mnab_y|mpa_y|mpb_y|nand_s2_y|qb|tg_fbs_a|y__t2
+ en|nand_m_en|nand_m_en_via|nand_s2_en|nand_s2_en_via|rst_n__t3
+ inv_clk_vdd|inv_mc_vdd|inv_q_vdd|mpa_py|mpb_py|nand_m_vdd|nand_s2_vdd|nwell_vdd|tg_d_vdd|tg_fbm_vdd|tg_fbs_vdd|tg_s_vdd|vdd__t15
+ inv_clk_vdd|inv_mc_vdd|inv_q_vdd|mpa_py|mpb_py|nand_m_vdd|nand_s2_vdd|nwell_vdd|tg_d_vdd|tg_fbm_vdd|tg_fbs_vdd|tg_s_vdd|vdd__t9
+ sky130_fd_pr__pfet_01v8 L=0.15 W=0.84 AS=0.3948 AD=0.3948 PS=2.62 PD=2.62
* device instance $22 r0 *1 44.265,3.74 pfet
X$22
+ inv_clk_vdd|inv_mc_vdd|inv_q_vdd|mpa_py|mpb_py|nand_m_vdd|nand_s2_vdd|nwell_vdd|tg_d_vdd|tg_fbm_vdd|tg_fbs_vdd|tg_s_vdd|vdd__t17
+ a|inv_q_y|inv_q_y_via|inv_q_y_via2|nand_s2_a|nand_s2_a_stub|nand_s2_a_via|nand_s2_a_via2|q|y__t3
+ a|mnab_y|mpa_y|mpb_y|nand_s2_y|qb|tg_fbs_a|y__t0
+ inv_clk_vdd|inv_mc_vdd|inv_q_vdd|mpa_py|mpb_py|nand_m_vdd|nand_s2_vdd|nwell_vdd|tg_d_vdd|tg_fbm_vdd|tg_fbs_vdd|tg_s_vdd|vdd__t10
+ sky130_fd_pr__pfet_01v8 L=0.15 W=0.84 AS=0.3948 AD=0.3948 PS=2.62 PD=2.62
* device instance _11_t0 r0 *1 0,0 
R_11_t0 \$11__t0 \$11 12.8
* device instance _11_t1 r0 *1 0,0 
R_11_t1 \$11__t1 \$11 12.8
* device instance _11 r0 *1 0,0 
C_11 \$11 vsubs 1.15618e-16
* device instance _7_t0 r0 *1 0,0 
R_7_t0 \$7__t0 \$7 12.8
* device instance _7_t1 r0 *1 0,0 
R_7_t1 \$7__t1 \$7 12.8
* device instance _7 r0 *1 0,0 
C_7 \$7 vsubs 1.15618e-16
* device instance a_b_inv_q_a_inv_q_a_via_s_tg_fbs_b_tg_fbs_b_via_tg_s_b_tg_s_b_via_t0 r0 *1 0,0 
Ra_b_inv_q_a_inv_q_a_via_s_tg_fbs_b_tg_fbs_b_via_tg_s_b_tg_s_b_via_t0
+ a|b|inv_q_a|inv_q_a_via|s|tg_fbs_b|tg_fbs_b_via|tg_s_b|tg_s_b_via__t0
+ a|b|inv_q_a|inv_q_a_via|s|tg_fbs_b|tg_fbs_b_via|tg_s_b|tg_s_b_via
+ 204.040461511
* device instance a_b_inv_q_a_inv_q_a_via_s_tg_fbs_b_tg_fbs_b_via_tg_s_b_tg_s_b_via_t1 r0 *1 0,0 
Ra_b_inv_q_a_inv_q_a_via_s_tg_fbs_b_tg_fbs_b_via_tg_s_b_tg_s_b_via_t1
+ a|b|inv_q_a|inv_q_a_via|s|tg_fbs_b|tg_fbs_b_via|tg_s_b|tg_s_b_via__t1
+ a|b|inv_q_a|inv_q_a_via|s|tg_fbs_b|tg_fbs_b_via|tg_s_b|tg_s_b_via
+ 247.027895104
* device instance a_b_inv_q_a_inv_q_a_via_s_tg_fbs_b_tg_fbs_b_via_tg_s_b_tg_s_b_via_t2 r0 *1 0,0 
Ra_b_inv_q_a_inv_q_a_via_s_tg_fbs_b_tg_fbs_b_via_tg_s_b_tg_s_b_via_t2
+ a|b|inv_q_a|inv_q_a_via|s|tg_fbs_b|tg_fbs_b_via|tg_s_b|tg_s_b_via__t2
+ a|b|inv_q_a|inv_q_a_via|s|tg_fbs_b|tg_fbs_b_via|tg_s_b|tg_s_b_via
+ 58.0186433859
* device instance a_b_inv_q_a_inv_q_a_via_s_tg_fbs_b_tg_fbs_b_via_tg_s_b_tg_s_b_via_t3 r0 *1 0,0 
Ra_b_inv_q_a_inv_q_a_via_s_tg_fbs_b_tg_fbs_b_via_tg_s_b_tg_s_b_via_t3
+ a|b|inv_q_a|inv_q_a_via|s|tg_fbs_b|tg_fbs_b_via|tg_s_b|tg_s_b_via__t3
+ a|b|inv_q_a|inv_q_a_via|s|tg_fbs_b|tg_fbs_b_via|tg_s_b|tg_s_b_via
+ 58.0186433859
* device instance a_b_inv_q_a_inv_q_a_via_s_tg_fbs_b_tg_fbs_b_via_tg_s_b_tg_s_b_via_t4 r0 *1 0,0 
Ra_b_inv_q_a_inv_q_a_via_s_tg_fbs_b_tg_fbs_b_via_tg_s_b_tg_s_b_via_t4
+ a|b|inv_q_a|inv_q_a_via|s|tg_fbs_b|tg_fbs_b_via|tg_s_b|tg_s_b_via__t4
+ a|b|inv_q_a|inv_q_a_via|s|tg_fbs_b|tg_fbs_b_via|tg_s_b|tg_s_b_via
+ 247.027895104
* device instance a_b_inv_q_a_inv_q_a_via_s_tg_fbs_b_tg_fbs_b_via_tg_s_b_tg_s_b_via_t5 r0 *1 0,0 
Ra_b_inv_q_a_inv_q_a_via_s_tg_fbs_b_tg_fbs_b_via_tg_s_b_tg_s_b_via_t5
+ a|b|inv_q_a|inv_q_a_via|s|tg_fbs_b|tg_fbs_b_via|tg_s_b|tg_s_b_via__t5
+ a|b|inv_q_a|inv_q_a_via|s|tg_fbs_b|tg_fbs_b_via|tg_s_b|tg_s_b_via
+ 204.040461511
* device instance a_b_inv_q_a_inv_q_a_via_s_tg_fbs_b_tg_fbs_b_via_tg_s_b_tg_s_b_via r0 *1 0,0 
Ca_b_inv_q_a_inv_q_a_via_s_tg_fbs_b_tg_fbs_b_via_tg_s_b_tg_s_b_via
+ a|b|inv_q_a|inv_q_a_via|s|tg_fbs_b|tg_fbs_b_via|tg_s_b|tg_s_b_via vsubs
+ 3.84792e-15
* device instance a_b_m_east_m_west_nand_m_a_nand_m_a_ext_via_nand_m_a_ext_via2_nand_m_a_stub_tg_d_b_tg_d_b_via_tg_d_b_via2_tg_fbm_b_tg_fbm_b_alt_via_tg_fbm_b_alt_via2_t0 r0 *1 0,0 
Ra_b_m_east_m_west_nand_m_a_nand_m_a_ext_via_nand_m_a_ext_via2_nand_m_a_stub_tg_d_b_tg_d_b_via_tg_d_b_via2_tg_fbm_b_tg_fbm_b_alt_via_tg_fbm_b_alt_via2_t0
+ a|b|m_east|m_west|nand_m_a|nand_m_a_ext_via|nand_m_a_ext_via2|nand_m_a_stub|tg_d_b|tg_d_b_via|tg_d_b_via2|tg_fbm_b|tg_fbm_b_alt_via|tg_fbm_b_alt_via2__t0
+ a|b|m_east|m_west|nand_m_a|nand_m_a_ext_via|nand_m_a_ext_via2|nand_m_a_stub|tg_d_b|tg_d_b_via|tg_d_b_via2|tg_fbm_b|tg_fbm_b_alt_via|tg_fbm_b_alt_via2
+ 54.9450724763
* device instance a_b_m_east_m_west_nand_m_a_nand_m_a_ext_via_nand_m_a_ext_via2_nand_m_a_stub_tg_d_b_tg_d_b_via_tg_d_b_via2_tg_fbm_b_tg_fbm_b_alt_via_tg_fbm_b_alt_via2_t1 r0 *1 0,0 
Ra_b_m_east_m_west_nand_m_a_nand_m_a_ext_via_nand_m_a_ext_via2_nand_m_a_stub_tg_d_b_tg_d_b_via_tg_d_b_via2_tg_fbm_b_tg_fbm_b_alt_via_tg_fbm_b_alt_via2_t1
+ a|b|m_east|m_west|nand_m_a|nand_m_a_ext_via|nand_m_a_ext_via2|nand_m_a_stub|tg_d_b|tg_d_b_via|tg_d_b_via2|tg_fbm_b|tg_fbm_b_alt_via|tg_fbm_b_alt_via2__t1
+ a|b|m_east|m_west|nand_m_a|nand_m_a_ext_via|nand_m_a_ext_via2|nand_m_a_stub|tg_d_b|tg_d_b_via|tg_d_b_via2|tg_fbm_b|tg_fbm_b_alt_via|tg_fbm_b_alt_via2
+ 231.121281915
* device instance a_b_m_east_m_west_nand_m_a_nand_m_a_ext_via_nand_m_a_ext_via2_nand_m_a_stub_tg_d_b_tg_d_b_via_tg_d_b_via2_tg_fbm_b_tg_fbm_b_alt_via_tg_fbm_b_alt_via2_t2 r0 *1 0,0 
Ra_b_m_east_m_west_nand_m_a_nand_m_a_ext_via_nand_m_a_ext_via2_nand_m_a_stub_tg_d_b_tg_d_b_via_tg_d_b_via2_tg_fbm_b_tg_fbm_b_alt_via_tg_fbm_b_alt_via2_t2
+ a|b|m_east|m_west|nand_m_a|nand_m_a_ext_via|nand_m_a_ext_via2|nand_m_a_stub|tg_d_b|tg_d_b_via|tg_d_b_via2|tg_fbm_b|tg_fbm_b_alt_via|tg_fbm_b_alt_via2__t2
+ a|b|m_east|m_west|nand_m_a|nand_m_a_ext_via|nand_m_a_ext_via2|nand_m_a_stub|tg_d_b|tg_d_b_via|tg_d_b_via2|tg_fbm_b|tg_fbm_b_alt_via|tg_fbm_b_alt_via2
+ 260.17724422
* device instance a_b_m_east_m_west_nand_m_a_nand_m_a_ext_via_nand_m_a_ext_via2_nand_m_a_stub_tg_d_b_tg_d_b_via_tg_d_b_via2_tg_fbm_b_tg_fbm_b_alt_via_tg_fbm_b_alt_via2_t3 r0 *1 0,0 
Ra_b_m_east_m_west_nand_m_a_nand_m_a_ext_via_nand_m_a_ext_via2_nand_m_a_stub_tg_d_b_tg_d_b_via_tg_d_b_via2_tg_fbm_b_tg_fbm_b_alt_via_tg_fbm_b_alt_via2_t3
+ a|b|m_east|m_west|nand_m_a|nand_m_a_ext_via|nand_m_a_ext_via2|nand_m_a_stub|tg_d_b|tg_d_b_via|tg_d_b_via2|tg_fbm_b|tg_fbm_b_alt_via|tg_fbm_b_alt_via2__t3
+ a|b|m_east|m_west|nand_m_a|nand_m_a_ext_via|nand_m_a_ext_via2|nand_m_a_stub|tg_d_b|tg_d_b_via|tg_d_b_via2|tg_fbm_b|tg_fbm_b_alt_via|tg_fbm_b_alt_via2
+ 52.0483618499
* device instance a_b_m_east_m_west_nand_m_a_nand_m_a_ext_via_nand_m_a_ext_via2_nand_m_a_stub_tg_d_b_tg_d_b_via_tg_d_b_via2_tg_fbm_b_tg_fbm_b_alt_via_tg_fbm_b_alt_via2_t4 r0 *1 0,0 
Ra_b_m_east_m_west_nand_m_a_nand_m_a_ext_via_nand_m_a_ext_via2_nand_m_a_stub_tg_d_b_tg_d_b_via_tg_d_b_via2_tg_fbm_b_tg_fbm_b_alt_via_tg_fbm_b_alt_via2_t4
+ a|b|m_east|m_west|nand_m_a|nand_m_a_ext_via|nand_m_a_ext_via2|nand_m_a_stub|tg_d_b|tg_d_b_via|tg_d_b_via2|tg_fbm_b|tg_fbm_b_alt_via|tg_fbm_b_alt_via2__t4
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
+ a|clk|ctrl|ctrlb|inv_clk_a|inv_clk_clk_via|tg_d_ctrl|tg_d_ctrl_via|tg_fbm_ctrlb|tg_fbm_ctrlb_via|tg_fbs_ctrl|tg_fbs_ctrl_via|tg_s_ctrlb|tg_s_ctrlb_via__t4
+ a|clk|ctrl|ctrlb|inv_clk_a|inv_clk_clk_via|tg_d_ctrl|tg_d_ctrl_via|tg_fbm_ctrlb|tg_fbm_ctrlb_via|tg_fbs_ctrl|tg_fbs_ctrl_via|tg_s_ctrlb|tg_s_ctrlb_via
+ 145.293871858
* device instance a_clk_ctrl_ctrlb_inv_clk_a_inv_clk_clk_via_tg_d_ctrl_tg_d_ctrl_via_tg_fbm_ctrlb_tg_fbm_ctrlb_via_tg_fbs_ctrl_tg_fbs_ctrl_via_tg_s_ctrlb_tg_s_ctrlb_via_t5 r0 *1 0,0 
Ra_clk_ctrl_ctrlb_inv_clk_a_inv_clk_clk_via_tg_d_ctrl_tg_d_ctrl_via_tg_fbm_ctrlb_tg_fbm_ctrlb_via_tg_fbs_ctrl_tg_fbs_ctrl_via_tg_s_ctrlb_tg_s_ctrlb_via_t5
+ a|clk|ctrl|ctrlb|inv_clk_a|inv_clk_clk_via|tg_d_ctrl|tg_d_ctrl_via|tg_fbm_ctrlb|tg_fbm_ctrlb_via|tg_fbs_ctrl|tg_fbs_ctrl_via|tg_s_ctrlb|tg_s_ctrlb_via__t5
+ a|clk|ctrl|ctrlb|inv_clk_a|inv_clk_clk_via|tg_d_ctrl|tg_d_ctrl_via|tg_fbm_ctrlb|tg_fbm_ctrlb_via|tg_fbs_ctrl|tg_fbs_ctrl_via|tg_s_ctrlb|tg_s_ctrlb_via
+ 53.1369364906
* device instance a_clk_ctrl_ctrlb_inv_clk_a_inv_clk_clk_via_tg_d_ctrl_tg_d_ctrl_via_tg_fbm_ctrlb_tg_fbm_ctrlb_via_tg_fbs_ctrl_tg_fbs_ctrl_via_tg_s_ctrlb_tg_s_ctrlb_via r0 *1 0,0 
Ca_clk_ctrl_ctrlb_inv_clk_a_inv_clk_clk_via_tg_d_ctrl_tg_d_ctrl_via_tg_fbm_ctrlb_tg_fbm_ctrlb_via_tg_fbs_ctrl_tg_fbs_ctrl_via_tg_s_ctrlb_tg_s_ctrlb_via
+ a|clk|ctrl|ctrlb|inv_clk_a|inv_clk_clk_via|tg_d_ctrl|tg_d_ctrl_via|tg_fbm_ctrlb|tg_fbm_ctrlb_via|tg_fbs_ctrl|tg_fbs_ctrl_via|tg_s_ctrlb|tg_s_ctrlb_via
+ vsubs 7.213055e-15
* device instance a_d_tg_d_a_t0 r0 *1 0,0 
Ra_d_tg_d_a_t0 a|d|tg_d_a__t0 a|d|tg_d_a 207.64565
* device instance a_d_tg_d_a_t1 r0 *1 0,0 
Ra_d_tg_d_a_t1 a|d|tg_d_a__t1 a|d|tg_d_a 207.64565
* device instance a_d_tg_d_a r0 *1 0,0 
Ca_d_tg_d_a a|d|tg_d_a vsubs 6.0717e-16
* device instance a_inv_mc_a_mb_mnab_y_mpa_y_mpb_y_nand_m_y_tg_s_a_y_t0 r0 *1 0,0 
Ra_inv_mc_a_mb_mnab_y_mpa_y_mpb_y_nand_m_y_tg_s_a_y_t0
+ a|inv_mc_a|mb|mnab_y|mpa_y|mpb_y|nand_m_y|tg_s_a|y__t0
+ a|inv_mc_a|mb|mnab_y|mpa_y|mpb_y|nand_m_y|tg_s_a|y 189.921079219
* device instance a_inv_mc_a_mb_mnab_y_mpa_y_mpb_y_nand_m_y_tg_s_a_y_t1 r0 *1 0,0 
Ra_inv_mc_a_mb_mnab_y_mpa_y_mpb_y_nand_m_y_tg_s_a_y_t1
+ a|inv_mc_a|mb|mnab_y|mpa_y|mpb_y|nand_m_y|tg_s_a|y__t1
+ a|inv_mc_a|mb|mnab_y|mpa_y|mpb_y|nand_m_y|tg_s_a|y 128.808394178
* device instance a_inv_mc_a_mb_mnab_y_mpa_y_mpb_y_nand_m_y_tg_s_a_y_t2 r0 *1 0,0 
Ra_inv_mc_a_mb_mnab_y_mpa_y_mpb_y_nand_m_y_tg_s_a_y_t2
+ a|inv_mc_a|mb|mnab_y|mpa_y|mpb_y|nand_m_y|tg_s_a|y__t2
+ a|inv_mc_a|mb|mnab_y|mpa_y|mpb_y|nand_m_y|tg_s_a|y 188.133983991
* device instance a_inv_mc_a_mb_mnab_y_mpa_y_mpb_y_nand_m_y_tg_s_a_y_t3 r0 *1 0,0 
Ra_inv_mc_a_mb_mnab_y_mpa_y_mpb_y_nand_m_y_tg_s_a_y_t3
+ a|inv_mc_a|mb|mnab_y|mpa_y|mpb_y|nand_m_y|tg_s_a|y__t3
+ a|inv_mc_a|mb|mnab_y|mpa_y|mpb_y|nand_m_y|tg_s_a|y 119.440616038
* device instance a_inv_mc_a_mb_mnab_y_mpa_y_mpb_y_nand_m_y_tg_s_a_y_t4 r0 *1 0,0 
Ra_inv_mc_a_mb_mnab_y_mpa_y_mpb_y_nand_m_y_tg_s_a_y_t4
+ a|inv_mc_a|mb|mnab_y|mpa_y|mpb_y|nand_m_y|tg_s_a|y__t4
+ a|inv_mc_a|mb|mnab_y|mpa_y|mpb_y|nand_m_y|tg_s_a|y 142.710836615
* device instance a_inv_mc_a_mb_mnab_y_mpa_y_mpb_y_nand_m_y_tg_s_a_y_t5 r0 *1 0,0 
Ra_inv_mc_a_mb_mnab_y_mpa_y_mpb_y_nand_m_y_tg_s_a_y_t5
+ a|inv_mc_a|mb|mnab_y|mpa_y|mpb_y|nand_m_y|tg_s_a|y__t5
+ a|inv_mc_a|mb|mnab_y|mpa_y|mpb_y|nand_m_y|tg_s_a|y 25.4148600674
* device instance a_inv_mc_a_mb_mnab_y_mpa_y_mpb_y_nand_m_y_tg_s_a_y_t6 r0 *1 0,0 
Ra_inv_mc_a_mb_mnab_y_mpa_y_mpb_y_nand_m_y_tg_s_a_y_t6
+ a|inv_mc_a|mb|mnab_y|mpa_y|mpb_y|nand_m_y|tg_s_a|y__t6
+ a|inv_mc_a|mb|mnab_y|mpa_y|mpb_y|nand_m_y|tg_s_a|y 36.3529298905
* device instance a_inv_mc_a_mb_mnab_y_mpa_y_mpb_y_nand_m_y_tg_s_a_y r0 *1 0,0 
Ca_inv_mc_a_mb_mnab_y_mpa_y_mpb_y_nand_m_y_tg_s_a_y
+ a|inv_mc_a|mb|mnab_y|mpa_y|mpb_y|nand_m_y|tg_s_a|y vsubs 4.013475e-15
* device instance a_inv_mc_y_inv_mc_y_via_mc_tg_fbm_a_tg_fbm_a_via_y_t0 r0 *1 0,0 
Ra_inv_mc_y_inv_mc_y_via_mc_tg_fbm_a_tg_fbm_a_via_y_t0
+ a|inv_mc_y|inv_mc_y_via|mc|tg_fbm_a|tg_fbm_a_via|y__t0
+ a|inv_mc_y|inv_mc_y_via|mc|tg_fbm_a|tg_fbm_a_via|y 208.313425
* device instance a_inv_mc_y_inv_mc_y_via_mc_tg_fbm_a_tg_fbm_a_via_y_t1 r0 *1 0,0 
Ra_inv_mc_y_inv_mc_y_via_mc_tg_fbm_a_tg_fbm_a_via_y_t1
+ a|inv_mc_y|inv_mc_y_via|mc|tg_fbm_a|tg_fbm_a_via|y__t1
+ a|inv_mc_y|inv_mc_y_via|mc|tg_fbm_a|tg_fbm_a_via|y 208.313425
* device instance a_inv_mc_y_inv_mc_y_via_mc_tg_fbm_a_tg_fbm_a_via_y_t2 r0 *1 0,0
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
