2AMLogic/sky130-trng/sim/post-layout-sampler-core/testbench/tb_post_layout_sampler_core_substrate_float.spice

* Post-layout sampler_core (whole composed cell -- four skewed rings, four
* output buffers, the three-xor2 combining tree, AND all six sampler_dff
* instances) with the shared substrate node left FLOATING -- the
* sampler_core-scope sibling of
* sim/post-layout-ro-array-core/testbench/tb_post_layout_ro_array_core_substrate_float.spice,
* now with the six-instance digitizer bank physically present on the same
* shared substrate for the first time (the array-scope deck it extends from
* has no samplers at all, in its netlist or in its extraction).
*
* Purpose (DR-0003 section 8's inter-ring decorrelation gap; DR-0006's own
* "Follow-up required" section names sampler_core as the one remaining
* hierarchy level with no substrate-coupling measurement of its own). This
* deck differs from
* sim/post-layout-sampler-core/testbench/tb_post_layout_sampler_core.spice's
* post-layout half in exactly one respect: that deck ties `vsubs` hard to 0
* (`Vsub vsubs 0 dc 0`), this one does not tie it at all, leaving it on
* layout/pex-sampler-core/sampler_core_pex.spice's own
* `Rvsubs_dctie vsubs 0 1e+12` (klayout-tools#1503). The pair brackets the
* real answer the same way DR-0005 (ring scope) and DR-0006 (array scope)
* did:
*
*   TIED   (sim/post-layout-sampler-core/'s own already-landed records) --
*          ideal zero-impedance substrate, no inter-ring coupling possible
*          by construction.
*   FLOAT  (this deck) -- ideal infinite-impedance shared substrate: every
*          ring's (and every sampler's) switching current is forced through
*          the shared node's capacitance and into every other block sharing
*          it.
*
* No pre-layout control: a pre-layout netlist has no substrate node, so it
* has nothing to say about this question (same choice every prior
* substrate-bracket deck in this repo makes). Dropping the pre-layout half
* is also what makes this deck roughly half the cost of the tied deck it is
* compared against, at no loss of comparability -- the tied deck's own
* post-layout measurements are taken on the same nodes, with the same
* estimators, in the same deck-local time windows.
*
* Stimulus is copied verbatim from tb_post_layout_sampler_core.spice's own
* post-layout half (same en1-4/rst_n/clk timeline), so the six samplers see
* an identical reset-release and clock history in TIED/FLOAT/SOLO. Their own
* switching activity is then common to all three decks and cancels out of
* the loading/coupling decomposition the sibling _solo deck computes,
* isolating the ring-to-ring term DR-0003 section 8 actually asks about.
*
* TWO measurement windows, and the honest statement of what each contains.
* The primary period estimator (`p_tr1`-`p_tr4`, rise=3 -> rise=13) is
* copied verbatim from the tied deck so the three decks are comparable line
* for line -- but at this design's post-layout ring periods (3.8-11.7 ns,
* per the tied deck's own committed records) those thirteen rising edges all
* fall inside the first ~100 ns of the run, i.e. BEFORE `rst_n` releases at
* 300 ns and before `clk` starts at 320 ns. In that window the six samplers
* are held in reset: their real `d`-pin fan-out load, their real extracted
* capacitance to the shared substrate, and their real physical placement
* beside the array are all present, but they are not switching. That window
* is therefore a strictly-larger-scope repeat of DR-0006's array-scope
* bracket (same measurement, more silicon on the shared node), not a
* measurement of a new mechanism.
*
* The second estimator (`p_tr1_clk`-`p_tr4_clk`) is the new one: a
* ten-period average taken from the first rising edge after 400 ns, i.e.
* squarely inside the clocked window (clk rises at 320/420/520/620/720 ns),
* with all six sampler_dff instances actually latching. It is written with
* `TRIG`/`TARG ... TD=400n` rather than a fixed rise index on purpose: the
* ring period varies 3.1x across this repo's PVT grid, so no single rise
* index lands inside the clocked window at every corner, while a
* time-gated trigger does. There is no TIED counterpart for this second
* estimator (the tied records are already minted and are not re-run here),
* so it yields a `coupling` figure -- float minus solo, both measured here
* -- but no `loading` figure. That asymmetry is stated in the record rather
* than papered over.
*
* Global substrate addressing, corrected. DR-0006's own array-scope
* discovery ("A testbench defect, caught and documented rather than
* silently fixed"): `vsubs` is `.global`-declared in
* layout/pex-sampler-core/sampler_core_pex.spice (klayout-tools#1503's own
* workaround), so it is the SAME node everywhere in this deck and must be
* addressed as `v(vsubs)` directly, never `v(xarr.vsubs)` -- the
* hierarchical form silently resolves to "no such vector" and DR-0006's own
* array-scope float/solo decks paid that cost (their own substrate swing
* measurement did not resolve). This deck uses the corrected form from the
* start, and splits the swing into two windows so the reset-held one
* (100-300 ns: rings running, samplers static) is directly comparable with
* DR-0005's own ring-scope figures, while the clocked one (400-600 ns) adds
* what the digitizer bank's own switching puts onto the same node.
*
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
