2AMLogic/sky130-trng/layout/trng_digital/trng_digital.routed.v

module trng_digital (alarm,
    bus_re,
    bus_we,
    clk,
    gated,
    out_ready,
    out_valid,
    raw_bit,
    raw_valid,
    rst_n,
    startup_done,
    bus_addr,
    bus_rdata,
    bus_wdata,
    out_data);
 output alarm;
 input bus_re;
 input bus_we;
 input clk;
 output gated;
 input out_ready;
 output out_valid;
 input raw_bit;
 input raw_valid;
 input rst_n;
 output startup_done;
 input [3:0] bus_addr;
 output [31:0] bus_rdata;
 input [31:0] bus_wdata;
 output [31:0] out_data;

 wire _0000_;
 wire _0001_;
 wire _0002_;
 wire _0005_;
 wire _0012_;
 wire _0021_;
 wire _0023_;
 wire _0025_;
 wire _0027_;
 wire _0028_;
 wire _0029_;
 wire _0030_;
 wire _0031_;
 wire _0032_;
 wire _0033_;
 wire _0034_;
 wire _0035_;
 wire _0036_;
 wire _0037_;
 wire _0038_;
 wire _0039_;
 wire _0040_;
 wire _0041_;
 wire _0042_;
 wire _0043_;
 wire _0044_;
 wire _0045_;
 wire _0046_;
 wire _0047_;
 wire _0048_;
 wire _0049_;
 wire _0050_;
 wire _0051_;
 wire _0052_;
 wire _0053_;
 wire _0054_;
 wire _0055_;
 wire _0056_;
 wire _0057_;
 wire _0058_;
 wire _0059_;
 wire _0060_;
 wire _0061_;
 wire _0062_;
 wire _0063_;
 wire _0064_;
 wire clknet_leaf_59_clk;
 wire _0066_;
 wire _0067_;
 wire _0068_;
 wire _0069_;
 wire _0070_;
 wire _0071_;
 wire _0072_;
 wire clknet_leaf_58_clk;
 wire _0074_;
 wire _0075_;
 wire _0076_;
 wire _0077_;
 wire _0078_;
 wire _0079_;
 wire _0080_;
 wire _0081_;
 wire _0082_;
 wire _0083_;
 wire _0084_;
 wire _0085_;
 wire _0086_;
 wire _0087_;
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
 wire [31:0] _0010_;
 wire [31:0] _0011_;
 wire [31:0] _0013_;
 wire [2:0] _0014_;
 wire [5:0] _0015_;
 wire [2:0] _0016_;
 wire [31:0] _0017_;
 wire [31:0] _0018_;
 wire [31:0] _0019_;
 wire [31:0] _0020_;
 wire [31:0] _0022_;
 wire [15:0] _0024_;
 wire [15:0] _0026_;
 wire [15:0] apt_index;
 wire [15:0] apt_matches;
 wire [31:0] bus_rdata_r;
 wire [15:0] cond_count;
 wire [2:0] cond_level;
 wire [31:0] \cond_mem[0] ;
 wire [31:0] \cond_mem[1] ;
 wire [31:0] \cond_mem[2] ;
 wire [31:0] \cond_mem[3] ;
 wire [31:0] crc_state;
 wire [2:0] ctrl;
 wire [5:0] raw_count;
 wire [2:0] raw_level;
 wire [31:0] \raw_mem[0] ;
 wire [31:0] \raw_mem[1] ;
 wire [31:0] \raw_mem[2] ;
 wire [31:0] \raw_mem[3] ;
 wire [31:0] raw_sr;
 wire [15:0] rct_count;
 wire [15:0] startup_count;

 sky130_fd_sc_hd__diode_2 ANTENNA_1 (.DIODE(clk));
 sky130_fd_sc_hd__nand2_1 _1434_ (.A(ctrl[0]),
    .B(raw_valid),
    .Y(_1395_));
 sky130_fd_sc_hd__nand4_1 _1437_ (.A(raw_count[1]),
    .B(raw_count[0]),
    .C(raw_count[2]),
    .D(raw_count[3]),
    .Y(_1398_));
 sky130_fd_sc_hd__or3b_2 _1439_ (.A(raw_count[5]),
    .B(_1398_),
    .C_N(raw_count[4]),
    .X(_1400_));
 sky130_fd_sc_hd__nor2_1 _1440_ (.A(net40),
    .B(_1400_),
    .Y(_1401_));
 sky130_fd_sc_hd__nand3_1 _1441_ (.A(raw_level[0]),
    .B(raw_level[1]),
    .C(_1401_),
    .Y(_1402_));
 sky130_fd_sc_hd__and3b_1 _1449_ (.A_N(raw_count[0]),
    .B(raw_count[2]),
    .C(raw_count[1]),
    .X(_1410_));
 sky130_fd_sc_hd__nor3_1 _1450_ (.A(raw_count[1]),
    .B(raw_count[0]),
    .C(raw_count[2]),
    .Y(_1411_));
 sky130_fd_sc_hd__nand2b_1 _1451_ (.A_N(raw_count[3]),
    .B(_1411_),
    .Y(_1412_));
 sky130_fd_sc_hd__nor3_1 _1452_ (.A(raw_count[4]),
    .B(raw_count[5]),
    .C(_1412_),
    .Y(_1413_));
 sky130_fd_sc_hd__o21ai_0 _1453_ (.A1(raw_count[4]),
    .A2(_1412_),
    .B1(raw_count[5]),
    .Y(_1414_));
 sky130_fd_sc_hd__nand2b_1 _1454_ (.A_N(_1413_),
    .B(_1414_),
    .Y(_1415_));
 sky130_fd_sc_hd__nor4_1 _1455_ (.A(raw_count[1]),
    .B(raw_count[0]),
    .C(raw_count[2]),
    .D(raw_count[3]),
    .Y(_1416_));
 sky130_fd_sc_hd__xnor2_1 _1456_ (.A(raw_count[4]),
    .B(_1416_),
    .Y(_1417_));
 sky130_fd_sc_hd__nor2_1 _1457_ (.A(_1415_),
    .B(_1417_),
    .Y(_1418_));
 sky130_fd_sc_hd__nand3_1 _1458_ (.A(raw_count[3]),
    .B(_1410_),
    .C(_1418_),
    .Y(_1419_));
 sky130_fd_sc_hd__nand3b_1 _1459_ (.A_N(raw_count[0]),
    .B(raw_count[2]),
    .C(raw_count[1]),
    .Y(_1420_));
 sky130_fd_sc_hd__clkbuf_1 _1460_ (.A(raw_bit),
    .X(_1421_));
 sky130_fd_sc_hd__nand2b_1 _1461_ (.A_N(_1413_),
    .B(net43),
    .Y(_1422_));
 sky130_fd_sc_hd__xnor2_1 _1463_ (.A(raw_count[3]),
    .B(_1411_),
    .Y(_1424_));
 sky130_fd_sc_hd__nor3_1 _1465_ (.A(_1420_),
    .B(_1422_),
    .C(_1424_),
    .Y(_1426_));
 sky130_fd_sc_hd__a22oi_1 _1467_ (.A1(raw_sr[30]),
    .A2(_1419_),
    .B1(_1426_),
    .B2(_1418_),
    .Y(_1428_));
 sky130_fd_sc_hd__nand2_1 _1469_ (.A(\raw_mem[3] [30]),
    .B(net32),
    .Y(_1430_));
 sky130_fd_sc_hd__o21ai_0 _1470_ (.A1(net32),
    .A2(_1428_),
    .B1(_1430_),
    .Y(_0020_[30]));
 sky130_fd_sc_hd__and3b_1 _1473_ (.A_N(raw_count[1]),
    .B(raw_count[0]),
    .C(raw_count[2]),
    .X(_0060_));
 sky130_fd_sc_hd__nand3_1 _1474_ (.A(raw_count[3]),
    .B(_1418_),
    .C(_0060_),
    .Y(_0061_));
 sky130_fd_sc_hd__nand3b_1 _1475_ (.A_N(raw_count[1]),
    .B(raw_count[0]),
    .C(raw_count[2]),
    .Y(_0062_));
 sky130_fd_sc_hd__nor3_1 _1476_ (.A(_1422_),
    .B(_1424_),
    .C(_0062_),
    .Y(_0063_));
 sky130_fd_sc_hd__a22oi_1 _1477_ (.A1(raw_sr[29]),
    .A2(_0061_),
    .B1(_0063_),
    .B2(_1418_),
    .Y(_0064_));
 sky130_fd_sc_hd__nand2_1 _1479_ (.A(\raw_mem[3] [29]),
    .B(net32),
    .Y(_0066_));
 sky130_fd_sc_hd__o21ai_0 _1480_ (.A1(net32),
    .A2(_0064_),
    .B1(_0066_),
    .Y(_0020_[29]));
 sky130_fd_sc_hd__nor2_1 _1481_ (.A(raw_count[1]),
    .B(raw_count[0]),
    .Y(_0067_));
 sky130_fd_sc_hd__nand3_1 _1482_ (.A(raw_count[2]),
    .B(raw_count[3]),
    .C(_0067_),
    .Y(_0068_));
 sky130_fd_sc_hd__or3_1 _1483_ (.A(_1415_),
    .B(_1417_),
    .C(_0068_),
    .X(_0069_));
 sky130_fd_sc_hd__nor2_1 _1484_ (.A(_1422_),
    .B(_0069_),
    .Y(_0070_));
 sky130_fd_sc_hd__a21oi_1 _1485_ (.A1(raw_sr[28]),
    .A2(_0069_),
    .B1(_0070_),
    .Y(_0071_));
 sky130_fd_sc_hd__nand2_1 _1486_ (.A(\raw_mem[3] [28]),
    .B(net32),
    .Y(_0072_));
 sky130_fd_sc_hd__o21ai_0 _1487_ (.A1(net32),
    .A2(_0071_),
    .B1(_0072_),
    .Y(_0020_[28]));
 sky130_fd_sc_hd__nand2_1 _1489_ (.A(raw_count[1]),
    .B(raw_count[0]),
    .Y(_0074_));
 sky130_fd_sc_hd__nor2_1 _1490_ (.A(raw_count[2]),
    .B(_0074_),
    .Y(_0075_));
 sky130_fd_sc_hd__nand3_1 _1491_ (.A(raw_count[3]),
    .B(_1418_),
    .C(_0075_),
    .Y(_0076_));
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
    .B(net32),
    .Y(_0193_));
 sky130_fd_sc_hd__o21ai_0 _1634_ (.A1(net32),
    .A2(_0192_),
    .B1(_0193_),
    .Y(_0020_[2]));
 sky130_fd_sc_hd__o31ai_1 _1635_ (.A1(raw_count[3]),
    .A2(_0088_),
    .A3(_0154_),
    .B1(raw_sr[1]),
    .Y(_0194_));
 sky130_fd_sc_hd__o21a_1 _1636_ (.A1(_0134_),
    .A2(_0154_),
    .B1(_0194_),
    .X(_0195_));
 sky130_fd_sc_hd__nand2_1 _1637_ (.A(\raw_mem[3] [1]),
    .B(net32),
    .Y(_0196_));
 sky130_fd_sc_hd__o21ai_0 _1638_ (.A1(net32),
    .A2(_0195_),
    .B1(_0196_),
    .Y(_0020_[1]));
 sky130_fd_sc_hd__mux2i_1 _1639_ (.A0(raw_sr[0]),
    .A1(net43),
    .S(_1413_),
    .Y(_0197_));
 sky130_fd_sc_hd__nand2_1 _1640_ (.A(\raw_mem[3] [0]),
    .B(net32),
    .Y(_0198_));
 sky130_fd_sc_hd__o21ai_0 _1641_ (.A1(net32),
    .A2(_0197_),
    .B1(_0198_),
    .Y(_0020_[0]));
 sky130_fd_sc_hd__nor3_1 _1642_ (.A(al_apt),
    .B(al_rct),
    .C(al_startup),
    .Y(_0199_));
 sky130_fd_sc_hd__inv_1 _1643_ (.A(_0199_),
    .Y(alarm));
 sky130_fd_sc_hd__and2_1 _1644_ (.A(startup_done_r),
    .B(_0199_),
    .X(_0200_));
 sky130_fd_sc_hd__clkinv_1 _1645_ (.A(_0200_),
    .Y(gated));
 sky130_fd_sc_hd__inv_1 _1647_ (.A(cond_count[7]),
    .Y(_0202_));
 sky130_fd_sc_hd__inv_1 _1648_ (.A(cond_count[8]),
    .Y(_0203_));
 sky130_fd_sc_hd__nand3_1 _1649_ (.A(cond_count[5]),
    .B(cond_count[4]),
    .C(cond_count[3]),
    .Y(_0204_));
 sky130_fd_sc_hd__nand4_1 _1650_ (.A(cond_count[2]),
    .B(cond_count[1]),
    .C(cond_count[0]),
    .D(cond_count[6]),
    .Y(_0205_));
 sky130_fd_sc_hd__nor4_1 _1651_ (.A(_0202_),
    .B(_0203_),
    .C(_0204_),
    .D(_0205_),
    .Y(_0206_));
 sky130_fd_sc_hd__and4_1 _1652_ (.A(cond_count[11]),
    .B(cond_count[9]),
    .C(cond_count[10]),
    .D(_0206_),
    .X(_0207_));
 sky130_fd_sc_hd__a31oi_1 _1653_ (.A1(cond_count[9]),
    .A2(cond_count[10]),
    .A3(_0206_),
    .B1(cond_count[11]),
    .Y(_0208_));
 sky130_fd_sc_hd__or2_2 _1654_ (.A(_0207_),
    .B(_0208_),
    .X(_0209_));
 sky130_fd_sc_hd__nand4_1 _1655_ (.A(cond_count[12]),
    .B(cond_count[13]),
    .C(cond_count[14]),
    .D(_0207_),
    .Y(_0210_));
 sky130_fd_sc_hd__xor2_1 _1656_ (.A(cond_count[15]),
    .B(_0210_),
    .X(_0211_));
 sky130_fd_sc_hd__nand3_1 _1657_ (.A(cond_count[12]),
    .B(cond_count[13]),
    .C(_0207_),
    .Y(_0212_));
 sky130_fd_sc_hd__xor2_1 _1658_ (.A(cond_count[14]),
    .B(_0212_),
    .X(_0213_));
 sky130_fd_sc_hd__a21o_1 _1659_ (.A1(cond_count[12]),
    .A2(_0207_),
    .B1(cond_count[13]),
    .X(_0214_));
 sky130_fd_sc_hd__nand2_1 _1660_ (.A(_0212_),
    .B(_0214_),
    .Y(_0215_));
 sky130_fd_sc_hd__nor3_1 _1661_ (.A(_0202_),
    .B(_0204_),
    .C(_0205_),
    .Y(_0216_));
 sky130_fd_sc_hd__nand2_1 _1662_ (.A(_0203_),
    .B(_0216_),
    .Y(_0217_));
 sky130_fd_sc_hd__nor4_1 _1663_ (.A(cond_count[9]),
    .B(cond_count[10]),
    .C(cond_count[12]),
    .D(_0217_),
    .Y(_0218_));
 sky130_fd_sc_hd__and4_1 _1664_ (.A(_0211_),
    .B(_0213_),
    .C(_0215_),
    .D(_0218_),
    .X(_0219_));
 sky130_fd_sc_hd__and2_1 _1665_ (.A(_0209_),
    .B(_0219_),
    .X(_0220_));
 sky130_fd_sc_hd__nor2_1 _1666_ (.A(net40),
    .B(gated),
    .Y(_0221_));
 sky130_fd_sc_hd__nand4_1 _1667_ (.A(cond_level[1]),
    .B(cond_level[0]),
    .C(_0220_),
    .D(net35),
    .Y(_0222_));
 sky130_fd_sc_hd__mux2i_1 _1670_ (.A0(crc_state[29]),
    .A1(\cond_mem[3] [30]),
    .S(net29),
    .Y(_0225_));
 sky130_fd_sc_hd__inv_1 _1671_ (.A(_0225_),
    .Y(_0011_[30]));
 sky130_fd_sc_hd__mux2i_1 _1673_ (.A0(crc_state[28]),
    .A1(\cond_mem[3] [29]),
    .S(net29),
    .Y(_0227_));
 sky130_fd_sc_hd__inv_1 _1674_ (.A(_0227_),
    .Y(_0011_[29]));
 sky130_fd_sc_hd__mux2i_1 _1676_ (.A0(crc_state[27]),
    .A1(\cond_mem[3] [28]),
    .S(net29),
    .Y(_0229_));
 sky130_fd_sc_hd__inv_1 _1677_ (.A(_0229_),
    .Y(_0011_[28]));
 sky130_fd_sc_hd__mux2i_1 _1678_ (.A0(crc_state[26]),
    .A1(\cond_mem[3] [27]),
    .S(net29),
    .Y(_0230_));
 sky130_fd_sc_hd__inv_1 _1679_ (.A(_0230_),
    .Y(_0011_[27]));
 sky130_fd_sc_hd__xor2_1 _1681_ (.A(net43),
    .B(crc_state[31]),
    .X(_0232_));
 sky130_fd_sc_hd__xnor2_1 _1682_ (.A(crc_state[25]),
    .B(net39),
    .Y(_0233_));
 sky130_fd_sc_hd__nand2_1 _1683_ (.A(\cond_mem[3] [26]),
    .B(net29),
    .Y(_0234_));
 sky130_fd_sc_hd__o21a_1 _1684_ (.A1(net29),
    .A2(_0233_),
    .B1(_0234_),
    .X(_0235_));
 sky130_fd_sc_hd__inv_1 _1685_ (.A(_0235_),
    .Y(_0011_[26]));
 sky130_fd_sc_hd__mux2i_1 _1686_ (.A0(crc_state[24]),
    .A1(\cond_mem[3] [25]),
    .S(net29),
    .Y(_0236_));
 sky130_fd_sc_hd__inv_1 _1687_ (.A(_0236_),
    .Y(_0011_[25]));
 sky130_fd_sc_hd__mux2i_1 _1688_ (.A0(crc_state[23]),
    .A1(\cond_mem[3] [24]),
    .S(net29),
    .Y(_0237_));
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
    .C(_0295_),
    .X(_0024_[12]));
 sky130_fd_sc_hd__and3_1 _1778_ (.A(rct_count[11]),
    .B(net40),
    .C(_0295_),
    .X(_0024_[11]));
 sky130_fd_sc_hd__and3_1 _1779_ (.A(rct_count[10]),
    .B(net40),
    .C(_0295_),
    .X(_0024_[10]));
 sky130_fd_sc_hd__and3_1 _1780_ (.A(rct_count[9]),
    .B(net40),
    .C(_0295_),
    .X(_0024_[9]));
 sky130_fd_sc_hd__and3_1 _1782_ (.A(rct_count[8]),
    .B(net40),
    .C(_0295_),
    .X(_0024_[8]));
 sky130_fd_sc_hd__and3_1 _1783_ (.A(rct_count[7]),
    .B(net40),
    .C(_0295_),
    .X(_0024_[7]));
 sky130_fd_sc_hd__nor4b_1 _1784_ (.A(bus_addr[0]),
    .B(bus_addr[1]),
    .C(bus_addr[3]),
    .D_N(bus_we),
    .Y(_0298_));
 sky130_fd_sc_hd__nand2_1 _1785_ (.A(bus_wdata[2]),
    .B(_0298_),
    .Y(_0299_));
 sky130_fd_sc_hd__nor2_1 _1786_ (.A(bus_addr[2]),
    .B(_0299_),
    .Y(_0300_));
 sky130_fd_sc_hd__and3_1 _1790_ (.A(rct_count[1]),
    .B(rct_count[0]),
    .C(rct_count[2]),
    .X(_0304_));
 sky130_fd_sc_hd__and3_1 _1791_ (.A(rct_count[3]),
    .B(rct_count[4]),
    .C(_0304_),
    .X(_0305_));
 sky130_fd_sc_hd__and3_1 _1792_ (.A(rct_count[6]),
    .B(rct_count[5]),
    .C(_0305_),
    .X(_0306_));
 sky130_fd_sc_hd__a21oi_1 _1793_ (.A1(rct_count[5]),
    .A2(_0305_),
    .B1(rct_count[6]),
    .Y(_0307_));
 sky130_fd_sc_hd__xnor2_1 _1794_ (.A(net43),
    .B(rct_ref),
    .Y(_0308_));
 sky130_fd_sc_hd__nand2_1 _1795_ (.A(rct_armed),
    .B(_0308_),
    .Y(_0309_));
 sky130_fd_sc_hd__nor3_1 _1796_ (.A(_0306_),
    .B(_0307_),
    .C(_0309_),
    .Y(_0310_));
 sky130_fd_sc_hd__and2_1 _1797_ (.A(ctrl[0]),
    .B(raw_valid),
    .X(_0311_));
 sky130_fd_sc_hd__and2_1 _1799_ (.A(rct_armed),
    .B(_0308_),
    .X(_0313_));
 sky130_fd_sc_hd__nor4_1 _1800_ (.A(rct_count[11]),
    .B(rct_count[10]),
    .C(rct_count[7]),
    .D(rct_count[15]),
    .Y(_0314_));
 sky130_fd_sc_hd__or3_1 _1801_ (.A(rct_count[13]),
    .B(rct_count[9]),
    .C(rct_count[8]),
    .X(_0315_));
 sky130_fd_sc_hd__nor4_1 _1802_ (.A(rct_count[14]),
    .B(rct_count[12]),
    .C(_0306_),
    .D(_0315_),
    .Y(_0316_));
 sky130_fd_sc_hd__nand2_1 _1803_ (.A(_0314_),
    .B(_0316_),
    .Y(_0317_));
 sky130_fd_sc_hd__nand2_1 _1804_ (.A(rct_count[14]),
    .B(rct_count[13]),
    .Y(_0318_));
 sky130_fd_sc_hd__nand4_1 _1805_ (.A(rct_count[12]),
    .B(rct_count[11]),
    .C(rct_count[10]),
    .D(rct_count[9]),
    .Y(_0319_));
 sky130_fd_sc_hd__nand4_1 _1806_ (.A(rct_count[8]),
    .B(rct_count[7]),
    .C(rct_count[15]),
    .D(_0306_),
    .Y(_0320_));
 sky130_fd_sc_hd__or3_1 _1807_ (.A(_0318_),
    .B(_0319_),
    .C(_0320_),
    .X(_0321_));
 sky130_fd_sc_hd__xnor2_1 _1808_ (.A(rct_count[5]),
    .B(_0305_),
    .Y(_0322_));
 sky130_fd_sc_hd__a21oi_1 _1809_ (.A1(rct_count[3]),
    .A2(_0304_),
    .B1(_0309_),
    .Y(_0323_));
 sky130_fd_sc_hd__nand2_1 _1810_ (.A(rct_count[4]),
    .B(_0323_),
    .Y(_0324_));
 sky130_fd_sc_hd__nand2_1 _1811_ (.A(_0322_),
    .B(_0324_),
    .Y(_0325_));
 sky130_fd_sc_hd__a32oi_1 _1812_ (.A1(_0313_),
    .A2(_0317_),
    .A3(_0321_),
    .B1(_0310_),
    .B2(_0325_),
    .Y(_0326_));
 sky130_fd_sc_hd__nand2_1 _1813_ (.A(_0311_),
    .B(_0326_),
    .Y(_0327_));
 sky130_fd_sc_hd__xnor2_1 _1814_ (.A(net43),
    .B(apt_ref),
    .Y(_0328_));
 sky130_fd_sc_hd__and4_1 _1815_ (.A(apt_matches[2]),
    .B(apt_matches[1]),
    .C(apt_matches[0]),
    .D(_0328_),
    .X(_0329_));
 sky130_fd_sc_hd__and4_1 _1816_ (.A(apt_matches[5]),
    .B(apt_matches[4]),
    .C(apt_matches[3]),
    .D(_0329_),
    .X(_0330_));
 sky130_fd_sc_hd__and4_1 _1818_ (.A(apt_matches[6]),
    .B(apt_matches[7]),
    .C(apt_matches[8]),
    .D(_0330_),
    .X(_0332_));
 sky130_fd_sc_hd__and4_1 _1820_ (.A(apt_matches[9]),
    .B(apt_matches[10]),
    .C(apt_matches[11]),
    .D(_0332_),
    .X(_0334_));
 sky130_fd_sc_hd__nand4_1 _1821_ (.A(apt_matches[12]),
    .B(apt_matches[13]),
    .C(apt_matches[14]),
    .D(_0334_),
    .Y(_0335_));
 sky130_fd_sc_hd__xor2_1 _1822_ (.A(apt_matches[15]),
    .B(_0335_),
    .X(_0336_));
 sky130_fd_sc_hd__and3_1 _1823_ (.A(apt_matches[12]),
    .B(apt_matches[13]),
    .C(_0334_),
    .X(_0337_));
 sky130_fd_sc_hd__xnor2_1 _1824_ (.A(apt_matches[14]),
    .B(_0337_),
    .Y(_0338_));
 sky130_fd_sc_hd__a21oi_1 _1825_ (.A1(apt_matches[12]),
    .A2(_0334_),
    .B1(apt_matches[13]),
    .Y(_0339_));
 sky130_fd_sc_hd__xnor2_1 _1826_ (.A(apt_matches[12]),
    .B(_0334_),
    .Y(_0340_));
 sky130_fd_sc_hd__nand4_1 _1827_ (.A(apt_matches[9]),
    .B(apt_matches[10]),
    .C(apt_matches[11]),
    .D(_0332_),
    .Y(_0341_));
 sky130_fd_sc_hd__a31o_2 _1828_ (.A1(apt_matches[9]),
    .A2(apt_matches[10]),
    .A3(_0332_),
    .B1(apt_matches[11]),
    .X(_0342_));
 sky130_fd_sc_hd__and3_1 _1829_ (.A(apt_matches[6]),
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
    .Y(_0002_));
 sky130_fd_sc_hd__nand2b_1 _2351_ (.A_N(bus_addr[3]),
    .B(bus_addr[2]),
    .Y(_0730_));
 sky130_fd_sc_hd__or3_1 _2352_ (.A(bus_addr[0]),
    .B(bus_addr[1]),
    .C(_0730_),
    .X(_0731_));
 sky130_fd_sc_hd__nor2_1 _2353_ (.A(bus_wdata[0]),
    .B(_0731_),
    .Y(_0732_));
 sky130_fd_sc_hd__o21ai_0 _2354_ (.A1(bus_addr[2]),
    .A2(bus_wdata[2]),
    .B1(_0298_),
    .Y(_0733_));
 sky130_fd_sc_hd__o22ai_1 _2355_ (.A1(al_rct),
    .A2(_0406_),
    .B1(_0732_),
    .B2(_0733_),
    .Y(_0734_));
 sky130_fd_sc_hd__inv_1 _2356_ (.A(_0734_),
    .Y(_0001_));
 sky130_fd_sc_hd__nor2_1 _2357_ (.A(bus_wdata[1]),
    .B(_0731_),
    .Y(_0735_));
 sky130_fd_sc_hd__o22ai_1 _2358_ (.A1(al_apt),
    .A2(_0407_),
    .B1(_0733_),
    .B2(_0735_),
    .Y(_0736_));
 sky130_fd_sc_hd__inv_1 _2359_ (.A(_0736_),
    .Y(_0000_));
 sky130_fd_sc_hd__inv_1 _2360_ (.A(startup_count[15]),
    .Y(_0737_));
 sky130_fd_sc_hd__nor2_1 _2361_ (.A(_0477_),
    .B(_0485_),
    .Y(_0738_));
 sky130_fd_sc_hd__xnor2_1 _2362_ (.A(_0737_),
    .B(_0738_),
    .Y(_0739_));
 sky130_fd_sc_hd__nand3_1 _2363_ (.A(_0486_),
    .B(_0493_),
    .C(_0501_),
    .Y(_0740_));
 sky130_fd_sc_hd__nor4_1 _2364_ (.A(_0497_),
    .B(_0507_),
    .C(_0739_),
    .D(_0740_),
    .Y(_0741_));
 sky130_fd_sc_hd__nor2_1 _2365_ (.A(startup_done_r),
    .B(_0311_),
    .Y(_0742_));
 sky130_fd_sc_hd__or3_1 _2366_ (.A(_0408_),
    .B(_0741_),
    .C(_0742_),
    .X(_0743_));
 sky130_fd_sc_hd__inv_1 _2367_ (.A(_0743_),
    .Y(_0027_));
 sky130_fd_sc_hd__nor3b_1 _2368_ (.A(cond_level[1]),
    .B(cond_level[0]),
    .C_N(cond_level[2]),
    .Y(_0744_));
 sky130_fd_sc_hd__a31oi_1 _2369_ (.A1(_0220_),
    .A2(net35),
    .A3(_0744_),
    .B1(cond_ovf),
    .Y(_0745_));
 sky130_fd_sc_hd__nor2_1 _2370_ (.A(net38),
    .B(_0745_),
    .Y(_0012_));
 sky130_fd_sc_hd__nor2_1 _2371_ (.A(raw_level[0]),
    .B(raw_level[1]),
    .Y(_0746_));
 sky130_fd_sc_hd__a31oi_1 _2372_ (.A1(raw_level[2]),
    .A2(_1401_),
    .A3(_0746_),
    .B1(raw_ovf),
    .Y(_0747_));
 sky130_fd_sc_hd__nor2_1 _2373_ (.A(net38),
    .B(_0747_),
    .Y(_0021_));
 sky130_fd_sc_hd__and2_1 _2374_ (.A(ctrl[2]),
    .B(_0291_),
    .X(_0014_[2]));
 sky130_fd_sc_hd__xor2_1 _2375_ (.A(raw_level[2]),
    .B(_1402_),
    .X(_0748_));
 sky130_fd_sc_hd__nor2_1 _2376_ (.A(net34),
    .B(_0748_),
    .Y(_0749_));
 sky130_fd_sc_hd__nand2_1 _2377_ (.A(raw_level[0]),
    .B(_1401_),
    .Y(_0750_));
 sky130_fd_sc_hd__xor2_1 _2378_ (.A(raw_level[1]),
    .B(_0750_),
    .X(_0751_));
 sky130_fd_sc_hd__nor2_1 _2379_ (.A(net34),
    .B(_0751_),
    .Y(_0752_));
 sky130_fd_sc_hd__a221oi_1 _2380_ (.A1(raw_level[0]),
    .A2(_1401_),
    .B1(_0746_),
    .B2(raw_level[2]),
    .C1(_0544_),
    .Y(_0753_));
 sky130_fd_sc_hd__o21ai_0 _2381_ (.A1(raw_level[0]),
    .A2(_1401_),
    .B1(_0753_),
    .Y(_0754_));
 sky130_fd_sc_hd__clkbuf_1 _2382_ (.A(bus_re),
    .X(_0755_));
 sky130_fd_sc_hd__nand2b_1 _2383_ (.A_N(bus_addr[0]),
    .B(bus_addr[1]),
    .Y(_0756_));
 sky130_fd_sc_hd__nor3_1 _2384_ (.A(bus_addr[3]),
    .B(bus_addr[2]),
    .C(_0756_),
    .Y(_0757_));
 sky130_fd_sc_hd__nand2_1 _2385_ (.A(net42),
    .B(_0757_),
    .Y(_0758_));
 sky130_fd_sc_hd__o21ai_0 _2386_ (.A1(net34),
    .A2(_0751_),
    .B1(_0754_),
    .Y(_0759_));
 sky130_fd_sc_hd__nor2_1 _2387_ (.A(_0749_),
    .B(_0759_),
    .Y(_0760_));
 sky130_fd_sc_hd__nor2_1 _2388_ (.A(_0758_),
    .B(_0760_),
    .Y(_0761_));
 sky130_fd_sc_hd__xnor2_1 _2389_ (.A(_0754_),
    .B(_0761_),
    .Y(_0762_));
 sky130_fd_sc_hd__or3_1 _2390_ (.A(_0749_),
    .B(_0752_),
    .C(_0762_),
    .X(_0763_));
 sky130_fd_sc_hd__nand3_1 _2391_ (.A(out_ready),
    .B(_0292_),
    .C(_0763_),
    .Y(_0764_));
 sky130_fd_sc_hd__nand2_1 _2392_ (.A(_0754_),
    .B(_0761_),
    .Y(_0765_));
 sky130_fd_sc_hd__nor2_1 _2393_ (.A(_0758_),
    .B(_0759_),
    .Y(_0766_));
 sky130_fd_sc_hd__a22oi_1 _2394_ (.A1(_0752_),
    .A2(_0765_),
    .B1(_0766_),
    .B2(_0749_),
    .Y(_0767_));
 sky130_fd_sc_hd__o21ai_0 _2395_ (.A1(_0751_),
    .A2(_0754_),
    .B1(_0759_),
    .Y(_0768_));
 sky130_fd_sc_hd__nor2_1 _2396_ (.A(_0764_),
    .B(_0768_),
    .Y(_0769_));
 sky130_fd_sc_hd__a21oi_1 _2397_ (.A1(_0764_),
    .A2(_0767_),
    .B1(_0769_),
    .Y(_0016_[1]));
 sky130_fd_sc_hd__mux2_2 _2398_ (.A0(_0754_),
    .A1(_0762_),
    .S(_0764_),
    .X(_0016_[0]));
 sky130_fd_sc_hd__nand4_1 _2399_ (.A(cond_level[0]),
    .B(_0200_),
    .C(_0209_),
    .D(_0219_),
    .Y(_0770_));
 sky130_fd_sc_hd__xor2_1 _2400_ (.A(cond_level[1]),
    .B(_0770_),
    .X(_0771_));
 sky130_fd_sc_hd__nand2_1 _2401_ (.A(cond_level[1]),
    .B(net40),
    .Y(_0772_));
 sky130_fd_sc_hd__o31ai_1 _2402_ (.A1(_0327_),
    .A2(_0380_),
    .A3(_0771_),
    .B1(_0772_),
    .Y(_0773_));
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
    .B(_0797_),
    .Y(_0912_));
 sky130_fd_sc_hd__o21ai_0 _2565_ (.A1(_0166_),
    .A2(_0797_),
    .B1(_0912_),
    .Y(_0913_));
 sky130_fd_sc_hd__nor2_1 _2566_ (.A(net23),
    .B(_0913_),
    .Y(_0914_));
 sky130_fd_sc_hd__a21oi_1 _2567_ (.A1(net23),
    .A2(_0911_),
    .B1(_0914_),
    .Y(_0017_[9]));
 sky130_fd_sc_hd__nor2_1 _2568_ (.A(_0169_),
    .B(_0797_),
    .Y(_0915_));
 sky130_fd_sc_hd__a21oi_1 _2569_ (.A1(\raw_mem[0] [8]),
    .A2(_0797_),
    .B1(_0915_),
    .Y(_0916_));
 sky130_fd_sc_hd__nor2_1 _2570_ (.A(_0169_),
    .B(_0802_),
    .Y(_0917_));
 sky130_fd_sc_hd__a21oi_1 _2571_ (.A1(\raw_mem[1] [8]),
    .A2(_0802_),
    .B1(_0917_),
    .Y(_0918_));
 sky130_fd_sc_hd__mux2i_1 _2572_ (.A0(_0916_),
    .A1(_0918_),
    .S(net23),
    .Y(_0017_[8]));
 sky130_fd_sc_hd__nor2_1 _2574_ (.A(_0173_),
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
