2AMLogic/sky130-trng/(commit log)

2026-08-20 Initial commit: true random number generator on SkyWater sky130
    Scaffolds the block: spec, schematics, ngspice sim, and klayout-tools-driven
    layout signoff.
    A port of the fleet's proven gf180-trng — same entropy-source architecture,
    same spec discipline, second CMOS process. The PDK is the variable, not the
    design: anything that breaks here should be attributable to the PDK, the
    deck, or the tools rather than the circuit. sky130 is fully supported by
    the toolchain, so nothing is blocked; the expected friction is re-deriving
    the entropy source's bias points and health-monitor thresholds for sky130's
    leakage and noise corners rather than copying gf180's.
    Apache-2.0. Nothing designed yet.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
2026-08-20 docs: add gf180-trng-to-sky130 porting plan (#2)
    Adds spec/porting-plan.md, grounded in gf180-trng's spec/ at commit
    f2ab01a and direct inspection of the installed sky130A PDK: what carries
    over as-is (entropy-source topology, sizing-law math, health-test
    formulas, verification-level split), what must be re-derived per sky130
    device measurement (jitter/N, health-test cutoffs, entropy-binding
    corner, idle-leakage split), the supply/envelope question resolved with
    rationale (1.8V core devices, no matched 3.3V core pair on sky130), and
    a verification plan (PVT corners, testbench inventory, entropy evidence
    tiers). Updates spec/README.md to index the new document.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
2026-08-24 Port the gf180-trng entropy-source schematics to sky130 (T1 item 1) (#8)
    Commit the design sources for the sky130-trng entropy source: a
    connectivity-identical port of gf180-trng's design/xschem/ hierarchy,
    re-expressed on sky130's 1.8 V core device pair, plus the deterministic
    netlist export that keeps the committed .spice files honest.
    design/xschem/
    ro_stage, ro_buf, ro_nand2, ro_ring5, ro_ring11, xor2, sampler_dff,
    sampler_core, ro_array_core, trng_top (.sch/.sym pairs; trng_top is the
    top cell and has no symbol, matching the source repo). 46 device
    instances, every one sky130_fd_pr__nfet_01v8 or __pfet_01v8. Verified
    connectivity-identical to gf180-trng's own committed netlis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
    [ro_array_core.sch, ro_buf.sch, ro_nand2.sch, ro_ring11.sch, ro_ring5.sch, ro_stage.sch, sampler_core.sch, sampler_dff.sch]
2026-08-25 Add CI: design/netlist.py --lint on every PR, --check on a scheduled PDK job (#11)
    --lint is pure Python over the schematics' own text (no xschem, no PDK), so
    it runs on every PR touching design/ and blocks on failure. --check needs
    xschem plus a resolvable sky130 install, so it runs on
    .github/workflows/pdk-nightly.yml instead: scheduled, manual dispatch, and
    opt-in on a PR via the run-pdk-check label. The PDK is provisioned with
    volare at the open_pdks commit design/pdk.json pins, read at run time so the
    workflow and the pin can never silently disagree; `design/netlist.py --pdk`
    runs before --check so a failure is attributable to a schematic edit rather
    than a PDK bump.
    Closes #7
    Co-auth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
2026-08-25 Bootstrap sim/ ngspice harness and land RO delay-cell noise mechanism check (#12)
    Adds sim/pdk.json (pinned to design/pdk.json's open_pdks commit), a PVT
    corner-runner (sim/bin/corner-run.py) adapted from sky130-bandgap's for this
    repo's .include-style design/*.spice netlist layout, and one append-only
    evidence record confirming .noise analysis on ro_stage's
    sky130_fd_pr__nfet_01v8/__pfet_01v8 devices produces a non-zero, non-NaN,
    non-flat noise spectrum across the tt/ss/ff corners -- the DR-0001
    mechanism check that gates the jitter-accumulation characterization
    campaign this issue does not attempt.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
2026-08-25 sky130 RO delay-cell jitter characterization: size N, and supersede the N=2 placeholder (#14)
    * sim: extend the corner runner across the temp/supply/seed axes
    Issue #9's `corner-run.py` substituted `@@CORNER@@` only, i.e. the process
    axis of the {process x temperature x supply} PVT grid `sim/README.md`
    documents. Issue #10's characterization campaign has to sweep all three,
    and its ring testbenches are stochastic, so the runner grows three
    matching knobs:
    - `--temp` / `@@TEMP@@` and `--vdd` / `@@VDD@@` -- the temperature and
    supply axes. One runner invocation is one (temp, vdd) point with the
    process axis bundled across `--corners`, mirroring how `--corners`
    already bundles the proce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
    [ro_array_core.sch]
2026-08-25 Rebuild ro_array_core at N=4: measure the XOR combining bandwidth ceiling and fix the operating point (#13) (#15)
    DR-0002 (issue #10) sized the array against the entropy law alone (N=53 at
    a draft >1 Mbps rate) and explicitly declined to redraw the schematic,
    filing the rebuild here. This change measures the second, independent
    constraint DR-0002 named but never quantified -- the XOR combining gate's
    own bandwidth -- and finds it binds before the entropy law does, at a
    different corner (the array's fastest ring, not its entropy-binding one).
    - New evidence: sim/xor-combining-bandwidth/ (gate w_90), sim/ro-ring5-
    swing-and-current/ (buffer-loaded ring period, per-ring current, own-
    count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
    [ro_array_core.sch, sampler_core.sch, trng_top.sch]
2026-08-25 design/netlist.py: wire xschem ERC into --check for connectivity, not just staleness (#17)
    --check's textual staleness diff cannot catch a schematic-level wiring
    defect (e.g. a lab_pin moved off its net) that a "before" and "after"
    regeneration agree on identically -- exactly what PR #15/#13's redraw of
    ro_array_core.sch caught only by hand. Append xschem's own ERC
    (`--command "xschem netlist -erc"`, the same call the GUI's Netlist button
    runs) to the existing batch-mode invocation in export(), and check
    proc.returncode: a nonzero exit raises the new ErcViolation, distinct from
    a stale-netlist diff and from an environment failure.
    - export() gains erc: bool = False, gated behind --check onl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
2026-09-05 docs: re-verify Chipalooza Challenge #4 rules-page status for issue #18 (#24)
    Live-checked opencircuitdesign.com/chipalooza/ on 2026-09-05: rules-4.html
    still 404s, so criterion 4 stays N/A and no slot-budget deltas exist to
    reconcile. While checking, found the site's own Challenge #4 landing page
    now estimates a 2027-11-09 launch, contradicting the 2026-11-09 date this
    document (and the epic's tracking table) has been assuming, while the
    site's own schedule index still shows 2026-11-09. Recorded the
    verification and the discrepancy in the proposal doc without acting on
    either date, since the source itself is currently self-inconsistent.
    Part of #18.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
2026-09-05 feat(champion): standing authorization for design-evidence auto-merge (#6850)
    Operator ruling 2026-09-05: Judge-approved, green-CI PRs whose entire
    changed-file set lives in design/, sim/, layout/, measurements/,
    verification/, or docs/ auto-merge without the four-axis human hold.
    Rationale: canary design evidence is fully revertible with no fleet-infra
    blast radius, and the held-PR pattern (sky130-sar-adc#123 sat mergeable for
    days as the sole blocker of a layout chain) costs more than it protects
    here. spec/ and every tool surface fall outside the patterns, so the
    exact-subset rule keeps them on the four-axis judgment automatically.
    C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
2026-09-05 feat(layout): prove klt primitive-generator methodology for entropy-source devices (#30)
    Draw and independently verify every distinct transistor geometry
    design/xschem/{ro_stage,ro_nand2,ro_buf,xor2}.sch instantiate via
    `klt gen mos_array` against the sky130 open PDK: all six are DRC-clean
    and extract with the correct device class/W/L. Document the floorplan
    plan, correct the curator's stale "no composition path" premise (klt's
    gen/gen-compose/draw surface does support full-custom composition), and
    name the concrete remaining unknown (PMOS well-strap nesting) that blocks
    composing a full DRC/LVS-clean gate.
    Part of #22 -- full ro_array_core/sampler_core layout, post-layout PVT,
    and the wstv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
2026-09-05 feat(layout): solve PMOS well-strap composition; discover mos_array DRC regression (#33)
    Solves the single concrete blocking unknown layout/README.md (issue #22's
    first increment, PR #30) and its follow-up tracking issue (#27) named: how
    to physically strap a `klt gen mos_array`-drawn PMOS's own (unstrapped)
    nwell to a real supply net.
    The fix (layout/well-strap-poc/): nest a mos_array PMOS block inside a
    guard_ring(add_well=true) block's own hollow inner cavity, rather than
    placing them side by side (which DRC-violates on li1.space.1, since the
    ring's own well margin is a fixed ~0.15um -- too tight to also clear
    inter-block li1 spacing). guard_ring draws its own nwell as one solid
    rectangl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
2026-09-05 feat(layout): compose ro_buf DRC-clean and LVS-clean from klt primitives (#35)
    First composed cell in this repo that is both DRC-clean and LVS-clean
    against the design netlist, at this design's real l_um=0.15 sizing.
    layout/ro_buf/: klt gen -> gen-compose -> drc -> extract -> lvs, all
    evidence committed. klt drc clean (0 violations); klt lvs match against
    design/ro_array_core.spice's own .subckt ro_buf (2/2 devices, 4/4 nets,
    0 mismatches), with both bodies on the right rail (pfet b=vdd, nfet
    b=vss).
    layout/bin/compose-cell.py: reusable driver for the whole chain, from a
    committed layout/<cell>/cell.json descriptor, with a --check mode that
    rebuilds into a temp dir and diffs the verdict-be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
2026-09-05 feat(layout): compose ro_stage DRC-clean and LVS-clean via new two-pass composition (#37)
    ro_stage (the array's per-stage starved delay cell) cross-couples its
    always-on starve devices' gates to the *opposite* rail (Mph.g = vss,
    Mnt.g = vddr), a topology no single-layer floorplan makes planar. Extend
    layout/bin/compose-cell.py with an optional multi-stage "stages" cell.json
    shape: a first klt gen-compose pass composes the four devices on the base
    metal (li1) role leaving the two crossing gate nets deliberately unwired,
    promoted as bare pins; a second pass treats that composed cell as one
    further block and routes just those two nets on metal2 with automatic
    via-drop, so they cannot short agai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
2026-09-05 feat(layout): compose ro_nand2 DRC-clean and LVS-clean, generalizing ro_stage's two-pass technique (#41)
    ro_nand2 (each ro_ring5's enable-gated first stage) shares ro_stage's
    cross-coupled starve-gate shape (Mph.g = vss, Mnt.g = vddr) but adds two
    new floorplan problems: a parallel PMOS pull-up pair (Mpa/Mpb, both
    D=y/S=py) and a series NMOS pull-down pair (Mna/Mnb, chained through an
    internal "nm" node). The series pair draws as one mos_array call
    (fingers=2, finger_topology="series"), whose shared internal diffusion
    segment needs no external wire at all. The parallel pair needs
    orientation "rotate_180" (not "mirror_y") on one device so both drains
    face each other directly, and turns "py"/"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
2026-09-05 feat(layout): compose ro_stage/ro_nand2 at all four ring wstv widths, DRC/LVS-clean (#42)
    * feat(layout): compose ro_stage/ro_nand2 at all four ring wstv widths, DRC/LVS-clean
    Both starved leaf gates now exist as four distinct physical cells each -- one
    per ring instance (design/ro_array_core.spice's xr1-xr4, wstv 0.42/0.44/0.46/
    0.48 um) -- matching the schematic's own non-identical-ring intent, which
    DR-0003 section 8's decorrelation strategy depends on.
    Six new cells (ro_stage_wstv0p{44,46,48}, ro_nand2_wstv0p{44,46,48}), each
    klt drc clean (0 violations) and klt lvs matching design/ro_array_core.spice's
    own .subckt at that width (ro_stage 4/4 devices 6/6 nets; ro_nand2 6/6 devices
    8/8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
2026-09-06 feat(sim): simulate noise-driven raw bitstream, MCV min-entropy estimate (#21) (#43)
    Adds sim/raw-bit-min-entropy/: a transient testbench injecting per-stage
    trnoise() into all four rings of the assembled N=4 ro_array_core, driving
    the combined XOR-tree output through the committed sampler_dff, and
    digitizing 24 raw bits per PVT corner at Ts=100ns (a disclosed
    compute-budget deviation from DR-0003's Ts=20us). A reduction script
    computes a per-corner Most-Common-Value (SP 800-90B section 6.3.1 style)
    min-entropy point estimate with standard error and full caveat disclosure,
    explicitly labeled a Tier 2 design estimate rather than an SP 800-90B
    validation. Updates sim/README.md's evidence-recor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
2026-09-06 feat(layout): prove xor2's 12-device placement DRC-clean, document routing gap (#44)
    layout/xor2-placement-poc/ places all twelve of design/ro_array_core.spice's
    .subckt xor2 devices (double ro_nand2's six) using an individual-well-tap-
    per-PMOS strategy that deliberately avoids the 3+-device merged-row shape
    ro_nand2 needed two-pass promotion for. klt drc reports 0 violations and
    klt extract confirms the exact 6 nfet + 6 pfet device/class breakdown.
    Routing is explicitly not composed: xor2's four fan-out signals (a/b/an/bn,
    each reaching two separate gate destinations across the shared mid/y
    cluster) are a genuine multi-net channel-routing problem, materially harder
    than any gate composed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
2026-09-06 feat(layout+sim): post-layout parasitic netlist library and the first post-layout PVT campaign (#47)
    * feat(layout): compose a simulatable post-layout netlist library from layout/
    layout/bin/pex-netlist.py runs `klt extract --pdk sky130A --parasitics` over
    the nine composed, DRC-clean and LVS-clean cells under layout/ and composes
    the results into one ngspice-runnable subcircuit library
    (layout/pex/ro_ring5_pex.spice) that a sim/ testbench can .include exactly
    where it would .include design/ro_array_core.spice.
    --pdk is load-bearing and is recorded as such: with it, klt already writes
    subcircuit calls on the PDK's own devices with unitless geometry, which is
    precisely this repo's `.option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
2026-09-06 feat(layout): compose ro_ring5's 5-gate signal chain, extend compose-cell.py for hierarchical assembly (#48)
    * feat(layout): compose ro_ring5's 5-gate signal chain, extend compose-cell.py for hierarchical assembly
    Resumes and re-verifies a prior session's uncommitted work: layout/bin/compose-cell.py
    now supports placing already-composed leaf cells (blocks[].cell) and building
    multi-subckt LVS references (lvs.dependencies), both needed for issue #27's
    hierarchical-assembly step. Regression-tested against all nine previously
    committed cells via --check with zero drift.
    layout/ro_ring5-connectivity-poc/ places ro_ring5's five leaf gates
    (ro_nand2 + 4x ro_stage) via klt gen-compose's blocks[].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
2026-09-06 refactor(layout): extract shared klt plumbing into layout/bin/_klt_common.py (#50)
    layout/bin/pex-netlist.py and layout/bin/compose-cell.py each carried their
    own copy of BuildError, run_klt() and write_json(). BuildError and run_klt's
    executable code were byte-identical (only the docstrings differed);
    write_json differed by exactly one line -- pex-netlist.py's
    path.parent.mkdir(parents=True, exist_ok=True), a strict superset that is
    safe for compose-cell.py's call sites too.
    Extract all three into layout/bin/_klt_common.py, following
    design/_pdk_search.py's precedent (issue #25) down to the
    sys.path.insert + bare-module-name import style. The shared run_klt
    docstring reconciles both origin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
2026-09-06 feat(layout): compose all four ro_ring5 rings DRC-clean and LVS-clean (#51)
    `layout/ro_ring5/` and its three `wstv` siblings are
    `design/ro_array_core.spice`'s own `.subckt ro_ring5`, composed from the
    five already-committed leaf gates (`ro_nand2` + 4x `ro_stage`) and each
    verified `klt drc` clean (0 violations) and `klt lvs` **match** (22/22
    devices, 19/19 nets, 0 errors) against the schematic's own subckt at that
    ring's `wstv`. These are the first multi-gate cells in the repository to
    reach that bar.
    Four `gen-compose` stages across three physical routing planes:
    - `place` -- placement only; pitched so the one `ro_nand2`/`ro_stage`
    boundary clears `nwell.space.1` (9.30 um origin delta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
2026-09-06 feat(layout,sim): extract ro_ring5's own assembled GDS with parasitics, run post-layout PVT with real inter-gate wiring (#53)
    layout/pex-ring/ extracts each composed, DRC-clean and LVS-clean ro_ring5
    GDS directly (real n1-n4/ro signal routing and vddr/vss rail busing
    included, not the ideal inter-cell wires layout/pex/'s leaf-cell
    composition assumes between gates). sim/post-layout-ro-ring5-assembled/
    runs the same period/swing/supply-current measurement from it across the
    same four-point PVT grid (twelve corner runs, all PASS): real inter-gate
    wiring costs the ring 1.5045x-1.6546x more slowdown on top of intra-cell
    parasitics alone (period vs. pre-layout overall 2.0819x-2.3666x), and the
    ws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
2026-09-06 feat(layout): compose xor2 DRC-clean and LVS-clean, completing ro_array_core's leaf cells (#54)
    * feat(layout): compose xor2 DRC-clean and LVS-clean, completing ro_array_core's leaf cells (#22)
    `layout/xor2/` is `design/ro_array_core.spice`'s own `.subckt xor2` -- the
    combining tree's XOR gate (xa1-xa3), twelve devices and ten nets --
    composed, `klt drc` clean (0 violations) and `klt lvs` **match** (12/12
    devices, 10/10 nets, 0 mismatches, 0 errors), in two `gen-compose` stages
    across two routing planes. Cell extent 23.97 x 17.585 um.
    That closes issue #27 step 2 in full and makes every leaf cell
    `ro_array_core` instantiates a verified physical cell: fourteen composed
    cells now `--check` c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
2026-09-06 feat(layout): floorplan ro_array_core's eleven sibling cells, DRC-clean (#57)
    Places all eleven already-composed leaf instances ro_array_core needs
    (four ro_ring5 wstv variants, four ro_buf, three xor2) on one 216.2 x
    31.755 um grid via klt gen-compose's blocks[].cell mechanism -- no
    klt gen calls of its own. klt drc reports 0 violations and klt extract
    reports exactly the expected 132 devices (66 nfet + 66 pfet), matching
    design/ro_array_core.spice's own instance sum.
    This is placement-only, mirroring layout/xor2-placement-poc/'s
    established convention one level up the hierarchy: no routing exists
    yet, so ro_array_core is not a DRC/LVS-clean block. The new
    layout/ro_array_core-placement-po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
2026-09-06 feat(layout): route ro_array_core's forward ring->buffer signal chain (#59)
    Extends layout/ro_array_core-placement-poc/'s eleven-block floorplan with
    real inter-cell wiring: en1..en4 and the four vddrN domains are exposed as
    top-level pins straight off each ring's own already-formed internal node
    (no routing needed), ro1..ro4 are exposed the same way off each buffer's y
    output, and the four rn1..rn4 legs (ro_ring5.ro -> ro_buf.a) are newly,
    really routed on metal2 -- the first inter-cell wiring this hierarchy level
    has drawn.
    klt drc: clean, 0 violations. klt extract: 132 devices (unchanged), 108
    nets (down from 112, exactly the four new rn1-rn4 merges, each confirmed to
    join only its inten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
2026-09-06 feat(layout): route ro_array_core's buffer->XOR "a" leg for both first-stage XORs (#60)
    ro1 (buf1.y) is now really routed into xa1's a input, and ro3 (buf3.y) into
    xa2's a input, on metal2 -- the first inter-cell wiring between the
    ring/buffer row and the XOR combining-tree row in
    layout/ro_array_core-placement-poc/. Still klt drc clean (0 violations);
    klt extract reports the same 132 devices and 106 nets (down from 108),
    each of the two new merges confirmed by a net-by-net diff against the
    prior increment's own committed extract to join only its intended
    a-labelled net -- no unexpected shorts.
    Two findings recorded in the PoC's own README: the escape from
    buf1.y/buf3.y needed its own fix (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
2026-09-06 feat(layout): route ro_array_core's buffer->XOR "b" leg for both first-stage XORs (#61)
    Resolves Increment 3's own open finding: ro2 (buf2.y) is now really routed
    into xa1.b, and ro4 (buf4.y) into xa2.b, completing the forward
    ring->buffer->XOR signal path for xa1/xa2. klt drc stays clean (0
    violations); klt extract reports 132 devices (unchanged) and 104 nets
    (down from 106, exactly the two intended b-net merges).
    Two new empirical findings recorded: gen-compose rejects a backbone that
    crosses through a third, unrelated block's own bbox even well above the
    routed row (hit when probing a channel above xa1/xa2's own row height);
    and the row1/row2 corridor has room for exactly one more pair o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
2026-09-06 feat(layout): route ro_array_core's buffer vss bus, find vss already substrate-merged (#64)
    Continues issue #22's incremental ro_array_core layout assembly ("Increment
    5"): routes buf1-buf4's own vss taps together as one bundle net on met1
    (klt drc clean, 0 violations). klt extract reports the same 132 devices and
    104 nets as before -- the merged vss net's own device_count (122) is
    byte-identical pre/post, because klt extract's sky130 deck already ties
    every un-isolated NMOS body to one global substrate node via
    connect_global, matching spec/decision-records/DR-0005-*.md finding 3's
    single-ring observation, now confirmed at the array-composition level.
    vdd stays genuinely open: still seven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
2026-09-06 feat(layout): route ro_array_core's t1 XOR-tree net, find a DRC-clean silent short (#65)
    6"): starts the XOR combining tree by routing t1 (xa1.y -> xa3.a, 66.97 um
    on met1) and exposing xo (xa3.y, a real top-level port of .subckt
    ro_array_core) and t2 (xa2.y) as pins. klt drc clean (0 violations); klt
    extract reports 132 devices (unchanged) and 103 nets (down from 104), with
    a net-by-net diff confirming exactly one merge -- xa3's 4-device "a" net
    plus xa1's 4-device "y" net into one 8-device t1 net -- and the two
    remaining y nets gaining only their new pin labels.
    Three findings, all measured rather than asserted: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
2026-09-06 feat(layout): route ro_array_core's t2 XOR-tree net via a met2 bridge (#67)
    Increment 7 of issue #22's incremental ro_array_core layout assembly.
    Routes t2 (xa2.y -> xa3.b) using two short "metal2"-role (met1)
    promotion stubs added at the array-composition level, bridged by a
    "metal3"-role (met2) route over the fence of already-routed met1
    backbones Increment 6 found blocking it.
    Increment 6 predicted this would need a met1 promotion inside xor2's
    own leaf cell, since met3's via-drop is single-hop and cannot reach a
    bare li1 pin. This increment shows that's unnecessary: klt
    gen-compose's blocks[].cell mechanism lets an already-composed block
    gain extra hand-declared ports at any layer, at a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
2026-09-06 feat(layout): route ro_array_core's vdd bus — DRC-clean and LVS-clean array (#68)
    Closes the last open net in `ro_array_core`'s assembly and, with it, the
    array itself: `ro_array_core_signal9_poc.gds` is `klt drc` clean (0
    violations) and `klt lvs` **matches** `design/ro_array_core.spice`'s own
    `.subckt ro_array_core` — 132/132 devices, 96/96 nets.
    `vdd` (the buffer/XOR-tree supply, distinct from the four per-ring `vddrN`
    starve domains) was seven separate nets, one per `ro_buf`/`xor2` instance,
    because `vdd` ties to each instance's own nwell and nwell has no chip-wide
    global identity the way the p-substrate does. Increment 7's prediction that
    it needed the same met1-stub-then-met2-bus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
2026-09-06 feat(layout): promote ro_array_core into a cell recipe, with vss taps (#71)
    ro_array_core was DRC-clean and LVS-clean, but its evidence lived in
    layout/ro_array_core-placement-poc/ -- nine hand-maintained gen-compose
    request files with no compose-cell.py --check reproducibility, plus a
    directory-local array-reference.py. Promote it to layout/ro_array_core/
    with a six-stage cell.json, keeping the same verdict (klt drc clean, 0
    violations; klt lvs match, 132/132 devices, 96/96 nets) and the same
    extracted netlist, now rebuildable by one command.
    The PoC's nine requests are six stages, not nine: signal..signal6 were
    never a chain (each re-composed the SAME eleven-block floorplan with one
    more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
2026-09-07 feat(layout,sim): whole-array post-layout PVT campaign and array-scale substrate bracket (#72)
    * feat(layout,sim): whole-array post-layout PVT campaign and array-scale substrate bracket (#22)
    layout/pex-array/ extracts the DRC-clean, LVS-matching ro_array_core GDS
    flat with klt extract --parasitics, and sim/post-layout-ro-array-core/ runs
    it across the same four-(temp, Vdd)-point, tt/ss/ff grid every prior
    post-layout campaign uses: array-level parasitics cost 2.158x-2.490x in
    ring period, the wstv ladder still discriminates (span 1.089x-1.180x), and
    a tied/float/solo inter-ring substrate bracket -- run on a real
    physically-placed layout for the first time, rather than leaf cells hand-
    tied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
2026-09-07 feat(layout): compose sampler_tg, the transmission gate sampler_dff needs (#74)
    Part of #22. Composes layout/sampler_tg/, a plain sky130 transmission gate
    (0.84/0.15 pfet + 0.42/0.15 nfet, drains tied together, sources tied
    together, independent gate controls) -- the one genuinely new leaf shape
    design/xschem/sampler_dff.sch's 22-device transmission-gate master-slave DFF
    needs (4 instances per sampler_dff: TG_D, TG_FBM, TG_S, TG_FBS). klt drc
    clean (0 violations), klt lvs match (2/2 devices, 6/6 nets) against a
    hand-authored micro-reference, since sampler_dff.sch is flat and has no
    .subckt of this shape in design/*.spice for compose-cell.py's LVS to
    reference directly.
    This resolves layout/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
2026-09-07 feat(layout): compose sampler_nand2, the last leaf shape sampler_dff needs (#76)
    Part of #22. Composes layout/sampler_nand2/: design/sampler_core.spice's
    sampler_dff subckt's NANDM/NANDS2 gate -- a plain rst_n-gated 2-input NAND2,
    structurally layout/ro_nand2/ minus its two always-on starve devices (both
    PMOS sources tie directly to vdd, the series NMOS pair's far end ties
    directly to vss). klt drc clean (0 violations), klt lvs match (4/4 devices,
    6/6 nets) against a hand-authored micro-reference (design/xschem/sampler_dff.sch
    is flat, so there is no independently netlisted .subckt sampler_nand2 in
    design/*.spice for compose-cell.py's LVS to reference directly -- same reason
    layout/sampler_t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
2026-09-07 feat(layout): place sampler_dff's nine leaf-cell instances, route vdd/vss (#78)
    layout/sampler_dff/ assembles sampler_dff (design/sampler_core.spice's
    22-device transmission-gate master-slave DFF) from its three already-
    composed leaf shapes -- 3x ro_buf, 4x sampler_tg, 2x sampler_nand2 -- read
    as a signal-flow pipeline rather than an unordered device list.
    - Stage "place": all nine blocks[].cell instances placed left-to-right in
    signal-flow order, zero routing. DRC-clean (0 violations) on the first
    attempt.
    - Final stage: vdd/vss routed as two attic/basement buses (metal2 role,
    single-hop via-drop from each leaf's own li1 pin layer -- metal3 was
    tried first and rejected by gen-comp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
2026-09-07 feat(layout): route sampler_dff's rst_n fan-out, DRC-clean and merged (#79)
    * feat(layout): route sampler_dff's rst_n fan-out, DRC-clean and merged
    Both sampler_nand2 instances' `a` pin (the rst_n input) sits inside that
    leaf cell's own internal met1 via stack for its `y` output, so a direct
    metal2-role via-drop always shorted to it regardless of approach side.
    Three new stages on top of the previous increment's placement + vdd/vss
    buses fix this: `rst_n_stub` moves each pin 0.32um clear of the obstruction
    on its native li1 layer (no via); `rst_n_met1` vias each stub tip straight
    up to met1 (zero lateral distance, single-hop, same mechanic as every
    vdd/vss leg); the final stage vias again,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
2026-09-07 feat(layout): route sampler_dff's five-pin clk fan-out, DRC-clean (#80)
    Part of #22. Adds two gen-compose stages to layout/sampler_dff/:
    - clk_met1: vias all five clk pins li1 -> met1, zero lateral distance
    (the same single-hop via-drop rst_n_met1 already uses, five times).
    - final stage: the whole long haul on met2/"metal3" as one basement lane
    at y=-1.70 with a vertical drop at each pin's own x, hand-steered with
    connectivity[].legs[] (klayout-tools #1529) since waypoints_um is
    rejected outright on a >2-pin net.
    Verified: klt drc clean (0 violations), 0 unrouted nets, cell bbox
    unchanged. klt extract net_count 31 -> 27 (exactly the four merges a
    five-pin net makes), and the merge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
2026-09-07 feat(layout): route sampler_dff's clkb fan-out, DRC-clean (#81)
    Routes clkb -- the differential half of the already-routed clk net --
    across a met1 corridor at y ~= 0.40 (reserved by the clk increment), with
    two met1->met2->met1 bridges hopping over sampler_nand2's own internal
    met1 blobs and two east-side jogs dodging clk's own via-drop pads at the
    shared tg_fbm/tg_s columns. DRC-clean (0 violations), extract's net count
    drops 27 -> 23 (the four merges a 5-pin net makes), and the merged net's
    six-device list matches design/sampler_core.spice's
    XMpc/XMnc/XMtdn/XMfsn/XMfmp/XMtsp exactly.
    Also renames sampler_dff's previously-unnamed final stage to clk_bus
    (freeing compose.* for the new final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
2026-09-07 feat(layout): route sampler_dff's mc data-path net, DRC-clean (#82)
    Routes mc -- design/sampler_core.spice's XMim2p/XMim2n (inv_mc's own
    inverter output) driving XMfmp/XMfmn's shared pass terminal -- the first
    of sampler_dff's six data-path nets (m/mb/mc/s/q/qb) left open after
    rst_n/clk/clkb. A plain met1 route is blocked for its entire useful
    height band (clkb_seg2's own clkb_mid backbone crosses at y~=2.33, and
    clk_bus's own via-drop pad at tg_fbm.ctrlb sits at the same x as the pin
    gap), so this net vias one plane further, to met2 (empty across this
    whole span), and runs a short U-shaped lane at y=1.8. DRC-clean (0
    violations) on the first attempt, extract's net count drops 23 -> 22
    (the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
2026-09-07 feat(layout): route sampler_dff's q data-path net, DRC-clean (#83)
    Part of #22.
    Routes q (inv_q.y -> nand_s2.en, design/sampler_core.spice's own
    XMisp/XMisn/XMis2pa/XMis2na), the second of the six data-path nets left
    open after rst_n/clk/clkb/mc. Unlike mc, this net needs no via-then-bus
    split: met1 is completely empty across the whole span except
    sampler_nand2's own internal met1 blob at nand_s2, and this net's own
    east pin sits comfortably west of that blob, so one metal2-role
    (met1) stage vias both pins and runs the whole L-shaped haul on met1
    directly -- the same single-stage recipe clkb_seg1 already established
    for a one-hop route.
    klt drc clean (0 violations, first attempt), cell bbo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
2026-09-07 feat(layout): route sampler_dff's qb data-path net, DRC-clean (#85)
    Third of the six data-path nets in layout/sampler_dff/: qb, from
    NAND_S2's output node (design/sampler_core.spice's XMis2pa/XMis2pb PMOS
    drains and XMis2na's NMOS drain) to TG_FBS's own 'a' terminal
    (XMfsp/XMfsn's first terminal).
    One metal2-role (met1) stage, 9.6 um. Unlike rst_n -- whose nand2 'a'
    pin sits inside the same sampler_nand2 met1 blob but on a DIFFERENT net,
    and needed a three-stage li1 stub escape -- qb's west pin IS that blob's
    own net (klt extract names it mnab_y|mpa_y|mpb_y|nand_s2_y|y), so the
    via-drop landing pad is an exact overlay on metal it is already shorted
    to and adds no geometry at all. The climb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
2026-09-07 feat(layout): route sampler_dff's s data-path net on met2, DRC-clean (#86)
    Adds the fourth of sampler_dff's six data-path nets -- s, the slave
    latch's own storage node (tg_s.b, inv_q.a, tg_fbs.b) -- as two new
    cell.json stages: s_met1 vias all three li1 pins up to met1 (three
    single-hop via-drops, zero lateral distance) and the new final stage runs
    one straight met2 lane at y=1.7, steered leg-by-leg with legs[].
    met1 cannot carry the net: every lane between the pins' own y=1.2 and the
    vdd bus is blocked at two or more columns by q's L-lane, qb's east run,
    clkb_bus's east segment, clkb_seg2's x=30.34 vertical and sampler_nand2's
    own internal met1 blob. met2 across the span is empty apart fro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
2026-09-07 feat(layout): promote sampler_dff's d input pin to a real top-level label (#89)
    Gives tg_d.a -- design/sampler_core.spice's sole d-touching connection --
    a genuine "d" net-name label for the first time, closing the one gap in
    sampler_dff's whole-cell external pin promotion (the other five ports,
    clk/rst_n/q/vdd/vss, already carried a correctly-spelled label as a side
    effect of their own routing increment; d was never routed/fanned-out, so
    nothing ever named it beyond klt gen-compose's internal tg_d_a alias).
    Uses gen-compose's existing pins[] promotion mechanism (issue #210): a
    {"net": "d", "block": "core", "port": "tg_d_a"} entry in the final stage
    draws a label-only kdb.Text on the pin's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
2026-09-07 fix(layout): correct sampler_nand2 rst_n/data-input pin swap in sampler_dff (#87)
    layout/sampler_dff/cell.json wired rst_n to each sampler_nand2 instance's
    `a` pin and the data input to its `en` pin; design/sampler_core.spice
    requires the opposite (XMimna/XMis2na gate the output-adjacent nfet with
    the data net, not rst_n). Verified LVS-blocking in the issue via a minimal
    symmetry-broken-pair `klt lvs` experiment.
    Fix: rst_n_met1/rst_n_bus (formerly a three-stage rst_n_stub/rst_n_met1/
    rst_n_bus chain) now target both `en` pins instead of both `a` pins, and
    collapse to two stages since `en` sits outside sampler_nand2's own
    internal met1 blob (no li1 stub escape needed). q_bus now targets
    nan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
2026-09-07 feat(layout,sim): first sampler_dff post-layout PVT campaign and DR-0014 reset-contention re-derivation (#92)
    * feat(layout,sim): first sampler_dff post-layout PVT campaign, and DR-0014's reset-contention methodology re-derived on sky130
    layout/pex/pex-sampler.json is a second descriptor for the same
    layout/bin/pex-netlist.py (no script change), extracting the three composed
    leaf cells layout/sampler_dff/ places -- ro_buf, sampler_tg, sampler_nand2,
    each already DRC-clean and LVS-matching -- into a new sampler-side
    post-layout library, layout/pex/sampler_dff_pex.spice. The inverter is
    extracted under a second name (sampler_inv_pex) so this descriptor's run
    cannot overwrite artifacts pex.jso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
2026-09-07 feat(layout): route sampler_dff's mb data-path net on met1, DRC-clean (#95)
    Adds the fifth of sampler_dff's six data-path nets -- mb, the master
    latch's own inverted output (nand_m.y, inv_mc.a, tg_s.a) -- as a single
    new cell.json stage. Unlike mc and s it needs no met2 and therefore no
    *_met1 pre-stage: one metal2-role (met1) gen-compose stage does the whole
    three-pin fan-out, the single-stage recipe q and qb established.
    The route is a two-height T rather than one lane. Measured on the composed
    GDS with klayout.db, sampling candidate lane centres in 5 nm steps against
    a 0.17 um wire plus 0.14 um met1.space.1 on each side: the west span
    (x=13.49..19.835) is free at any centre height y=1.31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
2026-09-07 fix(layout/pex): canonicalize klt's own net numbering in --check, re-extract on the pinned klt (#97)
    `python3 layout/bin/pex-netlist.py layout/pex/pex.json --check` failed on a
    checkout whose klt matched layout/pdk.json's klt_version_pin: the nine cells
    were produced by klt 0.4.0 while the pin reads 0.3.0+gc6dbf66c53c6.
    Measured across three klt builds over the identical GDS, the whole drift is
    the extractor's own anonymous-net counter (\$3 <-> \$4 in three of nine
    cells) plus a net_id permutation, with every R, C, coupling value, count,
    terminal and connection identical. klayout-tools#1063/#1072 (closed)
    establish that numbering is deliberately not a stable contract.
    - canonical_parasitic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
2026-09-07 fix(layout/pex): thread the invoking descriptor into the generated library's own header (#98)
    layout/bin/pex-netlist.py's build_library() hardcoded the literal string
    "layout/pex/pex.json" into every generated library's banner and its quoted
    --check command, regardless of which descriptor actually ran. Since #92
    added a second descriptor, layout/pex/sampler_dff_pex.spice's header named
    the wrong file and quoted a --check command that verifies a different
    library -- a false-reassurance failure in exactly the self-verification
    instruction --check exists to provide.
    - library_header(substrate, descriptor) is split out of build_library() so
    the banner text is a pure function of the descriptor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
2026-09-07 feat(layout): route sampler_dff's m data-path net, DRC/LVS clean (#99)
    Adds the sixth and last data-path net, m (TG_D.b <-> NAND_M.a <->
    TG_FBM.b), completing sampler_dff. Four new gen-compose stages
    (m_stub/m_met1/m_met2/final): m_stub reuses the pre-#84 rst_n_stub
    stage's own nand_m-side li1 escape geometry byte for byte; m_met1/
    m_met2 via three anchors from li1 to met2; the final stage routes the
    met2 wire as two 2-pin connectivity[] entries (m_west/m_east) sharing
    one endpoint, rather than one 3-pin bundle net with
    connectivity[].legs[] -- this session's installed klt (0.4.0 release,
    git_commit 34548dc) does not parse legs[] at all (an independent
    reproduction of klayout-tools#1548's "s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
2026-09-07 fix(layout/pex-ring,pex-array): close #96's provenance gap for pex-ring, record pex-array as a genuine electrical divergence (#100)
    layout/pex-ring/pex.json's five cells were re-extracted on the pinned
    klt (0.3.0+gc6dbf66c53c6): the committed-vs-rebuilt diff is entirely the
    extractor's own anonymous-net ($N) and per-terminal leg (__tK) counters,
    confirmed by a reduced-circuit-description diff, a label-free
    Weisfeiler-Lehman isomorphism check, and a byte-identical ngspice A/B
    against sim/post-layout-ro-ring5-assembled/'s own deck. --check now
    exits 0 on the pin. The four affected sim/ records are re-stamped
    (append-only, not edited) in sim/README.md.
    layout/pex-array/pex.json does NOT reprod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
2026-09-07 feat(layout,sim): sampler_dff whole-cell (assembled) post-layout extraction and PVT campaign (#101)
    layout/sampler_dff/sampler_dff.gds is now klt lvs-clean (PR #99, m/mb
    routed), so it is a valid flat extraction source for the first time --
    the whole-cell equivalent of layout/pex-ring/, explicitly named as
    follow-up in DR-0007. layout/pex-sampler-dff-assembled/ extracts it with
    klt extract --parasitics (22 devices, 14 nets, real intra-cell routing
    included), and sim/post-layout-sampler-dff-assembled/ re-runs the
    capture-timing/reset-contention deck against it across the same
    four-(temp, Vdd)-point PVT grid (4 records, 12 corner runs, all PASS):
    clk->q delay costs 1.704x-2.013x against pre-la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
2026-09-07 feat(layout): DRC-clean placement proof-of-concept for sampler_core's six-sampler_dff bank (#102)
    Part of issue #22. layout/sampler_core-placement-poc/ places six
    already-composed, individually DRC-clean and klt lvs-clean
    layout/sampler_dff/sampler_dff.gds instances side by side (55.66 um pitch,
    design/sampler_core.spice's own sb/sv/sr1-sr4 instance order), with zero
    routing: klt drc clean (0 violations) on the first attempt, klt extract
    confirms 132 devices (66 nfet + 66 pfet) and 79 nets (traced and confirmed
    benign: sky130's own global-substrate NMOS-bulk merge accounts for the
    5-net gap from the naive 6x14=84).
    This is a placement-only exploration, the same first step every earlier
    hier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
2026-09-07 feat(layout): route sampler_core's shared vdd/vss bus across six sampler_dff instances (#103)
    layout/sampler_core/ promotes layout/sampler_core-placement-poc/'s own
    six-instance floorplan into a real, compose-cell.py --check-reproducible
    cell.json recipe and adds this increment's own new work: a route_supplies
    stage chaining vdd and vss across sb->sv->sr1->sr2->sr3->sr4 on met1
    ("metal2" role), landing directly on each sampler_dff instance's own
    already-drawn rail (no via-drop needed, since that cell's own routing
    already put vdd/vss on met1).
    - klt drc: clean, 0 violations, on the first attempt; cell bbox unchanged.
    - klt extract: 132 devices unchanged, 74 nets (down from the placement
    P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
2026-09-07 feat(layout): route sampler_core's shared clk/rst_n fan-out across six sampler_dff instances (#104)
    Part of #22. layout/sampler_core/ adds a third gen-compose stage,
    route_ctrl, chaining clk and rst_n across sb->sv->sr1->sr2->sr3->sr4 on
    top of the previous increment's vdd/vss route_supplies stage -- issue
    #27's own step 2, flagged as likely the hardest remaining item.
    clk routes clean on the first attempt (its own in-cell lane already spans
    each instance's full width, clear of everything else). rst_n's first
    attempt (the same recipe, reusing clk's own anchor x) failed all five
    legs: a straight haul out of rst_n's own narrower in-cell span crosses
    several other nets' met2 verticals near eac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
2026-09-07 feat(layout): place ro_array_core in sampler_core and route the first two data nets (#107)
    Three new stages in layout/sampler_core/cell.json, on top of the
    place/route_supplies/route_ctrl stages (all unchanged):
    - place_array puts one ro_array_core instance -- the DRC-clean,
    LVS-matching entropy source -- at (0.0, 23.635), directly above the
    six-sampler_dff row with a 12.915 um routing channel between them. The
    whole design/sampler_core.spice device population (264 devices) exists
    in one stream for the first time.
    - data_m1 (met1) climbs sr1's and sr4's own d pins out of li1 to a landing
    point under the shared vdd rail, and extends ro1's and ro4's own array
    metal south into the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
2026-09-07 feat(layout): route sampler_core's last three data nets and sv's vdd tie (#108)
    Two new stages in layout/sampler_core/cell.json finish the cell's data
    path: every sampler_dff instance's d pin is now driven.
    - data2_m1 (met1, 9 legs): d-input climbs for sb/sr2/sr3 (the recipe
    data_m1 already used for sr1/sr4); sv's d->vdd tie, landing directly on
    the shared vdd rail's own met1 as design/sampler_core.spice requires;
    ro2's and ro3's westward escapes along their own already-drawn
    horizontals; and the two short legs xo needs -- an li1->met1 promotion
    of xa3's own y pad (the same one ro_array_core already declares for
    xa2) plus a detached dip that ducks under xa2's t2 riser.
    - route_d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
2026-09-07 docs(layout): confirm sampler_dff --check regression is klt legs[] tool drift, not recipe drift (#106) (#110)
    layout/sampler_dff/cell.json's clkb_seg2 stage requests
    connectivity[].legs[] to steer a 4-pin clkb_mid bundle route. Both the
    ambient klt (v0.4.0 tagged release, git_commit 34548dc) and
    layout/pdk.json's own klt_version_pin (0.3.0+gc6dbf66c53c6) predate
    legs[] support entirely, so `compose-cell.py --check` fails during
    composition with "nets left unrouted by gen-compose: ['clkb_mid']".
    Confirmed root cause with evidence: neither build's gen_compose.py has
    a _parse_legs function; a klt build with legs[] support (commit
    245a841afd65c30ae9ad6f64c6e8b1da97362146, 44 commits past the v0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
2026-09-07 feat(layout): route sampler_core's vss inter-block supply strap, DRC-clean (#112)
    layout/sampler_core/cell.json gains four stages (vss_strap1-vss_strap4)
    that connect ro_array_core's own vss (tapped on its east riser, a point
    taken from ro_array_core/cell.json's own vssbus stage) to the six-
    sampler_dff bank's own vss rail with real metal, routed through the
    sr2->sr3 inter-instance gap and bridged over the shared vdd rail's own
    height. Until now the two extracted as one net only through sky130's
    shared p-substrate model -- real for extraction purposes, but not a
    supply connection a fabricated die can rely on.
    klt drc: clean, 0 violations. klt extract: 264 devices, 153 nets, both
    unchanged (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
2026-09-07 feat(layout): route sampler_core's vdd strap to a full whole-cell LVS match (#113)
    * feat(layout): route sampler_core's vdd inter-block strap, full LVS match
    Adds vdd_strap1-vdd_strap3, a three-stage met1/met2/met1 route (a short
    via bridge around a previously-undocumented met1 obstruction) from
    ro_array_core's own vdd bus to the six-sampler_dff bank's own vdd rail,
    completing sampler_core's second and last inter-block supply strap.
    klt drc: clean, 0 violations. klt extract: 264 devices, 152 nets (down
    from 153 -- vdd's two nets are now genuinely one). klt lvs vs.
    design/sampler_core.spice's own .subckt sampler_core: full match --
    264/264 devices, 152/152 nets, 0 errors -- the first whole-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
2026-09-07 feat(layout): extract sampler_core's post-layout parasitics (#114)
    Adds layout/pex-sampler-core/, running klt extract --parasitics over the
    now DRC-clean and LVS-matching layout/sampler_core/sampler_core.gds
    (264 devices, 152 nets, 169817.28 ohm total series R, 869.19 fF total C).
    The net_aliases table is derived from layout/sampler_core/lvs.json's own
    klt-lvs-verified net_correspondence rather than inferred from spelling,
    since the six sampler_dff instances' own q pins are never promoted to a
    GDS label -- raw_bit/raw_valid/ring_bit1-4 need six explicit, order-
    sensitive alias entries instead of the usual one-base-alias pattern.
    Independently cross-checked with a union-find over the generat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
2026-09-08 feat(sim): sampler_core's first whole-cell post-layout PVT campaign (#115)
    Adopts and validates the interrupted prior session's
    tb_post_layout_sampler_core.spice testbench (verified correct against
    layout/pex-sampler-core/sampler_core_pex.spice's own port order and
    promoted net names before trusting it), then runs it across this repo's
    established four-point PVT grid ({-40, 27, 125} degC x {1.62, 1.8, 1.98} V
    at the reduced sampling used elsewhere) x three process corners.
    This is the first deck in the repo to exercise the whole raw-tap-to-
    sampled-bit chain post-layout in one flat extraction -- every prior deck
    measured either the entropy source alone (post-layout-ro-array-core/) or
    one di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
2026-09-08 feat(sim): whole-chain substrate bracket, and DR-0003 Sec8 narrowed (#116)
    Runs the tied/float/solo shared-substrate bracket at sampler_core scope --
    the one hierarchy level DR-0006's own "Follow-up required" section named as
    having no substrate-coupling measurement of its own, and the deck
    sim/post-layout-sampler-core/'s own write-up said was still owed
    ("wstv inter-ring decorrelation remains unmeasured ... would need a deck
    built specifically to probe it").
    Two new decks, eight records, twenty-four corner runs, all PASS, over this
    repo's established four-(temp, Vdd)-point grid x tt/ss/ff:
    - loading -0.650% to -0.283% of ring period, coupling +0.361% to +0.584%,
    positive at 12 of 12 gri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
2026-09-12 Wire package.json test/lint/check scripts to the real Python test suite (#120)
    Root package.json's test/lint/check:ci/check:all scripts were unfixed
    Loom scaffolding placeholders that printed "No X configured..." and
    exited 0, giving a false "all clear" to any Auditor/Judge fallback that
    runs `npm run check:all` / `npm test`. Wire them to the real,
    non-PDK-gated Python suite (matching CI's own PR-blocking scope):
    - test: chains the five stdlib-only Python suites (&&, so a failure in
    any one fails the whole script, not five fire-and-forget invocations)
    - lint: design/netlist.py --lint (same brace-guard check ci.yml runs)
    - check:ci / check:all: compose lint + test
    design/test_netlist_erc.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
2026-09-12 Extract layout/sampler_core's byte-identical merged() geometry helper (#124)
    vss-strap-scan.py, vdd-strap-scan.py, and data-path-scan.py each
    hand-rolled the same 5-line klayout.db merged() helper (byte-identical
    modulo one docstring). Move it to a new layout/sampler_core/_geom_common.py
    and have all three import it, following design/_pdk_search.py's
    sys.path.insert + import pattern (as design/netlist.py itself uses it).
    layout/ro_array_core/vss-tap-scan.py's own merged() is a different
    implementation and intentionally left untouched.
    Verified behavior-preserving by running all three scripts against their
    committed GDS inputs before and after the extraction and diffing the
    resulting *-scan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
2026-09-12 fix(layout): refresh sampler_core scan assertions for the post-#113 vdd strap (#127)
    `vss-strap-scan.py` and `data-path-scan.py` are evidence-snapshot scripts
    that read `extract.json` and `sampler_core.gds` live, but three of their
    hardcoded claims still asserted the pre-#113 net topology. PR #113 routed
    sampler_core's vdd strap and intentionally merged the array's and the
    sampler's `vdd` into one net, so re-running either script on an unmodified
    checkout measured the new, correct topology and then failed its own stale
    assertion — `all_claims_hold: false`, exit 1, for by-design behavior.
    Updated the three stale claims to the intentional post-strap values and
    regenerated both `*-scan.json`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
2026-09-12 refactor: extract merge_spans() interval-merge helper in sampler_core (#130)
    column_spans (vss-strap-scan.py), occupied and lane_occupied
    (data-path-scan.py) each hand-rolled the same 5-line interval-merge
    loop. Extract it into _geom_common.merge_spans(), following the
    precedent set by merged() (#122/#124).
    Verified behavior-preserving: ran vss-strap-scan.py, data-path-scan.py,
    and vdd-strap-scan.py before and after, diffed stdout and the
    *-scan.json artifacts -- byte-identical, including exit status.
    Closes #129
2026-09-12 Extract shared merged()/dbox_region() geometry helpers for ro_array_core scan scripts (#132)
    vss-tap-scan.py and vdd-tap-scan.py each hand-rolled byte-identical
    merged()/dbox_region() helpers. Extract them into a new
    layout/ro_array_core/_geom_common.py, following the precedent and
    docstring style of layout/sampler_core/_geom_common.py, and import from
    it in both scripts instead.
    Verified no behavior change: re-ran both scripts and diffed the
    resulting vss-tap-scan.json/vdd-tap-scan.json against the
    git-committed versions -- byte-identical.
    Closes #131
2026-09-13 Consolidate synthesize-and-verify.py onto the shared _klt_common.run_klt() (#134)
    `sim/digital-synthesis/harness/synthesize-and-verify.py` was a third caller
    of the "shell out to `klt ... --format json`, parse JSON" pattern that
    `layout/bin/_klt_common.py` exists to own, but it re-implemented the
    contract locally and had quietly diverged from it:
    - it never checked for an `error` object in an otherwise well-formed JSON
    response (the shared helper's second fatal case), and
    - it treated *every* non-zero exit as immediately fatal.
    The second divergence was a live bug, not just duplication. `klt equiv`
    exits 3 on a proven counterexample and 4 on an inconclusive (timed-out)
    proof -- both with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
2026-09-15 docs: add PDR-0001 recommending a fix for broken generate-agents-md.sh path (#139)
    Issue #75 was escalated by Champion under the ratification-via-PR policy
    (2AMLogic/2am#357): rather than deferring the three remediation options to a
    human, a Builder should draft a decision record recommending one option with
    evidence, as a PR. This adds that record under a new docs/decisions/ track
    (kept separate from spec/decision-records/, which CLAUDE.md ties specifically
    to circuit-spec changes), recommending the local path fix paired with an
    upstream bug report, and records the finding that the ee-key/market-key
    two-key mechanism does not apply to this kind of process/tooling record.
    Implementation of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
2026-09-15 refactor: extract carrying() scan-script helper into _geom_common.py (#143)
    vss-strap-scan.py, vdd-strap-scan.py, and data-path-scan.py each had a
    byte-identical (modulo formatting) nested carrying(*tokens) closure over
    a local nets list. Extracted to _geom_common.py alongside merged()
    (#122) and merge_spans() (#129), with nets promoted to an explicit
    leading parameter since the extracted function can no longer close
    over it.
    Verified byte-identical output (md5sum match) for vss-strap-scan.json,
    vdd-strap-scan.json, and data-path-scan.json before and after.
    Closes #141
2026-09-15 fix: eliminate pipefail+set-e crash in merge-pr.sh champion:hold-state check (#146)
    _check_champion_hold_state_staleness() crashed the whole script (silent
    exit 1, no output) whenever a loom:pr PR had non-empty comments but no
    champion:hold-state marker — the ordinary case for any PR Judge approved
    without Champion's hold mechanism ever touching it. `grep -o` with no
    match exits 1; under `set -o pipefail` that propagates through the
    pipeline into a bare (non-local) assignment, which `set -e` then treats
    as fatal. Same bug class as #142/#144's verify-proposal-refs.sh fix.
    Add `|| true` to mask the expected "not found" case, and add a
    regression test that invokes the extracted function in a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
2026-09-15 docs: fix stale not-yet-composed claims in sampler_tg README (#148)
    sampler_dff and sampler_nand2 have both since been composed and
    LVS-clean (22/22 devices, 14/14 nets and 4/4 devices, 6/6 nets
    respectively), and issue #27 is closed. Update the three stale
    passages in layout/sampler_tg/README.md that still described these
    as "not yet attempted"/"remains open"/"not yet composed", link to
    layout/sampler_dff/README.md and layout/sampler_nand2/README.md, and
    add a forward pointer to the now fully composed and post-layout-
    verified layout/sampler_core/README.md.
    Closes #147
2026-09-16 refactor: remove dead constants in sampler_core data-path-scan (#150)
    D_M1_Y_UM, DATA_TARGETS, and XO_M1_UM were module-level constants in
    layout/sampler_core/data-path-scan.py that no scan function, no main(),
    and no other file ever read -- leftover geometry values from an earlier
    draft of the claim set. Delete all three plus their now-orphaned doc
    comments, and reword the two comments that documented a deleted constant
    alongside a surviving one (CHANNEL_TURNS_UM, XO_PAD_UM) so they describe
    only what remains.
    XO_PAD_UM is untouched: it is read at lines 330-331.
    Closes #149
2026-09-18 ci: pin xschem to a 3.4.7 floor and surface a red pdk-nightly (#151) (#152)
    pdk-nightly's netlist-check job has been red on EVERY scheduled run since
    the job landed (2026-08-25, 25/25 failures), not just since 2026-09-15 as
    the issue reports -- it has never once been green. All four cells
    (ro_array_core, ro_ring5, sampler_core, trng_top) report STALE because the
    runner's `apt-get install xschem` resolves ubuntu-noble's 3.4.4-1, and
    3.4.7 is the first xschem release that evaluates `expr(...)` templates in
    symbol attributes (its own Changelog: "evaluate infix expressions with
    expr(...) in attributes"). sky130's device symbols carry every device-area
    parameter that way, over the symbol's own @W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
2026-09-21 ci: declare the run-pdk-check label the PDK-gated workflows' PR opt-in documents (#156)
    Both .github/workflows/pdk-nightly.yml and .github/workflows/ci.yml gate
    their pull_request trigger on a 'run-pdk-check' label, but that label did
    not exist anywhere — not in .github/labels.yml nor on the repository — so
    the documented opt-in path ('apply the label to validate a schematic or
    layout edit before merge') was dead: there was no label to apply, and an
    ad-hoc one created by hand would not be covered by the label registry.
    Add 'run-pdk-check' to .github/labels.yml as a repo-local label, appended
    after # END LOOM LABELS (outside the Loom-managed block, per the file's
    own header, so install/u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
2026-09-21 feat(layout): add T1 item-11 klt erc supply read for sampler_core (#158)
    * feat(layout): add T1 item-11 klt erc supply read for sampler_core
    Commit the structural power-delivery evidence T1 item 11 (klayout-tools
    design-evidence-tiers.md, approved as klayout-tools#2025) grades: a
    klt erc supply spec (erc-supply-spec.json) declaring this block's six
    netlist-supplies -- vddr1..vddr4, vdd, vss -- plus its committed
    --format json report (erc.json) against sampler_core.gds, whose
    provenance.content_hash matches the committed GDS byte for byte
    (sha256:a00f655067731fc4ee189e98b57a0e22f3160752923badc556c9ceff8811396f).
    Every declared supply resolves to exactly one electrical island:
    erc_status "cl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
2026-09-23 chore(signoff): bump the signoff grader pin to klayout-tools 0.6.0, re-vendor the tiers doc, regenerate t1-report.json (#163)
    Closes #160
    Part of #3
2026-09-23 feat(signoff): declare sampler_core well/substrate ties in the erc supply spec and cite 11.analog (#165)
    Add ties[] to layout/sampler_core/erc-supply-spec.json on klayout-tools
    0.6.0's isolated tie extraction: six entries covering every distinct
    well/substrate tie the layout draws (70 merged nwell regions tied to
    vdd, five each to vddr1-vddr4, and the substrate to vss via the
    native-substrate well_layer:null + well_boxes form), all graded
    erc_status: clean with zero findings and no degenerate tie. Regenerate
    erc.json on the tagged 0.6.0 release, add the compound 11.analog
    [erc.json, lvs.json] citation to the block manifest, and re-render
    t1-report.json: the row moves from unmet/no_evidence t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
2026-10-01 chore: resync installed Loom surfaces
    resynced_by: fleet-resync
    invocation: fleet-resync.sh --fleet-only --push
    <!-- loom:provenance v1 build=unknown 19f4e67fd0a0afbd3d8b6606ca91ceac911377a3 clean prompts=none sweep=none story=none trace=78a5dfbdfd8c530aecd1bb436fd096df host=loom-worker-2 base=172f09c3490e2a6ba0c5089ba82eba416234be70 run=loom-run/v1:timer:loom-worker-2/fleet-resync:67c759f7ef3c43e38d3fa8d5f19a2dd1 installs=0.19.593 658650a4f0eff932ac66a8f690eaedf8123fc83b -->
    Loom-Story: none
    Loom-Trace-Id: 78a5dfbdfd8c530aecd1bb436fd096df
    Loom-Build: unknown 19f4e67fd0a0afbd3d8b6606ca91ceac911377a3 clean
2026-10-01 chore: resync installed Loom surfaces
    <!-- loom:provenance v1 build=unknown 56435bf476452911283e43940ecfd9a30f804af9 clean prompts=none sweep=none story=none trace=342405c5ebc99bdbf17afbd983c0c41c host=loom-worker-2 base=cf1bfd35898c56f11e0a1900cf779e6699ba6b43 run=loom-run/v1:timer:loom-worker-2/fleet-resync:20c09f231d424cd5b57ca7991848dd8a installs=0.19.603 8c39bf7cde8a8c03d1aaee441f397c017b6a3a9e -->
    Loom-Trace-Id: 342405c5ebc99bdbf17afbd983c0c41c
    Loom-Build: unknown 56435bf476452911283e43940ecfd9a30f804af9 clean
    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
2026-10-01 chore: resync installed Loom surfaces
    <!-- loom:provenance v1 build=unknown f2868e6b4d60d11a8ab47d25cad9e248229d2f66 clean prompts=none sweep=none story=none trace=4e2766ed5160781df891476246a9be2e host=robb-studio base=2fc982a1639d0a45d243e00f06fe1b38bd89f46d run=loom-run/v1:timer:robb-studio/fleet-resync:2d3851d5-1673-43ae-bcc6-e5c971b37f33 installs=0.19.603 74778a6aeea5d9e06b489400942b35f33c8bb766 -->
    Loom-Trace-Id: 4e2766ed5160781df891476246a9be2e
    Loom-Build: unknown f2868e6b4d60d11a8ab47d25cad9e248229d2f66 clean
    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
2026-10-01 chore: resync installed Loom surfaces
    <!-- loom:provenance v1 build=unknown d6714830391f7596338b8de40ee2d0f45dcd12f5 clean prompts=none sweep=none story=none trace=af273f717e759e690d07f372734e9278 host=robb-pro base=db7f6902bf16c466d5e5cfd5dabdc084c6080b16 run=loom-run/v1:timer:robb-pro/fleet-resync:92e2f9ba-d083-411b-833b-ae52d169ef04 installs=0.19.605 6eb2b65a4496b7becb84ef1f944493a541fd01cd -->
    Loom-Trace-Id: af273f717e759e690d07f372734e9278
    Loom-Build: unknown d6714830391f7596338b8de40ee2d0f45dcd12f5 clean
    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
2026-10-01 chore: resync installed Loom surfaces
    <!-- loom:provenance v1 build=unknown e956e9fee69e53f08b887ca20e14d9058d6f9aee clean prompts=none sweep=none story=none trace=1077dafeb758858c149dd37f4ece3c77 host=loom-worker-2 base=8a5873d0ab39581a8947c21270c8b8707e7b67ad run=loom-run/v1:timer:loom-worker-2/fleet-resync:e3773167b12d4b3aafa1f76848245174 installs=0.19.609 ff30576dacc8c2734b1c7434bedd29c47122caeb -->
    Loom-Trace-Id: 1077dafeb758858c149dd37f4ece3c77
    Loom-Build: unknown e956e9fee69e53f08b887ca20e14d9058d6f9aee clean
    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
2026-10-01 chore: resync installed Loom surfaces
    <!-- loom:provenance v1 build=unknown 617257919edc1b9b9ee27532c5ec1b8a64523388 clean prompts=none sweep=none story=none trace=dbafe4f8526617aa07c890721298a080 host=robb-studio base=c96756cc4895af91e72a52eb0ddfa039b9e38aa0 run=loom-run/v1:timer:robb-studio/fleet-resync:1817df66-02cc-4b27-927d-a38485da550a installs=0.19.610 c94891dd526cf6db5ee02045424c6913be522048 -->
    Loom-Trace-Id: dbafe4f8526617aa07c890721298a080
    Loom-Build: unknown 617257919edc1b9b9ee27532c5ec1b8a64523388 clean
    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
2026-10-01 chore: resync installed Loom surfaces
    <!-- loom:provenance v1 build=unknown a2a39ac2736eb2686e2c65412d939e67c0438a7d clean prompts=none sweep=none story=none trace=fc1a121767151aae5bd7427c683b7db6 host=robb-pro base=16e54656c2d059db2ecc25579d23a6d2e037ad02 run=loom-run/v1:timer:robb-pro/fleet-resync:708eb7c8-469d-4783-80b7-bafe142df3c4 installs=0.19.612 d25614656adcf70162da95c5e1035e99a0639a1a -->
    Loom-Trace-Id: fc1a121767151aae5bd7427c683b7db6
    Loom-Build: unknown a2a39ac2736eb2686e2c65412d939e67c0438a7d clean
    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
2026-10-01 chore: resync installed Loom surfaces
    <!-- loom:provenance v1 build=unknown 126c80914e42f913c4fc778d3ddce96daa2c7a77 clean prompts=none sweep=none story=none trace=15a20fbea7a00d0922b943088c80e19d host=loom-worker-1 base=667e06b7564134526b89ef2103cbef1998c37a89 run=loom-run/v1:script:loom-worker-1/fleet-resync:ecc423da-4625-49de-b25a-692fd669a029 installs=0.19.612 53aeb18c5541af6b068247d82f62daed412cc2c6 -->
    Loom-Trace-Id: 15a20fbea7a00d0922b943088c80e19d
    Loom-Build: unknown 126c80914e42f913c4fc778d3ddce96daa2c7a77 clean
    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
2026-10-01 chore: resync installed Loom surfaces
    <!-- loom:provenance v1 build=unknown 126c80914e42f913c4fc778d3ddce96daa2c7a77 clean prompts=none sweep=none story=none trace=a0a42bd10fcfa6d7cbcc9c021c406848 host=loom-worker-2 base=8436e83452694403887f648aee2e651faf685b4e run=loom-run/v1:timer:loom-worker-2/fleet-resync:9e174e6bb0fa41d786e4a86e45632b6f installs=0.19.612 6f0871dc66e62b36d8382ced980d2805bfd97e50 -->
    Loom-Trace-Id: a0a42bd10fcfa6d7cbcc9c021c406848
    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
2026-10-01 chore: resync installed Loom surfaces
    <!-- loom:provenance v1 build=unknown 8891f74a5d568fe3d13937ef37fd64371dd2738f clean prompts=none sweep=none story=none trace=1e216ea76cbd2b72542049c4c18c2817 host=loom-worker-1 base=f9bb3a847e9f0f21d881536f42aaa4a9a4c69993 run=loom-run/v1:timer:loom-worker-1/fleet-resync:679feba6c0f347d39eb5943ed77dc87b installs=0.19.612 62fa67f8756bdf59fdf744be053e5ef1709f1335 -->
    Loom-Trace-Id: 1e216ea76cbd2b72542049c4c18c2817
    Loom-Build: unknown 8891f74a5d568fe3d13937ef37fd64371dd2738f clean
    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
2026-10-01 chore: resync installed Loom surfaces
    <!-- loom:provenance v1 build=unknown 6f3411c8a63e68097dde01bce8a8422230f54218 clean prompts=none sweep=none story=none trace=9aa0a46bb352b9665fdaa5f5b3b85dd7 host=robb-pro base=0703a7684dbbf2d997a3c9edd305b958fa4d3c9d run=loom-run/v1:timer:robb-pro/fleet-resync:ca419e1d-6646-4678-ac7a-b263e4b5119e installs=0.19.612 7731400b3e3e1df39074564166edf656feb0999c -->
    Loom-Trace-Id: 9aa0a46bb352b9665fdaa5f5b3b85dd7
    Loom-Build: unknown 6f3411c8a63e68097dde01bce8a8422230f54218 clean
    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
2026-10-02 chore: resync installed Loom surfaces
    <!-- loom:provenance v1 build=unknown 13c0a3ef467a888520a6529ab34486ab8be826be clean prompts=none sweep=none story=none trace=41356080f367e491d5ff03f17bb98c27 host=loom-worker-2 base=073cb75f06318b080ccb942e88c766ad7da93675 run=loom-run/v1:timer:loom-worker-2/fleet-resync:44455fbcbab745abb92cea192fafbb1d installs=0.19.614 3c79f7b1d0cc14723e049cff4250ff7330804326 -->
    Loom-Trace-Id: 41356080f367e491d5ff03f17bb98c27
    Loom-Build: unknown 13c0a3ef467a888520a6529ab34486ab8be826be clean
    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
2026-10-02 chore: resync installed Loom surfaces
    <!-- loom:provenance v1 build=unknown ea2dd21f2ba310ec007d047ddfecc6cd27d220ac clean prompts=none sweep=none story=none trace=f04a67f3922788d2ccdd66578c8d18f9 host=loom-worker-1 base=d3db4a776674abaf869dec7fd3295e23482a3642 run=loom-run/v1:timer:loom-worker-1/fleet-resync:1c3b601dd998488595adc09040c007d4 installs=0.19.614 79f4897c5d3c78dbfc1b022f77d244838dbf4ccb -->
    Loom-Trace-Id: f04a67f3922788d2ccdd66578c8d18f9
    Loom-Build: unknown ea2dd21f2ba310ec007d047ddfecc6cd27d220ac clean
    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
2026-10-02 chore: resync installed Loom surfaces
    <!-- loom:provenance v1 build=unknown 6f3411c8a63e68097dde01bce8a8422230f54218 clean prompts=none sweep=none story=none trace=acb28d0049e0cc75536f96d503f6e814 host=robb-studio base=3c57ef0bd86f0f4da017e578b41e490aea87dbd9 run=loom-run/v1:timer:robb-studio/fleet-resync:85d2b1b5-e81d-40c3-ab6a-9a00efbc4ee2 installs=0.19.616 d86523eeadb32b95777f3cd3a76dd2f72f0bf792 -->
    Loom-Trace-Id: acb28d0049e0cc75536f96d503f6e814
    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
2026-10-02 chore: resync installed Loom surfaces
    <!-- loom:provenance v1 build=unknown 2b50bd69eddd038dd738465aa58a9ebca11410ac clean prompts=none sweep=none story=none trace=324e4f607054d0396cfdf8fdc01e93ae host=robb-pro base=612148f18bcf7f6f6ec3e394bf0d3c21ee98d45b run=loom-run/v1:timer:robb-pro/fleet-resync:a63799f1-2ad7-4946-b81d-2ec231bc2d2f installs=0.19.617 81cb2ad7e091b19d6a2b95d1add6938c2100d46b -->
    Loom-Trace-Id: 324e4f607054d0396cfdf8fdc01e93ae
    Loom-Build: unknown 2b50bd69eddd038dd738465aa58a9ebca11410ac clean
    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
2026-10-02 chore: resync installed Loom surfaces
    <!-- loom:provenance v1 build=unknown 00d92b326aed50280cd90dc116b7caec27668251 clean prompts=none sweep=none story=none trace=9a5d23cc82b6d3a1c83bfee47bd04970 host=loom-worker-2 base=10aa93f43c6381b1dfca0a689bb58824e6703ba1 run=loom-run/v1:timer:loom-worker-2/fleet-resync:12136a7a025d49f3a60b5edb04a3ff81 installs=0.19.619 4c0f505e4f0b76f8ccec07bda6d8b839030c077b -->
    Loom-Trace-Id: 9a5d23cc82b6d3a1c83bfee47bd04970
    Loom-Build: unknown 00d92b326aed50280cd90dc116b7caec27668251 clean
    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
2026-10-02 chore: resync installed Loom surfaces
    <!-- loom:provenance v1 build=unknown 456dad6d90259846313dc3bb80bf4e5471ef2d76 clean prompts=none sweep=none story=none trace=bb9688c03fb5211d06f48c8838a5505c host=robb-studio base=fd350f765de982b8f53c9268b480744a74324b74 run=loom-run/v1:timer:robb-studio/fleet-resync:e965c017-8ec7-485d-b46e-aeb399b81fb4 installs=0.19.620 0d28ba49f5a88fdb37271de9cb0144eb3442c6e3 -->
    Loom-Trace-Id: bb9688c03fb5211d06f48c8838a5505c
    Loom-Build: unknown 456dad6d90259846313dc3bb80bf4e5471ef2d76 clean
    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
2026-10-02 chore: resync installed Loom surfaces
    <!-- loom:provenance v1 build=unknown 6c6d2b6565dc13eff4c6811b9c670f452106516b clean prompts=none sweep=none story=none trace=539be979ae694d66ede516a7b5d17e41 host=robb-pro base=fd84ce902c7c0f1a214cacd35a2ec27513909e59 run=loom-run/v1:timer:robb-pro/fleet-resync:9444d216-de08-442f-8352-ba59f6e81bb3 installs=0.19.621 a90dc1d794eb9ff70aaf939ebf495abe716f3bdd -->
    Loom-Trace-Id: 539be979ae694d66ede516a7b5d17e41
    Loom-Build: unknown 6c6d2b6565dc13eff4c6811b9c670f452106516b clean
    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
2026-10-02 chore: resync installed Loom surfaces
    <!-- loom:provenance v1 build=unknown f6d28134bfe476967e005d97424073085f55e8a3 clean prompts=none sweep=none story=none trace=27eb90670d441065f593e941066ee005 host=loom-worker-2 base=c17d262fabccfffb7a9e0b8042f91c4da996c456 run=loom-run/v1:timer:loom-worker-2/fleet-resync:04001bba930241cf9e325bf304a9270a installs=0.19.623 ccc19c2bbe2aa65328427730fa53f70eb56128c6 -->
    Loom-Trace-Id: 27eb90670d441065f593e941066ee005
    Loom-Build: unknown f6d28134bfe476967e005d97424073085f55e8a3 clean
    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
2026-10-02 chore: resync installed Loom surfaces
    <!-- loom:provenance v1 build=unknown bc461736314499b6c2c4c0ad51fb2294f60336f5 clean prompts=none sweep=none story=none trace=c3ea68717dd3a908dbbd60a35bc8b5d6 host=robb-studio base=a15948bc619e86e5c4d07242b9ce018c8979db2d run=loom-run/v1:timer:robb-studio/fleet-resync:8d4c49e2-3258-4080-b0c8-082499053654 installs=0.19.623 a50aaf70069f8897c41a64b7d90783c5ab8294e0 -->
    Loom-Trace-Id: c3ea68717dd3a908dbbd60a35bc8b5d6
    Loom-Build: unknown bc461736314499b6c2c4c0ad51fb2294f60336f5 clean
    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
2026-10-02 chore: resync installed Loom surfaces
    <!-- loom:provenance v1 build=unknown bc461736314499b6c2c4c0ad51fb2294f60336f5 clean prompts=none sweep=none story=none trace=8bee8a664bfc89e0bbfbb3c2de7342ba host=loom-worker-2 base=2e936436e18c6554caf6fdc9a792aa678ff7ff5f run=loom-run/v1:timer:loom-worker-2/fleet-resync:de2ceceb48ea4927a1334d08dc0082fe installs=0.19.624 5f49564fa78ae06f8c48d5224dae9ded04200bb7 -->
    Loom-Trace-Id: 8bee8a664bfc89e0bbfbb3c2de7342ba
    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
2026-10-03 chore: resync installed Loom surfaces
    <!-- loom:provenance v1 build=unknown 752d316233ed1a3da9e4f69ad760eb99bb477747 clean prompts=none sweep=none story=none trace=7851839b67c00a023e97cbdea1f580e1 host=robb-pro base=1bdba0b878503fe793d31a04adf92350b8ac387b run=loom-run/v1:timer:robb-pro/fleet-resync:ae492b66-dca0-4da4-acab-8d26778f2d5c installs=0.19.624 121fac45f5006879bf58a18c951b9243d9099a18 -->
    Loom-Trace-Id: 7851839b67c00a023e97cbdea1f580e1
    Loom-Build: unknown 752d316233ed1a3da9e4f69ad760eb99bb477747 clean
    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
2026-10-03 chore: resync installed Loom surfaces
    <!-- loom:provenance v1 build=unknown b34a08286a42f47f917ec46647d4d167c1f5207c clean prompts=none sweep=none story=none trace=a8e453124b899b440f42c9d83837c7b6 host=loom-worker-2 base=82011b9d790e3f78bf9218038a4665c7f6714e4a run=loom-run/v1:timer:loom-worker-2/fleet-resync:f02dd5df715347fe90fe14b9353a1b66 installs=0.19.624 0162badc662fb30c070e70611aa8ff74a8486d54 -->
    Loom-Trace-Id: a8e453124b899b440f42c9d83837c7b6
    Loom-Build: unknown b34a08286a42f47f917ec46647d4d167c1f5207c clean
    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
2026-10-03 chore: resync installed Loom surfaces
    <!-- loom:provenance v1 build=unknown 3437cece5ab759f772122f8d18a6d2f05d246cde clean prompts=none sweep=none story=none trace=bba21427f750636f851279cfae92b4e5 host=loom-worker-1 base=d8472e1c7900833a677e0496965e6b2c37f3d0a6 run=loom-run/v1:timer:loom-worker-1/fleet-resync:9440cda9476f404caa282e360a81ee03 installs=0.19.636 e41edfbb52c13982f7d8b0577f42957427a6514c -->
    Loom-Trace-Id: bba21427f750636f851279cfae92b4e5
    Loom-Build: unknown 3437cece5ab759f772122f8d18a6d2f05d246cde clean
    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
2026-10-03 chore: resync installed Loom surfaces
    <!-- loom:provenance v1 build=unknown 28040ed11a4369e20f3b7b0154a3fb2a2c35d38c clean prompts=none sweep=none story=none trace=0cd87d01c45d97a2ee57a99363fc0db2 host=robb-studio base=5614b8ff40481a8dbd1225d264cb9c5bc28dc47d run=loom-run/v1:timer:robb-studio/fleet-resync:74b93657-6b04-4ac5-bc77-e0a1682b0595 installs=0.19.636 e41edfbb52c13982f7d8b0577f42957427a6514c -->
    Loom-Trace-Id: 0cd87d01c45d97a2ee57a99363fc0db2
    Loom-Build: unknown 28040ed11a4369e20f3b7b0154a3fb2a2c35d38c clean
    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
2026-10-03 chore: resync installed Loom surfaces
    <!-- loom:provenance v1 build=unknown 388c7fe0cad997f7a887f70c9f2cfe8781a2d512 clean prompts=none sweep=none story=none trace=2046ffd42f138a06b914f34851de3440 host=loom-worker-2 base=a04bf5b834b2be103973fe3b1397890964d0a31b run=loom-run/v1:timer:loom-worker-2/fleet-resync:17c9456bb1934c70a545b12081496cce installs=0.19.647 d1fe5dead4202be12a964ab891fd5980e7836170 -->
    Loom-Trace-Id: 2046ffd42f138a06b914f34851de3440
    Loom-Build: unknown 388c7fe0cad997f7a887f70c9f2cfe8781a2d512 clean
    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
2026-10-03 chore: resync installed Loom surfaces
    <!-- loom:provenance v1 build=unknown 8078c29e691123d91cd761a786f99cfd25f1809d clean prompts=none sweep=none story=none trace=45869a6374635c036a11a6f379fe31a4 host=robb-pro base=09e74d332ca367a9ca99f867933ba05b066221bd run=loom-run/v1:timer:robb-pro/fleet-resync:b0a94991-052d-4e7d-ba2b-78b971096849 installs=0.19.647 709ca4396e074e5a4d1c5e19721f6ddac7154ca2 -->
    Loom-Trace-Id: 45869a6374635c036a11a6f379fe31a4
    Loom-Build: unknown 8078c29e691123d91cd761a786f99cfd25f1809d clean
    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
2026-10-03 chore: resync installed Loom surfaces
    <!-- loom:provenance v1 build=unknown f9cba29b0602624a23daa17ae04d31d82e10fa91 clean prompts=none sweep=none story=none trace=754b3688f97b6c34894d8cfbf272b81a host=loom-worker-1 base=824b39d5a35ba7fe7e9998af183b949ab12b6a61 run=loom-run/v1:script:loom-worker-1/fleet-resync:11eb117a-9ff3-4411-88d4-fdd7d6748639 installs=0.19.649 6f2f13b1c31ce420e2250ae040d8e1050c0e761b -->
    Loom-Trace-Id: 754b3688f97b6c34894d8cfbf272b81a
    Loom-Build: unknown f9cba29b0602624a23daa17ae04d31d82e10fa91 clean
    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
2026-10-03 chore: resync installed Loom surfaces
    <!-- loom:provenance v1 build=unknown f9cba29b0602624a23daa17ae04d31d82e10fa91 clean prompts=none sweep=none story=none trace=544a028e3829d4020b8aaa144e5fa628 host=robb-studio base=f0d51df1c4806fc74e9ddb3158f0295a08ad89d9 run=loom-run/v1:script:robb-studio/fleet-resync:5b5b8b83-7139-447d-88bd-417dcf375aa6 installs=0.19.649 6f2f13b1c31ce420e2250ae040d8e1050c0e761b -->
    Loom-Trace-Id: 544a028e3829d4020b8aaa144e5fa628
    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
2026-10-03 chore: resync installed Loom surfaces
    <!-- loom:provenance v1 build=unknown f9cba29b0602624a23daa17ae04d31d82e10fa91 clean prompts=none sweep=none story=none trace=1057aaaf811f6dd2d64a3bb6d4b3ac49 host=robb-pro base=ecf940acda0a154f82d0501355f2276f1cd66e2b run=loom-run/v1:timer:robb-pro/fleet-resync:785c1ea0-d7f2-4810-99e9-cd9368aebe0c installs=0.19.649 2118aabb5a925f1ec4669b4d3d31176a46d8f2a6 -->
    Loom-Trace-Id: 1057aaaf811f6dd2d64a3bb6d4b3ac49
    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
2026-10-03 chore: resync installed Loom surfaces
    <!-- loom:provenance v1 build=unknown 72f61d9aa0fe08f1ef59f1a97a314e474455801e clean prompts=none sweep=none story=none trace=90666a75095c62a013be2ea121ab93f1 host=loom-worker-2 base=9888a9fffb486f93910e283c15aafa286305d794 run=loom-run/v1:script:loom-worker-2/fleet-resync:13865fad-1cac-4838-857f-34878fcba5d1 installs=0.19.652 235a64727b907d65529151af0a962b14f16462a0 -->
    Loom-Trace-Id: 90666a75095c62a013be2ea121ab93f1
    Loom-Build: unknown 72f61d9aa0fe08f1ef59f1a97a314e474455801e clean
    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
2026-10-03 chore: resync installed Loom surfaces
    <!-- loom:provenance v1 build=unknown 72f61d9aa0fe08f1ef59f1a97a314e474455801e clean prompts=none sweep=none story=none trace=845aaa0eb340f80f12095e2e8b421ed1 host=robb-pro base=7e1745e3a0e556169aa6014bd4425e32225837b4 run=loom-run/v1:script:robb-pro/fleet-resync:344add4b-df8a-49e8-8563-2765673acc76 installs=0.19.652 235a64727b907d65529151af0a962b14f16462a0 -->
    Loom-Trace-Id: 845aaa0eb340f80f12095e2e8b421ed1
    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
2026-10-03 feat: place and route the DR-0004 digital section with post-route evidence (#166)
    Part of #18. Reproducible klt place-and-route request, pinned tools,
    harness, routed geometry, DRC/LVS/16-corner post-route STA, routed
    co-sim and negative controls, append-only record.
    Loom-Story: 2AMLogic/sky130-trng#166
    Loom-Trace-Id: 72f0ddf2c9d78f9534d0356a7cc73bee
    Loom-Build: 0.19.652 235a64727b907d65529151af0a962b14f16462a0 clean
2026-10-03 chore: resync installed Loom surfaces
    <!-- loom:provenance v1 build=unknown 21130104346fe9c464ce8a3fdf82c1d3e9667639 clean prompts=none sweep=none story=none trace=36308fff5a3c323c3d1bf6fffb6cd122 host=robb-studio base=44317d10959ccde029202ba9222db6522865a8f6 run=loom-run/v1:timer:robb-studio/fleet-resync:89972fbd-0774-4402-bbb7-26c33a851735 installs=0.19.652 fb69233bd8f1dfc2bdee37d8b934f99274dc0193 -->
    Loom-Trace-Id: 36308fff5a3c323c3d1bf6fffb6cd122
    Loom-Build: unknown 21130104346fe9c464ce8a3fdf82c1d3e9667639 clean
    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
2026-10-03 refactor: share ro_array_core LVS negative-control logic
    Move perturb_width, perturb_topology, CONTROLS, the LVS request and the
    report loop out of both lvs-negative-controls.py copies into
    layout/ro_array_core/_lvs_negative_controls.py, following the
    _geom_common.py idiom. Both scripts become thin wrappers that keep their
    own input/output paths; tool_errors="exit" (live) converts BuildError to
    SystemExit, tool_errors="raise" (PoC) propagates it, as before.
    Committed lvs-negative-controls.json reports reproduce byte-identically.
    Closes #168
    Loom-Story: 2AMLogic/sky130-trng#168
    Loom-Trace-Id: d5f7e743585c24a4a4df582f598251d7
    Loom-Buil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
2026-10-04 docs: grade Challenge #4 proposal against post-#166 physical evidence (Part of #18)
    Add sign-off scorecard (AC1-4 explicit), correct stale 'no digital layout'
    claims, record digital die area vs the <0.05 mm2 row, re-check rules-4
    (404), document whole-block gap in layout/ and sim/ READMEs.
    Loom-Story: 2AMLogic/sky130-trng#18
    Loom-Trace-Id: 7fcdd417737c6d4660f676660538649a
    Loom-Build: 0.19.653 20928ea4080713480c010ea10914c11bad21fe5f clean
2026-10-04 chore: resync installed Loom surfaces
    <!-- loom:provenance v1 build=unknown 61870b40779d205c1555e801c6e1d95df083cdea clean prompts=none sweep=none story=none trace=fb9213e215442932d2af05f3b14977de host=robb-pro base=611964c1da4afe4e47874f6082d8a0e7782dd08c run=loom-run/v1:timer:robb-pro/fleet-resync:4c70cd1d-08cd-4add-8e2a-9a75160d163f installs=0.19.655 36c39e3c6f56e1979647ec235b4bd19c77db22f3 -->
    Loom-Trace-Id: fb9213e215442932d2af05f3b14977de
    Loom-Build: unknown 61870b40779d205c1555e801c6e1d95df083cdea clean
    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
2026-10-04 docs: reconcile remaining stale synthesis/power statements (PR #171 review)
    - §1/§3: digital section is synthesized (#117) and placed-and-routed (#166);
    per-ring liveness monitor remains the absent design item
    - §5.3 row-D bullet: remaining gaps are analog post-layout power and
    digital dynamic power (area and leakage exist)
    - Row D: split spliced sentence, drop doubled 'so'
    - Scorecard: AC1 cites §1-§5 below; follow-up cited as #170
    - Label the 2026-10-04 unpinned-klt DRC re-run as confirmatory, not recorded
    Loom-Build: 0.19.653 20928ea40807134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
2026-10-04 chore: resync installed Loom surfaces
    <!-- loom:provenance v1 build=unknown 61870b40779d205c1555e801c6e1d95df083cdea clean prompts=none sweep=none story=none trace=baa6c2cfcae1a320917c00ff2eb8b630 host=loom-worker-2 base=2646a47160182f0389a580e4e4cd838fb55702dc run=loom-run/v1:timer:loom-worker-2/fleet-resync:741a7f0f16df4fb1be4e657aeacd1244 installs=0.19.655 fc667a4faae1227f8a6837431f8a0c2d0aeaa7dd -->
    Loom-Trace-Id: baa6c2cfcae1a320917c00ff2eb8b630
    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
2026-10-04 chore: resync installed Loom surfaces
    <!-- loom:provenance v1 build=unknown b922acb2ac655cbccd71daa9e3f05a325a094ca5 clean prompts=none sweep=none story=none trace=833eeb34d4ca65c3f8c6f7824ddca3a3 host=robb-studio base=0aff50aa47b1fcb33eb7dd667491992987b92f27 run=loom-run/v1:timer:robb-studio/fleet-resync:0d44f6dc-6a62-4d43-b49d-7cfdd7dbd823 installs=0.19.663 0a51e373e7fe1be156c5774b2c827d4b745368a3 -->
    Loom-Trace-Id: 833eeb34d4ca65c3f8c6f7824ddca3a3
    Loom-Build: unknown b922acb2ac655cbccd71daa9e3f05a325a094ca5 clean
    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
2026-10-04 chore: resync installed Loom surfaces
    <!-- loom:provenance v1 build=unknown 746ecb5f9d7e64ba1d2526f1e997530ad4f3dd43 clean prompts=none sweep=none story=none trace=f09501431241df2ec5688e334ba43dfe host=loom-worker-2 base=a06d337d48da9f637cd01b76f93f185859a2639a run=loom-run/v1:timer:loom-worker-2/fleet-resync:70797dad61fb4e21806716d54f1ce910 installs=0.19.669 59a1f84e3742827a8033bb153ebbedc1759bee72 -->
    Loom-Trace-Id: f09501431241df2ec5688e334ba43dfe
    Loom-Build: unknown 746ecb5f9d7e64ba1d2526f1e997530ad4f3dd43 clean
    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
2026-10-04 chore: resync installed Loom surfaces
    <!-- loom:provenance v1 build=unknown 8080d0485cc1312129ee642b084944c56d1be074 clean prompts=none sweep=none story=none trace=ed180bcab6828041123ad54d8ddb4037 host=robb-pro base=9cc08b395c75645134c6f02c80963f03a631a064 run=loom-run/v1:timer:robb-pro/fleet-resync:e97b2f08-4ad9-4b66-a166-5b19820e2d1f installs=0.19.669 59a1f84e3742827a8033bb153ebbedc1759bee72 -->
    Loom-Trace-Id: ed180bcab6828041123ad54d8ddb4037
    Loom-Build: unknown 8080d0485cc1312129ee642b084944c56d1be074 clean
    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
2026-10-04 chore: resync installed Loom surfaces
    <!-- loom:provenance v1 build=unknown 83cb6647167ffc000d2c2f479b4e816b68f863f4 clean prompts=none sweep=none story=none trace=ccabffa1e1ba495895b262086030816c host=robb-studio base=6769f8e7d904bd3594ea9dcbb794d1e5445cd7aa run=loom-run/v1:timer:robb-studio/fleet-resync:88a78f1f-d978-47b5-99c3-2aabde811d17 installs=0.19.676 cd4f30bd892ea2595d8218b08150633504b0dd14 -->
    Loom-Trace-Id: ccabffa1e1ba495895b262086030816c
    Loom-Build: unknown 83cb6647167ffc000d2c2f479b4e816b68f863f4 clean
    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
2026-10-04 chore: resync installed Loom surfaces
    <!-- loom:provenance v1 build=unknown 32174d0f7e80508fa66c1a11a2c0fb28c515607e clean prompts=none sweep=none story=none trace=436d7c19b10cd5807625a7ce7190a82f host=loom-worker-2 base=5d72bfc4b1c85ddbd7aff849a058378dcff2a0a6 run=loom-run/v1:timer:loom-worker-2/fleet-resync:19ae50771cc04d8db7b1403c1e66bbea installs=0.19.682 9eccfa110fa294fa32a62ffe8eff669cfcf1a3a6 -->
    Loom-Trace-Id: 436d7c19b10cd5807625a7ce7190a82f
    Loom-Build: unknown 32174d0f7e80508fa66c1a11a2c0fb28c515607e clean
    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
2026-10-04 chore: resync installed Loom surfaces
    <!-- loom:provenance v1 build=unknown 72290fa960e0773b2c50d74042e24914c7327637 clean prompts=none sweep=none story=none trace=f7b6952a649a174398a48b90b6ab4793 host=robb-pro base=ba16ed13ffcd294045efb0e294ae183571950bd9 run=loom-run/v1:timer:robb-pro/fleet-resync:72f32482-5cc4-4b38-ab9e-4d2ef0b64e94 installs=0.19.684 bdb8fb331eb51c7def4cdd2c38b611af06f25f6d -->
    Loom-Trace-Id: f7b6952a649a174398a48b90b6ab4793
    Loom-Build: unknown 72290fa960e0773b2c50d74042e24914c7327637 clean
    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
2026-10-04 chore: resync installed Loom surfaces
    <!-- loom:provenance v1 build=unknown 76cda58637be0e74c4cb5b4c8dbc2000e2a9c3d4 clean prompts=none sweep=none story=none trace=614cbada5ce873c2b34a511816309cfc host=robb-studio base=cf4fd2eb987346223a6941c4485850f2d1a58cff run=loom-run/v1:timer:robb-studio/fleet-resync:7e559a3b-ffdd-409b-8dd2-ae906a273b0a installs=0.19.692 d4974b9f5ff7843a3cfc06378ea2a69bc120e0f4 -->
    Loom-Trace-Id: 614cbada5ce873c2b34a511816309cfc
    Loom-Build: unknown 76cda58637be0e74c4cb5b4c8dbc2000e2a9c3d4 clean
    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
2026-10-04 chore: resync installed Loom surfaces
    <!-- loom:provenance v1 build=unknown f84bac5c232c093f83c1adc2533d8c75b021cda2 clean prompts=none sweep=none story=none trace=e687830614e4bd1c551ab6cf6186f8f3 host=loom-worker-2 base=daa1cc521269252762349f59e548c98b11b324df run=loom-run/v1:timer:loom-worker-2/fleet-resync:2db2c4373ac24de1b7a364e69eaea1ca installs=0.19.695 b0d5b09f207fda439390ea1dd249ad10e7009dfc -->
    Loom-Trace-Id: e687830614e4bd1c551ab6cf6186f8f3
    Loom-Build: unknown f84bac5c232c093f83c1adc2533d8c75b021cda2 clean
    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
2026-10-04 chore: resync installed Loom surfaces
    <!-- loom:provenance v1 build=unknown ac5c275d1c616a9723e747f5a66de93dc80d3512 clean prompts=none sweep=none story=none trace=c777c3912bd31972e9aa3ccab712ae01 host=loom-worker-1 base=c0ed3a3aefac14e9586cd03306572f6675860a0e run=loom-run/v1:script:loom-worker-1/fleet-resync:b51a1b33-4958-4408-be36-166e12e8360b installs=0.19.697 ada83a5c7ff66b56b0060ef0be368c9fe56eb3c6 -->
    Loom-Trace-Id: c777c3912bd31972e9aa3ccab712ae01
    Loom-Build: unknown ac5c275d1c616a9723e747f5a66de93dc80d3512 clean
    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
2026-10-04 chore: resync installed Loom surfaces
    <!-- loom:provenance v1 build=unknown a19f642f5c09599c4c64827d81d228eb031be73e clean prompts=none sweep=none story=none trace=34a80e22764eb5055e37faec0eaf65fb host=robb-pro base=aacde571d8fdd36484cd0b32293315fb49b73231 run=loom-run/v1:script:robb-pro/fleet-resync:689be620-3ff2-4ff5-a2ce-f6825f6379e2 installs=0.19.698 aa619a1d07e36e8d90ac01fea63dc39285c93567 -->
    Loom-Trace-Id: 34a80e22764eb5055e37faec0eaf65fb
    Loom-Build: unknown a19f642f5c09599c4c64827d81d228eb031be73e clean
    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
2026-10-04 chore: resync installed Loom surfaces
    <!-- loom:provenance v1 build=unknown 693bdd794cb34afdefd7f0c4596824cd53078a61 clean prompts=none sweep=none story=none trace=7e7be58c80b40f1ac882b00139fb0ca0 host=robb-pro base=8fb82c7f6faee6c53252a6040810d23e2d223b7b run=loom-run/v1:timer:robb-pro/fleet-resync:d64fbd6b-5d9b-491d-9e17-742b375bfba7 installs=0.19.698 b814428b8333c69174c977498d1d2db6bce3145c -->
    Loom-Trace-Id: 7e7be58c80b40f1ac882b00139fb0ca0
    Loom-Build: unknown 693bdd794cb34afdefd7f0c4596824cd53078a61 clean
    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
2026-10-04 chore: resync installed Loom surfaces
    <!-- loom:provenance v1 build=unknown 693bdd794cb34afdefd7f0c4596824cd53078a61 clean prompts=none sweep=none story=none trace=aa18f1ec102a98d77ffc51c9be6ffbb3 host=robb-studio base=090fea6713d7c26d0aa5fa413765b061a685c309 run=loom-run/v1:script:robb-studio/fleet-resync:3cb89ca8-62c2-4a69-8434-c4aaa3b64eaf installs=0.19.698 a58f00e0681c50d6bfc5089d0af4b3715198319f -->
    Loom-Trace-Id: aa18f1ec102a98d77ffc51c9be6ffbb3
    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
2026-10-04 chore: resync installed Loom surfaces
    <!-- loom:provenance v1 build=unknown 7a41c2e69ef89d60ed3bd190b94838021bf18d0f clean prompts=none sweep=none story=none trace=d0f04f38b507d85402723643fcf47197 host=loom-worker-1 base=b54feee147a6212bd48ad36afcc716d2d0a2c527 run=loom-run/v1:script:loom-worker-1/fleet-resync:8fdc8c1c-f844-4c33-bc80-b424e5b4cf3d installs=0.19.703 89d5a428c652f957d7fad8a546589042d39911bc -->
    Loom-Trace-Id: d0f04f38b507d85402723643fcf47197
    Loom-Build: unknown 7a41c2e69ef89d60ed3bd190b94838021bf18d0f clean
    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
2026-10-05 chore: resync installed Loom surfaces
    <!-- loom:provenance v1 build=unknown ebb37db560de172930e261675a35bd52e429f650 clean prompts=none sweep=none story=none trace=a40e86a64366c7a1e36aea026901334f host=loom-worker-2 base=7f80f72ed722ab8033e6313885abcca7ef1ea07d run=loom-run/v1:script:loom-worker-2/fleet-resync:90b6cd74-6cc0-4f58-98ee-6ede0ac6f50c installs=0.19.703 f63c3c82e6bf202f2ca7b205b532f681c5ebb2c8 -->
    Loom-Trace-Id: a40e86a64366c7a1e36aea026901334f
    Loom-Build: unknown ebb37db560de172930e261675a35bd52e429f650 clean
    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
2026-10-05 feat(layout): whole-block composition of sampler_core + trng_digital (#172)
    Compose the verified analog and digital macros into one routed top cell
    trng_whole with a narrow compose-whole.py entry point (compose-cell.py and
    its full-chain --check are untouched): 18 whole-block nets / 22 legs routed
    on met5 via klt top_metal with the tool's via ladders, 107 digital pins
    promoted label-only, four dedicated vddr1-vddr4 routes to boundary pads,
    common vdd/vss and clk/rst_n, combined LVS reference, interface table and
    provenance. Independent re-extraction proves terminal connectivity and
    that the rails stay distinct; the build publishes only after every audit
    passes and is byte-reproducible.
    Verd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
2026-10-05 chore: resync installed Loom surfaces
    <!-- loom:provenance v1 build=unknown 7a41c2e69ef89d60ed3bd190b94838021bf18d0f clean prompts=none sweep=none story=none trace=fc04851db12f586b5d58155325131b6e host=robb-studio base=e58d52fb38401f90017d65764155c70d71b32a0f run=loom-run/v1:timer:robb-studio/fleet-resync:a7d5da6f-a896-4d6f-8d00-aebf47f9b266 installs=0.19.703 2ad9a08fb93de4d7dfac9d2b501d12c684c9c2cc -->
    Loom-Trace-Id: fc04851db12f586b5d58155325131b6e
    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
2026-10-05 chore: resync installed Loom surfaces
    <!-- loom:provenance v1 build=unknown afe7e99e397c242cc319fa80702fb3b23e23f5a7 clean prompts=none sweep=none story=none trace=e46782e1dd9c94461b4cf934ce05296b host=loom-worker-2 base=303ec2a824dfd40c0a714e1784cc96f3d0a9ebdd run=loom-run/v1:timer:loom-worker-2/fleet-resync:caa89259b1fd414ebd2f07500621166d installs=0.19.703 972fe7321be6a9efe2653579379ea3bc40b899b2 -->
    Loom-Trace-Id: e46782e1dd9c94461b4cf934ce05296b
    Loom-Build: unknown afe7e99e397c242cc319fa80702fb3b23e23f5a7 clean
    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
2026-10-05 chore: resync installed Loom surfaces
    <!-- loom:provenance v1 build=unknown b44cb904ebb599db793066ccc631c846862abfbd clean prompts=none sweep=none story=none trace=9590fed7c1b1c9f549ccf3cba24292d7 host=robb-pro base=e9833f5214c359de409fd3846586eeb0abbbc8b5 run=loom-run/v1:timer:robb-pro/fleet-resync:dbc6174e-403d-422d-98b6-73a4b6dbf44f installs=0.19.708 dc8faf1eae3143feda6301887c303b1ee45db7f4 -->
    Loom-Trace-Id: 9590fed7c1b1c9f549ccf3cba24292d7
    Loom-Build: unknown b44cb904ebb599db793066ccc631c846862abfbd clean
    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
2026-10-05 chore: resync installed Loom surfaces
    <!-- loom:provenance v1 build=unknown 4548905848fcb7cb875c1c0518f2fd88eb65818e clean prompts=none sweep=none story=none trace=aff5e139797705f6fa0811f102ecd103 host=loom-worker-1 base=8b1a91af46056922f9c290cefec63f509b1691d9 run=loom-run/v1:timer:loom-worker-1/fleet-resync:ba6a9e5686a64abaa842d71acaeae2ca installs=0.19.718 00d99344506bcf00e1aec7e910abe3d13df2d240 -->
    Loom-Trace-Id: aff5e139797705f6fa0811f102ecd103
    Loom-Build: unknown 4548905848fcb7cb875c1c0518f2fd88eb65818e clean
    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
2026-10-05 chore: resync installed Loom surfaces
    <!-- loom:provenance v1 build=unknown e7efbaa6e7b97a7d72da6032044c67525291f4d1 clean prompts=none sweep=none story=none trace=d74a33a6f35e329b3e795991e790ebfd host=robb-studio base=b50867dd879225f31ce098be9a86c6b425bc8b8f run=loom-run/v1:timer:robb-studio/fleet-resync:304f49c8-5b3e-46a9-a557-945b9ae177f0 installs=0.19.718 00d99344506bcf00e1aec7e910abe3d13df2d240 -->
    Loom-Trace-Id: d74a33a6f35e329b3e795991e790ebfd
    Loom-Build: unknown e7efbaa6e7b97a7d72da6032044c67525291f4d1 clean
    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
2026-10-05 fix(ci): find pdk-nightly tracker by body marker, not loom:triage (#178)
    Loom-Story: 2AMLogic/sky130-trng#178
    Loom-Trace-Id: 888e0f3127b3c1ea5c0b529b876992a4
    Loom-Build: 0.19.697 fac089879ca47a594146770a673a594fd7490de9 clean
2026-10-05 chore: resync installed Loom surfaces
    <!-- loom:provenance v1 build=unknown 347b71e65e709d9fd49aba75d3fb67877fc08818 clean prompts=none sweep=none story=none trace=f9653dd318724c98136e7cef63e551ed host=robb-pro base=f46edecfcb31e16940a4f74ae7d5652848e8c7ef run=loom-run/v1:timer:robb-pro/fleet-resync:cdc95970-9fb1-49fa-a0e6-037a3fab2099 installs=0.19.728 991dcebf6f6b2de6571f1d3400bec083498c6438 -->
    Loom-Trace-Id: f9653dd318724c98136e7cef63e551ed
    Loom-Build: unknown 347b71e65e709d9fd49aba75d3fb67877fc08818 clean
    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
2026-10-05 chore: resync installed Loom surfaces
    <!-- loom:provenance v1 build=unknown 5c0d18101f48fecb656f10fa37afa9b09bf41631 clean prompts=none sweep=none story=none trace=ddcf49552af364cbf6e884bd59584c1f host=loom-worker-1 base=1a21b60c46b0708b4423c79e71110a5b27587477 run=loom-run/v1:timer:loom-worker-1/fleet-resync:5eb526a05f244f1985770579e7620ff1 installs=0.19.731 7484b71fce5179a025950e71a82855afaf6fd730 -->
    Loom-Trace-Id: ddcf49552af364cbf6e884bd59584c1f
    Loom-Build: unknown 5c0d18101f48fecb656f10fa37afa9b09bf41631 clean
    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
2026-10-05 chore: resync installed Loom surfaces
    <!-- loom:provenance v1 build=unknown 0b160514b6658e3ab26a71c6525791da25b46fcf clean prompts=none sweep=none story=none trace=311c3eb2c0ab9550d3de38df5523f3d7 host=robb-studio base=50e38403c1f89c934a6ad432d63ec27416cff502 run=loom-run/v1:timer:robb-studio/fleet-resync:e6dec631-b42b-4cf2-b854-cc363cfde6e0 installs=0.19.731 d6146becf339a3d4e55e26e8807ac4571213a00b -->
    Loom-Trace-Id: 311c3eb2c0ab9550d3de38df5523f3d7
    Loom-Build: unknown 0b160514b6658e3ab26a71c6525791da25b46fcf clean
    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
2026-10-05 chore: resync installed Loom surfaces
    <!-- loom:provenance v1 build=unknown 5c0d18101f48fecb656f10fa37afa9b09bf41631 clean prompts=none sweep=none story=none trace=f1e8d4c6e73b8eec3e87a8da52e10f2d host=robb-pro base=7d634c3fb16f1a6fb9f4099e65448a5edb03cb1e run=loom-run/v1:timer:robb-pro/fleet-resync:5518fd33-81cb-479f-93f0-287ea4b08876 installs=0.19.733 4e67131ce3a1317d8cb8904ec342541cc2f45665 -->
    Loom-Trace-Id: f1e8d4c6e73b8eec3e87a8da52e10f2d
    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
2026-10-05 chore: resync installed Loom surfaces
    <!-- loom:provenance v1 build=unknown ca170d11544ef499cc9500a45bbad152edacfbd1 clean prompts=none sweep=none story=none trace=6dcfc713b6a851b40932158c2eeb70af host=loom-worker-3 base=7f399378cc7b974265b19d14832647047af7adff run=loom-run/v1:timer:loom-worker-3/fleet-resync:20ce0908ea5a468a9e055470104047ed installs=0.19.734 7ba6ea50c36dfdd2b5e2922dd22c65560980a5a2 -->
    Loom-Trace-Id: 6dcfc713b6a851b40932158c2eeb70af
    Loom-Build: unknown ca170d11544ef499cc9500a45bbad152edacfbd1 clean
    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
2026-10-05 chore: resync installed Loom surfaces
    <!-- loom:provenance v1 build=unknown 03f1c42302d15f8a83425a84a4e36ca484f3f625 clean prompts=none sweep=none story=none trace=f1bc879f8aa652d550764ffcd36e27d1 host=loom-worker-1 base=3201c17d24724b2a08e0fb6fff72537f24e7ac46 run=loom-run/v1:timer:loom-worker-1/fleet-resync:f302a3cc8558413492093df510b02418 installs=0.19.734 967abe71d019ce6606018b4e57dee0223b84d96f -->
    Loom-Trace-Id: f1bc879f8aa652d550764ffcd36e27d1
    Loom-Build: unknown 03f1c42302d15f8a83425a84a4e36ca484f3f625 clean
    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
2026-10-05 chore: resync installed Loom surfaces
    <!-- loom:provenance v1 build=unknown ce7557ba58624d48fedbca2bc037dfa8ce3943e7 clean prompts=none sweep=none story=none trace=e1f2558834c47835cd9a53ec8c9a2ffa host=loom-worker-3 base=7554717c25058cd129654757d1a1aa77af1c301e run=loom-run/v1:timer:loom-worker-3/fleet-resync:50f5f0046e2c4890961b3221bd360247 installs=0.19.734 ba9edb650872e5265eaca0c47f75e3cb828ecad2 -->
    Loom-Trace-Id: e1f2558834c47835cd9a53ec8c9a2ffa
    Loom-Build: unknown ce7557ba58624d48fedbca2bc037dfa8ce3943e7 clean
    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
2026-10-05 chore: resync installed Loom surfaces
    <!-- loom:provenance v1 build=unknown f92eaec38470a7b0732e065f4864faec9a1905d6 clean prompts=none sweep=none story=none trace=07aa020a8179d52651250562e9808b98 host=robb-studio base=6bc193424e6814792c09028d283b078accced24a run=loom-run/v1:timer:robb-studio/fleet-resync:3b3ebdf2-b5f7-48ed-b7bb-5fb945094061 installs=0.19.734 78f3e99c44d0af6d4598adf7577bb6676baf3e8f -->
    Loom-Trace-Id: 07aa020a8179d52651250562e9808b98
    Loom-Build: unknown f92eaec38470a7b0732e065f4864faec9a1905d6 clean
    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
2026-10-06 chore: resync installed Loom surfaces
    <!-- loom:provenance v1 build=unknown ca170d11544ef499cc9500a45bbad152edacfbd1 clean prompts=none sweep=none story=none trace=fca9c14d74d6d634726f5823c51bc62a host=loom-worker-2 base=0fa59683de32ab25d403fc00ae207c2172a053d3 run=loom-run/v1:timer:loom-worker-2/fleet-resync:23a23f0878c1494cb720941baddfea81 installs=0.19.741 3cede3920c6b567d5400789187a904970d46b0fb -->
    Loom-Trace-Id: fca9c14d74d6d634726f5823c51bc62a
    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
2026-10-06 chore: resync installed Loom surfaces
    <!-- loom:provenance v1 build=unknown e38a22941348fd8e83d1f4b06130d2a214adfb50 clean prompts=none sweep=none story=none trace=a7fe3a9a1fedfce89846c20f2e98ac31 host=robb-pro base=3a4a160f4a62585a50cc8f82da7cccacb4157c43 run=loom-run/v1:timer:robb-pro/fleet-resync:2d770a42-f0e7-4695-abfa-b912e75382e6 installs=0.19.744 8bc5bcce93c4d9721817387afe8b4b6d79f26054 -->
    Loom-Trace-Id: a7fe3a9a1fedfce89846c20f2e98ac31
    Loom-Build: unknown e38a22941348fd8e83d1f4b06130d2a214adfb50 clean
    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
2026-10-06 chore: resync installed Loom surfaces
    <!-- loom:provenance v1 build=unknown f66ea90ff1bdec51aa4c8dc3f4b2e8d26e3dfd2d clean prompts=none sweep=none story=none trace=66d96c3bb00b04fae967865ee02fc4de host=loom-worker-3 base=5994f3153c34a1db900b8346f8fe1a618d71e8ff run=loom-run/v1:timer:loom-worker-3/fleet-resync:eb2dceb410e848a19d58f96f678c995e installs=0.19.749 6135634b053dc30ef5aa8e6d733bfe79bb2ac734 -->
    Loom-Trace-Id: 66d96c3bb00b04fae967865ee02fc4de
    Loom-Build: unknown f66ea90ff1bdec51aa4c8dc3f4b2e8d26e3dfd2d clean
    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
2026-10-06 chore: resync installed Loom surfaces
    <!-- loom:provenance v1 build=unknown ade8a2c60cc8370d04d72f331141acb6fb32e121 clean prompts=none sweep=none story=none trace=6245fb88b5bdf9f7ccecb6b2168dc335 host=robb-studio base=dac8db3cc21a3c381cba9fdaa93508423bf5e15a run=loom-run/v1:timer:robb-studio/fleet-resync:b305aed2-1a25-4576-aca7-9b017ac4377e installs=0.19.755 8d97d322e1cb3723988504337089beca73d0511c -->
    Loom-Trace-Id: 6245fb88b5bdf9f7ccecb6b2168dc335
    Loom-Build: unknown ade8a2c60cc8370d04d72f331141acb6fb32e121 clean
    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
2026-10-06 chore: resync installed Loom surfaces
    <!-- loom:provenance v1 build=unknown 2489bb7d5203844b3fbe8efbe007f44aa074685d clean prompts=none sweep=none story=none trace=0b5c9263a55c09e6fbd870b2d9ff5d9b host=loom-worker-2 base=4016731fda8fa60bd6b8bea3046a023a7a319cf8 run=loom-run/v1:timer:loom-worker-2/fleet-resync:d3f5a5beb1144f72ac8be575767b3e03 installs=0.19.760 3a509582b179d91c2d5b5a65a7ba4650c3c08985 -->
    Loom-Trace-Id: 0b5c9263a55c09e6fbd870b2d9ff5d9b
    Loom-Build: unknown 2489bb7d5203844b3fbe8efbe007f44aa074685d clean
    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
2026-10-06 chore: resync installed Loom surfaces
    <!-- loom:provenance v1 build=unknown 986d16b700174622774ff68af4ef323e8d0e23ba clean prompts=none sweep=none story=none trace=cb518f1f5785c258556383940a46c461 host=loom-worker-1 base=4d354e5b3f95595eb9b4da8f8bb441d87c8523b0 run=loom-run/v1:timer:loom-worker-1/fleet-resync:97df92c5eca846de85e979810663a94b installs=0.19.765 c6cec65c4f320f11153c72e840e49a5d6a6f1afc -->
    Loom-Trace-Id: cb518f1f5785c258556383940a46c461
    Loom-Build: unknown 986d16b700174622774ff68af4ef323e8d0e23ba clean
    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
2026-10-06 chore: resync installed Loom surfaces
    <!-- loom:provenance v1 build=unknown 85e52221261264d7f7643251de706f00c8db289f clean prompts=none sweep=none story=none trace=a2434124d73d8cca0ca77230fc85adf5 host=robb-pro base=462463450b007c8bb8a6f2b2c821289a743c8338 run=loom-run/v1:timer:robb-pro/fleet-resync:abffb067-59ed-4a6e-94b6-8cf3500c935c installs=0.19.768 c9f7ca975144d991bce40f492403b8292e8b7fae -->
    Loom-Trace-Id: a2434124d73d8cca0ca77230fc85adf5
    Loom-Build: unknown 85e52221261264d7f7643251de706f00c8db289f clean
    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
2026-10-06 chore: resync installed Loom surfaces
    <!-- loom:provenance v1 build=unknown 31b34ebfd7d4539094523eaa7b56a104bebe5fc0 clean prompts=none sweep=none story=none trace=16fac36f144dc183c71465eb36c89afc host=loom-worker-3 base=deb9eb2665b415c7546154e1c30c539b748bf4de run=loom-run/v1:timer:loom-worker-3/fleet-resync:c763e24590314b918c8ee8df5d2de1db installs=0.19.769 af995a5725fdadf708127f006aa8f248b482d7d7 -->
    Loom-Trace-Id: 16fac36f144dc183c71465eb36c89afc
    Loom-Build: unknown 31b34ebfd7d4539094523eaa7b56a104bebe5fc0 clean
    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
2026-10-06 chore: resync installed Loom surfaces
    <!-- loom:provenance v1 build=unknown 7bed309263b3785eae46a9cbc53b3b24a52b10d2 clean prompts=none sweep=none story=none trace=843adbd5eac450c43d3a2c43da1bf729 host=robb-studio base=7047d1b02a48e75b84daf5123356a1619f53db86 run=loom-run/v1:timer:robb-studio/fleet-resync:f83d5ba4-81f7-479a-9768-6af33d4cc825 installs=0.19.783 a9b459e0c2b1916ceb116db33053e7eb0df57e7b -->
    Loom-Trace-Id: 843adbd5eac450c43d3a2c43da1bf729
    Loom-Build: unknown 7bed309263b3785eae46a9cbc53b3b24a52b10d2 clean
    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
2026-10-06 chore: resync installed Loom surfaces
    <!-- loom:provenance v1 build=unknown 07bc40ba9ab0f7dfe7cd0990377b7ac07a52d220 clean prompts=none sweep=none story=none trace=563f186108419cf03cef002a62c3b201 host=loom-worker-2 base=22636fdffe7fc6b7cff7dc8820285382e59c69a4 run=loom-run/v1:timer:loom-worker-2/fleet-resync:944beccd157a4197b81feafdd19f443e installs=0.19.785 2f0a9dbb4f06053f747b8a5615a3519f8e30b527 -->
    Loom-Trace-Id: 563f186108419cf03cef002a62c3b201
    Loom-Build: unknown 07bc40ba9ab0f7dfe7cd0990377b7ac07a52d220 clean
    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
2026-10-06 chore: resync installed Loom surfaces
    <!-- loom:provenance v1 build=unknown 31b34ebfd7d4539094523eaa7b56a104bebe5fc0 clean prompts=none sweep=none story=none trace=ea6600df41a4b420b6d8e967f839ccfd host=loom-worker-3 base=c8b31ba17e804f122e5bb00a895feca5b02242b6 run=loom-run/v1:timer:loom-worker-3/fleet-resync:c80415b48fd5404bbd599c4f6cc8a448 installs=0.19.793 7ceff96944c39d33e3c2f1141ca650c2c4c05679 -->
    Loom-Trace-Id: ea6600df41a4b420b6d8e967f839ccfd
    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
2026-10-06 chore: resync installed Loom surfaces
    <!-- loom:provenance v1 build=unknown 596a53e525683919daae1b43e6babe9bf847a02f clean prompts=none sweep=none story=none trace=b9c0cb42a5a72ecc21726229c957ef1f host=loom-worker-2 base=637cb97d3560bcabb48e810c71cde9fbbfc92786 run=loom-run/v1:timer:loom-worker-2/fleet-resync:21d578f5cc0b4b7ba5f10759f5f30ae8 installs=0.19.801 524bdb33cb26c8355454d7550413c89e72c06fae -->
    Loom-Trace-Id: b9c0cb42a5a72ecc21726229c957ef1f
    Loom-Build: unknown 596a53e525683919daae1b43e6babe9bf847a02f clean
    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
2026-10-06 chore: resync installed Loom surfaces
    <!-- loom:provenance v1 build=unknown 40b591a33adb895d4f46977105f9b264d8a2599b clean prompts=none sweep=none story=none trace=e41c725fe0c176312eb412bc69fe5b01 host=robb-studio base=a7c7934e983d553af861fc27ab3154c278d59d46 run=loom-run/v1:timer:robb-studio/fleet-resync:37d704dd-4dfd-4341-adb4-6551637ad147 installs=0.19.802 72ce1f7385747dd773d1644408ec22072b8a5d20 -->
    Loom-Trace-Id: e41c725fe0c176312eb412bc69fe5b01
    Loom-Build: unknown 40b591a33adb895d4f46977105f9b264d8a2599b clean
    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
2026-10-06 chore: resync installed Loom surfaces
    <!-- loom:provenance v1 build=unknown 31b34ebfd7d4539094523eaa7b56a104bebe5fc0 clean prompts=none sweep=none story=none trace=5ad0480c4b21b80f9c852c448319e7a1 host=loom-worker-3 base=4c158fedce5191c43e702cb35ebc46597c63384e run=loom-run/v1:timer:loom-worker-3/fleet-resync:48e836f11f9547ddb96de5aa0d072a05 installs=0.19.810 933f828e779602e492e4e157812988a4b8128111 -->
    Loom-Trace-Id: 5ad0480c4b21b80f9c852c448319e7a1
    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
2026-10-07 chore: resync installed Loom surfaces
    <!-- loom:provenance v1 build=unknown f71cf25de9e75bae6060da4a599df8fbabe75890 clean prompts=none sweep=none story=none trace=64943e35511da4833bbd385cf288be8a host=loom-worker-2 base=1be54984fd23b70d21c03c2053d2c38cfae127f9 run=loom-run/v1:timer:loom-worker-2/fleet-resync:d69eb1b87d4849ae810a145b1b667d2f installs=0.19.822 1c6969ea8726c800a353c236d9f23456a5706f1a -->
    Loom-Trace-Id: 64943e35511da4833bbd385cf288be8a
    Loom-Build: unknown f71cf25de9e75bae6060da4a599df8fbabe75890 clean
    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
2026-10-07 chore: resync installed Loom surfaces
    <!-- loom:provenance v1 build=unknown 31b34ebfd7d4539094523eaa7b56a104bebe5fc0 clean prompts=none sweep=none story=none trace=cb192cb8f72cf6f2711f73f7ee12bebc host=loom-worker-3 base=a43e2472bef486315c84d63852d906cf529b73df run=loom-run/v1:timer:loom-worker-3/fleet-resync:c1e385c3607e43ad8bed9c7d29811c66 installs=0.19.830 a966f7b89b714704fa1225b96e2dbee50480a4c6 -->
    Loom-Trace-Id: cb192cb8f72cf6f2711f73f7ee12bebc
    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
2026-10-07 chore: resync installed Loom surfaces
    <!-- loom:provenance v1 build=unknown 8abdd34fddc879aff407380278baa713eca6b758 clean prompts=none sweep=none story=none trace=ea945665dad5ccb3880de51c4448e8b9 host=robb-pro base=29ebd4acf05bb889208259713e8f2c32672a0b8f run=loom-run/v1:timer:robb-pro/fleet-resync:1466e397-b80c-46ea-a42c-26a7fbd4e00e installs=0.19.831 61814c9c1912925cdff7418842ff3ea17cd56fe4 -->
    Loom-Trace-Id: ea945665dad5ccb3880de51c4448e8b9
    Loom-Build: unknown 8abdd34fddc879aff407380278baa713eca6b758 clean
    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
2026-10-07 chore: resync installed Loom surfaces
    <!-- loom:provenance v1 build=unknown 628be5bb140bcff803d159201bd61e1b868901b0 clean prompts=none sweep=none story=none trace=093df1dc315c5e78dcccfca9d699d5f5 host=loom-worker-2 base=9e5c9bef809bbe2681acc6f48085ead4da7106ba run=loom-run/v1:timer:loom-worker-2/fleet-resync:0b0ea5e184c0429a9c431fcca6c791ad installs=0.19.832 1a0fc15974bf0575a9155fb8276f7529fc813542 -->
    Loom-Trace-Id: 093df1dc315c5e78dcccfca9d699d5f5
    Loom-Build: unknown 628be5bb140bcff803d159201bd61e1b868901b0 clean
    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
2026-10-07 chore: resync installed Loom surfaces
    <!-- loom:provenance v1 build=unknown 069e3b45d86c08f0d60c8fc2b0096de441e99bdc clean prompts=none sweep=none story=none trace=b1ba9d6b2b581e47827d9c099f717b04 host=loom-worker-1 base=b6721b538bef1710f9326f67267b7425317890cf run=loom-run/v1:timer:loom-worker-1/fleet-resync:aada8278bd4843bcaecce69fdf91251e installs=0.19.838 e70aa17f8dead31bda49cf044c3fc28119df6e90 -->
    Loom-Trace-Id: b1ba9d6b2b581e47827d9c099f717b04
    Loom-Build: unknown 069e3b45d86c08f0d60c8fc2b0096de441e99bdc clean
    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
2026-10-07 chore: resync installed Loom surfaces
    <!-- loom:provenance v1 build=unknown 31b34ebfd7d4539094523eaa7b56a104bebe5fc0 clean prompts=none sweep=none story=none trace=ef030e94bce76f728497f5927960865f host=loom-worker-3 base=d587b1b2fe1f8e2deb78ab3a391e63a9faab7514 run=loom-run/v1:timer:loom-worker-3/fleet-resync:28ba4284bfa446c888b501714eda0509 installs=0.19.840 59b533a2a1ed5e186fbf8446b5acbe42d7231854 -->
    Loom-Trace-Id: ef030e94bce76f728497f5927960865f
    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
2026-10-07 chore: resync installed Loom surfaces
    <!-- loom:provenance v1 build=unknown bc59c70c3412a87b31a0dbe65cd6abf968744328 clean prompts=none sweep=none story=none trace=766033e4e881801f24971d664c490ea3 host=robb-studio base=6988f12657572e05403a385f916be2aa4b9a629f run=loom-run/v1:timer:robb-studio/fleet-resync:6b3b079a-890e-4a79-9c3a-0b4bb33ff7c4 installs=0.19.840 59b533a2a1ed5e186fbf8446b5acbe42d7231854 -->
    Loom-Trace-Id: 766033e4e881801f24971d664c490ea3
    Loom-Build: unknown bc59c70c3412a87b31a0dbe65cd6abf968744328 clean
    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
2026-10-07 chore: resync installed Loom surfaces
    <!-- loom:provenance v1 build=unknown a068938e7a6c13759bcb3943e408273a3d352257 clean prompts=none sweep=none story=none trace=76bec863c8f6aff2d49b3aa2be128619 host=robb-pro base=48a179a29a7c00b453d1596146fd941d93f2a473 run=loom-run/v1:timer:robb-pro/fleet-resync:d9927fc6-ee80-4b6a-ba2b-f13576bd5f9b installs=0.19.846 837b14d7440b89ae8a2cec6d045483ac33659af5 -->
    Loom-Trace-Id: 76bec863c8f6aff2d49b3aa2be128619
    Loom-Build: unknown a068938e7a6c13759bcb3943e408273a3d352257 clean
    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
2026-10-07 chore: resync installed Loom surfaces
    <!-- loom:provenance v1 build=unknown 628be5bb140bcff803d159201bd61e1b868901b0 clean prompts=none sweep=none story=none trace=5a6f676b4652a1a750bbce1386c68d06 host=loom-worker-2 base=e25e744f34e39872815b74ecf45a9dafdd6e5d92 run=loom-run/v1:timer:loom-worker-2/fleet-resync:bd416e653be04ef4b13353430625e379 installs=0.19.850 3bb4bfc90603b6ad65cabca9b3eb42a59f1a9d3a -->
    Loom-Trace-Id: 5a6f676b4652a1a750bbce1386c68d06
    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
2026-10-07 chore: resync installed Loom surfaces
    <!-- loom:provenance v1 build=unknown 40215645df8a13508180b248b44244dc488bb078 clean prompts=none sweep=none story=none trace=29fde30615e6e47f39b41aa314c2c883 host=loom-worker-1 base=5023cb955013c6316ccee3c14bba8996649c4142 run=loom-run/v1:timer:loom-worker-1/fleet-resync:d1fbedfcc7824ae59233c0ea94dc4650 installs=0.19.853 2889d5ed585b4da0935543cb916381cc03b19746 -->
    Loom-Trace-Id: 29fde30615e6e47f39b41aa314c2c883
    Loom-Build: unknown 40215645df8a13508180b248b44244dc488bb078 clean
    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
2026-10-07 chore: resync installed Loom surfaces
    <!-- loom:provenance v1 build=unknown 31b34ebfd7d4539094523eaa7b56a104bebe5fc0 clean prompts=none sweep=none story=none trace=cdf49c615da3f5ce46e9fcda1a24f787 host=loom-worker-3 base=cf003ce60877e2f7b22a22d5833670e7701b72c0 run=loom-run/v1:timer:loom-worker-3/fleet-resync:cab31e05b8a24df09bc88f53ee3fb501 installs=0.19.857 7a0b529e6f57a79713f6924bf58d8392ff404259 -->
    Loom-Trace-Id: cdf49c615da3f5ce46e9fcda1a24f787
    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
2026-10-07 docs: reconcile Challenge #4 scorecard against whole-block composition (Part of #18)
    Update docs/chipalooza/challenge-4-proposal.md, layout/README.md and
    sim/README.md now that #172 has composed sampler_core + trng_digital
    into layout/trng_whole/.
    - The scorecard records the composition as existing (composition only).
    Block DRC, block LVS and whole-block post-layout PVT stay UNMET (#173,
    #174). The vddr1-vddr4 geometry exists but nothing has been measured
    on it. Area row I is Unmet at 0.126116 mm2 (2.52x the < 0.05 mm2
    target, which is unchanged).
    - The analog sampler_core DRC row now says it is clean only on its
    pinned klt 0.4.0 deck. The current klt deck reports 5664
    licon1.on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
2026-10-07 chore: resync installed Loom surfaces
    <!-- loom:provenance v1 build=unknown 4b44e7c5db0de1d2b5927de7de229120d546aad3 clean prompts=none sweep=none story=none trace=dfa656ee3483a044378501f49d36f812 host=robb-studio base=8f921f24a5629af118d72c7901942863f0c74a5e run=loom-run/v1:timer:robb-studio/fleet-resync:d80d6bc0-eb68-4a07-8226-2d947d328b3a installs=0.19.859 0aefebd79aba8ab33470f1af4b96847fc794bd0d -->
    Loom-Trace-Id: dfa656ee3483a044378501f49d36f812
    Loom-Build: unknown 4b44e7c5db0de1d2b5927de7de229120d546aad3 clean
    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
2026-10-07 chore: resync installed Loom surfaces
    <!-- loom:provenance v1 build=unknown b591c8cf436f0d4aa5870a9bc7cd5f7194e0e778 dirty prompts=none sweep=none story=none trace=6eca4b0c47205457aae7a3d721c17f17 host=robb-pro base=5cee649f64e46709d1431d879ea48172b6dec8fc run=loom-run/v1:timer:robb-pro/fleet-resync:64af20b3-58cb-47f2-b770-117197cb41e9 installs=0.19.864 128a7eba2bb5f7bcf8891ba284b14cb7ebf8dd3d -->
    Loom-Trace-Id: 6eca4b0c47205457aae7a3d721c17f17
    Loom-Build: unknown b591c8cf436f0d4aa5870a9bc7cd5f7194e0e778 dirty
    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
2026-10-07 chore: resync installed Loom surfaces
    <!-- loom:provenance v1 build=unknown b551219fd5b8347113c0cbc79ea416e81c39fa9d clean prompts=none sweep=none story=none trace=5ac7c8c62dad54841e21dd94f0920de3 host=loom-worker-2 base=776947b407a0b03385b232ad3df93eeb5f2b4691 run=loom-run/v1:timer:loom-worker-2/fleet-resync:d10fb10789e94930ab1af368c15a8f8b installs=0.19.864 128a7eba2bb5f7bcf8891ba284b14cb7ebf8dd3d -->
    Loom-Trace-Id: 5ac7c8c62dad54841e21dd94f0920de3
    Loom-Build: unknown b551219fd5b8347113c0cbc79ea416e81c39fa9d clean
    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
2026-10-07 fix(layout): regenerate the analog cell chain on the klt cut-size/grid fix
    Rebuild all nineteen layout/*/cell.json cells bottom-up on klayout-tools
    source commit 5edb557f91d0 (klayout-tools#2778, the #2648 fix). Older
    generators drew every licon1/mcon/via cut as a PDK-generic 0.22 um
    square, with 1416 guard_ring licon1 centres 2 nm off the 0.005 um grid.
    On the current curated sky130 deck, the pre-change sampler_core.gds gives
    5664 licon1.ongrid.1 + 198 via.width.1 findings. The regenerated stream
    gives 0, and no rule is waived.
    Only the cut layers change: sky130-fixed 0.17/0.17/0.15 um sizes, with
    licon1 centres snapped onto the grid. Every other layer, every stage bbox
    and every LVS devic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
2026-10-07 chore: resync installed Loom surfaces
    <!-- loom:provenance v1 build=unknown 90fbd167e4e376894396e651676cf58fc9aa223a clean prompts=none sweep=none story=none trace=196876656e912171b28029ceca9f772d host=loom-worker-1 base=8bc29f6dadb4ec742a387a5384f18edd58d6f645 run=loom-run/v1:timer:loom-worker-1/fleet-resync:7b46720ff3a84a8184f2f2b3bc039260 installs=0.19.868 ee904e1c151bc9cf15b0eb55dfe9d57ad6136cff -->
    Loom-Trace-Id: 196876656e912171b28029ceca9f772d
    Loom-Build: unknown 90fbd167e4e376894396e651676cf58fc9aa223a clean
    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
2026-10-07 feat(layout,sim): re-extract layout/pex* on the #181 geometry; re-measure assembled ring via klt sim batch (#184)
    Loom-Story: 2AMLogic/sky130-trng#184
    Loom-Trace-Id: 79a7f323a934db1f56863797aef5dac7
    Loom-Build: 0.19.868 ee904e1c151bc9cf15b0eb55dfe9d57ad6136cff clean
2026-10-08 chore: resync installed Loom surfaces
    <!-- loom:provenance v1 build=unknown 5a3df331a0612dee585ef905015af01d08e3467f clean prompts=none sweep=none story=none trace=5690fa95febe608e500a46dde8a6ee92 host=loom-worker-2 base=87ede57978f353652eb1eb3d12dc42b6a2588546 run=loom-run/v1:timer:loom-worker-2/fleet-resync:5c9c35d59b704bff9d8bf096ee7ba7be installs=0.19.876 b16d54e63fbbec4d7f15f13c1f43a5e5b38145ce -->
    Loom-Trace-Id: 5690fa95febe608e500a46dde8a6ee92
    Loom-Build: unknown 5a3df331a0612dee585ef905015af01d08e3467f clean
    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
2026-10-08 chore: resync installed Loom surfaces
    <!-- loom:provenance v1 build=unknown 134eb3ff06c1a86f49a911c6c17464f55e719736 clean prompts=none sweep=none story=none trace=c7df110d490314040dcd1347b2481843 host=loom-worker-1 base=011d3ff2819e714b662b1c5623583eb20e8ecf7d run=loom-run/v1:timer:loom-worker-1/fleet-resync:53d0cec2cd61484eb9a0f8fb1f24ac5e installs=0.19.879 c15619905bdd8a24506c3853f45490d26e8f1cad -->
    Loom-Trace-Id: c7df110d490314040dcd1347b2481843
    Loom-Build: unknown 134eb3ff06c1a86f49a911c6c17464f55e719736 clean
    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
2026-10-08 chore: resync installed Loom surfaces
    <!-- loom:provenance v1 build=unknown 8f86de23319d8f6cf049557dcc9cf2e321211d9d clean prompts=none sweep=none story=none trace=17de45f778fbfd714af8afad02c96375 host=loom-worker-3 base=8012ddcd60f3b88a5a3163da5b98358caf1d231c run=loom-run/v1:timer:loom-worker-3/fleet-resync:9e3e5d4a08824de3b7bc02940be2a0da installs=0.19.882 c9f85af3d967986cdd7a3f27e088a16f88712b05 -->
    Loom-Trace-Id: 17de45f778fbfd714af8afad02c96375
    Loom-Build: unknown 8f86de23319d8f6cf049557dcc9cf2e321211d9d clean
    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
2026-10-08 feat(sim): SP 800-22-style battery and non-MCV SP 800-90B estimators for raw bits (#189)
    Loom-Story: 2AMLogic/sky130-trng#189
    Loom-Trace-Id: 76a7319fce8803549769237262d9d9c1
    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
2026-10-08 ci: run sim/tests unit tests in the lint job (#190)
    Loom-Story: 2AMLogic/sky130-trng#190
    Loom-Trace-Id: f1753c564dfccb999f4d37eb285931cd
    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
2026-10-08 feat(sim): raw-bit volume campaign, >=1e5 behavioral bits per tt/ss/ff corner (#188)
    Calibrated behavioral jitter model with transistor cross-checks; records
    level: behavioral, Ts = 20 us and 100 ns, provisional until silicon.
    Loom-Story: 2AMLogic/sky130-trng#188
    Loom-Trace-Id: be0c592f8a39d2aed3e20980b9b87036
    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
    [make-requests.py]
2026-10-08 chore: resync installed Loom surfaces
    <!-- loom:provenance v1 build=unknown 4a5fb2b6276e17ff26ee1382acfe2ea7360ebea5 clean prompts=none sweep=none story=none trace=67857e1b7189785825a2dfc70921cf85 host=loom-worker-2 base=7c9ccde031e4d7ee138a8f24c3ea898d7e4bd3d3 run=loom-run/v1:timer:loom-worker-2/fleet-resync:dd6a5f3dceff4d8d8602a07a1dc89c95 installs=0.19.892 ce93e8a919d79a6f027bab268846a52084f9d94e -->
    Loom-Trace-Id: 67857e1b7189785825a2dfc70921cf85
    Loom-Build: unknown 4a5fb2b6276e17ff26ee1382acfe2ea7360ebea5 clean
    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
2026-10-08 chore: resync installed Loom surfaces
    <!-- loom:provenance v1 build=unknown b591c8cf436f0d4aa5870a9bc7cd5f7194e0e778 dirty prompts=none sweep=none story=none trace=28e7ca5fdb768489aa38bf002407d5a5 host=robb-pro base=3437c1d3390d76b47f0ca7bf65bf737627982f57 run=loom-run/v1:timer:robb-pro/fleet-resync:eb5f838e-a774-4e20-8102-c37ee3ff31ca installs=0.19.895 9b30d293bcba1e79d49cabfc1c5bb5b6f4c0dc77 -->
    Loom-Trace-Id: 28e7ca5fdb768489aa38bf002407d5a5
    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
2026-10-08 chore: resync installed Loom surfaces
    <!-- loom:provenance v1 build=unknown 5684fc8c8ac418d95ad66a002d001eaea1283c9a clean prompts=none sweep=none story=none trace=c864acd3b9a5dbb419fddd8bd2a6283b host=loom-worker-3 base=8e21dba29f81e23452ff7a31a43aabd8e6fd8bbb run=loom-run/v1:timer:loom-worker-3/fleet-resync:4771e7c630c34445b7f28539669d76e3 installs=0.19.898 3d55b9a1669c132d130d98f10a292c1325322c30 -->
    Loom-Trace-Id: c864acd3b9a5dbb419fddd8bd2a6283b
    Loom-Build: unknown 5684fc8c8ac418d95ad66a002d001eaea1283c9a clean
    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
2026-10-08 Run SP 800-22 battery and 90B estimators on the #188 volume streams (#195)
    Adds an explicit --volume-record adapter, --check replay, tests, README
    usage, and the derived evidence record for the 18 committed streams.
    Loom-Story: 2AMLogic/sky130-trng#195
    Loom-Trace-Id: aa2eedffbbd4c733d78e55c57e2fb208
    Loom-Build: 0.19.898 3d55b9a1669c132d130d98f10a292c1325322c30 clean
2026-10-08 Parameterize combining-deck batch requests and hot-corner model plumbing for #197 (partial: sim evidence blocked)
    Adds make-requests.py --deck combining, derive-combining.py, --set hot and
    hot PVT points in behavioral_raw_bit.py, README and tests. The 125 C combining
    klt sim batch jobs were refused by the fleet, so no records are minted.
    Loom-Story: 2AMLogic/sky130-trng#197
    Loom-Trace-Id: 5a0d7cb8fff647ace0d420e0c5c623b9
    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
2026-10-08 Add 125 C combining records and hot volume record for #197
    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
2026-10-08 chore: resync installed Loom surfaces
    <!-- loom:provenance v1 build=unknown 04a1189116c7320def7d9ce357d2d9268405ae92 clean prompts=none sweep=none story=none trace=8e55b27fc60ffb045554bd413ad8f3c8 host=robb-pro base=4ff136e7cbdd4e51ef790f873090affe2bcd7914 run=loom-run/v1:timer:robb-pro/fleet-resync:83b69005-7c5b-44b3-96f8-33f07bf82f4b installs=0.19.917 d3c1ea3a4c81e01ce5487dc3e4bbdd86534e677e -->
    Loom-Trace-Id: 8e55b27fc60ffb045554bd413ad8f3c8
    Loom-Build: unknown 04a1189116c7320def7d9ce357d2d9268405ae92 clean
    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
2026-10-08 Re-derive and empirically validate RCT/APT cutoffs against estimated H (#196)
    Adds health-test-replay.py (re-derive at estimated Ts=20us min-H, replay
    through HealthMonitor/RCT/APT, seeded failure injection with detection
    latency), its unit test + CI step, the minted record, and the derived
    min-entropy record for the 125 C streams (#197) so the hot corner is covered.
    Loom-Story: 2AMLogic/sky130-trng#196
    Loom-Trace-Id: f59c2859d845908b45c46f75473fb811
    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
2026-10-08 feat: whole-block DRC, mixed-level LVS and fault controls for trng_whole (#173)
    Clean DRC (0 violations) and a mixed-level LVS match (analog transistor level,
    digital standard-cell level, 123 name-anchored pins) over the composed stream,
    with a per-port coverage matrix, named limitations, and five isolated fault
    controls (swapped signal x3, disconnected interface, distinct-supply short) that
    each reach LVS and fail naming their nets. Not foundry sign-off.
    Loom-Story: 2AMLogic/sky130-trng#173
    Loom-Trace-Id: 226eee62c021701bd346dad60dd44e36
    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
2026-10-08 fix(verify-whole): honour --no-publish for controls; refuse partial --only publication (#173)
    The controls/all dispatcher called publish_controls unconditionally, so a
    `controls --no-publish --only <id>` debug run overwrote the canonical
    full fault-control campaign evidence with a one-control result.
    - guard publish_controls with `not args.no_publish`
    - reject `--only` on controls/all unless `--no-publish` is given, before
    any stage runs, so a partial campaign can never replace the full one
    - add dispatcher regression tests for `controls` and `all` with the
    expensive stages stubbed and evidence dirs redirected to a temp dir
    Loom-S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
2026-10-08 chore: resync installed Loom surfaces
    <!-- loom:provenance v1 build=unknown d2a55ce217b3ad1793611a2c54946676bb55b512 clean prompts=none sweep=none story=none trace=459637e4e8503593bdf58360865a7524 host=robb-pro base=3185b4a8d901a483c45ef9202230b0fd4580c919 run=loom-run/v1:timer:robb-pro/fleet-resync:95b3cf92-9cd9-4c36-8bbd-bdcace7c3874 installs=0.19.935 d347079cd0bad2db2c11ee4f0b760f04b2601d21 -->
    Loom-Trace-Id: 459637e4e8503593bdf58360865a7524
    Loom-Build: unknown d2a55ce217b3ad1793611a2c54946676bb55b512 clean
    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
2026-10-08 chore(signoff): pin grader klayout-tools 0.7.0; 11.analog -> met (3/22) (#164)
    Loom-Story: 2AMLogic/sky130-trng#164
    Loom-Trace-Id: 2be046442682ddc77130b4ec21f6fece
    Loom-Build: 0.19.895 9b30d293bcba1e79d49cabfc1c5bb5b6f4c0dc77 clean
2026-10-09 Supply-ripple and injection-lock robustness campaign for the RO array (#200)
    Adds the ro-array-supply-perturbation slug: klt sim batch requests that put a
    swept sinusoidal ripple on vdd/vddr1..4 of the committed pre-layout
    ro_array_core at the ss/-40C/1.62V binding corner and the ff/-40C/1.98V corner,
    a lock/period/bias reduction under DR-0003's margins, a ring-local
    current-injection negative control, and two append-only records.
    Loom-Story: 2AMLogic/sky130-trng#200
    Loom-Trace-Id: 38a23be5650405af9c2878ab21a8719a
    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
    [make-requests.py]
2026-10-09 docs: refresh sign-off status, DR index and simulated-stream commentary (#212)
    Loom-Story: 2AMLogic/sky130-trng#212
    Loom-Trace-Id: e67baed5f539070ab8cb0468e0cd8d78
    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
2026-10-09 chore(signoff): cite delivered digital DRC/LVS evidence (3.digital, 4.digital) (#211)
    Audit layout/trng_digital envelopes against pinned klayout-tools 0.7.0.
    3.digital and 4.digital are cited with input-hash pins; 5/7/11.digital stay
    unmet (no functional-verification or digital erc envelope). Report regenerated: 5/22.
    Loom-Story: 2AMLogic/sky130-trng#211
    Loom-Trace-Id: 4909ffd079e9cb55c70d1e49275d95e4
    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
2026-10-09 chore(signoff): regenerate t1-report.json with released klayout-tools 0.7.0 (#211)
    The previous render came from the host's uv-tool klt (git rev 4cbdfa7,
    version 0.7.0+g4cbdfa769875): `uvx --from klayout-tools==0.7.0` reused
    that installed tool env because a PEP 440 local version satisfies ==0.7.0.
    Re-rendered with an isolated PyPI release build
    (UV_CACHE_DIR=/tmp/... uvx --isolated --no-config), matching CI's
    `pip install klayout-tools==0.7.0`. Only the build block changes
    (0.7.0 / v0.7.0 / is_release true); items are byte-identical.
    Loom-Build: 0.19.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
2026-10-09 ci: run test_raw_bit_volume_model and test_ripple_reduction in PR-blocking job (#217)
    Loom-Story: 2AMLogic/sky130-trng#217
    Loom-Trace-Id: ce6a673c5f7ca870f1d60af88a751ae0
    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
2026-10-09 chore: resync installed Loom surfaces
    <!-- loom:provenance v1 build=unknown 05dba463c5b293d38f0ca071725983862498b3f3 clean prompts=none sweep=none story=none trace=14298316053024bcf5120bff695771ab host=robb-pro base=dda620c17e76e73cdfeb9775a1123b448e101a00 run=loom-run/v1:timer:robb-pro/fleet-resync:2f384483-6d77-4ba2-9888-aa1e4b5be36c installs=0.19.953 b93d7a955d63411cb4c94b986fd5138d27dedb0f -->
    Loom-Trace-Id: 14298316053024bcf5120bff695771ab
    Loom-Build: unknown 05dba463c5b293d38f0ca071725983862498b3f3 clean
    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
2026-10-09 feat(sim): wake-up transient campaign, probes and margin vs DR-0004 start-up window (#216)
    Partial evidence: the batch fleet rejected the PVT grid (see sim/wake-up-transient/README.md).
    Loom-Story: 2AMLogic/sky130-trng#216
    Loom-Trace-Id: d3c8faacd00812b6372eaf22a33f31da
    Loom-Build: 0.19.950 72047016af9d66c08f900bb94c642a66dfd75fc5 clean
2026-10-09 feat(sim): local-mismatch Monte Carlo of RO array spread and sampler offset/bias (#215)
    klt sim monte_carlo (vary=mismatch, *_mm sections) on the batch fleet at
    tt/ss/ff: 30 array + 60 sampler draws per corner, raw-bit bias and H_bias
    bound against DR-0004's H=0.5 floor. Simulation-derived; provisional until silicon.
    Loom-Story: 2AMLogic/sky130-trng#215
    Loom-Trace-Id: ea8b45b3ed011d9653c77c4dc4b60e22
    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
2026-10-09 chore: resync installed Loom surfaces
    <!-- loom:provenance v1 build=unknown 7f06b288b150f2fe0a4b24c331a9b3ec093d709d clean prompts=none sweep=none story=none trace=a90c217ff3a3bd9e3a30282b8cadc24d host=robb-pro base=0411e5d1cf97cd7fddad70bf0f43e1015caf9dc0 run=loom-run/v1:timer:robb-pro/fleet-resync:6e5ec9f3-d6ef-4953-80f7-c93035e2d359 installs=0.19.967 cc9c6cf61d1aebc3153cd1588ca304445a6b9ced -->
    Loom-Trace-Id: a90c217ff3a3bd9e3a30282b8cadc24d
    Loom-Build: unknown 7f06b288b150f2fe0a4b24c331a9b3ec093d709d clean
    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
2026-10-09 feat(sim): native klt functional-verification evidence for the digital suite (#222)
    Loom-Story: 2AMLogic/sky130-trng#222
    Loom-Trace-Id: 0cc1c0f1181883d9236c0cc06b135bd6
    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
2026-10-09 feat(layout): native supply ERC for routed trng_digital; cite item 11.digital (#223)
    Derives erc-supply-spec.json from the routed GDS + pnr.json, runs klt 0.7.0
    erc --findings-only (clean: one island per supply, drawn-nwell and
    native-substrate ties checked), adds five isolated negative controls, cites
    11.digital and regenerates signoff/t1-report.json (5 -> 6 met).
    Loom-Story: 2AMLogic/sky130-trng#223
    Loom-Trace-Id: 337019d91d315f5071d55caa9ea4dde3
    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
2026-10-09 docs: refresh work log and current backlog plan
2026-10-09 sim: SDF-annotated routed digital verification with annotation controls (#227)
    Loom-Story: 2AMLogic/sky130-trng#227
    Loom-Trace-Id: 02b0cb2c4f203db70c7f623f711ef224
    Loom-Build: 0.19.972 113c7f31d7d16f75d30c470023e0b65b29b1fe94 clean
    [sdf-baseline-dropped-entries.diff.txt, sdf-delay-fail.diff.txt, sdf-delay-shift.diff.txt, sdf-mistargeted.diff.txt]
2026-10-09 chore: resync installed Loom surfaces
    <!-- loom:provenance v1 build=unknown 30c7a7ee2f74a6a2b5bb0f19fd9f049ec8ae8b5c clean prompts=none sweep=none story=none trace=7bc5ba399ff199d049d83d711920a157 host=robb-pro base=d8c85703c5f723336a42fab4c22d31dd061b91b4 run=loom-run/v1:timer:robb-pro/fleet-resync:8e237160-c4d0-4ce3-85ac-c96aff5cf221 installs=0.19.982 2bc4cba624b9053535663441e6f0daf08a7acf2e -->
    Loom-Trace-Id: 7bc5ba399ff199d049d83d711920a157
    Loom-Build: unknown 30c7a7ee2f74a6a2b5bb0f19fd9f049ec8ae8b5c clean
    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
2026-10-09 sim: digital floorplan-compaction feasibility study (#226)
    Three-point P&R study of the unchanged trng_digital netlist at 40/55/65 %
    target utilisation on the exact tool-pins.json klt build
    (0.6.0+g10f3da34c088, worktree venv), each through the full digital-pnr
    chain (route, klt DRC, cell-level LVS, 16-corner STA, routed cosim, four
    negative controls).
    - util40 reproduces layout/trng_digital/ byte-for-byte, with no drift.
    - util55 and util65 shrink the die to 0.044291 / 0.037787 mm2 and pass every
    sign-off check. They raise unrepaired library max-slew/max-cap violations
    at low-voltage ss corners, so no candidate is selected.
    - Combined area is a labelled estimate, not composed: 0.0936 m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
2026-10-09 ci: enforce sim/ append-only record rule (#232)
    Loom-Story: 2AMLogic/sky130-trng#232
    Loom-Trace-Id: ef1a97183499cb830b83ed10ac0ec5af
    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
2026-10-10 chore: resync installed Loom surfaces
    <!-- loom:provenance v1 build=unknown a7d2b01d8eb7d09e597a4638e5cb3cdd8bab9156 clean prompts=none sweep=none story=none trace=35c1337ee84607e87ba2038523d63198 host=robb-pro base=338d8e6467d7df4ee8baedbad52a349122e61378 run=loom-run/v1:timer:robb-pro/fleet-resync:6bf32a81-6c4a-48c5-a51e-1ad65c6bedfd installs=0.19.1001 1c1131220b2f5950fe54b7cd02ebd3f1aae488dd -->
    Loom-Trace-Id: 35c1337ee84607e87ba2038523d63198
    Loom-Build: unknown a7d2b01d8eb7d09e597a4638e5cb3cdd8bab9156 clean
    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
2026-10-10 feat(digital): constraint-driven electrical-limit repair study with final-route audit (#236)
    Isolated sim/digital-electrical-repair/: control reproduces the 1167 baseline
    (byte-identical geometry), derived max_transition_ns budget, three repair
    candidates (one failed on purpose), 16-corner final-route slew/cap audit via a
    sibling OpenSTA session, reduction controls in CI. No geometry promoted.
    Loom-Story: 2AMLogic/sky130-trng#236
    Loom-Trace-Id: c3c25d6dbb5526bfb64d0f30c2c608dd
    Loom-Build: 0.19.996 0d2be7e9ae05753e2c9232a83b7399d45de5396e clean
2026-10-10 docs: sync sim/README slug index and Challenge #4 sign-off row 3 with delivered evidence (#240)
    Loom-Story: 2AMLogic/sky130-trng#240
    Loom-Trace-Id: 1fd3891fc4d9549e169fba32322b002f
    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
2026-10-10 docs(spec): DR-0010 target-table reconciliation packet (Proposed) (#239)
    Loom-Story: 2AMLogic/sky130-trng#239
    Loom-Trace-Id: 43100a0e313960c6a28d03c781a63763
    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
2026-10-10 docs(chipalooza): correct remaining pre-#173 block DRC/LVS phrasings
    Judge feedback on #241: several sentences still said the composed
    trng_whole GDS had no block DRC/LVS or named #173/#181 as open. Reword
    them to match the AC3 table: block DRC and mixed-level LVS met within
    stated coverage (#173, not foundry sign-off), #181 resolved, only
    whole-block post-layout PVT (#174) open. Verdict stays UNMET; no spec
    value, target or sim/ record changed.
    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
2026-10-10 feat(sim): conditioned-output (DATA) battery + estimator evidence over volume streams (#243)
    Loom-Story: 2AMLogic/sky130-trng#243
    Loom-Trace-Id: 25f9382cf4f589d3029e249add911d81
    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
2026-10-10 docs(spec): DR-0011 Proposed -- DR-0004 external interface vs assumed Challenge #4 pin budget (#244)
    Loom-Story: 2AMLogic/sky130-trng#244
    Loom-Trace-Id: af73c064ea887cc0a5f764c31790c607
    Loom-Build: 0.19.1009 8889f7bd1eccfb4bc8239e7f5669b65f9815c30e clean
2026-10-10 docs(spec): DR-0012 Proposed -- RO-array supply-quality requirement from #200 evidence (#208)
    Loom-Story: 2AMLogic/sky130-trng#208
    Loom-Trace-Id: 9d57fa0113a2d0b185db6538460e7ec0
    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
2026-10-10 chore: resync installed Loom surfaces
    <!-- loom:provenance v1 build=unknown c156f673e072832aaacb4cd1ec65b742e7f45867 clean prompts=none sweep=none story=none trace=9de99c124c651049199abe9a75070dc7 host=robb-pro base=0df5ddc64e6178b5975372ee032ec200cf424fd2 run=loom-run/v1:timer:robb-pro/fleet-resync:f790885c-7154-4b3d-acd9-71fd537cd20b installs=0.19.1010 d1d5fcecb79550fe39658555a4419f98cec060fb -->
    Loom-Trace-Id: 9de99c124c651049199abe9a75070dc7
    Loom-Build: unknown c156f673e072832aaacb4cd1ec65b742e7f45867 clean
    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
2026-10-10 chore: resync installed Loom surfaces
    <!-- loom:provenance v1 build=unknown 52f79668bb5f93c1828b7f1ea4f7013b917b847b clean prompts=none sweep=none story=none trace=7057f3175071f1f6e34b354fab40a0ce host=robb-studio base=26f2ef988bda7e5e55856715eb895f168a1485bc run=loom-run/v1:timer:robb-studio/fleet-resync:d8918779-1625-4202-b151-71f64465e8cd installs=0.19.1010 d1d5fcecb79550fe39658555a4419f98cec060fb -->
    Loom-Trace-Id: 7057f3175071f1f6e34b354fab40a0ce
    Loom-Build: unknown 52f79668bb5f93c1828b7f1ea4f7013b917b847b clean
    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
2026-10-10 feat(sim): gate digital P&R on extracted final-route Liberty electrical limits (#250)
    Loom-Story: 2AMLogic/sky130-trng#250
    Loom-Trace-Id: e912172fff91ba671d12ed18057d1da1
    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
2026-10-10 feat(sim): 2^20-bit raw-bit volume streams and battery/90B record with min-H shift vs 2^17 (#253)
    Loom-Story: 2AMLogic/sky130-trng#253
    Loom-Trace-Id: 680f5fd72c9a2233a3ef82408b1e8ee7
    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
2026-10-10 sim: repaired floorplan compaction at 40/55/65% with 16-corner final-route audit (#251)
    Recommends rep65-slew0531 conditionally (estimate B 0.093609 mm2, 1.87x target); nothing promoted.
    Loom-Story: 2AMLogic/sky130-trng#251
    Loom-Trace-Id: 24f96e089fbc70807355b98f85506148
    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
2026-10-10 chore: resync installed Loom surfaces
    <!-- loom:provenance v1 build=unknown 525fe43b7b1b2a0271084bba444c934a1541a8d8 clean prompts=none sweep=none story=none trace=0d4424bd058cf912b74934ec0e7bf37e host=robb-pro base=0dfa6e99e4afb4f6217df307abef04c0915fe0db run=loom-run/v1:timer:robb-pro/fleet-resync:4812047c-8b9b-4da2-a5dc-13e6f6420a04 installs=0.19.1018 13e54f1cfc513507a7ef84ec6908085638d9c187 -->
    Loom-Trace-Id: 0d4424bd058cf912b74934ec0e7bf37e
    Loom-Build: unknown 525fe43b7b1b2a0271084bba444c934a1541a8d8 clean
    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
2026-10-10 docs(spec): silicon characterization plan, DR-0014 Proposed, measurements/ layout contract (#256)
    Loom-Story: 2AMLogic/sky130-trng#256
    Loom-Trace-Id: dcc4c86d4df53cad130aba5a0ee30ba8
    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
2026-10-10 chore: resync installed Loom surfaces
    <!-- loom:provenance v1 build=unknown 525fe43b7b1b2a0271084bba444c934a1541a8d8 clean prompts=none sweep=none story=none trace=d4059def94f46d8d158946acddd4d602 host=robb-studio base=7e279ab9095920116f8db6618695ac3d82cf6f74 run=loom-run/v1:timer:robb-studio/fleet-resync:4a4d1995-968e-44c5-b5fe-804b4d477795 installs=0.19.1019 febfc4335d0554865fadbecba718245cd88c6678 -->
    Loom-Trace-Id: d4059def94f46d8d158946acddd4d602
    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
2026-10-10 feat(sim): bounded Vth-shift (BTI/HCI-like) sensitivity of the RO array across PVT (#254)
    Adds sim/ro-vth-drift-sensitivity/: deterministic aged-netlist generator with
    signed NMOS/PMOS gate-offset wrappers around the pinned sky130 1.8 V devices,
    request derivation from the unmodified ring5 jitter and array-core decks, a
    222-key coverage manifest, controls (DC offset to 1 uV, zero-shift equivalence,
    tt/27C/1.8V pilot), the full common-mode PVT grid plus six asymmetric headline
    cases run through the klt sim batch path, matched zero-shift pairing, closest
    small-rational approach, DR-0003/DR-0004 envelope view, a versioned calibration
    artifact, and a matched-seed behavioral replay.
    behavioral_r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
    [make-requests.py]
2026-10-10 feat(sim): extend append-only guard to record-associated runs/ and corners/ artifacts (#265)
    Loom-Story: 2AMLogic/sky130-trng#265
    Loom-Trace-Id: c05c1f0524e9f156be1ea46d9e72cc48
    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
2026-10-10 ci(pdk-nightly): reproduce composed whole-block geometry and baseline DRC/LVS (#264)
    Loom-Story: 2AMLogic/sky130-trng#264
    Loom-Trace-Id: 6d4429aca5320a2def57e0cb7ee4aa4d
    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
2026-10-10 feat(sim): extend append-only guard to measurements/ records and raw captures (#269)
    Loom-Story: 2AMLogic/sky130-trng#269
    Loom-Trace-Id: c480416ab018d4a06f2223d0236c7765
    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
2026-10-10 chore: resync installed Loom surfaces
    <!-- loom:provenance v1 build=unknown 5d5f41d89eef35adf478b92b96af06c6d86d27a6 clean prompts=none sweep=none story=none trace=05d2a40831b35ba1c48afada00c29519 host=robb-pro base=efbcb75dc4272455c7bcd0dfb0f49b8e527261f9 run=loom-run/v1:timer:robb-pro/fleet-resync:c58bb82e-a213-439d-b829-04234e141de9 installs=0.19.1028 48ce8a23fdab3059d078e9fffca79e4d4c911d60 -->
    Loom-Trace-Id: 05d2a40831b35ba1c48afada00c29519
    Loom-Build: unknown 5d5f41d89eef35adf478b92b96af06c6d86d27a6 clean
    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
2026-10-10 chore: resync installed Loom surfaces
    <!-- loom:provenance v1 build=unknown aa536103d6239818bb974a51d2f7f268eff38bad clean prompts=none sweep=none story=none trace=126a1328a3664e2119a0978086db9bea host=robb-studio base=a7a5a3cf54378d10d88492bfdbfe7df23870bedb run=loom-run/v1:timer:robb-studio/fleet-resync:fbc4e361-e290-4d81-ae3a-8b5fde796815 installs=0.19.1032 13ca937a7d6ba8768c296b0c126f2ce48f5f7ca4 -->
    Loom-Trace-Id: 126a1328a3664e2119a0978086db9bea
    Loom-Build: unknown aa536103d6239818bb974a51d2f7f268eff38bad clean
    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
2026-10-10 feat(sim): restart-matrix reduction for the C5 restart dataset (#267)
    Standard-library R x N restart-matrix reducer (row/column 99 % MCV via
    raw-bit-entropy.py:mcv_estimate, first-window vs baseline two-proportion z
    test, DR-0004 start-up test per restart, matrix sanity verdict), reusing
    wakeup.py's calibrated phase model for the behavioural known-answer record.
    Unit tests wired into CI.
    Part of #267
    Loom-Story: 2AMLogic/sky130-trng#267
    Loom-Trace-Id: 14d8b31f6a2b3ebcfd83e69a09f05262
    Loom-Build: 0.19.1026 09a449709f5a1c6ae81b471ef56d466247e50808 clean
2026-10-10 feat(sim): restart-matrix behavioural known-answer record + C5 pointer (#267)
    Mint 20261010-231748-f259cb7: 1000 x 2048 restart matrices at the 18
    calibrated points, deterministic and stationary arms, per-restart seeds and
    calibration provenance; full values in runs/<id>/restart-matrix-values.json.gz.
    README model boundary; pointer-only C5 analysis-path citation in
    spec/silicon-characterization-plan.md (no number or threshold changed).
    Closes #267
    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
2026-10-10 fix(sim): use math.fsum for restart-matrix mean (Python 3.11 replay) (#267)
    Built-in sum() over floats is compensated on Python >= 3.12 but naive on
    3.11, so the replay-compared h_mcv_dist.mean differed in the last ULPs on
    CI (3.11). math.fsum is correctly rounded and version-independent; it
    reproduces the recorded means exactly, so record 20261010-231748-f259cb7,
    its hashes and markdown are unchanged.
    README: state that the matrix verdict grades against the DR-0004 0.5-bit
    floor while C5's silicon criterion (>= C1 within CI) is a separate,
    ungraded comparison.
    Loom-Trace-Id: 14d8b31f6a2b3ebcfd83e6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
    [restart_matrix.py]
2026-10-11 fix(sim): reject colliding artifact basenames before minting behavioral evidence (#273)
    Loom-Story: 2AMLogic/sky130-trng#273
    Loom-Trace-Id: 58e182b96e88bfc5cb29f8e84e7c669f
    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
2026-10-11 fix(sim): publish complete evidence bundles with exclusive id reservation (#277)
    Loom-Story: 2AMLogic/sky130-trng#277
    Loom-Trace-Id: 91a17249c22cdcf9f2c8b7e90073a416
    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
2026-10-11 fix(sim): reject summary keys colliding with writer-owned behavioral record metadata (#276)
    Drop restart_matrix's redundant summary 'claim' (identical to the writer's value, JSON unchanged).
    Loom-Story: 2AMLogic/sky130-trng#276
    Loom-Trace-Id: 5774c066caa8cfb2470cf0dbca1885bf
    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
    [restart_matrix.py]
2026-10-11 test(sim): use circular summary for mint_record invalid-JSON case (#277)
    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
2026-10-11 chore: resync installed Loom surfaces
    <!-- loom:provenance v1 build=unknown cf08873555e2eb95da295dcbee98b0dc34473381 clean prompts=none sweep=none story=none trace=67fbc483c3ca3e442d7928804c11ff06 host=robb-pro base=dd37c4bb82e5fc61310ed1a5d2be0f0ad63b9335 run=loom-run/v1:timer:robb-pro/fleet-resync:e3f97888-2b26-404a-bd47-86fd28a4eced installs=0.19.1041 b65c266b47d796bf37d1c04c6f616be0bc699056 -->
    Loom-Trace-Id: 67fbc483c3ca3e442d7928804c11ff06
    Loom-Build: unknown cf08873555e2eb95da295dcbee98b0dc34473381 clean
    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
2026-10-11 feat(verify): audit klt-inapplicable DRC rules and unruled layers against the composed GDS
    Add layout/bin/drc_coverage_audit.py and wire it into verify-whole.py.
    For each rule drc.json lists as inapplicable, the audit takes the rule's
    check kind and deck layers from `klt deck rules`. It resolves each layer
    to a stream layer/datatype through the deck's own layer table, counts
    flattened geometry with `klt layers --flattened --include-text`, and gives
    a vacuous-confirmed / residual / unresolved verdict. Each of the 19
    unruled stream layers is classified present-unruled or
    text-or-marker-only. Both deck sources must hash to drc.json's pinned
    deck content_hash, or the audit refuses and names both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
2026-10-11 chore: resync installed Loom surfaces
    <!-- loom:provenance v1 build=unknown e91831edf7b55b29d3a2d88e266916fab9ce2563 clean prompts=none sweep=none story=none trace=f72dd67520a2c3802aa0495b80ac65a5 host=robb-studio base=55ad2b4e3c1e4f3af2731d7dc42fde7ee22d8eb3 run=loom-run/v1:timer:robb-studio/fleet-resync:91d2434e-eae5-45de-9305-d78c43fc7c7a installs=0.19.1042 5b6ebdcc40bfccc9357e15196984061f1d5e6178 -->
    Loom-Trace-Id: f72dd67520a2c3802aa0495b80ac65a5
    Loom-Build: unknown e91831edf7b55b29d3a2d88e266916fab9ce2563 clean
    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
2026-10-11 feat(sim): XOR combining-gate alternatives evidence (2x width vs baseline, 18 klt-sim batch jobs) (#282)
    Baseline control reproduces committed w_90 (+-5%) and loaded ring period
    (+-2%) at all nine points; 2x width leaves N_max_combine = 6 and moves the
    raw-rate ceiling 79.46 -> 80.15 kbps. Links the record from DR-0010 without
    changing its Proposed status or any target.
    Loom-Story: 2AMLogic/sky130-trng#282
    Loom-Trace-Id: 1212084a19ee5ff563a3623fe5e9b494
    Loom-Build: 0.19.1039 e83d19dc0a9b217339ea2f14040c50ad6f46700d clean
2026-10-11 feat(sim): PVT-parameterized seeded transistor raw-bit cross-check generator, reducer and controls (#289)
    Evidence runs pending: klt sim batch refused (runner/client mismatch, klayout-tools#2851).
    Loom-Story: 2AMLogic/sky130-trng#289
    Loom-Trace-Id: 8d54a00b0f4aececf79d2a24d7ddf64e
    Loom-Build: 0.19.1050 abf3f7109328fd66ec77827f5fd849f5279fee82 clean
2026-10-11 feat(signoff): aggregated characterization report generator with CI staleness gate (#291)
    Loom-Story: 2AMLogic/sky130-trng#291
    Loom-Trace-Id: a6800e751b5a8e545292e124cc3dfd58
    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
2026-10-11 docs: top-level REPRODUCE.md cold-start index with CI consistency check (#292)
    Index of every result family to its cold-start command, tool pins and PDK
    revision; tools/check_reproduce.py fails on dangling references, uncovered
    sim/ record directories, or disagreeing PDK pins, with negative controls.
    Does not cite anything against T1 items 9/10.
    Loom-Story: 2AMLogic/sky130-trng#292
    Loom-Trace-Id: 6e750678723f4b67850dcab809dfd7c6
    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
2026-10-11 fix(signoff): characterization report rests on all row evidence; missing fields fail (#291)
    Address Judge review on PR #293:
    - Raw min-entropy per bit now also declares the three transistor-level
    local-mismatch Monte Carlo records; the tt record (h_bias_min 0.4718 < 0.5)
    makes the row unmet, consistent with DR-0010 row 3 open on #221.
    - Health tests adds RCT and APT stuck-at fault-injection detection
    (detected == runs) next to the no-false-alarm check; check text states the
    DR-0010 row 3 / #221 dependency and the superseded replay streams.
    - extract_strict(): a fanned-out element lacking the field, a fan over a
    non-list, or an unmatched [key=v] selector counts as missing, and any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
2026-10-11 feat(spec): index DR-0011 and add decision-record index consistency checker (#296)
    Loom-Story: 2AMLogic/sky130-trng#296
    Loom-Trace-Id: 95df354f7023ea08353ff898eba5df75
    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
2026-10-11 docs: friction ledger indexing cited klayout-tools issues, with offline CI coverage check (#295)
    Loom-Story: 2AMLogic/sky130-trng#295
    Loom-Trace-Id: 31976379403db8447301944befa80084
    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
2026-10-11 docs(friction-ledger): fix #1491 state cell wording
    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
2026-10-11 chore: resync installed Loom surfaces
    <!-- loom:provenance v1 build=unknown 5ec729b9f7dd55a2082752611e4c4964f49661fb clean prompts=none sweep=none story=none trace=efc2abc8b72538df6d1a6ea9d329603d host=robb-pro base=6f89f4480f3fd9e7ce5e23e9ab802498ed4252bd run=loom-run/v1:timer:robb-pro/fleet-resync:0d396c06-f26e-423e-97ac-6d3ac04a8e51 installs=0.19.1056 4e44d8f5faa6c6c58d2a3436ce3a983613cf375a -->
    Loom-Trace-Id: efc2abc8b72538df6d1a6ea9d329603d
    Loom-Build: unknown 5ec729b9f7dd55a2082752611e4c4964f49661fb clean
    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
2026-10-11 chore: resync installed Loom surfaces
    <!-- loom:provenance v1 build=unknown 745f69d0daad6c23e76cc006720fa4fbeaa3d887 clean prompts=none sweep=none story=none trace=3baabc4a039fd85029fff227a6ae690a host=robb-studio base=28d61463eddbd93fdc3695e928db0b21274e7516 run=loom-run/v1:timer:robb-studio/fleet-resync:3b3207d7-055d-49b5-a387-db375213668d installs=0.19.1060 3336676408ee1d4f1df2dc7f23adbb6c3170674e -->
    Loom-Trace-Id: 3baabc4a039fd85029fff227a6ae690a
    Loom-Build: unknown 745f69d0daad6c23e76cc006720fa4fbeaa3d887 clean
    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
2026-10-11 docs(sim): record 2026-10-11 batch retry for #289 non-nominal PVT cross-check (still version-mismatch)
    Part of #289
    Loom-Build: 0.19.1055 4737928b703aa8a4c87d04eefbf7299fb933eab4 clean
    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
2026-10-11 feat: informational whole-block density + naive antenna-ratio estimates (issue #283)
    layout/bin/physical_estimates.py computes both estimates from read-only
    committed evidence (trng_whole.gds + verify/extract.json.gz) and renders one
    document whose definitions live in the artifact header itself:
    - density: unioned flattened drawing geometry per poly/li1/met1..met5 over a
    100 um x 100 um tiled grid (arbitrary choice -- the pinned curated deck has
    no density rules or window dimensions), clipped-window denominators,
    zero-area windows skipped and counted, invalid grids refused.
    - antenna: naive cumulative conductor-area / gate-W*L ratio per electrical
    net and level. Conductor components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
2026-10-11 feat(sim): experiment I, health-test detection coverage on correlated/periodic synthetic streams (#300)
    Loom-Story: 2AMLogic/sky130-trng#300
    Loom-Trace-Id: 7af5146871ddc33f4929704ba7688663
    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
2026-10-11 test+docs: pin the estimate calculator; wire the drift gate into CI and the nightly (issue #283)
    - layout/test_verify_whole.py gains three groups: pure calculator logic
    (window grids with clipped edge windows and refused invalid grids,
    cumulative ratios, label-subset attribution with ambiguous/zero-gate/
    unmatched accounting, drift catching value/parameter/staleness changes
    but ignoring provenance), the committed-artifact contract (hashes still
    describe the committed inputs, coverage identities, per-window densities
    consistent with min/max, markdown exactly renders the JSON, no
    unsubstituted template fields), and a klayout-gated group running the
    real-geometry controls plus t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
2026-10-11 chore: resync installed Loom surfaces
    <!-- loom:provenance v1 build=unknown b37a005ac1889262fb9e5338f7cff4e9ed4987da clean prompts=none sweep=none story=none trace=25c158d7e9591610b251780caaff1c5f host=robb-pro base=27ea4b650117cc6e63784520c01b0700c72d0181 run=loom-run/v1:timer:robb-pro/fleet-resync:7f020bca-6920-47f7-a5e4-bbd5c82d9bb8 installs=0.19.1072 29b48db1ead9c4501304e0114a5c33310e1d589f -->
    Loom-Trace-Id: 25c158d7e9591610b251780caaff1c5f
    Loom-Build: unknown b37a005ac1889262fb9e5338f7cff4e9ed4987da clean
    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
2026-10-11 chore: resync installed Loom surfaces
    <!-- loom:provenance v1 build=unknown 81a6b4499cb57b3620785bc1625c300da34f0735 clean prompts=none sweep=none story=none trace=d08bbd290651d7bcbda8b216c0dfbcdf host=robb-studio base=aa51fc49986917bc135f460ff22530fee48c326d run=loom-run/v1:timer:robb-studio/fleet-resync:71e05e3d-931c-46b4-b6d2-5f3f992c1e19 installs=0.19.1073 abb0872ba7d1d3f6f3a14f71f51a562e89308181 -->
    Loom-Trace-Id: d08bbd290651d7bcbda8b216c0dfbcdf
    Loom-Build: unknown 81a6b4499cb57b3620785bc1625c300da34f0735 clean
    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
2026-10-12 chore: resync installed Loom surfaces
    <!-- loom:provenance v1 build=unknown ddfb67ccf9a5115d62dd86924613a468b9328f44 clean prompts=none sweep=none story=none trace=772605234b9d8cafd6a4049200f7425c host=robb-pro base=4ab864eca30f50dfd7cbe23084acb4eed57871c9 run=loom-run/v1:timer:robb-pro/fleet-resync:1ef28ffc-0277-424f-9224-7ee6eca46377 installs=0.19.1083 77a174ea7fcaddbb25d0082956cd25d8633fc2df -->
    Loom-Trace-Id: 772605234b9d8cafd6a4049200f7425c
    Loom-Build: unknown ddfb67ccf9a5115d62dd86924613a468b9328f44 clean
    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
2026-10-12 chore: resync installed Loom surfaces
    <!-- loom:provenance v1 build=unknown be358990895362019614bd207bcbe36bc9eeff2c clean prompts=none sweep=none story=none trace=f1dc643b95859c8f26e892ddb5e2c5d7 host=robb-studio base=dd84c67dd570a7e2d229637d1ddac6a3e907b421 run=loom-run/v1:timer:robb-studio/fleet-resync:da486ca2-3e94-4a85-abd3-88707942489a installs=0.19.1087 51ac271f990b317a52ebf27cc21f34561e1179fb -->
    Loom-Trace-Id: f1dc643b95859c8f26e892ddb5e2c5d7
    Loom-Build: unknown be358990895362019614bd207bcbe36bc9eeff2c clean
    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
2026-10-12 chore: resync installed Loom surfaces
    <!-- loom:provenance v1 build=unknown a579728c137cc11d08a48b178e0ff9aa21683e72 clean prompts=none sweep=none story=none trace=3bf998139b24cf65d1c2b90af6a12450 host=loom-worker-3 base=79888f499f35694beb8d7f403306f3ead6c6af0a run=loom-run/v1:timer:loom-worker-3/fleet-resync:5b8ee6fae8b4401a862c5e98cad72b45 installs=0.19.1087 51ac271f990b317a52ebf27cc21f34561e1179fb -->
    Loom-Trace-Id: 3bf998139b24cf65d1c2b90af6a12450
    Loom-Build: unknown a579728c137cc11d08a48b178e0ff9aa21683e72 clean
    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
2026-10-12 feat(sim): whole-block characterization attempt, partial static IR, explicit Unmet matrix (#174)
    Add sim/post-layout-whole-block: transistor-level connectivity netlist of
    trng_whole.gds, directed program + normative-model oracle, four klt sim batch
    requests (tt/ss/ff x four PVT points), klt power static IR, and a coverage
    reducer. All batch submissions were refused (batch_runner_version_mismatch);
    0/12 points MET, AC3 not claimed. Partial IR uses assumed ring loads.
    Part of #174
    Loom-Story: 2AMLogic/sky130-trng#174
    Loom-Trace-Id: 98444aece16199bfb07f8ce344741286
    Loom-Build: 0.19.1081 6966a93d1cd1b005f2a6b22bf9691ade8793ed73 clean
2026-10-12 feat(sim): parameterize ripple campaign for 200/400-edge lock-resolution windows
    Issue #288 (DR-0012 follow-up 5): the #200 supply-ripple evidence leaves
    near-frequency tones UNRESOLVED and brackets the lock amplitude between the
    10 and 50 mV rungs, because a 40-edge window resolves only ~0.256 % detuning
    (DRIFT_LOCK 0.1 cycle / 39 periods).
    Generator: add the bounded lock-resolution matrix (--campaign lock-resolution;
    lr 73 units + lrc 3-unit convergence subset per corner): 200-edge windows
    claiming +-0.1 % (2x margin), detuning ladder +-0.1/0.25/0.4 % on both sides
    of each ring frequency at 20/50 mV and +-0.25 % at 5 mV (below the #200 floor),
    on-frequency rows kept drift-UNRESOLVED, curr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
2026-10-12 fix(sim): warn-mode runner version check and capacity backoff for lr batch requests
    The batch fleet image's klt build string lags the submitting client, so the
    default enforce preflight rejects every job before any simulation runs
    (exit 87, probed). Send the lock-resolution campaign with
    batch.runner_version_check=warn (the skew lands in environment.remote) and
    batch.capacity_wait_s=240 so a saturated fleet is retried with backoff
    inside the client instead of refusing outright.
    Loom-Story: 2AMLogic/sky130-trng#288
    Loom-Trace-Id: 9245765181045e3ee4e492bbd705f578
    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
2026-10-12 fix(sim): guard lr tone-row table against baseline rows (tone=None)
    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
2026-10-12 docs(sim): describe lock-resolution record contents (missing rows, windows, pins)
    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
2026-10-12 fix(sim): 3-unit lock-resolution requests to fit the fleet's 3600 s job cap
    The first 8-unit lr requests (ff-lr-1, ss-lr-1) ran to the fleet's
    BATCH_MAX_JOB_SECONDS=3600 poweroff and returned every unit as
    batch_job_timeout with no measurements, while the 3-unit lrc requests
    finished (65 s ff, 2329 s ss at 400 edges). The campaign now packages 3 units
    per request; the unit matrix is unchanged and the lrc and final 1-unit lr
    requests are byte-identical to the ones already returned. Records carry the
    earlier submissions as submission_history.
    Loom-Build: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
2026-10-12 chore: resync installed Loom surfaces
    <!-- loom:provenance v1 build=unknown 02ecafe7734bf5faa945ce88940589f00eca78e9 clean prompts=none sweep=none story=none trace=5f71c537126994dc4c45179122427514 host=robb-pro base=04a5098bb6cd49cd9b43e4b9a7c269d269898327 run=loom-run/v1:timer:robb-pro/fleet-resync:6293e6da-8a67-45aa-b277-c9ef85ddb810 installs=0.19.1101 27422582cd2d34d8ed5f60ce987007bc4bd61081 -->
    Loom-Trace-Id: 5f71c537126994dc4c45179122427514
    Loom-Build: unknown 02ecafe7734bf5faa945ce88940589f00eca78e9 clean
    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
2026-10-12 docs(sim): state the injection controls' role accurately
    The clean baseline is the free-running reference; the +5 % current-injection
    rung is a sensitivity control (only a true lock can read LOCKED there), not a
    ring assumed to stay free -- #200 already saw +20 % lock at these levels.
    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
2026-10-12 chore: resync installed Loom surfaces
    <!-- loom:provenance v1 build=unknown 24e88efb2654d92588617d2e0681d2ceba48990d clean prompts=none sweep=none story=none trace=9ff02282641e95f0266bab1c719ccf6d host=loom-worker-3 base=7b473f8d598411b324d6673ef7e44a6c2ef3afb6 run=loom-run/v1:timer:loom-worker-3/fleet-resync:616e7cf481ff483ea62a90e9c8640d85 installs=0.19.1104 ded8b3776e361563cf636d3a439737715c13b6d5 -->
    Loom-Trace-Id: 9ff02282641e95f0266bab1c719ccf6d
    Loom-Build: unknown 24e88efb2654d92588617d2e0681d2ceba48990d clean
    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
2026-10-12 chore: resync installed Loom surfaces
    <!-- loom:provenance v1 build=unknown 9885e6bbba36f53328e04be83140734c6eda9f58 clean prompts=none sweep=none story=none trace=72f34c4066d6ca844a10c33035a775bd host=loom-worker-1 base=38249033532a57525ad2dd2bec1678983b1a9835 run=loom-run/v1:timer:loom-worker-1/fleet-resync:8f5732bc51fd43379e17e0de51e86bae installs=0.19.1108 72427939d156341080a7006ae6fbb5ec96b2368e -->
    Loom-Trace-Id: 72f34c4066d6ca844a10c33035a775bd
    Loom-Build: unknown 9885e6bbba36f53328e04be83140734c6eda9f58 clean
    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
2026-10-12 feat(sim): report effective detuning from the clean ring next to each bracket point
    The ladder is nominal (relative to the committed combining-record period);
    the clean ring in a given window can sit ~0.1 % away from it at ff, so each
    bracket point also carries clean_drift/(N-1). The record states what LOCKED
    means at a finite window (mean slip < 0.1 cycle; a slowly slipping ring just
    outside the lock range reads LOCKED, the conservative direction) and why the
    400/200 drift ratio of a pulled ring departs from 2.005.
    Loom-Build: 0.19.1081 6966a93d1cd1b0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
2026-10-12 chore: resync installed Loom surfaces
    <!-- loom:provenance v1 build=unknown 01467247f32c59822968bf02d3214d9a3d613452 clean prompts=none sweep=none story=none trace=0e97e9733eef09a33959cf96e6271f40 host=robb-studio base=1476d518b13179d3b9f8cca217166c9c36735c43 run=loom-run/v1:timer:robb-studio/fleet-resync:53a4d390-3842-4216-9018-5dced9d0ea17 installs=0.19.1109 d9498fcd419776b2517e30b99c88e76bbe92d2f4 -->
    Loom-Trace-Id: 0e97e9733eef09a33959cf96e6271f40
    Loom-Build: unknown 01467247f32c59822968bf02d3214d9a3d613452 clean
    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
2026-10-12 chore(sim): retitle the record's submission-history section
    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
2026-10-12 feat(sim): lock brackets on the effective detuning from the clean ring
    The nominal ladder is relative to the committed combining-record period; at
    ff the clean ring in the long window sits up to ~0.2 % away from it, so a
    nominal +0.1 % row can be effectively on-frequency. Brackets are now reported
    both on the nominal ladder and on clean_drift/(N-1) (points within the window
    resolution bound nothing), nominal on-frequency rows carry their effective
    detuning, and 400-edge rows are labelled in the failing lists. Test covers an
    offset clean ring.
    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
2026-10-12 evidence(sim): lock-resolution records at ss and ff (issue #288)
    Append-only records 20261012-111244-8100a6b (ff/-40 C/1.98 V) and
    20261012-111245-8100a6b (ss/-40 C/1.62 V): the bounded 76-row matrix per
    corner, all rows returned through klt sim batch (52 requests), with the
    submitted requests and netlists, plans, raw responses, input hashes, tool/PDK
    pins, observed windows and the full submission history (refused, timed-out
    and orphaned first-pass requests). Both records and both #200 records replay
    MATCHES.
    README gains the measured results kept apart from hypotheses; DR-0012 gets a
    status note on follow-up 5 only (no criterion or threshold change). Pre-layout,
    deterministic, simulation-d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
2026-10-12 docs: record #288 klt sim batch friction (klayout-tools #2833, #2970, #2978)
    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
2026-10-12 docs(DR-0012): state ss lock-threshold asymmetry in follow-up-5 note (#288)
    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
2026-10-12 chore: resync installed Loom surfaces
    <!-- loom:provenance v1 build=unknown 6d6a81bfd0d38dff3dfe3cc6d08965f57d71ab67 clean prompts=none sweep=none story=none trace=53e704452fd9a4802b952dbffcec3017 host=loom-worker-3 base=3413f68196af3eb35359d3417a1cbefda831a18a run=loom-run/v1:timer:loom-worker-3/fleet-resync:da09a55781444da6865c7c3d6fcf7edb installs=0.19.1126 7736d1276b6d01778fba3461114c858ef1bf5e2d -->
    Loom-Trace-Id: 53e704452fd9a4802b952dbffcec3017
    Loom-Build: unknown 6d6a81bfd0d38dff3dfe3cc6d08965f57d71ab67 clean
    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
2026-10-12 chore: resync installed Loom surfaces
    <!-- loom:provenance v1 build=unknown 8d832cc8035d4ba07872510416468da0790332cd clean prompts=none sweep=none story=none trace=09a53bf60e96fc30a753caffd1de8c92 host=robb-studio base=4be8e5448c13474d3470250f074dc150f5b8cb6e run=loom-run/v1:timer:robb-studio/fleet-resync:baf4c30c-65d9-4d4e-a740-f6a80cbb975c installs=0.19.1133 fd7af6d7adbad876821d49bff2c70c871f54b60c -->
    Loom-Trace-Id: 09a53bf60e96fc30a753caffd1de8c92
    Loom-Build: unknown 8d832cc8035d4ba07872510416468da0790332cd clean
    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
2026-10-12 chore: resync installed Loom surfaces
    <!-- loom:provenance v1 build=unknown a70d97503da52b2d8e12a12bd0cf829303808e95 clean prompts=none sweep=none story=none trace=e0715eac024f885e71456a622107e8bc host=loom-worker-3 base=d770fd439f1401d296fbc005f53bd7b06f942ade run=loom-run/v1:timer:loom-worker-3/fleet-resync:39a9339322d146b1984885e3f76b3e03 installs=0.19.1142 b91ae5d1b5204f499a1abb875a6cf5bffc1d90b1 -->
    Loom-Trace-Id: e0715eac024f885e71456a622107e8bc
    Loom-Build: unknown a70d97503da52b2d8e12a12bd0cf829303808e95 clean
    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
2026-10-12 chore: resync installed Loom surfaces
    <!-- loom:provenance v1 build=unknown 8b64614d017d6ce7491c3a2ac9da51e5e2901c97 clean prompts=none sweep=none story=none trace=66044c049ba635bcd6a4797c3a77e84b host=robb-pro base=496935a46e6b5a57bc034a3bb7effa0568d3683d run=loom-run/v1:timer:robb-pro/fleet-resync:68f56594-05d0-4cc0-9c07-36263359d698 installs=0.19.1144 9e4381cbbd2386393e44c7a979583252948a3998 -->
    Loom-Trace-Id: 66044c049ba635bcd6a4797c3a77e84b
    Loom-Build: unknown 8b64614d017d6ce7491c3a2ac9da51e5e2901c97 clean
    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
2026-10-13 chore: resync installed Loom surfaces
    <!-- loom:provenance v1 build=unknown e66f00108a9519331aa981da8a01c6569ca623a9 clean prompts=none sweep=none story=none trace=d3e476cf8c03d5ed37f8e146b3632190 host=robb-studio base=0cc29279736efa7371a9504b3e917bac53d13a8a run=loom-run/v1:timer:robb-studio/fleet-resync:1d7ace45-2daf-4c92-a752-67b11e982245 installs=0.19.1147 7ea3495e453d43e23efdd9673642fd4de42cd4cc -->
    Loom-Trace-Id: d3e476cf8c03d5ed37f8e146b3632190
    Loom-Build: unknown e66f00108a9519331aa981da8a01c6569ca623a9 clean
    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
2026-10-13 chore: resync installed Loom surfaces
    <!-- loom:provenance v1 build=unknown cbff4fbf837b06d41a17f2d2e23be806c19ce1df clean prompts=none sweep=none story=none trace=0cd5805094761c972dc958d4a2d69777 host=loom-worker-3 base=227fbf56143fe3167cf9df85b1c31f3b8b33cf4e run=loom-run/v1:timer:loom-worker-3/fleet-resync:0837bf6b93294c70ad9d20ea2eaefc57 installs=0.19.1148 1448fdfa79ac2dcab7fad6b95b72697b450f2a4a -->
    Loom-Trace-Id: 0cd5805094761c972dc958d4a2d69777
    Loom-Build: unknown cbff4fbf837b06d41a17f2d2e23be806c19ce1df clean
    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
2026-10-13 chore: resync installed Loom surfaces
    <!-- loom:provenance v1 build=unknown d0bfbbc7ac309581d7abe02c4a269c7704010ee0 clean prompts=none sweep=none story=none trace=0ad6d167235000f3b5648cbd63d761ce host=robb-pro base=e68c92a5968d338a8eb4bd6110c3efa1dc150745 run=loom-run/v1:timer:robb-pro/fleet-resync:4f7cbe22-40b6-49ff-8811-003ae8577c28 installs=0.19.1151 021b947d121929157cd83df0576e7f2aa12500d7 -->
    Loom-Trace-Id: 0ad6d167235000f3b5648cbd63d761ce
    Loom-Build: unknown d0bfbbc7ac309581d7abe02c4a269c7704010ee0 clean
    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
2026-10-13 chore: resync installed Loom surfaces
    <!-- loom:provenance v1 build=unknown 7916c4043a1b57e97a53bc5c111e74c5038a1091 clean prompts=none sweep=none story=none trace=a48d70df8e7252b46c71b88e90ebed02 host=loom-worker-3 base=ab64277e2f07e94264b9906242e2ea9e22d041b8 run=loom-run/v1:timer:loom-worker-3/fleet-resync:08e4e415b6434bf1ba0456ba59477467 installs=0.19.1151 f7d1deaab02a9c483fce1ced33fadb1af6d86f59 -->
    Loom-Trace-Id: a48d70df8e7252b46c71b88e90ebed02
    Loom-Build: unknown 7916c4043a1b57e97a53bc5c111e74c5038a1091 clean
    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
2026-10-13 chore: resync installed Loom surfaces
    <!-- loom:provenance v1 build=unknown ac0bbcf6eda99918e88a0b8893d9762b106a2e45 clean prompts=none sweep=none story=none trace=8597ab8a51d68f9f8ee864fa71904bff host=robb-studio base=514b82007ed0b17ae37f0bcd872e6817619eb81f run=loom-run/v1:timer:robb-studio/fleet-resync:2ea9dd71-a6b2-4d0c-86aa-859a0728c9b3 installs=0.19.1151 f7d1deaab02a9c483fce1ced33fadb1af6d86f59 -->
    Loom-Trace-Id: 8597ab8a51d68f9f8ee864fa71904bff
    Loom-Build: unknown ac0bbcf6eda99918e88a0b8893d9762b106a2e45 clean
    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
2026-10-13 chore: resync installed Loom surfaces
    <!-- loom:provenance v1 build=unknown 7916c4043a1b57e97a53bc5c111e74c5038a1091 clean prompts=none sweep=none story=none trace=773e9e41a5730d2f79f2381ad2cde068 host=robb-pro base=014eedcbaceba3f20ac0eb1009e7873c8a68b249 run=loom-run/v1:timer:robb-pro/fleet-resync:b7ca0d34-434e-4536-85b9-57adfa603a8d installs=0.19.1151 1ec34f9bb79942506958a3c18a31368f4e065508 -->
    Loom-Trace-Id: 773e9e41a5730d2f79f2381ad2cde068
    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
2026-10-13 chore: resync installed Loom surfaces
    <!-- loom:provenance v1 build=unknown f91cd239df41290ba3efb8bc14320984e3392c6f clean prompts=none sweep=none story=none trace=c1345a24765b7e1c5307ef032fd77486 host=loom-worker-3 base=72a97d53f7747babe3f53507140bb4ac8340f1e0 run=loom-run/v1:timer:loom-worker-3/fleet-resync:c4883600330b4d70afac9e743a4e52e3 installs=0.19.1151 a9d9bfc13e966655d6d847cb6876af523bc4a4c4 -->
    Loom-Trace-Id: c1345a24765b7e1c5307ef032fd77486
    Loom-Build: unknown f91cd239df41290ba3efb8bc14320984e3392c6f clean
    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
2026-10-13 chore: resync installed Loom surfaces
    <!-- loom:provenance v1 build=unknown 6fe43c87955e02019c2bc8dfad4fbd160b89170c clean prompts=none sweep=none story=none trace=49a4590bf54e81899c26d965f682504c host=robb-studio base=f32796eaac7bbf1dee421d888e7cd54273e4173b run=loom-run/v1:timer:robb-studio/fleet-resync:459197b3-0050-4335-893e-e47b638eb819 installs=0.19.1151 d1d2dd6e9b17b05d0e718dc7b712685c24dd979d -->
    Loom-Trace-Id: 49a4590bf54e81899c26d965f682504c
    Loom-Build: unknown 6fe43c87955e02019c2bc8dfad4fbd160b89170c clean
    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
2026-10-13 chore: resync installed Loom surfaces
    <!-- loom:provenance v1 build=unknown 5dc3a07d084d0ec4034f0782d572925dcad86af7 clean prompts=none sweep=none story=none trace=cbc11657acadf58858409fe543c342e1 host=robb-pro base=2553bdfa8c98907c470cbcb60e1118fc0d3b77a9 run=loom-run/v1:timer:robb-pro/fleet-resync:be586137-d91e-4e2c-82d6-3164d43aa9de installs=0.19.1152 2d5fe17958dca799058f16bdd74a12336990bec0 -->
    Loom-Trace-Id: cbc11657acadf58858409fe543c342e1
    Loom-Build: unknown 5dc3a07d084d0ec4034f0782d572925dcad86af7 clean
    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
2026-10-13 chore: resync installed Loom surfaces
    <!-- loom:provenance v1 build=unknown f2b62a2cf576d7d37092147b2281da809f8b5cf5 clean prompts=none sweep=none story=none trace=8adfa75521c72dded43e2932febb6329 host=loom-worker-3 base=99fcf93f090a1b087821053aad4a13d3e6bd77f7 run=loom-run/v1:timer:loom-worker-3/fleet-resync:8a8198f8f80e4703bc7365a5e10595e0 installs=0.19.1152 a7c20e591a04d4acaeeca29fadd7fa4be7ca3122 -->
    Loom-Trace-Id: 8adfa75521c72dded43e2932febb6329
    Loom-Build: unknown f2b62a2cf576d7d37092147b2281da809f8b5cf5 clean
    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
2026-10-13 chore: resync installed Loom surfaces
    <!-- loom:provenance v1 build=unknown f2b62a2cf576d7d37092147b2281da809f8b5cf5 clean prompts=none sweep=none story=none trace=c75aa8454d7b0e20ddf41b71641175d6 host=loom-worker-1 base=d6f9f82ca893c0d8ca6db75dc415a8e4180e6e82 run=loom-run/v1:timer:loom-worker-1/fleet-resync:0af96cefe4bb43af82d755dbf36e35bf installs=0.19.1152 a7c20e591a04d4acaeeca29fadd7fa4be7ca3122 -->
    Loom-Trace-Id: c75aa8454d7b0e20ddf41b71641175d6
    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
2026-10-13 chore: resync installed Loom surfaces
    <!-- loom:provenance v1 build=unknown 84d11f248d368cae5e04a2255f6897a406c50089 clean prompts=none sweep=none story=none trace=8e50b4ccc3dc58f709a732f69d58fd44 host=robb-studio base=5738e181863e2738d37afb07b372d88a043ca020 run=loom-run/v1:timer:robb-studio/fleet-resync:05c9f3b1-eee2-412f-8996-5fbf02793d9e installs=0.19.1153 d8429a4fabdc955107af1cbc22c548e23eecf9b1 -->
    Loom-Trace-Id: 8e50b4ccc3dc58f709a732f69d58fd44
    Loom-Build: unknown 84d11f248d368cae5e04a2255f6897a406c50089 clean
    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
2026-10-14 feat(verify): guard the cited 7.digital SDF record against changed simulation inputs
    Closes #285
    Loom-Story: 2AMLogic/sky130-trng#285
    Loom-Trace-Id: 436c42afaf034ef5818a4b43eddaf3ac
    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
2026-10-15 feat(sim): study lag-k match-count monitor model, coverage harness and synthesis prototype
    Additive only: digital/model/lagcount.py (bit-exact sequential model plus a
    packed batch scanner, binomial and dependence-aware exact cutoffs), experiment
    J in health-detection-coverage.py (--lagcount; experiment I output unchanged),
    a standalone synthesis prototype and harness, and unit tests. RCT/APT, C_RCT,
    C_APT, W and digital/rtl are untouched.
    Loom-Story: 2AMLogic/sky130-trng#301
    Loom-Trace-Id: dfbe2759c8b30d040680a4d58143bb9e
    Loom-Build: 0.19.1166 8a9aad12e32504cea9a7c7d2ed774749c487f875 clean
2026-10-15 feat(sim): replay the lag-count study monitor over the sky130 behavioural corner streams
    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
2026-10-15 feat(sim): tabulate the reliably covered min-entropy range per lag-count configuration
    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
2026-10-15 docs(spec): DR-0015 Proposed -- lag-count monitor study with exact cutoff, coverage and area
    Records the experiment-J coverage/false-alarm evidence and the standalone
    sky130_fd_sc_hd area study, indexes the record, and recommends not adopting
    the monitor yet. No DR-0004 value, RTL or target changes.
    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
2026-10-15 docs: index klayout-tools#3466 (synthesize parameter override) in the friction ledger
    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
2026-10-15 fix(sim): exempt study-only lagcount model from signoff freshness pins
    Explicit STUDY_ONLY_MODELS exemption in check_signoff_sim_freshness.py with
    tests; scope change to the gate documented in DR-0015.
    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
2026-10-17 feat(signoff): cite artifact-anchored generic evidence for T1 items 1, 2, 9, 10
    Add signoff/attest.py, which builds per-row inventories (path + sha256) and
    generic envelopes pinned to them, plus a read-only --check wired into the
    signoff-check CI job. 1.digital, 2.analog, 2.digital and 10 grade met; 1.analog
    (netlist freshness needs xschem) and 9 (one record family has no committed
    testbench) are cited as fail so they render unmet with the reason recorded.
2026-10-17 chore(signoff): re-pin item 9 inventory after merging origin/main
2026-10-17 fix(sim): scale whole-block PWL highs to VIH, bound probe measurements, require every program measurement
2026-10-18 fix(sim): cap whole-block batch probe timeout at fleet ceiling; record refused probe attempt
2026-10-18 chore(signoff): re-pin tier-9 attestation after reduce-whole-block/make-requests edits
    Regenerated with attest.py --write 9; t1-report.json re-rendered with
    klayout-tools==0.7.0 (unchanged, exit 3 = documented mid-ladder state).
2026-10-18 sim(whole-block): record batch startup probe that ran on the fleet and failed at ngspice parse
    Part of #307
2026-10-19 signoff: regenerate item-10 attestation after pdk-nightly.yml change
    pdk-nightly.yml is a member of the item-10 inventory; removing the
    report-loom-ui job changed its sha256. Regenerated with
    'python3 signoff/attest.py --write' and 'klt signoff' (klayout-tools==0.7.0,
    the CI pin). Only content hashes changed; no row verdict moved.
2026-10-20 refactor(sim): drop dead sim/bin path inserts, use load_module in volume-model test
2026-10-23 feat(sim): store new run evidence in the artifact store, commit only manifests
    Add sim/bin/artifact_store.py (stage, `klt artifact put`, manifest + summary,
    fail closed) and sim/bin/check_artifact_manifests.py (schema, artifact: URIs
    only, no stored object committed). corner-run.py and
    evidence_record.mint_behavioral_record use the helper for new runs; manifests
    and summaries join the append-only rule. Adds tests with a fake klt, CI steps,
    docs and DR-0016. Existing evidence is untouched.
2026-10-27 feat(signoff): tool-derived T1 item 1 analog attestation via klt signoff --attest
    Replace the attest.py-format 1.analog inventory with a klt-format one
    (sources + four derived netlists, each with a netlist.py --check freshness
    check), drop 1.analog from attest.py, and wire klt signoff --attest 1 into
    pdk-nightly netlist-check. The passing envelope must still be minted by that
    job; re-pin item 10 for the workflow edit.
2026-10-27 ci: move the signoff grader pin to klayout-tools 0.8.0
    Re-render signoff/t1-report.json (build stamp and ruleset id only), bump the
    live install recipes, keep the nightly cell-composition pin and the
    batch-client recipes where they are, with the reasons recorded.
2026-10-27 fix: re-pin ci.yml in signoff attest, add friction-ledger rows for klayout-tools#4109/#4211
2026-10-27 docs(layout): classify klayout-tools 0.8.0 drift across all layout cells
    Records the per-cell 0.8.0 check results, controls against the pin and 0.7.0,
    and the A/B/C classification (deck gained poly.endcap.diff.1, mos_array draws
    more, explicit floorplans no longer fit). No evidence regenerated; pin unchanged.
    Part of #364
    Loom-Issue: 2AMLogic/sky130-trng#364
2026-10-27 fix(layout): regenerate leaf cells under klayout-tools 0.8.0
    Re-run the six primitive generators, ro_buf, sampler_tg and ro_stage*
    under klt 0.8.0 with PDK_ROOT=~/.volare. ro_stage* needed mn's origin
    moved 0.24 um in x to clear nsdm.space.1. All cells DRC-clean
    (including poly.endcap.diff.1) and LVS-matching with unchanged counts;
    pins and spec untouched.
2026-10-27 fix(layout): re-floorplan nand2 cells for klt 0.8.0 block growth
    Move the PMOS row up 0.45 um and mnab right 0.25 um (psub_tap left 0.1 um
    in ro_nand2*) with matching final-stage waypoints so en/a route and
    nsdm.space.1 is clean; regenerate ro_nand2, its three wstv variants and
    sampler_nand2 evidence under 0.8.0. Raise xor2's y lanes to clear the
    li1 spacing gap; its evidence awaits the ro_buf leaf regeneration.
    Part of #370
    Loom-Issue: 2AMLogic/sky130-trng#370
2026-10-27 docs(sim): move batch-client recipes to klayout-tools 0.8.0
    The fleet batch runner now runs klt 0.8.0, so the 0.6.0 client pins and
    their 'pin stays' notes in the mismatch Monte Carlo and XOR-combining
    recipes are obsolete. Update the friction-ledger status cells to match.
2026-10-27 fix: regenerate xor2 layout evidence under klayout-tools 0.8.0
    Declare the inverter input ports on ro_buf's nfet gate pad so the 0.42 um
    li1 pad no longer sits 0.16 um from it (li1.space.1), which left nets a/b
    unrouted. DRC clean, LVS 12/12 devices and 10/10 nets, provenance 0.8.0.
    Closes #370
2026-10-29 fix(ci): regenerate tier-9 attestation and t1 report; add friction-ledger row for klayout-tools#4575
2026-10-30 docs(sim): record one-unit fleet probe of the bin-fixed whole-block netlist
    ngspice on the fleet now gets past parse (no modelname error) and is killed
    by the 3480 s bound during analysis; no circuit measurement obtained.
2026-10-31 feat: commit klt-minted 1.analog attestation and make netlist-check --check blocking
    Replace the self-declared fail envelope with the status: pass envelope
    minted by klt signoff --attest 1 in pdk-nightly netlist-check (run
    41150912185, 29/29 checks incl. the four netlist.py --check freshness
    commands). Re-pin 1.analog (and item 10, which inventories the workflow),
    re-render t1-report.json (1.analog now met, 15/22), and drop the warn-only
    branch so a schematic edit without a regenerated netlist fails the job.
    Part of #360
    Loom-Issue: 2AMLogic/sky130-trng#360
2026-11-03 sim: add short rate-probe request variant; record 100 ns probe still times out
    Adds make-requests.py --set rate-probe (100 ns .tran, all measurements
    bounded by the stop time), its test, and the run/record of the single
    batch unit, which hit the 3480 s ceiling with no measurements.
2026-11-03 signoff: regenerate item-9 attestation and t1-report after make-requests.py edit
    make-requests.py is content-pinned by signoff/attest/9.inventory.json; the
    attestation was not regenerated. Ran attest.py --write 9 and regenerated
    t1-report.json with klayout-tools==0.8.0 (the CI pin).
2026-11-04 docs(spec): DR-0017 address EE-key review (boundary, load model, supply provenance, netlist source, feasibility gate)
    - Correct boundary table against layout/trng_whole/interface.md (en1-4 are
    testbench->analog; clk/rst_n/vdd/vss shared with the sampler; real bus_* names)
    - Replace the "real transistor-level loading" claim with a boundary-load model
    and corner-tracking bridge thresholds
    - Fix vdd/vss current attribution (mixed provenance); sampler supply UNMET with O5d
    - Name the analog netlist source (partition of flat extract) and its check
    - Bring in #403 (100 ns probe also timed out) and add a feasibility gate for (b)
    - Non-blocking: Liberty per-point mapping, O-IDs introduced here,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
2026-11-04 docs(friction-ledger): add row for klayout-tools#4867 cited by DR-0017
2026-11-05 docs: record whole-block klt extract rerun on Spot with stage timings
2026-11-05 fix(sim): make whole-block netlist $-scrub guard linear and collision-only, re-pin netlist
2026-11-05 chore(signoff): regenerate item-9 attestation and t1-report after make-netlist.py/netlist re-pin
2026-11-05 fix(sim): emit pw2nd diode as PDK subckt X card, scan all card models, re-pin netlist
    The extractor's bare-model D card (diode_pw2nd_05v5) is undefined in ngspice.
    make-netlist.py now rewrites it to sky130_fd_pr__diode_pw2nd_05v5 (a PDK subckt);
    check-bin-coverage.py also fails on any device card whose model the pinned PDK
    does not define. Adds an append-only re-pin record.
2026-11-05 chore(signoff): regenerate block-9 attestation and t1-report after check-bin-coverage.py change
    Ran signoff/attest.py --write 9 and re-rendered t1-report.json with
    klayout-tools==0.8.0 (the CI pin). Generated files only; nothing relaxed.
2026-11-05 chore(signoff): regenerate block-9 attestation and t1-report after make-requests.py change
    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
2026-11-05 fix(sim): count klt per-job overhead in wake-up batch bound, lower noisy timeout to 3400 s
    klt sim_batch bounds a job at 120 s overhead + units x timeout_s; the noisy leg's
    3500 s unit gave 3620 s > 3600 s ceiling. Guard and test now include the overhead,
    TIMEOUT_NOISY_S is 3400 s (bound 3520 s), README corrected, block-9 attestation
    regenerated (t1-report.json unchanged under klayout-tools==0.8.0).
2026-11-05 chore(signoff): regenerate t1-report after block-9 attestation change
    Re-rendered with klayout-tools==0.8.0 (the CI pin). Generated file only.
2026-11-05 feat(sim): wake-up transient PVT envelope and noisy transistor leg run on the batch fleet
    Append the 54-unit deterministic envelope records, the 3 x 32-seed noisy
    records with a noise-off control and a re-emitted margin record; record
    fleet job ids from sharded runs (remote.fleet[]); update README and the
    block-9 attestation.
2026-11-05 sim: add analog-chain-only feasibility probe and record its result
2026-11-05 signoff: regenerate item-9 attestation and t1-report after make-requests.py edit
    Regenerated with signoff/attest.py --write 9 and klt 0.8.0 (the CI pin).
    Only the make-requests.py sha256 and the hashes derived from it changed;
    no attested claim or verdict moved.
2026-11-05 fix(sim): rename whole-block netlist body nodes to canonical port names
    canonicalise() rewrote only the .SUBCKT header, so 94 of 123 ports never
    joined a device node. Apply the cluster->canonical map to every body token
    (collision-checked), assert port coverage (bus_wdata[31:3] are unused by
    design), regenerate the netlist and add a supersession record.
2026-11-05 signoff: regenerate item-9 attestation and t1-report after make-netlist.py edit
    Only the pinned sha256 of the edited files and hashes derived from it changed.
    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
2026-11-05 sim: add DR-0017 provenance, partition check and obligations to whole-block tooling
    program.py gains boundary_signals(), digital_stimulus() and PROVENANCE;
    make-requests.py checks analog + digital reproduce the flat extract and
    records the three hashes in plan.json; the reducer emits O1-O8 obligations,
    a mixed-level label and power provenance, forces O5d/O7/O8 UNMET and keeps
    ac3_claimable false. Gate-level co-simulation, GRID_TIMEOUT_S and the
    boundary-load/Liberty choices are not done and are stated as open.
    Part of #431
2026-11-06 signoff: regenerate item-9 attestation and t1-report after reducer edits
    Regenerated with signoff/attest.py --write 9 and klt 0.8.0 (the CI pin, via uvx).
2026-11-06 sim: add idle/leakage survey of the gated-off sampler_core across the PVT grid
    Standby .op supply current of the assembled pre-layout block (rings gated
    off, sampler idle, latches clamped to their stable state) at tt/ss/ff x
    -40/27/125 C x 1.62/1.8/1.98 V on the batch fleet, an independent leaf-cell
    sum cross-check, the trng_digital Liberty leakage mapped to each corner by a
    fixed rule, worst-leakage corners, and a recommended (not ratified) idle
    target. Invalid (non-converged) units are rejected by the analysis.
2026-11-06 docs/signoff: cover ro-array-idle-leakage in REPRODUCE.md; regenerate item-9/10 attestation and t1-report
    Fixes the two red CI gates (check_reproduce.py, signoff tier-report staleness).
    Regenerated with signoff/attest.py --write 9/10 and klt 0.8.0 (CI pin, via uvx).
2026-11-06 sim: record interrupted 100 ns whole-block rate probe on re-pinned netlist
2026-11-06 sim: record 100 ns whole-block rate probe timeout on re-pinned netlist
2026-11-07 chore(signoff): re-pin block-9 attestation after sha256_file refactor
    Re-ran signoff/attest.py --write 9 and regenerated signoff/t1-report.json
    (klayout-tools==0.8.0, the CI pin). Only file hashes changed; no evidence
    content changed.
2026-11-13 docs(spec): DR-0018 adopt <=200 uW worst-corner idle power envelope, update README Power row
2026-11-13 fix: fail spec-index check on unknown status word; drop 7 dead defs
    tools/check_spec_index.py declared STATUS_WORDS but never read it, so the
    index side of the status check was fail-open: ENTRY_RE accepts any
    [A-Za-z]+ and _norm() maps every non-"proposed" word to Accepted, so an
    index entry reading **Rejected** or a typo like **Propsed** compared equal
    to an Accepted or Ratified record and passed. The docstring says any
    disagreement fails, so wire the vocabulary in rather than delete it:
    * check() now reports "unknown status **Word**" and fails before
    normalising, for any index word outside STATUS_WORDS;
    * record_status() derives its alternation from STATUS_WORDS too, so the
    vo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
2026-11-13 fix(sim): an unreadable plan.json is a corrupt request, not a non-request
    The shared walk read plan.json through the same lenient `_read_json` as
    resp.json, so an absent, zero-byte or truncated plan all returned None and
    all got `continue`d as "not a request directory". Only the absent case is
    that: a request whose plan.json was present but empty or truncated, with its
    resp.json intact, appeared in neither `chunks` nor `missing`.
    Because `missing` stayed empty, `emit_record`'s refusal never fired, and
    since the requested counts now come from the plans, the lost plan took its
    10 draws out of the denominator too -- so the record read a complete
    "20/20 array" over 20 of 30 requested draws, wit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
2026-11-13 fix(signoff): re-pin item 9 attestation after the source edits
    The signoff gate was red: this PR edits six files inventoried by
    signoff/attest/9.inventory.json but touched nothing under signoff/, so
    the attestation was stale by construction and 3 of 8 tests in
    sim/tests/test_signoff_attest.py failed.
    Regenerated on the merged tree, per the gate's own instruction:
    - `python3 signoff/attest.py --write 9` — re-pins the six changed source
    hashes in 9.inventory.json, the inventory hash in the 9.json envelope,
    and the evidence['9'] pin in block-manifest.json. 120 inventory rows
    before and after; no row added or removed.
    - `signoff/t1-report.json` re-rendered with the command in
    signoff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
2026-11-14 chore(signoff): regenerate item-10 attestation and t1 report after the README edit
    T1 item 10 ("README, license, CI keeping harness and evidence formats
    valid") pins README.md by content hash in signoff/attest/10.inventory.json,
    so this PR's README edit left the attestation chain stale and turned the
    "Signoff tier-report staleness gate" red:
    sim/tests/test_signoff_attest.py -> 3 failures
    README.md sha256:f7461dca... (pinned) != sha256:57af15dd... (tree)
    Regenerated with the documented commands, exactly as commit ae2313dc did
    for the DR-0018 README edit:
    python3 signoff/attest.py --write 10
    klt signoff --manifest signoff/block-manifest.json \
    --tiers-doc signoff/design-evidence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
2026-11-14 feat: generate the digital half's gate-level ngspice model as a timed-delay XSPICE netlist
    DR-0017 option (b) left the realisation of the gate-level digital half
    open between event-driven co-simulation and a timed-delay netlist, "to
    choose and to evidence". This chooses the timed-delay XSPICE netlist and
    measures it.
    `make-gate-model.py` maps every sky130_fd_sc_hd instance of
    layout/trng_digital/trng_digital.routed.v to one XSPICE event-driven
    primitive -- d_genlut for a combinational cell (truth table evaluated
    from the Liberty output-pin `function`), d_dff for a flop -- carrying
    scalar rise/fall delays reduced from one Liberty deck, with
    adc_bridge/dac_bridge cards at the boundary. 2321 r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
2026-11-14 chore(signoff): regenerate item-9 and item-10 attestations and t1 report
    This PR's own diff moved two pinned content sets, so the issue-#320
    sha256 attestations went stale and the signoff staleness gate failed
    (3 of 8 tests in sim/tests/test_signoff_attest.py).
    - Item 10 pins `.github/workflows/ci.yml` directly; this PR adds 27
    lines to it, so the envelope pin, inventory and block-manifest
    evidence entry all moved.
    - Item 9's inventory is selector-driven (`sim/*/analysis/*`,
    `sim/*/*.py`, `!sim/tests/*`), and two files this PR adds are
    captured by those selectors:
    - sim/post-layout-whole-block/analysis/compare-gate-model.py
    - sim/post-layout-whole-block/make-gate-model.py
    (`si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
2026-11-14 fix(gate-model): derive the plan's name from its own output directory
    make-gate-model.py hardcoded "name": "gate-model-probe" in plan.json, so
    both requests identified themselves as the probe — corners/gate-model-full
    asserted it was the 6-cycle probe rather than the 75-cycle headline run.
    Derived from outdir instead, matching the convention every other plan in
    the slug follows and the way the sibling make-requests.py threads `name`
    from its caller. Fixed pre-merge because sim/*/corners/ is append-only:
    check_records_append_only.py would refuse the correction afterwards,
    leaving the record's headline run permanently mislabelled.
    Regenerated both requests. Only gate-model-full/plan.json's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
